markthebault/esp32-ecu/reports/engine/expanded-reference/README.md

# Expanded production-reference comparison packet

This development checkpoint adds a separate sixteen-output genuine Speeduino native fixture and generalized coupled engine comparisons. The full feature goal remains active. Existing PCB capacity is4+4; physical engine outputs remain inhibited.

- `sources.zip`: source overlay on commitc0d7d0f, including tools, reproduction commands and scope documentation.
- `validation.zip`:24 prescribed-shaft profiles, exact original4-cylinder GPIO/status and12 full coupling-result regressions, source/object/library/binary identities, independent raw/negativeIO/coupled/variable-shaft review and closure receipts. Binaries and gcov files are excluded.
- `plants.zip`:68 raw coupled runs:44 normal profiles,4 explicit incompatible reference fallback diagnostics,6 fault cases,2 fixed-geometry causal controls and12 refinements. Historical failedN1 fixture and failed common timing-gate reports are separate records and do not count as passing evidence.

Twenty reference profiles and all24 project profiles power the declared free-shaft engine after starter removal. Two- and seven-cylinder non-sequential reference fallbacks do not represent the selected even-fire COP geometry. Timing differences and reference transient errors remain in raw results; no equivalent accuracy or calibration claim is made.

See `docs/engine-reference-profiles.md` for configuration, actual native pin wiring, effective modes, commands and limits. These are uncalibrated research plants and a native HAL with zeroCPU/IRQ cost. They do not qualify physical target timing, electrical behavior, engine/vehicle operation, EMI/surge, thermal, splash, RF or printed fit. Expanded turbo geometry, matching hardware, online tuning integration and wider control/trigger features remain unfinished.
