markthebault/esp32-ecu/reports/engine/flex-integration/README.md

# Flex software integration evidence

This checkpoint connects raw flex capture to the shared controller, schema9 persistence, own010 tuning, browser controls and source/age/fault diagnostics. **Protected target acquisition and a released PCB input are still missing.** Enabled target flex inhibits control. Selected physical engine outputs remain inhibited. Screen schemas1..4 suppress engine telemetry whenever flex is required; a negotiated flex extension remains open.

Validated behavior includes fuel/temperature factors before reference acceleration fuel, zero-factor suppression of all fuel/deadtime, cranking spark bypass, secondary/cylinder ordering and coherent sample/calibration/revision/fault ownership. Historical schema1..8 imports initialize flex disabled and neutral; edited schema8 secondary maps survive. Explicit scalar synthetic ETH cannot qualify for corrections.

Evidence includes296 parent kernel checks and the full sanitizer suite;132 Python integration tests; actual Chrome flex/tuning/secondary/logger checks; independent kernel and host reviews;14,400 bit-exact Off-baseline rows; and27 saved own-controller fixed-gasoline plant cases. Neutral controls retain identical virtual edges, fuel totals and final RPM. Missing/stale inputs and zero factors cut as declared. The independent review records its own ordering, corruption, ownership, CAS, runtime and saved-plant checks.

The plant matrix is not a new production Speeduino comparison or an ethanol chemistry model. The separate earlier25-case production raw-edge packet remains at ../flex-core with its own immutable sources and disclosed historical generated-coverage side effect. No production ELF was executed for this integration checkpoint.

Actual unmodified TunerStudio MS Lite3.3.01 opens own010 offline, edits filter125.5 to130.5 and saves an MSQ matching all8192 expected bytes on native import. Earlier automation saves without a committed edit are retained separately. MegaLogViewer HD Lite4.6.14 loads the original121-row,229-column native waveform log and plots ethanol, including preserved startup unknowns. These are file workflows. Own010 online acceptance remains unverified; earlier own009 online rejection and vendor integration remain unresolved. No support message was sent.

The full runtime block is832 bytes, preserving the640-byte prefix. MSL007 has229 engine /186 direct SIL columns. ExactU64 values remain strings in JSON and decimal integers in files; viewer displays can round them. Record136B, RuntimeSample664B and Recorder87,128B are native ABI measurements. Device retention is128 rows, with gap/overwrite accounting. Keeping256 expanded rows overflowed linked internal DRAM; failed builds are retained. Three fresh firmware builds and static output-policy/ISR/USB audits pass. This does not measure target minimum heap, stack, latency, USB, sensor or electrical behavior.

Verify from the repository with `python3 -B tools/verify_flex_integration_evidence.py`; add `--check-live-sources` to bind the current workspace or `--replay` to rerun saved-case checks,296 sanitizer checks and the14,400-row exact Off comparison. Snapshots are immutable; replay uses temporary output paths. `summary.json` and `artifact-manifest.json` bind all files. Vendor application binaries and proprietary PDFs are excluded.
