markthebault/esp32-ecu/reports/engine/load-model/README.md

# Load, pressure and AFR evidence

Schema7/own008 adds independent MAP/TPS/IMAP-EMAP table coordinates, explicit table bases, pressure normalization, AFR incorporation and calibrated optional J16 roles. Selected web builds retain inhibited engine/idle output policy.

`matrix/` contains56 primary plus8 selected half-step runs across project portable/target dispatchers and pinned production Speeduino32/16 timer models. `legacy/` retains8 exact executed-event and plant-ledger replays. Alpha-N calibration has244 independently settled cells and12 unqualified pressure-corridor cells; none of the latter were weighted by the tested trajectories. Outcomes include failed calibration, differing guard/AFR policies and rich reference operation; passed audits do not mean ideal tunes.

Four independent scoped reviews are under `reviews/`. Initial/corrected source bytes, text probes and compressed trace inputs are archived. Native probe executables/objects remain in the local cache; their hashes in reviewer manifests are records, not bundled binaries. The simulator review binds the execution sources separately from the publication snapshot and independently replays the final64 traces. Live source checks verify that binding. There is no claim of a run-captured manifest that the runner did not produce.

`applications/` includes actual offline TunerStudio008 edits, exact5376-byte F32/enum-page roundtrip,126/83-field MegaLogViewer files and screens. Nine Chrome workflows cover unit review, CAS, imports, logging and existing controls. `static/` contains actual linked policy, ISR and USB/source audits, not measured runtime/electrical qualification. Current source copies are under `sources/`; root attributes are retained inertly under `source-metadata/` so they cannot change copied-file storage. All packet artifacts are hash listed.

Run `python3 tools/verify_load_evidence.py`; add `--check-live-sources --check-index` before committing this revision. Historical source/manufacturing/case/manual/report bytes are retained. Full feature parity, online application identity acceptance and physical qualification remain open.
