markthebault/esp32-ecu/reports/engine/secondary-core/README.md

# Secondary-table core foundation evidence

This packet proves scoped core progress. It does not establish an operator-ready secondary-table feature or full Speeduino equivalence. Schema7/own008 keep secondary tables Off. Versioned UI/configuration/tuning, coherent logs/radio, protected switch acquisition/accessory and new coupled plant comparisons remain pending. Engine/idle physical outputs remain inhibited.

The native sanitizer suite passes, including738 secondary-module checks,148 integrated-controller checks and four deliberate workspace-allocation failures. All173 existing Python tests pass. The selected N16R8 web target builds; linked policy and ISR-placement checks pass. Native lifetime/size checks and static images do not prove ESP32 runtime heap/stack, physical timing or electrical/engine behavior.

The same frozen probe produces7776 exactly identical disabled-path observations before/after, with source snapshots and raw compressed output retained. The earlier baseline's probe source is unchanged in this replay; the public helper only separates adjacent statements for strict compiler diagnostics. Independent architecture probes execute unchanged pinned-production Speeduino functions, not a whole coupled engine. Independent implementation/binding/allocation/legacy-wire review is archived under reviews.

Each review original manifest was fully verified before selection. selection.json identifies every archived original and its optional lossless CSV compression. Upstream vendor source snapshots and compiled executables/archives remain in the local review cache; their hashes and rebuild recipes remain recorded. Project source snapshots, probe source, result data and reports are archived. Do not mistake an original reviewer manifest for a claim that every cache artifact is redistributed here.

Run python3 tools/verify_secondary_core_evidence.py. Add --check-live-sources --check-index before committing this revision. Add --replay to rebuild both frozen/current disabled probes and three sanitized core/allocation tests from this packet; the replay requires a compatible compiler/libm and retains its receipts in .cache/engine/secondary/replays. Full regression reproduction: CXX=g++ CC=gcc sh scripts/test_firmware.sh and uv run --with fmpy==0.3.26 --with playwright python -m unittest discover -s tools -p 'test_*.py'. Browser workflows and actual tuning applications were not rerun for this core-only phase. No manufacturing/case/manual artifact changed.

See ../../../docs/engine-secondary-tables.md for the full remaining implementation gates.
