markthebault/esp32-ecu/reports/engine/secondary-integration/README.md

# Secondary-table software integration

Schema8/own009 adds both secondary-table editors and strict whole-tune migration/staging/CAS,640-byte coherent runtime,188/145-field MSL006 and compact authenticated radio schema4. Physical engine/idle outputs remain inhibited in the selected web targets. Protected switch/ethanol acquisition and fresh secondary-enabled coupled plant acceptance remain open.

Validation includes the native ASan/UBSan suite,189 Python tests,57 Chrome workflows, three firmware builds and static policy/ISR/USB audits. The7776-row disabled probe exactly matches the earlier core packet. These regressions do not substitute for new enabled-table plant trajectories.

TunerStudio MS Lite3.3.01 opens the definition without parser/unit warnings; edits to both rules/maps match all8192 expected page bytes with the known revision37 explicitly supplied because the application omits its read-only origin. MegaLogViewer HD Lite4.6.14 opens/plots188/145-field synthetic probe files. NaN-bearing channel extrema may displayNaN; calculated vendor channels/large integers remain unqualified. No online vendor acceptance or physical board test is claimed.

The independent software review passes14 groups against299 frozen inputs, including7772 burn-allocation and5747 migration-allocation failures,324 old-prefix profiles,297 native/browser observations,193 exact runtime extensions,225 radio combinations,864 unit assertions and strict rejection/nonmutation checks. Its null-metadata finding and sensor-fallback wording recommendation are closed. The separate contract review is a proposed-layout/capacity assessment, not final implementation acceptance.

- [Software review](reviews/software/review.md) and [detailed checks](reviews/software/review.json).
- [Supplemental documentation review](reviews/documentation/review.md) binds the sole post-freeze tuning README correction and independently checks the operator guides/application receipts. The original503-artifact software packet remains unchanged; all production hashes still match it.
- [Contract assessment](reviews/contract/assessment.md).
- [Application receipts](validation/application-checks.json), [browser receipts](validation/browser-summary.json) and [source/limit summary](summary.json).
- [Current guide](../../../docs/engine-secondary-tables.md) and [coverage ledger](../../../docs/engine-feature-coverage.md).

The document bound grows to48KiB and engine NVS to128KiB at the same0x210000 offset. Startup detects an old partition layout without erasing it and blocks saves with a diagnostic. Physical flashing/migration, fragmentation and power-loss durability remain hardware work. No PCB, BOM, Gerber, case or manual release is changed by this packet.

The root artifact manifest binds every file except itself. Sources retain their exact bytes; root attributes are stored inertly outside the source tree. Each reviewer archive contains a selection of its original manifest entries, with sources/probes/commands/results and explicit local binary exclusions. Compiler ELF hashes and generated partition/config records are retained; local full ELF/application binaries remain in the ignored build workspace.

~~~sh
python3 tools/verify_secondary_integration_evidence.py
python3 tools/verify_secondary_integration_evidence.py --check-live-sources --check-index
python3 tools/verify_secondary_integration_evidence.py --replay
~~~

Default verification is archival. Live/index checks intentionally fail after later changes. Replay rebuilds the frozen core/allocation probes with sanitizers and repeats the exact disabled observations in a new ignored directory. Other reviewer/application checks retain their own source/command receipts. The broader goal remains active.
