markthebault/esp32-ecu/reports/engine/semi-sequential/README.md

# Semi-sequential software increment

This immutable evidence set belongs to `feature/engine-development-sil`, after baseline `8b2f8ec`. It does not establish broader Speeduino parity, physical engine operation or fabrication release. [Strategy and reproduction guide](../../../docs/engine-semi-sequential.md).

- `validation-summary.json` binds296 source/input snapshots and test scope. `sources/` includes generated SDK configuration inputs as records; live/index verification distinguishes tracked sources from ignored generated inputs.
- `matrix/summary.json` records28 scenario runs plus8 step-refinement checks, with compressed raw traces. Each core drives its own independent plant copy from executed actuator edges. Speeduino source is pinned at9ff5aae44de51fdc00d3fb1c7c2bfc1f0d0b3e20. Native32 and16-bit timer profiles are separate, declared HALs; neither establishes physical CPU/interrupt timing.
- `legacy/` contains8 batch/full-sequential warm-start regressions. Sequential's pre-acquisition phase inhibit is expected and disappears after phase acquisition.
- `initial-audit/` retains diagnostic history, including the incorrect initial target-only/instant-loss audit assumptions and six affected raw cases. Its old runner hashes are historical identifiers; the final matrix and current source snapshots are authoritative.
- `reviews/` contains independent read-only storage, telemetry and execution review reports, probes and source snapshots. `review-resolution.json` closes documentation/test findings explicitly. Target review addendum binds the final asset-only rebuild. `reviews/execution/policy-correction.json` supersedes its false bench-policy metadata field: actual bench gated outputs are enabled by its explicit compile policy; both web builds remain inhibited. The CMake database omits extra PlatformIO SCons flags.
- `validation/` contains147 Python tests,12 semi tests, native ASan/UBSan checks including252 constant-shaft pair/phase/width cases, firmware/reference builds and application workflow records. `browser/` contains installed-Chrome checks and screenshots. `target/` contains fresh ISR and USB static audits; runtime heap, stack and timing remain unmeasured.
- `reference/` retains current and pre-increment build manifests. Private GPL reference executables remain reproducibly cached locally; proprietary desktop application binaries/settings are not included. `applications/` contains actual own006 TunerStudio export and the synthetic MSL opened by MegaLogViewer.
- `comparison.png`, `comparison.svg`, `comparison.html` and `metrics.csv` derive from the final raw matrix. The standalone plot is a software comparison, not engine calibration.

The35 Nm step stalls. Our controller cuts when the projected coil close would violate bounded dwell and recovers stopped. Four previously predicted rises occur after trigger loss; in these runs the last edge is16.38 ms after the last accepted crank, before its measured20 ms timeout. General timeouts can extend to150 ms; a200 RPM/40 ms case is separately tested against the actual last accepted edge. Neither instantaneous cut nor perfect engine behavior is claimed.

Selected web firmware keeps physical engine/idle outputs inhibited. The separately gated dummy-load bench build was compiled only. No board was flashed, no engine/valve/screen hardware was connected and no vehicle, electrical/environmental or physical-fit qualification was performed. TunerStudio offline own006 works in the tested application; online own-identity acceptance remains unresolved.

Run `python3 tools/verify_semi_evidence.py` from the repository root for archival integrity. Add `--check-live-sources` for this source state and `--check-index` after staging to bind Git bytes too. `artifact-manifest.json` covers every other file in this directory; it is excluded from its own hash set.
