markthebault/esp32-ecu/reports/engine/transient-enrichment/README.md

# Transient fueling evidence

Schema6/own007 adds acquisition-window TPS/MAP curves, multiplier/reference-adder, latched tapers, finite holds and deceleration fuel reduction/cut. Selected web builds remain physically inhibited.

`matrix/` contains64 qualified runs, including48 primary,8 refinements and8 fuel-neutral controls. `initial-matrix/` preserves the earlier coverage failures and exact initial runner. Its other source bytes match `sources/`. `legacy/` compares exact executed events and plant ledgers with immutable pre-transient evidence.

Independent source snapshots/probes and corrected findings are under `reviews/`. Text inputs are archived; native executables/objects remain in the local cache and their reported hashes are records, not bundled binaries. Actual offline TunerStudio and MegaLogViewer files/screens are under `applications/`. Browser collected/native105-field exports agree. The unchanged232-byte radio does not carry the new detailed transient fields.

Source snapshots and raw traces are hash bound. Run `python3 tools/verify_transient_evidence.py`; use `--check-live-sources --check-index` for this revision before committing. Static/source/simulator evidence does not establish physical engine operation or full feature parity.
