markthebault/esp32-ecu/reports/engine/turbo-profiles/README.md

# Turbo profile research foundation

Explicit1..8-cylinder geometry now binds actual pumping displacement, per-cylinder air, sparse actuators and conservative gas/heat inventories. Native project coupling adds sequential cam events, full-channel cut records and loaded-layout provenance. The full ECU goal remains active; PCB capacity stays4+4 and normal engine outputs stay inhibited.

- `sources.zip`: source overlay on commit4daa4d8, tools, reproduction and limits.
- `validation.zip`: eight geometry/atomicity tests, existing regressions,200 exact parent state replays, independent48 analytical flow cases/1002 numerical values, and separate model/controller-coupling reviews with resolved findings.
- `runs.zip`: current8-cylinder sequential and independent7-cylinder semi charged-cut evidence; source-bound1-cylinder and8-cylinder open-loop prefixes; explicitly failed4L high-throttle source-map experiment. Compiled binaries/gcov and the upstream archive ZIP are excluded; source/model inputs and identities are retained.

Current charged stops retain actual COIL17/COIL16 discharges and closed post-cut ledgers. Earlier prefixes have their original source versions and cannot prove post-halt inventories. The8-second20%-throttle run records234 PWM edges while manifold pressure stays below ambient; it does not establish pressure tracking. The80%-throttle4L run exceeds the source turbo's24000rad/s domain at4.730343s and is excluded from passing evidence.

See `docs/engine-turbo-profiles.md` for commands and physical assumptions. Matched turbo/map hypotheses, a16-output genuine production boost fixture, paired normal/fault/refinement comparisons, further controls/UI/configuration/debug/PCB work, online tuning support and target/physical qualification remain unfinished. No physical engine, vehicle, electrical, EMI/surge, thermal, splash, RF or printed-fit qualification is claimed.
