markthebault/esp32-ecu/reports/engine/load-model/sources/README.md

# ESP32 ECU A3-120

A 120 × 120 mm, six-layer, through-hole ECU development board with a plug-in ESP32-S3, configurable sensor readouts, live diagnostics and a printable gasketed enclosure.

**Bench prototype:** all engine outputs remain disabled. Vehicle operation, surge/EMI immunity and physical splash resistance have not been validated.

| PCB | Printable enclosure |
| --- | --- |
| A3-120 through-hole PCB | Printed enclosure, gasket and PCB mounts |

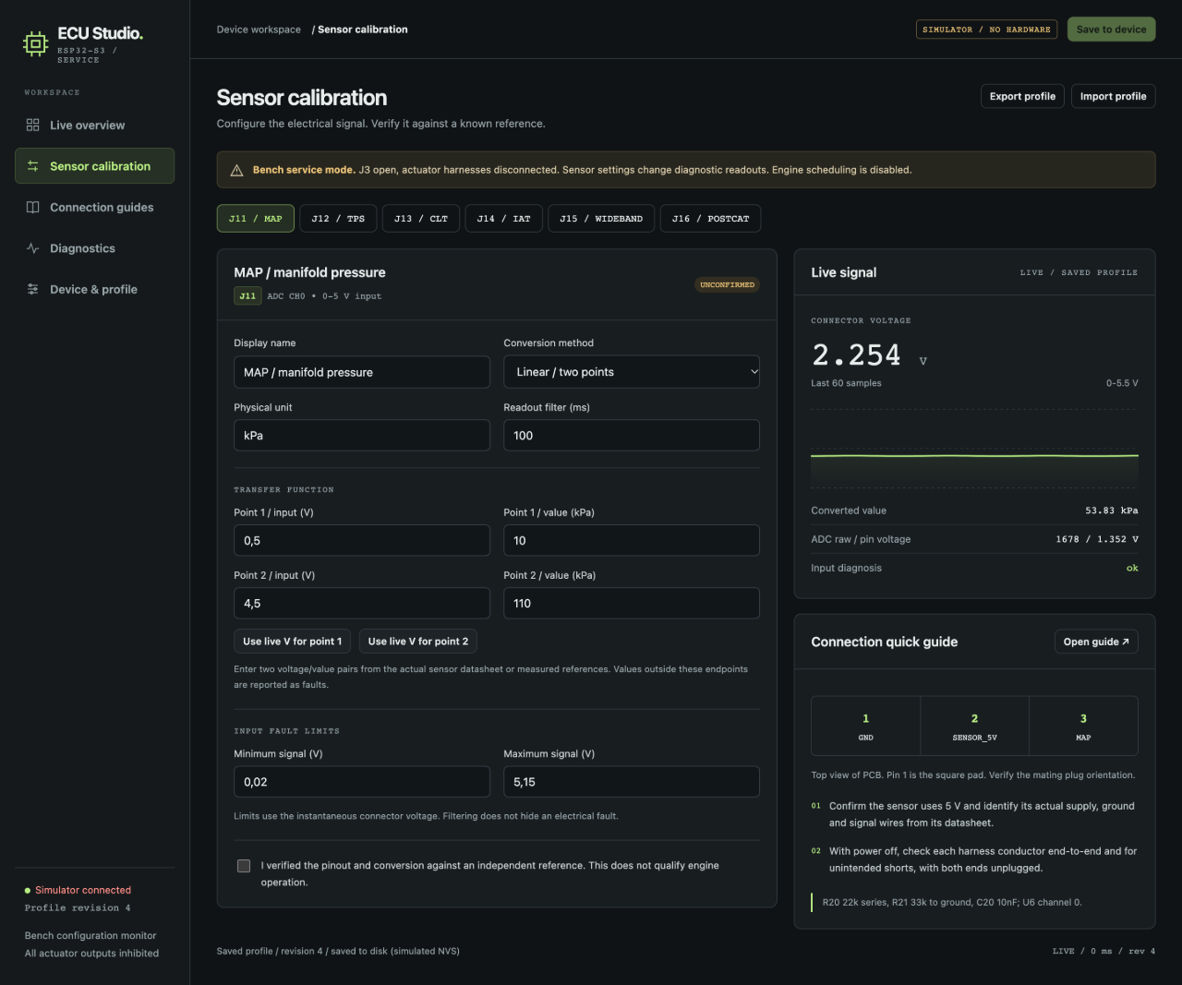
[picture p16: reports/web/calibration.png]
Sensor calibration and live diagnostics


[Bill of materials](hardware/a3-compact/BOM.md) · [Shopping CSV](hardware/a3-compact/bom-shopping.csv) · [KiCad project](hardware/a3-compact/esp32-ecu.kicad_pro) · [26-page manual](output/pdf/esp32-ecu-a3-build-calibration-debug-manual.pdf) · [Print files](enclosure/a3/) · [Complete package](build/esp32-ecu-a3-120-web-manual-case.zip)

Engine development: [core, target timing and simulator assessment](docs/engine-development.md) · [Speeduino feature coverage](docs/engine-feature-coverage.md) · [TunerStudio/MSL status](tuning/README.md) · [trigger logging](docs/engine-trigger-debug.md) · [sequential control and comparison](docs/engine-sequential.md) · [engine logs and screen telemetry](docs/engine-observability.md) · [cylinder trims](docs/engine-cylinder-trims.md) · [USB tuning status](docs/engine-usb-tuning.md) · [idle control and comparison](docs/engine-idle-control.md) · [transient fueling](docs/engine-transient-enrichment.md). Physical outputs remain inhibited.

New development: [ESP-NOW pairing, screen management and sealed button wiring](docs/espnow.md). The UI can pair and unpair screens. Selected module: **44-pin Type-C N16R8**, with its [supplier PDF](hardware/references/esp32-s3-44pin-aliexpress.pdf) preserved. [A5 idle interface and isolated driver](docs/engine-idle-isolation.md) are routed development drafts with physical outputs disabled and provisional module/case fit. A3/A4, manufacturing files and the old ZIP remain historical.

## Build and preview

```sh
pio run -d firmware -e compact_n16r8_web
python3 tools/web_server.py
```

Open the desktop simulator at `http://127.0.0.1:8765`. Read the [web/bench setup guide](docs/web-configuration.md) before powering or flashing the hardware. The BOM identifies exact-part selections that still need review.

Historical A3 validation: [ERC/DRC and pin audit](reports/a3/validation-summary.json), [enclosure CAD fit](enclosure/a3/fit-check.json), [18 configuration/API tests](reports/web/config-tests.txt) and [116 control scenarios](reports/web/control-tests.txt). Some purchased-part 3D models are simplified assembly envelopes.

[Load-source, pressure and AFR development](docs/engine-load-model.md) · [Earlier revisions](docs/history.md) · [Compact-board details](docs/compact.md)
