markthebault/esp32-ecu/reports/engine/flex-ingress/validation/sources/hardware/flex-input/README.md

# Flex input architecture draft

`FLEX-G38-DRAFT1` reserves GPIO38 for a future protected flex input on a new carrier revision. The [machine-readable contract](architecture.json) records allocation, capture ownership, shared I2C limits and unfinished gates. This directory contains no circuit or released CAD. Do not connect a sensor using this draft.

The preferred allocation moves the external GPIO38 WS2812 status function to an ordinary RGB LED driven through a direct-solder PDIP18 MCP23008 at address0x21. Existing switch acquisition remains at0x20 with its GP7-to-GP6 challenge and full-byte IODIR guard. IO7 must be configured as output even when it is NC on the new expander. [Microchip DS20001919I, Register1-1](https://ww1.microchip.com/downloads/aemDocuments/documents/APID/ProductDocuments/DataSheets/MCP23008-and-MCP23008-Data-Sheet-DS20001919.pdf)

GPIO45/46 stay unconnected. GPIO46 must be low with BOOT low for joint download; GPIO45 can select VDD_SPI without a verified eFuse override. Chip Reset strap sampling differs from resets that retain GPIO state. This allocation avoids depending on an unmeasured strap gate, reset retention or the supplier module's fuses. No eFuse change is requested. [Espressif boot documentation](https://docs.espressif.com/projects/esptool/en/latest/esp32s3/advanced-topics/boot-mode-selection.html)

Historical compact GPIO38 LED firmware and generic GPIO38 ARM firmware cannot own the new input. A new compact carrier build must exclude every old RMT initialization/write and explicitly disable GPIO output before capture setup. GPIO38 ownership has not yet been changed in any existing build.

The existing group0 capture timer stays running and calibrated. Its third channel would acquire both flex edges at priority3; crank/cam keep their channels, status and timing. The hardware has one event latch per channel. Software queues cannot establish lossless capture. The [portable ingress](../../firmware/include/ecu/flex_ingress.hpp) implements bounded handoff and suppression decisions only. The target must supply source-specific interrupt masking/clearing, locking, a single worker, actual calibration/revision binding and completed-control ACK routing. Every stop/rearm or binding change must also invalidate the separate floating-point Capture series. Ingress queue clearing cannot do that itself. Only the owning worker may forward both fault tickets after a completed matching invalid control evaluation; the ingress cannot verify control execution.

Sample callback/owner time after taking the same lock used for the ingress call. A timestamp sampled before waiting can be older than an intervening event and correctly fail the monotonic-clock check, even when an ACK's metadata is stale. Snapshot holdoff status is evaluated at its recorded `last_observed_us`, not at the time a diagnostic reader receives it.

The32-callback/10ms fixed window applies to matching active callbacks within an armed episode. It is not a global IRQ budget across inactive/foreign callbacks or arbitrary stop/arm cycles. The trusted owner must honor local interrupt suppression and the ACK/holdoff retry path, and must not implement noise retries as repeated normal stop/arm.

Pop followed by floating-point work outside the lock is not a publication fence. Retain context, fault generation and arm boundary with the pop. Before publishing, atomically revalidate current context/generation/armed state and the event timestamp against the current arm boundary, then commit under that same lock or an equivalent versioned commit. A mismatch discards the result and invalidates/reacquires the separate Capture series. The edge has no generation field, so the companion snapshot/version must be retained. This owning-worker fence remains unimplemented.

Both MCP23008 devices need one bus owner and one total3ms budget per5ms tick. Switch guards have priority. LED work uses remaining slack, coalesces old requests and advances initialization/readback in bounded operations. Bus release requires both clients idle. MCP outputs can retain green after a CPU or bus failure, so expose requested color separately from verified latch/age/failure. Register readback does not prove light output. Pairing blue blink, normal steady green and problem red blink remain the requested indication policy.

The protected frontend, exact LED/driver/resistors, bias, polarity, off-state back-power and pulse skew remain open. The parent U7 has two spare3.3V SN74HC14N gates that may be reusable, but copying a divider/RC does not qualify them. Preserve the physical sensor LOW width. The core's2µs endpoint allowance covers timestamp quantization, not an unmeasured circuit delay. No sensor model, supply or harness pinout has been selected.

The120×120mm limit, ordinary leaded parts, direct-solder DIP, pluggable N16R8, inward10mm antenna allowance and sealed PAIR/RESET remain constraints. Physical dimensions and RF/fit behavior remain unverified. A3/A4/A5 sources and manufacturing records remain historical copies. Physical engine outputs remain inhibited.
