markthebault/esp32-ecu/manufacturing/a3/drill-report.txt

Drill report for esp32-ecu.kicad_pcb
Created on 2026-10-30T17:28:59

Copper Layer Stackup:
    =============================================================
    L1 :  F.Cu                      front
    L2 :  In1.Cu                    in1
    L3 :  In2.Cu                    in2
    L4 :  In3.Cu                    in3
    L5 :  In4.Cu                    in4
    L6 :  B.Cu                      back

Drill file 'esp32-ecu-PTH.drl' contains
    plated through holes:
    =============================================================
    T1  0.300mm  0.0118"  (98 holes))
    T2  0.350mm  0.0138"  (52 holes))
    T3  0.750mm  0.0295"  (22 holes))
    T4  0.800mm  0.0315"  (477 holes))
    T5  0.950mm  0.0374"  (28 holes))
    T6  1.000mm  0.0394"  (66 holes))
    T7  1.100mm  0.0433"  (24 holes))
    T8  1.200mm  0.0472"  (10 holes))
    T9  1.300mm  0.0512"  (2 holes))
    T10  1.600mm  0.0630"  (4 holes))
    T11  1.700mm  0.0669"  (23 holes))
    T12  3.200mm  0.1260"  (1 hole)

    Total plated holes count 807

Drill file 'esp32-ecu-NPTH.drl' contains
    unplated through holes:
    =============================================================
    T1  3.200mm  0.1260"  (4 holes))

    Total unplated holes count 4
