markthebault/esp32-ecu/reports/engine/flex-radio/sources/docs/espnow-engine.md

# Opt-in ESP-NOW engine telemetry

This extends the [existing pairing and sensor protocol](espnow.md). It implements the ECU sender plus a [reference receiver](../tools/engine_receiver.py); it does not build a screen. The channel remains 6, encrypted unicast uses the saved 16-byte LMK, and peers remain limited to 4. Peer Storev1 and types 1–6 keep their existing byte layouts. Capabilities are volatile, reset at reboot/unpair/slot reuse and do not change the saved peer blob.

Types 7–11 use the existing 8-byte `ECN1`, version 1, type, little-endian uint16 length header. No native structure is transmitted. Integers are unsigned little endian; floats are IEEE-754 float32. The largest datagram is250 bytes in schemas3..5; schemas1/2 retain232 bytes, within the250-byte v1 ESP-NOW payload limit. Schema5 uses two authenticated datagrams for one complete observation. Send/receive callbacks only signal or queue bounded work; authentication, JSON and framing run in the task, consistent with [Espressif's API guidance](https://docs.espressif.com/projects/esp-idf/en/stable/esp32s3/api-reference/network/esp_now.html).

## Negotiate and recover

1. Load the saved ECU STA MAC and LMK. Send a type 7 read-only query with session/counter/features/schema all 0 and a fresh cryptographic 16-byte client nonce. Start a local monotonic timer for this request. A query does not enable engine telemetry.
2. Within 1 second, verify type 8's full HMAC with the LMK, echoed nonce, enums, lengths and reserved/status fields. Reject responses from any other MAC. Record the current capability counter/mode, nonzero boot session, boot nonce, sequence floor and ECU reply-send time.
3. To enable, send type 7 with that boot session, counter+1, feature bit 0 set, schema5 (or explicit legacy schema1..4) and a new nonce. Accept the matching authenticated reply before using data. To disable, increment the counter with features/schema 0. Counter 0 is reserved for queries. Updates must be strictly newer; retry the exact same request bytes if a reply is lost. A same-counter request with changed bytes is rejected. At UINT32_MAX, re-pair/reboot is required before another update; never wrap the counter.
4. A rebooted screen queries the ECU's accepted counter instead of assuming 0. Queries report the current mode without modifying it. An ECU reboot starts disabled again. A query with session 0 discovers the current boot. Query/reply state is not persisted to NVS.
5. Refresh the timed nonce query at most 5 seconds later and after a 1 second gap in authenticated engine frames, including no first data within 1 second of a reply. The reference receiver invalidates its cached display while querying. Use a fresh random nonce every time. Never accept an unsolicited, expired or nonce-mismatched reply.

The query sequence floor prevents a screen that lost RAM state from accepting recorded same-boot engine frames at or below that floor. Derive the full 32-byte engine MAC key as:

`HMAC-SHA256(LMK16, ASCII("ECU-NOW-ENGINE-v1") || boot_nonce16 || session_u32_LE)`

The ASCII domain is 17 bytes. Use all 32 derived bytes for engine data/ACK HMACs, not only the first 16. A fresh boot nonce separates engine frames even if the random 32-bit session happens to collide, after a fresh nonce negotiation. This does not retrofit unlimited replay protection into the legacy sensor protocol. Pairing/LMKs remain the trust boundary; compromised keys/ECU/service clients and jamming remain outside this protection.

| Type 7 request, 76 bytes | Type 8 reply, 108 bytes |
| --- | --- |
| 0..7 common header | 0..7 common header |
| 8 session u32, 0 allowed for query | 8 current nonzero session u32 |
| 12 counter u32, 0 for query | 12 accepted update counter u32 |
| 16..31 fresh client nonce | 16..31 echoed client nonce |
| 32 feature mask u32 (only bit 0) | 32 current feature mask u32 |
| 36 schema u32 (1..5 enabled,0 disabled/query) | 36 current schema u32 |
| 40 reserved u32=0 | 40 status u32=0 |
| 44..75 HMAC-SHA256(LMK16, bytes 0..43) | 44..59 per-boot random nonce |
| | 60 engine packet sequence floor u64 |
| | 68 ECU reply-send ESP uptime µs u64 |
| | 76..107 HMAC-SHA256(LMK16, bytes 0..75) |

## Engine packet, type 9

Total232 bytes for schemas1/2 or250 for schemas3..5. Schema5's base uses the schema4 layout with schema=5; it becomes an observation only after its matching type11 extension is verified. HMAC verification with the derived key precedes any sequence/freshness update. Reject incorrect lengths, nonzero reserved bytes, unsupported schema/enums, wrong boot/source, duplicate/out-of-order packet IDs and reversed sender time. Packet IDs are global u64 and can have gaps. The source proposal sequence is independently u64. Preserve these as integers, not JavaScript Number values; the web API uses decimal strings.

| Offset | Field |
| --- | --- |
| 0..7 | Common header |
| 8 | Boot session u32 |
| 12 | Engine packet sequence u64 |
| 20, 22 | Negotiated schema u16 (1..5), flags u16 |
| 24, 28 | Sensor-sample and control-evaluation ages at send, u32 ms |
| 32, 36 | Tune and sensor-profile revisions, u32 |
| 40, 48 | Source proposal sequence and earlier worker-current command sequence, u64 |
| 56, 60 | Source external-configuration phase epoch and worker executor-generation epoch, u32; distinct domains |
| 64, 68, 72 | Controller fault bits, phase-loss count, rejected-cam count, u32 |
| 76 | Cam error, float32 crank degrees |
| 80..89 | Ten u8: state, strategy, source, phase reason, input-valid mask, current timing cause, last timing cause, virtual mask, physical-command mask, board flags |
| 90..91 | Reserved0 for schemas1..3; compact secondary mode/source/status for schema4 below |
| 92 | ECU transmission ESP uptime µs, u64 |
| 100, 104, 108 | Worker tune revision u32, worker sensor revision u32, worker observation age u32 ms |
| 112..143 | Eight input floats: RPM, MAP kPa, TPS %, CLT °C, IAT °C, lambda, battery V, sensor V |
| 144..199 | Fourteen proposal floats: RPM, VE %, target lambda, advance °BTDC, PW ms, dwell ms, deadtime ms, air mg, warmup ratio, afterstart ratio, accel ratio, EGO ratio, duty %, idle % |
| 200..231, schemas1/2 | HMAC-SHA256(engine_key32, bytes0..199) |
| 200, schemas3/4 | Four2-bit resolved source codes, fuel/spark/lambda/trim, low to high |
| 201, schemas3/4 | Pressure mode bits0..1, baro source bit2, available bit3, arithmetic valid bit4, AFR mode bits5..6, MAP guard available bit7 |
| 202,206,210,214, schemas3/4 | Unaligned F32: fuel coordinate, AFR factor, baro kPa, EMAP kPa |
| 218..249, schemas3/4 | HMAC-SHA256(engine_key32, bytes0..217) |

State values 0..5 and fault bits match `engine.hpp`; strategy 0=batch/wasted, 1=sequential four cylinders, 2=semi-sequential four cylinders (schemas2/3/4). Source 1=target control observation, 2=synthetic control observation. Phase reasons match `engine_phase.hpp`, timing causes match `timing_executor.hpp`. Schema1 permits strategies0/1 and current/last timing causes0..16. Schema2 adds strategy2 and timing cause17 (`idle_pwm_fault`), with the same offsets and size. Unknown enum values reject. The receiver must enforce the exact authenticated negotiated schema on every frame, including after upgrades or downgrades. Input validity bits follow the eight input floats. An invalid input is NaN with its bit clear. Unknown proposal/cam floats are NaN. Infinite values are rejected. Board bits 0..3 mean ADC OK, SAFE high, interlock high and capture overflow. Masks represent software state, without pin readback.

Flags, low to high bits 0..15: present, inputs fresh at control evaluation, storage OK, crank synchronized, phase synchronized, phase required, proposal submitted to worker queue, dummy-load physical policy compiled, phase/revision context matched, proposal active, fuel cut, spark cut, pump proposal, fan proposal, inputs qualified at evaluation, sender display freshness. The selected N16R8 build keeps the dummy policy clear and engine outputs inhibited.

Unknown ages are UINT32_MAX. Finite old ages saturate at UINT32_MAX−1. The sender reads ESP uptime before GP time at publication, calculates GP-source durations, then adds later ESP elapsed time. Publication/transmission never resets the source/control timestamp when observe skipped a step. Worker ages are separate. Sender display freshness means sample/control ages≤1000 ms at transmission; it does not establish current command validity or physical execution.

The receiver must add network/receiver age. The reference implementation uses the authenticated timed query as a clock interval, a 2% relative clock-rate allowance plus 2 ms quantization, and refreshes within 5 seconds. Its conservative transit bound is `max(0, local_elapsed_since_query_send − sender_elapsed_since_reply_send) + ceil(0.02×local_elapsed) + 2ms`. Source/control/worker ages are first rounded upward by `100/98` to cover a slow source clock, including history before the query. Add transit and subsequent receiver-local elapsed time. A repeated source sequence cannot change immutable payload or lower a previous age bound; an unknown repeated age remains unknown. After a gap, fresh negotiation is required. These are explicit clock assumptions, not measured oscillator/RF guarantees. Never compare raw ECU and screen uptime origins or trust a newly arrived packet's freshness bit alone.

## Acknowledge and rate

Type 10 is 56 bytes: common header 0..7, session u32@8, received engine packet sequence u64@12, reserved u32=0@20, HMAC-SHA256(engine_key32, bytes 0..23)@24..55. ACK the newest authenticated, processed complete observation promptly. Schema5 requires both parts before an ACK. The ECU requires a sequence it actually submitted within the last 1 second and within its last 8 complete submissions for that peer and packet family (engine or legacy sensor, independently). Eight engine observations span about0.5 seconds at16 Hz or1 second at8 Hz; promptly acknowledge the newest. It rejects duplicates, old ACKs and reversed time before advancing ACK state. The same recent-send/serial rule applies to legacy type6, including legitimate uint32 rollover through0. A MAC-layer send success is not a screen ACK.

Normal per-peer budget remains up to20 datagrams/s. Legacy peers retain their sensor cadence. Schemas1..4 normally receive16 engine observations,2 legacy sensor packets and2 metadata packets/s. Schema5 uses those same16 engine datagram slots for8 complete two-part observations. Capability replies borrow slots and are rate limited; radio congestion/pairing/CPU delays can reduce rates. Busy periods do not create an unbounded backlog. Metadata keeps its session/revision contract, and its session is stamped at transmission. No rate/delivery guarantee is implied.

The UI distinguishes recent link ACKs from complete-engine ACKs, including a pending flex submission. Sensor ACKs cannot hide a missing complete-engine ACK for3 seconds. Complete fault observations can be acknowledged while their flex value remains unusable. Neither an ACK nor a worker command observation proves an output executed or a screen displayed it. HTTP failure clears both ACK readbacks to unknown. Unpair stops subsequent sends and resets stream keys/capabilities/ACK history for that slot.

## Reproduce

`tools/test_engine_observability.py` compares native C++ and independent Python packet bodies/full HMACs, key length, nonce/counter recovery, replay, clock bounds, stale gaps, unknown values and 64-bit IDs. Native tests cover both ACK widths and recorder limits. [The observability guide](engine-observability.md) links engine-plant, UI, viewer and independent review evidence. Future screen firmware can use `EngineReceiver` as an executable contract; it must implement ESP-NOW peer storage/transport and display behavior separately. No screen, actual RF exchange, range or sealed-enclosure qualification was performed here.

The cylinder-trim update keeps this schema unchanged. Its fourteen proposal floats remain untrimmed base demands. Applied per-cylinder PW/advance/fuel/duty and masks are available through web/JSON/engine MSL002, not this radio frame. Receivers must not present the scalar PW/advance as the applied value for every cylinder.

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

Schema3 carries [load-model source meanings](engine-load-model.md). Source codes0/1/2 mean MAP kPa, physical TPS percent and100×IMAP/EMAP percent. Pressure codes0/1/2 mean Off100kPa, MAP/100kPa and MAP/baro. AFR codes0/1/2 mean Off, target and measured. Baro source0 is fixed/manual;1 is calibrated live. Available does not imply all optional numbers or valid control. Unknown numeric fields remain NaN. Spark/lambda/trim coordinates in the Python receiver are derived approximately from authenticated F32 inputs when arithmetic is valid; inactive/missing inputs remain unknown. Their precision can differ from the core's F64 lookups. Detailed reason, auxiliary role and AFR state require web/log diagnostics.

Schemas1/2 are emitted only for the legacy MAP/target model with the postcat role. New load modes require schema3 or4; the API/UI disclose an upgrade requirement and fall back to the legacy sensor stream. Authentication covers schema and the correct variable body length. A negotiated version cannot be silently downgraded, and a repeated source snapshot cannot alter its appended payload. HMAC derivation, ACK layout, sequence/counter/nonce, freshness and replay rules remain unchanged. `test_load_radio.py` checks independent bytes, every250 individual tamper positions, malformed lengths/enums, downgrade, old-byte preservation and new-mode fallback.

## Secondary summary, schema4

Schema4 retains every schema3 field, its218-byte authenticated body and250-byte total frame. Former reserved bytes90/91 carry two compact secondary observations:

| Byte | Bits | Meaning |
| --- | --- | --- |
|90|0..2 /3..5|Fuel/spark mode:0 Off,1 multiply,2 add,3 conditional,4 input;5..7 reject|
|90|6 /7|Fuel/spark secondary selected (`active`)|
|91|0..1 /2..3|Fuel/spark source:0 MAP,1 physical TPS,2 IMAP/EMAP;3 rejects|
|91|4 /5|Fuel/spark observation available|
|91|6 /7|Fuel/spark calculation evaluated|

Unavailable observations are canonical empty: mode/source0 and active/evaluated clear. An active Off rule rejects. Active selection can be known before arithmetic completes; check evaluated, controller faults, sample age and global flags. This compact frame does not carry cell meaning, secondary coordinates/values, input qualification/age or detailed reasons; use web/USB/log diagnostics for them. The existing scalar advance/PW remain base proposals rather than per-cylinder applied execution.

Every non-Off configured secondary mode requires schema4, including a currently inactive conditional/input rule. Schemas1..3 keep their exact historical byte meanings and cannot silently label a secondary result as primary-only. The ECU reports `engine_telemetry_blocked`, an upgrade reason and explicit sensor-stream fallback. Off rules remain compatible with older schemas, subject to their existing strategy/timing/load limits.

The receiver enforces the exact authenticated negotiated schema and includes the new bytes in repeated-source immutability. HMAC key domains, full MAC lengths, counters, nonce retries, query floor, clock assumptions, ACKs and payload budget remain unchanged. `tools/test_secondary_radio.py` independently checks225 mode/source pairs, every tampered byte, signed invalid metadata, downgrade, retry/replay and legacy byte preservation. These are software contracts; no physical screen or RF test was performed.

## Complete flex observation, schema5

Schema5 preserves every schema4 base field, including bytes90/91 and200..217. Its separate type11 datagram is232 bytes. Both parts use the same session and64-bit packet sequence. The full32-byte base HMAC in the extension binds that exact base, preventing mixed observations. Each part has its own full HMAC with the existing32-byte engine key. The [machine contract](../config/engine-radio-v5.json) remains a development contract; no screen application or actual RF qualification is supplied.

| Offset | Type11 field |
| --- | --- |
|0..7|Common header|
|8,12|Session u32, packet sequence u64|
|20,22|Schema u16=5, reserved u16=0|
|24..55|Full base HMAC-SHA256|
|56..111|Seven u64: sample µs, window start µs, last edge µs, raw edges, fault generation, acknowledged generation, configuration epoch|
|112..151|Ten F32: frequency Hz, low pulse µs, ethanol %, fuel °C, unfiltered ethanol %, unfiltered fuel °C, sample age at control ms, fuel %, spark addition °, temperature %|
|152..175|Six producer-calibration F32: low Hz, high Hz, fault Hz, tolerance Hz, stale ms, filter ms|
|176,180|Flex flags u32, actual producer tune revision u32|
|184..190|Seven u8: source, reason, capture reason, last fault, correction reason, observed window cycles, configured cycles|
|191|Reserved0|
|192,196|Raw-sample age at original base preparation/send anchor, u32 ms; original producer stale limit, u32 µs|
|200..231|HMAC-SHA256(engine_key32, bytes0..199)|

Record enums and flags follow `flex_runtime.hpp`; unknown bits/enums/infinity reject. Unknown F32 values use canonical NaN `0x7fc00000`. Unavailable raw age isUINT32_MAX and an unavailable Record has stale limit0. The stale limit is rounded from the producer's F32 calibration to microseconds with positive half-up rounding, matching C++ `llround`. A raw source without a completed window has unknown age, including timestamp0. A synthetic scalar fixture may legitimately originate at epoch0 but cannot qualify as raw capture. Target control cannot claim synthetic flex origin; a claimed matching configuration requires matching nonzero producer/base revisions.

The sender retains one immutable pair per peer for at most250ms. SDK failures retry those exact bytes, without replacing the snapshot or restarting its age. It rechecks current time immediately before every submission. Both successful SDK submissions are required to enter the engine ACK window, which uses the original preparation time. Capability exchanges, unpair and key changes cancel pending pairs; capability replies also retire pairs made while the reply was waiting. Sequence exhaustion never wraps.

The reference receiver buffers at most two sequences for250ms from their first fragment. Either order works. Duplicates cannot extend that deadline. Partial observations never reach the public display, ACK, latest-completed sequence or engine liveness. Expired, evicted or authenticated conflicting sequences are retired separately from the last complete sequence, so they cannot later complete or be ACKed. A changed signed duplicate quarantines the sequence even if its changed fields fail semantic validation. Fresh queries clear partial state; per-boot repeated-source immutability and age floors survive clock-query refresh.

All receiver `now_ms` arguments mean current processing time from one monotonic clock, not a delayed packet's historical receive stamp. Clock reversal through any time-bearing API, including status reads, requires a fresh timed query. Raw age uses the original sample, then adds fragment wait, negotiated transit,2% clock allowance and local elapsed. A conservative F32/control-age lower bound also covers the first pair. Repeated proposals preserve the full flex Record and previous age bounds; explicit unknown age remains unknown. Compare against the original producer deadline. New ADC/control snapshots cannot renew an old raw sample. Base data can remain fresh after flex qualification expires.

Required invalid/unknown/future/expired flex requests red blinking at zero RPM as well as during operation; held samples are rechecked each radio loop. Flex Off adds no fault dependency. The indication is an advisory software policy and does not prove target execution, LED operation or CPU health.

Schemas1..4 remain byte-identical and suppress engine telemetry when corrections or a secondary ETH condition require flex; their slots retain explicit sensor fallback. A schema5 receiver may acknowledge a complete invalid/fault observation: receipt, value quality and control permission are separate. `flex_control_allowed` in the reference status covers the flex gate alone, not global engine safety.

Reproduce with fresh output directories:

```sh
PYTHONPATH=tools python3 -B -m unittest test_flex_radio test_engine_observability test_load_radio test_secondary_radio
python3 -B scripts/test_radio_service.py --output .cache/engine/NEW_RADIO
python3 -B tools/check_radio_service_fixtures.py .cache/engine/NEW_RADIO .cache/engine/NEW_INTEROP.json
uv run --offline --with playwright==1.64.0 python -B tools/test_flex_radio_ui.py --fixtures .cache/engine/NEW_RADIO --output .cache/engine/NEW_BROWSER
```

The actual sender/handler code executes against native SDK API models. These checks do not execute the RTOS task, ESP-IDF transport, radio, physical LED or a screen. The [frozen evidence](../reports/engine/flex-radio/README.md) binds source, native frames, browser checks, final linked builds and independent review. Earlier evidence packets remain historical and unchanged.
