markthebault/esp32-ecu/reports/engine/idle-isolation/reviews/layout/review.md

# Independent final IAC-DRAFT2 accessory recheck

Reviewed 2026-11-04 against ECU base `497aabb4a0ea686b240182e42b4c64aefa280c32`. **The corrected accessory passes this bounded circuit/copper recheck; physical output, fabrication and powered release remain on hold.** No production files were changed by this reviewer. A5 is reviewed separately.

The immutable final snapshot bundle is `faa04b70b45721099858e38aa5f9effea7d069dfa2eb0f81359267f3bb547040` (44 files). PCB SHA256 is `dd12136d7c7dec1464d7119dcd1fefe8740fa3743c33520e7c524a3910bb3d2e`. Native KiCad9.0.8 absolute-path runs on a byte-identical writable cache copy give **0 ERC, 0 DRC, 0 unconnected and 0 schematic-parity issues**, all severities/all track errors, without exclusions. Snapshot and working input bytes were checked after execution. See `assembly-final/native-command-log.json`, reports, `assembly-final/probe-result.json` and `review-manifest.json`.

## First-review findings and their disposition

Intermediate47-reference routing and value-only rebind snapshots are retained in `final/` and `value-rebind/`. The final bounded comparison confirms only C1/C2/C3/C4/C8/C10 placements changed, plus R2 value/note; other footprint placements, pad geometry/nets and all15 power segments remain. The first report and source binding remain in `initial-review.md` and `initial-review-manifest.json`; its immutable PCB hash begins `78edb587`. Native checks had passed even though the bypass and gate return were poor.

| Finding | Corrected result |
| --- | --- |
| Driver return51.560mm, joining14.8984mm down the coil return | Separate `LOGIC_GND` joins `ACT_GND` only through copper-only NT1 at Q1 source `(95.08,39)`. Driver-to-source center path25.016mm, including the1.8mm copper tie. Removing the18mm power-return bus in the independent graph leaves exactly one logic contact, at the source. Native shape comparisons find no other physical ground-net contact. |
| C4 driver bypass23.973mm and no nearby larger bypass | Back-side C4 has9.126mm combined rail/return center path and new local film C10 has26.597mm. C4 was rotated and C10 moved to clear front-side solder lands; neither relies on remote C7 as the local driver bypass. Exact THT lead/trace inductance remains a fixture test. |
| Opto/logic bypass detours | U2/C1 and U3/C2 each6.328mm, down from22.698/26.963mm. U4/C3 is22.132mm, down from41.561mm; its PDIP14 supply pins are diagonally opposed. U5/C5 is6.485mm, down from16.228mm. Local stubs are locked. |
| Broken terminal-source notice link | `terminal-source.json` is now present in the new accessory and matches the independently downloaded pinned official footprint. |

These lengths describe copper paths between pad centers, including a center convention for touching pads; they are not inductance or switching measurements. They exclude component leads and internal package wiring. Layout changes close the earlier concrete defects without supplying a physical timing guarantee. [TI driver guidance](https://www.ti.com/lit/ds/symlink/ucc27524.pdf), [Vishay opto data](https://www.vishay.com/docs/84732/6n137_vo2601_vo2611.pdf).

## Independent pin, copper and assembly observations

The literal review map checks **47 references and123 electrical pads** against native schematic XML, the declared net contract and actual PCB assignments. This includes121 fitted-component pads and two unfitted copper-tie pads. All semiconductor/diode assignments from the initial primary-source audit remain correct; intended detector, logic and regulator returns now use `LOGIC_GND`. Q1 source, J2 return, C6 input-reservoir negative and R14 gate-source bias retain `ACT_GND`. Both opto LEDs and their buffer circuits remain wholly carrier-side. The exact UCC27524P/P.B guarantee remains a release hold; family pin-map agreement is not a substitute for it.

Unused HCT inputs are grounded, unused outputs NC; U1 INB/ENB are grounded and OUTB NC. MCP100 D-bondout RESET_n feeds ENA through R11 with R12 pulldown; the eight-row DC LED/RUN/local-PG truth table passes. LM317 ADJ/OUT/IN, both live tabs, flyback/protection/clamp diode polarity and electrolytic polarity pass the actual-pin check. The freshly recomputed16 regulator corners remain4.9673-5.3459V with the selected120/374ohm1% divider. [HCT02](https://www.ti.com/lit/ds/symlink/sn74hct02.pdf), [MCP100](https://ww1.microchip.com/downloads/en/DeviceDoc/11187f.pdf), [LM317A](https://www.ti.com/lit/ds/symlink/lm317a.pdf), [IRLZ44N](https://www.infineon.com/assets/row/public/documents/24/49/infineon-irlz44n-datasheet-en.pdf), [exact2N3904BU](https://www.onsemi.com/download/data-sheet/pdf/2n3904-d.pdf).

The board remains **90x60mm, two copper layers,1.6mm substrate**. Every fitted electrical pad is through-hole; drills0.75-1.7mm. The two0.30/0.35mm via drills are routing features. NT1 has two bare F.Cu SMD-style pads joined by a0.6mm copper line, excluded from BOM/placement with no fitted part; it introduces no SMD assembly. The BOM has46 rows including four unplated3.2mm mounts. Direct-solder DIP footprints remain, with no IC sockets.

All15 locked2mm power segments survive exactly; the18mm source-to-J2 return has no narrow gate/logic neck. The 5mm rule area x35.3..40.3 covers both copper layers and forbids tracks/vias/pours/pads. Actual carrier copper ends x35.2 and actuator copper begins x40.42, giving at least **5.22mm** horizontal separation. No ACT/logic-to-J1 DC path exists with intact optical barriers; a deliberately inserted ground bridge restores the path as a negative control. This does not certify isolation or cover case/harness conductive bridges.

Actual back-side parts are C1/C2/C3/C4/C5/C10/R13/R14. Others, including relocated front C6, match their declared sides. Footprint provenance checks confirm only documented silkscreen removal/name changes for the variants: front U1/U4 keep Fab, courtyards, pads and notch/pin1 marker; back variants keep pads/Fab/courtyard while omitting silk graphics. Native courtyard checks pass. An independent eight-back-body/front-PTH-land sweep now reports no projected overlap; minimum box clearance is0.38mm for C1/C2,0.90mm for C3,1.31mm for C4 and1.53mm for C10. The drawings include stroke width. This is a planar check, not an assembled3D fit acceptance.

## Remaining concrete holds

- **Back-side assembly:** the earlier C10/U1, C3/U4 and opto-body/solder-land proximity findings are corrected. C4 lead ends still project beneath the front U1 mold; trim/inspect them before directly soldering the DIP. Freeze actual body envelopes, lead lengths, stand-offs and assembly order for all eight back-side parts, then check under-board/case access. The opposite-side planar sweep does not qualify these3D details.
- **Finished-hole fit:** Q1/U6 use nominal1.10mm holes. Drawn maximum/bounding lead sections approach1.080mm for IRLZ44N and1.094mm for TI NDE0003B. Freeze finished-hole tolerance and actual leads, or review larger holes/pads before fabrication. Generic stock-footprint agreement does not close this fit hold. [Infineon package](https://www.infineon.com/assets/row/public/documents/24/49/infineon-irlz44n-datasheet-en.pdf), [TI NDE package](https://www.ti.com/lit/ds/symlink/lm317a.pdf).
- **Combined RUN loading:** A5 review found the omitted R50/Q7/R53 branch and ten HCT input loads. R2 is now2.2k1%. Under an explicitly conditional500uA normal Q7 proxy and stated resistor/input limits, source demand is3.93004mA; ST only specifies that Q7 current at10V/25C, and its fault sink differs. The earlier blanket<=4mA claim is withdrawn. Measure combined loaded RUN/startup/fault/temperature behavior; no forced-beta guarantee is inferred. See `a5/review.md` and its loading probe. [ST data](https://www.st.com/resource/en/datasheet/vnp35n07-e.pdf).
- **Electrical guarantees:** freeze actual UCC27524P/P.B data, exact leaded capacitors/passives and a declared operating range. Loaded GPIO/RUN levels, NPN saturation/storage, LED current and actual opto load/timing remain conditional. The software accepts1us pulses; no measured physical minimum exists. [TI exact-P record](https://www.ti.com/product/UCC27524/part-details/UCC27524P), [onsemi](https://www.onsemi.com/download/data-sheet/pdf/2n3904-d.pdf), [Vishay](https://www.vishay.com/docs/84732/6n137_vo2601_vo2611.pdf).
- **Brownout/heat/load:** MCP100 assertion and hysteresis lack maxima; static headroom is not an unconditional brownout proof. Scope the assembled rail/PG/gate/drain through startup, interruption and brownout; verify regulator/diode/FET temperature, capacitor ripple and actual valve R/L. The dedicated protected9-16V/<=2A branch and independent disconnect must be concrete. A normal-current stuck-on valve need not clear a fuse. Both TO220 tabs remain live. [Microchip](https://ww1.microchip.com/downloads/en/DeviceDoc/11187f.pdf), [TI](https://www.ti.com/lit/ds/symlink/lm317a.pdf), [Infineon](https://www.infineon.com/assets/row/public/documents/24/49/infineon-irlz44n-datasheet-en.pdf).

Use the current-limited resistor fixture before an identified NC valve. Include reset/download, watchdog/interlock/stalled producer, signal opens and both return opens. Hardware output remains disabled; no flash/eFuse changes were performed. The accessory is held for fabrication/physical qualification, not approved for an engine or vehicle.

`source-manifest.json` records primary URLs and verified SHA256 where available; blocked web-only records have no invented hash. Primary PDFs/extracts/renders stay local research inputs and must not be redistributed. The two pinned official KiCad footprints were independently re-downloaded and matched. Inherited installed-library footprints remain bound to archived local input hashes without a claimed upstream commit. Reproduce the final independent probe with `/usr/bin/python3 .cache/engine/idle-isolated-layout-review/review_probe_current.py`; its JSON, all-pad CSV and actual-coordinate PCB images are in `assembly-final/`. No fabrication exports were generated.
