markthebault/esp32-ecu/reports/engine/load-model/reviews/architecture/architecture-assessment.md

# Independent load-model architecture assessment

Reviewed baseline: `1d6a9acb34838ea175f2dfa7ccd9786e96d2d11b`.
Reference: Speeduino `9ff5aae44de51fdc00d3fb1c7c2bfc1f0d0b3e20`.
Date: 2026-11-04. Reviewer: independent child agent, read-only production access.

This is an architecture assessment and controlled native-function probe. It does not approve the implementation being written concurrently, establish engine feature parity, or validate physical outputs, an actual engine, boost operation, or vehicle conditions. All created files are under this cache directory. Existing review evidence is retained.

## Conclusion

Implement table coordinates, pressure normalization, AFR incorporation, sensor requirements, and axis metadata as separate explicit concepts. MAP/TPS/IMAP-EMAP alone is a table selector. TPS indexing with physical MAP still multiplied into charge is a hybrid TPS-indexed speed-density model. Pure Alpha-N requires no hidden physical-MAP factor. An IMAP/EMAP coordinate is a dimensionless ratio percent and can exceed100% without manifold boost.

Root's proposed first increment is coherent: independent primary fuel/spark sources; lambda and trim sources that can follow primary fuel or be explicitly independent; Off/MAP÷100/MAP÷baro pressure modes; a deliberate J16 role; explicit axis-basis metadata; exact historical MAP defaults. Root subsequently added mutually exclusive AFR multiplier choices to the planned increment, with a declared running delay and neutral readiness/loss policy. Secondary fuel/spark combinations and switches, plus the separate barometric fuel-correction curve, remain explicit open gaps. This increment does not by itself close full load-feature parity.

## Actual pinned reference behavior

The copies under `reference-source/` come from the pinned Git object, not a moving branch.

| Concern | Pinned implementation and meaning |
| --- | --- |
| Primary fuel coordinate | `speeduino.ino:87-91` stores `fuelLoad=getLoad(fuelAlgorithm)` and indexes VE1. |
| Primary spark coordinate | `speeduino.ino:97-101` independently computes `ignLoad=getLoad(ignAlgorithm)` and indexes ignition. |
| MAP coordinate | `load_source.h:29-42`: absolute integer kPa. |
| TPS coordinate | Same function returns `TPS*2`; status TPS is half-percent units, so this is quarter-percent coordinates0..400. INI feedback scale0.25 converts it to physical0..100%. Do not pass physical TPS percent directly as native coordinate. |
| IMAP/EMAP coordinate | Integer `100*MAP/EMAP`. The source does not guard a zero denominator. Target must guard it. |
| Axis quantization | `table3d_axes.h` converts raw load bins by2. MAP bins have2kPa resolution; TPS raw bins display0.5% and internally become2 quarter-percent units; ratio bins have2 percentage-point resolution. INI distinguishes kPa, %TPS and %. |
| MAP multiplication | `fuel_calcs.cpp:86-96` is independent of table source: Off, MAP/baro, MAP/100. It uses integer fixed-point arithmetic and rounding, not the project's double precision. |
| AFR target coordinate | `corrections.cpp:659-674` follows primary `fuelLoad`, not spark or secondary fuel coordinates. No independent lambda-load selector exists in this pin. |
| AFR target warmup | With `incorporateAFR`, table target is used even with EGO off. Otherwise EGO on and `runSecs>ego_sdelay` uses table; before delay measured O2 becomes target; EGO off retains prior target. |
| AFR PW factor | `fuel_calcs.cpp:99-112`: `includeAFR` uses measured O2/target only for warm wideband. Else `incorporateAFR` uses stoich/target. When both flags are set, includeAFR wins. Both flags plus EGO off can update target yet apply neither AFR factor. |
| Secondary fuel | `secondaryTables.cpp:15-77`: independent source; Off, Multiply VE1×VE2/100, Add VE1+VE2, conditional switch, input switch. Fuel coefficient clamps255. Conditional thresholds use strict `>`. No continuous percentage-blend mode is present. |
| Secondary spark | Same file: independent source; multiply uses percent cells, add uses angle cells, switch uses corrected secondary advance; fixed timing and cranking skip it. Final type clampsint8, a much wider domain than this carrier's−5..40°. Production switch correction is excluded under UNIT_TEST, so unit-test-only output is an incomplete oracle. |
| Trim coordinate and order | `scheduler_fuel_controller.cpp:295-311` uses primary fuelLoad. It scales complete computed PW including injector opening time. Project intentionally scales effective fuel first and then adds deadtime. Preserve/document that difference. |
| Baro correction | `corrections.cpp:553-559,839-840` separately applies a baro fuel curve. MAP/baro and that correction can both be applied; they are not the same feature. |
| Baro acquisition | `sensors.cpp:575-645`: startup/internal MAP capture accepts65..108kPa; ongoing MAP capture requires RPM0 and decoder quiet for1s. External baro is a separately filtered input. This does not justify capture solely because our decoder currently reports RPM0. |

Controlled production-function probe `reference_probe.py` links the existing native production objects with UNIT_TEST=false. It does not patch fuel/load/secondary algorithms. The saved parent build manifest explicitly describes HAL changes and native timer limits. This task runs controlled status values, not a closed-loop engine simulation.

The observed fixture uses VE100, reqFuel10ms full-cycle, nonsequential effective5ms, opening0.9ms, MAP50kPa and baro80kPa. With no AFR factor the output is5900µs Off,4025µs MAP/baro,3400µs MAP/100. Stoich147/target120 produces6993/4708/3946µs; measured160/target120 produces7540/5050/4220µs. Both AFR flags with EGO off preserve the5900/4025/3400µs pulses despite target120. This catches flag precedence that a single inverse-target implementation would miss.

VE1=85 and VE2=50 produce43 in multiply mode,135 in add mode, and50 when switched. Conditional RPM1000 is inactive at1000 and active at1001. A nonflat AFR table produces target106 before and after switching a TPS-based secondary table while primary fuelLoad remains50. Deliberately changing primary fuelLoad to200 yields134. See `reference-probe.csv` and JSON for actual readback and complete setup.

## Existing project's contract

Frozen `engine.hpp:179-236` indexes VE, spark, lambda and enabled cylinder trims with physical MAP. Its charge expression is absolute MAP×cylinder volume×VE/(R×absolute IAT). Target lambda always divides fuel, independently of EGO. This matches target incorporation, not Speeduino's all-AFR-flags-off behavior. Reference adder is a full-cycle fuel dose at100kPa/25°C/100%VE/λ1 and is independent of current MAP/VE/WUE/EGO; complete dose is trimmed, split by actual openings, then deadtime is added per opening.

Legacy tune validation limits VE20..120%, MAP axes5..110kPa and measured MAP10..110kPa. Spark is−5..40°, target lambda0.75..1.2. Four-cylinder NA constraints, duty/pulse/timing limits, hard cuts and physical output inhibition are separate requirements and must remain intact.

Binding currently requires confirmed non-voltage MAP/TPS/CLT/IAT calibration. All acquisition values share the current ADC sample timestamp. ADC channels0..3 are those four inputs,4 is wideband,5 is POSTCAT/J16,6 battery,7 sensor rail. `config::convert` qualifies units and conversion; do not claim that a configuration field named filter_ms proves an actual matched pressure filter in this path. CAN currently has no implemented pressure-source decoder/freshness contract.

## Recommended explicit contract

1. **Sources and metadata.** Use closed enums for MAP kPa, TPS percent and100×IMAP/EMAP percent. Primary fuel and spark select independently. Lambda and trims default to follow primary fuel, with optional independently declared sources as an extension beyond this pinned reference. Resolve follow-primary to the original primary coordinate even when a secondary fuel table is active. Keep physical MAP/TPS separate from each table's derived coordinate. Unknown enum/basis, nonfinite value or source/basis mismatch rejects the tune.

2. **Pressure and charge.** For new modes, define normalized reference charge using fixed100kPa and actual IAT, multiply by fuel coefficient and selected pressure factor1, MAP/100, or MAP/baro. Pure Alpha-N is TPS indexing plus pressure factor1. TPS with MAP/100 remains hybrid. IMAP/EMAP does not replace the pressure factor unless explicitly selected. Do not make reference pressure equal baro and silently cancel MAP/baro. Preserve the original arithmetic expression on the exact legacy-default path so migration is bit-stable. Report the charge basis; Alpha-N normalized charge is a fuel-model proxy, not independently measured trapped air.

3. **AFR incorporation.** Expose mutually exclusive Off, TargetIncorporation=1/target_lambda and MeasuredToTarget=measured_lambda/target_lambda, or list absent modes as open gaps. Define wideband warmup/freshness/invalid behavior explicitly. If measured-ratio and EGO PI may operate together, show both factors and deliberate compounding. Otherwise reject the combination with a meaningful error. A target table may still serve EGO when target incorporation is off; requirements must follow actual consumers. Define measured-mode delay against a genuine start epoch, not each rev-cut or transient-fault recovery. Record requested mode, applied factor and neutral reason separately. Zero ordinary fuel freezes EGO even if an absolute transient adder is present. Default/migrated behavior remains current TargetIncorporation. Retuning is required when these factors change.

4. **Zero and large coefficients.** If new schema permits0 or coefficients above120, retain old schema/MSQ rejection for historical invalid tunes before upgrading. Final zero fuel must suppress deadtime-only pulses. Positive reference adder with zero ordinary base may produce finite absolute fuel, but effective ratio is undefined: no division by zero and no fabricated finite ratio. Record absolute added fuel and an unavailable-ratio flag/null. DFCO, explicit transient cut and all fault cuts dominate the adder. Judge channel capacity after actual trim and openings. Secondary coefficients may exceed old120 or clamp; expose final clamping rather than silently assuming the primary limit.

5. **Baro.** Choose fixed manually calibrated absolute kPa or a dedicated qualified live input. Root's choice to omit automatic pre-crank MAP capture is defensible and safer than treating unsynced RPM0 as stopped. Fixed is a declared manual value, not an acquisition sample; do not label it live or infer sample freshness. Live loss has no silent fixed100kPa fallback. Baro curve, if added, is an additional correction with its own enable and source dependency. Declare software pressure bounds and the supported altitude envelope, rather than copying an unrelated table-axis bound.

6. **J16 routing.** Default remains POSTCAT monitor. Optional EMAP or external baro must be an explicit exclusive role requiring confirmed, non-voltage absolute-kPa calibration, current acquisition quality and freshness. Live EMAP plus live external baro cannot both consume this channel. A fixed baro plus EMAP is possible. Supporting simultaneous live EMAP, baro and wideband requires another protected input or a real external/CAN acquisition implementation. EMAP needs a suitable conditioned pressure transducer and installation; the raw exhaust path/sensor heater cannot be connected to the protected analog input as if it were a voltage signal.

7. **EMAP and ratios.** Check finite, calibrated, fresh, strictly positive bounded EMAP before division. Define its acquisition bounds independently of MAP's NA110kPa cap; backpressure can exceed110kPa while the manifold remains NA. Define a separate ratio-axis domain capable of values above100%. Example100/80 yields125%. Do not clamp it to100 or reuse kPa labels. Axis endpoint clamping may remain normal lookup behavior, but report clamped coordinates; invalid denominator must inhibit rather than silently select an endpoint/fallback source. Exact numeric EMAP and ratio domains must be tied to the explicitly supported sensor/calibration domain and tested, not guessed from the old MAP axis.

8. **Sensor requirements.** Derive a requirement mask from every enabled consumer. MAP is required for MAP or ratio coordinates, MAP pressure factor, active MAP AE, and any configured secondary MAP condition/source once those features exist. EMAP is required for ratio. Live baro is required for MAP/baro and an enabled baro curve. Lambda is required for measured-ratio and qualified EGO operation according to their declared warmup/fault policy. Keep TPS/CLT/IAT, battery/rail, ADC health/overflow, trigger/synchronization, timing and thermal checks. Configuration metadata and runtime qualification are separate: an unused input is not automatically valid. Conversely disabled tables do not create a runtime dependency merely because retained cells exist. A future-enable transition must validate all its dependencies atomically.

9. **MAP-less behavior.** It is acceptable only when every active consumer is independent of MAP. Missing/unconfirmed MAP remains unknown, input-valid clears, and MAPdot stays unknown. Do not fabricate100kPa for inputs, logs or ESP-NOW. A confirmed finite over110kPa reading remains an independent NA fault even if unused for fueling. Show when the pressure guard is unavailable. This software mode cannot establish that the actual engine is NA or authorize boost. TPS-rate enrichment needs an explicit optional-MAP path; its default standalone validity contract can remain strict. Optional unknown MAP must not inhibit TPS enrichment or contaminate history with fabricated values.

10. **Clock and revisions.** Require the same coherent acquisition and sample age contract for the role channel as other analog inputs. Require no zero/future/reversed/unbounded-hold values. Tune or calibration revision changes must prevent mixed old basis/new numbers and clear applicable EGO/AE histories. Enabling a previously unused pressure must not reuse an old valid flag. Evaluate calibration unit/role/confirmation every binding, not only when the tune is saved. No stateful pressure fallback on fault or source switch.
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
