markthebault/esp32-ecu/reports/engine/load-model/reviews/core/review.md

# Independent load/AFR core implementation review

Baseline HEAD: `1d6a9acb34838ea175f2dfa7ccd9786e96d2d11b`.
Reviewed uncommitted source was frozen before probing. Initial, boundary-fixed, binding/lambda-fixed, and final AFR-epoch bytes remain in separate snapshot directories and manifests. Final reviewed core bytes are under `epoch-snapshot/`. All reviewer writes and builds are confined to this cache directory.

## Result

Two concrete findings were reported and fixed by root. A separate restart-epoch edge was resolved through an explicit conservative AFR-only policy. Re-probes pass. No remaining medium/high core blocker was identified in the reviewed bytes and exercised paths. This is a scoped core/native JSON review, not approval of the full ECU or the concurrently changing tuning/UI/radio/simulator integrations.
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
