markthebault/esp32-ecu/enclosure/a2/enclosure-3d.png

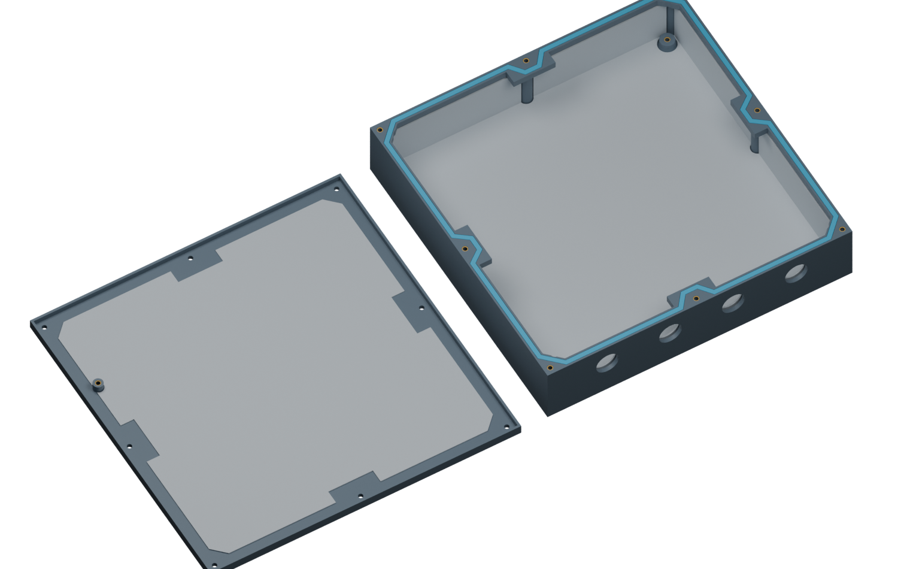
enclosure/a2/enclosure-3d.png
