markthebault/esp32-ecu/enclosure/a2/pcb-mounts-top.png

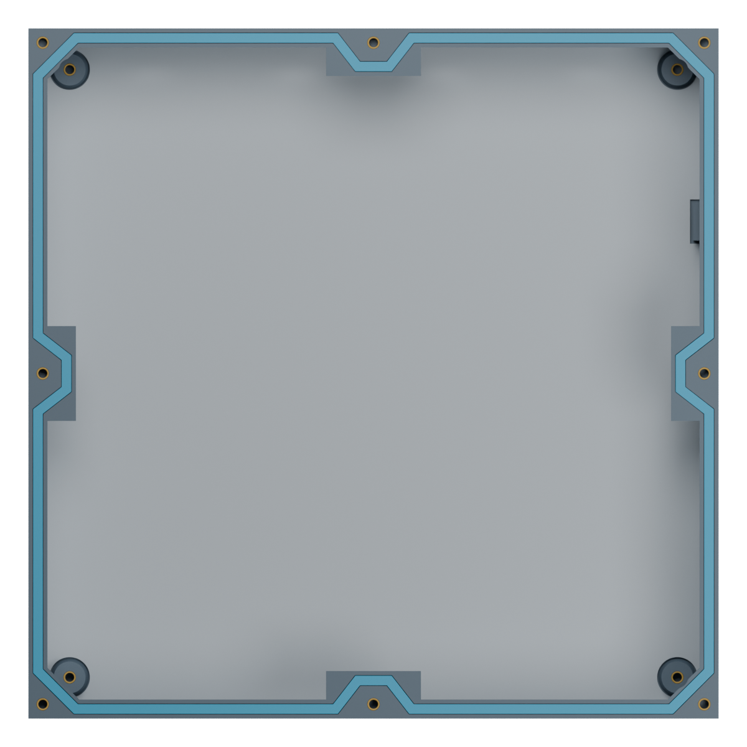
enclosure/a2/pcb-mounts-top.png
