markthebault/esp32-ecu/enclosure/a3/enclosure-3d.png

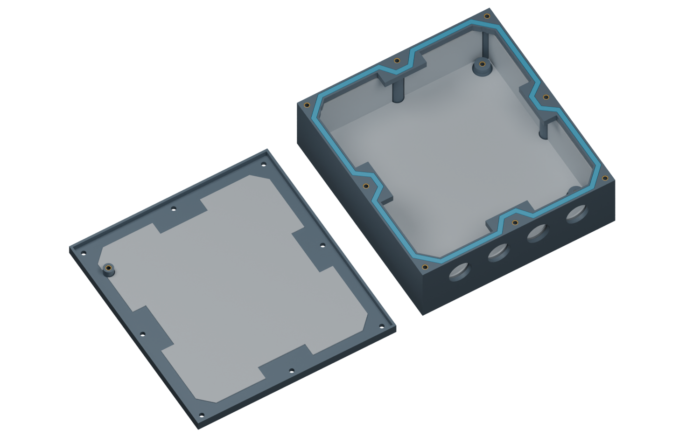
enclosure/a3/enclosure-3d.png
