markthebault/esp32-ecu/enclosure/a3/pcb-mounts-top.png

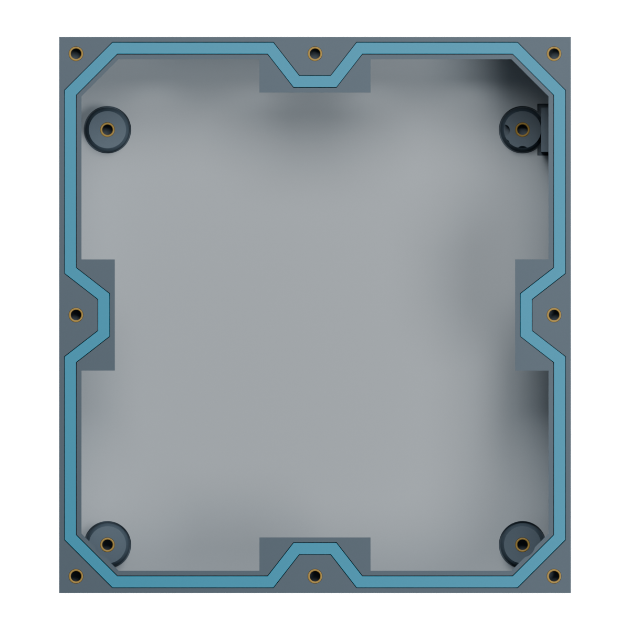
enclosure/a3/pcb-mounts-top.png
