markthebault/esp32-ecu/enclosure/enclosure-3d.png

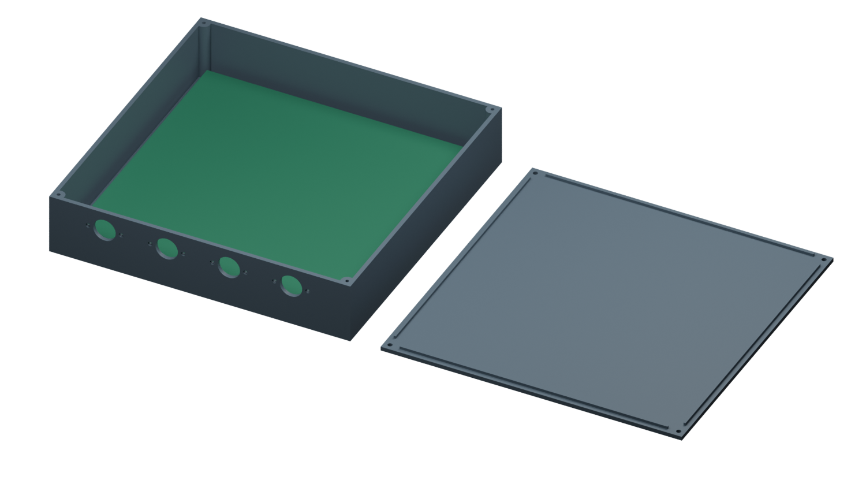
enclosure/enclosure-3d.png
