markthebault/esp32-ecu/hardware/references/esp32-s3-44pin-pinout.png

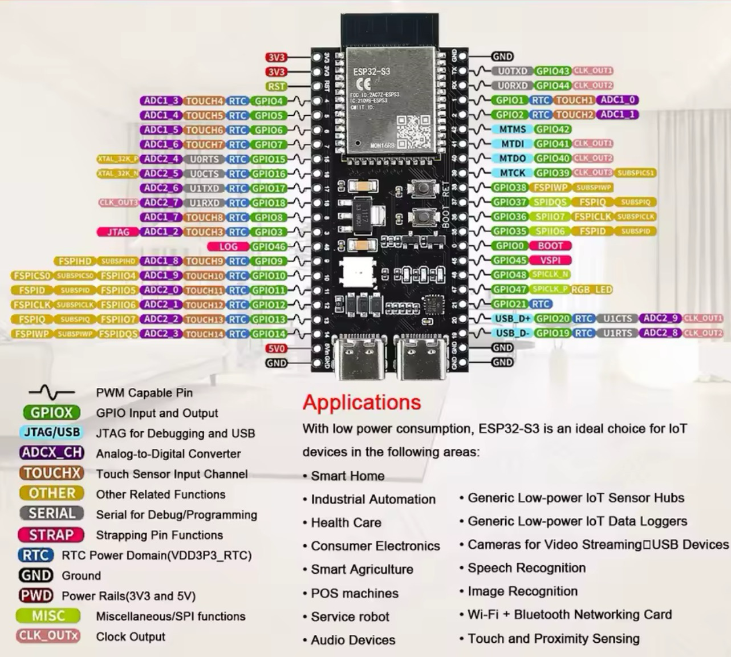
hardware/references/esp32-s3-44pin-pinout.png
