markthebault/esp32-ecu/reports/a1/pcb-3d.png

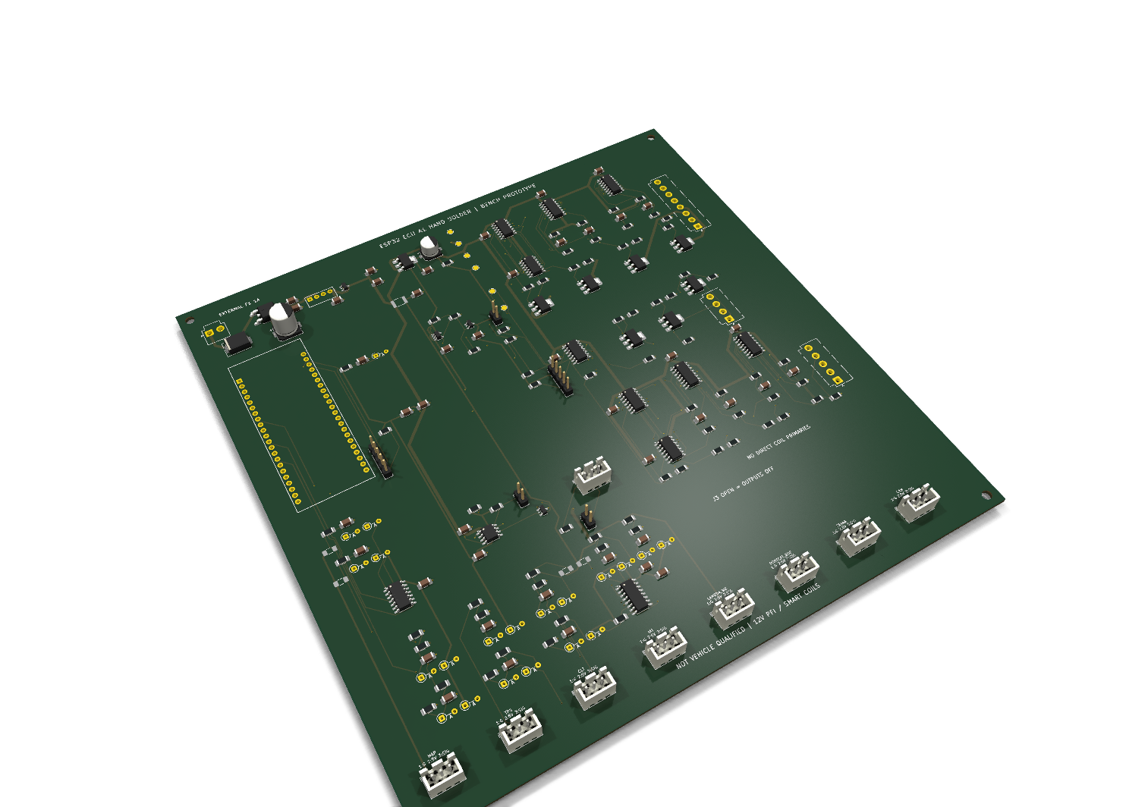
reports/a1/pcb-3d.png
