markthebault/esp32-ecu/reports/a1/pcb-top.png

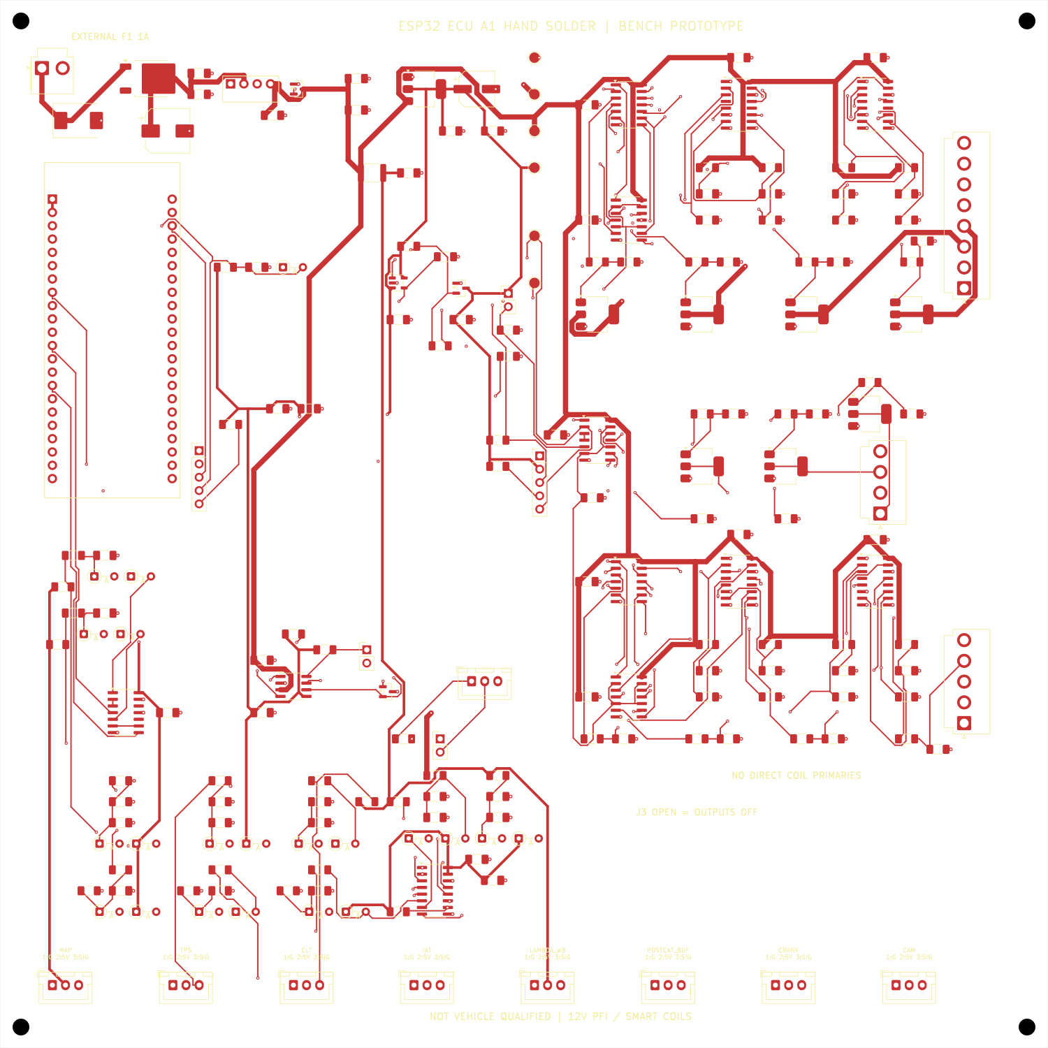
reports/a1/pcb-top.png
