markthebault/esp32-ecu/reports/a3/connection-map.png

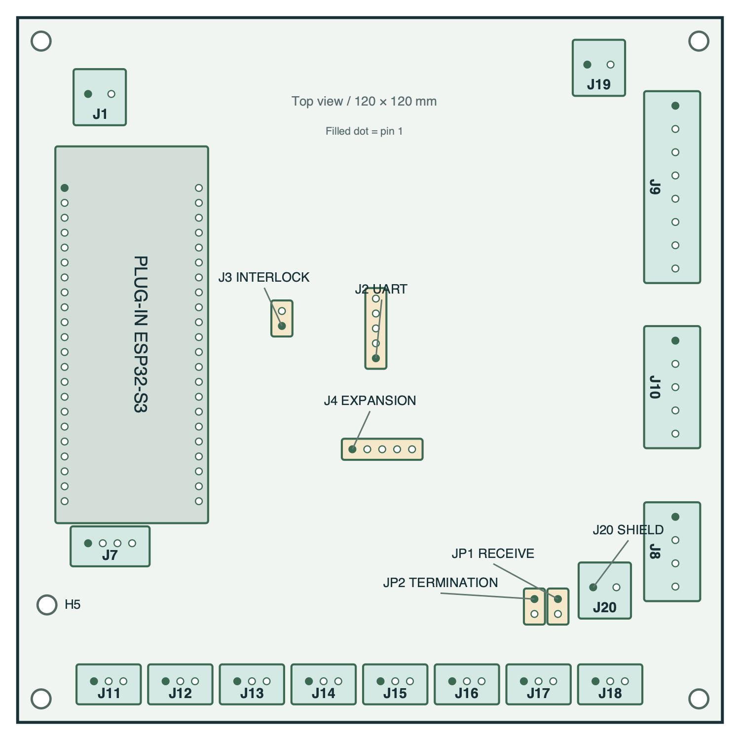
reports/a3/connection-map.png
