markthebault/esp32-ecu/reports/a3/pcb-3d.png

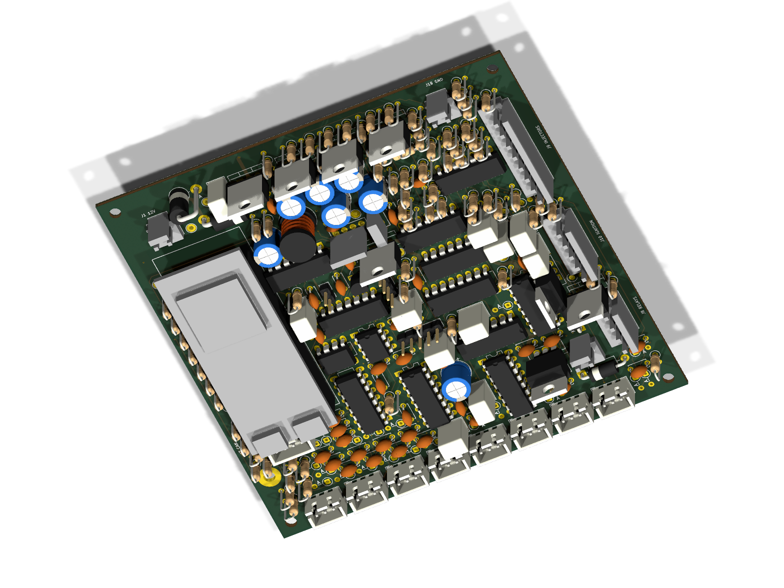
reports/a3/pcb-3d.png
