markthebault/esp32-ecu/reports/engine/a6-compact/native-locality-six-layers.png

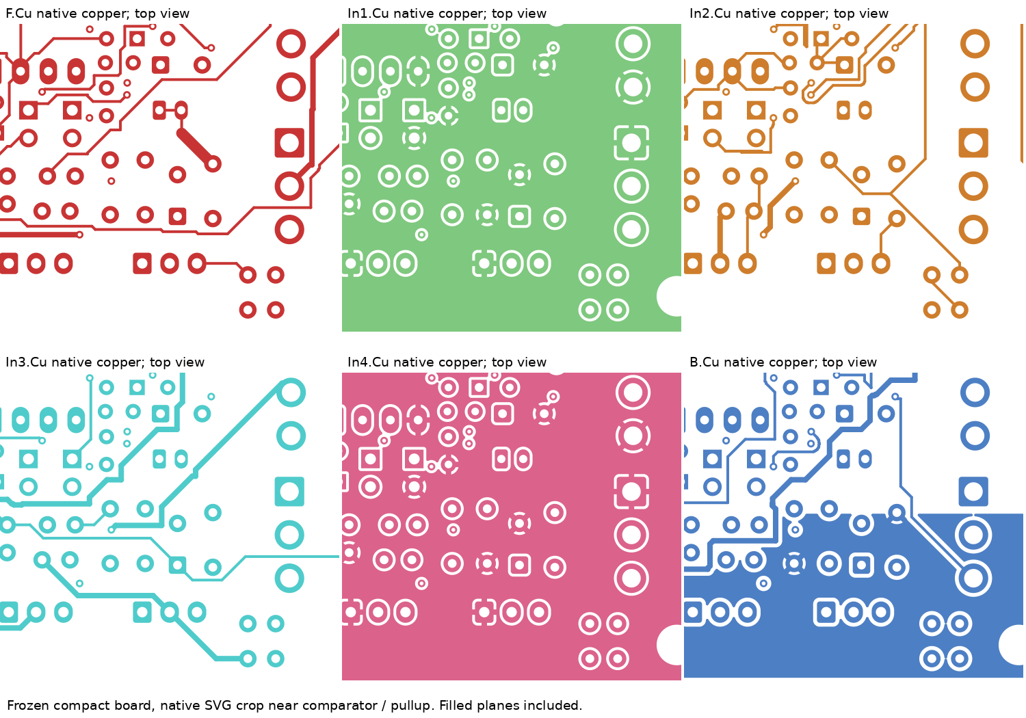
reports/engine/a6-compact/native-locality-six-layers.png
