markthebault/esp32-ecu/reports/engine/cylinder-trims/cylinder-comparison.png

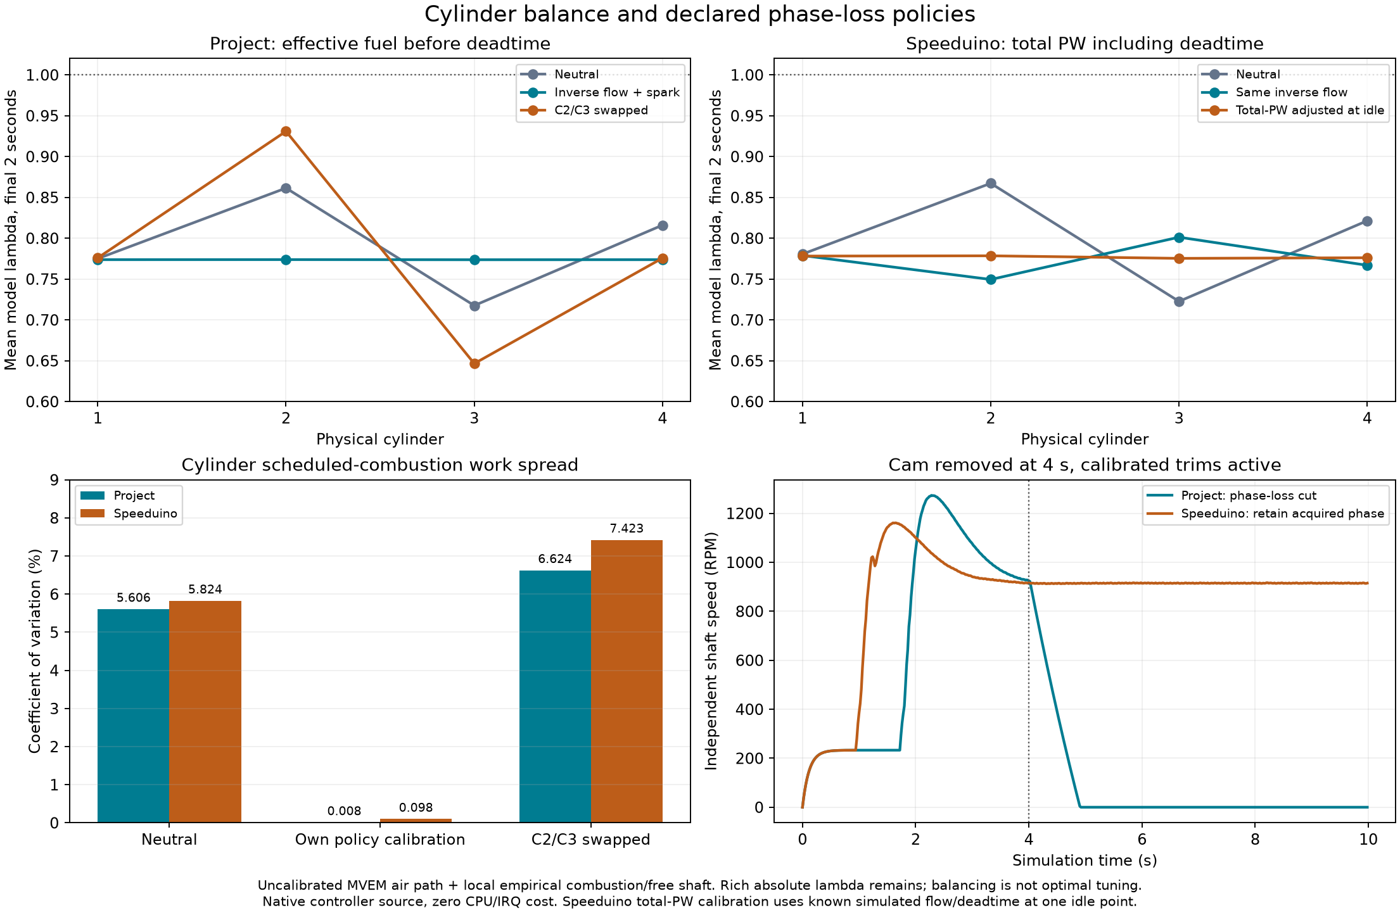
reports/engine/cylinder-trims/cylinder-comparison.png
