markthebault/esp32-ecu/reports/engine/cylinder-trims/cylinder-desktop.png

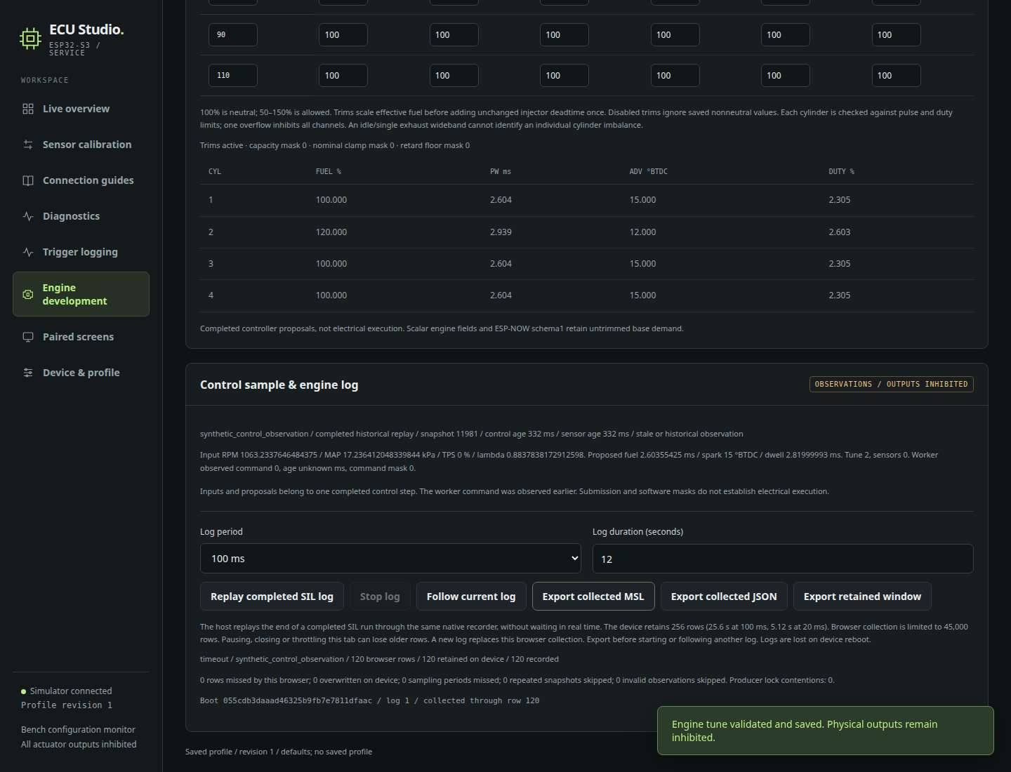
reports/engine/cylinder-trims/cylinder-desktop.png
