markthebault/esp32-ecu/reports/engine/cylinder-trims/cylinder-mobile.png

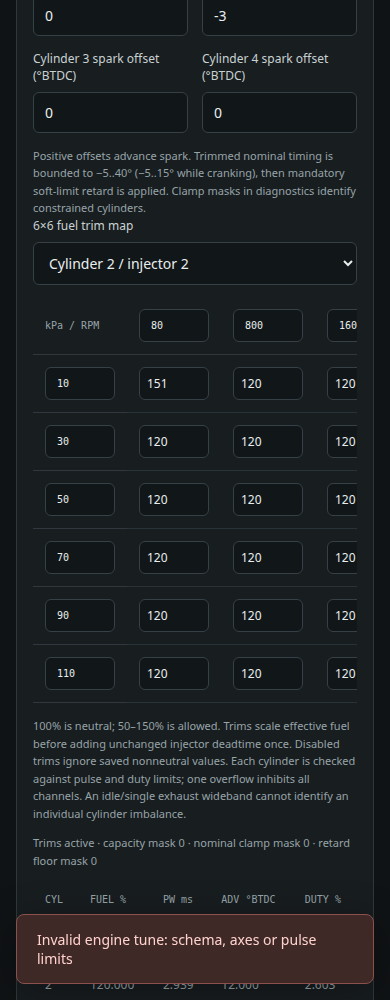
reports/engine/cylinder-trims/cylinder-mobile.png
