markthebault/esp32-ecu/reports/engine/cylinder-trims/megalogviewer-cylinder-fields.png

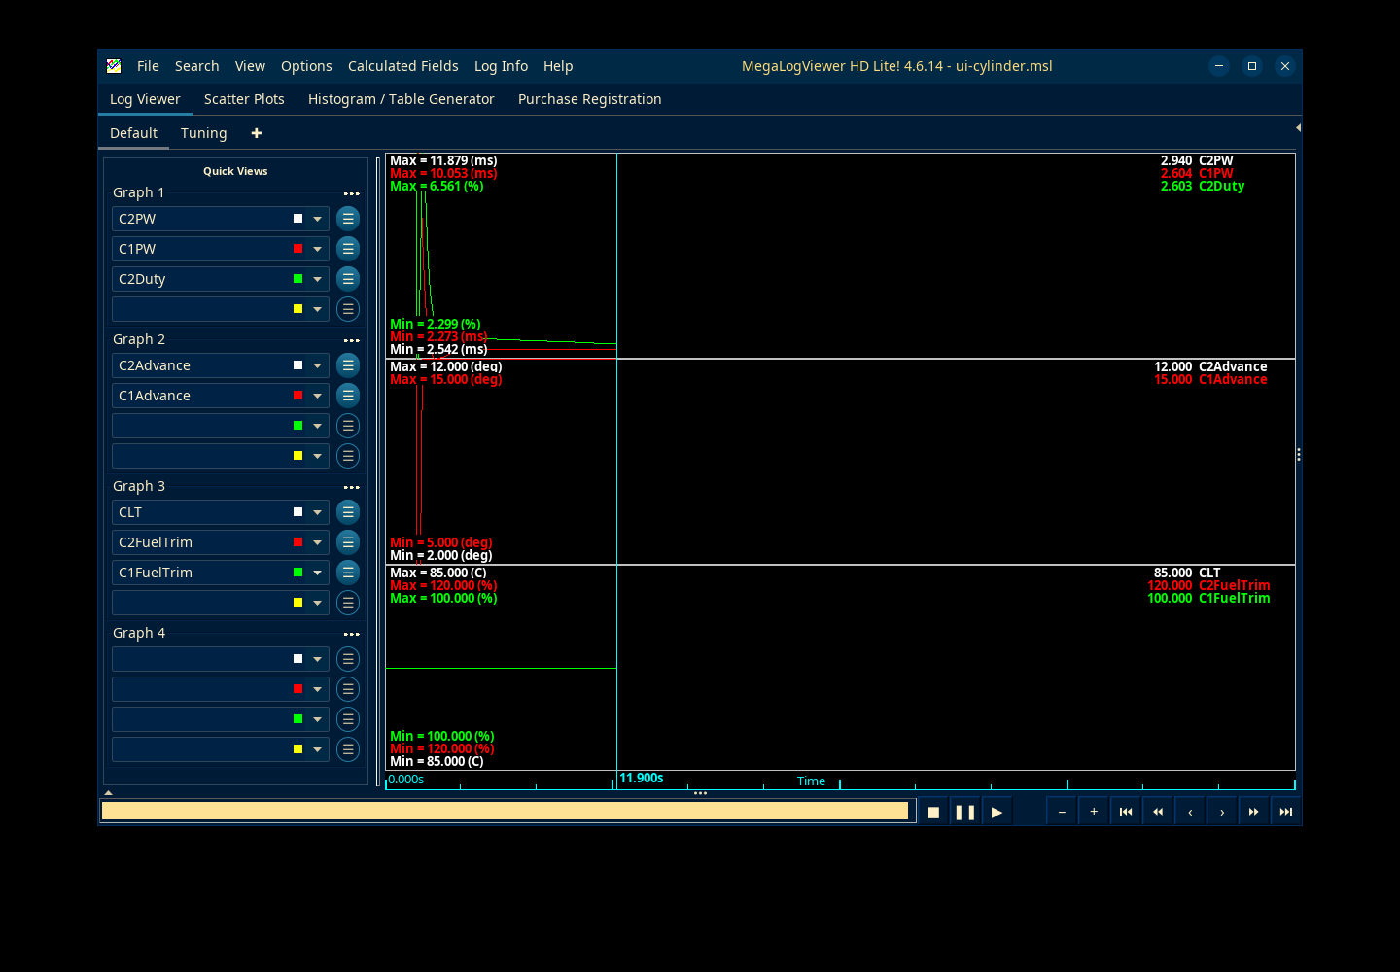
reports/engine/cylinder-trims/megalogviewer-cylinder-fields.png
