markthebault/esp32-ecu/reports/engine/cylinder-trims/tunerstudio-cylinder-map.png

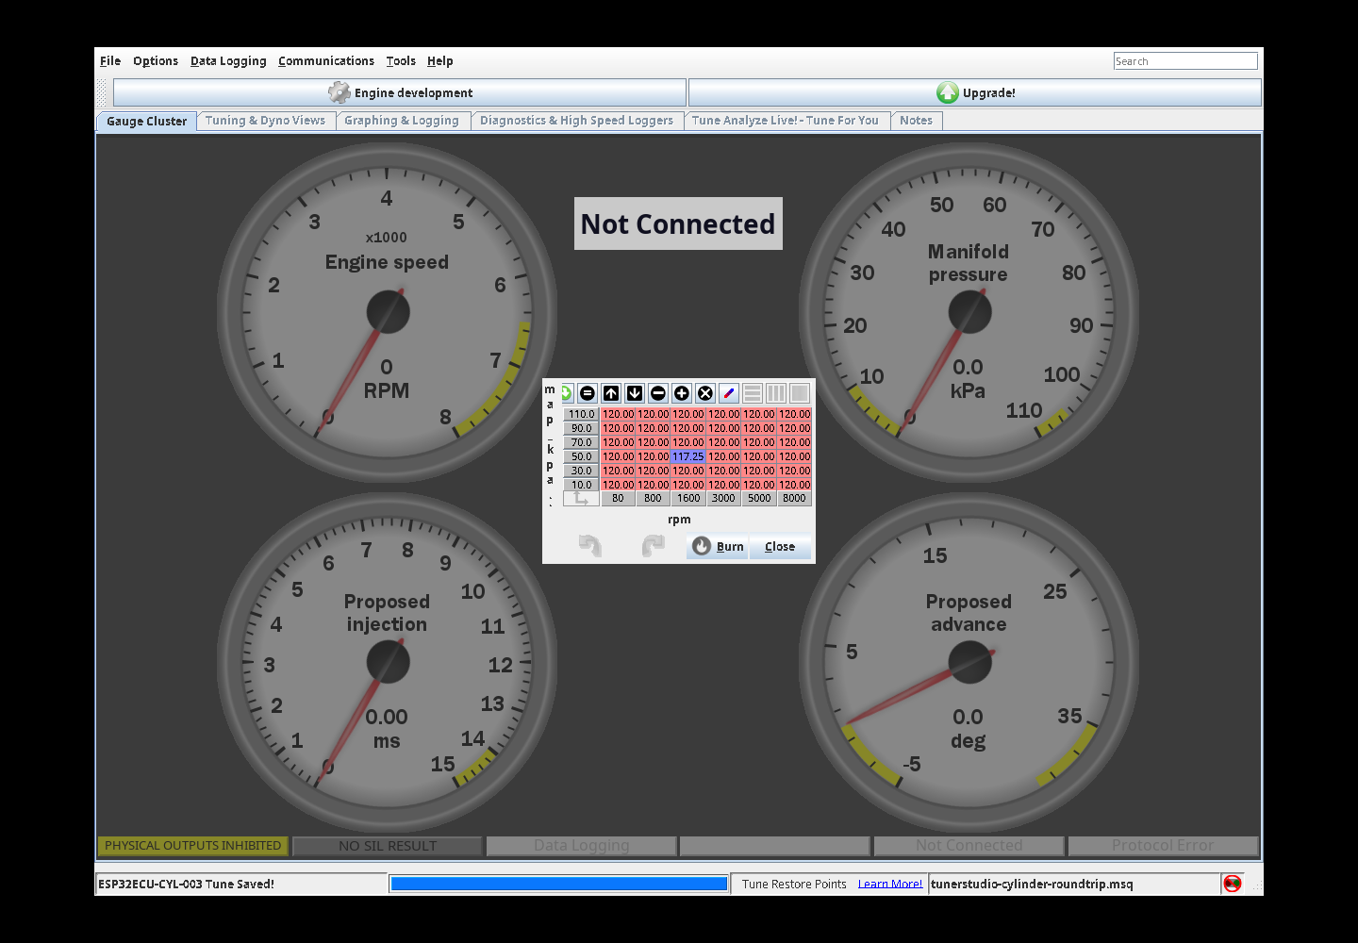
reports/engine/cylinder-trims/tunerstudio-cylinder-map.png
