markthebault/esp32-ecu/reports/engine/cylinder-trims/tunerstudio-cylinder-spark.png

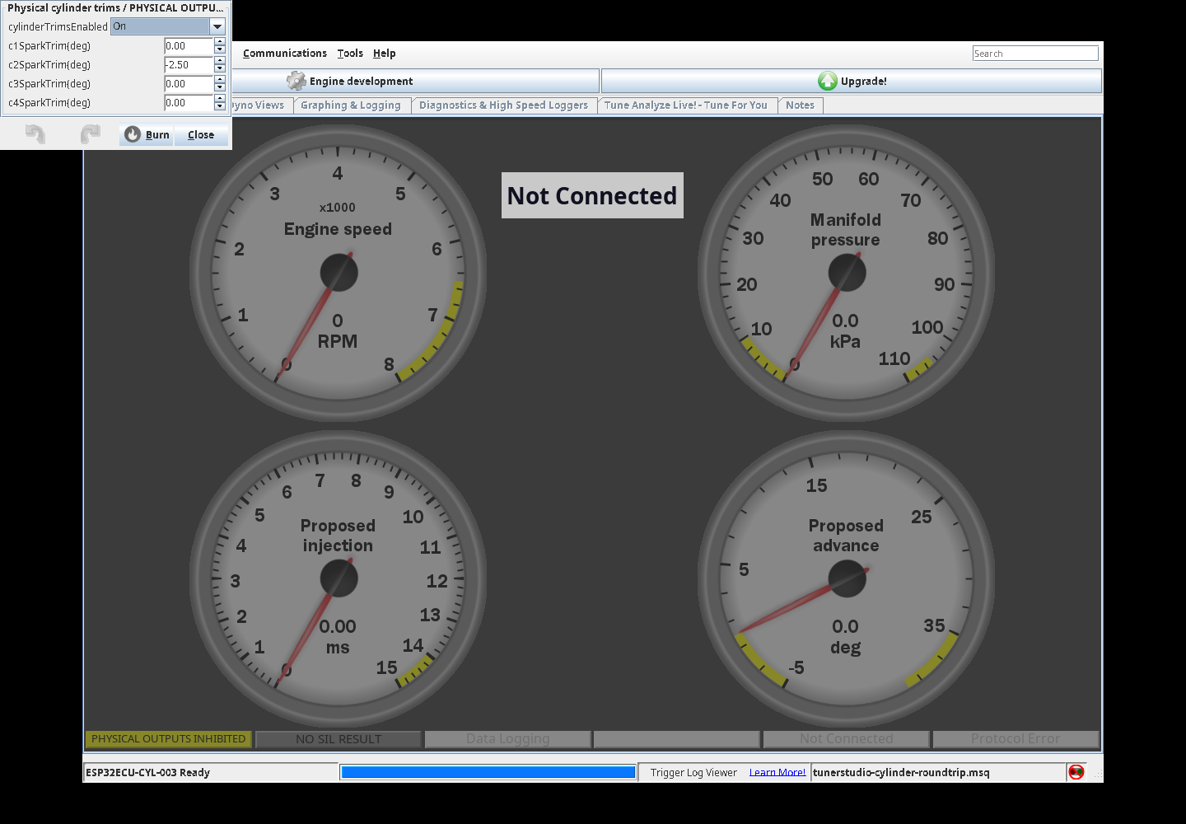
reports/engine/cylinder-trims/tunerstudio-cylinder-spark.png
