markthebault/esp32-ecu/reports/engine/engine-ui-desktop.png

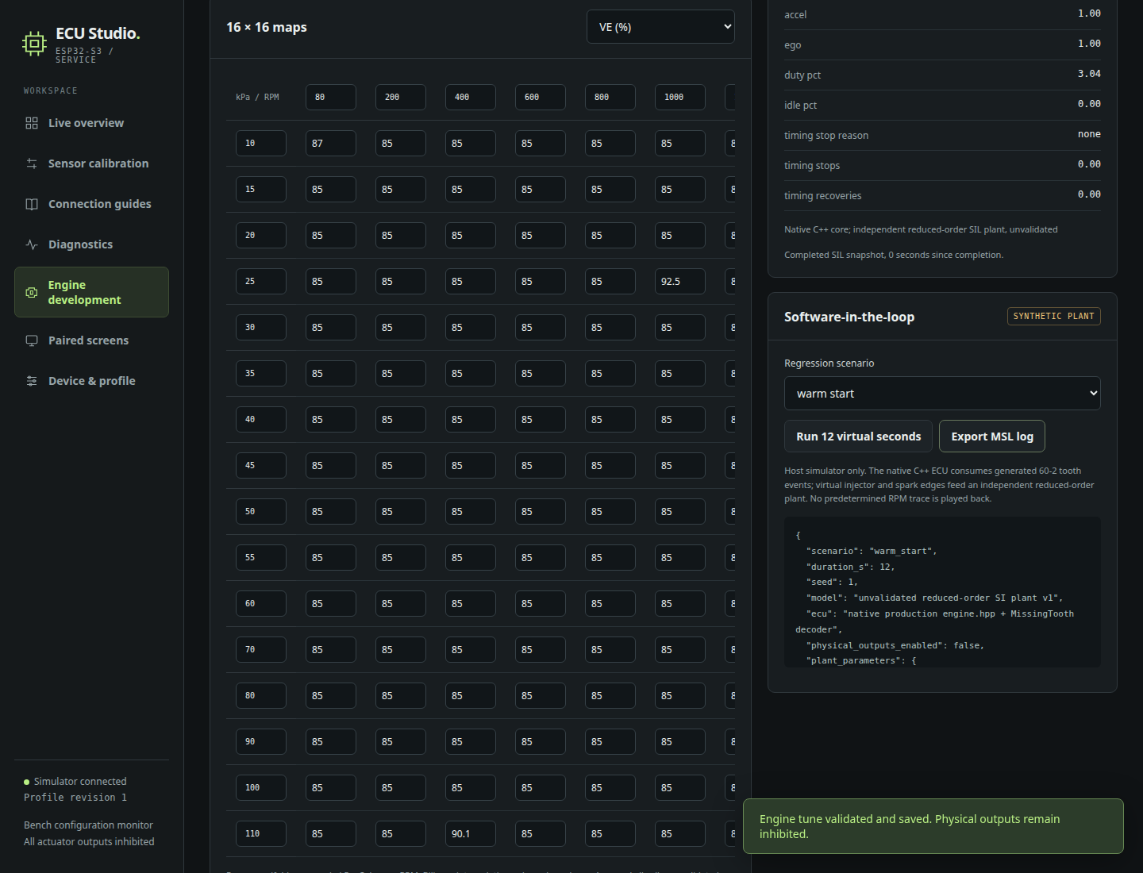
reports/engine/engine-ui-desktop.png
