markthebault/esp32-ecu/reports/engine/flex-integration/applications/mlv-ethanol-plot.png

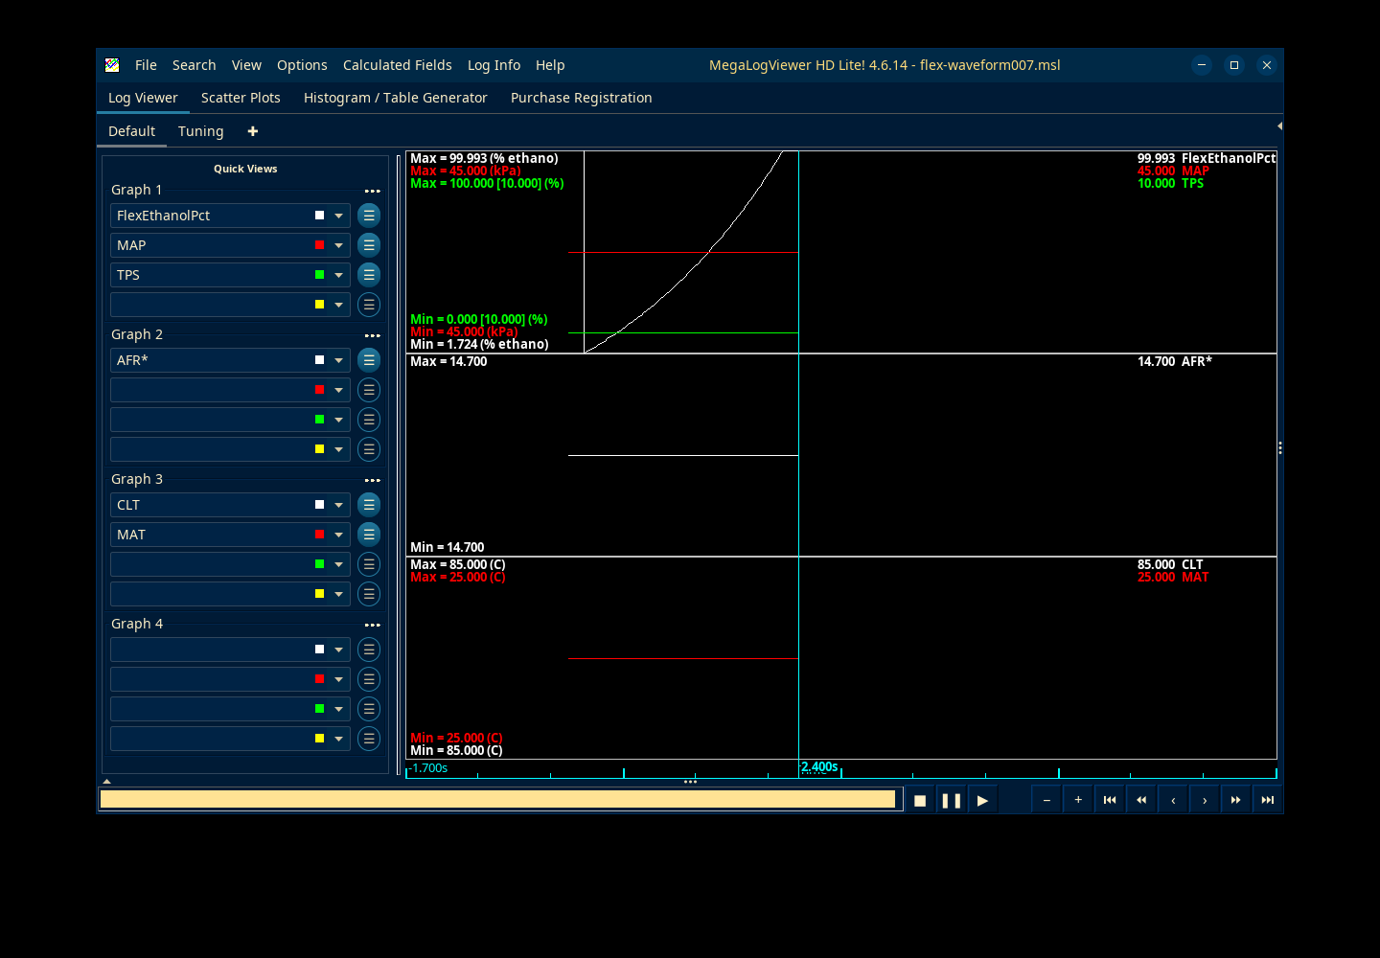
reports/engine/flex-integration/applications/mlv-ethanol-plot.png
