markthebault/esp32-ecu/reports/engine/flex-integration/applications/ts-final-save.png

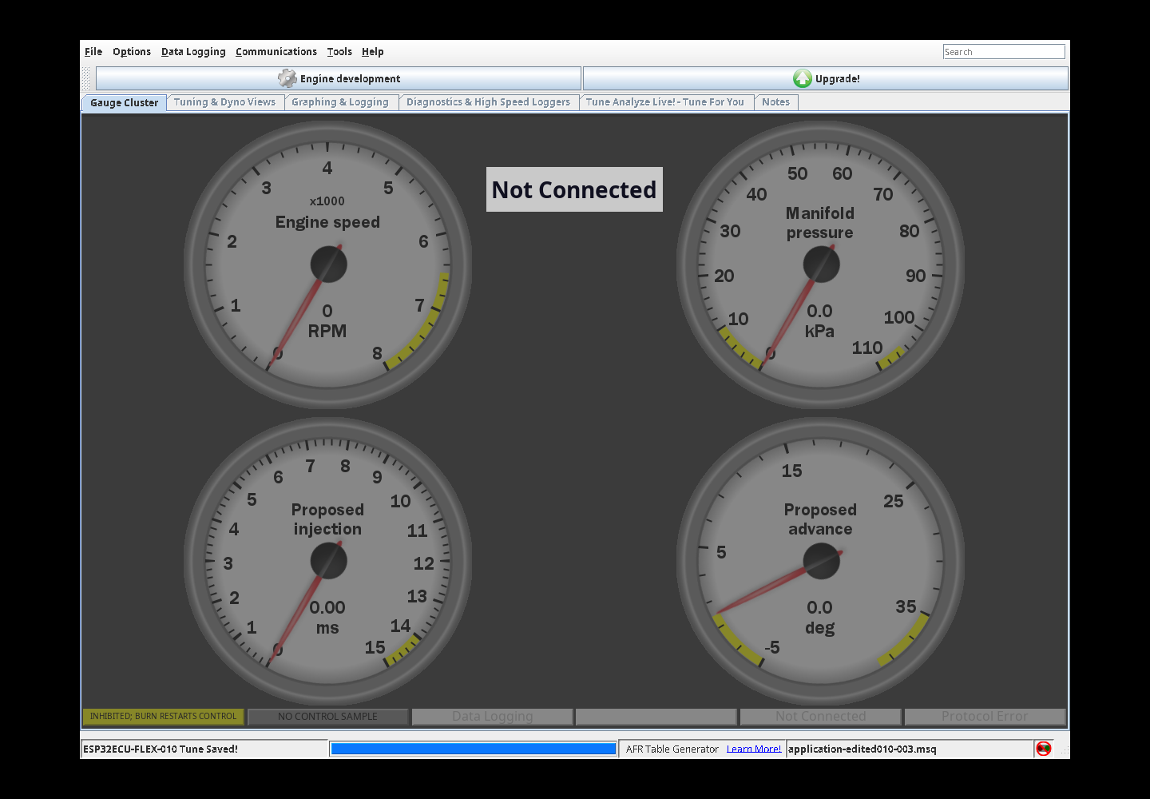
reports/engine/flex-integration/applications/ts-final-save.png
