markthebault/esp32-ecu/reports/engine/flex-integration/browser/flex/flex-desktop.png

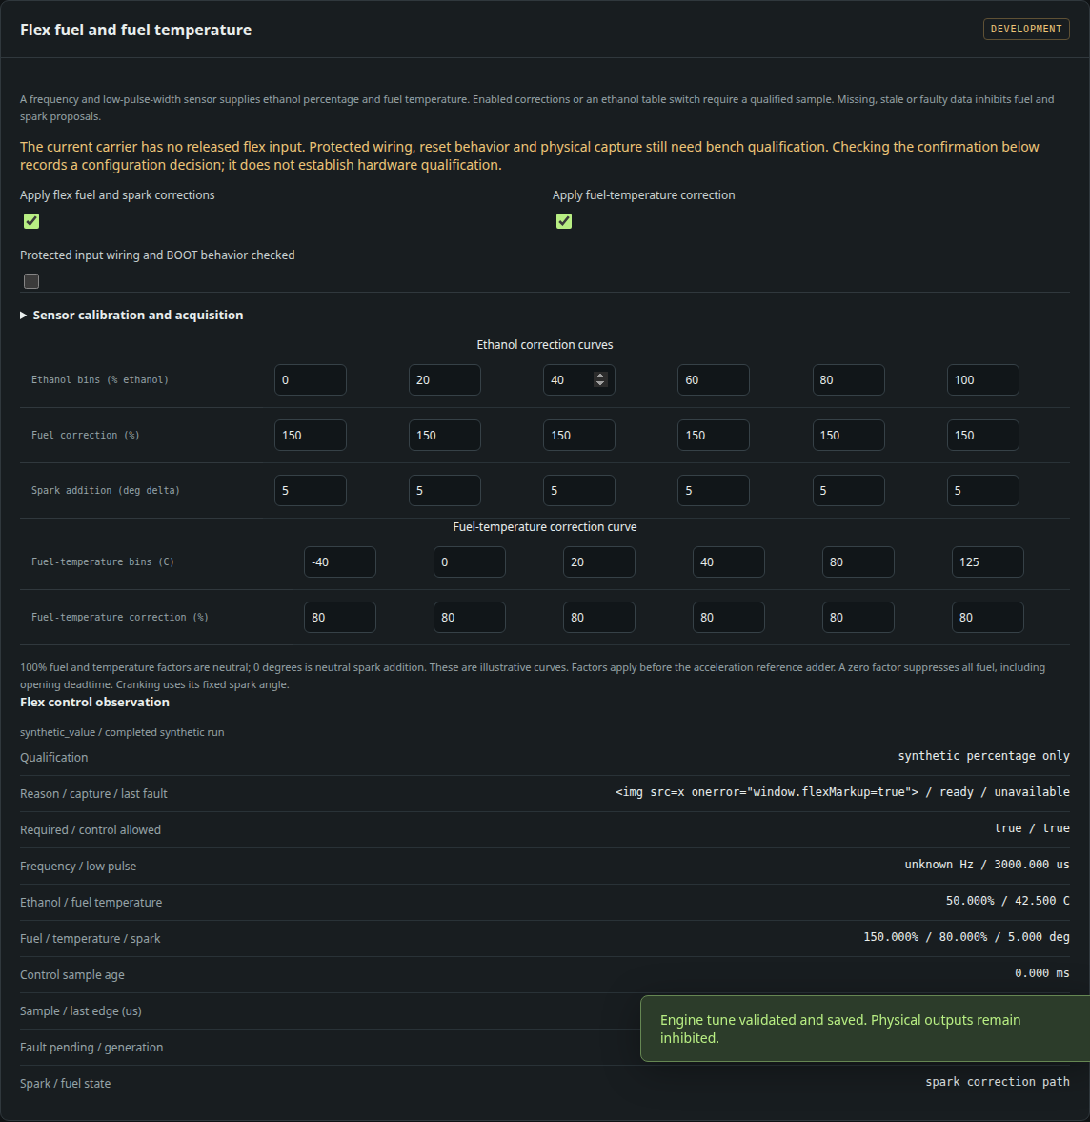
reports/engine/flex-integration/browser/flex/flex-desktop.png
