markthebault/esp32-ecu/reports/engine/flex-integration/browser/flex/flex-mobile.png

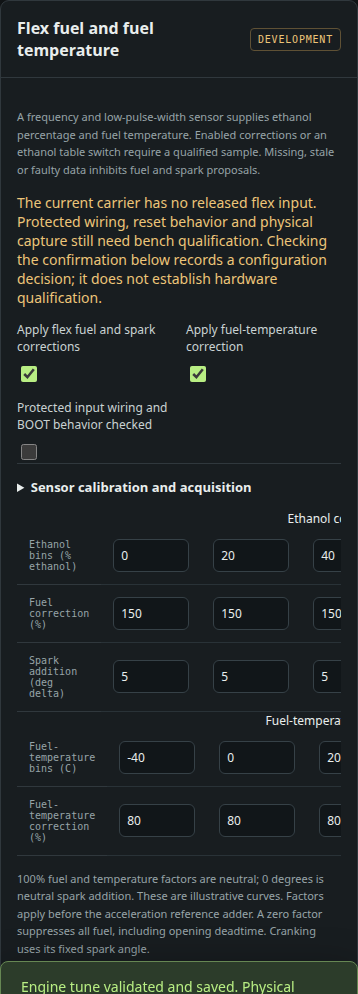
reports/engine/flex-integration/browser/flex/flex-mobile.png
