markthebault/esp32-ecu/reports/engine/flex-integration/browser/observability/engine-log-desktop.png

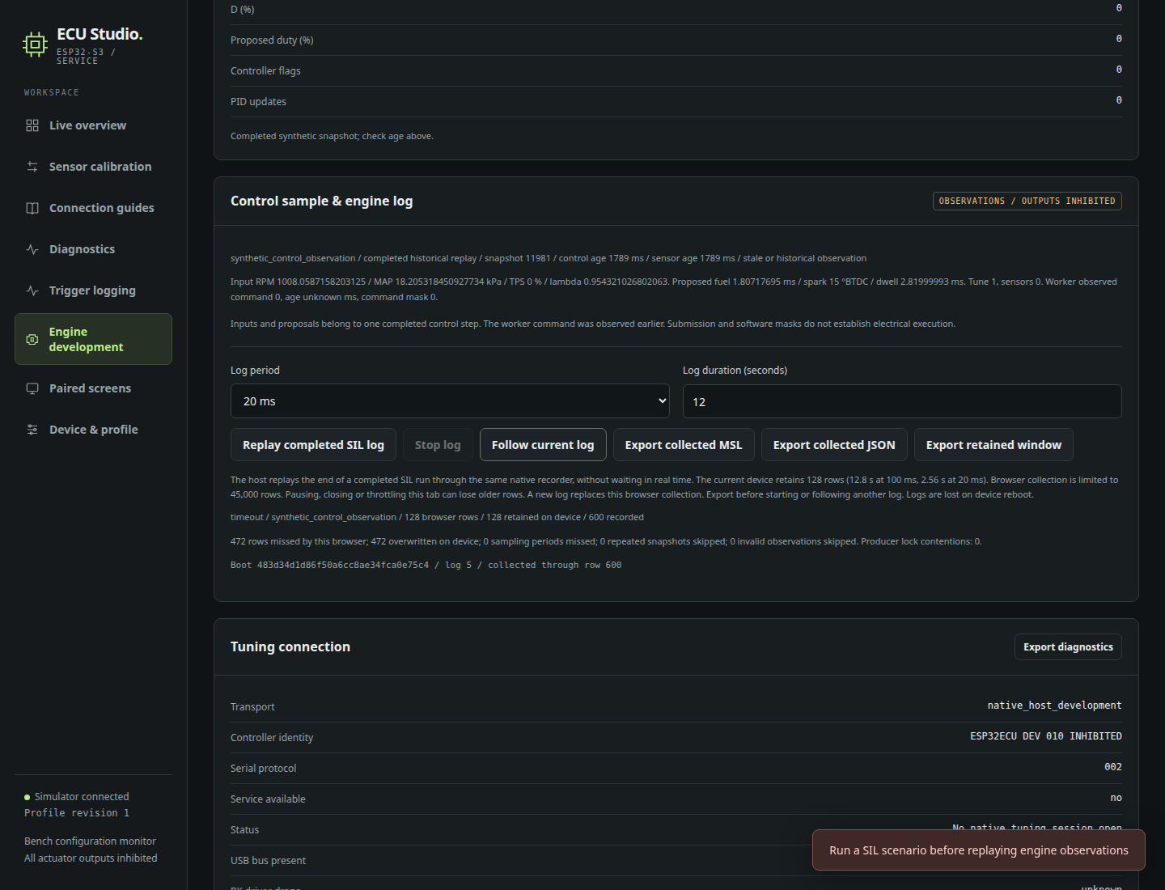
reports/engine/flex-integration/browser/observability/engine-log-desktop.png
