markthebault/esp32-ecu/reports/engine/flex-integration/browser/observability/engine-log-mobile.png

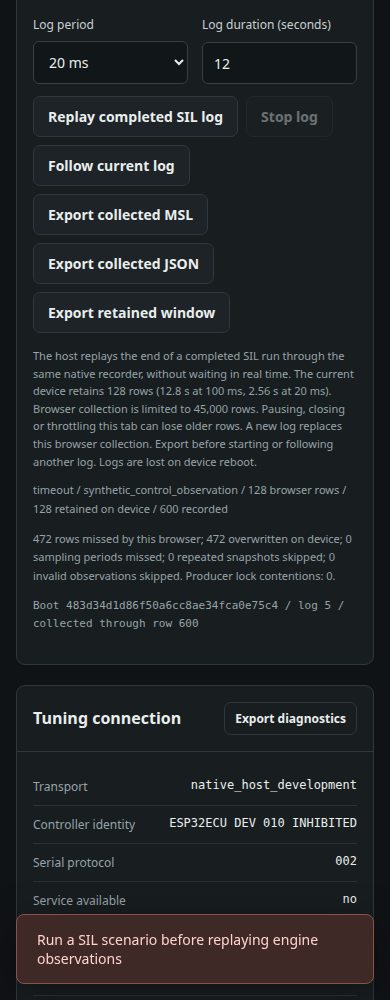
reports/engine/flex-integration/browser/observability/engine-log-mobile.png
