markthebault/esp32-ecu/reports/engine/flex-integration/browser/secondary/secondary-desktop.png

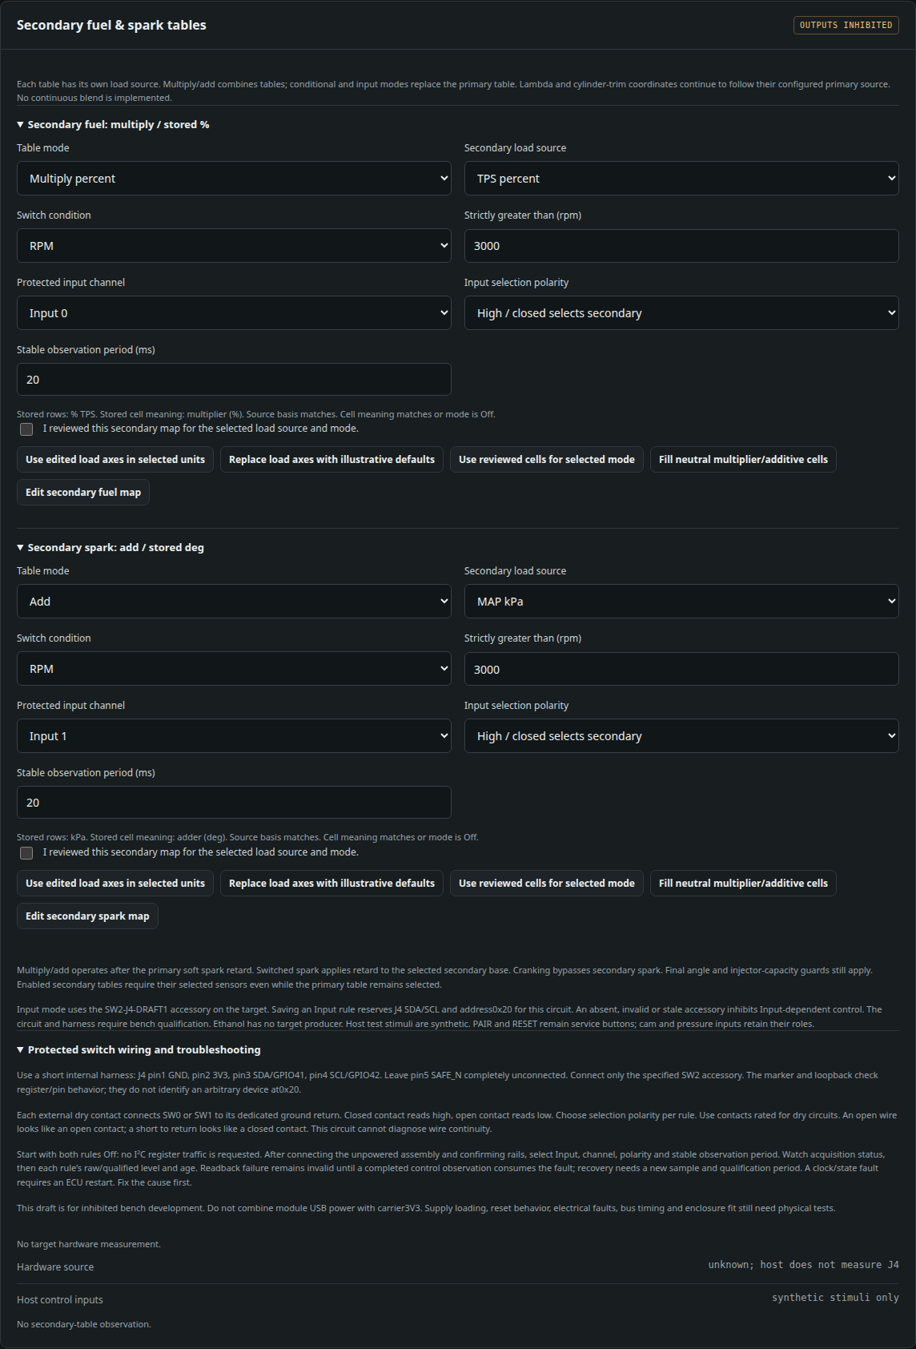
reports/engine/flex-integration/browser/secondary/secondary-desktop.png
