markthebault/esp32-ecu/reports/engine/flex-integration/browser/secondary/secondary-mobile.png

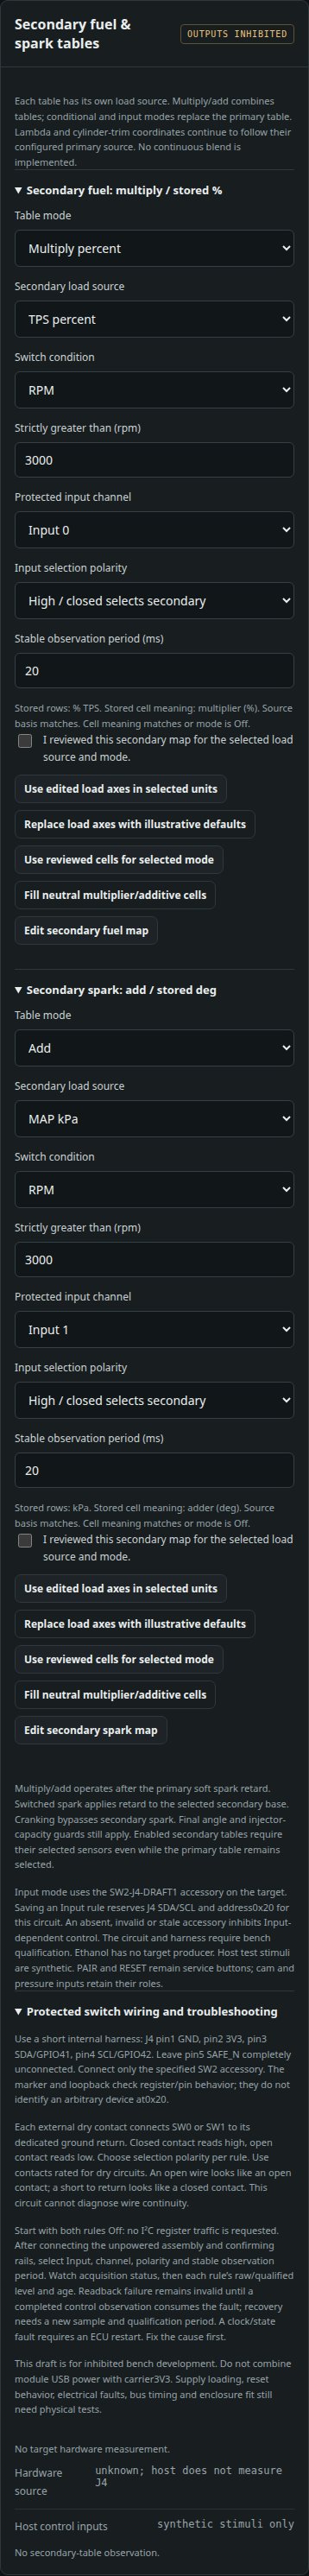
reports/engine/flex-integration/browser/secondary/secondary-mobile.png
