markthebault/esp32-ecu/reports/engine/flex-radio/browser/flex/flex-desktop.png

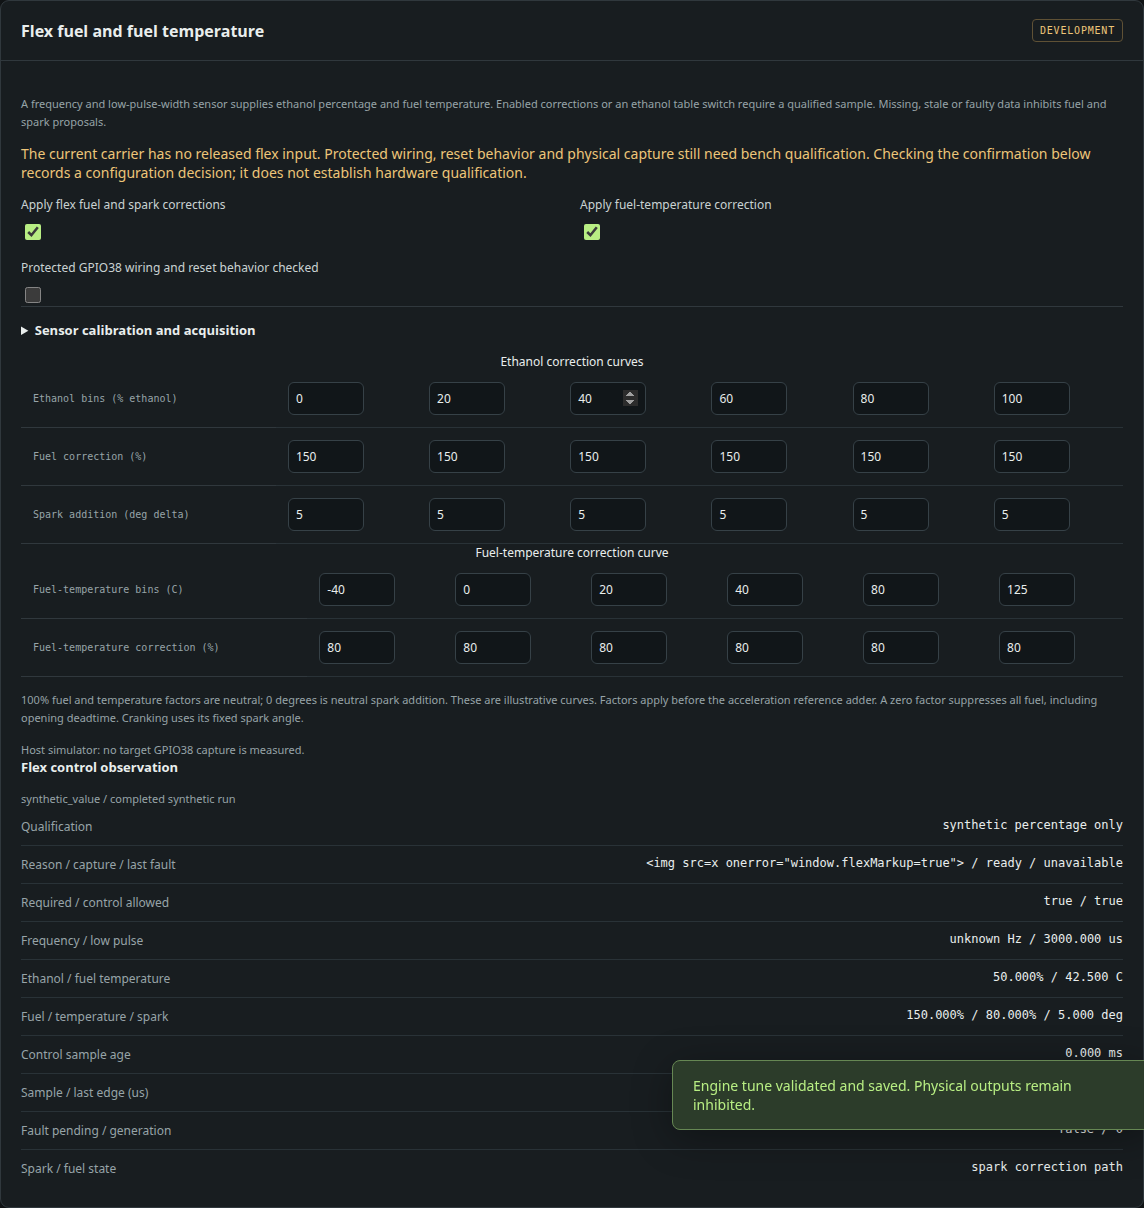
reports/engine/flex-radio/browser/flex/flex-desktop.png
