markthebault/esp32-ecu/reports/engine/flex-radio/browser/flex/flex-mobile.png

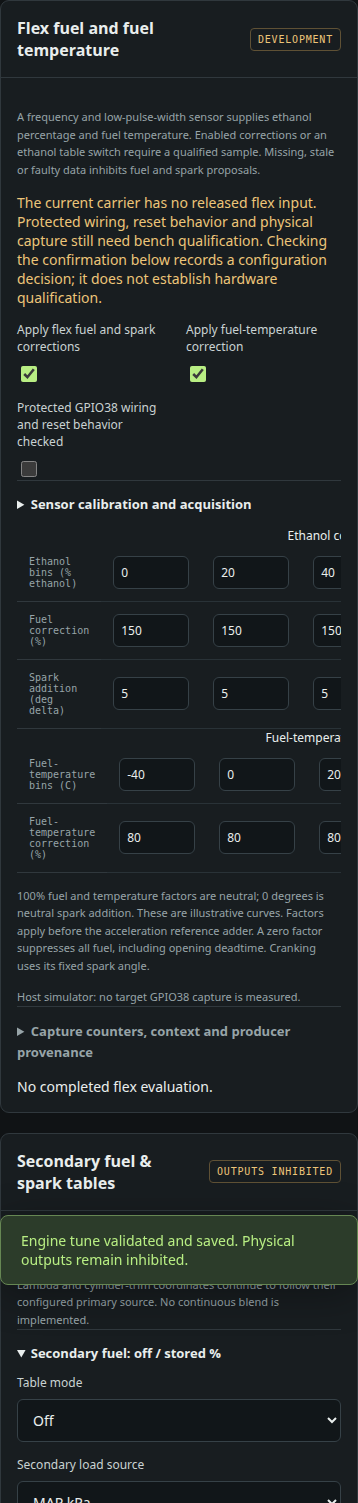
reports/engine/flex-radio/browser/flex/flex-mobile.png
