markthebault/esp32-ecu/reports/engine/flex-radio/browser/led/led-desktop.png

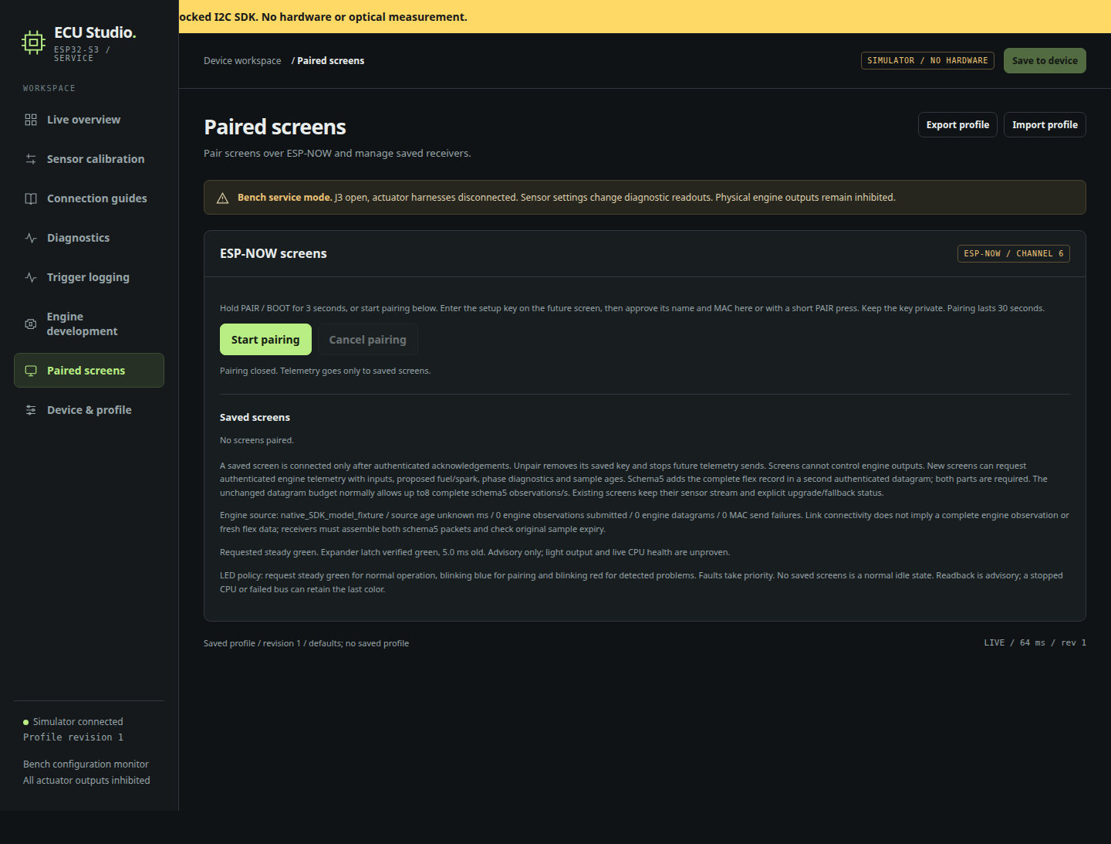
reports/engine/flex-radio/browser/led/led-desktop.png
