markthebault/esp32-ecu/reports/engine/flex-radio/browser/led/led-mobile.png

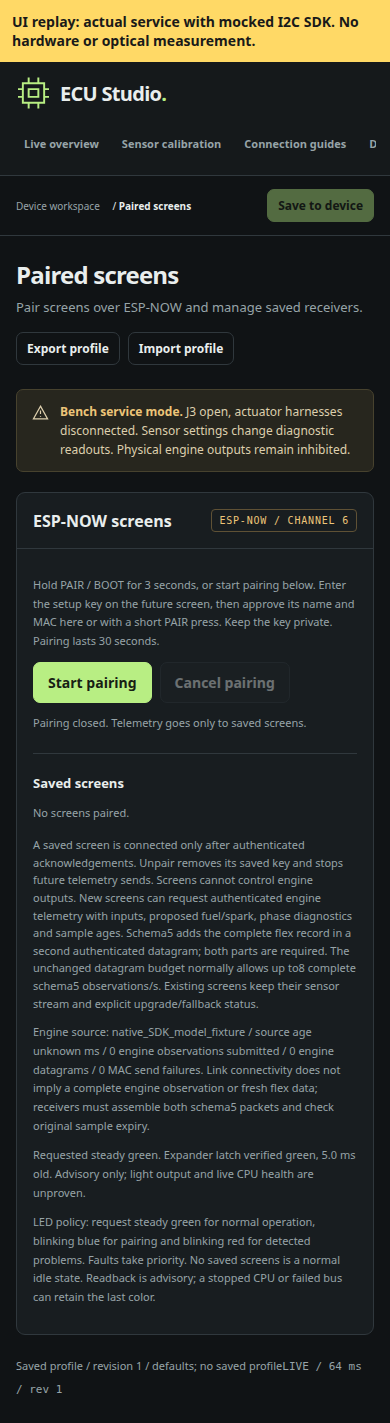
reports/engine/flex-radio/browser/led/led-mobile.png
