markthebault/esp32-ecu/reports/engine/flex-radio/browser/radio/radio-desktop.png

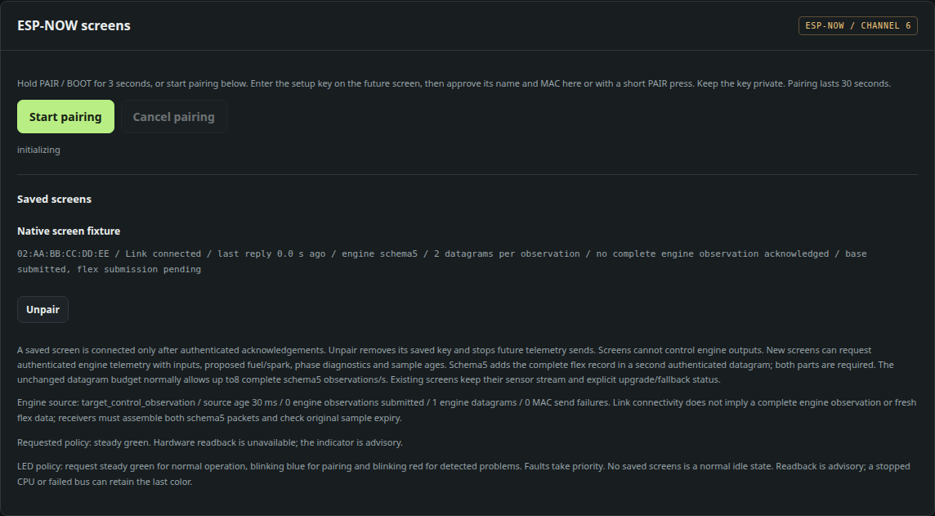
reports/engine/flex-radio/browser/radio/radio-desktop.png
