markthebault/esp32-ecu/reports/engine/flex-radio/browser/radio/radio-mobile.png

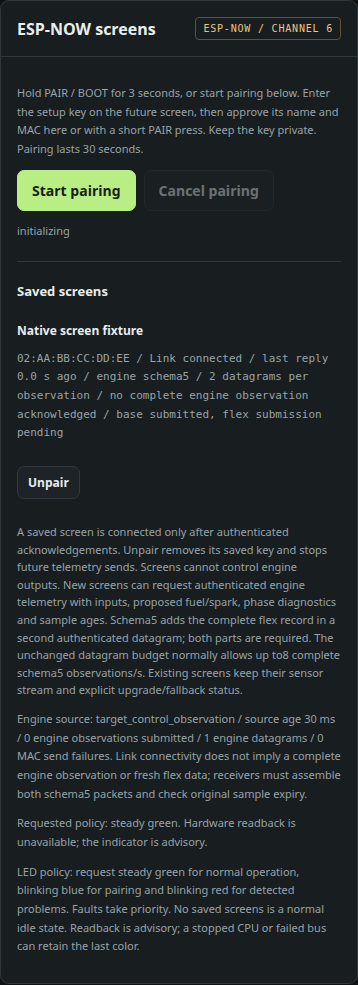
reports/engine/flex-radio/browser/radio/radio-mobile.png
