markthebault/esp32-ecu/reports/engine/flex-radio/browser/semi/semi-desktop.png

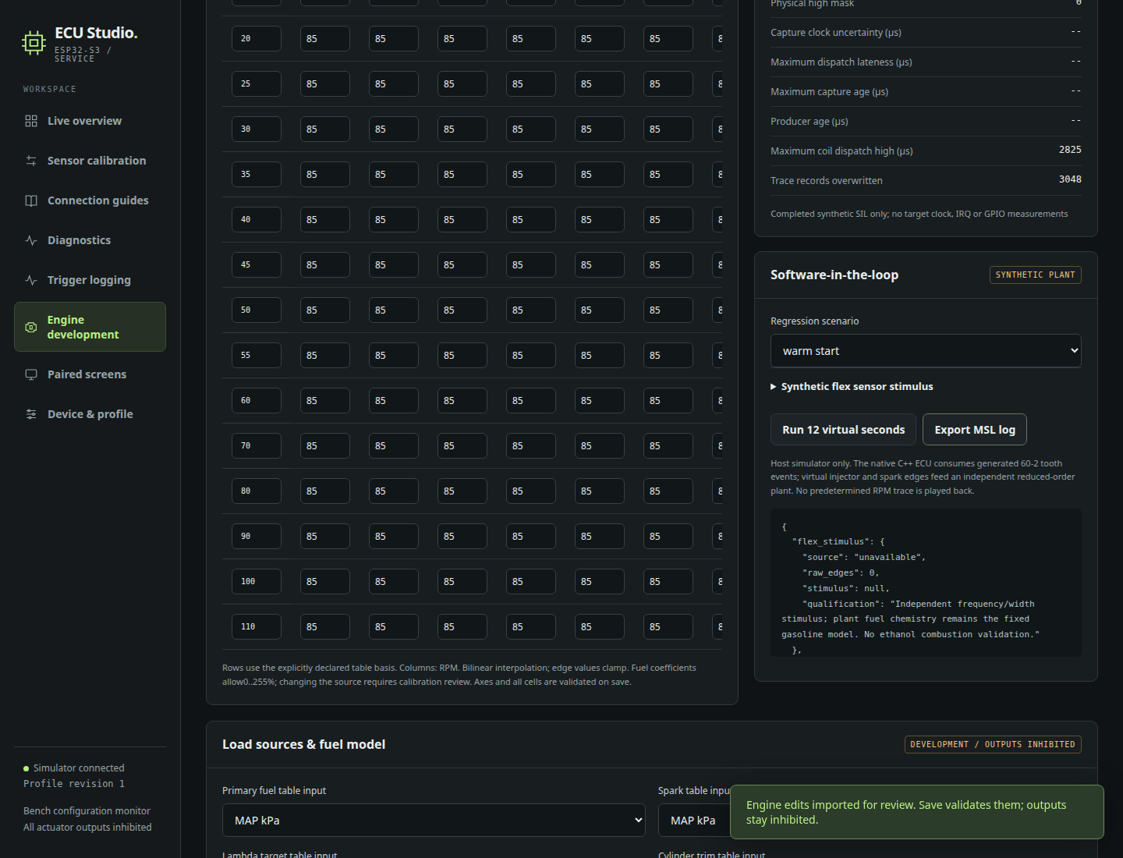
reports/engine/flex-radio/browser/semi/semi-desktop.png
