markthebault/esp32-ecu/reports/engine/flex-target-capture/browser/capture/capture-mobile.png

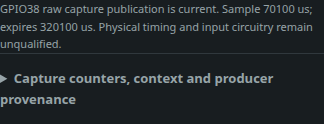
reports/engine/flex-target-capture/browser/capture/capture-mobile.png
