markthebault/esp32-ecu/reports/engine/flex-target-capture/browser/flex/flex-mobile.png

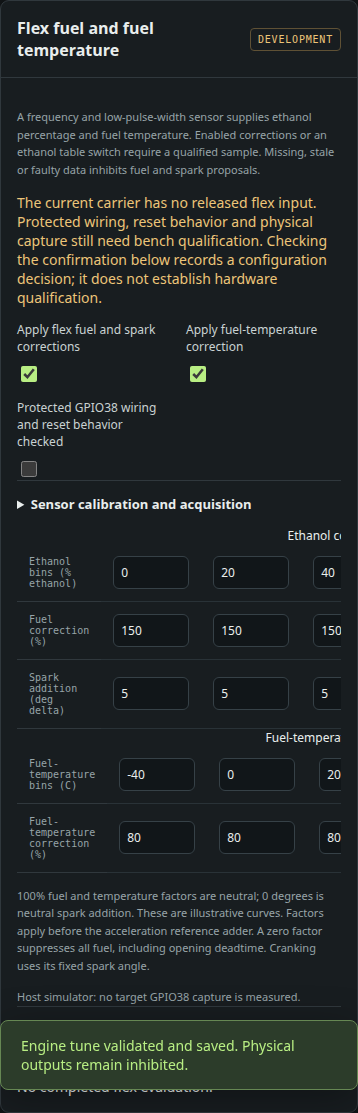
reports/engine/flex-target-capture/browser/flex/flex-mobile.png
