markthebault/esp32-ecu/reports/engine/idle-control/applications/megalogviewer-recorder-91-fields.png

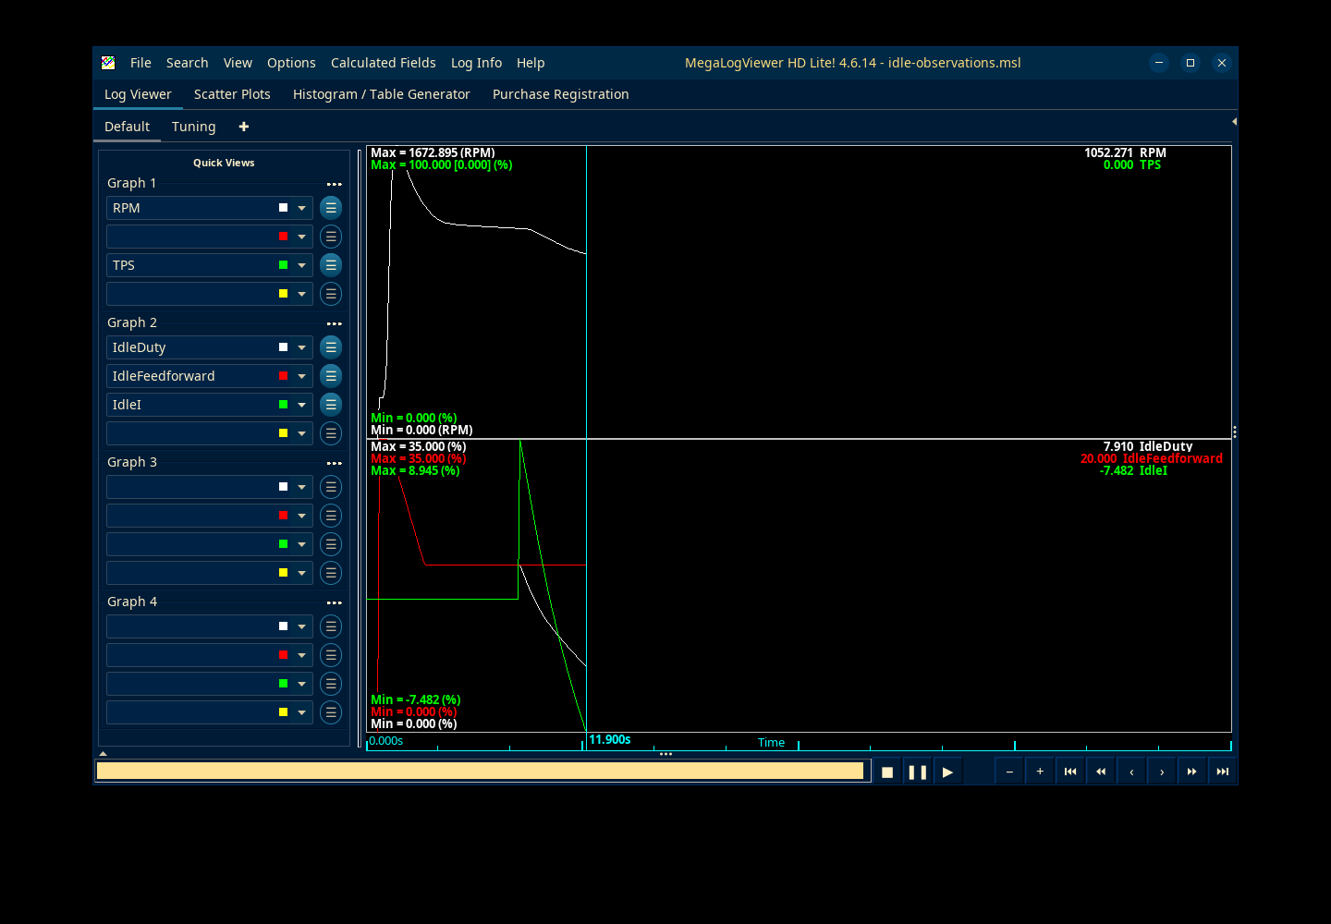
reports/engine/idle-control/applications/megalogviewer-recorder-91-fields.png
