markthebault/esp32-ecu/reports/engine/idle-control/applications/megalogviewer-sil-48-fields.png

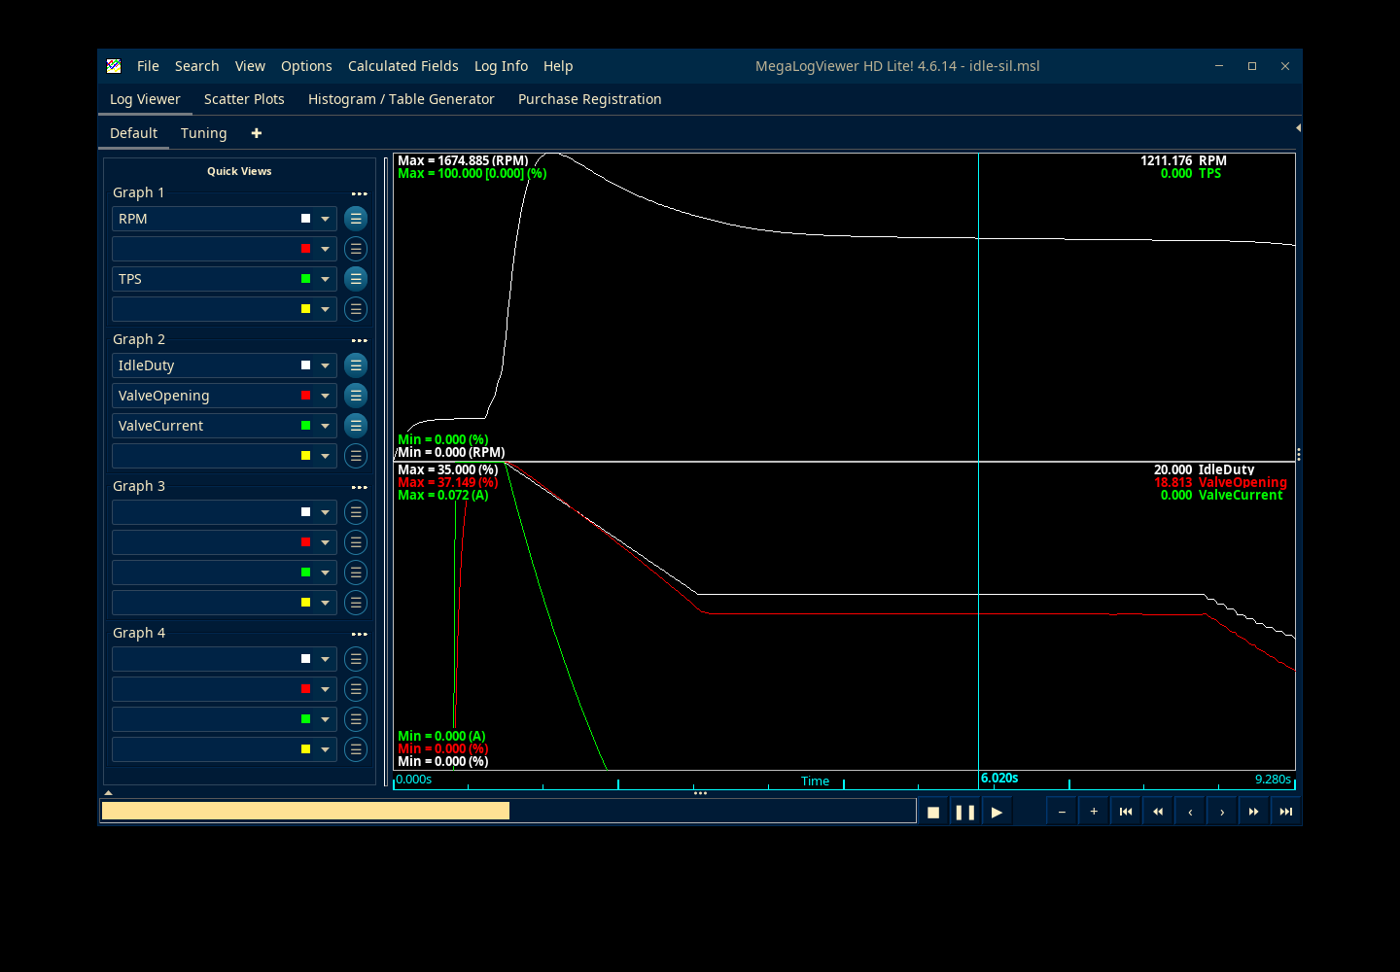
reports/engine/idle-control/applications/megalogviewer-sil-48-fields.png
