markthebault/esp32-ecu/reports/engine/idle-control/applications/tunerstudio-idle-settings.png

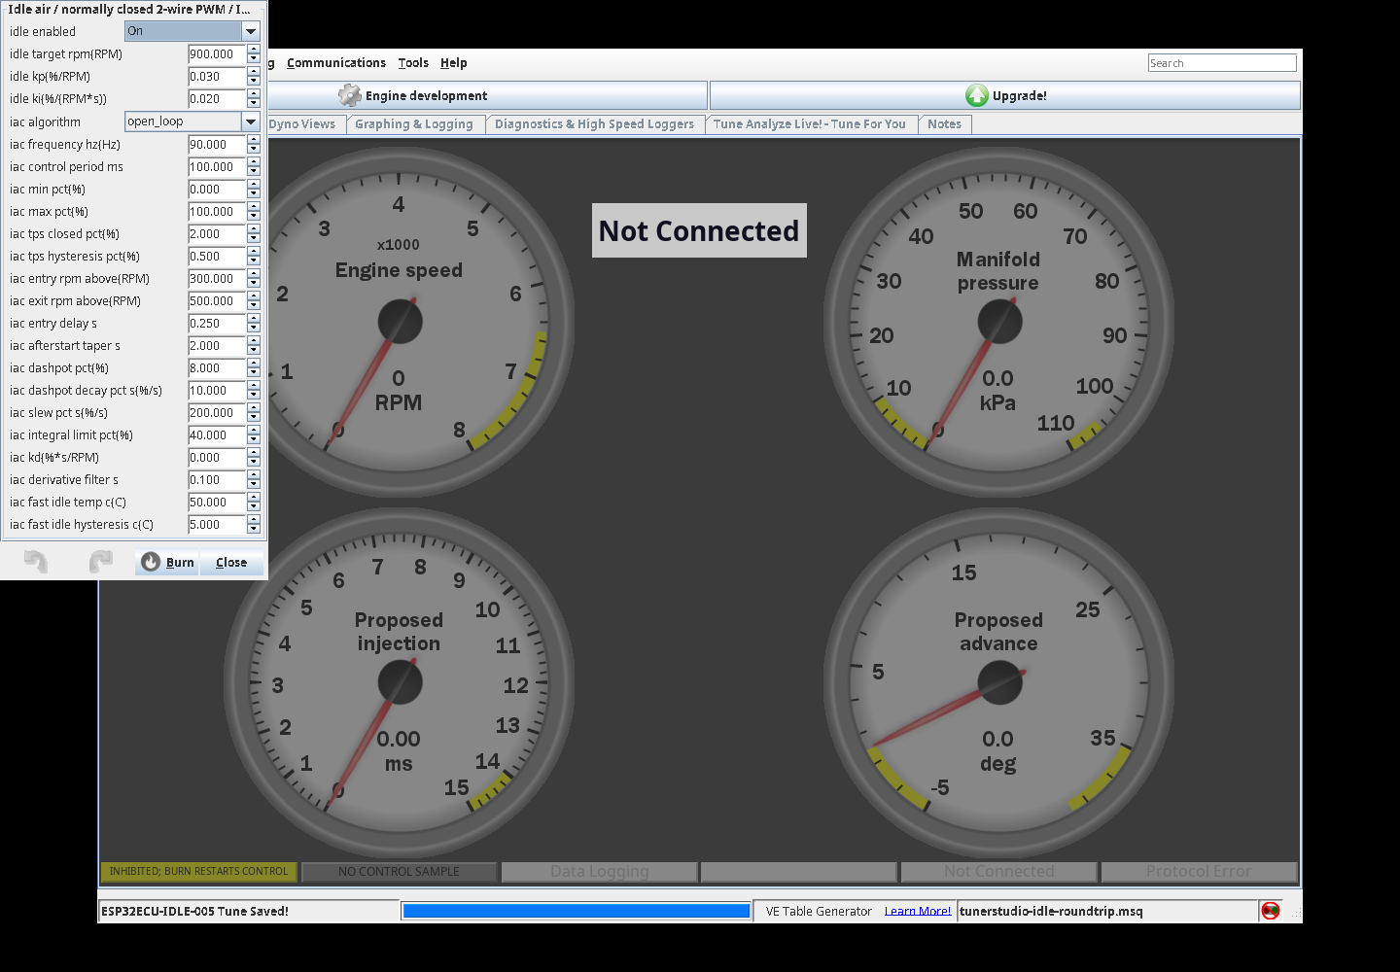
reports/engine/idle-control/applications/tunerstudio-idle-settings.png
