markthebault/esp32-ecu/reports/engine/idle-control/applications/tunerstudio-spark-map.png

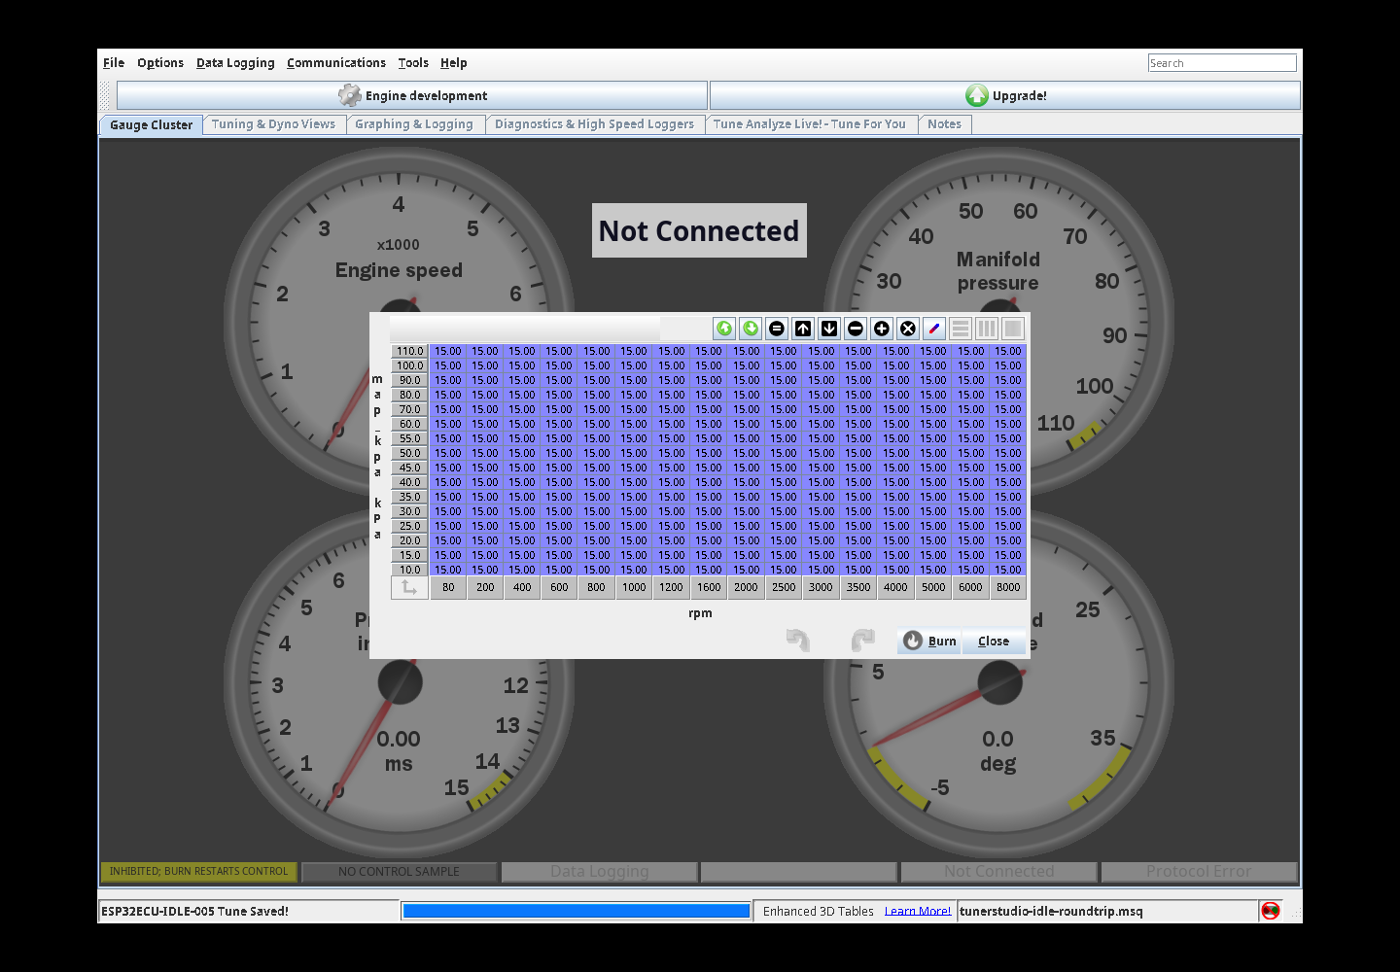
reports/engine/idle-control/applications/tunerstudio-spark-map.png
