markthebault/esp32-ecu/reports/engine/idle-control/idle-actuator-faults.png

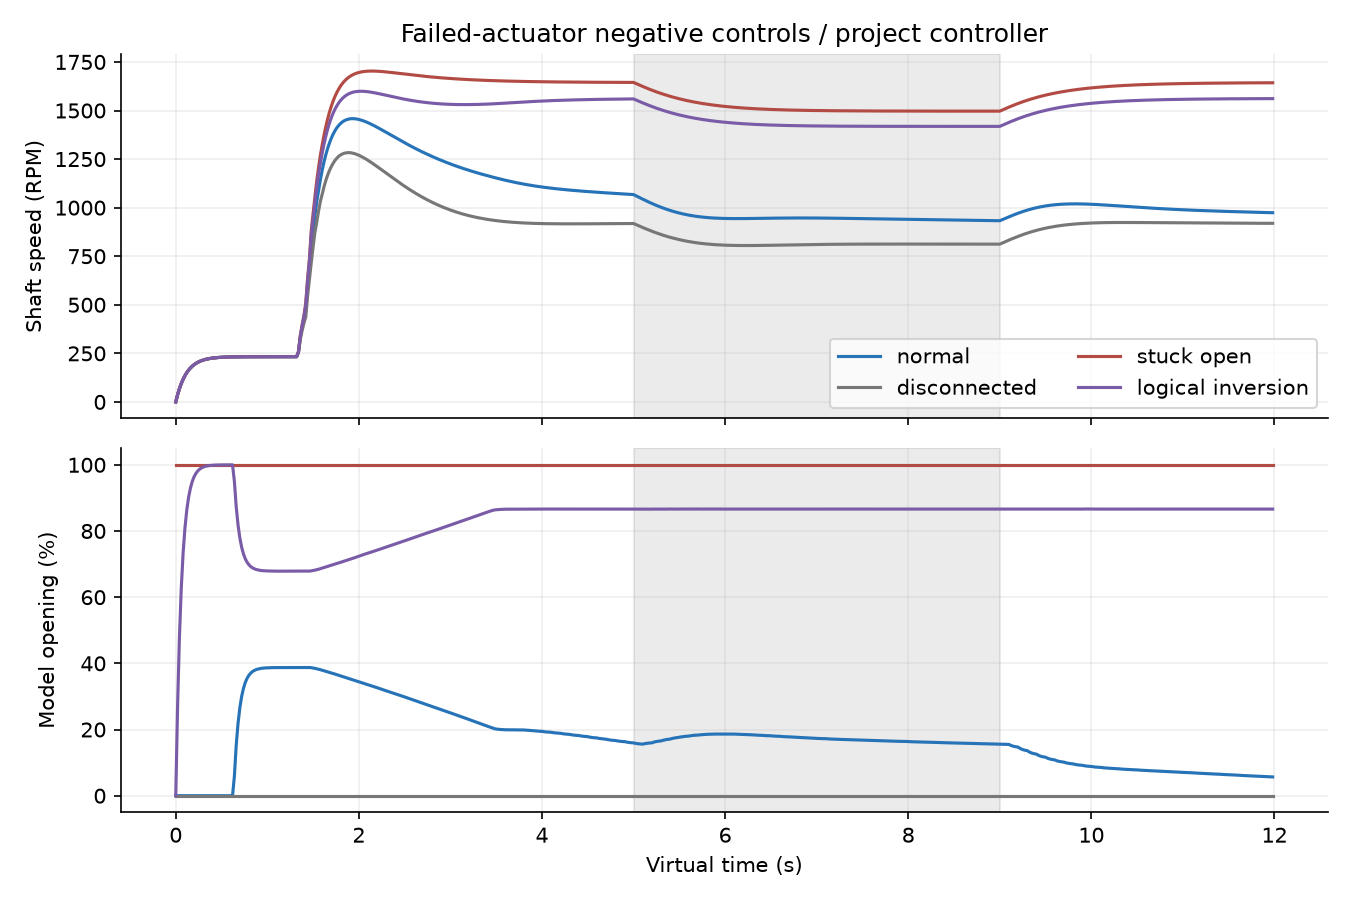
reports/engine/idle-control/idle-actuator-faults.png
