markthebault/esp32-ecu/reports/engine/idle-control/idle-reachable-target.png

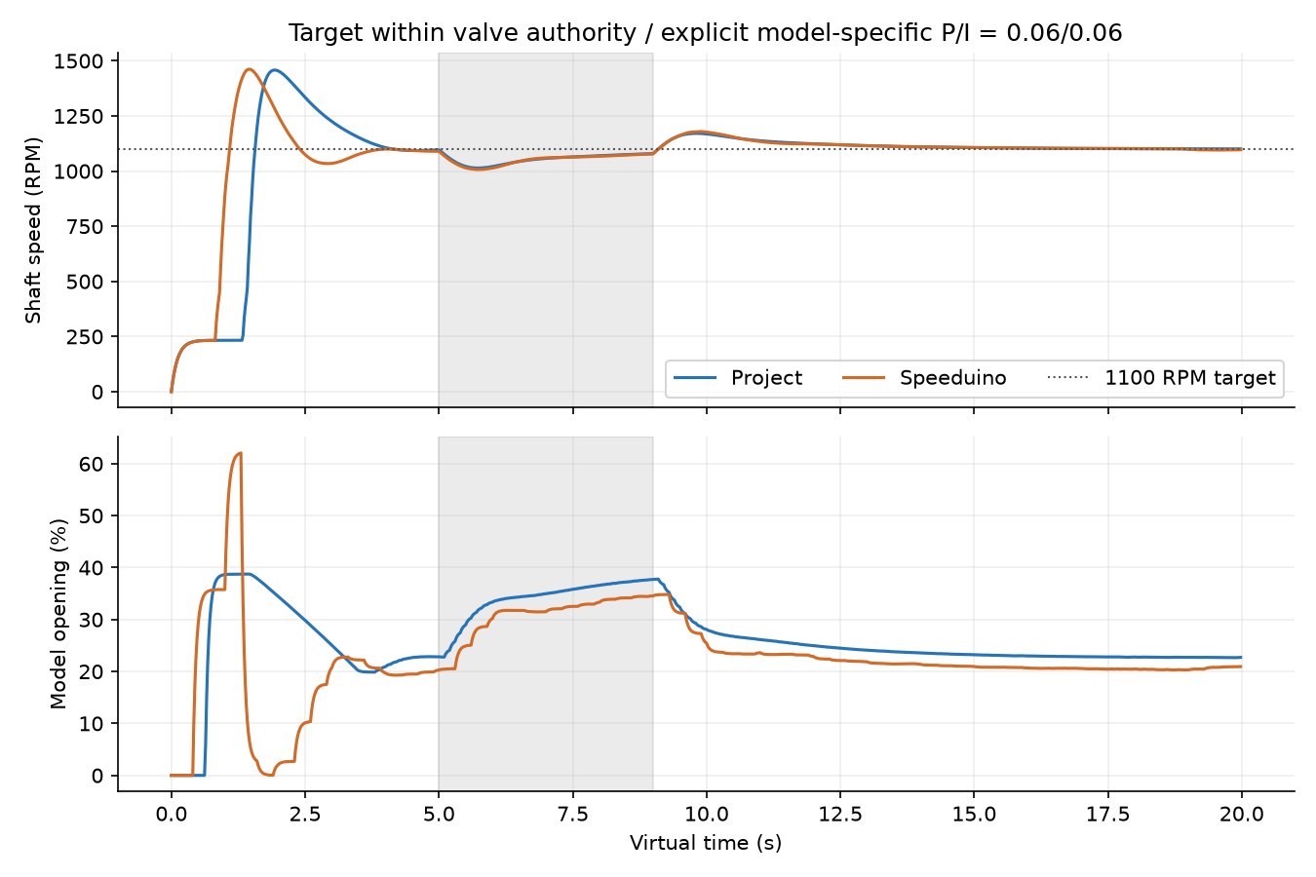
reports/engine/idle-control/idle-reachable-target.png
