markthebault/esp32-ecu/reports/engine/idle-control/idle-reference-disable.png

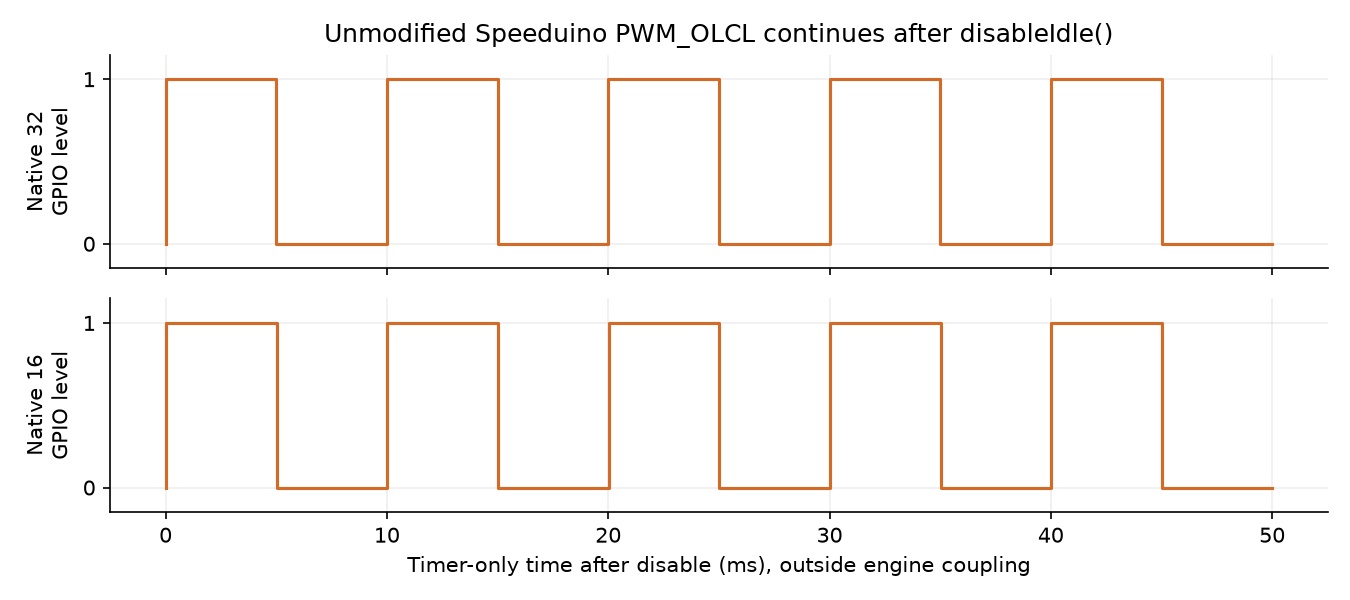
reports/engine/idle-control/idle-reference-disable.png
