markthebault/esp32-ecu/reports/engine/idle-isolation/circuit/pulse-sensitivity.png

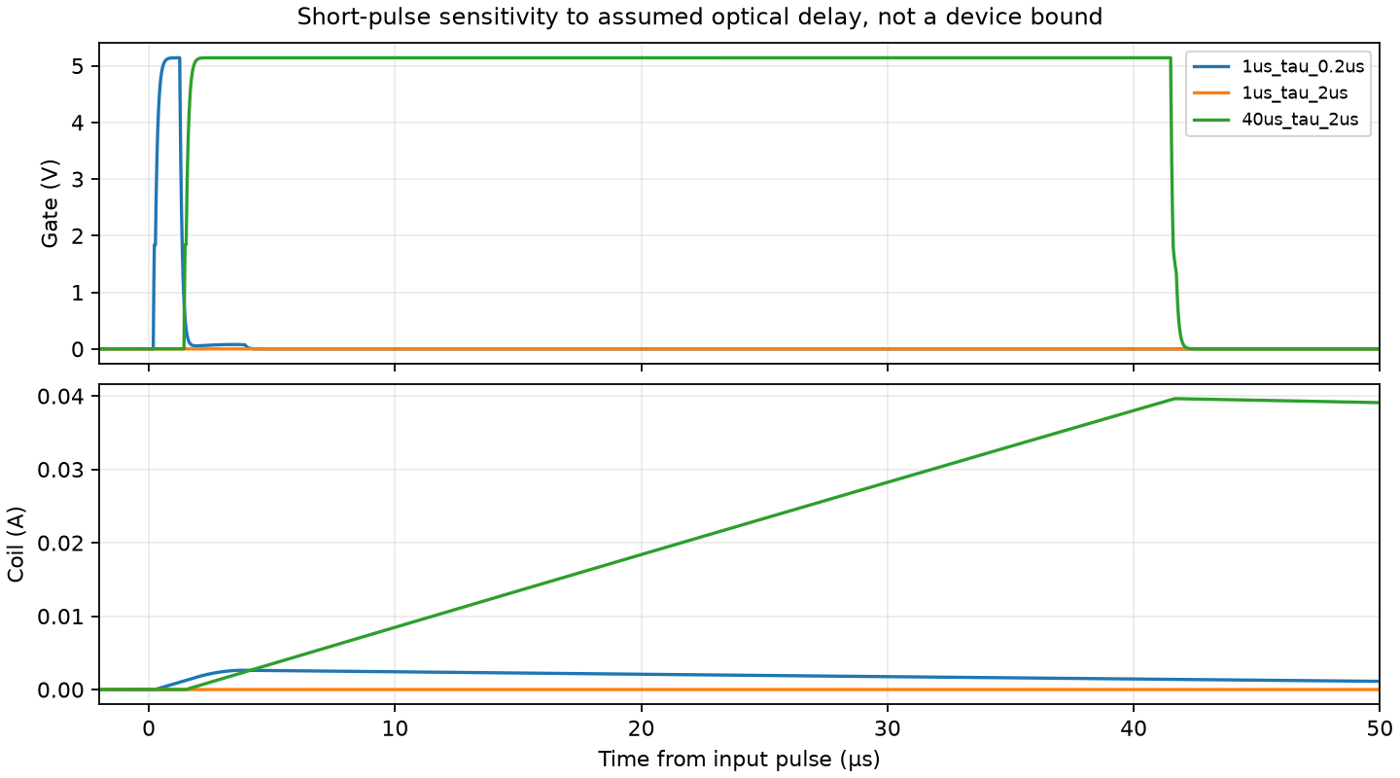
reports/engine/idle-isolation/circuit/pulse-sensitivity.png
