markthebault/esp32-ecu/reports/engine/idle-isolation/reviews/layout/actual-board.png

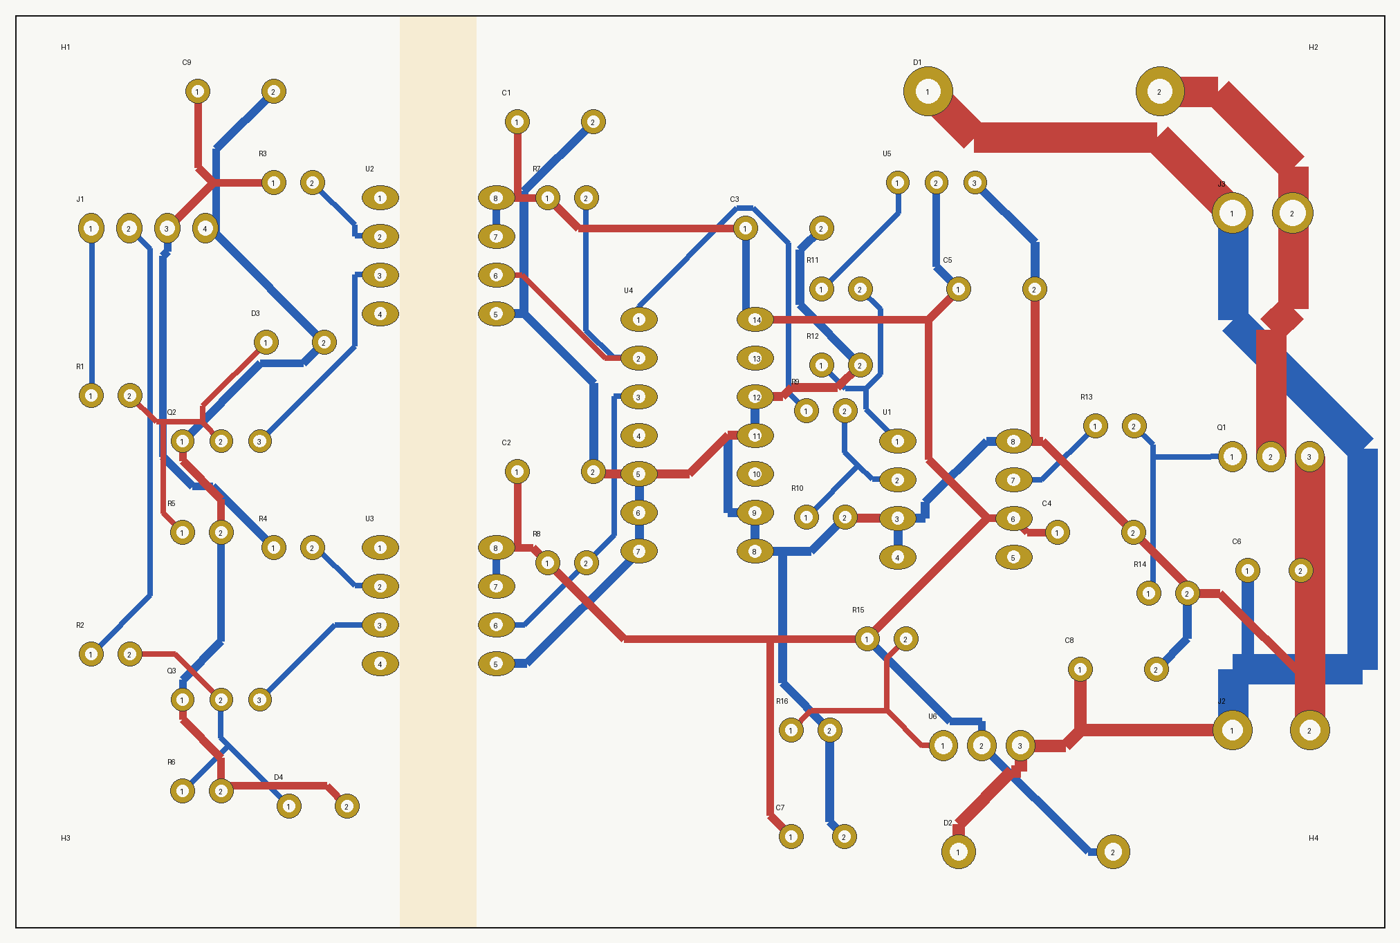
reports/engine/idle-isolation/reviews/layout/actual-board.png
