markthebault/esp32-ecu/reports/engine/idle-isolation/reviews/layout/actual-driver-loop.png

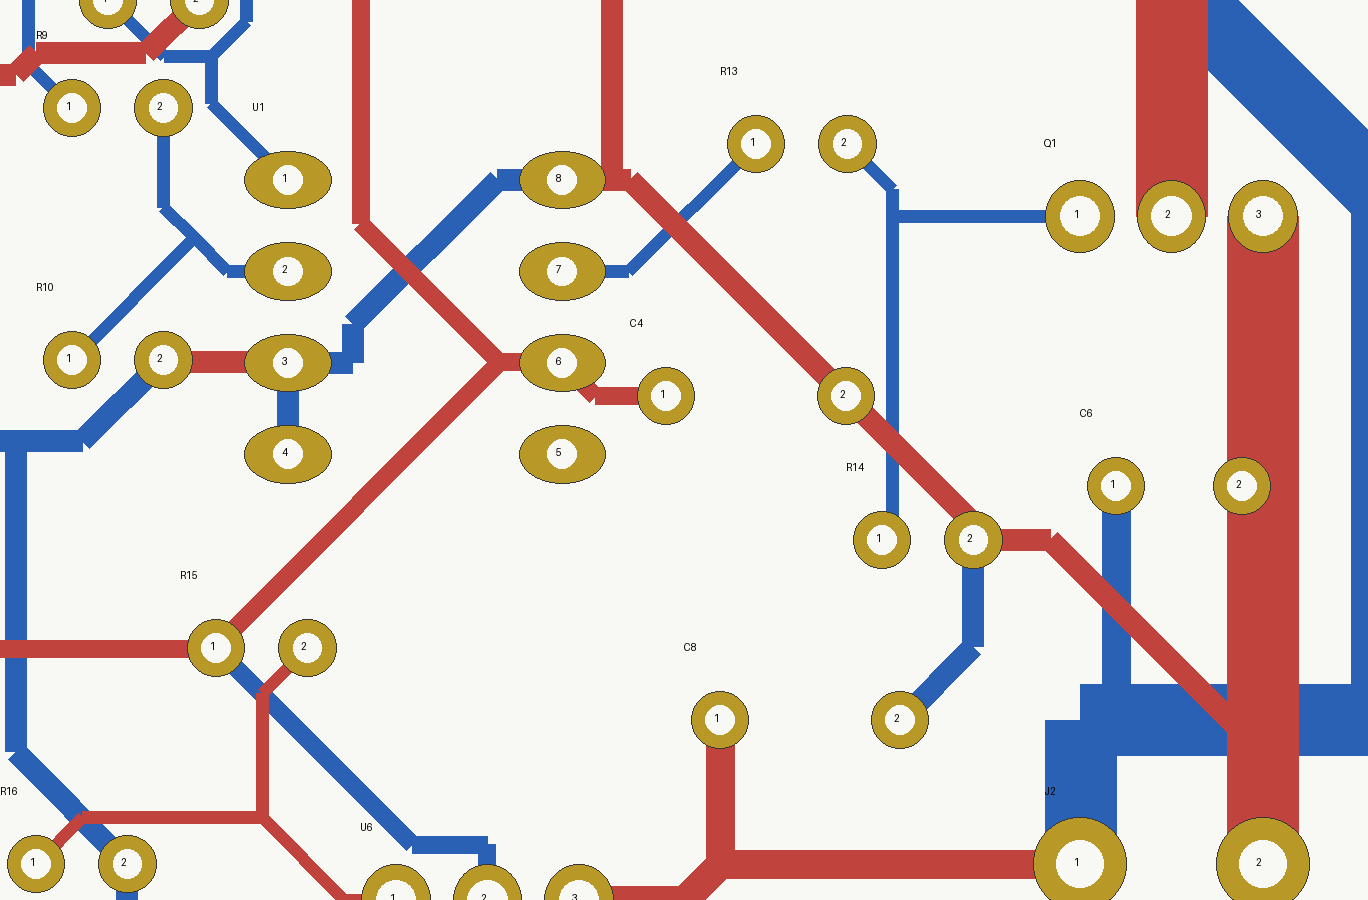
reports/engine/idle-isolation/reviews/layout/actual-driver-loop.png
