markthebault/esp32-ecu/reports/engine/idle-isolation/reviews/layout/final/actual-board.png

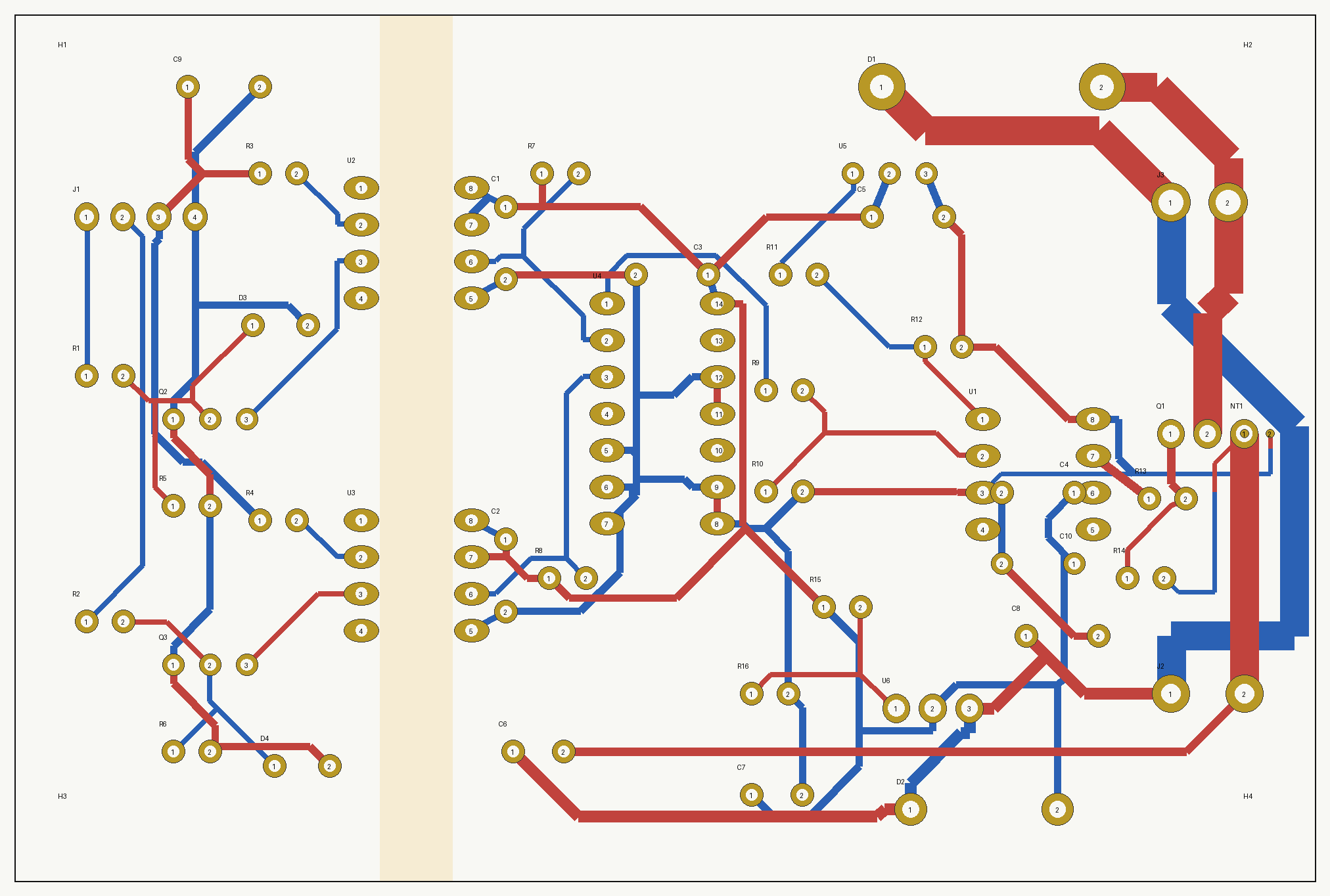
reports/engine/idle-isolation/reviews/layout/final/actual-board.png
