markthebault/esp32-ecu/reports/engine/idle-isolation/reviews/layout/final/actual-driver-loop.png

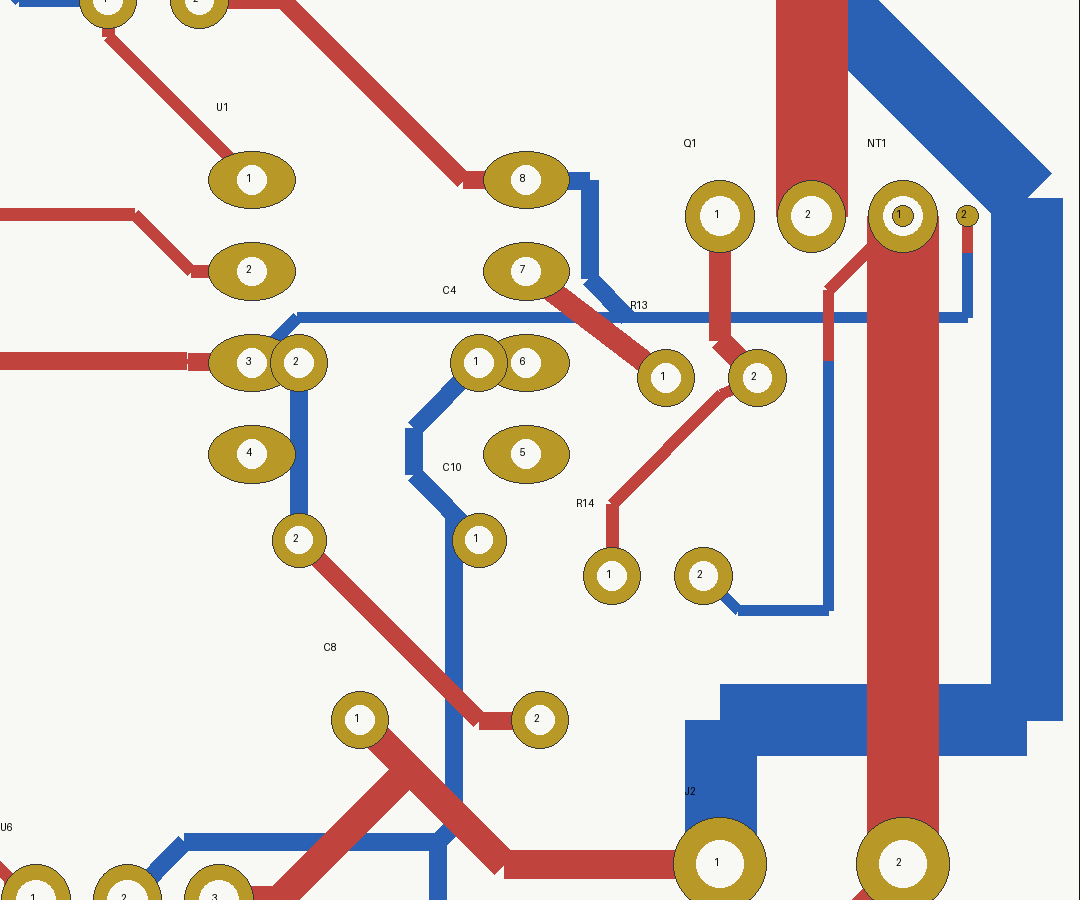
reports/engine/idle-isolation/reviews/layout/final/actual-driver-loop.png
