markthebault/esp32-ecu/reports/engine/load-model/applications/ts/load-edited.png

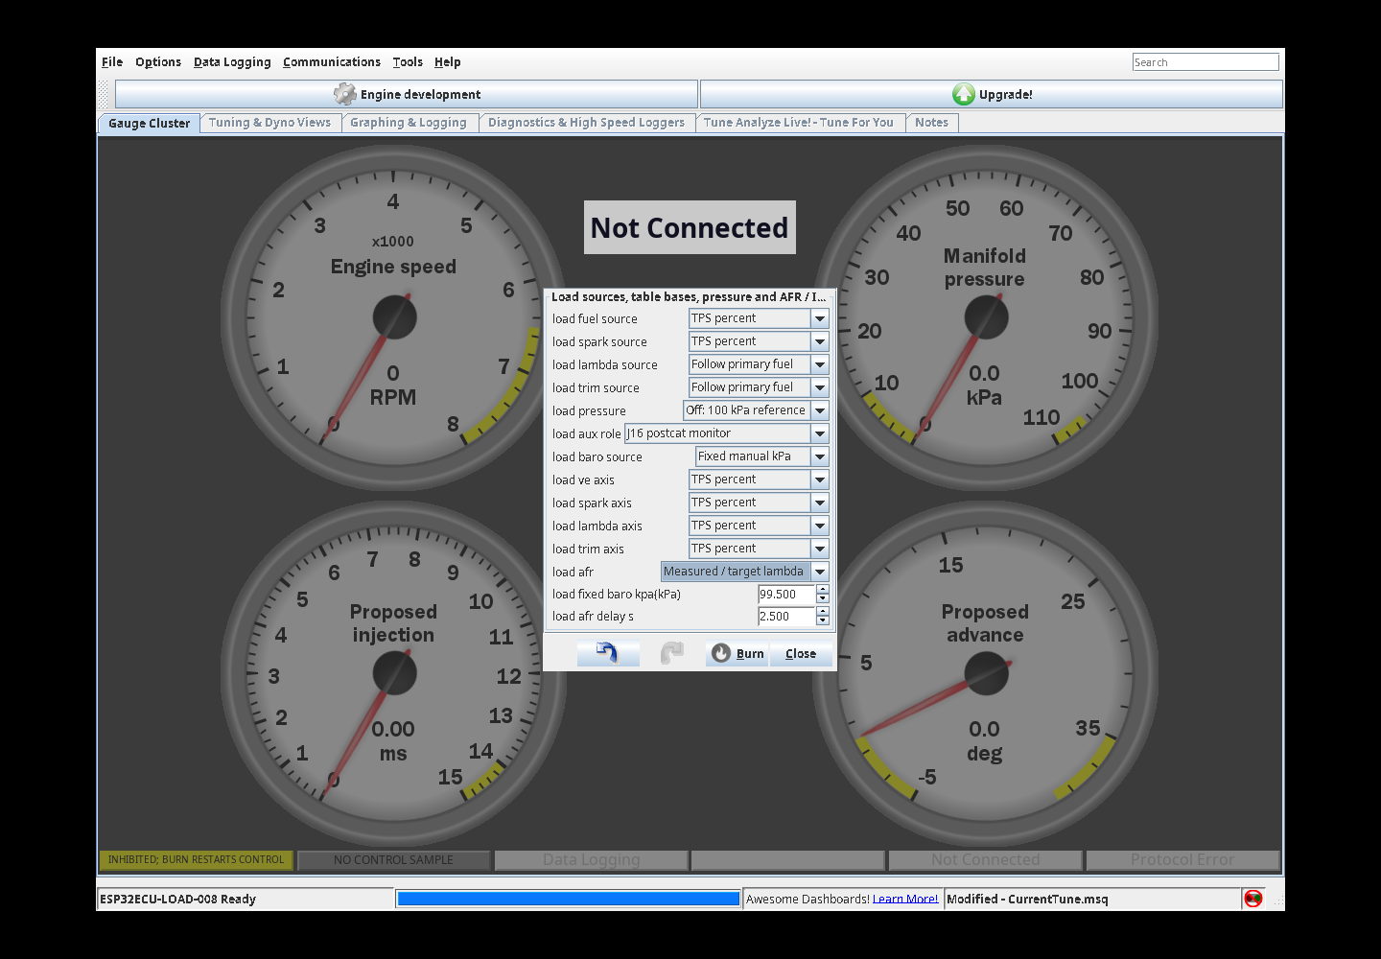
reports/engine/load-model/applications/ts/load-edited.png
