markthebault/esp32-ecu/reports/engine/load-model/browser/ui-bound/load-desktop.png

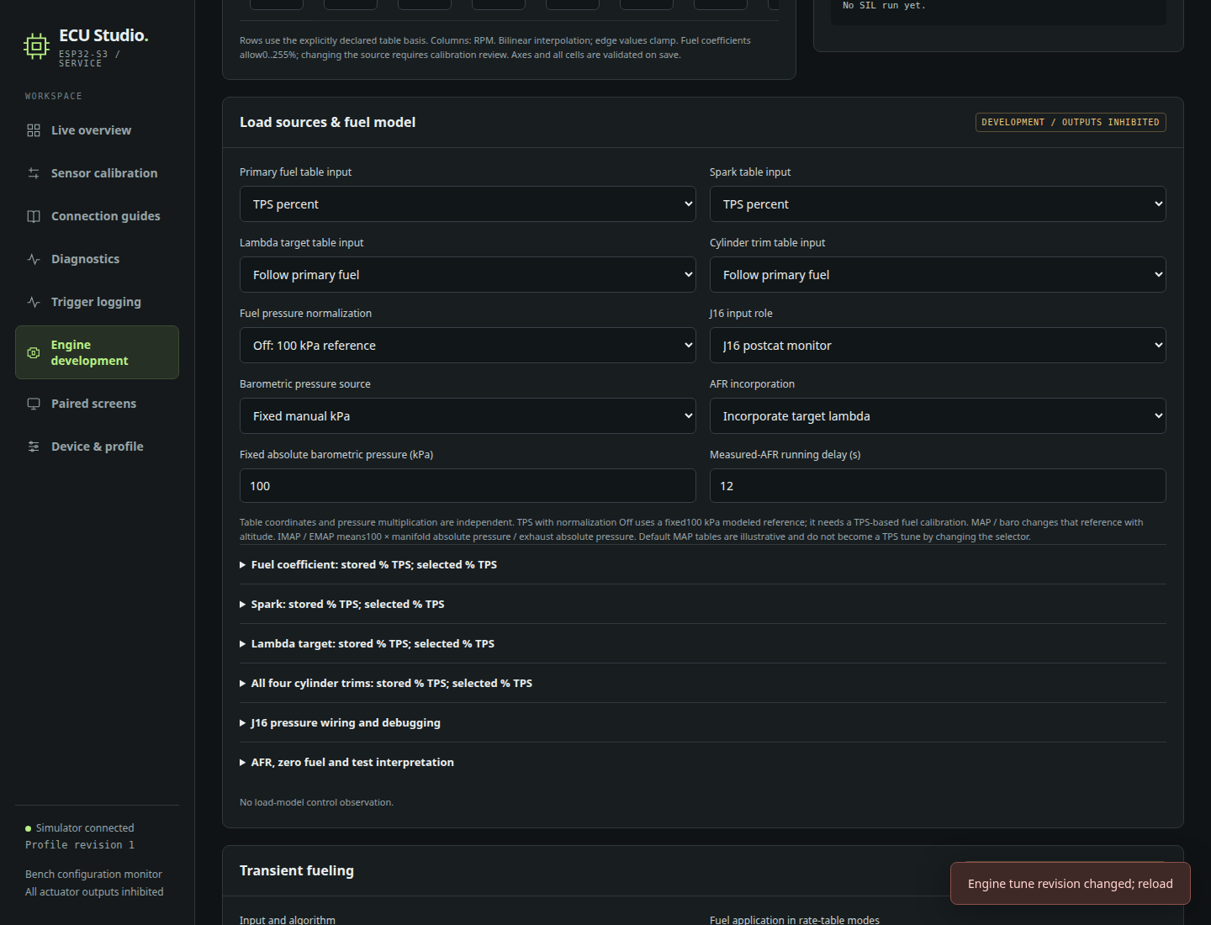
reports/engine/load-model/browser/ui-bound/load-desktop.png
