markthebault/esp32-ecu/reports/engine/load-model/browser/ui-bound/load-mobile.png

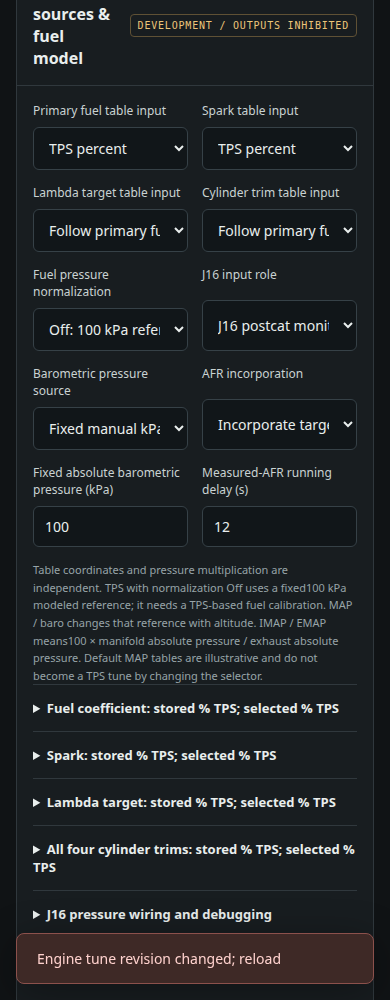
reports/engine/load-model/browser/ui-bound/load-mobile.png
