markthebault/esp32-ecu/reports/engine/load-model/browser/ui-cylinder-final/cylinder-desktop.png

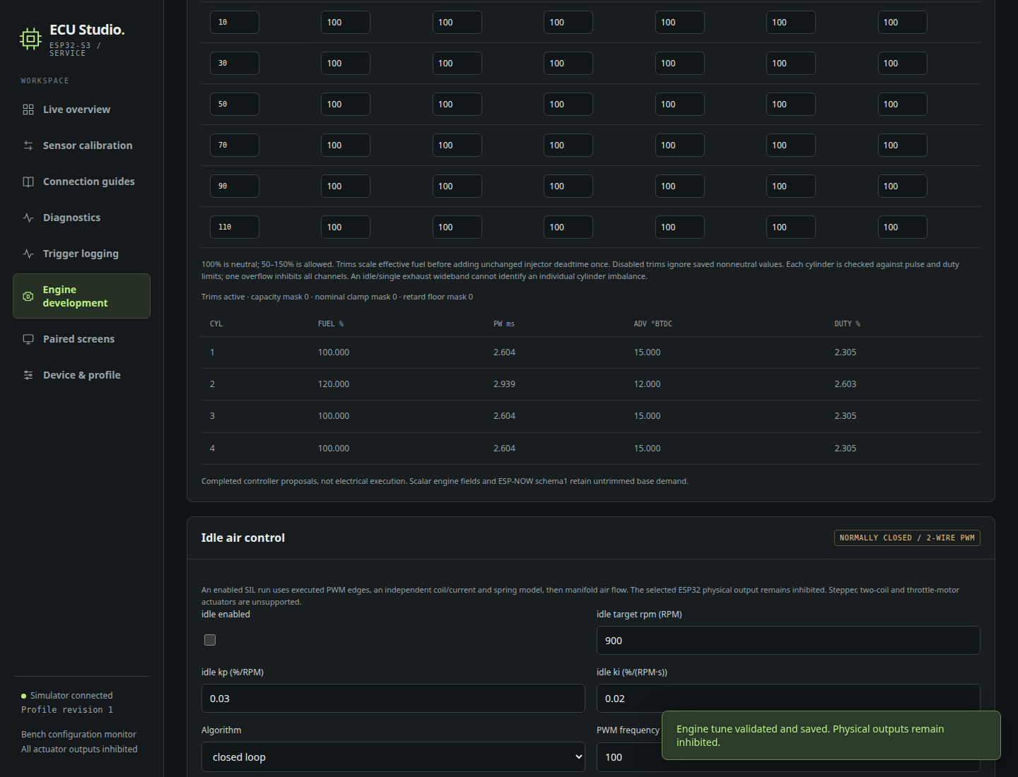
reports/engine/load-model/browser/ui-cylinder-final/cylinder-desktop.png
