markthebault/esp32-ecu/reports/engine/load-model/browser/ui-engine/engine-ui-desktop.png

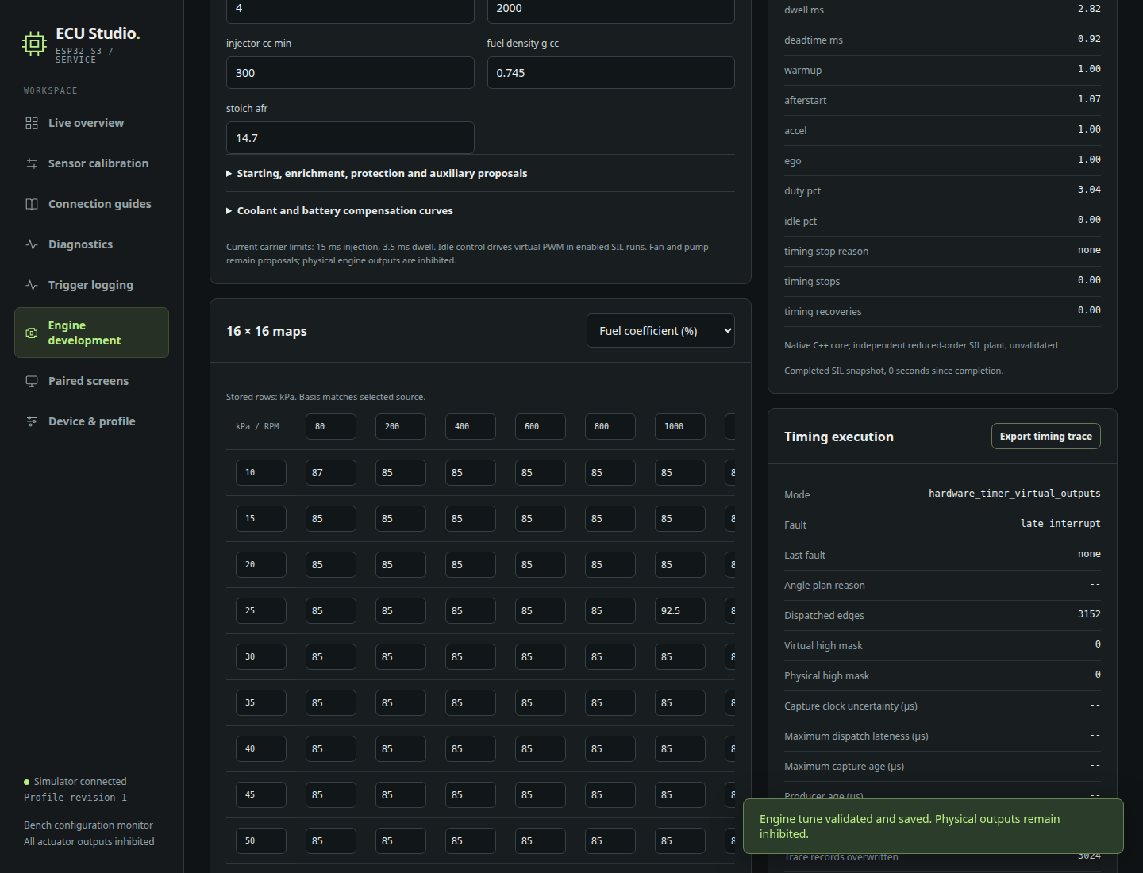
reports/engine/load-model/browser/ui-engine/engine-ui-desktop.png
