markthebault/esp32-ecu/reports/engine/load-model/browser/ui-idle/idle-desktop.png

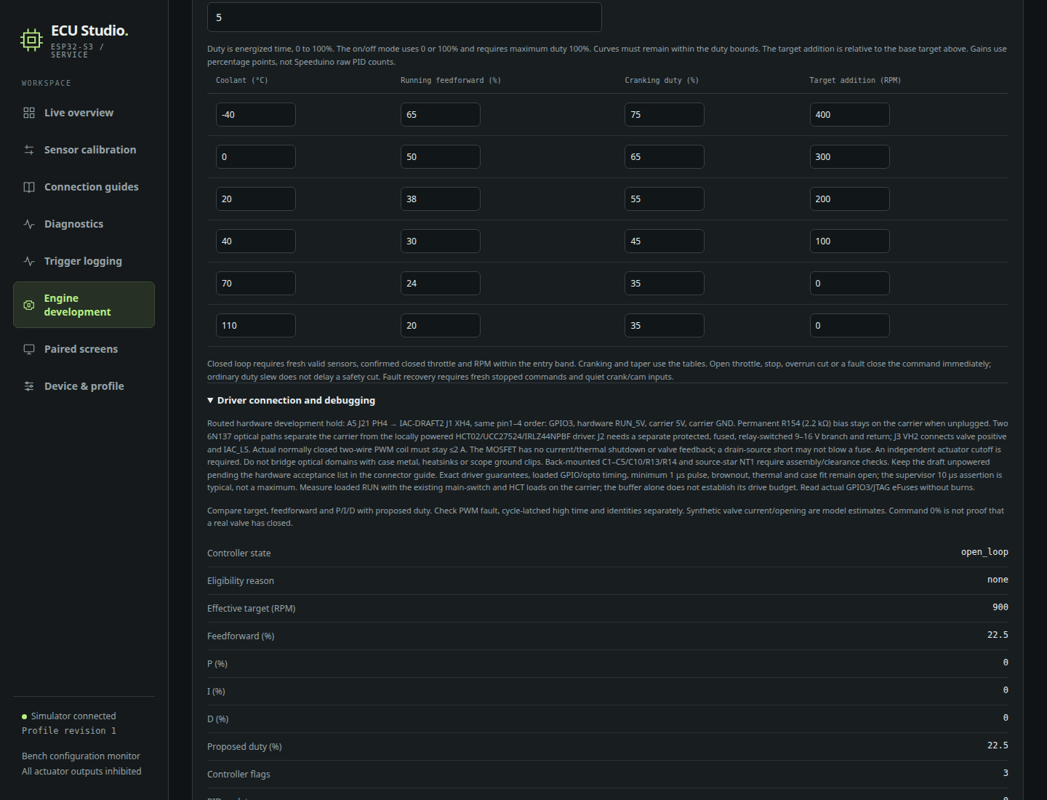
reports/engine/load-model/browser/ui-idle/idle-desktop.png
