markthebault/esp32-ecu/reports/engine/load-model/browser/ui-logger/engine-log-mobile.png

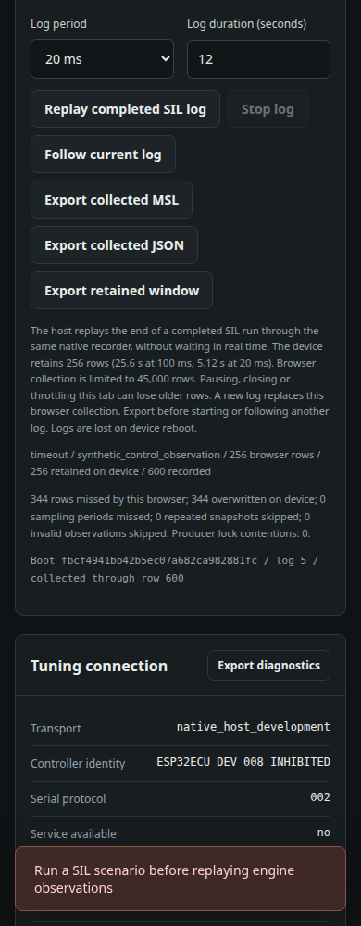
reports/engine/load-model/browser/ui-logger/engine-log-mobile.png
