markthebault/esp32-ecu/reports/engine/load-model/browser/ui-transient-final/transient-desktop.png

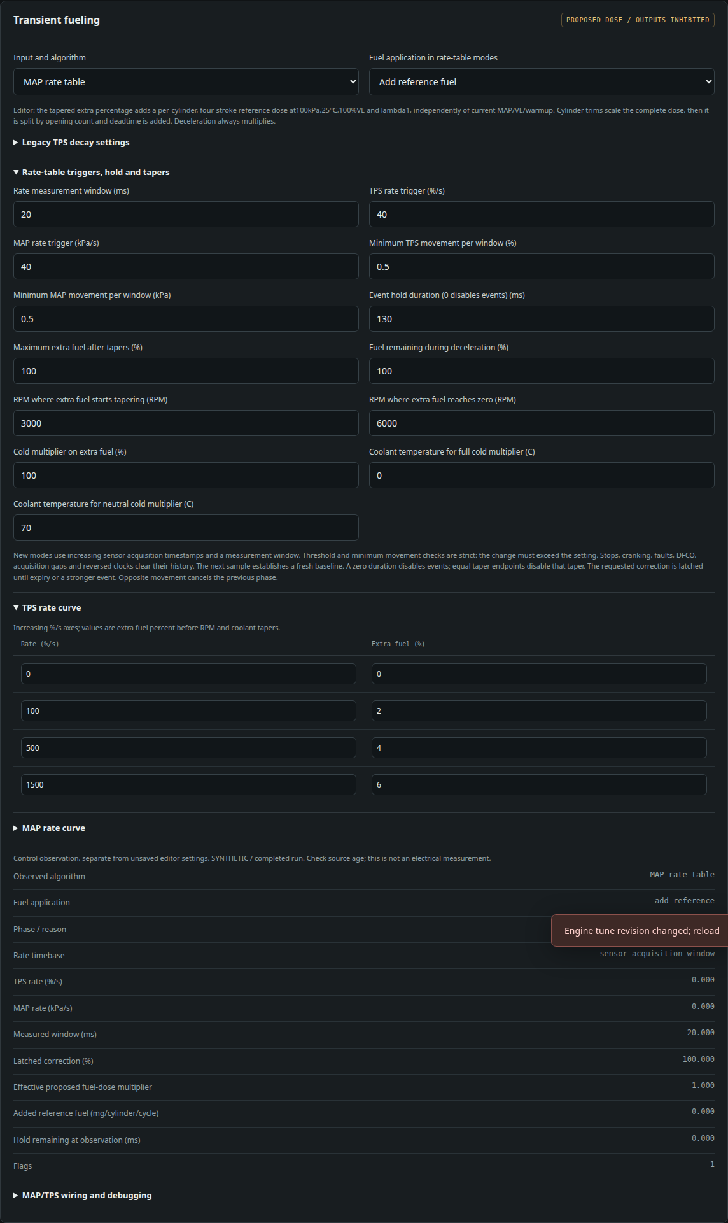
reports/engine/load-model/browser/ui-transient-final/transient-desktop.png
