markthebault/esp32-ecu/reports/engine/load-model/load-comparison.png

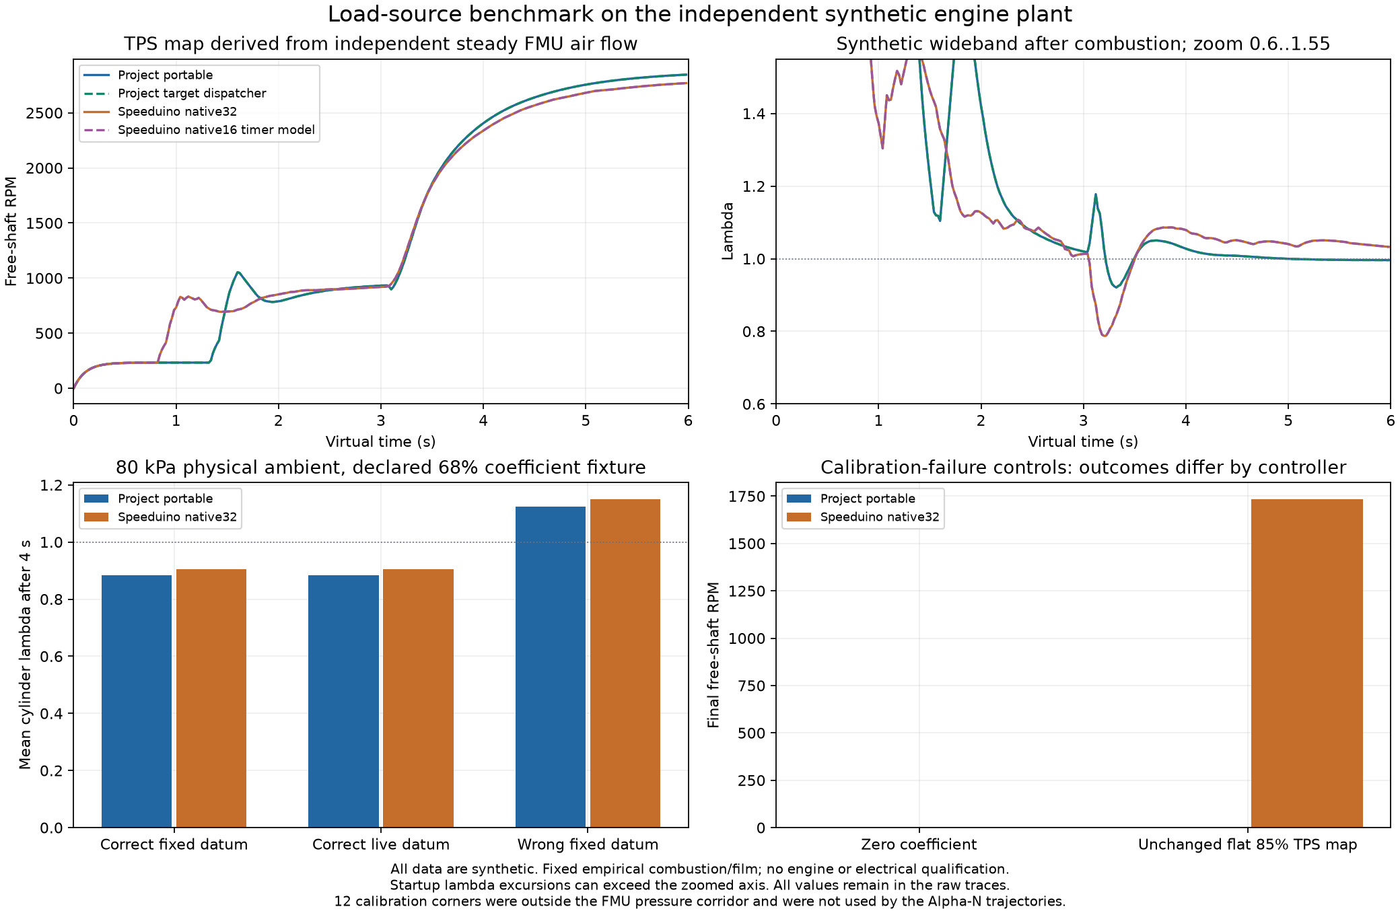
reports/engine/load-model/load-comparison.png
