markthebault/esp32-ecu/reports/engine/megalogviewer-sil-log.png

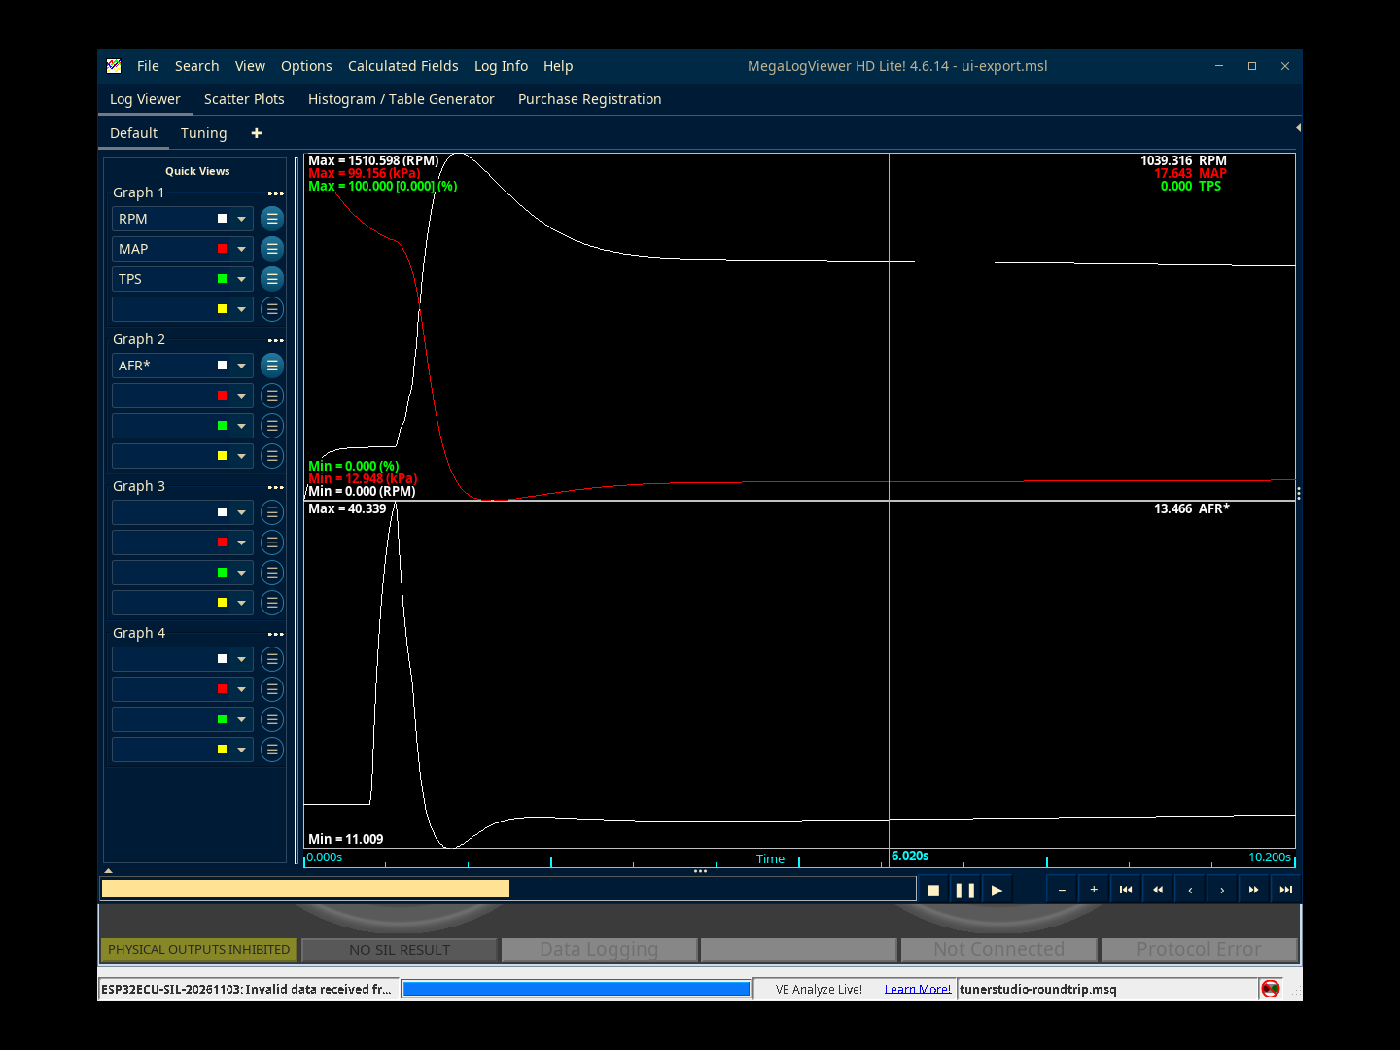
reports/engine/megalogviewer-sil-log.png
