markthebault/esp32-ecu/reports/engine/observability/engine-log-desktop.png

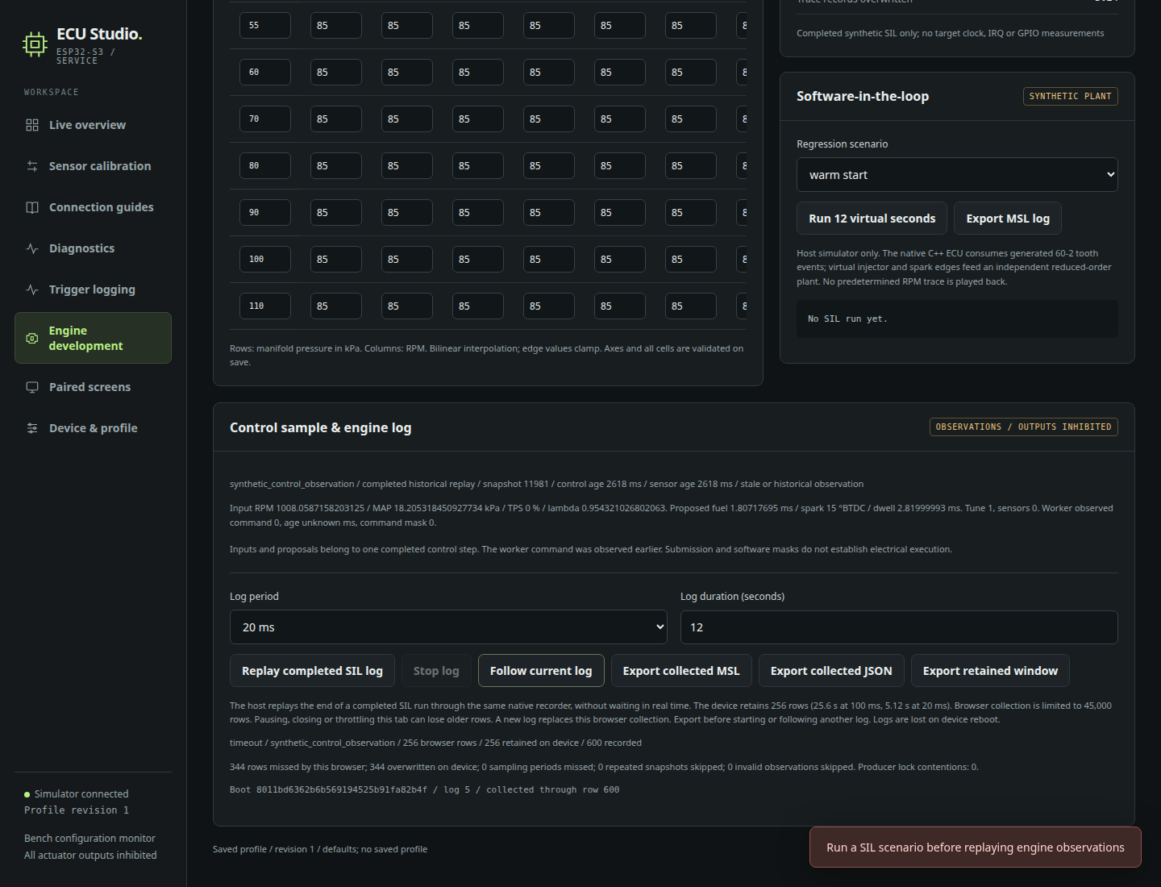
reports/engine/observability/engine-log-desktop.png
