markthebault/esp32-ecu/reports/engine/observability/engine-log-mobile.png

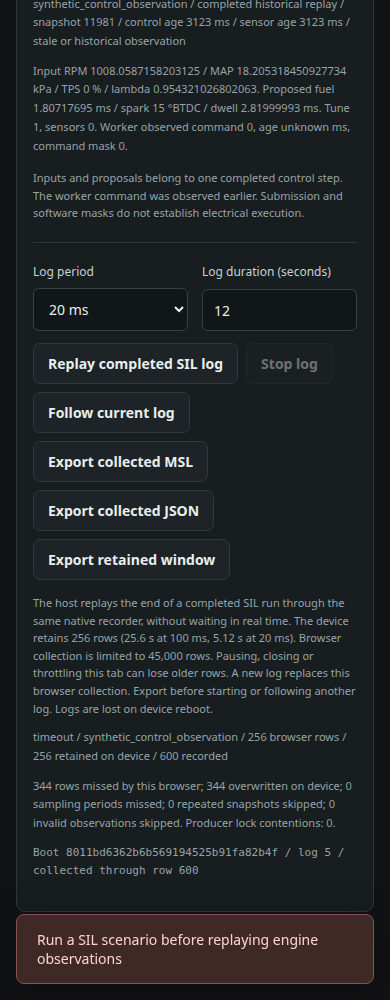
reports/engine/observability/engine-log-mobile.png
