markthebault/esp32-ecu/reports/engine/observability/megalogviewer-engine-fields.png

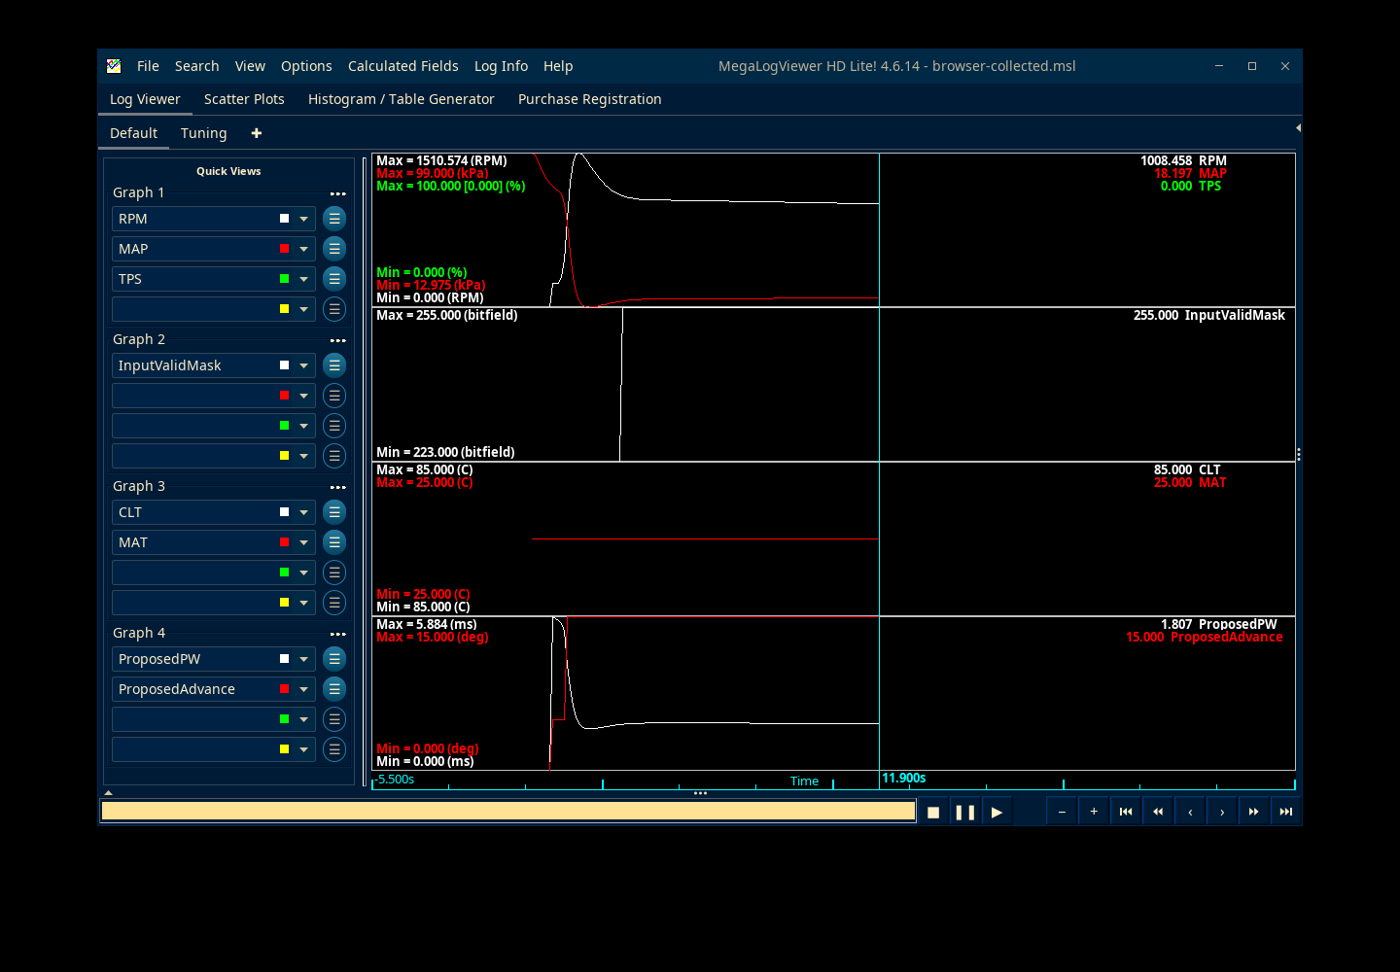
reports/engine/observability/megalogviewer-engine-fields.png
