markthebault/esp32-ecu/reports/engine/observability/megalogviewer-header.png

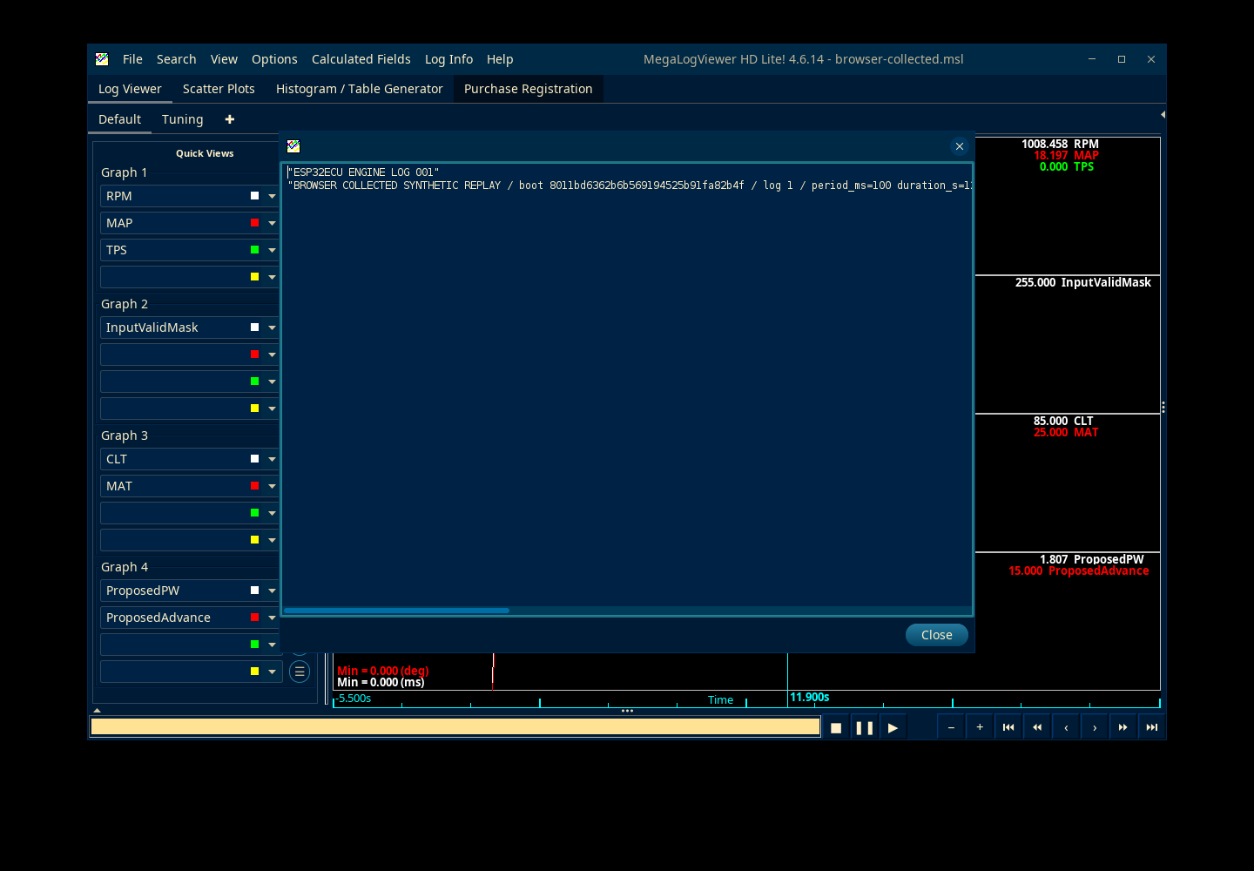
reports/engine/observability/megalogviewer-header.png
