markthebault/esp32-ecu/reports/engine/research-hard-limit.png

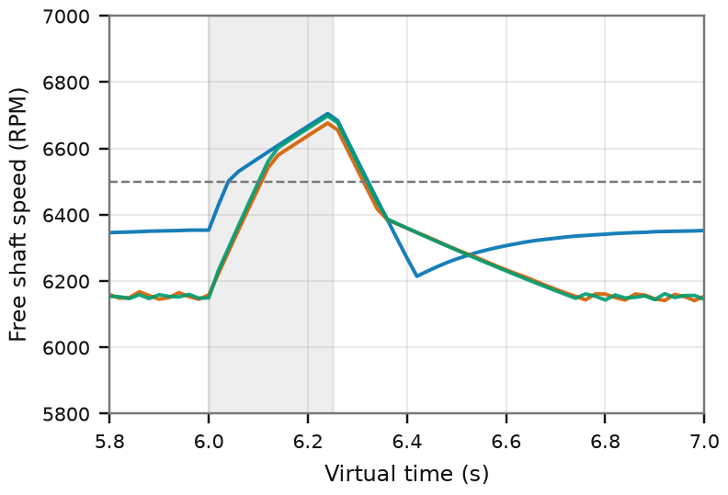
reports/engine/research-hard-limit.png
