markthebault/esp32-ecu/reports/engine/research-stall-restart.png

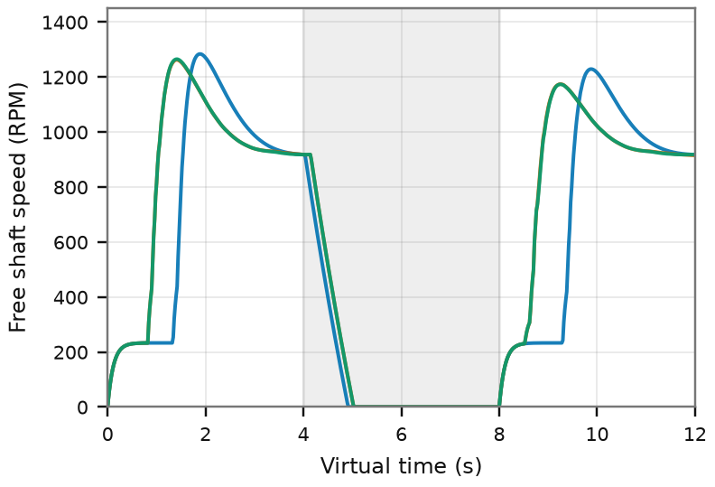
reports/engine/research-stall-restart.png
