markthebault/esp32-ecu/reports/engine/research-trigger-dropout.png

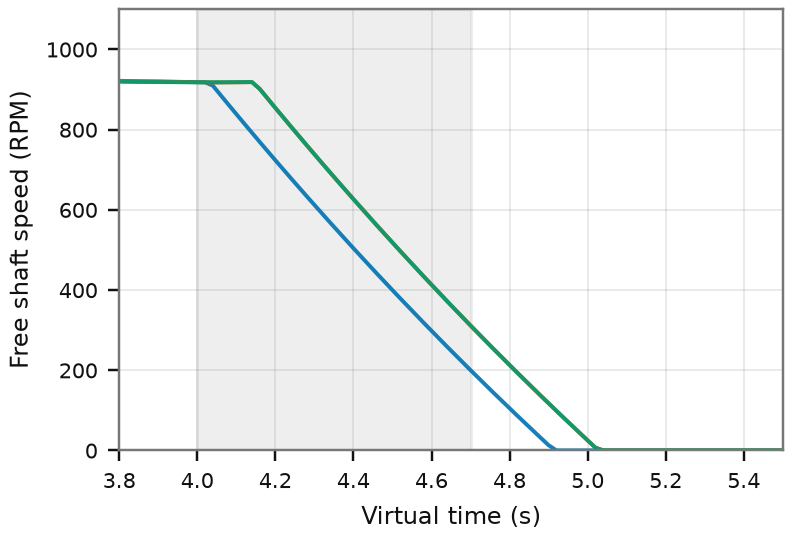
reports/engine/research-trigger-dropout.png
