markthebault/esp32-ecu/reports/engine/research-warm-start.png

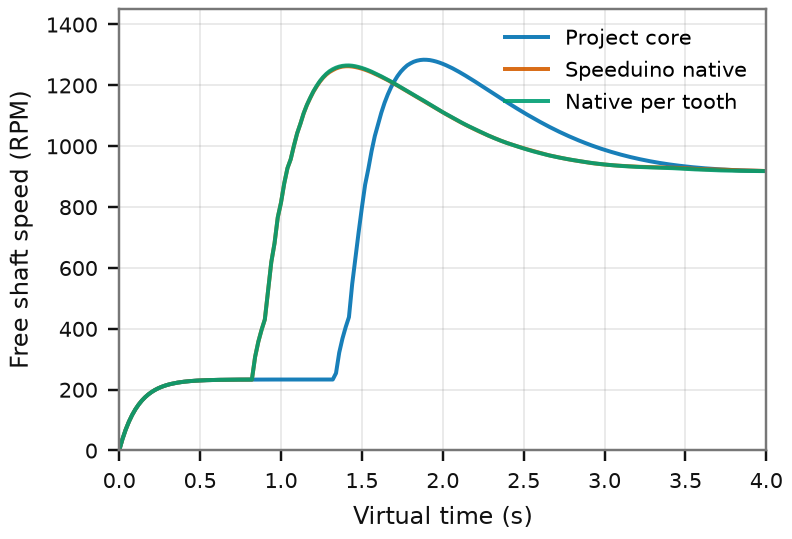
reports/engine/research-warm-start.png
