markthebault/esp32-ecu/reports/engine/secondary-integration/applications/mlv/direct145.png

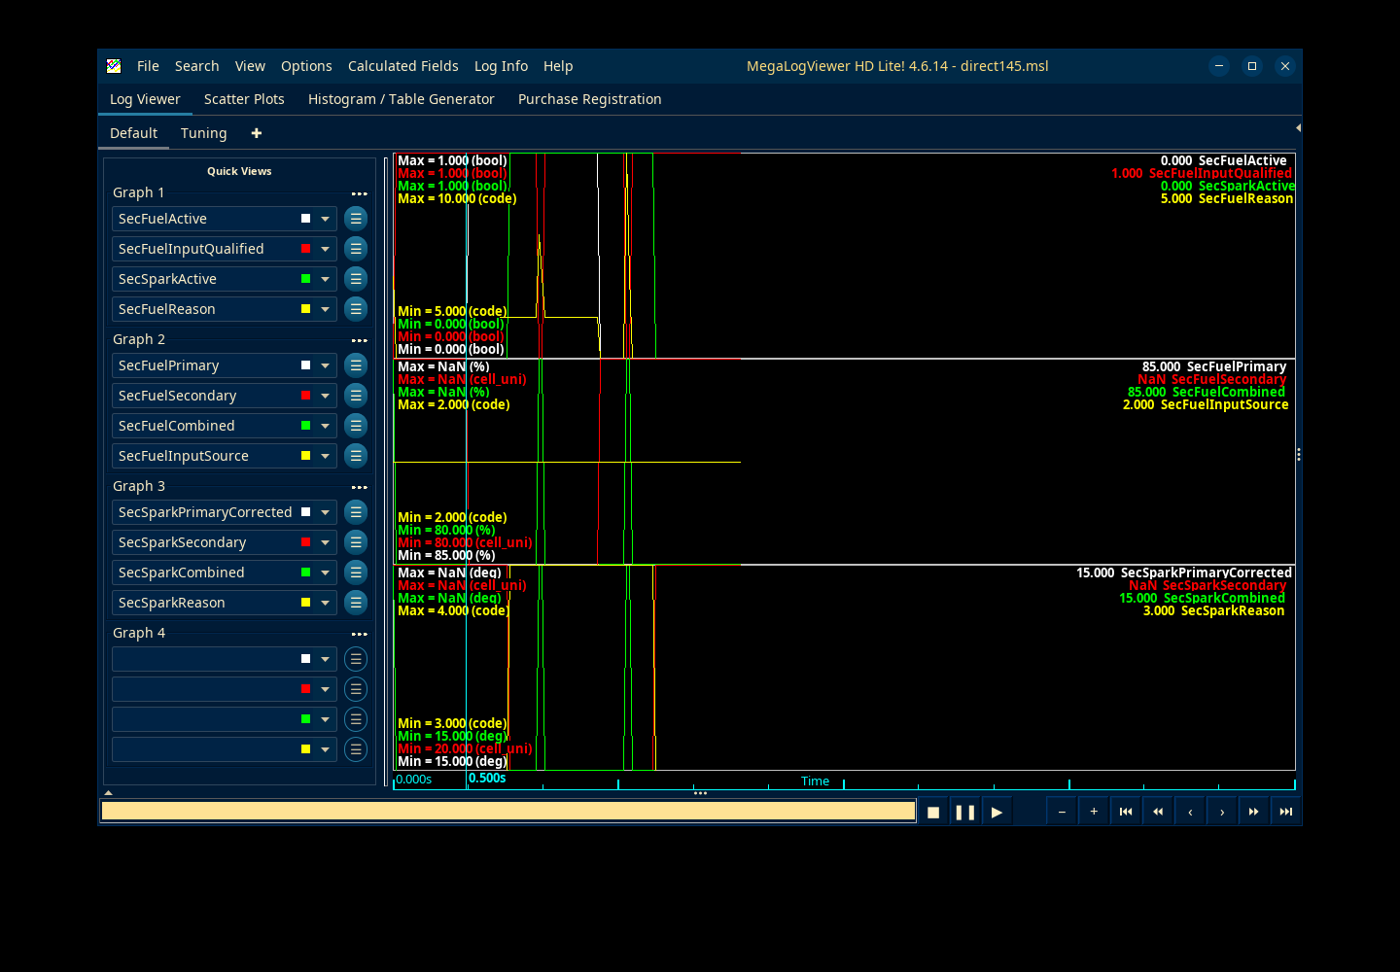
reports/engine/secondary-integration/applications/mlv/direct145.png
