markthebault/esp32-ecu/reports/engine/secondary-integration/applications/ts/spark-map-current.png

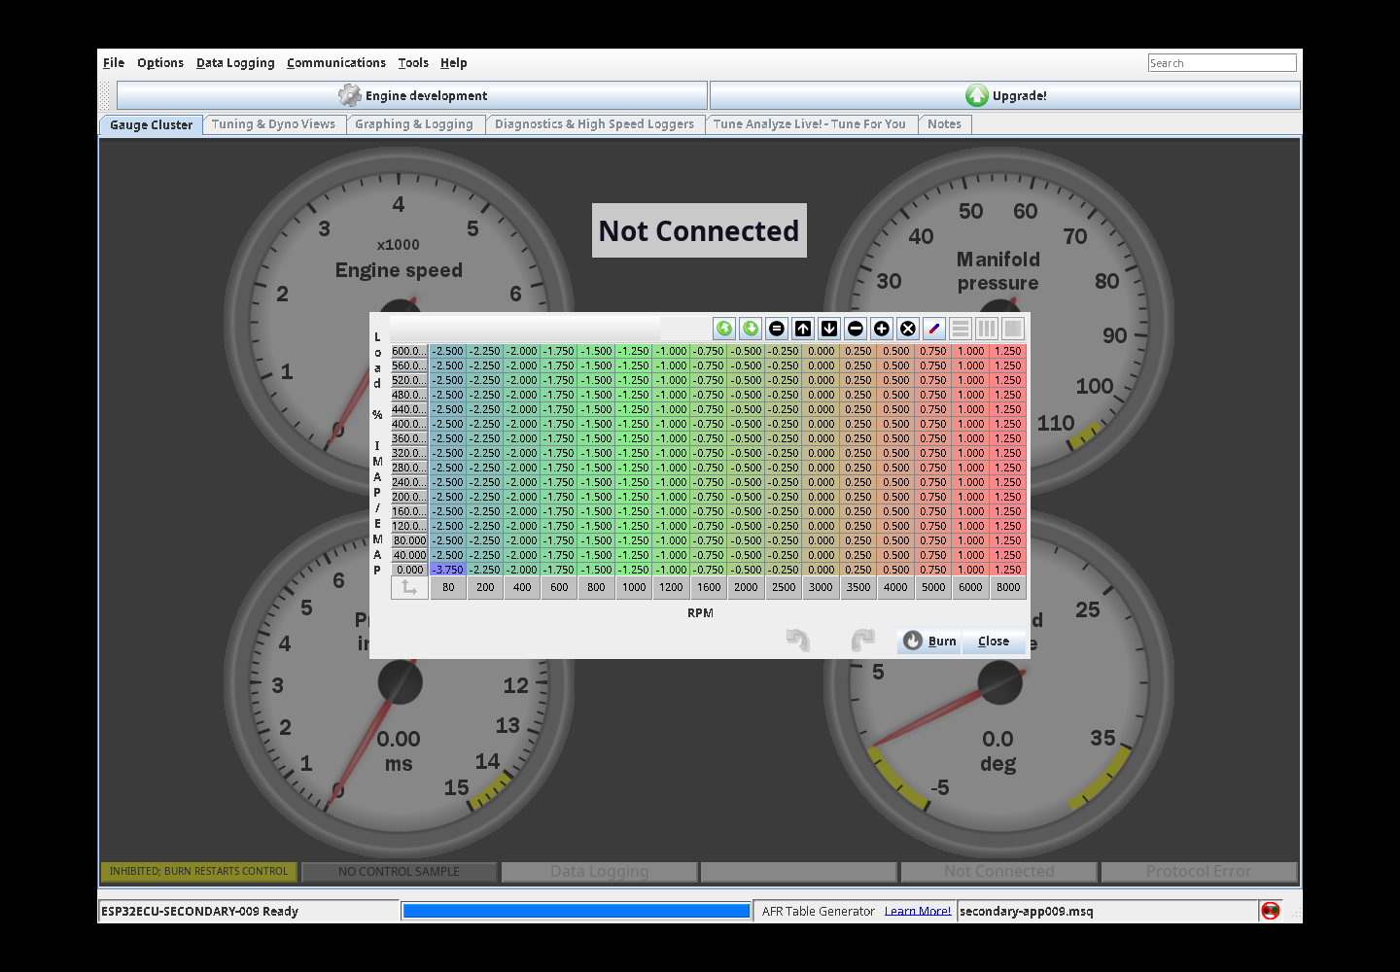
reports/engine/secondary-integration/applications/ts/spark-map-current.png
