markthebault/esp32-ecu/reports/engine/secondary-integration/browser/secondary/secondary-desktop.png

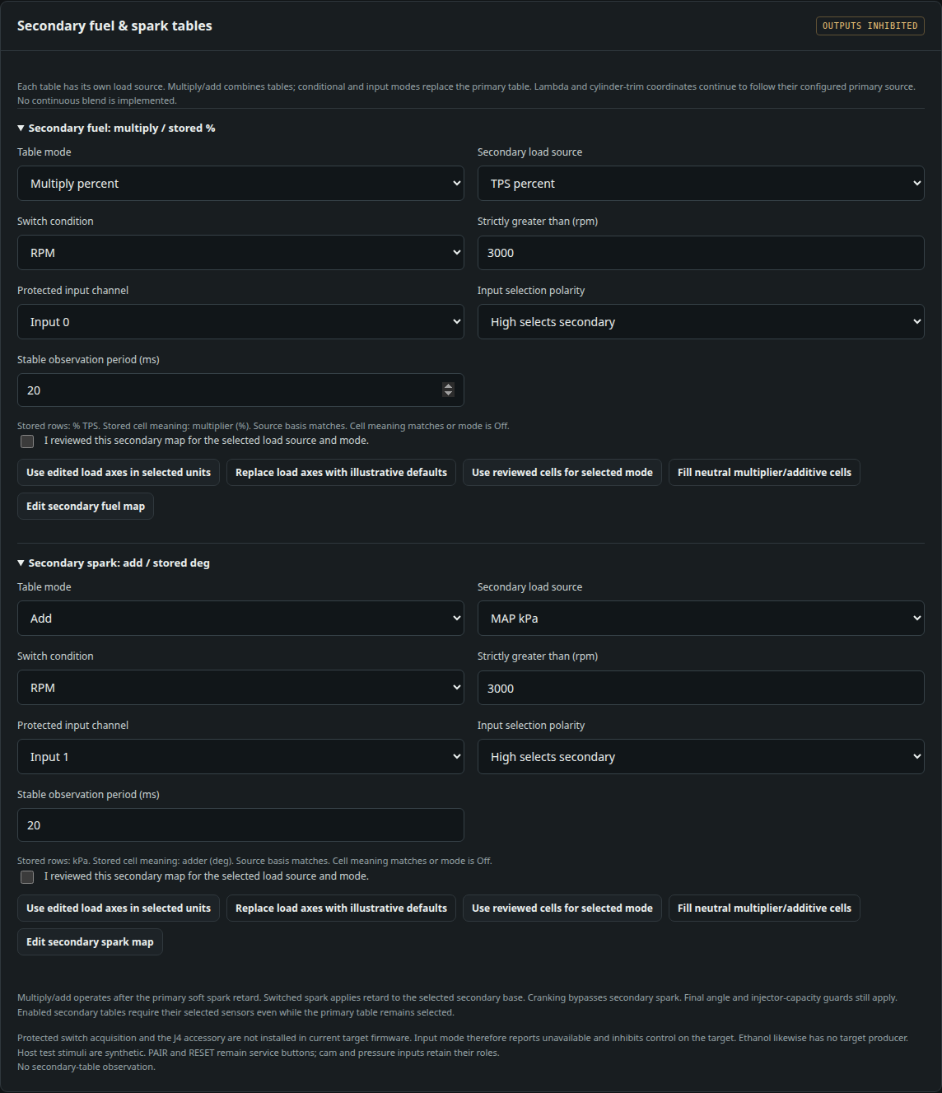
reports/engine/secondary-integration/browser/secondary/secondary-desktop.png
