markthebault/esp32-ecu/reports/engine/secondary-integration/browser/secondary/secondary-mobile.png

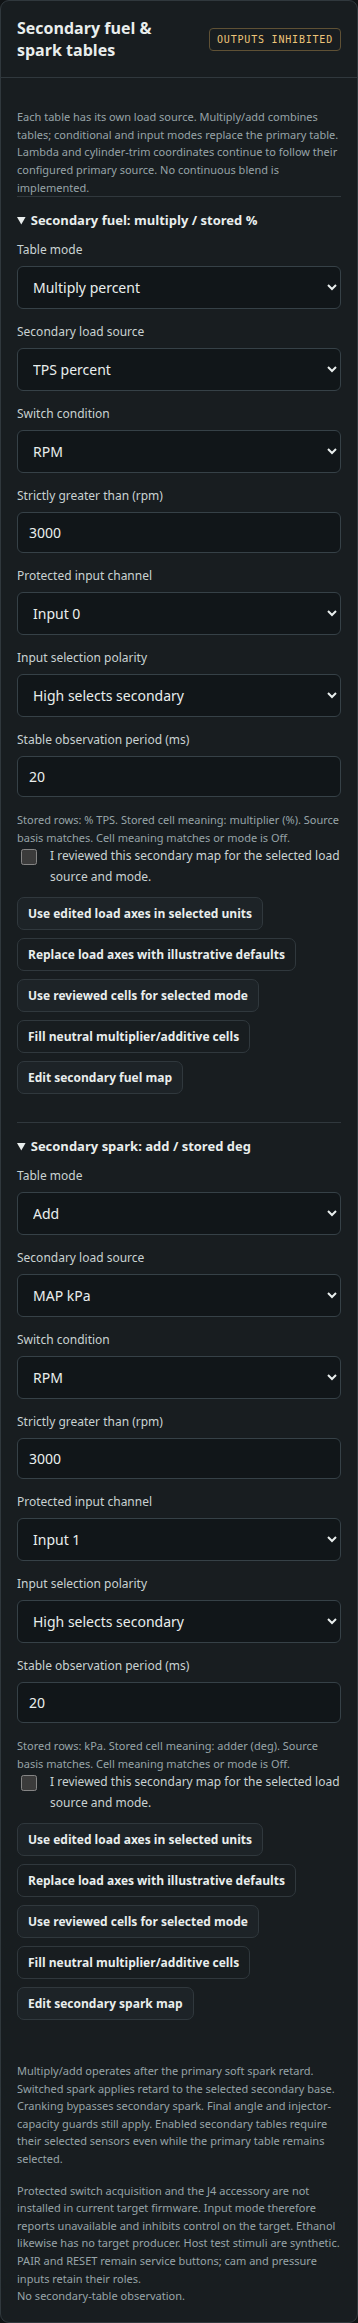
reports/engine/secondary-integration/browser/secondary/secondary-mobile.png
