markthebault/esp32-ecu/reports/engine/secondary-plant/reviews/crank/final-frozen-browser-status.png

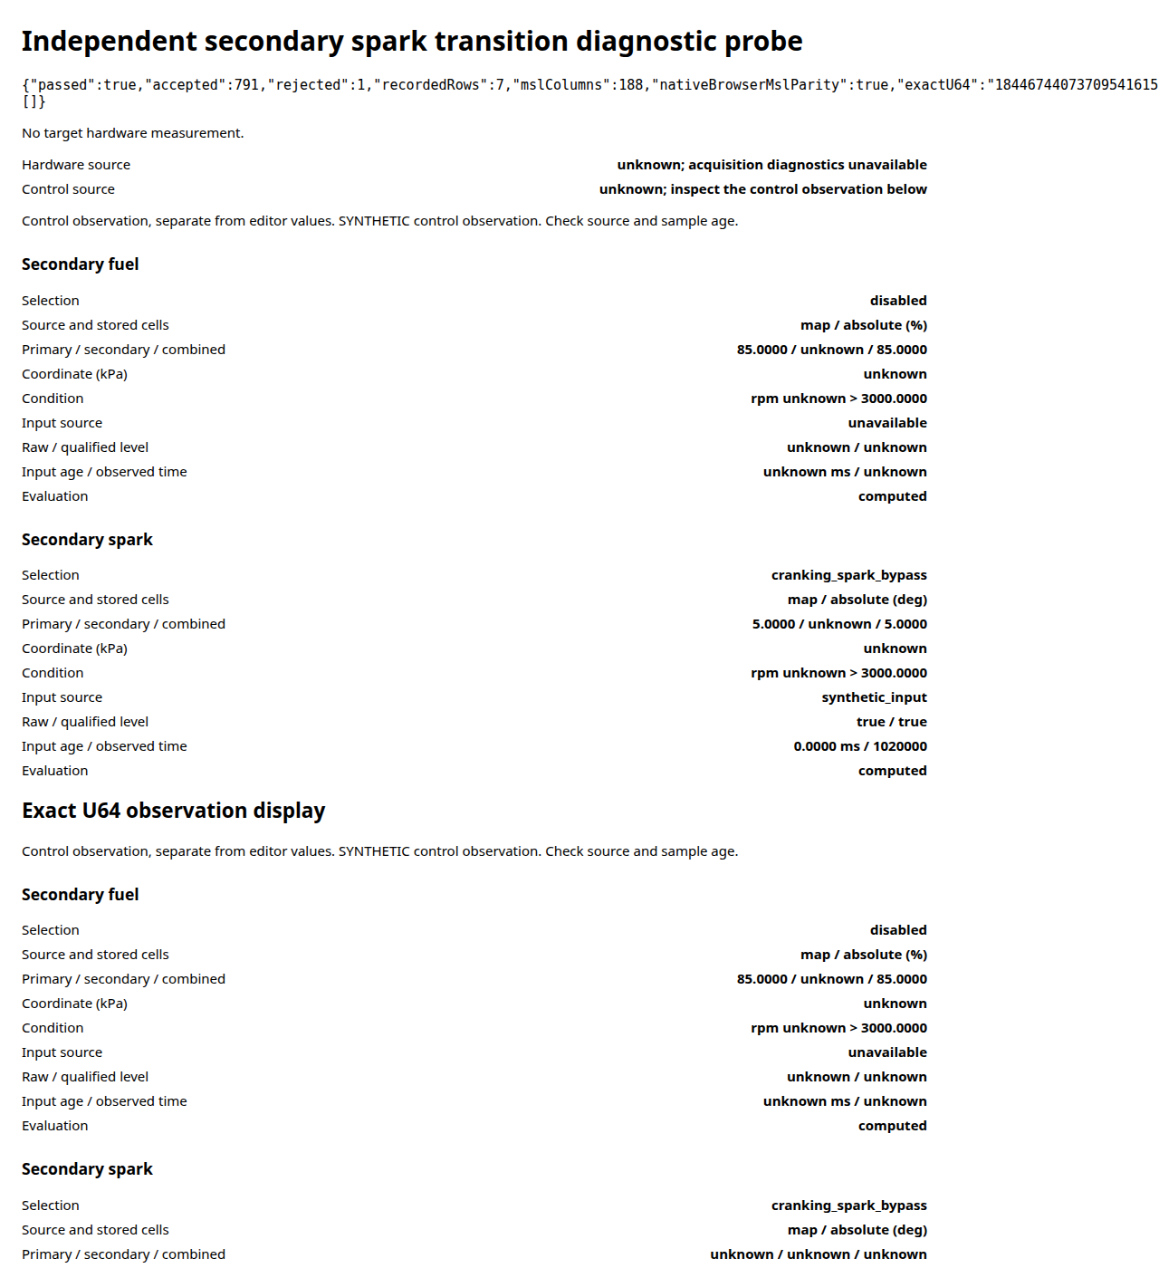
reports/engine/secondary-plant/reviews/crank/final-frozen-browser-status.png
