markthebault/esp32-ecu/reports/engine/semi-sequential/applications/megalogviewer.png

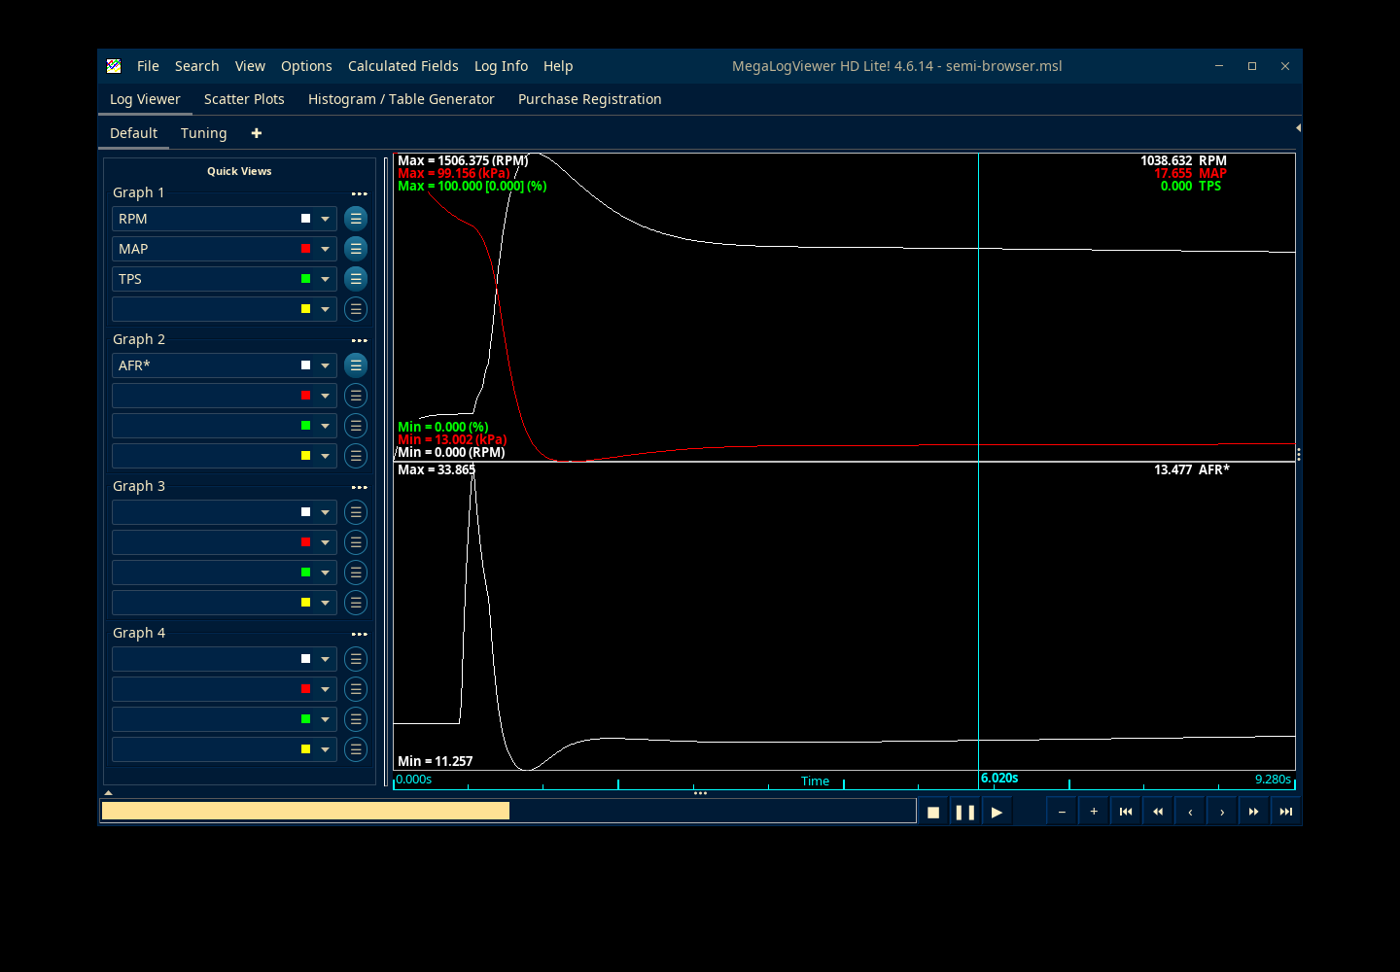
reports/engine/semi-sequential/applications/megalogviewer.png
