markthebault/esp32-ecu/reports/engine/semi-sequential/browser/ui-sequential-sequential-ui-desktop.png

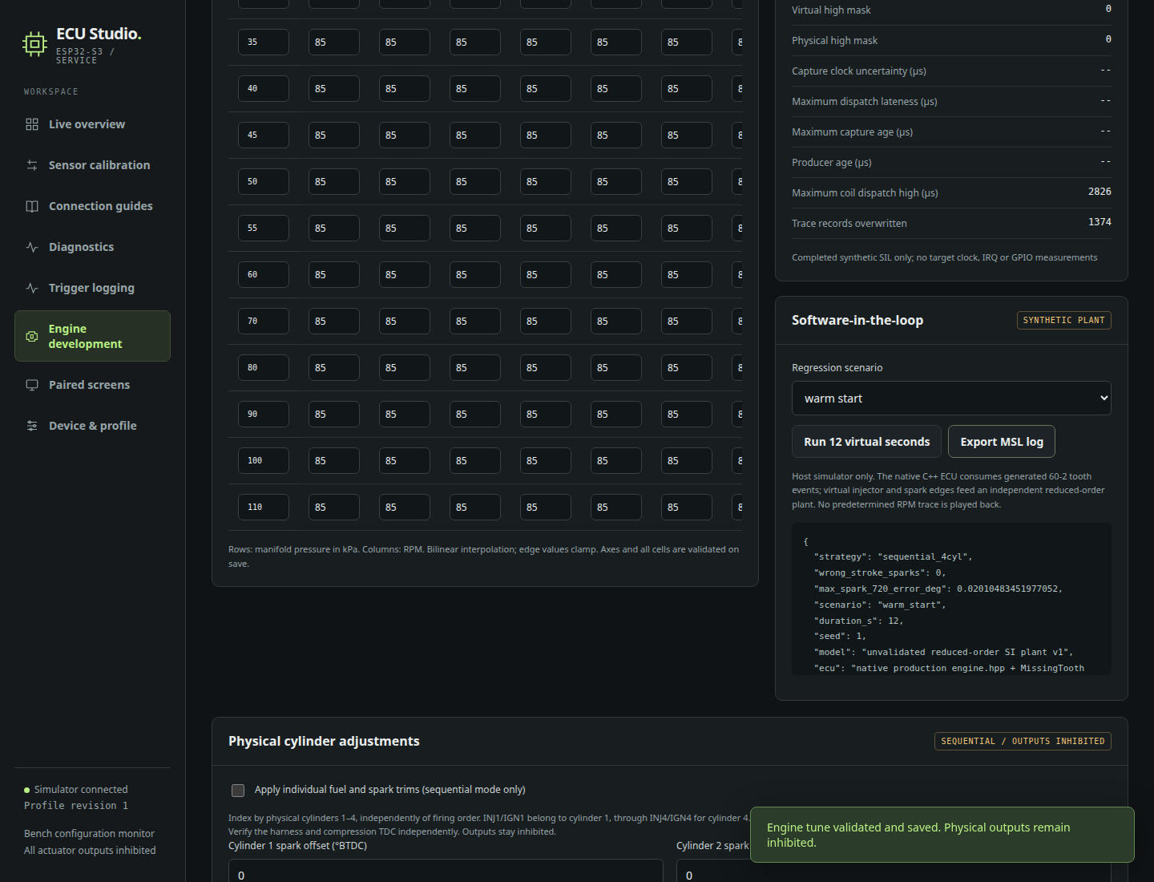
reports/engine/semi-sequential/browser/ui-sequential-sequential-ui-desktop.png
