markthebault/esp32-ecu/reports/engine/semi-sequential/comparison.png

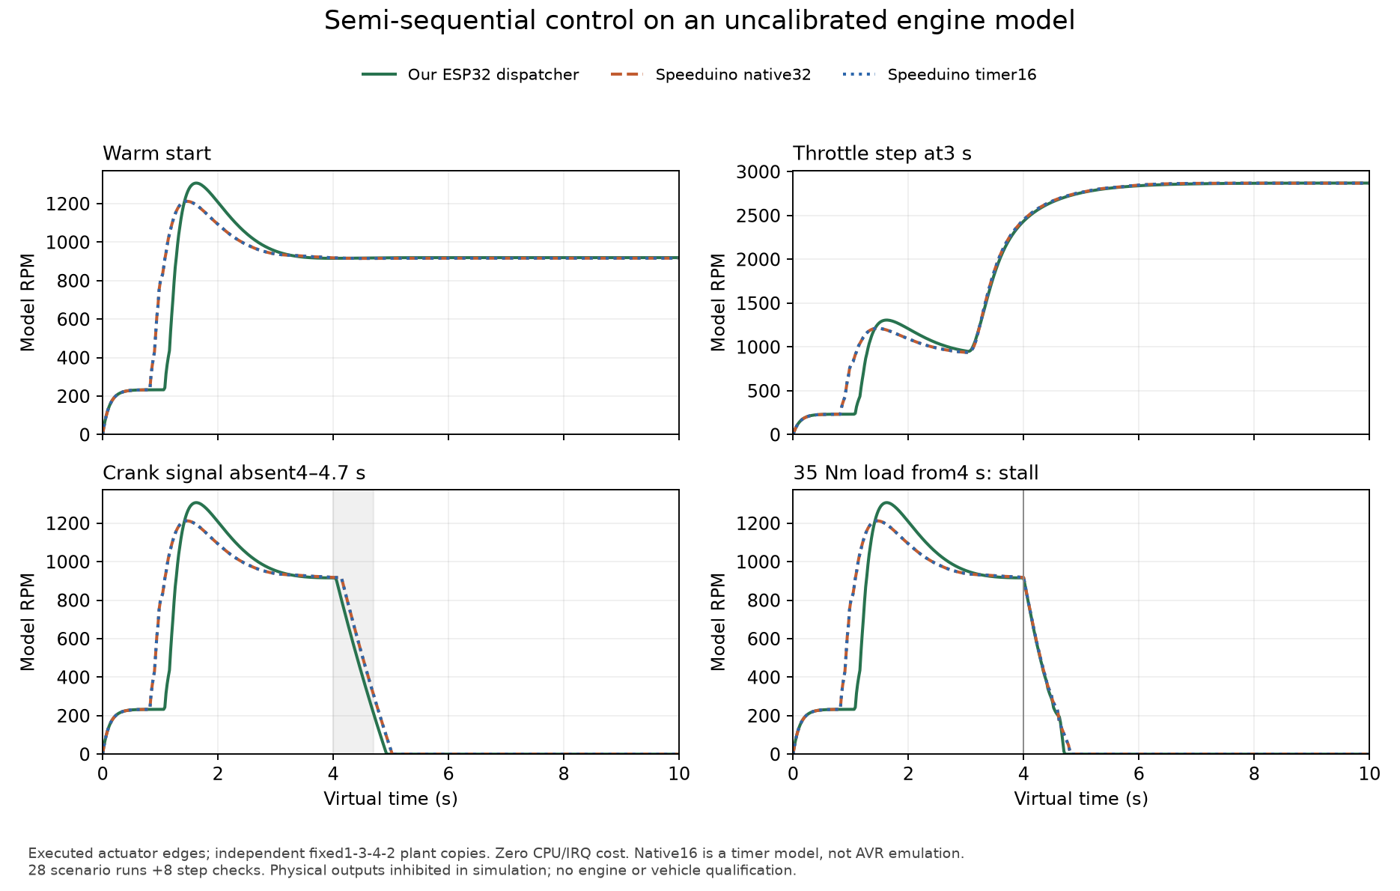
reports/engine/semi-sequential/comparison.png
