markthebault/esp32-ecu/reports/engine/sequential/sequential-comparison.png

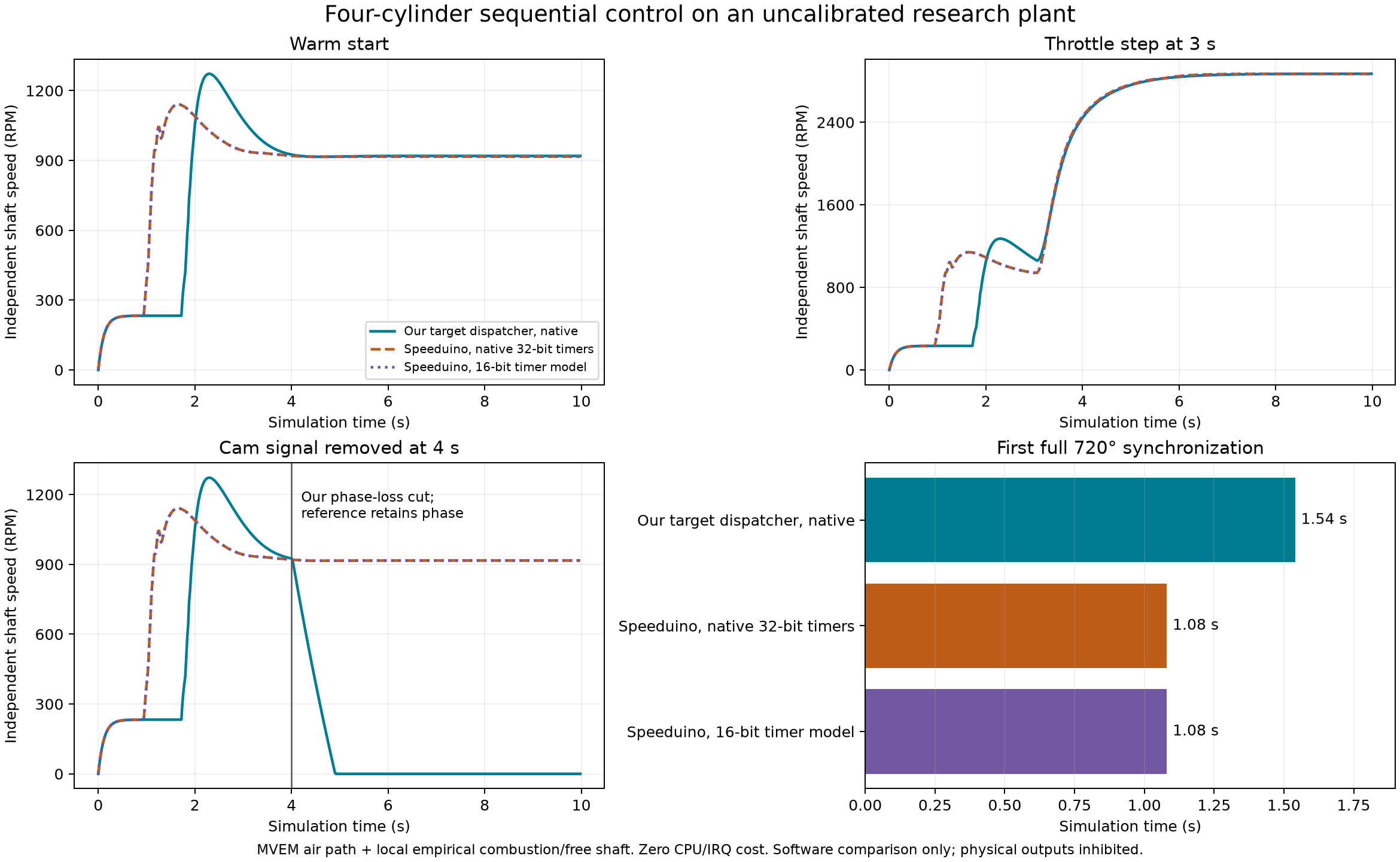
reports/engine/sequential/sequential-comparison.png
