markthebault/esp32-ecu/reports/engine/sequential/sequential-ui-desktop.png

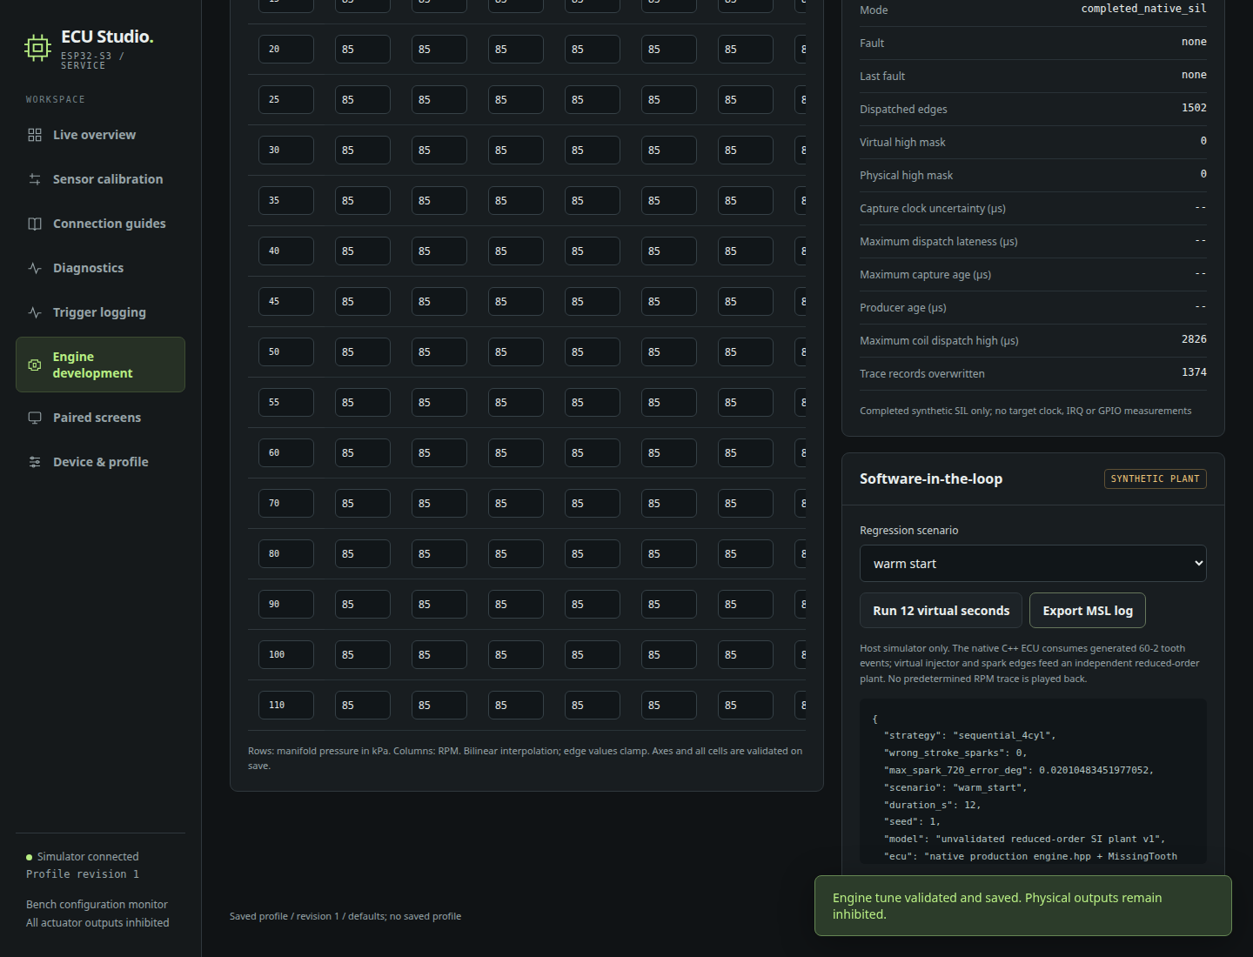
reports/engine/sequential/sequential-ui-desktop.png
