markthebault/esp32-ecu/reports/engine/sequential/trigger-ui-regression/injected-target-ui.png

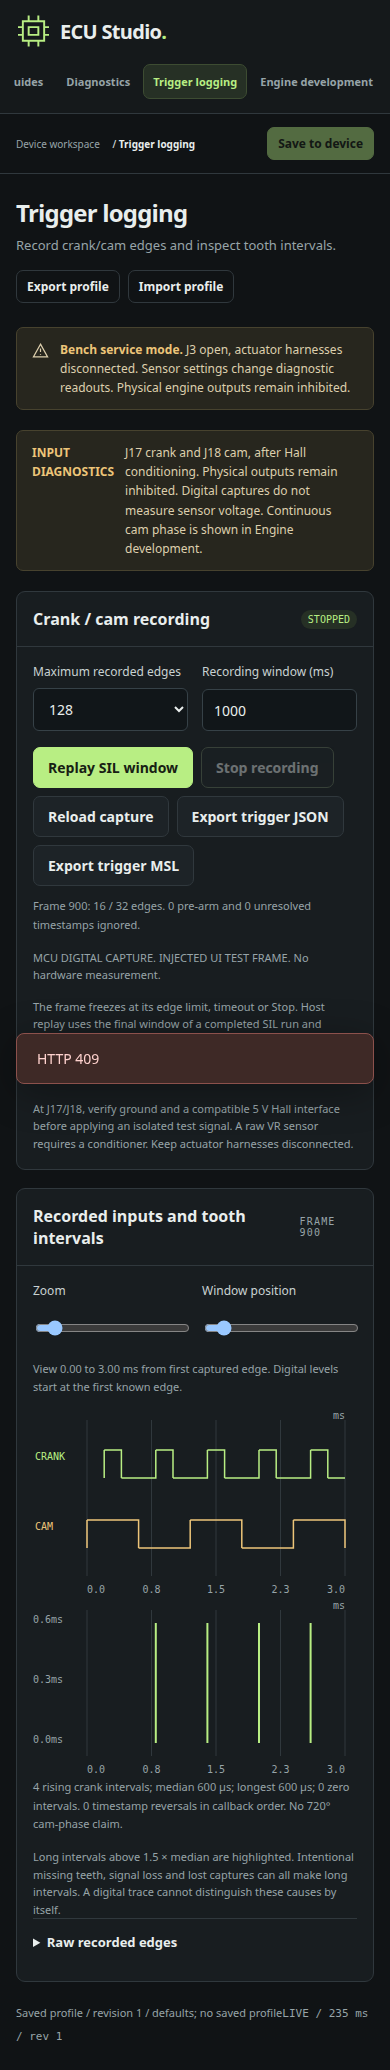
reports/engine/sequential/trigger-ui-regression/injected-target-ui.png
