markthebault/esp32-ecu/reports/engine/sequential/trigger-ui-regression/trigger-ui-desktop.png

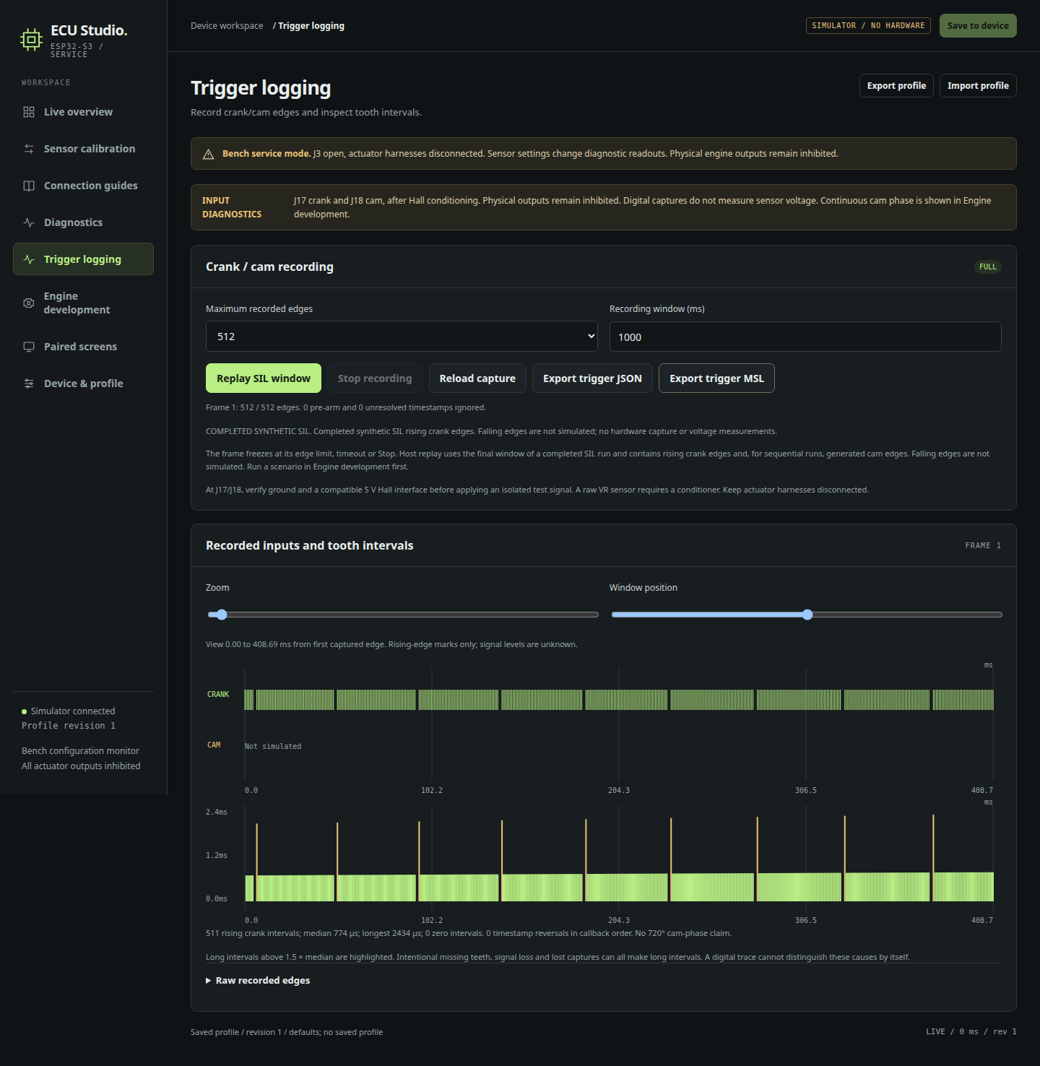
reports/engine/sequential/trigger-ui-regression/trigger-ui-desktop.png
