markthebault/esp32-ecu/reports/engine/sequential/trigger-ui-regression/trigger-ui-mobile.png

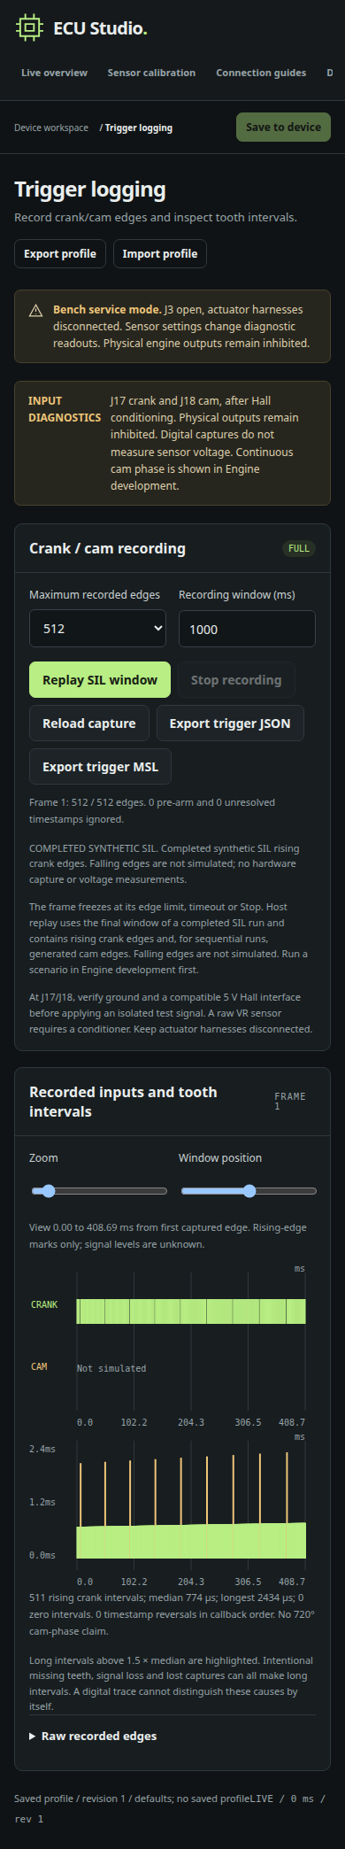
reports/engine/sequential/trigger-ui-regression/trigger-ui-mobile.png
