markthebault/esp32-ecu/reports/engine/shared-status-led/browser/led-mobile.png

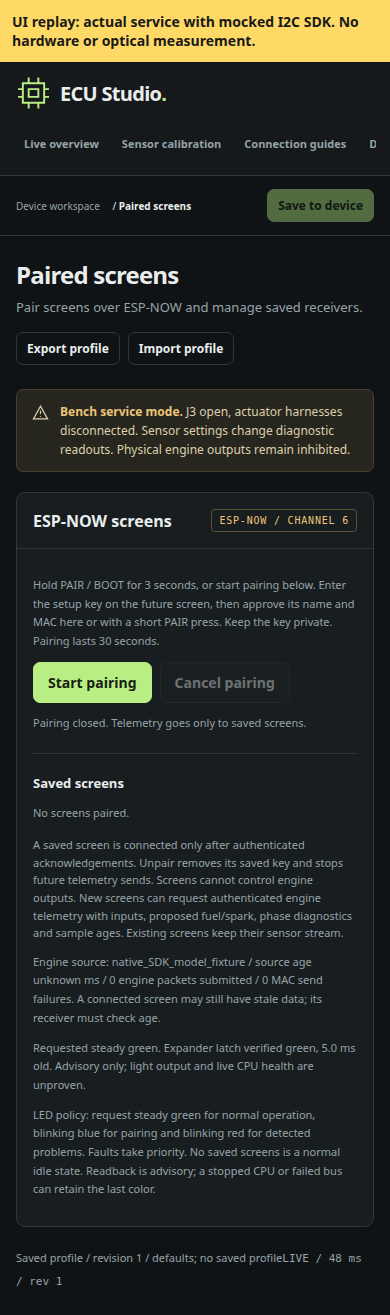
reports/engine/shared-status-led/browser/led-mobile.png
