markthebault/esp32-ecu/reports/engine/sil-start-restart.png

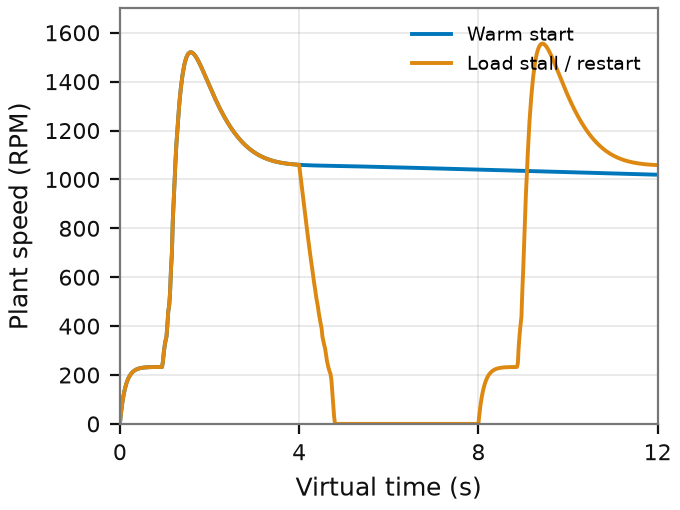
reports/engine/sil-start-restart.png
