markthebault/esp32-ecu/reports/engine/speeduino-fuel-difference.png

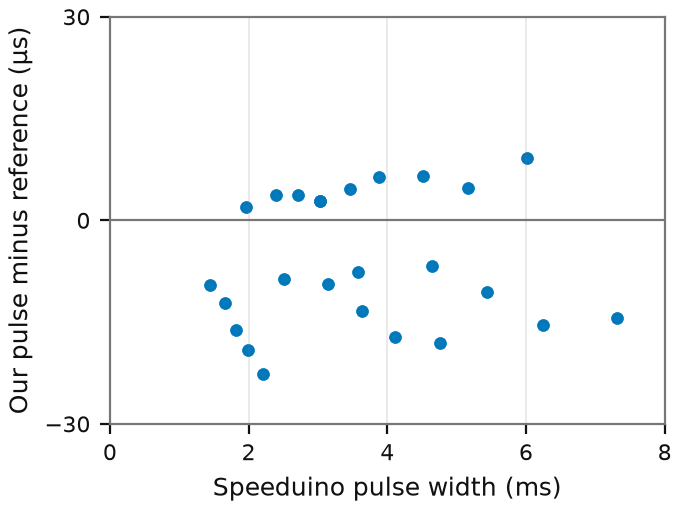
reports/engine/speeduino-fuel-difference.png
