markthebault/esp32-ecu/reports/engine/switch-inputs/reviews/circuit/reviewed-revision/native/schematic/switches.png

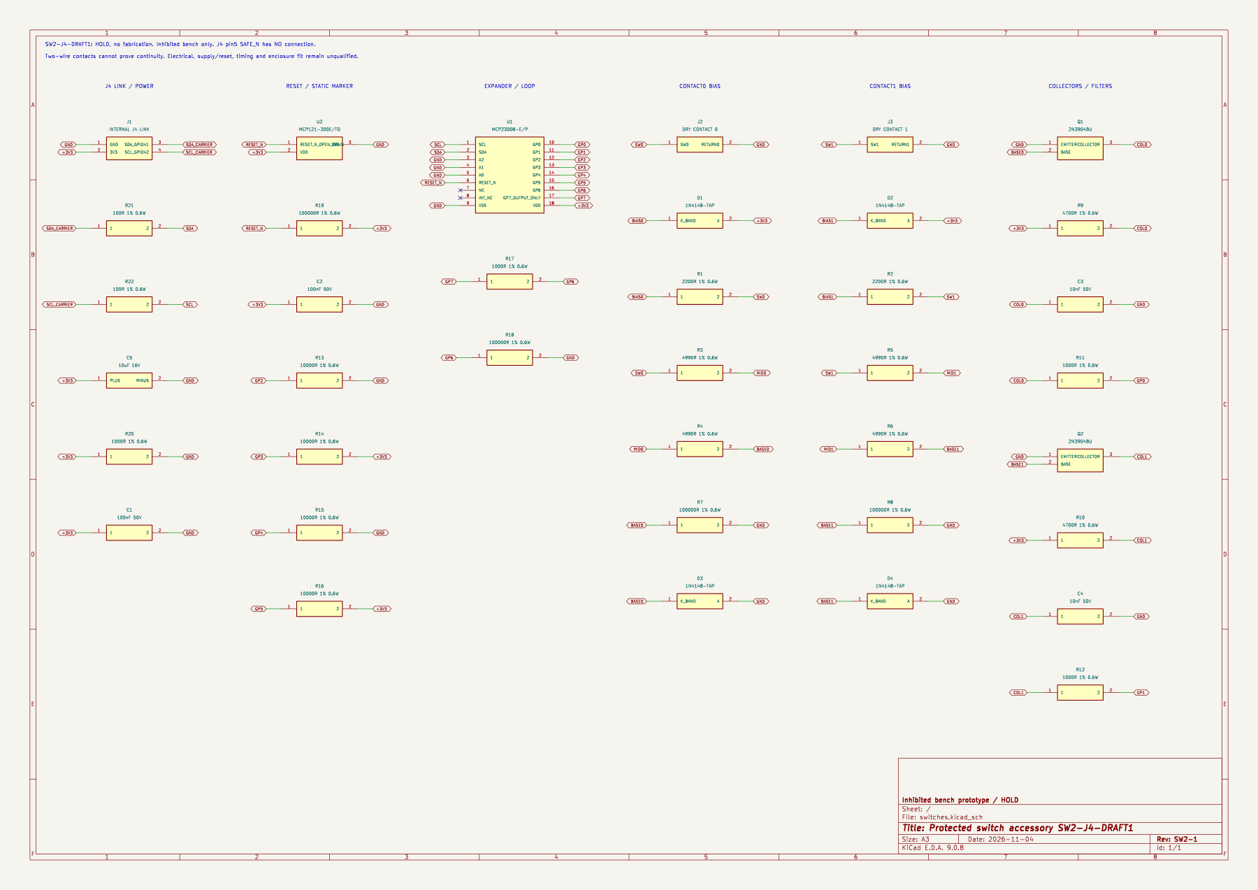
reports/engine/switch-inputs/reviews/circuit/reviewed-revision/native/schematic/switches.png
