markthebault/esp32-ecu/reports/engine/target-timing/comparison-overrev.png

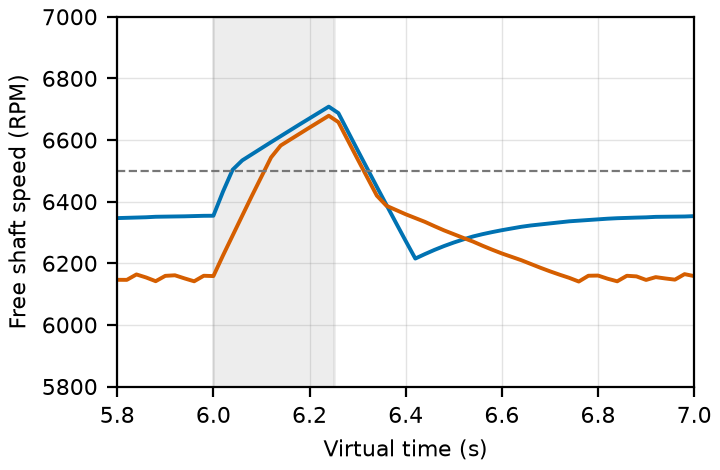
reports/engine/target-timing/comparison-overrev.png
