markthebault/esp32-ecu/reports/engine/target-timing/comparison-sensor_short.png

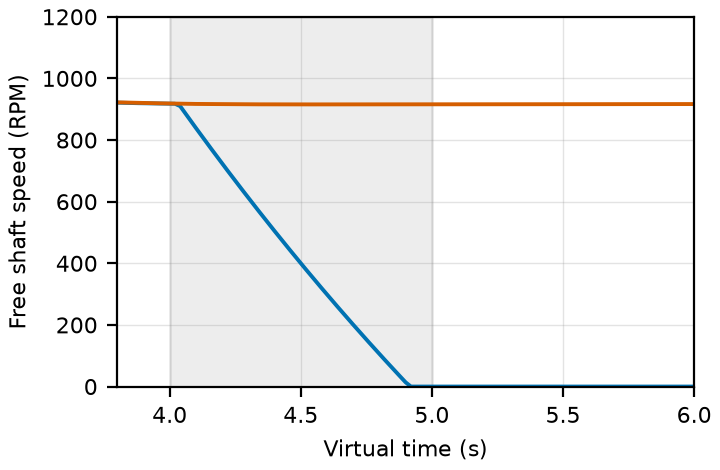
reports/engine/target-timing/comparison-sensor_short.png
