markthebault/esp32-ecu/reports/engine/target-timing/comparison-stall_restart.png

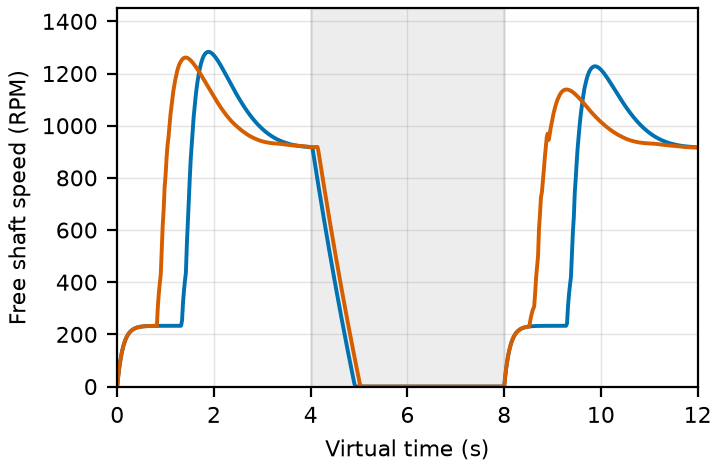
reports/engine/target-timing/comparison-stall_restart.png
