markthebault/esp32-ecu/reports/engine/target-timing/comparison-warm_start.png

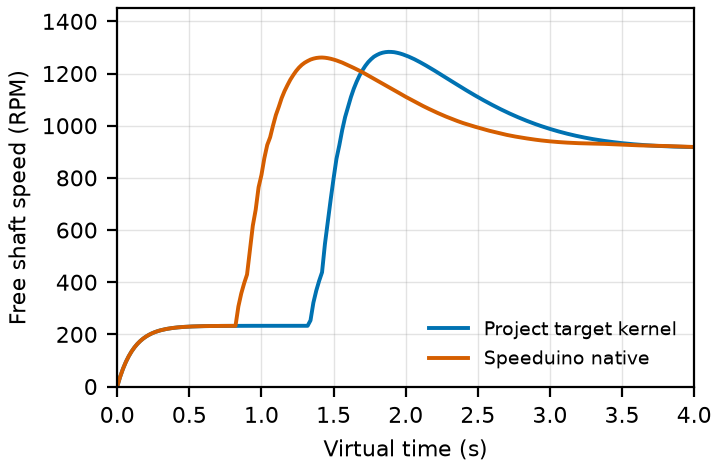
reports/engine/target-timing/comparison-warm_start.png
