markthebault/esp32-ecu/reports/engine/target-timing/engine-ui-desktop.png

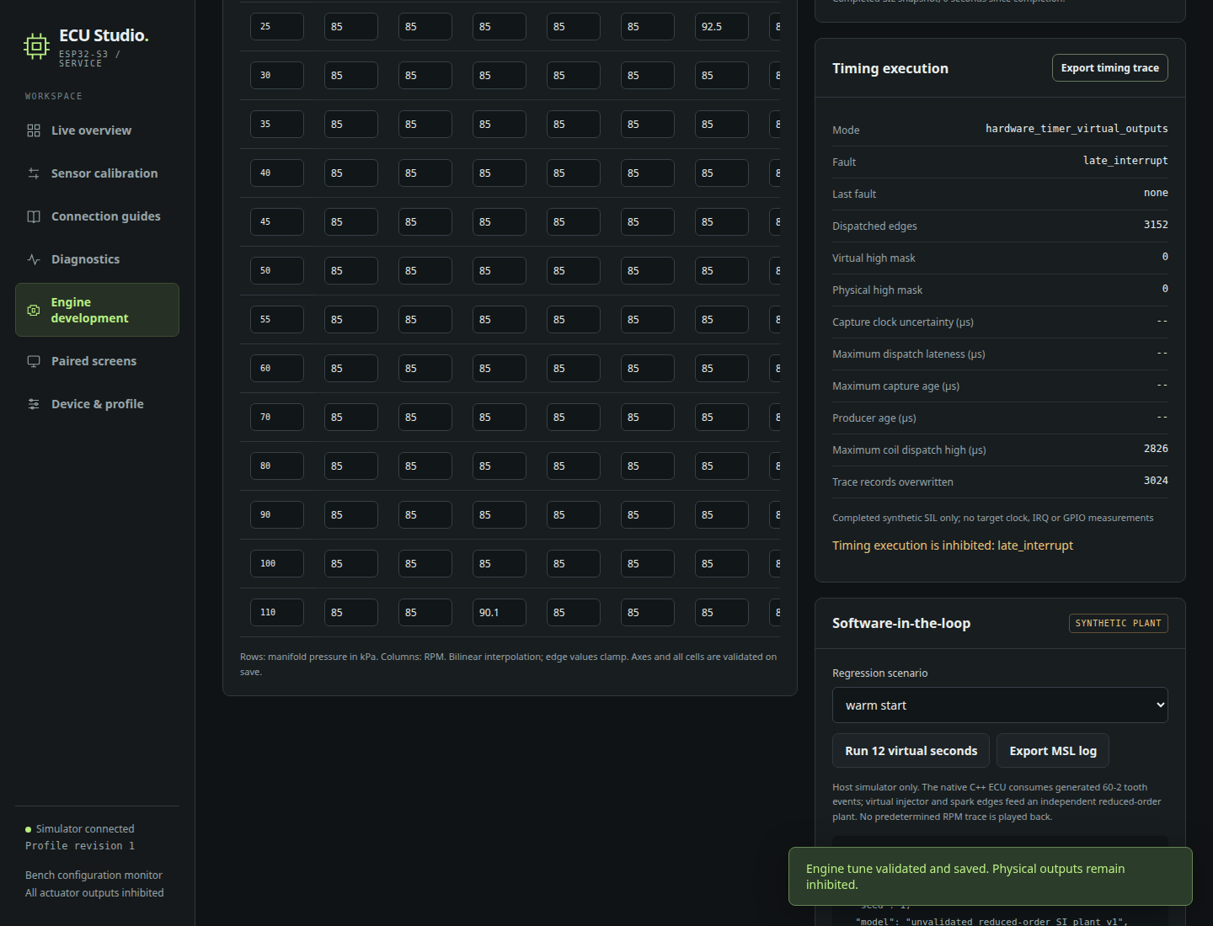
reports/engine/target-timing/engine-ui-desktop.png
