markthebault/esp32-ecu/reports/engine/transient-enrichment/applications/mlv/engine105-ae.png

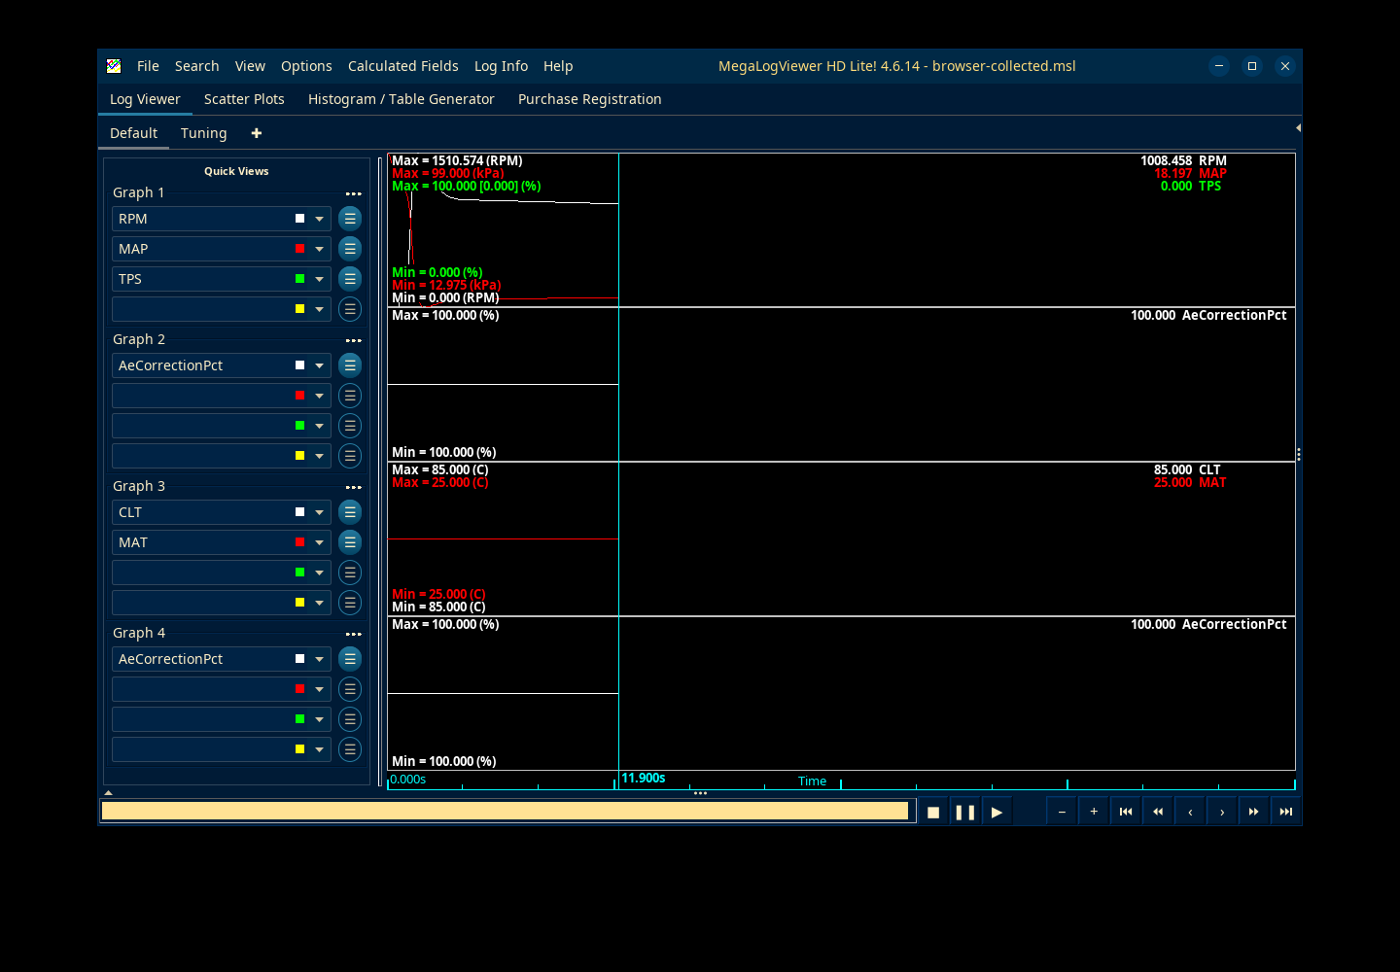
reports/engine/transient-enrichment/applications/mlv/engine105-ae.png
