markthebault/esp32-ecu/reports/engine/transient-enrichment/applications/ts/transient-curve.png

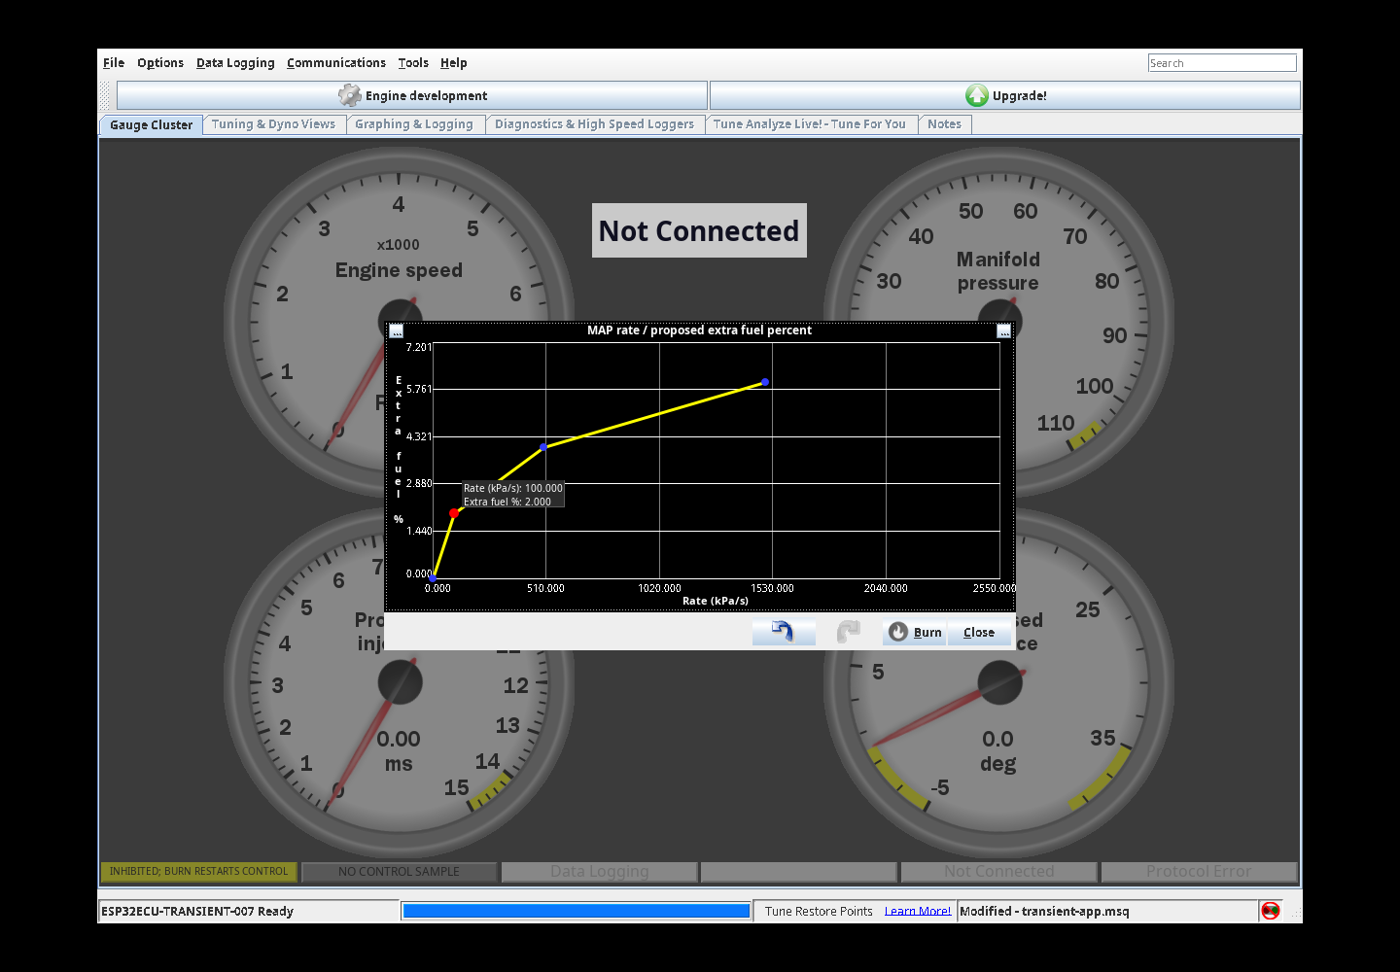
reports/engine/transient-enrichment/applications/ts/transient-curve.png
