markthebault/esp32-ecu/reports/engine/transient-enrichment/browser/ui-logger-final/engine-log-mobile.png

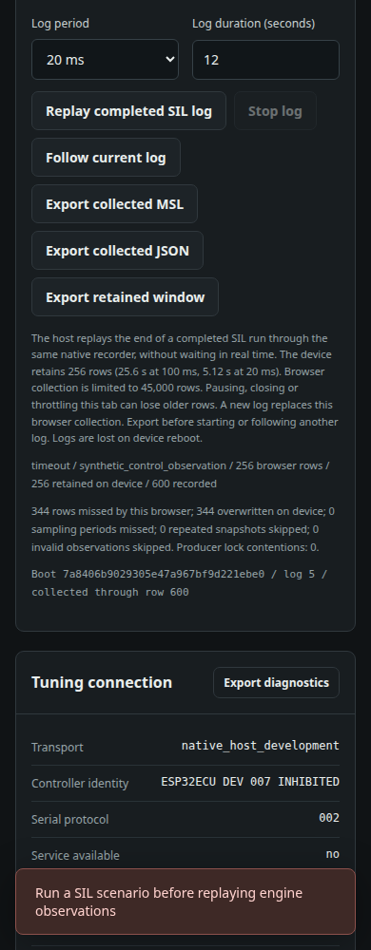
reports/engine/transient-enrichment/browser/ui-logger-final/engine-log-mobile.png
