markthebault/esp32-ecu/reports/engine/transient-enrichment/transient-comparison.png

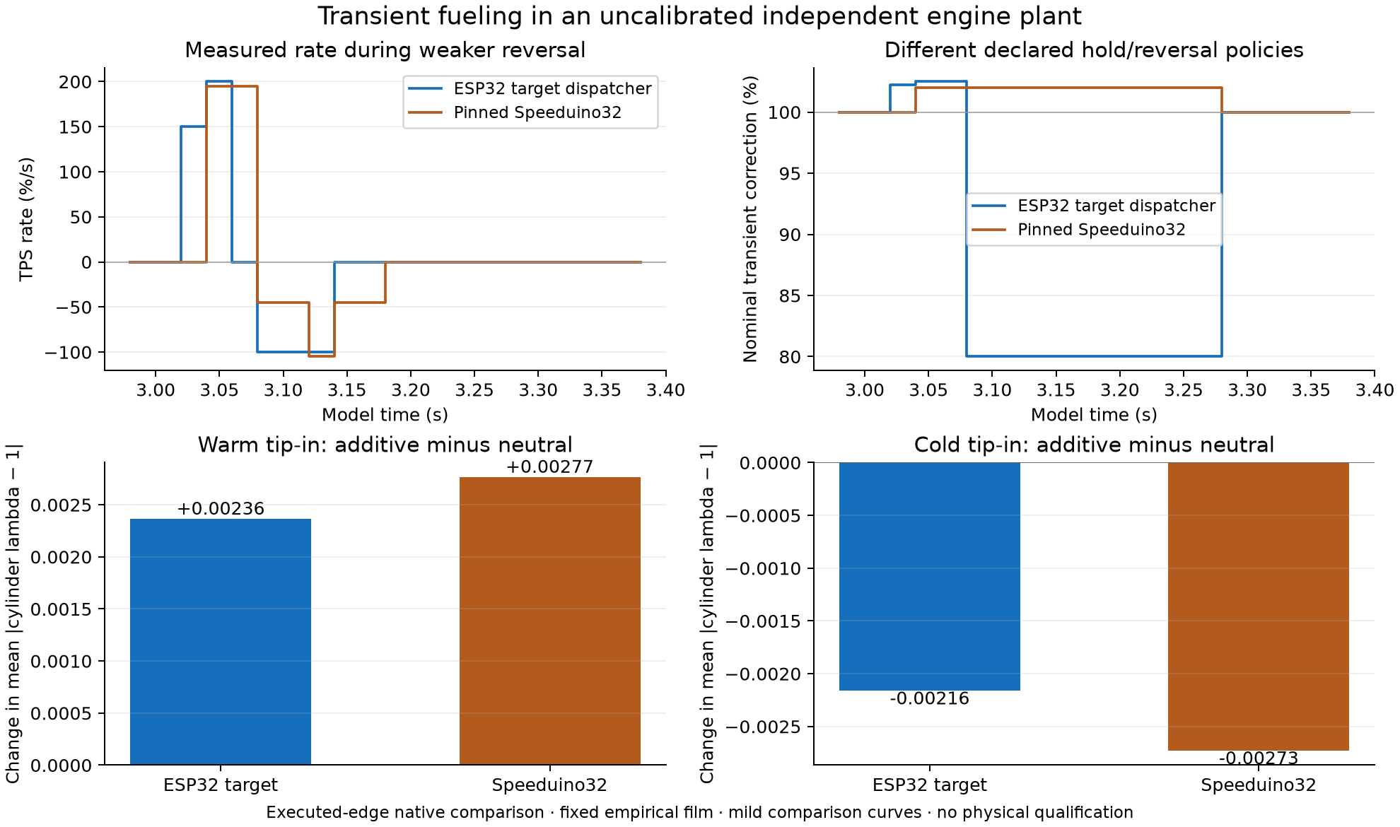
reports/engine/transient-enrichment/transient-comparison.png
