markthebault/esp32-ecu/reports/engine/trigger-logging/composite-1000-dropout.png

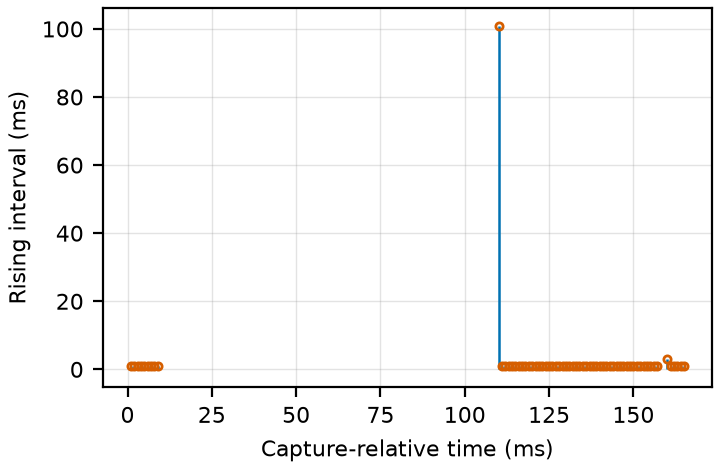
reports/engine/trigger-logging/composite-1000-dropout.png
