markthebault/esp32-ecu/reports/engine/trigger-logging/composite-1000-noise.png

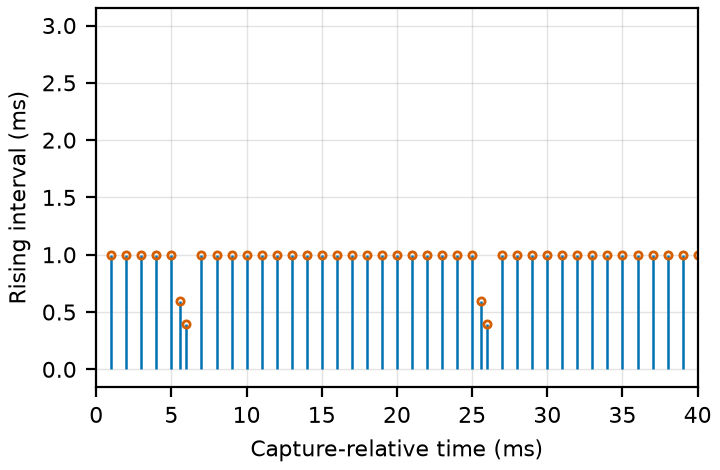
reports/engine/trigger-logging/composite-1000-noise.png
