markthebault/esp32-ecu/reports/engine/trigger-logging/megalogviewer-header.png

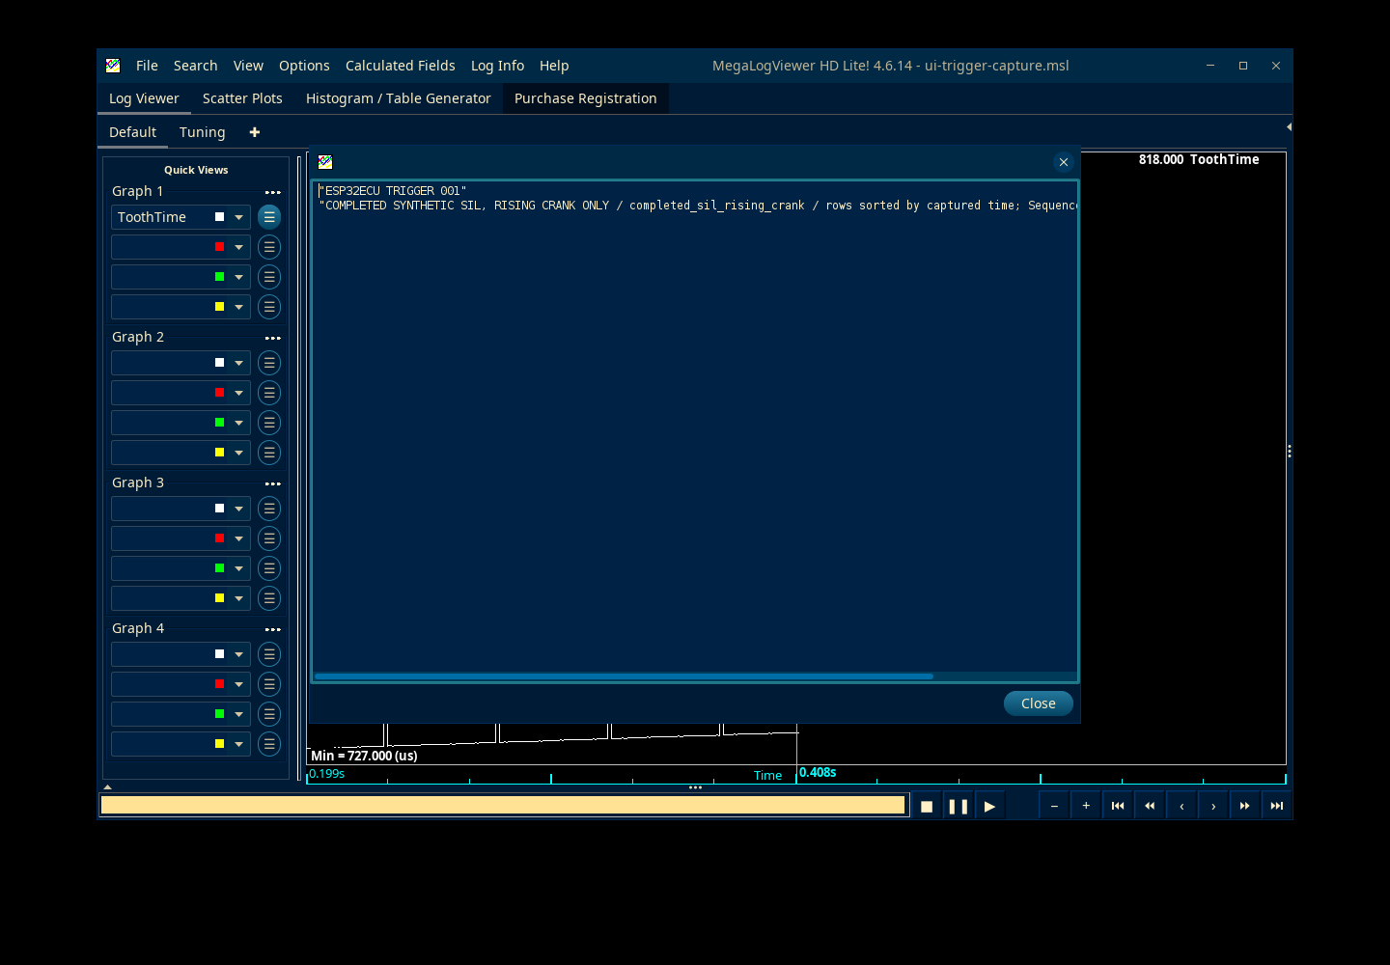
reports/engine/trigger-logging/megalogviewer-header.png
