markthebault/esp32-ecu/reports/engine/trigger-logging/megalogviewer-trigger.png

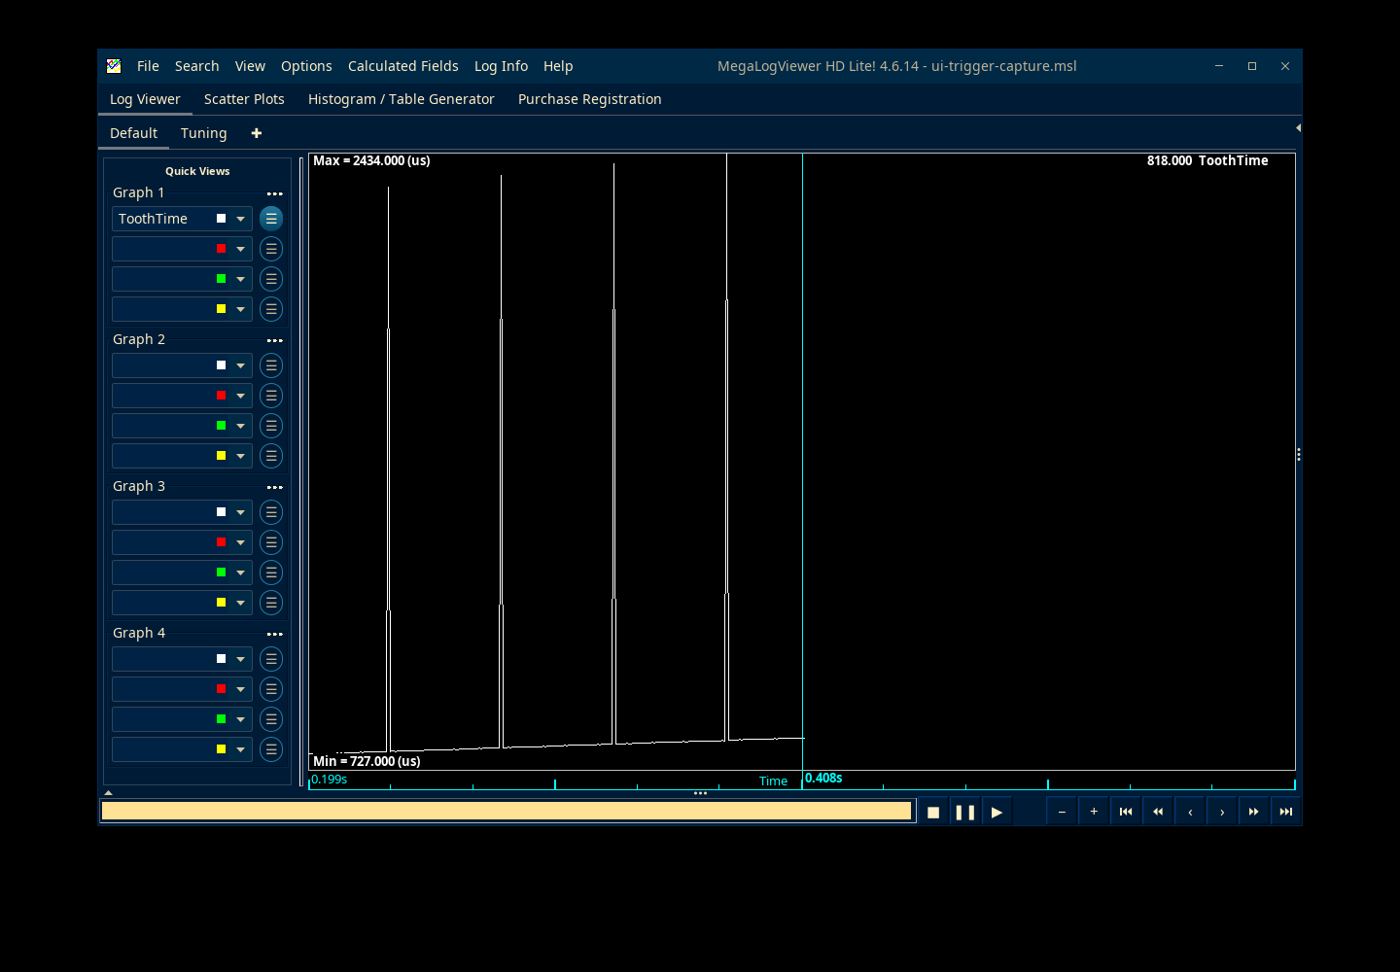
reports/engine/trigger-logging/megalogviewer-trigger.png
