markthebault/esp32-ecu/reports/engine/trigger-logging/tooth-1000-clean.png

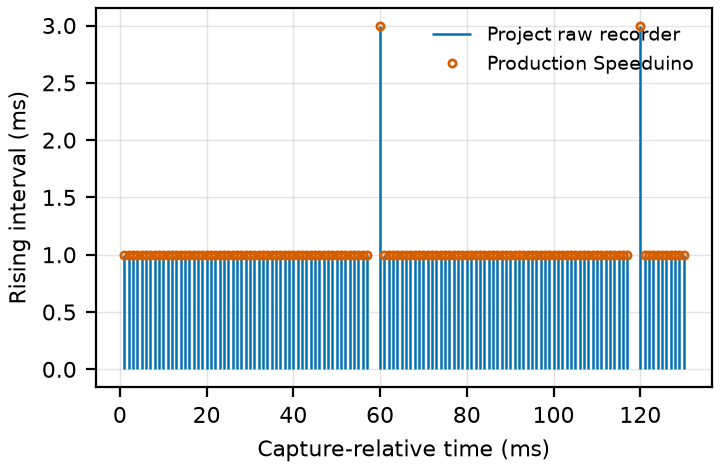
reports/engine/trigger-logging/tooth-1000-clean.png
