markthebault/esp32-ecu/reports/engine/tunerstudio-offline-map.png

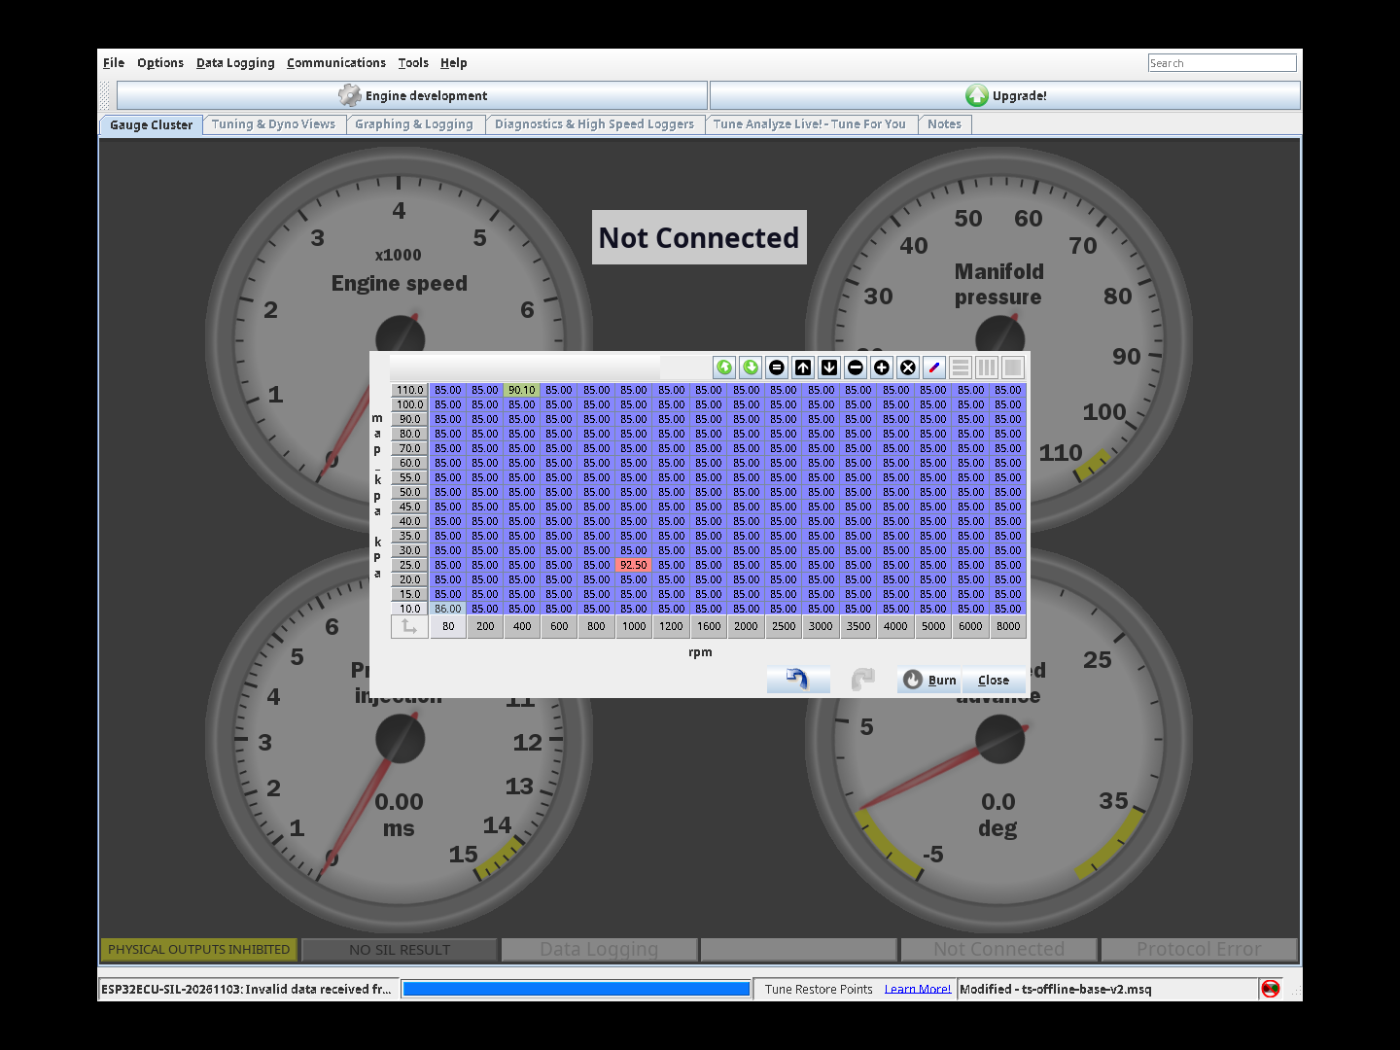
reports/engine/tunerstudio-offline-map.png
