markthebault/esp32-ecu/reports/pcb-bottom.png

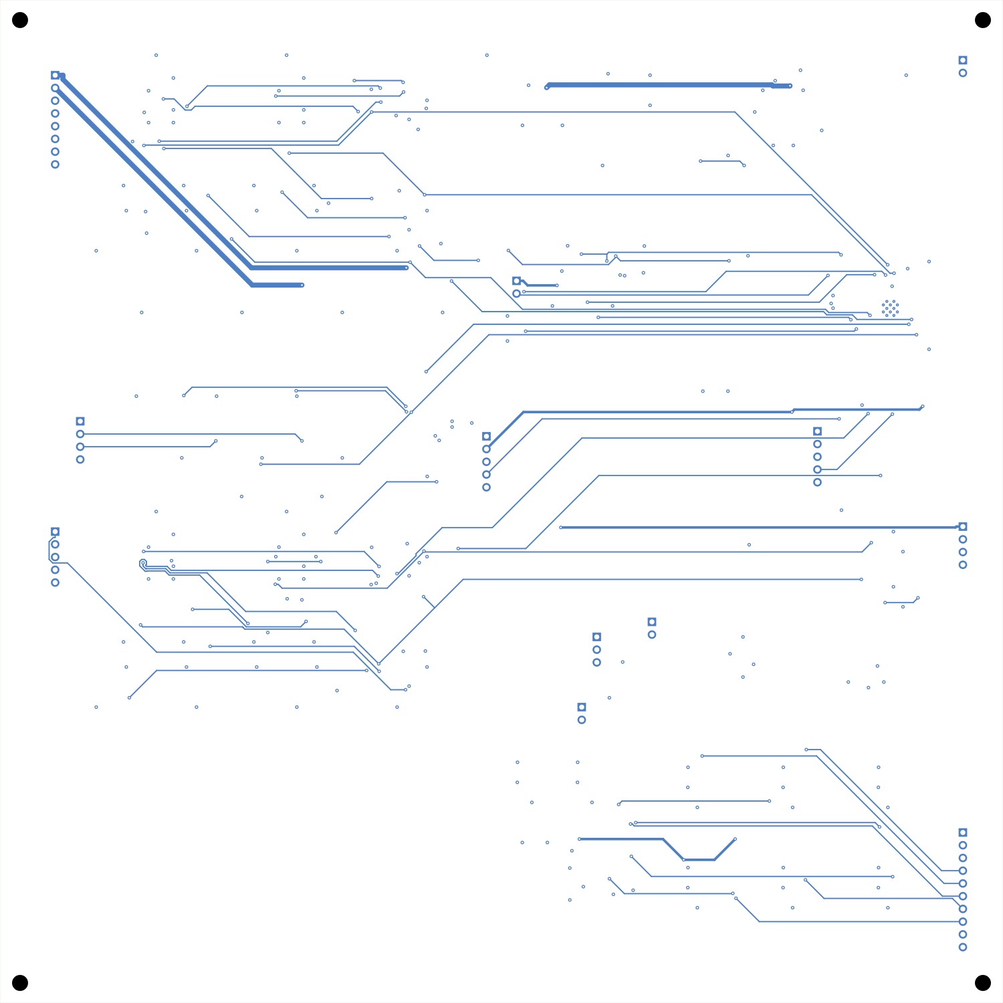
reports/pcb-bottom.png
