markthebault/esp32-ecu/reports/pcb-top.png

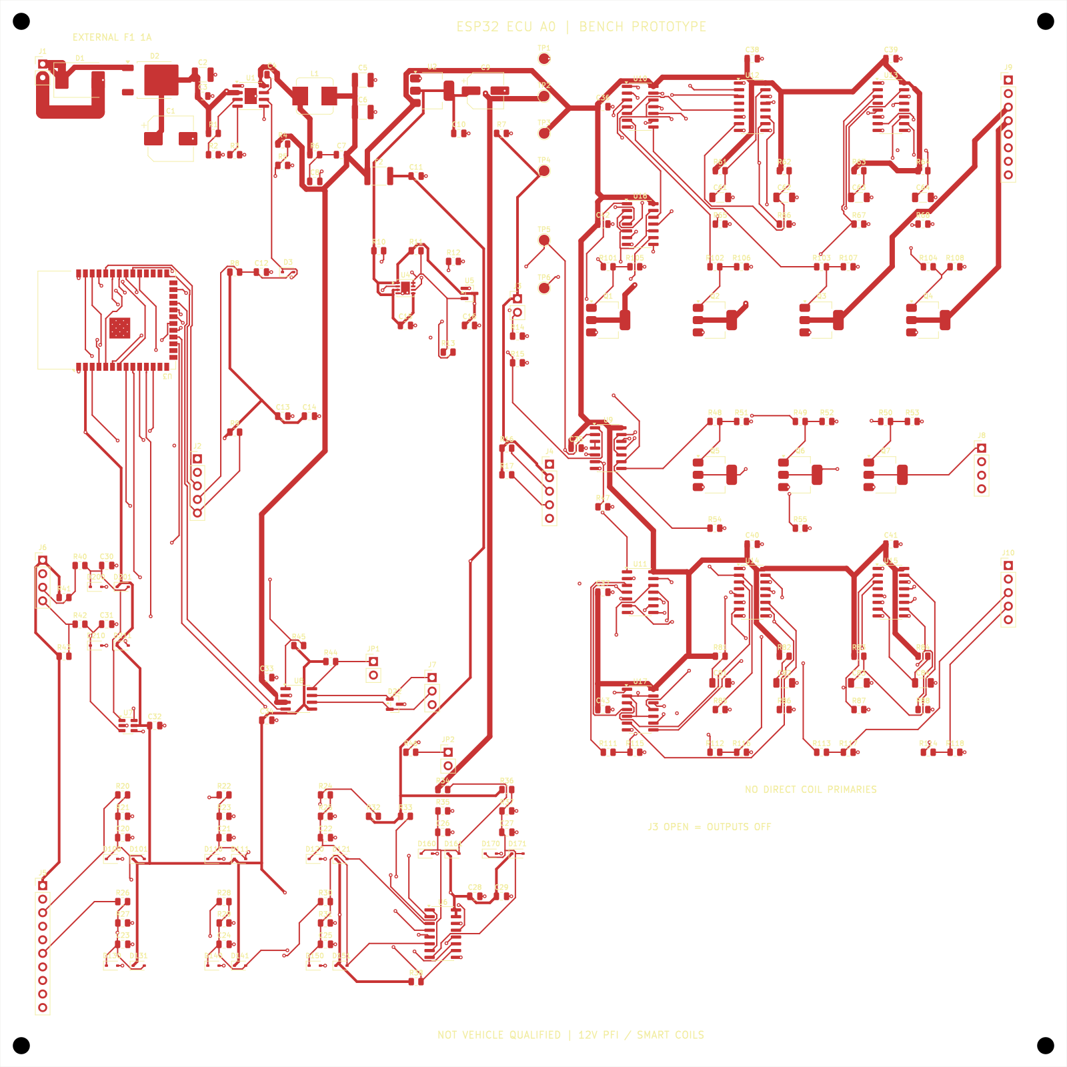
reports/pcb-top.png
