markthebault/esp32-ecu/reports/web/diagnostics.png

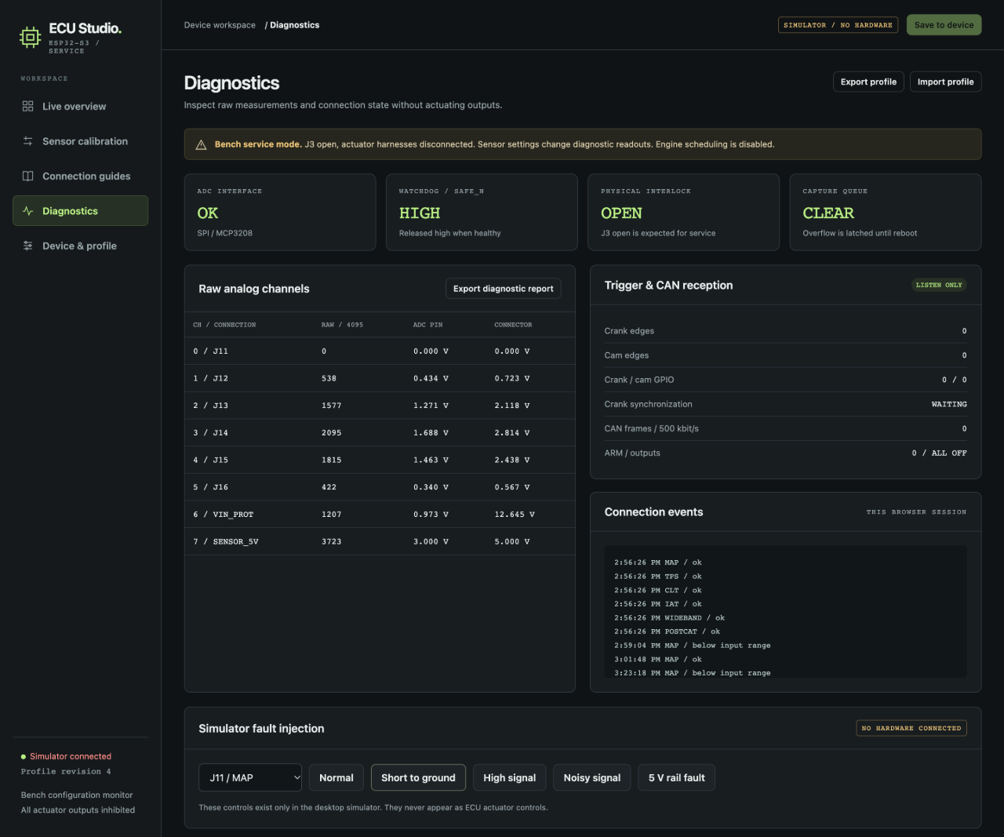
reports/web/diagnostics.png
