markthebault/esp32-ecu/reports/web/mobile.png

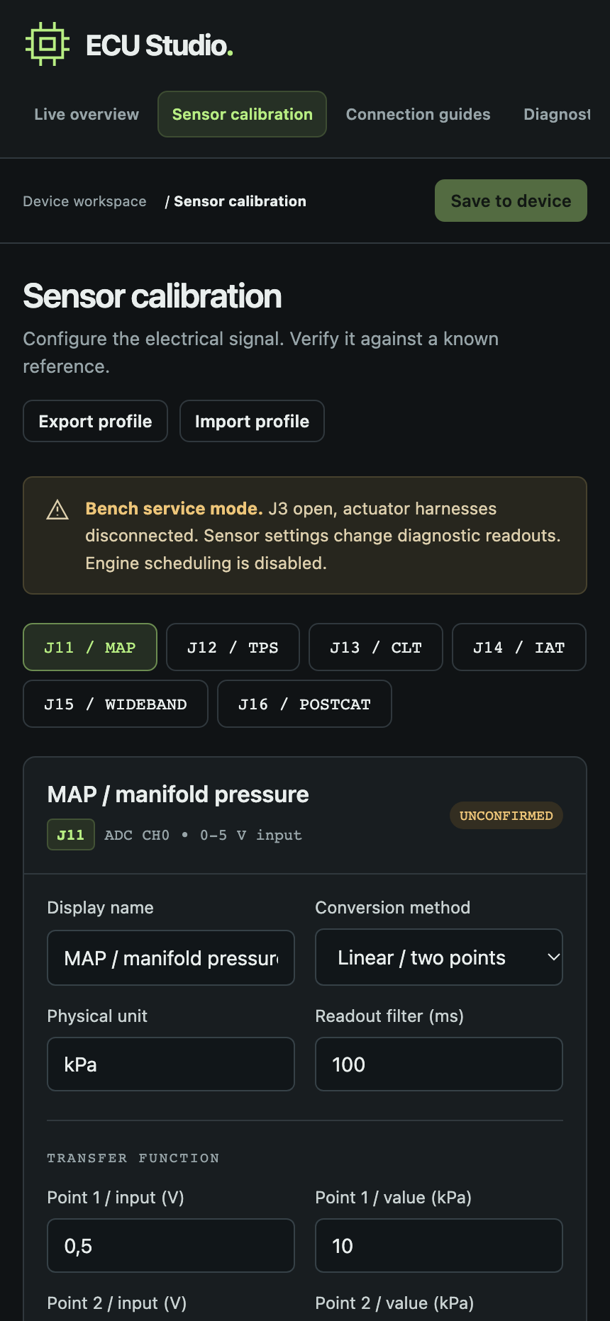
reports/web/mobile.png
