markthebault/esp32-ecu/reports/web/paired-screens-simulator.png

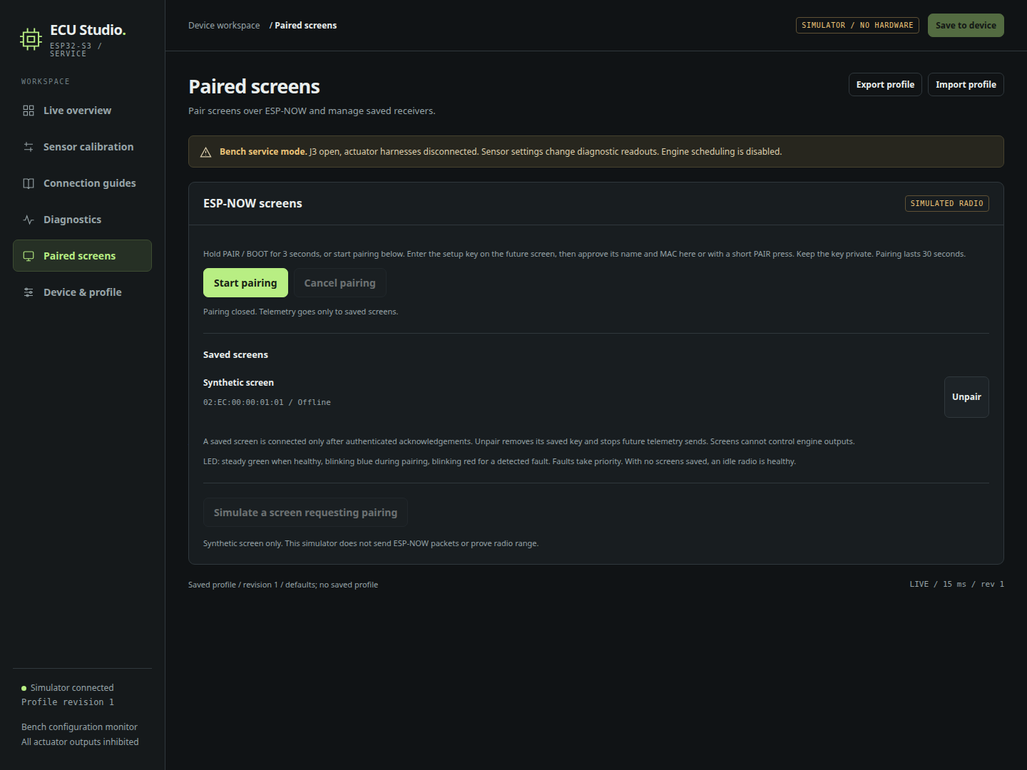
reports/web/paired-screens-simulator.png
