markthebault/esp32-ecu/hardware/bom.csv

Reference | Value | MPN | Footprint | DNP | Design_note
J1 | FUSED_KEY_12V |  | ECU:PinHeader_1x02_P2.54mm_Vertical | False | External 1 A fuse at source. Bench header, not a sealed vehicle connector.
D1 | SMCJ24CA | SMCJ24CA-E3/57T | ECU:D_SMC | False | Bidirectional TVS. 24 V standoff; 38.9 V specified pulse clamp, not load-dump qualification.
D2 | STPS5H100BY | STPS5H100BY | ECU:TO-252-2 | False | 100 V series reverse-polarity blocking diode; check forward loss and pulse stress.
C1 | 47u 63V |  | ECU:CP_Elec_8x10 | False | Electrolytic, exact series must be qualified.
C2 | 2.2u 100V X7R |  | ECU:C_1210_3225Metric | False
C3 | 100n 100V |  | ECU:C_0805_2012Metric | False
U1 | LM5164QDDARQ1 | LM5164QDDARQ1 | ECU:SOIC-8-1EP_3.9x4.9mm_P1.27mm_EP2.29x3mm | False
R1 | 316k 1% |  | ECU:R_0805_2012Metric | False
R2 | 100k 1% |  | ECU:R_0805_2012Metric | False
R3 | 41.2k 1% |  | ECU:R_0805_2012Metric | False
C4 | 2.2n 50V C0G |  | ECU:C_0805_2012Metric | False
L1 | 33uH 2.5A Isat | SRP7028A-330M | ECU:L_Bourns_SRP7028A_7.3x6.6mm | False | 2.5 A saturation and 2 A RMS ratings at stated vendor test conditions. Verify derating at temperature.
C5 | 22u 16V X7R |  | ECU:C_1210_3225Metric | False
C6 | 22u 16V X7R |  | ECU:C_1210_3225Metric | False
R4 | 316k 1% |  | ECU:R_0805_2012Metric | False
R5 | 100k 1% |  | ECU:R_0805_2012Metric | False
R6 | 100k 1% |  | ECU:R_0805_2012Metric | False
C7 | 3.3n C0G |  | ECU:C_0805_2012Metric | False
C8 | 100p C0G |  | ECU:C_0805_2012Metric | False
U2 | NCV1117ST33T3G | NCV1117ST33T3G | ECU:SOT-223-3_TabPin2 | False | Thermal budget <=200 mA continuous pending measurement. Requires output ESR review.
C9 | 22u 10V ESR 0.3-1R |  | ECU:CP_Elec_6.3x5.8 | False | Select exact electrolytic series to satisfy LDO stability over temperature.
C10 | 100n |  | ECU:C_0805_2012Metric | False
R7 | 100R 0.25W |  | ECU:R_0805_2012Metric | False | 33 mA rail bleed provides a sink for fault clamp current. Must validate unpowered injection.
F2 | PTC 100mA | MF-MSMF010-2 | ECU:Fuse_1812_4532Metric | False | Resettable fuse, slow thermal response; no precision current limit.
C11 | 1u |  | ECU:C_0805_2012Metric | False
U3 | ESP32-S3-WROOM-1-N8 | ESP32-S3-WROOM-1-N8 | ECU:ESP32-S3-WROOM-1 | False | Industrial radio module, no automotive or functional safety qualification. Antenna faces left board edge.
R8 | 10k |  | ECU:R_0805_2012Metric | False
C12 | 1u |  | ECU:C_0805_2012Metric | False
D3 | BAT54WS | BAT54WS-7-F | ECU:D_SOD-323 | False | SAFE_N low discharges EN without EN capacitor delaying hardware inhibit.
C13 | 10u |  | ECU:C_0805_2012Metric | False
C14 | 100n |  | ECU:C_0805_2012Metric | False
R9 | 10k |  | ECU:R_0805_2012Metric | False
J2 | UART_FLASH_3V3_ONLY |  | ECU:PinHeader_1x05_P2.54mm_Vertical | False | External USB UART, 3.3 V logic. Supply board via J1; no USB backfeed.
U4 | TPS3431SDRBRQ1 | TPS3431SDRBRQ1 | ECU:VSON-8-1EP_3x3mm_P0.65mm_EP1.65x2.4mm | False | 1.6 s nominal watchdog with CWD floating. ENOUT and WDO wired AND. Pulse limiters provide shorter actuator ceilings.
R10 | 10k OPTIONAL 200ms |  | ECU:R_0805_2012Metric | True | DNP for 1.6 s boot allowance. Populate only after worst-case boot timing is measured.
R11 | 10k |  | ECU:R_0805_2012Metric | False
R12 | 100k |  | ECU:R_0805_2012Metric | False
C15 | 100n |  | ECU:C_0805_2012Metric | False
U5 | TLV803EA30DBZR | TLV803EA30DBZR | ECU:SOT-23 | False
C16 | 100n |  | ECU:C_0805_2012Metric | False
R13 | 1k |  | ECU:R_0805_2012Metric | False
J3 | NORMALLY_OPEN_INTERLOCK |  | ECU:PinHeader_1x02_P2.54mm_Vertical | False | Fit only on supervised dummy-load bench. Open contact forces output inhibit independent of MCU.
R14 | 10k |  | ECU:R_0805_2012Metric | False
R15 | 10k |  | ECU:R_0805_2012Metric | False
J4 | EXPANSION_3V3 |  | ECU:PinHeader_1x05_P2.54mm_Vertical | False
R16 | 4.7k |  | ECU:R_0805_2012Metric | False
R17 | 4.7k |  | ECU:R_0805_2012Metric | False
J5 | SENSOR_LOOM |  | ECU:PinHeader_1x10_P2.54mm_Vertical | False
R20 | 22k 1% |  | ECU:R_0805_2012Metric | False
R21 | 33k 1% |  | ECU:R_0805_2012Metric | False
C20 | 10n |  | ECU:C_0805_2012Metric | False
D100 | BAT54WS | BAT54WS-7-F | ECU:D_SOD-323 | False
D101 | BAT54WS | BAT54WS-7-F | ECU:D_SOD-323 | False
R22 | 22k 1% |  | ECU:R_0805_2012Metric | False
R23 | 33k 1% |  | ECU:R_0805_2012Metric | False
C21 | 10n |  | ECU:C_0805_2012Metric | False
D110 | BAT54WS | BAT54WS-7-F | ECU:D_SOD-323 | False
D111 | BAT54WS | BAT54WS-7-F | ECU:D_SOD-323 | False
R24 | 22k 1% |  | ECU:R_0805_2012Metric | False
R25 | 33k 1% |  | ECU:R_0805_2012Metric | False
C22 | 10n |  | ECU:C_0805_2012Metric | False
D120 | BAT54WS | BAT54WS-7-F | ECU:D_SOD-323 | False
D121 | BAT54WS | BAT54WS-7-F | ECU:D_SOD-323 | False
R26 | 22k 1% |  | ECU:R_0805_2012Metric | False
R27 | 33k 1% |  | ECU:R_0805_2012Metric | False
C23 | 10n |  | ECU:C_0805_2012Metric | False
D130 | BAT54WS | BAT54WS-7-F | ECU:D_SOD-323 | False
D131 | BAT54WS | BAT54WS-7-F | ECU:D_SOD-323 | False
R28 | 22k 1% |  | ECU:R_0805_2012Metric | False
R29 | 33k 1% |  | ECU:R_0805_2012Metric | False
C24 | 10n |  | ECU:C_0805_2012Metric | False
D140 | BAT54WS | BAT54WS-7-F | ECU:D_SOD-323 | False
D141 | BAT54WS | BAT54WS-7-F | ECU:D_SOD-323 | False
R30 | 22k 1% |  | ECU:R_0805_2012Metric | False
R31 | 33k 1% |  | ECU:R_0805_2012Metric | False
C25 | 10n |  | ECU:C_0805_2012Metric | False
D150 | BAT54WS | BAT54WS-7-F | ECU:D_SOD-323 | False
D151 | BAT54WS | BAT54WS-7-F | ECU:D_SOD-323 | False
R32 | 2.49k 1% NTC |  | ECU:R_0805_2012Metric | True | Populate only for passive NTC sensor; transfer curve must match selected sensor.
R33 | 2.49k 1% NTC |  | ECU:R_0805_2012Metric | True | Populate only for passive NTC sensor; transfer curve must match selected sensor.
R34 | 120k 1% |  | ECU:R_0805_2012Metric | False
R35 | 10k 1% |  | ECU:R_0805_2012Metric | False
C26 | 10n |  | ECU:C_0805_2012Metric | False
D160 | BAT54WS | BAT54WS-7-F | ECU:D_SOD-323 | False
D161 | BAT54WS | BAT54WS-7-F | ECU:D_SOD-323 | False
R36 | 22k 1% |  | ECU:R_0805_2012Metric | False
R37 | 33k 1% |  | ECU:R_0805_2012Metric | False
C27 | 10n |  | ECU:C_0805_2012Metric | False
D170 | BAT54WS | BAT54WS-7-F | ECU:D_SOD-323 | False
D171 | BAT54WS | BAT54WS-7-F | ECU:D_SOD-323 | False
U6 | MCP3208-CI/SL | MCP3208-CI/SL | ECU:SOIC-16_3.9x9.9mm_P1.27mm | False
C28 | 100n |  | ECU:C_0805_2012Metric | False
C29 | 1u |  | ECU:C_0805_2012Metric | False
R38 | 10k |  | ECU:R_0805_2012Metric | False
J6 | HALL_TRIGGERS |  | ECU:PinHeader_1x04_P2.54mm_Vertical | False
R40 | 33k |  | ECU:R_0805_2012Metric | False
C30 | 100p C0G |  | ECU:C_0805_2012Metric | False
D200 | BAT54WS | BAT54WS-7-F | ECU:D_SOD-323 | False
D201 | BAT54WS | BAT54WS-7-F | ECU:D_SOD-323 | False
R41 | 2.2k HALL PULLUP |  | ECU:R_0805_2012Metric | True
R42 | 33k |  | ECU:R_0805_2012Metric | False
C31 | 100p C0G |  | ECU:C_0805_2012Metric | False
D210 | BAT54WS | BAT54WS-7-F | ECU:D_SOD-323 | False
D211 | BAT54WS | BAT54WS-7-F | ECU:D_SOD-323 | False
R43 | 2.2k HALL PULLUP |  | ECU:R_0805_2012Metric | True
U7 | SN74LVC2G17DBVR | SN74LVC2G17DBVR | ECU:SOT-23-6 | False
C32 | 100n |  | ECU:C_0805_2012Metric | False
U8 | TCAN1051VDRQ1 | TCAN1051VDRQ1 | ECU:SOIC-8_3.9x4.9mm_P1.27mm | False
C33 | 100n |  | ECU:C_0805_2012Metric | False
C34 | 100n |  | ECU:C_0805_2012Metric | False
R44 | 10k |  | ECU:R_0805_2012Metric | False
R45 | 10k |  | ECU:R_0805_2012Metric | False
JP1 | CAN_TX_ENABLE_OPEN |  | ECU:PinHeader_1x02_P2.54mm_Vertical | False | Open by default. Silent hardware plus software listen-only.
J7 | CAN_BUS |  | ECU:PinHeader_1x03_P2.54mm_Vertical | False
D22 | PESD2CAN | PESD2CAN,215 | ECU:SOT-23 | False
R46 | 120R |  | ECU:R_0805_2012Metric | False
JP2 | CAN_TERMINATION_OPEN |  | ECU:PinHeader_1x02_P2.54mm_Vertical | False
U9 | 74HCT08D-Q100 | 74HCT08D-Q100,118 | ECU:SOIC-14_3.9x8.7mm_P1.27mm | False
C35 | 100n |  | ECU:C_0805_2012Metric | False
R47 | 10k |  | ECU:R_0805_2012Metric | False
R48 | 1k |  | ECU:R_0805_2012Metric | False
R51 | 10k |  | ECU:R_0805_2012Metric | False
Q5 | VNL5050N3TR-E | VNL5050N3TR-E | ECU:SOT-223-3_TabPin2 | False | External fused relay coil only, <=150 mA. External coil flyback diode required.
R54 | 10k |  | ECU:R_0805_2012Metric | False
R49 | 1k |  | ECU:R_0805_2012Metric | False
R52 | 10k |  | ECU:R_0805_2012Metric | False
Q6 | VNL5050N3TR-E | VNL5050N3TR-E | ECU:SOT-223-3_TabPin2 | False | External fused relay coil only, <=150 mA. External coil flyback diode required.
R55 | 10k |  | ECU:R_0805_2012Metric | False
R50 | 1k |  | ECU:R_0805_2012Metric | False
R53 | 10k |  | ECU:R_0805_2012Metric | False
Q7 | VNL5050N3TR-E | VNL5050N3TR-E | ECU:SOT-223-3_TabPin2 | False | External fused relay coil only, <=150 mA. External coil flyback diode required.
J8 | EXTERNAL_RELAYS |  | ECU:PinHeader_1x04_P2.54mm_Vertical | False
U10 | 74HCT08D-Q100 | 74HCT08D-Q100,118 | ECU:SOIC-14_3.9x8.7mm_P1.27mm | False
C36 | 100n |  | ECU:C_0805_2012Metric | False
U16 | 74HCT08D-Q100 | 74HCT08D-Q100,118 | ECU:SOIC-14_3.9x8.7mm_P1.27mm | False
C42 | 100n |  | ECU:C_0805_2012Metric | False
U12 | 74HCT221D | 74HCT221D,118 | ECU:SOIC-16_3.9x9.9mm_P1.27mm | False | Industrial part. Non-retriggerable. Pulse cutoff is an independent ceiling, not a qualified safety mechanism.
C38 | 100n |  | ECU:C_0805_2012Metric | False
R61 | 100k 1% |  | ECU:R_0805_2012Metric | False
C61 | 270n 5% FILM |  | ECU:C_1206_3216Metric | False
R65 | 10k |  | ECU:R_0805_2012Metric | False
R62 | 100k 1% |  | ECU:R_0805_2012Metric | False
C62 | 270n 5% FILM |  | ECU:C_1206_3216Metric | False
R66 | 10k |  | ECU:R_0805_2012Metric | False
U13 | 74HCT221D | 74HCT221D,118 | ECU:SOIC-16_3.9x9.9mm_P1.27mm | False | Industrial part. Non-retriggerable. Pulse cutoff is an independent ceiling, not a qualified safety mechanism.
C39 | 100n |  | ECU:C_0805_2012Metric | False
R63 | 100k 1% |  | ECU:R_0805_2012Metric | False
C63 | 270n 5% FILM |  | ECU:C_1206_3216Metric | False
R67 | 10k |  | ECU:R_0805_2012Metric | False
R64 | 100k 1% |  | ECU:R_0805_2012Metric | False
C64 | 270n 5% FILM |  | ECU:C_1206_3216Metric | False
R68 | 10k |  | ECU:R_0805_2012Metric | False
R101 | 1k |  | ECU:R_0805_2012Metric | False
R105 | 10k |  | ECU:R_0805_2012Metric | False
Q1 | VNL5050N3TR-E | VNL5050N3TR-E | ECU:SOT-223-3_TabPin2 | False | High impedance injector only. <=1.2 A/channel design target pending thermal and repetitive clamp tests.
R102 | 1k |  | ECU:R_0805_2012Metric | False
R106 | 10k |  | ECU:R_0805_2012Metric | False
Q2 | VNL5050N3TR-E | VNL5050N3TR-E | ECU:SOT-223-3_TabPin2 | False | High impedance injector only. <=1.2 A/channel design target pending thermal and repetitive clamp tests.
R103 | 1k |  | ECU:R_0805_2012Metric | False
R107 | 10k |  | ECU:R_0805_2012Metric | False
Q3 | VNL5050N3TR-E | VNL5050N3TR-E | ECU:SOT-223-3_TabPin2 | False | High impedance injector only. <=1.2 A/channel design target pending thermal and repetitive clamp tests.
R104 | 1k |  | ECU:R_0805_2012Metric | False
R108 | 10k |  | ECU:R_0805_2012Metric | False
Q4 | VNL5050N3TR-E | VNL5050N3TR-E | ECU:SOT-223-3_TabPin2 | False | High impedance injector only. <=1.2 A/channel design target pending thermal and repetitive clamp tests.
J9 | INJECTOR_LOW_SIDES |  | ECU:PinHeader_1x08_P2.54mm_Vertical | False | External fused, relay-switched actuator 12V. Header is bench-only.
U11 | 74HCT08D-Q100 | 74HCT08D-Q100,118 | ECU:SOIC-14_3.9x8.7mm_P1.27mm | False
C37 | 100n |  | ECU:C_0805_2012Metric | False
U17 | 74HCT08D-Q100 | 74HCT08D-Q100,118 | ECU:SOIC-14_3.9x8.7mm_P1.27mm | False
C43 | 100n |  | ECU:C_0805_2012Metric | False
U14 | 74HCT221D | 74HCT221D,118 | ECU:SOIC-16_3.9x9.9mm_P1.27mm | False | Industrial part. Non-retriggerable. Pulse cutoff is an independent ceiling, not a qualified safety mechanism.
C40 | 100n |  | ECU:C_0805_2012Metric | False
R81 | 100k 1% |  | ECU:R_0805_2012Metric | False
C81 | 68n 5% C0G |  | ECU:C_1206_3216Metric | False
R85 | 10k |  | ECU:R_0805_2012Metric | False
R82 | 100k 1% |  | ECU:R_0805_2012Metric | False
C82 | 68n 5% C0G |  | ECU:C_1206_3216Metric | False
R86 | 10k |  | ECU:R_0805_2012Metric | False
U15 | 74HCT221D | 74HCT221D,118 | ECU:SOIC-16_3.9x9.9mm_P1.27mm | False | Industrial part. Non-retriggerable. Pulse cutoff is an independent ceiling, not a qualified safety mechanism.
C41 | 100n |  | ECU:C_0805_2012Metric | False
R83 | 100k 1% |  | ECU:R_0805_2012Metric | False
C83 | 68n 5% C0G |  | ECU:C_1206_3216Metric | False
R87 | 10k |  | ECU:R_0805_2012Metric | False
R84 | 100k 1% |  | ECU:R_0805_2012Metric | False
C84 | 68n 5% C0G |  | ECU:C_1206_3216Metric | False
R88 | 10k |  | ECU:R_0805_2012Metric | False
R111 | 220R |  | ECU:R_0805_2012Metric | False
R115 | 10k |  | ECU:R_0805_2012Metric | False
R112 | 220R |  | ECU:R_0805_2012Metric | False
R116 | 10k |  | ECU:R_0805_2012Metric | False
R113 | 220R |  | ECU:R_0805_2012Metric | False
R117 | 10k |  | ECU:R_0805_2012Metric | False
R114 | 220R |  | ECU:R_0805_2012Metric | False
R118 | 10k |  | ECU:R_0805_2012Metric | False
J10 | SMART_COIL_5V_LOGIC |  | ECU:PinHeader_1x05_P2.54mm_Vertical | False | External fused, relay-switched actuator 12V. Header is bench-only.
TP1 | GND |  | ECU:TestPoint_Pad_D2.0mm | False
TP2 | VIN_PROT |  | ECU:TestPoint_Pad_D2.0mm | False
TP3 | +5V |  | ECU:TestPoint_Pad_D2.0mm | False
TP4 | +3V3 |  | ECU:TestPoint_Pad_D2.0mm | False
TP5 | SAFE_N |  | ECU:TestPoint_Pad_D2.0mm | False
TP6 | RUN_5V |  | ECU:TestPoint_Pad_D2.0mm | False
H1 | M3 NPTH |  | ECU:MountingHole_3.2mm_M3 | False
H2 | M3 NPTH |  | ECU:MountingHole_3.2mm_M3 | False
H3 | M3 NPTH |  | ECU:MountingHole_3.2mm_M3 | False
H4 | M3 NPTH |  | ECU:MountingHole_3.2mm_M3 | False
