markthebault/esp32-ecu/hardware/a6-flex-rgb/bom-shopping.csv

Section | Quantity | Optional quantity | Item | MPN / specification | References / use | Package / fit | Selection status | Notes
PCB | 1 | 0 | 1.5KE27CA | 1.5KE27CA | D1 | Diode_THT:D_DO-201AD_P5.08mm_Vertical_AnodeUp | Candidate MPN; fit/rating/stock unqualified | Axial bidirectional TVS; 23.1V standoff and specified 37.5V pulse clamp. No load-dump qualification claim.
PCB | 1 | 0 | 100000R 1% 0.4W | MRS16000C1003FCT00 | R161 | ECU:R_Axial_DIN0204_L3.6mm_D1.6mm_P2.54mm_Vertical | Candidate MPN; fit/rating/stock unqualified | Compact ordinary leaded MRS16 candidate. Conditional branch dissipation, TCR, pulse/temperature and upright lead-form acceptance remain required. A6 conditional development draft, no fabrication/physical qualification. Candidate MRS16 order code; availability, TCR/derating, formed body and thermal acceptance pending.
PCB | 4 | 0 | 100000R 1% 0.6W | MRS25000C1003FCT00 | R168, R170, R172, R178 | ECU:R_Axial_DIN0207_L6.3mm_D2.5mm_P2.54mm_Vertical | Candidate MPN; fit/rating/stock unqualified | A6 conditional development draft, no fabrication/physical qualification. Candidate MRS25 order code; availability, TCR/derating, formed body and thermal acceptance pending.
PCB | 1 | 0 | 100R 0.25W | Select exact part | R7 | Resistor_THT:R_Axial_DIN0207_L6.3mm_D2.5mm_P2.54mm_Vertical | Exact part selection required | 33 mA rail bleed provides a sink for fault clamp current. Must validate unpowered injection.
PCB | 2 | 0 | 100R 1% 0.6W | MRS25000C1000FCT00 | R176, R177 | ECU:R_Axial_DIN0207_L6.3mm_D2.5mm_P2.54mm_Vertical | Candidate MPN; fit/rating/stock unqualified | A6 conditional development draft, no fabrication/physical qualification. Candidate MRS25 order code; availability, TCR/derating, formed body and thermal acceptance pending.
PCB | 8 | 0 | 100k 1% | Select exact part | R61, R62, R63, R64, R81, R82, R83, R84 | Resistor_THT:R_Axial_DIN0207_L6.3mm_D2.5mm_P2.54mm_Vertical | Exact part selection required
PCB | 17 | 0 | 100n | Select exact part | C10, C14, C15, C16, C28, C32, C33, C34, C35, C36, C42, C38, C39, C37, C43, C40, C41 | Capacitor_THT:C_Disc_D5.0mm_W2.5mm_P5.00mm | Exact part selection required
PCB | 2 | 0 | 100n 100V | Select exact part | C3, C46 | Capacitor_THT:C_Disc_D5.0mm_W2.5mm_P5.00mm | Exact part selection required
PCB | 2 | 0 | 100nF 50V candidate | Select exact part | C161, C162 | ECU:C_Disc_D5.0mm_W2.5mm_P5.00mm | Exact part selection required | Leaded local bypass; exact capacitor and physical lead/body fit pending. A6 conditional development draft, no fabrication/physical qualification.
PCB | 2 | 0 | 100nF X7R 10% 50V | C315C104K5R5TA | C160, C164 | ECU:C_Radial_KEMET_C315_L3.81mm_W2.54mm_P2.54mm | Candidate MPN; fit/rating/stock unqualified | A6 conditional development draft, no fabrication/physical qualification. | Additional local bypass at remote R163 pullup. Existing modeled3V3 rail is an assumed source; this does not establish target supply transients, parasitics or physical stability. A6 conditional development draft, no fabrication/physical qualification.
PCB | 2 | 0 | 100p C0G | Select exact part | C30, C31 | Capacitor_THT:C_Disc_D5.0mm_W2.5mm_P5.00mm | Exact part selection required
PCB | 2 | 0 | 100p C0G 100V | Select exact part | C156, C157 | Capacitor_THT:C_Disc_D5.0mm_W2.5mm_P5.00mm | Exact part selection required | Cable-entry RF shunt to shield, before series input resistor. Validate edge delay and fault stress.
PCB | 31 | 0 | 10k | Select exact part | R8, R9, R11, R12, R14, R15, R38, R44, R45, R47, R51, R54, R52, R55, R53, R65, R66, R67, R68, R105, R106, R107, R108, R85, R86, R87, R88, R115, R116, R117, R118 | Resistor_THT:R_Axial_DIN0207_L6.3mm_D2.5mm_P2.54mm_Vertical | Exact part selection required
PCB | 1 | 0 | 10k 1% | Select exact part | R35 | Resistor_THT:R_Axial_DIN0207_L6.3mm_D2.5mm_P2.54mm_Vertical | Exact part selection required
PCB | 8 | 0 | 10n | Select exact part | C20, C21, C22, C23, C24, C25, C26, C27 | Capacitor_THT:C_Disc_D5.0mm_W2.5mm_P5.00mm | Exact part selection required
PCB | 1 | 0 | 10nF C0G 5% 50V | C315C103J5G5TA | C159 | ECU:C_Radial_KEMET_C315_L3.81mm_W2.54mm_P2.54mm | Candidate MPN; fit/rating/stock unqualified | A6 conditional development draft, no fabrication/physical qualification.
PCB | 1 | 0 | 10u | Select exact part | C13 | Capacitor_THT:CP_Radial_D8.0mm_P3.50mm | Exact part selection required
PCB | 1 | 0 | 10uF 16V radial candidate | Select exact part | C163 | ECU:CP_Radial_D8.0mm_P3.50mm | Exact part selection required | Local radial bulk D8/P3.5 candidate; exact leakage/ESR/temperature and lead fit pending. A6 conditional development draft, no fabrication/physical qualification.
PCB | 1 | 0 | 120R | Select exact part | R46 | Resistor_THT:R_Axial_DIN0207_L6.3mm_D2.5mm_P2.54mm_Vertical | Exact part selection required
PCB | 1 | 0 | 120k 1% | Select exact part | R34 | Resistor_THT:R_Axial_DIN0207_L6.3mm_D2.5mm_P2.54mm_Vertical | Exact part selection required
PCB | 1 | 0 | 1M | Select exact part | R151 | Resistor_THT:R_Axial_DIN0207_L6.3mm_D2.5mm_P2.54mm_Vertical | Exact part selection required | Static bleed, not a protective earth bond.
PCB | 2 | 0 | 1N4148-TAP | 1N4148-TAP | D212, D213 | ECU:D_DO-35_SOD27_P3.81mm_Vertical_AnodeUp | Candidate MPN; fit/rating/stock unqualified | Anode supply, cathode bias. Blocks positive signal fault from directly feeding sensor rail; not a general power-sequence guarantee. A6 conditional development draft, no fabrication/physical qualification. | Low-leakage clamp upstream of final divider resistor. Conditional cold Vf and hot leakage bounds must be checked; no full-temperature physical rating inferred. A6 conditional development draft, no fabrication/physical qualification.
PCB | 1 | 0 | 1R 0.5W damping | Select exact part | R150 | Resistor_THT:R_Axial_DIN0207_L6.3mm_D2.5mm_P10.16mm_Horizontal | Exact part selection required | Series RC damping branch across converter input; verify input impedance/load-step stability.
PCB | 8 | 0 | 1k | Select exact part | R13, R48, R49, R50, R101, R102, R103, R104 | Resistor_THT:R_Axial_DIN0207_L6.3mm_D2.5mm_P2.54mm_Vertical | Exact part selection required
PCB | 6 | 0 | 1n C0G 100V | Select exact part | C150, C151, C152, C153, C154, C155 | Capacitor_THT:C_Disc_D5.0mm_W2.5mm_P5.00mm | Exact part selection required | Cable-entry RF shunt to shield, before series input resistor. Validate edge delay and fault stress.
PCB | 3 | 0 | 1u | Select exact part | C11, C12, C29 | Capacitor_THT:C_Rect_L7.2mm_W5.0mm_P5.00mm | Exact part selection required
PCB | 0 | 2 | 2.2k HALL PULLUP | Select exact part | R41, R43 | Resistor_THT:R_Axial_DIN0207_L6.3mm_D2.5mm_P2.54mm_Vertical | DNP
PCB | 0 | 2 | 2.49k 1% NTC | Select exact part | R32, R33 | Resistor_THT:R_Axial_DIN0207_L6.3mm_D2.5mm_P2.54mm_Vertical | DNP | Populate only for passive NTC sensor; transfer curve must match selected sensor.
PCB | 1 | 0 | 2200R 1% 0.4W | MRS16000C2201FCT00 | R163 | ECU:R_Axial_DIN0204_L3.6mm_D1.6mm_P2.54mm_Vertical | Candidate MPN; fit/rating/stock unqualified | Compact ordinary leaded MRS16 candidate. Conditional branch dissipation, TCR, pulse/temperature and upright lead-form acceptance remain required. A6 conditional development draft, no fabrication/physical qualification. Candidate MRS16 order code; availability, TCR/derating, formed body and thermal acceptance pending.
PCB | 3 | 0 | 2200R 1% 0.6W | MRS25000C2201FCT00 | R167, R169, R171 | ECU:R_Axial_DIN0207_L6.3mm_D2.5mm_P2.54mm_Vertical | Candidate MPN; fit/rating/stock unqualified | A6 conditional development draft, no fabrication/physical qualification. Candidate MRS25 order code; availability, TCR/derating, formed body and thermal acceptance pending.
PCB | 4 | 0 | 220R | Select exact part | R111, R112, R113, R114 | Resistor_THT:R_Axial_DIN0207_L6.3mm_D2.5mm_P2.54mm_Vertical | Exact part selection required
PCB | 7 | 0 | 22k 1% | Select exact part | R20, R22, R24, R26, R28, R30, R36 | Resistor_THT:R_Axial_DIN0207_L6.3mm_D2.5mm_P2.54mm_Vertical | Exact part selection required
PCB | 1 | 0 | 22u 10V ESR 0.3-1R | Select exact part | C9 | ECU:CP_Radial_D8.0mm_P3.50mm_A6_C9 | Exact part selection required | Select exact electrolytic series to satisfy LDO stability over temperature.
PCB | 2 | 0 | 22u 16V electrolytic | Select exact part | C5, C6 | Capacitor_THT:CP_Radial_D8.0mm_P3.50mm | Exact part selection required | Radial electrolytic on the 5V rail; select exact series and verify rail stability/ripple over temperature.
PCB | 1 | 0 | 24900R 1% 0.4W | MRS16000C2492FCT00 | R158 | ECU:R_Axial_DIN0204_L3.6mm_D1.6mm_P2.54mm_Vertical | Candidate MPN; fit/rating/stock unqualified | Compact ordinary leaded MRS16 candidate. Conditional branch dissipation, TCR, pulse/temperature and upright lead-form acceptance remain required. A6 conditional development draft, no fabrication/physical qualification. Candidate MRS16 order code; availability, TCR/derating, formed body and thermal acceptance pending.
PCB | 4 | 0 | 270n 5% FILM | Select exact part | C61, C62, C63, C64 | Capacitor_THT:C_Rect_L7.2mm_W5.0mm_P5.00mm | Exact part selection required
PCB | 1 | 0 | 27400R 1% 0.4W | MRS16000C2742FCT00 | R157 | ECU:R_Axial_DIN0204_L3.6mm_D1.6mm_P2.54mm_Vertical | Candidate MPN; fit/rating/stock unqualified | Compact ordinary leaded MRS16 candidate. Conditional branch dissipation, TCR, pulse/temperature and upright lead-form acceptance remain required. A6 conditional development draft, no fabrication/physical qualification. Candidate MRS16 order code; availability, TCR/derating, formed body and thermal acceptance pending.
PCB | 3 | 0 | 2N3904BU | 2N3904BU | Q8, Q9, Q10 | ECU:TO-92_Inline_Wide | Candidate MPN; fit/rating/stock unqualified | onsemi E-B-C bondout, manually formed leads. Active-high base drive sinks LED cathode. Saturation/leakage/current/temperature and assembly need measurement. A6 conditional development draft, no fabrication/physical qualification.
PCB | 1 | 0 | 2k2 1% | Select exact part | R154 | ECU:R_Axial_DIN0207_L6.3mm_D2.5mm_P2.54mm_Vertical | Exact part selection required | Permanent carrier-side GPIO3 bias, retained when idle harness is unplugged. Exact leaded part and actual strap/eFuse behavior require acceptance.
PCB | 1 | 0 | 330000R 1% 0.4W | MRS16000C3303FCT00 | R160 | ECU:R_Axial_DIN0204_L3.6mm_D1.6mm_P2.54mm_Vertical | Candidate MPN; fit/rating/stock unqualified | Compact ordinary leaded MRS16 candidate. Conditional branch dissipation, TCR, pulse/temperature and upright lead-form acceptance remain required. A6 conditional development draft, no fabrication/physical qualification. Candidate MRS16 order code; availability, TCR/derating, formed body and thermal acceptance pending.
PCB | 1 | 0 | 330R 1% 0.4W | MRS16000C3300FCT00 | R179 | ECU:R_Axial_DIN0204_L3.6mm_D1.6mm_P2.54mm_Vertical | Candidate MPN; fit/rating/stock unqualified | Common-anode supply series resistor. Prevents an anode/cathode harness-to-ground fault from bypassing every current-limiting resistor. At5.25V and-1%R, zero-drop upper bound16.07mA and0.0844W. Bounds require stated rail/resistance and do not qualify temperature, surge, faults to external supplies, brightness or assembled heat. A6 conditional development draft, no fabrication/physical qualification. Candidate MRS16 order code; availability, TCR/derating, formed body and thermal acceptance pending. Use the declared mounting side and footprint; physical forming, heat and fit acceptance pending.
PCB | 2 | 0 | 33k | Select exact part | R40, R42 | Resistor_THT:R_Axial_DIN0207_L6.3mm_D2.5mm_P2.54mm_Vertical | Exact part selection required
PCB | 7 | 0 | 33k 1% | Select exact part | R21, R23, R25, R27, R29, R31, R37 | Resistor_THT:R_Axial_DIN0207_L6.3mm_D2.5mm_P2.54mm_Vertical | Exact part selection required
PCB | 2 | 0 | 4.7k | Select exact part | R16, R17 | Resistor_THT:R_Axial_DIN0207_L6.3mm_D2.5mm_P2.54mm_Vertical | Exact part selection required
PCB | 1 | 0 | 4.7n 100V | Select exact part | C47 | Capacitor_THT:C_Disc_D5.0mm_W2.5mm_P5.00mm | Exact part selection required | RF coupling of shield and signal ground; not galvanic isolation.
PCB | 1 | 0 | 47000R 1% 0.4W | MRS16000C4702FCT00 | R165 | ECU:R_Axial_DIN0204_L3.6mm_D1.6mm_P2.54mm_Vertical | Candidate MPN; fit/rating/stock unqualified | Compact ordinary leaded MRS16 candidate. Conditional branch dissipation, TCR, pulse/temperature and upright lead-form acceptance remain required. A6 conditional development draft, no fabrication/physical qualification. Candidate MRS16 order code; availability, TCR/derating, formed body and thermal acceptance pending.
PCB | 1 | 0 | 4700R 1% 0.4W | MRS16000C4701FCT00 | R164 | ECU:R_Axial_DIN0204_L3.6mm_D1.6mm_P2.54mm_Vertical | Candidate MPN; fit/rating/stock unqualified | Compact ordinary leaded MRS16 candidate. Conditional branch dissipation, TCR, pulse/temperature and upright lead-form acceptance remain required. A6 conditional development draft, no fabrication/physical qualification. Candidate MRS16 order code; availability, TCR/derating, formed body and thermal acceptance pending.
PCB | 2 | 0 | 470R 1% 0.6W | MRS25000C4700FCT00 | R174, R175 | ECU:R_Axial_DIN0207_L6.3mm_D2.5mm_P2.54mm_Vertical | Candidate MPN; fit/rating/stock unqualified | A6 conditional development draft, no fabrication/physical qualification. Candidate MRS25 order code; availability, TCR/derating, formed body and thermal acceptance pending.
PCB | 2 | 0 | 47R | Select exact part | R152, R153 | Resistor_THT:R_Axial_DIN0207_L6.3mm_D2.5mm_P2.54mm_Vertical | Exact part selection required
PCB | 1 | 0 | 47pF C0G 5% 50V | C315C470J5G5TA | C158 | ECU:C_Radial_KEMET_C315_L3.81mm_W2.54mm_P2.54mm | Candidate MPN; fit/rating/stock unqualified | Filter is upstream of hysteresis summing node. Comparator input parasitic capacitance still requires stability review. A6 conditional development draft, no fabrication/physical qualification.
PCB | 3 | 0 | 47u 63V | Select exact part | C1, C2, C45 | Capacitor_THT:CP_Radial_D8.0mm_P3.50mm | Exact part selection required | Electrolytic, exact series must be qualified.
PCB | 1 | 0 | 47uH input filter | RLB0914-470KL | L2 | Inductor_THT:L_Radial_D10.0mm_P5.00mm_Fastron_07P | Candidate MPN; fit/rating/stock unqualified | Radial choke, 5mm pitch. 1.56A datasheet current; check derating. Not the converter switching inductor.
PCB | 2 | 0 | 4990R 1% 0.4W | MRS16000C4991FCT00 | R159, R162 | ECU:R_Axial_DIN0204_L3.6mm_D1.6mm_P2.54mm_Vertical | Candidate MPN; fit/rating/stock unqualified | Compact ordinary leaded MRS16 candidate. Conditional branch dissipation, TCR, pulse/temperature and upright lead-form acceptance remain required. A6 conditional development draft, no fabrication/physical qualification. Candidate MRS16 order code; availability, TCR/derating, formed body and thermal acceptance pending.
PCB | 1 | 0 | 680R 1% 0.6W | MRS25000C6800FCT00 | R173 | ECU:R_Axial_DIN0207_L6.3mm_D2.5mm_P2.54mm_Vertical | Candidate MPN; fit/rating/stock unqualified | A6 conditional development draft, no fabrication/physical qualification. Candidate MRS25 order code; availability, TCR/derating, formed body and thermal acceptance pending.
PCB | 4 | 0 | 68n 5% FILM | Select exact part | C81, C82, C83, C84 | Capacitor_THT:C_Rect_L7.2mm_W5.0mm_P5.00mm | Exact part selection required
PCB | 3 | 0 | 750R 1% 0.6W | MRS25000C7500FCT00 | R155, R156, R166 | ECU:R_Axial_DIN0207_L6.3mm_D2.5mm_P2.54mm_Vertical | Candidate MPN; fit/rating/stock unqualified | A6 conditional development draft, no fabrication/physical qualification. Candidate MRS25 order code; availability, TCR/derating, formed body and thermal acceptance pending. | Third series pullup resistor shares conditional sustained negative-fault dissipation; total2250R. Actual temperature/rating/assembly remains unqualified. A6 conditional development draft, no fabrication/physical qualification. Candidate MRS25 order code; availability, TCR/derating, formed body and thermal acceptance pending.
PCB | 20 | 0 | BAT85 | BAT85,113 | D3, D100, D101, D110, D111, D120, D130, D131, D140, D141, D150, D151, D160, D161, D170, D171, D200, D201, D210, D211 | Diode_THT:D_DO-35_SOD27_P3.81mm_Vertical_AnodeUp | Candidate MPN; fit/rating/stock unqualified | Axial Schottky mounted vertically. Validate input clamp voltage/leakage at temperature.
PCB | 1 | 0 | BAT85 | BAT85,113 | D121 | ECU:D_DO-35_SOD27_P3.81mm_Vertical_AnodeUp_A6_D121 | Candidate MPN; fit/rating/stock unqualified | Axial Schottky mounted vertically. Validate input clamp voltage/leakage at temperature.
PCB | 1 | 0 | CAM | B3B-XH-A(LF)(SN) | J18 | Connector_JST:JST_XH_B3B-XH-A_1x03_P2.50mm_Vertical | Candidate MPN; fit/rating/stock unqualified | A3 internal locking connector; not sealed. See connector-pinout.csv
PCB | 1 | 0 | CAN_H_L_G_SHIELD | B4B-XH-A(LF)(SN) | J7 | Connector_JST:JST_XH_B4B-XH-A_1x04_P2.50mm_Vertical | Candidate MPN; fit/rating/stock unqualified | Polarized internal loom connector. Separate fused relay-switched actuator supply. See pinout.
PCB | 1 | 0 | CAN_TERMINATION_OPEN | Select exact part | JP2 | Connector_PinHeader_2.54mm:PinHeader_1x02_P2.54mm_Vertical | Exact part selection required
PCB | 1 | 0 | CAN_TX_ENABLE_OPEN | Select exact part | JP1 | Connector_PinHeader_2.54mm:PinHeader_1x02_P2.54mm_Vertical | Exact part selection required | Open by default. Silent hardware plus software listen-only.
PCB | 4 | 0 | CD74HCT221E | CD74HCT221E | U12, U13, U14, U15 | Package_DIP:DIP-16_W7.62mm_LongPads | Candidate MPN; fit/rating/stock unqualified | Industrial part. Non-retriggerable. Pulse cutoff is an independent ceiling, not a qualified safety mechanism.
PCB | 1 | 0 | CLT | B3B-XH-A(LF)(SN) | J13 | Connector_JST:JST_XH_B3B-XH-A_1x03_P2.50mm_Vertical | Candidate MPN; fit/rating/stock unqualified | A3 internal locking connector; not sealed. See connector-pinout.csv
PCB | 1 | 0 | CRANK | B3B-XH-A(LF)(SN) | J17 | Connector_JST:JST_XH_B3B-XH-A_1x03_P2.50mm_Vertical | Candidate MPN; fit/rating/stock unqualified | A3 internal locking connector; not sealed. See connector-pinout.csv
PCB | 1 | 0 | ESP32-S3 44-pin Type-C N16R8 | AliExpress 1005006418608267 / S3-N16R8 | U3 | ECU:ESP32_S3_DevKitC_1_socket | Candidate MPN; fit/rating/stock unqualified | User-selected 16MB flash / 8MB PSRAM. 44-pin order from saved supplier pinout. Socket row spacing 22.86mm PROVISIONAL. Inward antenna extension 10mm; module PCB underside +8.5mm above carrier top is an assumed socket stack. Internal RGB pin is disputed (47 pinout / 48 schematic). Use separate RGB LED on GPIO38, socket pad32; no engine pulses. Verify actual board fit and RF performance before fabrication/use. A5 adds GPIO3 idle service through J21 and permanent R154 bias; actual eFuse/JTAG routing and loaded output behavior remain unverified. A6 GPIO38 only receives protected flex candidate; oldGPIO38 RMT/LED builds incompatible. Use compact_n16r8_flex_dev only; engine outputs inhibited.
PCB | 1 | 0 | EXPANSION_3V3 | Select exact part | J4 | Connector_PinHeader_2.54mm:PinHeader_1x05_P2.54mm_Vertical | Exact part selection required
PCB | 1 | 0 | EXTERNAL_RELAYS | B4P-VH(LF)(SN) | J8 | Connector_JST:JST_VH_B4P-VH_1x04_P3.96mm_Vertical | Candidate MPN; fit/rating/stock unqualified | Polarized internal loom connector. Separate fused relay-switched actuator supply. See pinout.
PCB | 1 | 0 | FLEX 12V SENSOR | B3P-VH(LF)(SN) | J22 | ECU:JST_VH_B3P-VH_1x03_P3.96mm_Vertical | Candidate MPN; fit/rating/stock unqualified | VH3 keyed internal connector. Deliberately not XH3 sensor5V. Housing/crimp/gland and sensor-side mapping unqualified. A6 conditional development draft, no fabrication/physical qualification.
PCB | 1 | 0 | FUSED_KEY_12V | B2P-VH(LF)(SN) | J1 | Connector_JST:JST_VH_B2P-VH_1x02_P3.96mm_Vertical | Candidate MPN; fit/rating/stock unqualified | Polarized internal loom connector. Separate fused relay-switched actuator supply. See pinout.
PCB | 1 | 0 | IAT | B3B-XH-A(LF)(SN) | J14 | Connector_JST:JST_XH_B3B-XH-A_1x03_P2.50mm_Vertical | Candidate MPN; fit/rating/stock unqualified | A3 internal locking connector; not sealed. See connector-pinout.csv
PCB | 1 | 0 | INJECTOR_LOW_SIDES | B8P-VH(LF)(SN) | J9 | Connector_JST:JST_VH_B8P-VH_1x08_P3.96mm_Vertical | Candidate MPN; fit/rating/stock unqualified | Polarized internal loom connector. Separate fused relay-switched actuator supply. See pinout.
PCB | 1 | 0 | ISOLATED_IDLE_LOGIC | B4B-PH-K-S(LF)(SN) | J21 | ECU:JST_PH_B4B-PH-K_1x04_P2.00mm_Vertical | Candidate MPN; fit/rating/stock unqualified | PH4 carrier to XH4 IAC-DRAFT2 J1 harness, same1..4 order. Carrier5V feeds optical LED buffers, never actuator logic/coil. Harness/case access and source loading unqualified.
PCB | 1 | 0 | LAMBDA_WB | B3B-XH-A(LF)(SN) | J15 | Connector_JST:JST_XH_B3B-XH-A_1x03_P2.50mm_Vertical | Candidate MPN; fit/rating/stock unqualified | A3 internal locking connector; not sealed. See connector-pinout.csv
PCB | 1 | 0 | LD1117V33 | LD1117V33 | U2 | Package_TO_SOT_THT:TO-220-3_Vertical | Candidate MPN; fit/rating/stock unqualified | 3V3 regulator. 200mA continuous target pending thermal measurement. Use specified electrolytic ESR; no USB/carrier dual power.
PCB | 1 | 0 | LM2903P | LM2903P | U18 | ECU:DIP-8_W7.62mm_LongPads | Candidate MPN; fit/rating/stock unqualified | TI classic non-B PDIP8 direct solder, no socket. Common-mode and timing must use classic limits. Unused half has IN+ GND, IN- reference and OUT NC. B-version model cannot qualify this device. A6 conditional development draft, no fabrication/physical qualification.
PCB | 1 | 0 | MAP | B3B-XH-A(LF)(SN) | J11 | Connector_JST:JST_XH_B3B-XH-A_1x03_P2.50mm_Vertical | Candidate MPN; fit/rating/stock unqualified | A3 internal locking connector; not sealed. See connector-pinout.csv
PCB | 1 | 0 | MAX1232EPA+ | MAX1232EPA+ | U4 | Package_DIP:DIP-8_W7.62mm_LongPads | Candidate MPN; fit/rating/stock unqualified | 5V monitor and watchdog: TD=VCC, 500..2000ms watchdog (1.2s typical); reset active 250..1000ms. TTL ST accepts 3V3. Open-drain reset wired to 3V3 SAFE_N.
PCB | 1 | 0 | MCP120-315DI/TO | MCP120-315DI/TO | U5 | Package_TO_SOT_THT:TO-92_Inline_Wide | Candidate MPN; fit/rating/stock unqualified | D bondout TO-92: RESET, VDD, VSS. Different bondout suffixes are not drop-in.
PCB | 1 | 0 | MCP121-270E/TO | MCP121-270E/TO | U20 | ECU:TO-92_Inline_Wide | Candidate MPN; fit/rating/stock unqualified | Candidate open-drain TO92 supervisor with100k pullup. DS20001906E: trip2.564..2.696V over-40..125C;25C trip max2.670V plus25C hysteresis max0.158V gives2.828V release threshold before80..180ms delay under stated load. Combining full-temperature trip max with25C hysteresis gives only a conditional2.854V estimate. Full-temperature/loaded-reset release, leakage, deep brownout and ramps remain holds. This is not a3.0V brownout monitor. A6 conditional development draft, no fabrication/physical qualification.
PCB | 1 | 0 | MCP23008-E/P | MCP23008-E/P | U19 | ECU:DIP-18_W7.62mm_LongPads | Candidate MPN; fit/rating/stock unqualified | PDIP18 direct solder, no socket. Address0x21; GP0/1/2 drive red/green/blue; unused GP3..7 NC and software low outputs. GP7 output-only. Full IODIR0 and IOCON4 readback contract unchanged. A6 conditional development draft, no fabrication/physical qualification.
PCB | 1 | 0 | MCP2562-E/P | MCP2562-E/P | U8 | Package_DIP:DIP-8_W7.62mm_LongPads | Candidate MPN; fit/rating/stock unqualified | Standby by default. JP1 open; firmware listen-only. Not a silent normal-mode transceiver.
PCB | 1 | 0 | MCP3208-CI/P | MCP3208-CI/P | U6 | Package_DIP:DIP-16_W7.62mm_LongPads | Candidate MPN; fit/rating/stock unqualified
PCB | 1 | 0 | NORMALLY_OPEN_INTERLOCK | Select exact part | J3 | Connector_PinHeader_2.54mm:PinHeader_1x02_P2.54mm_Vertical | Exact part selection required | Fit only on supervised dummy-load bench. Open contact forces output inhibit independent of MCU.
PCB | 1 | 0 | ORDINARY RGB LED PH5 | B5B-PH-K-S(LF)(SN) | J23 | ECU:JST_PH_B5B-PH-K_1x05_P2.00mm_Vertical | Candidate MPN; fit/rating/stock unqualified | Unique PH5, four contacts only; position5NC no wire. Pin1 is supplied through common R179330R, in addition to the three cathode resistors. Differs from PH4 idle, XH4 switch and VH3 flex. Internal harness to ordinary common-anode LED; not a sealed connector/window qualification. A6 conditional development draft, no fabrication/physical qualification.
PCB | 2 | 0 | P6KE24CA | P6KE24CA | D22, D23 | Diode_THT:D_DO-15_P12.70mm_Horizontal | Candidate MPN; fit/rating/stock unqualified | Axial bidirectional CAN surge clamp; verify overshoot and capacitance on assembled bus.
PCB | 1 | 0 | POSTCAT_BUF | B3B-XH-A(LF)(SN) | J16 | Connector_JST:JST_XH_B3B-XH-A_1x03_P2.50mm_Vertical | Candidate MPN; fit/rating/stock unqualified | A3 internal locking connector; not sealed. See connector-pinout.csv
PCB | 1 | 0 | POWER_RETURN | B2P-VH(LF)(SN) | J19 | Connector_JST:JST_VH_B2P-VH_1x02_P3.96mm_Vertical | Candidate MPN; fit/rating/stock unqualified | Both pins are actuator return. Two adequately sized parallel wires to engine ground star; never use sensor wires for injector return.
PCB | 1 | 0 | PTC 100mA radial | MF-R010 | F2 | ECU:PTC_MF_R010 | Candidate MPN; fit/rating/stock unqualified | 100mA hold rating at datasheet ambient; thermal derating and slow trip, not an electronic current limiter.
PCB | 1 | 0 | PTC 100mA radial candidate | MF-R010 | F3 | ECU:PTC_MF_R010 | Candidate MPN; fit/rating/stock unqualified | Sensor current, derating, hold/trip and supply9..18V at sensor remain acceptance holds; existing VIN_PROT is not an18V regulator. A6 conditional development draft, no fabrication/physical qualification.
PCB | 1 | 0 | Pololu D36V6F5 | Pololu 3792 | U1 | ECU:Pololu_D36V6F5_vertical | Candidate MPN; fit/rating/stock unqualified | A3 hand-solder revision; see docs/compact.md
PCB | 1 | 0 | SB5100 | SB5100-B | D2 | Diode_THT:D_DO-201AD_P15.24mm_Horizontal | Candidate MPN; fit/rating/stock unqualified | 100 V series reverse-polarity blocking diode; check forward loss and pulse stress.
PCB | 1 | 0 | SHIELD_BOND PH2 | B2B-PH-K-S(LF)(SN) | J20 | ECU:JST_PH_B2B-PH-K_1x02_P2.00mm_Vertical | Candidate MPN; fit/rating/stock unqualified | Internal shield/lining bond only; no normal load current. Smaller keyed PH2 occupies the former VH2 courtyard. Housing PHR-2 with2 SPH-002T-P0.5S contacts replaces this connector's VH housing/contacts. H5 remains the designated chassis lug. Short strap, crimp, surge/RF/current/thermal and assembled fit remain unqualified. A6 conditional development draft, no fabrication/physical qualification.
PCB | 1 | 0 | SMART_COIL_5V_LOGIC | B5P-VH(LF)(SN) | J10 | Connector_JST:JST_VH_B5P-VH_1x05_P3.96mm_Vertical | Candidate MPN; fit/rating/stock unqualified | Polarized internal loom connector. Separate fused relay-switched actuator supply. See pinout.
PCB | 1 | 0 | SN74HC14N | SN74HC14N | U7 | Package_DIP:DIP-14_W7.62mm_LongPads | Candidate MPN; fit/rating/stock unqualified | A3 hand-solder revision; see docs/compact.md
PCB | 5 | 0 | SN74HCT08N | SN74HCT08N | U9, U10, U16, U11, U17 | Package_DIP:DIP-14_W7.62mm_LongPads | Candidate MPN; fit/rating/stock unqualified
PCB | 1 | 0 | TPS | B3B-XH-A(LF)(SN) | J12 | Connector_JST:JST_XH_B3B-XH-A_1x03_P2.50mm_Vertical | Candidate MPN; fit/rating/stock unqualified | A3 internal locking connector; not sealed. See connector-pinout.csv
PCB | 1 | 0 | UART_FLASH_3V3_ONLY | Select exact part | J2 | Connector_PinHeader_2.54mm:PinHeader_1x05_P2.54mm_Vertical | Exact part selection required | External USB UART, 3.3 V logic. Supply board via J1; no USB backfeed.
PCB | 7 | 0 | VNP35N07-E | VNP35N07-E | Q5, Q6, Q7, Q1, Q2, Q3, Q4 | Package_TO_SOT_THT:TO-220-3_Vertical | Candidate MPN; fit/rating/stock unqualified | Protected low-side TO-220, INPUT / DRAIN / SOURCE. Tab is live drain. External branch fuses required; current/thermal/clamp targets need tests.
Ancillary | 2 | 0 | ESP32 female socket strip | 1x22 2.54mm | U3 | Fit and procurement pending | Development candidate | 22.86mm row spacing and elevated inward antenna geometry unverified; no DIP sockets
Ancillary | 3 | 0 | Mating housing | 2.54mm service header | J2, J3, J4 | Fit and procurement pending | Development candidate | Internal connector; no sealed external connector rating. Service headers require matching plugs.
Ancillary | 1 | 0 | Mating housing | PHR-2 | J20 | Fit and procurement pending | Development candidate | Internal connector; no sealed external connector rating. Service headers require matching plugs.
Ancillary | 1 | 0 | Mating housing | PHR-4 | J21 | Fit and procurement pending | Development candidate | Internal connector; no sealed external connector rating. Service headers require matching plugs.
Ancillary | 1 | 0 | Mating housing | PHR-5 | J23 | Fit and procurement pending | Development candidate | Internal connector; no sealed external connector rating. Service headers require matching plugs.
Ancillary | 2 | 0 | Mating housing | VHR-2N | J1, J19 | Fit and procurement pending | Development candidate | Internal connector; no sealed external connector rating. Service headers require matching plugs.
Ancillary | 1 | 0 | Mating housing | VHR-3N | J22 | Fit and procurement pending | Development candidate | Internal connector; no sealed external connector rating. Service headers require matching plugs.
Ancillary | 1 | 0 | Mating housing | VHR-4N | J8 | Fit and procurement pending | Development candidate | Internal connector; no sealed external connector rating. Service headers require matching plugs.
Ancillary | 1 | 0 | Mating housing | VHR-5N | J10 | Fit and procurement pending | Development candidate | Internal connector; no sealed external connector rating. Service headers require matching plugs.
Ancillary | 1 | 0 | Mating housing | VHR-8N | J9 | Fit and procurement pending | Development candidate | Internal connector; no sealed external connector rating. Service headers require matching plugs.
Ancillary | 8 | 0 | Mating housing | XHP-3 | J11, J12, J13, J14, J15, J16, J17, J18 | Fit and procurement pending | Development candidate | Internal connector; no sealed external connector rating. Service headers require matching plugs.
Ancillary | 1 | 0 | Mating housing | XHP-4 | J7 | Fit and procurement pending | Development candidate | Internal connector; no sealed external connector rating. Service headers require matching plugs.
Ancillary | 10 | 0 | Crimp contact count excluding NC pins | SPH-002T-P0.5S by wire | PHR | Fit and procurement pending | Development candidate | Maximum connected-cavity count before spares; actual gauge/tooling/load and unused sensor supply wires require review
Ancillary | 24 | 0 | Crimp contact count excluding NC pins | SVH-21T-P1.1 or SVH-41T-P1.1 by wire/load | VHR | Fit and procurement pending | Development candidate | Maximum connected-cavity count before spares; actual gauge/tooling/load and unused sensor supply wires require review
Ancillary | 28 | 0 | Crimp contact count excluding NC pins | SXH-001T-P0.6 | XHP | Fit and procurement pending | Development candidate | Maximum connected-cavity count before spares; actual gauge/tooling/load and unused sensor supply wires require review
Ancillary | 1 | 0 | Ordinary common-anode RGB LED | WP154A4SEJ3VBDZGW/CA | J23 | Fit and procurement pending | Development candidate | J23 pins1/2/3/4 map to LED pins2/1/4/3; J23 pin5 empty. Common-anode supply has R179330R in addition to individual cathode resistors. Brightness, lead fit, optics and sealing unqualified.
Ancillary | 2 | 0 | Sealed normally-open momentary button | PAIR and RESET, exact parts pending | J2 service harness | Fit and procurement pending | Development candidate | See docs/espnow.md; enclosure, cap, cable, seal, wall thickness and physical fit remain unqualified.
