markthebault/esp32-ecu/hardware/boost-isolated/bom-grouped.csv

Quantity | References | Value | MPN candidate | Footprint | Assembly | Population | Notes
2 | C8 C9 | 100nF 50V |  | ECU:C_Disc_D5.0mm_W2.5mm_P5.00mm | front | Fitted | Local leaded decoupler; exact part, lead spacing, rail transients and placement acceptance pending
5 | C1 C2 C3 C4 C5 | 100nF 50V |  | ECU:C_Disc_D5.0mm_W2.5mm_P5.00mm_BackAssembly | back | Fitted | Back-side local bypass; confirm under-board clearance. Local leaded decoupler; exact part, lead spacing, rail transients and placement acceptance pending
2 | C11 C12 | 100nF FILM 25V+ 5% |  | ECU:C_Rect_L7.2mm_W5.0mm_P5.00mm_BackAssembly | back | Fitted | Explicit gate-source film capacitance for Miller/hotplug suppression. Short pulses may not transfer; physical minimum remains unqualified. Exact leaded film part/temperature/ESR and back clearance remain open.
1 | C6 | 100uF 50V |  | ECU:CP_Radial_D8.0mm_P3.50mm | front | Fitted | Input reservoir; exact D8/P3.5 leaded part, ripple/thermal and interruption response pending
1 | R10 | 10k |  | ECU:R_Axial_DIN0207_L6.3mm_D2.5mm_P2.54mm_Vertical | front | Fitted | Driver input off bias; exact leaded passive part/temperature rating pending
1 | R14 | 10k |  | ECU:R_Axial_DIN0207_L6.3mm_D2.5mm_P2.54mm_Vertical_BackAssembly | back | Fitted | Back-side local gate-source off bias; verify underside clearance; exact leaded passive part/temperature rating pending
2 | R5 R6 | 10k 1% |  | ECU:R_Axial_DIN0207_L6.3mm_D2.5mm_P2.54mm_Vertical | front | Fitted | Local gate-source off bias, including disconnected signal. Static loading included in combined RUN study. Exact leaded part/temperature/fit remains open.
1 | R15 | 120R 1% |  | ECU:R_Axial_DIN0207_L6.3mm_D2.5mm_P2.54mm_Vertical | front | Fitted | Regulator minimum load and divider high arm; exact leaded passive part/temperature rating pending
1 | D2 | 1N4007 | 1N4007-E3/54 | ECU:D_DO-41_SOD81_P10.16mm_Horizontal | front | Fitted | LM317 output-discharge protection: A atOUT, K atIN. Does not provide input reverse-battery protection.
2 | D3 D4 | 1N4148 | 1N4148-TAP | ECU:D_DO-35_SOD27_P3.81mm_Vertical_AnodeUp | front | Fitted | Negative gate-source clamp; no positive signal-to-carrier5V path. Not isolation protection or automotive transient qualification.
4 | R7 R8 R9 R11 | 1k |  | ECU:R_Axial_DIN0207_L6.3mm_D2.5mm_P2.54mm_Vertical | front | Fitted | Opto pullup; timing load condition must match; exact leaded passive part/temperature rating pending | Logic-to-driver input series; exact leaded passive part/temperature rating pending | Independent local supervisor enable; exact leaded passive part/temperature rating pending
1 | R1 | 1k 1% |  | ECU:R_Axial_DIN0207_L6.3mm_D2.5mm_P2.54mm_Vertical | front | Fitted | MOS gate series/filter resistor, not BJT base drive. Exact leaded passive remains procurement/fit hold.
1 | C10 | 1uF 16V+ FILM |  | ECU:C_Rect_L7.2mm_W5.0mm_P5.00mm_BackAssembly | back | Fitted | Back-side local driver bulk in parallel with C4. Exact low-ESR leaded part, under-board clearance and transient scope acceptance required.
1 | C13 | 2.2uF 16V 20% |  | ECU:CP_Radial_D5.0mm_P2.00mm | front | Fitted | Local LED-supply slew reservoir with C9. Stored power after supply opening and effective capacitance/ESR/leakage/temperature must be checked. Exact D5/P2 leaded part/height pending.
1 | C7 | 22uF 16V |  | ECU:CP_Radial_D8.0mm_P3.50mm | front | Fitted | LM317 local output reservoir, no generic old-LDO ESR-window claim; exact leaded part/fit and transient behavior pending
1 | R13 | 33R |  | ECU:R_Axial_DIN0207_L6.3mm_D2.5mm_P2.54mm_Vertical_BackAssembly | back | Fitted | Back-side gate damping; switching/underside clearance remain unmeasured; exact leaded passive part/temperature rating pending
2 | R3 R4 | 357R 1% |  | ECU:R_Axial_DIN0207_L6.3mm_D2.5mm_P2.54mm_Vertical | front | Fitted | LED current conditional7.63-14.85mA; exact leaded passive part/temperature rating pending
1 | R16 | 374R 1% |  | ECU:R_Axial_DIN0207_L6.3mm_D2.5mm_P2.54mm_Vertical | front | Fitted | Regulator divider low arm; exact leaded passive part/temperature rating pending
1 | R17 | 47R 1W 5% |  | ECU:R_Axial_DIN0207_L6.3mm_D2.5mm_P2.54mm_Vertical | front | Fitted | Local optical LED-supply slew resistor. Exact leaded1W/pulse-rated part must satisfy recorded inrush/energy and fit; not a current limiter for actuator power.
1 | R12 | 4k7 |  | ECU:R_Axial_DIN0207_L6.3mm_D2.5mm_P2.54mm_Vertical | front | Fitted | Mandatory enable off bias overrides internal pullup; exact leaded passive part/temperature rating pending
1 | R2 | 4k7 1% |  | ECU:R_Axial_DIN0207_L6.3mm_D2.5mm_P2.54mm_Vertical | front | Fitted | MOS gate series/filter resistor, not BJT base drive. Exact leaded passive remains procurement/fit hold.
2 | U2 U3 | 6N137 | 6N137 | ECU:DIP-8_W7.62mm_LongPads | front | Fitted | Vishay DIP8, direct solder. No copper across optical gap. Actual pullup/load and input-current timing conditions require verification.
1 | J1 | BOOST LOGIC ZH4 | B4B-ZR-3.4(LF)(SN) | ECU:JST_ZH_B4B-ZR-3.4_1x04_P1.50mm_Vertical | front | Fitted | ZH4 for low-power optical input only. ZHR-4 housings, SZH-002T-P0.5 contacts for AWG26..28. Same1..4 order as A7 J24; distinct from idle PH4 and switch XH4.3.4mm solder length for1.6mm PCB; actual crimp/retention/fit/finished-hole acceptance remains open.
1 | J3 | BOOST VALVE VH6 TWO CONTACTS | B6P-VH(LF)(SN) | ECU:JST_VH_B6P-VH_1x06_P3.96mm_Vertical | front | Fitted | VHR-6N, only positions1/2 wired; no contacts3..6. VH6 differs from existing carrier VH4 auxiliaries, VH3 flex and VH2 idle. Actual valve polarity/plumbing/current/RL and independent cutoff remain unqualified.
1 | Q1 | IRLZ44NPBF | IRLZ44NPBF | ECU:TO-220-3_Vertical | front | Fitted | Fast logic-level MOSFET, no automatic current/thermal shutdown or fault feedback. Drain tab must not bridge domains or share an uninsulated regulator heatsink.
1 | U6 | LM317AT/NOPB | LM317AT/NOPB | ECU:TO-220-3_Vertical | front | Fitted | 120/374ohm1% divider: DC4.967-5.346V, >=10mA minimum load, >=3V headroom at9V input. Tab is output, not ground. No rail transient/thermal qualification.
4 | H1 H2 H3 H4 | M3 ISOLATED MOUNT |  | ECU:MountingHole_3.2mm_M3 | front | Mounting feature | Unplated mount. Insulating spacers/hardware must not bridge carrier/actuator ground or live TO220 tabs. Case fit unmeasured.
1 | U5 | MCP100-485DI/TO | MCP100-485DI/TO | ECU:TO-92_Inline_Wide | front | Fitted | D-bondout only. Static trip4.60-4.85V; assertion10us is typical without a maximum. No hard brownout-latency claim.
1 | J2 | PROTECTED ACTUATOR SUPPLY | 1715721 | ECU:TerminalBlock_Phoenix_MKDS-1,5-2-5.08_1x02_P5.08mm_Horizontal | front | Fitted | Separate externally fused, relay-switched, reverse/transient-protected branch. Never carrier/sensor supply. No onboard coil current limit.
1 | D1 | SB5H100-E3 | SB5H100-E3/54 | ECU:D_DO-201AD_P15.24mm_Horizontal | front | Fitted | Flyback cathode at valve+, anode at drain. Close coil/diode loop; current decays after cut.
1 | U4 | SN74HCT02N | SN74HCT02N | ECU:DIP-14_W7.62mm_LongPads_BypassClearSilk | front | Fitted | Ordinary TTL NOR accepts opto VOL0.6V under its0.8V VIL. NOR(PWM_N,RUN_N) is high only when both input LEDs are lit. Unused inputs grounded.
1 | NT1 | SOURCE RETURN STAR / COPPER ONLY |  | ECU:NetTie_Source_Star | front | Copper only | Unfitted board-only copper tie, no SMD assembly. Pad1 overlaps Q1source copper intentionally. No other low-impedance logic-to-power return join allowed.
2 | Q2 Q3 | TN0702N3-G | TN0702N3-G | ECU:TO-92_Inline_Wide_FrontBackCap | front | Fitted | Microchip DS20005941A pins1S2G3D. Form TO92 leads to existing2.54mm pitch. Low-voltage Rds limits are25C pulse tests. Gate filter/off bias and body diode are explicit; temperature, formed-lead fit and electrical transfer remain unqualified.
1 | U1 | UCC27524P | UCC27524P.B | ECU:DIP-8_W7.62mm_LongPads_BypassClearSilk | front | Fitted | Direct PDIP8, no socket. Exact procured P/P.B electrical guarantee remains a release item. Local supervisor gates ENA independently of logic.
