markthebault/esp32-ecu/hardware/idle-isolated/harness-bom.csv

Quantity | Item | MPN candidate | Use | Procurement / acceptance
1 | PH4 mating housing | PHR-4 | A5 J21 | Verify actual keyed mating view and cable access
4 | PH crimp contact | SPH-002T-P0.5S | A5 J21 | Select wire insulation/conductor and exact tooling from JST data; no hand-soldered contact substitute
1 | XH4 mating housing | XHP-4 | Accessory J1 | Verify pin1-to-pin1 harness continuity
4 | XH crimp contact | SXH-001T-P0.6 | Accessory J1 | Match actual wire and crimp tooling
1 | VH2 mating housing | VHR-2N | Accessory J3 valve | Verify valve harness and retention
2 | VH crimp contact | SVH-21T-P1.1 OR SVH-41T-P1.1 | Accessory J3 valve | Choose one family by actual wire gauge/current; quantity is combined not each
1 | Four-conductor logic harness | TBD | J21 PH4 to J1 XH4 | Same1..4 pin order; actual wire/crimp/length/strain relief remain unqualified
1 | Protected switched actuator branch | TBD | J2 supply and dedicated return | External fuse relay reverse/transient protection and independent cutoff must be specified; <=2A actual coil; no purchase release
4 | Insulating M3 standoff/hardware set | TBD | H1-H4 | 82x52mm centres; underside part/lead clearance and actual case fit unmeasured
1 | Insulating mounting enclosure and cable seals | TBD | Separate accessory board | No fit-qualified printable case yet; do not reuse A3 fit claims
2 | TO220 insulation/mounting arrangement | TBD | Q1 drain tab and U6 output tab | Different live tab potentials; no uninsulated shared heatsink or conductive case bridge
