markthebault/esp32-ecu/hardware/switch-inputs/bom.csv

Reference | Value | MPN candidate | Footprint | Qualification / procurement
J1 | INTERNAL J4 LINK | B4B-XH-A(LF)(SN) | ECU:JST_XH_B4B-XH-A_1x04_P2.50mm_Vertical | Short internal harness only. Carrier J4 pin5 SAFE_N has NO wire/contact on this accessory. One explicit I2C owner; no other device at0x20.
J2 | DRY CONTACT 0 | B2P-VH(LF)(SN) | ECU:JST_VH_B2P-VH_1x02_P3.96mm_Vertical | 3.96mm VH deliberately incompatible with2.50mm XH J1 power/I2C. Low-current dry contact closes SW to its own return. No external supply, Hall/pulse or safety-interlock role. Open wire=open; short to return=closed. Use dry-circuit contacts.
J3 | DRY CONTACT 1 | B2P-VH(LF)(SN) | ECU:JST_VH_B2P-VH_1x02_P3.96mm_Vertical | 3.96mm VH deliberately incompatible with2.50mm XH J1 power/I2C. Low-current dry contact closes SW to its own return. No external supply, Hall/pulse or safety-interlock role. Open wire=open; short to return=closed. Use dry-circuit contacts.
U1 | MCP23008-E/P | MCP23008-E/P | ECU:DIP-18_W7.62mm_LongPads | Direct solder PDIP18, no socket. Address0x20. DS20001919I pinout; GP7 output only. Marker is behavior/readback, not unique identity.
U2 | MCP121-300E/TO | MCP121-300E/TO | ECU:TO-92_Inline_Wide | Prototype supervisor. Open-drain100k pullup matches data-sheet test condition. Trip2.857..3.003V; release80..180ms under specified conditions. Leakage max, hysteresis over temperature, rail ramps and actual loaded RESET levels remain characterization holds.
Q1 | 2N3904BU | 2N3904BU | ECU:TO-92_Inline_Wide | onsemi E-B-C bondout only, manually formed2.54mm leads. Open contact drives low; closed reads high. Sub-mA saturation/cutoff, temperature and power-off injection need physical characterization.
Q2 | 2N3904BU | 2N3904BU | ECU:TO-92_Inline_Wide | onsemi E-B-C bondout only, manually formed2.54mm leads. Open contact drives low; closed reads high. Sub-mA saturation/cutoff, temperature and power-off injection need physical characterization.
D1 | 1N4148-TAP | 1N4148-TAP | ECU:D_DO-35_SOD27_P3.81mm_Vertical_AnodeUp | Feed diode or reverse-BE clamp; NOT a guarantee of zero backfeed. Band/cathode is pad1; verify purchased part and assembly.
D2 | 1N4148-TAP | 1N4148-TAP | ECU:D_DO-35_SOD27_P3.81mm_Vertical_AnodeUp | Feed diode or reverse-BE clamp; NOT a guarantee of zero backfeed. Band/cathode is pad1; verify purchased part and assembly.
D3 | 1N4148-TAP | 1N4148-TAP | ECU:D_DO-35_SOD27_P3.81mm_Vertical_AnodeUp | Feed diode or reverse-BE clamp; NOT a guarantee of zero backfeed. Band/cathode is pad1; verify purchased part and assembly.
D4 | 1N4148-TAP | 1N4148-TAP | ECU:D_DO-35_SOD27_P3.81mm_Vertical_AnodeUp | Feed diode or reverse-BE clamp; NOT a guarantee of zero backfeed. Band/cathode is pad1; verify purchased part and assembly.
R1 | 2200R 1% 0.6W | MRS25000C2201FCT00 | ECU:R_Axial_DIN0207_L6.3mm_D2.5mm_P2.54mm_Vertical | Vishay MRS25 ordering-code candidate, availability/packing unverified. P70=0.6W with film-temperature limits; upright body may be6.5mm tall. Fault/rail thermal and actual formed-lead fit unqualified.
R2 | 2200R 1% 0.6W | MRS25000C2201FCT00 | ECU:R_Axial_DIN0207_L6.3mm_D2.5mm_P2.54mm_Vertical | Vishay MRS25 ordering-code candidate, availability/packing unverified. P70=0.6W with film-temperature limits; upright body may be6.5mm tall. Fault/rail thermal and actual formed-lead fit unqualified.
R3 | 4990R 1% 0.6W | MRS25000C4991FCT00 | ECU:R_Axial_DIN0207_L6.3mm_D2.5mm_P2.54mm_Vertical | Vishay MRS25 ordering-code candidate, availability/packing unverified. P70=0.6W with film-temperature limits; upright body may be6.5mm tall. Fault/rail thermal and actual formed-lead fit unqualified.
R4 | 4990R 1% 0.6W | MRS25000C4991FCT00 | ECU:R_Axial_DIN0207_L6.3mm_D2.5mm_P2.54mm_Vertical | Vishay MRS25 ordering-code candidate, availability/packing unverified. P70=0.6W with film-temperature limits; upright body may be6.5mm tall. Fault/rail thermal and actual formed-lead fit unqualified.
R5 | 4990R 1% 0.6W | MRS25000C4991FCT00 | ECU:R_Axial_DIN0207_L6.3mm_D2.5mm_P2.54mm_Vertical | Vishay MRS25 ordering-code candidate, availability/packing unverified. P70=0.6W with film-temperature limits; upright body may be6.5mm tall. Fault/rail thermal and actual formed-lead fit unqualified.
R6 | 4990R 1% 0.6W | MRS25000C4991FCT00 | ECU:R_Axial_DIN0207_L6.3mm_D2.5mm_P2.54mm_Vertical | Vishay MRS25 ordering-code candidate, availability/packing unverified. P70=0.6W with film-temperature limits; upright body may be6.5mm tall. Fault/rail thermal and actual formed-lead fit unqualified.
R7 | 100000R 1% 0.6W | MRS25000C1003FCT00 | ECU:R_Axial_DIN0207_L6.3mm_D2.5mm_P2.54mm_Vertical | Vishay MRS25 ordering-code candidate, availability/packing unverified. P70=0.6W with film-temperature limits; upright body may be6.5mm tall. Fault/rail thermal and actual formed-lead fit unqualified.
R8 | 100000R 1% 0.6W | MRS25000C1003FCT00 | ECU:R_Axial_DIN0207_L6.3mm_D2.5mm_P2.54mm_Vertical | Vishay MRS25 ordering-code candidate, availability/packing unverified. P70=0.6W with film-temperature limits; upright body may be6.5mm tall. Fault/rail thermal and actual formed-lead fit unqualified.
R9 | 4700R 1% 0.6W | MRS25000C4701FCT00 | ECU:R_Axial_DIN0207_L6.3mm_D2.5mm_P2.54mm_Vertical | Vishay MRS25 ordering-code candidate, availability/packing unverified. P70=0.6W with film-temperature limits; upright body may be6.5mm tall. Fault/rail thermal and actual formed-lead fit unqualified.
R10 | 4700R 1% 0.6W | MRS25000C4701FCT00 | ECU:R_Axial_DIN0207_L6.3mm_D2.5mm_P2.54mm_Vertical | Vishay MRS25 ordering-code candidate, availability/packing unverified. P70=0.6W with film-temperature limits; upright body may be6.5mm tall. Fault/rail thermal and actual formed-lead fit unqualified.
R11 | 1000R 1% 0.6W | MRS25000C1001FCT00 | ECU:R_Axial_DIN0207_L6.3mm_D2.5mm_P2.54mm_Vertical | Vishay MRS25 ordering-code candidate, availability/packing unverified. P70=0.6W with film-temperature limits; upright body may be6.5mm tall. Fault/rail thermal and actual formed-lead fit unqualified.
R12 | 1000R 1% 0.6W | MRS25000C1001FCT00 | ECU:R_Axial_DIN0207_L6.3mm_D2.5mm_P2.54mm_Vertical | Vishay MRS25 ordering-code candidate, availability/packing unverified. P70=0.6W with film-temperature limits; upright body may be6.5mm tall. Fault/rail thermal and actual formed-lead fit unqualified.
R13 | 10000R 1% 0.6W | MRS25000C1002FCT00 | ECU:R_Axial_DIN0207_L6.3mm_D2.5mm_P2.54mm_Vertical | Vishay MRS25 ordering-code candidate, availability/packing unverified. P70=0.6W with film-temperature limits; upright body may be6.5mm tall. Fault/rail thermal and actual formed-lead fit unqualified.
R14 | 10000R 1% 0.6W | MRS25000C1002FCT00 | ECU:R_Axial_DIN0207_L6.3mm_D2.5mm_P2.54mm_Vertical | Vishay MRS25 ordering-code candidate, availability/packing unverified. P70=0.6W with film-temperature limits; upright body may be6.5mm tall. Fault/rail thermal and actual formed-lead fit unqualified.
R15 | 10000R 1% 0.6W | MRS25000C1002FCT00 | ECU:R_Axial_DIN0207_L6.3mm_D2.5mm_P2.54mm_Vertical | Vishay MRS25 ordering-code candidate, availability/packing unverified. P70=0.6W with film-temperature limits; upright body may be6.5mm tall. Fault/rail thermal and actual formed-lead fit unqualified.
R16 | 10000R 1% 0.6W | MRS25000C1002FCT00 | ECU:R_Axial_DIN0207_L6.3mm_D2.5mm_P2.54mm_Vertical | Vishay MRS25 ordering-code candidate, availability/packing unverified. P70=0.6W with film-temperature limits; upright body may be6.5mm tall. Fault/rail thermal and actual formed-lead fit unqualified.
R17 | 1000R 1% 0.6W | MRS25000C1001FCT00 | ECU:R_Axial_DIN0207_L6.3mm_D2.5mm_P2.54mm_Vertical | Vishay MRS25 ordering-code candidate, availability/packing unverified. P70=0.6W with film-temperature limits; upright body may be6.5mm tall. Fault/rail thermal and actual formed-lead fit unqualified.
R18 | 100000R 1% 0.6W | MRS25000C1003FCT00 | ECU:R_Axial_DIN0207_L6.3mm_D2.5mm_P2.54mm_Vertical | Vishay MRS25 ordering-code candidate, availability/packing unverified. P70=0.6W with film-temperature limits; upright body may be6.5mm tall. Fault/rail thermal and actual formed-lead fit unqualified.
R19 | 100000R 1% 0.6W | MRS25000C1003FCT00 | ECU:R_Axial_DIN0207_L6.3mm_D2.5mm_P2.54mm_Vertical | Vishay MRS25 ordering-code candidate, availability/packing unverified. P70=0.6W with film-temperature limits; upright body may be6.5mm tall. Fault/rail thermal and actual formed-lead fit unqualified.
R20 | 1000R 1% 0.6W | MRS25000C1001FCT00 | ECU:R_Axial_DIN0207_L6.3mm_D2.5mm_P2.54mm_Vertical | Vishay MRS25 ordering-code candidate, availability/packing unverified. P70=0.6W with film-temperature limits; upright body may be6.5mm tall. Fault/rail thermal and actual formed-lead fit unqualified. Mandatory local bleeder, not proof of zero backfeed.
R21 | 100R 1% 0.6W | MRS25000C1000FCT00 | ECU:R_Axial_DIN0207_L6.3mm_D2.5mm_P2.54mm_Vertical | Vishay MRS25 ordering-code candidate, availability/packing unverified. P70=0.6W with film-temperature limits; upright body may be6.5mm tall. Fault/rail thermal and actual formed-lead fit unqualified.
R22 | 100R 1% 0.6W | MRS25000C1000FCT00 | ECU:R_Axial_DIN0207_L6.3mm_D2.5mm_P2.54mm_Vertical | Vishay MRS25 ordering-code candidate, availability/packing unverified. P70=0.6W with film-temperature limits; upright body may be6.5mm tall. Fault/rail thermal and actual formed-lead fit unqualified.
C1 | 100nF 50V |  | ECU:C_Disc_D5.0mm_W2.5mm_P5.00mm | Leaded ceramic candidate: P5mm, body<=D5/W2.5mm envelope. Exact part and bias/temp/assembly fit pending; no SMD. Collector RC is filtering, not continuity detection.
C2 | 100nF 50V |  | ECU:C_Disc_D5.0mm_W2.5mm_P5.00mm | Leaded ceramic candidate: P5mm, body<=D5/W2.5mm envelope. Exact part and bias/temp/assembly fit pending; no SMD. Collector RC is filtering, not continuity detection.
C3 | 10nF 50V |  | ECU:C_Disc_D5.0mm_W2.5mm_P5.00mm | Leaded ceramic candidate: P5mm, body<=D5/W2.5mm envelope. Exact part and bias/temp/assembly fit pending; no SMD. Collector RC is filtering, not continuity detection.
C4 | 10nF 50V |  | ECU:C_Disc_D5.0mm_W2.5mm_P5.00mm | Leaded ceramic candidate: P5mm, body<=D5/W2.5mm envelope. Exact part and bias/temp/assembly fit pending; no SMD. Collector RC is filtering, not continuity detection.
C5 | 10uF 16V |  | ECU:CP_Radial_D8.0mm_P3.50mm | Leaded radial local bulk. Exact D8/P3.5 part, leakage/ESR/temperature and physical fit pending.
H1 | M3 INSULATED MOUNT |  | ECU:MountingHole_3.2mm_M3 | Unplated3.2mm. Insulating spacers; separate80x60mm accessory fit/clearance unmeasured.
H2 | M3 INSULATED MOUNT |  | ECU:MountingHole_3.2mm_M3 | Unplated3.2mm. Insulating spacers; separate80x60mm accessory fit/clearance unmeasured.
H3 | M3 INSULATED MOUNT |  | ECU:MountingHole_3.2mm_M3 | Unplated3.2mm. Insulating spacers; separate80x60mm accessory fit/clearance unmeasured.
H4 | M3 INSULATED MOUNT |  | ECU:MountingHole_3.2mm_M3 | Unplated3.2mm. Insulating spacers; separate80x60mm accessory fit/clearance unmeasured.
