markthebault/esp32-ecu/reports/engine/idle-isolation/reviews/layout/a5/snapshots/05bec06cd0e1f013429455eb64d617a0aee832cd44da4d9ceb63e16688d4d3d7/hardware/a4-n16r8/bom-shopping.csv

Section | Quantity | Optional quantity | Item | MPN / specification | References / use | Package / fit | Selection status | Notes
PCB | 3 | 0 | 47u 63V | Select exact part | C1, C2, C45 | Capacitor_THT:CP_Radial_D8.0mm_P3.50mm | Exact part selection required | Polarized radial electrolytic, body diameter <=8 mm, 3.50 mm lead pitch; check height and exact voltage/temperature/ESR; Select exact manufacturer part to match value, package, lead pitch and operating conditions; unspecified ratings still need engineering selection | Electrolytic, exact series must be qualified.
PCB | 2 | 0 | 100n 100V | Select exact part | C3, C46 | Capacitor_THT:C_Disc_D5.0mm_W2.5mm_P5.00mm | Exact part selection required | Leaded ceramic, body <=5.0 x 2.5 mm, lead pitch 5.00 mm; retain stated C0G/rating where specified; Select exact manufacturer part to match value, package, lead pitch and operating conditions; unspecified ratings still need engineering selection
PCB | 2 | 0 | 22u 16V electrolytic | Select exact part | C5, C6 | Capacitor_THT:CP_Radial_D8.0mm_P3.50mm | Exact part selection required | Polarized radial electrolytic, body diameter <=8 mm, 3.50 mm lead pitch; check height and exact voltage/temperature/ESR; Select exact manufacturer part to match value, package, lead pitch and operating conditions; unspecified ratings still need engineering selection | Radial electrolytic on the 5V rail; select exact series and verify rail stability/ripple over temperature.
PCB | 1 | 0 | 22u 10V ESR 0.3-1R | Select exact part | C9 | Capacitor_THT:CP_Radial_D8.0mm_P3.50mm | Exact part selection required | Polarized radial electrolytic, body diameter <=8 mm, 3.50 mm lead pitch; check height and exact voltage/temperature/ESR; Specified ESR target 0.3-1 ohm; exact series must be reviewed for LD1117 stability over temperature; Select exact manufacturer part to match value, package, lead pitch and operating conditions; unspecified ratings still need engineering selection | Select exact electrolytic series to satisfy LDO stability over temperature.
PCB | 17 | 0 | 100n | Select exact part | C10, C14, C15, C16, C28, C32, C33, C34, C35, C36, C37, C38, C39, C40, C41, C42, C43 | Capacitor_THT:C_Disc_D5.0mm_W2.5mm_P5.00mm | Exact part selection required | Leaded ceramic, body <=5.0 x 2.5 mm, lead pitch 5.00 mm; retain stated C0G/rating where specified; Select exact manufacturer part to match value, package, lead pitch and operating conditions; unspecified ratings still need engineering selection
PCB | 3 | 0 | 1u | Select exact part | C11, C12, C29 | Capacitor_THT:C_Rect_L7.2mm_W5.0mm_P5.00mm | Exact part selection required | Leaded film/boxed capacitor, body <=7.2 x 5.0 mm, lead pitch 5.00 mm; retain stated film type/tolerance; Select exact manufacturer part to match value, package, lead pitch and operating conditions; unspecified ratings still need engineering selection
PCB | 1 | 0 | 10u | Select exact part | C13 | Capacitor_THT:CP_Radial_D8.0mm_P3.50mm | Exact part selection required | Polarized radial electrolytic, body diameter <=8 mm, 3.50 mm lead pitch; check height and exact voltage/temperature/ESR; Select exact manufacturer part to match value, package, lead pitch and operating conditions; unspecified ratings still need engineering selection
PCB | 8 | 0 | 10n | Select exact part | C20, C21, C22, C23, C24, C25, C26, C27 | Capacitor_THT:C_Disc_D5.0mm_W2.5mm_P5.00mm | Exact part selection required | Leaded ceramic, body <=5.0 x 2.5 mm, lead pitch 5.00 mm; retain stated C0G/rating where specified; Select exact manufacturer part to match value, package, lead pitch and operating conditions; unspecified ratings still need engineering selection
PCB | 2 | 0 | 100p C0G | Select exact part | C30, C31 | Capacitor_THT:C_Disc_D5.0mm_W2.5mm_P5.00mm | Exact part selection required | Leaded ceramic, body <=5.0 x 2.5 mm, lead pitch 5.00 mm; retain stated C0G/rating where specified; Select exact manufacturer part to match value, package, lead pitch and operating conditions; unspecified ratings still need engineering selection
PCB | 1 | 0 | 4.7n 100V | Select exact part | C47 | Capacitor_THT:C_Disc_D5.0mm_W2.5mm_P5.00mm | Exact part selection required | Leaded ceramic, body <=5.0 x 2.5 mm, lead pitch 5.00 mm; retain stated C0G/rating where specified; Select exact manufacturer part to match value, package, lead pitch and operating conditions; unspecified ratings still need engineering selection | RF coupling of shield and signal ground; not galvanic isolation.
PCB | 4 | 0 | 270n 5% FILM | Select exact part | C61, C62, C63, C64 | Capacitor_THT:C_Rect_L7.2mm_W5.0mm_P5.00mm | Exact part selection required | Leaded film/boxed capacitor, body <=7.2 x 5.0 mm, lead pitch 5.00 mm; retain stated film type/tolerance; Select exact manufacturer part to match value, package, lead pitch and operating conditions; unspecified ratings still need engineering selection
PCB | 4 | 0 | 68n 5% FILM | Select exact part | C81, C82, C83, C84 | Capacitor_THT:C_Rect_L7.2mm_W5.0mm_P5.00mm | Exact part selection required | Leaded film/boxed capacitor, body <=7.2 x 5.0 mm, lead pitch 5.00 mm; retain stated film type/tolerance; Select exact manufacturer part to match value, package, lead pitch and operating conditions; unspecified ratings still need engineering selection
PCB | 6 | 0 | 1n C0G 100V | Select exact part | C150, C151, C152, C153, C154, C155 | Capacitor_THT:C_Disc_D5.0mm_W2.5mm_P5.00mm | Exact part selection required | Leaded ceramic, body <=5.0 x 2.5 mm, lead pitch 5.00 mm; retain stated C0G/rating where specified; Select exact manufacturer part to match value, package, lead pitch and operating conditions; unspecified ratings still need engineering selection | Cable-entry RF shunt to shield, before series input resistor. Validate edge delay and fault stress.
PCB | 2 | 0 | 100p C0G 100V | Select exact part | C156, C157 | Capacitor_THT:C_Disc_D5.0mm_W2.5mm_P5.00mm | Exact part selection required | Leaded ceramic, body <=5.0 x 2.5 mm, lead pitch 5.00 mm; retain stated C0G/rating where specified; Select exact manufacturer part to match value, package, lead pitch and operating conditions; unspecified ratings still need engineering selection | Cable-entry RF shunt to shield, before series input resistor. Validate edge delay and fault stress.
PCB | 1 | 0 | 1.5KE27CA | 1.5KE27CA | D1 | Diode_THT:D_DO-201AD_P5.08mm_Vertical_AnodeUp | MPN specified; stock not checked | | Axial bidirectional TVS; 23.1V standoff and specified 37.5V pulse clamp. No load-dump qualification claim.
PCB | 1 | 0 | SB5100 | SB5100-B | D2 | Diode_THT:D_DO-201AD_P15.24mm_Horizontal | MPN specified; stock not checked | | 100 V series reverse-polarity blocking diode; check forward loss and pulse stress.
PCB | 21 | 0 | BAT85 | BAT85,113 | D3, D100, D101, D110, D111, D120, D121, D130, D131, D140, D141, D150, D151, D160, D161, D170, D171, D200, D201, D210, D211 | Diode_THT:D_DO-35_SOD27_P3.81mm_Vertical_AnodeUp | MPN specified; stock not checked | | Axial Schottky mounted vertically. Validate input clamp voltage/leakage at temperature.
PCB | 2 | 0 | P6KE24CA | P6KE24CA | D22, D23 | Diode_THT:D_DO-15_P12.70mm_Horizontal | MPN specified; stock not checked | | Axial bidirectional CAN surge clamp; verify overshoot and capacitance on assembled bus.
PCB | 1 | 0 | PTC 100mA radial | MF-R010 | F2 | ECU:PTC_MF_R010 | MPN specified; stock not checked | | 100mA hold rating at datasheet ambient; thermal derating and slow trip, not an electronic current limiter.
PCB | 1 | 0 | FUSED_KEY_12V | B2P-VH(LF)(SN) | J1 | Connector_JST:JST_VH_B2P-VH_1x02_P3.96mm_Vertical | MPN specified; stock not checked | | Polarized internal loom connector. Separate fused relay-switched actuator supply. See pinout.
PCB | 1 | 0 | UART_FLASH_3V3_ONLY | Select exact part | J2 | Connector_PinHeader_2.54mm:PinHeader_1x05_P2.54mm_Vertical | Exact part selection required | Select exact manufacturer part to match value, package, lead pitch and operating conditions; unspecified ratings still need engineering selection | External USB UART, 3.3 V logic. Supply board via J1; no USB backfeed.
PCB | 1 | 0 | NORMALLY_OPEN_INTERLOCK | Select exact part | J3 | Connector_PinHeader_2.54mm:PinHeader_1x02_P2.54mm_Vertical | Exact part selection required | Select exact manufacturer part to match value, package, lead pitch and operating conditions; unspecified ratings still need engineering selection | Fit only on supervised dummy-load bench. Open contact forces output inhibit independent of MCU.
PCB | 1 | 0 | EXPANSION_3V3 | Select exact part | J4 | Connector_PinHeader_2.54mm:PinHeader_1x05_P2.54mm_Vertical | Exact part selection required | Select exact manufacturer part to match value, package, lead pitch and operating conditions; unspecified ratings still need engineering selection
PCB | 1 | 0 | CAN_H_L_G_SHIELD | B4B-XH-A(LF)(SN) | J7 | Connector_JST:JST_XH_B4B-XH-A_1x04_P2.50mm_Vertical | MPN specified; stock not checked | | Polarized internal loom connector. Separate fused relay-switched actuator supply. See pinout.
PCB | 1 | 0 | EXTERNAL_RELAYS | B4P-VH(LF)(SN) | J8 | Connector_JST:JST_VH_B4P-VH_1x04_P3.96mm_Vertical | MPN specified; stock not checked | | Polarized internal loom connector. Separate fused relay-switched actuator supply. See pinout.
PCB | 1 | 0 | INJECTOR_LOW_SIDES | B8P-VH(LF)(SN) | J9 | Connector_JST:JST_VH_B8P-VH_1x08_P3.96mm_Vertical | MPN specified; stock not checked | | Polarized internal loom connector. Separate fused relay-switched actuator supply. See pinout.
PCB | 1 | 0 | SMART_COIL_5V_LOGIC | B5P-VH(LF)(SN) | J10 | Connector_JST:JST_VH_B5P-VH_1x05_P3.96mm_Vertical | MPN specified; stock not checked | | Polarized internal loom connector. Separate fused relay-switched actuator supply. See pinout.
PCB | 1 | 0 | MAP | B3B-XH-A(LF)(SN) | J11 | Connector_JST:JST_XH_B3B-XH-A_1x03_P2.50mm_Vertical | MPN specified; stock not checked | | A3 internal locking connector; not sealed. See connector-pinout.csv
PCB | 1 | 0 | TPS | B3B-XH-A(LF)(SN) | J12 | Connector_JST:JST_XH_B3B-XH-A_1x03_P2.50mm_Vertical | MPN specified; stock not checked | | A3 internal locking connector; not sealed. See connector-pinout.csv
PCB | 1 | 0 | CLT | B3B-XH-A(LF)(SN) | J13 | Connector_JST:JST_XH_B3B-XH-A_1x03_P2.50mm_Vertical | MPN specified; stock not checked | | A3 internal locking connector; not sealed. See connector-pinout.csv
PCB | 1 | 0 | IAT | B3B-XH-A(LF)(SN) | J14 | Connector_JST:JST_XH_B3B-XH-A_1x03_P2.50mm_Vertical | MPN specified; stock not checked | | A3 internal locking connector; not sealed. See connector-pinout.csv
PCB | 1 | 0 | LAMBDA_WB | B3B-XH-A(LF)(SN) | J15 | Connector_JST:JST_XH_B3B-XH-A_1x03_P2.50mm_Vertical | MPN specified; stock not checked | | A3 internal locking connector; not sealed. See connector-pinout.csv
PCB | 1 | 0 | POSTCAT_BUF | B3B-XH-A(LF)(SN) | J16 | Connector_JST:JST_XH_B3B-XH-A_1x03_P2.50mm_Vertical | MPN specified; stock not checked | | A3 internal locking connector; not sealed. See connector-pinout.csv
PCB | 1 | 0 | CRANK | B3B-XH-A(LF)(SN) | J17 | Connector_JST:JST_XH_B3B-XH-A_1x03_P2.50mm_Vertical | MPN specified; stock not checked | | A3 internal locking connector; not sealed. See connector-pinout.csv
PCB | 1 | 0 | CAM | B3B-XH-A(LF)(SN) | J18 | Connector_JST:JST_XH_B3B-XH-A_1x03_P2.50mm_Vertical | MPN specified; stock not checked | | A3 internal locking connector; not sealed. See connector-pinout.csv
PCB | 1 | 0 | POWER_RETURN | B2P-VH(LF)(SN) | J19 | Connector_JST:JST_VH_B2P-VH_1x02_P3.96mm_Vertical | MPN specified; stock not checked | | Both pins are actuator return. Two adequately sized parallel wires to engine ground star; never use sensor wires for injector return.
PCB | 1 | 0 | SHIELD_BOND | B2P-VH(LF)(SN) | J20 | ECU:JST_VH_B2P_SHIELD_Compact | MPN specified; stock not checked | | Shield/lining bond only. No normal load current. Short broad strap to enclosure conductive lining and designated chassis bond.
PCB | 1 | 0 | CAN_TX_ENABLE_OPEN | Select exact part | JP1 | Connector_PinHeader_2.54mm:PinHeader_1x02_P2.54mm_Vertical | Exact part selection required | Select exact manufacturer part to match value, package, lead pitch and operating conditions; unspecified ratings still need engineering selection | Open by default. Silent hardware plus software listen-only.
PCB | 1 | 0 | CAN_TERMINATION_OPEN | Select exact part | JP2 | Connector_PinHeader_2.54mm:PinHeader_1x02_P2.54mm_Vertical | Exact part selection required | Select exact manufacturer part to match value, package, lead pitch and operating conditions; unspecified ratings still need engineering selection
PCB | 1 | 0 | 47uH input filter | RLB0914-470KL | L2 | Inductor_THT:L_Radial_D10.0mm_P5.00mm_Fastron_07P | MPN specified; stock not checked | | Radial choke, 5mm pitch. 1.56A datasheet current; check derating. Not the converter switching inductor.
PCB | 7 | 0 | VNP35N07-E | VNP35N07-E | Q1, Q2, Q3, Q4, Q5, Q6, Q7 | Package_TO_SOT_THT:TO-220-3_Vertical | MPN specified; stock not checked | | Protected low-side TO-220, INPUT / DRAIN / SOURCE. Tab is live drain. External branch fuses required; current/thermal/clamp targets need tests.
PCB | 1 | 0 | 100R 0.25W | Select exact part | R7 | Resistor_THT:R_Axial_DIN0207_L6.3mm_D2.5mm_P2.54mm_Vertical | Exact part selection required | Axial DIN0207 body 6.3 x 2.5 mm; upright, 2.54 mm lead pitch; use the stated power/tolerance; Select exact manufacturer part to match value, package, lead pitch and operating conditions; unspecified ratings still need engineering selection | 33 mA rail bleed provides a sink for fault clamp current. Must validate unpowered injection.
PCB | 31 | 0 | 10k | Select exact part | R8, R9, R11, R12, R14, R15, R38, R44, R45, R47, R51, R52, R53, R54, R55, R65, R66, R67, R68, R85, R86, R87, R88, R105, R106, R107, R108, R115, R116, R117, R118 | Resistor_THT:R_Axial_DIN0207_L6.3mm_D2.5mm_P2.54mm_Vertical | Exact part selection required | Axial DIN0207 body 6.3 x 2.5 mm; upright, 2.54 mm lead pitch; use the stated power/tolerance; Select exact manufacturer part to match value, package, lead pitch and operating conditions; unspecified ratings still need engineering selection
PCB | 8 | 0 | 1k | Select exact part | R13, R48, R49, R50, R101, R102, R103, R104 | Resistor_THT:R_Axial_DIN0207_L6.3mm_D2.5mm_P2.54mm_Vertical | Exact part selection required | Axial DIN0207 body 6.3 x 2.5 mm; upright, 2.54 mm lead pitch; use the stated power/tolerance; Select exact manufacturer part to match value, package, lead pitch and operating conditions; unspecified ratings still need engineering selection
PCB | 2 | 0 | 4.7k | Select exact part | R16, R17 | Resistor_THT:R_Axial_DIN0207_L6.3mm_D2.5mm_P2.54mm_Vertical | Exact part selection required | Axial DIN0207 body 6.3 x 2.5 mm; upright, 2.54 mm lead pitch; use the stated power/tolerance; Select exact manufacturer part to match value, package, lead pitch and operating conditions; unspecified ratings still need engineering selection
PCB | 7 | 0 | 22k 1% | Select exact part | R20, R22, R24, R26, R28, R30, R36 | Resistor_THT:R_Axial_DIN0207_L6.3mm_D2.5mm_P2.54mm_Vertical | Exact part selection required | Axial DIN0207 body 6.3 x 2.5 mm; upright, 2.54 mm lead pitch; use the stated power/tolerance; Select exact manufacturer part to match value, package, lead pitch and operating conditions; unspecified ratings still need engineering selection
PCB | 7 | 0 | 33k 1% | Select exact part | R21, R23, R25, R27, R29, R31, R37 | Resistor_THT:R_Axial_DIN0207_L6.3mm_D2.5mm_P2.54mm_Vertical | Exact part selection required | Axial DIN0207 body 6.3 x 2.5 mm; upright, 2.54 mm lead pitch; use the stated power/tolerance; Select exact manufacturer part to match value, package, lead pitch and operating conditions; unspecified ratings still need engineering selection
PCB | 0 | 2 | 2.49k 1% NTC | Select exact part | R32, R33 | Resistor_THT:R_Axial_DIN0207_L6.3mm_D2.5mm_P2.54mm_Vertical | Optional - DNP | Axial DIN0207 body 6.3 x 2.5 mm; upright, 2.54 mm lead pitch; use the stated power/tolerance; Select exact manufacturer part to match value, package, lead pitch and operating conditions; unspecified ratings still need engineering selection | Populate only for passive NTC sensor; transfer curve must match selected sensor.
PCB | 1 | 0 | 120k 1% | Select exact part | R34 | Resistor_THT:R_Axial_DIN0207_L6.3mm_D2.5mm_P2.54mm_Vertical | Exact part selection required | Axial DIN0207 body 6.3 x 2.5 mm; upright, 2.54 mm lead pitch; use the stated power/tolerance; Select exact manufacturer part to match value, package, lead pitch and operating conditions; unspecified ratings still need engineering selection
PCB | 1 | 0 | 10k 1% | Select exact part | R35 | Resistor_THT:R_Axial_DIN0207_L6.3mm_D2.5mm_P2.54mm_Vertical | Exact part selection required | Axial DIN0207 body 6.3 x 2.5 mm; upright, 2.54 mm lead pitch; use the stated power/tolerance; Select exact manufacturer part to match value, package, lead pitch and operating conditions; unspecified ratings still need engineering selection
PCB | 2 | 0 | 33k | Select exact part | R40, R42 | Resistor_THT:R_Axial_DIN0207_L6.3mm_D2.5mm_P2.54mm_Vertical | Exact part selection required | Axial DIN0207 body 6.3 x 2.5 mm; upright, 2.54 mm lead pitch; use the stated power/tolerance; Select exact manufacturer part to match value, package, lead pitch and operating conditions; unspecified ratings still need engineering selection
PCB | 0 | 2 | 2.2k HALL PULLUP | Select exact part | R41, R43 | Resistor_THT:R_Axial_DIN0207_L6.3mm_D2.5mm_P2.54mm_Vertical | Optional - DNP | Axial DIN0207 body 6.3 x 2.5 mm; upright, 2.54 mm lead pitch; use the stated power/tolerance; Select exact manufacturer part to match value, package, lead pitch and operating conditions; unspecified ratings still need engineering selection
PCB | 1 | 0 | 120R | Select exact part | R46 | Resistor_THT:R_Axial_DIN0207_L6.3mm_D2.5mm_P2.54mm_Vertical | Exact part selection required | Axial DIN0207 body 6.3 x 2.5 mm; upright, 2.54 mm lead pitch; use the stated power/tolerance; Select exact manufacturer part to match value, package, lead pitch and operating conditions; unspecified ratings still need engineering selection
PCB | 8 | 0 | 100k 1% | Select exact part | R61, R62, R63, R64, R81, R82, R83, R84 | Resistor_THT:R_Axial_DIN0207_L6.3mm_D2.5mm_P2.54mm_Vertical | Exact part selection required | Axial DIN0207 body 6.3 x 2.5 mm; upright, 2.54 mm lead pitch; use the stated power/tolerance; Select exact manufacturer part to match value, package, lead pitch and operating conditions; unspecified ratings still need engineering selection
PCB | 4 | 0 | 220R | Select exact part | R111, R112, R113, R114 | Resistor_THT:R_Axial_DIN0207_L6.3mm_D2.5mm_P2.54mm_Vertical | Exact part selection required | Axial DIN0207 body 6.3 x 2.5 mm; upright, 2.54 mm lead pitch; use the stated power/tolerance; Select exact manufacturer part to match value, package, lead pitch and operating conditions; unspecified ratings still need engineering selection
PCB | 1 | 0 | 1R 0.5W damping | Select exact part | R150 | Resistor_THT:R_Axial_DIN0207_L6.3mm_D2.5mm_P10.16mm_Horizontal | Exact part selection required | Axial DIN0207 body 6.3 x 2.5 mm; 10.16 mm horizontal lead pitch; at least 0.5 W; Select exact manufacturer part to match value, package, lead pitch and operating conditions; unspecified ratings still need engineering selection | Series RC damping branch across converter input; verify input impedance/load-step stability.
PCB | 1 | 0 | 1M | Select exact part | R151 | Resistor_THT:R_Axial_DIN0207_L6.3mm_D2.5mm_P2.54mm_Vertical | Exact part selection required | Axial DIN0207 body 6.3 x 2.5 mm; upright, 2.54 mm lead pitch; use the stated power/tolerance; Select exact manufacturer part to match value, package, lead pitch and operating conditions; unspecified ratings still need engineering selection | Static bleed, not a protective earth bond.
PCB | 2 | 0 | 47R | Select exact part | R152, R153 | Resistor_THT:R_Axial_DIN0207_L6.3mm_D2.5mm_P2.54mm_Vertical | Exact part selection required | Axial DIN0207 body 6.3 x 2.5 mm; upright, 2.54 mm lead pitch; use the stated power/tolerance; Select exact manufacturer part to match value, package, lead pitch and operating conditions; unspecified ratings still need engineering selection
PCB | 1 | 0 | Pololu D36V6F5 | Pololu 3792 | U1 | ECU:Pololu_D36V6F5_vertical | MPN specified; stock not checked | Pololu product #3792. Upright mounting uses an appropriate supplied 1x4 right-angle header; verify SHDN/VIN/GND/VOUT orientation. | A3 hand-solder revision; see docs/compact.md
PCB | 1 | 0 | LD1117V33 | LD1117V33 | U2 | Package_TO_SOT_THT:TO-220-3_Vertical | MPN specified; stock not checked | | 3V3 regulator. 200mA continuous target pending thermal measurement. Use specified electrolytic ESR; no USB/carrier dual power.
PCB | 1 | 0 | ESP32-S3 44-pin Type-C N16R8 v1.1 | AliExpress 1005006418608267 / S3-N16R8 | U3 | ECU:ESP32_S3_DevKitC_1_socket | Selected module; socket fit unverified | Selected N16R8; 22.86 mm socket row spacing is provisional and unmeasured. Female headers are separate lines below. Prefer a pre-pinned module. | A3 hand-solder revision; see docs/compact.md
PCB | 1 | 0 | MAX1232EPA+ | MAX1232EPA+ | U4 | Package_DIP:DIP-8_W7.62mm_LongPads | MPN specified; stock not checked | | 5V monitor and watchdog: TD=VCC, 500..2000ms watchdog (1.2s typical); reset active 250..1000ms. TTL ST accepts 3V3. Open-drain reset wired to 3V3 SAFE_N.
PCB | 1 | 0 | MCP120-315DI/TO | MCP120-315DI/TO | U5 | Package_TO_SOT_THT:TO-92_Inline_Wide | MPN specified; stock not checked | | D bondout TO-92: RESET, VDD, VSS. Different bondout suffixes are not drop-in.
PCB | 1 | 0 | MCP3208-CI/P | MCP3208-CI/P | U6 | Package_DIP:DIP-16_W7.62mm_LongPads | MPN specified; stock not checked
PCB | 1 | 0 | SN74HC14N | SN74HC14N | U7 | Package_DIP:DIP-14_W7.62mm_LongPads | MPN specified; stock not checked | | A3 hand-solder revision; see docs/compact.md
PCB | 1 | 0 | MCP2562-E/P | MCP2562-E/P | U8 | Package_DIP:DIP-8_W7.62mm_LongPads | MPN specified; stock not checked | | Standby by default. JP1 open; firmware listen-only. Not a silent normal-mode transceiver.
PCB | 5 | 0 | SN74HCT08N | SN74HCT08N | U9, U10, U11, U16, U17 | Package_DIP:DIP-14_W7.62mm_LongPads | MPN specified; stock not checked
PCB | 4 | 0 | CD74HCT221E | CD74HCT221E | U12, U13, U14, U15 | Package_DIP:DIP-16_W7.62mm_LongPads | MPN specified; stock not checked | | Industrial part. Non-retriggerable. Pulse cutoff is an independent ceiling, not a qualified safety mechanism.
Board / modules | 1 | 0 | Fabricated A4-N16R8 provisional PCB | HOLD: no A4 fabrication release; module fit/RF checks pending | Carrier | 120 x 120 x 1.6 mm; six copper layers | Select exact part for fit | Prototype; review fabrication notes and generic BOM selections before ordering
Board / modules | 2 | 0 | ESP32 female socket strips | 1x22, 2.54 mm, through-hole | U3 left/right socket rows | Two strips; row spacing 22.86 mm | Select exact part for fit | Required in addition to the DevKit. No DIP IC sockets are required; check actual mating height.
Board / modules | 0 | 2 | DevKit male pin strips if not supplied | 1x22, 2.54 mm, through-hole | Only for an unpinned DevKit | Two matching strips | Select exact part for fit | Do not order extra if the DevKit already has the required pins.
Harness | 3 | 0 | Mating crimp housing | VHR-2N | J1, J19, J20 | JST VH 3.96 mm | Manufacturer family identified; stock not checked | Board headers are already counted in the PCB section. These are the cable-side housings.
Harness | 1 | 0 | Mating crimp housing | VHR-4N | J8 | JST VH 3.96 mm | Manufacturer family identified; stock not checked | Board headers are already counted in the PCB section. These are the cable-side housings.
Harness | 1 | 0 | Mating crimp housing | VHR-5N | J10 | JST VH 3.96 mm | Manufacturer family identified; stock not checked | Board headers are already counted in the PCB section. These are the cable-side housings.
Harness | 1 | 0 | Mating crimp housing | VHR-8N | J9 | JST VH 3.96 mm | Manufacturer family identified; stock not checked | Board headers are already counted in the PCB section. These are the cable-side housings.
Harness | 8 | 0 | Mating crimp housing | XHP-3 | J11, J12, J13, J14, J15, J16, J17, J18 | JST XH 2.50 mm | Manufacturer family identified; stock not checked | Board headers are already counted in the PCB section. These are the cable-side housings.
Harness | 1 | 0 | Mating crimp housing | XHP-4 | J7 | JST XH 2.50 mm | Manufacturer family identified; stock not checked | Board headers are already counted in the PCB section. These are the cable-side housings.
Harness | 28 | 0 | JST XH crimp contacts | SXH-001T-P0.6 | All XH mating housings | AWG 28-22; use matching crimp tooling | Contact family identified; match actual wire | Maximum all-cavity count, without spares. Populate only the pins used by the actual sensor wiring.
Harness | 23 | 0 | JST VH crimp contacts | SVH-21T-P1.1 OR SVH-41T-P1.1 | All VH mating housings | 21T: AWG 22-18; 41T: AWG 20-16 | Wire-dependent selection required | This is one combined quantity across both options, not this quantity of each. Choose by actual wire gauge and load; maximum all-cavity count without spares.
Harness | 2 | 0 | Five-position service plug | 1x5 female crimp housing + matching contacts | J2 UART and J4 expansion | 2.54 mm single row | Select exact part for fit | Internal service only. J2 uses 3.3 V logic and no adapter power wire.
Harness | 1 | 0 | Interlock mating plug | 1x2 female crimp housing + matching contacts | J3 | 2.54 mm single row | Select exact part for fit | Keep open during bench service; optional switch is a normally-open dry contact.
Harness | 0 | 2 | Jumper shunt caps | 2.54 mm two-pin shunt | JP1 receive enable / JP2 termination | Standard 2.54 mm pitch | Select exact part for fit | Normally open. Fit only as described in the manual.
Enclosure | 4 | 0 | M3 x 6 mm pan-head screws | M3 x 6 mm pan-head screws | PCB mounts, with 0.8 mm nylon washers | See enclosure/a3/dimensions.json and assembly manual | Select exact part for fit
Enclosure | 4 | 0 | M3 nylon washers, 0.8 mm thick, about 6 mm OD | M3 nylon washers, 0.8 mm thick, about 6 mm OD | Insulate PCB screw heads | See enclosure/a3/dimensions.json and assembly manual | Select exact part for fit
Enclosure | 8 | 0 | M3 x 8 mm pan-head screws | M3 x 8 mm pan-head screws | Lid; use the specified washers | See enclosure/a3/dimensions.json and assembly manual | Select exact part for fit
Enclosure | 8 | 0 | M3 flat washers, 0.8 mm thick | M3 flat washers, 0.8 mm thick | Lid clamping | See enclosure/a3/dimensions.json and assembly manual | Select exact part for fit
Enclosure | 14 | 0 | ruthex RX-M3Sx4.0 short heat-set inserts | ruthex RX-M3Sx4.0 short heat-set inserts | 4 PCB + 8 lid + 2 internal shield bonds; 4.0 mm nominal bore | See enclosure/a3/dimensions.json and assembly manual | Select exact part for fit
Enclosure | 1 | 0 | 2.0 mm soft closed-cell silicone gasket sheet | 2.0 mm soft closed-cell silicone gasket sheet | Cut one continuous 3 mm wide ring using template; nominal 25% compression | See enclosure/a3/dimensions.json and assembly manual | Select exact part for fit
Enclosure | 4 | 0 | M16 cable glands or gasketed blanking plugs | M16 cable glands or gasketed blanking plugs | Match jacket OD and use panel sealing washers; no loose wires through single-hole glands | See enclosure/a3/dimensions.json and assembly manual | Select exact part for fit
Enclosure | 2 | 0 | Internal bond screws | M3 x 5 mm pan-head | Base and lid shield-bond bosses | Use the specified terminal/washer stack | Select exact part for fit
Enclosure | 1 | 0 | PCB shield-lug bolt | M3 x 6 mm | H5 | Check underside nut clearance | Select exact part for fit
Enclosure | 1 | 0 | PCB shield-lug nut | M3 nut | H5 | Check underside clearance | Select exact part for fit
Enclosure | 3 | 0 | Shield-bond ring terminals | M3 hole; match the selected bond conductor | H5, internal base and lid bonds | Use the specified stack thickness | Select exact part for fit
Enclosure | 3 | 0 | Shield-bond star washers | M3 | H5, internal base and lid bonds | Ensure electrical contact without an unsealed wall penetration | Select exact part for fit
Enclosure | 1 | 0 | Conductive lining and bond set | Conductive foil/coating + conductive seam bonds + insulated braid | Base/lid lining, J20/H5 and internal bonds | Cut/fit to supplied templates | Select exact part for fit | Quantity is one build set; select actual material and wire length after checking fit. Keep clear of gasket and electronics.
Enclosure | 1 | 0 | Print-material allowance | Suitable filament for actual temperature, fluids and printer | Base, lid, tray, lid insulator and coupon | Use enclosure/a3 STL/STEP | Select exact part for fit | Quantity is one print set, not one kilogram; slicer determines mass. Gasket and conductive lining are separate materials.
External / bench | 1 | 0 | External logic-supply fuse and holder | 1 A fuse + compatible inline holder | J1 fused 12 V input | Off-board | Select exact part for fit | Fuse characteristic/voltage/interruption rating and wire protection need actual installation review.
External / bench | 1 | 0 | Bench programming / diagnostic adapter | 3.3 V logic USB-UART, 115200 baud | J2 | Off-board equipment | Select exact part for fit | Do not connect adapter power; remove carrier-powered DevKit before powering its USB port.
External / bench | 1 | 0 | Bench supply and measurement tools | Current-limited 12 V supply, multimeter and suitably referenced oscilloscope | Commissioning | Off-board equipment | Select exact part for fit | Equipment allowance only, not per-board installed parts.
Wireless accessories | 1 | 0 | Separate WS2812 status module | Select exact part | GPIO38 / U3 pad32 | 3.3V-data-compatible; verify supply and decoupling | Exact part / physical fit selection required | See docs/espnow.md; not a PCB fitted reference.
Wireless accessories | 1 | 0 | Sealed two-button momentary pendant | Select exact part | J2 pins 1, 4, 5 | PAIR/BOOT and RESET dry contacts; round jacketed cable and matched gland | Exact part / physical fit selection required | See docs/espnow.md; not a PCB fitted reference.
Wireless accessories | 1 | 0 | Sealed transparent indicator window | Select exact part | External status visibility | Select lens/window and adhesive for actual case; leak test required | Exact part / physical fit selection required | See docs/espnow.md; not a PCB fitted reference.
