markthebault/esp32-ecu/hardware/a6-flex-rgb/connector-pinout.csv

Connector | Label | PCB pin | Net | Mating housing | Contact populated | Guidance
J1 | FUSED_KEY_12V | 1 | VBAT_FUSED | VHR-2N | True | Carrier pin only; consult existing sensor/idle/service guides
J1 | FUSED_KEY_12V | 2 | GND | VHR-2N | True | Carrier pin only; consult existing sensor/idle/service guides
J2 | UART_FLASH_3V3_ONLY | 1 | GND | 2.54mm service header | True | Carrier pin only; consult existing sensor/idle/service guides
J2 | UART_FLASH_3V3_ONLY | 2 | UART_TX | 2.54mm service header | True | Carrier pin only; consult existing sensor/idle/service guides
J2 | UART_FLASH_3V3_ONLY | 3 | UART_RX | 2.54mm service header | True | Carrier pin only; consult existing sensor/idle/service guides
J2 | UART_FLASH_3V3_ONLY | 4 | EN | 2.54mm service header | True | Carrier pin only; consult existing sensor/idle/service guides
J2 | UART_FLASH_3V3_ONLY | 5 | BOOT_N | 2.54mm service header | True | Carrier pin only; consult existing sensor/idle/service guides
J3 | NORMALLY_OPEN_INTERLOCK | 1 | +3V3 | 2.54mm service header | True | Carrier pin only; consult existing sensor/idle/service guides
J3 | NORMALLY_OPEN_INTERLOCK | 2 | INTERLOCK | 2.54mm service header | True | Carrier pin only; consult existing sensor/idle/service guides
J4 | EXPANSION_3V3 | 1 | GND | 2.54mm service header | True | Carrier pin only; consult existing sensor/idle/service guides
J4 | EXPANSION_3V3 | 2 | +3V3 | 2.54mm service header | True | Carrier pin only; consult existing sensor/idle/service guides
J4 | EXPANSION_3V3 | 3 | I2C_SDA | 2.54mm service header | True | Carrier pin only; consult existing sensor/idle/service guides
J4 | EXPANSION_3V3 | 4 | I2C_SCL | 2.54mm service header | True | Carrier pin only; consult existing sensor/idle/service guides
J4 | EXPANSION_3V3 | 5 | SAFE_N | 2.54mm service header | True | Carrier pin only; consult existing sensor/idle/service guides
J7 | CAN_H_L_G_SHIELD | 1 | CANH | XHP-4 | True | Carrier pin only; consult existing sensor/idle/service guides
J7 | CAN_H_L_G_SHIELD | 2 | CANL | XHP-4 | True | Carrier pin only; consult existing sensor/idle/service guides
J7 | CAN_H_L_G_SHIELD | 3 | GND | XHP-4 | True | Carrier pin only; consult existing sensor/idle/service guides
J7 | CAN_H_L_G_SHIELD | 4 | CHASSIS | XHP-4 | True | Carrier pin only; consult existing sensor/idle/service guides
J8 | EXTERNAL_RELAYS | 1 | MAIN_LS | VHR-4N | True | Carrier pin only; consult existing sensor/idle/service guides
J8 | EXTERNAL_RELAYS | 2 | PUMP_LS | VHR-4N | True | Carrier pin only; consult existing sensor/idle/service guides
J8 | EXTERNAL_RELAYS | 3 | FAN_LS | VHR-4N | True | Carrier pin only; consult existing sensor/idle/service guides
J8 | EXTERNAL_RELAYS | 4 | GND | VHR-4N | True | Carrier pin only; consult existing sensor/idle/service guides
J9 | INJECTOR_LOW_SIDES | 1 | INJ1_LS | VHR-8N | True | Carrier pin only; consult existing sensor/idle/service guides
J9 | INJECTOR_LOW_SIDES | 2 | INJ2_LS | VHR-8N | True | Carrier pin only; consult existing sensor/idle/service guides
J9 | INJECTOR_LOW_SIDES | 3 | INJ3_LS | VHR-8N | True | Carrier pin only; consult existing sensor/idle/service guides
J9 | INJECTOR_LOW_SIDES | 4 | INJ4_LS | VHR-8N | True | Carrier pin only; consult existing sensor/idle/service guides
J9 | INJECTOR_LOW_SIDES | 5 | GND | VHR-8N | True | Carrier pin only; consult existing sensor/idle/service guides
J9 | INJECTOR_LOW_SIDES | 6 | GND | VHR-8N | True | Carrier pin only; consult existing sensor/idle/service guides
J9 | INJECTOR_LOW_SIDES | 7 | GND | VHR-8N | True | Carrier pin only; consult existing sensor/idle/service guides
J9 | INJECTOR_LOW_SIDES | 8 | GND | VHR-8N | True | Carrier pin only; consult existing sensor/idle/service guides
J10 | SMART_COIL_5V_LOGIC | 1 | IGN1_5V | VHR-5N | True | Carrier pin only; consult existing sensor/idle/service guides
J10 | SMART_COIL_5V_LOGIC | 2 | IGN2_5V | VHR-5N | True | Carrier pin only; consult existing sensor/idle/service guides
J10 | SMART_COIL_5V_LOGIC | 3 | IGN3_5V | VHR-5N | True | Carrier pin only; consult existing sensor/idle/service guides
J10 | SMART_COIL_5V_LOGIC | 4 | IGN4_5V | VHR-5N | True | Carrier pin only; consult existing sensor/idle/service guides
J10 | SMART_COIL_5V_LOGIC | 5 | GND | VHR-5N | True | Carrier pin only; consult existing sensor/idle/service guides
J11 | MAP | 1 | GND | XHP-3 | True | Carrier pin only; consult existing sensor/idle/service guides
J11 | MAP | 2 | SENSOR_5V | XHP-3 | True | Carrier pin only; consult existing sensor/idle/service guides
J11 | MAP | 3 | MAP | XHP-3 | True | Carrier pin only; consult existing sensor/idle/service guides
J12 | TPS | 1 | GND | XHP-3 | True | Carrier pin only; consult existing sensor/idle/service guides
J12 | TPS | 2 | SENSOR_5V | XHP-3 | True | Carrier pin only; consult existing sensor/idle/service guides
J12 | TPS | 3 | TPS | XHP-3 | True | Carrier pin only; consult existing sensor/idle/service guides
J13 | CLT | 1 | GND | XHP-3 | True | Carrier pin only; consult existing sensor/idle/service guides
J13 | CLT | 2 | SENSOR_5V | XHP-3 | True | Carrier pin only; consult existing sensor/idle/service guides
J13 | CLT | 3 | CLT | XHP-3 | True | Carrier pin only; consult existing sensor/idle/service guides
J14 | IAT | 1 | GND | XHP-3 | True | Carrier pin only; consult existing sensor/idle/service guides
J14 | IAT | 2 | SENSOR_5V | XHP-3 | True | Carrier pin only; consult existing sensor/idle/service guides
J14 | IAT | 3 | IAT | XHP-3 | True | Carrier pin only; consult existing sensor/idle/service guides
J15 | LAMBDA_WB | 1 | GND | XHP-3 | True | Carrier pin only; consult existing sensor/idle/service guides
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
