markthebault/esp32-ecu/enclosure/a2/lid.step

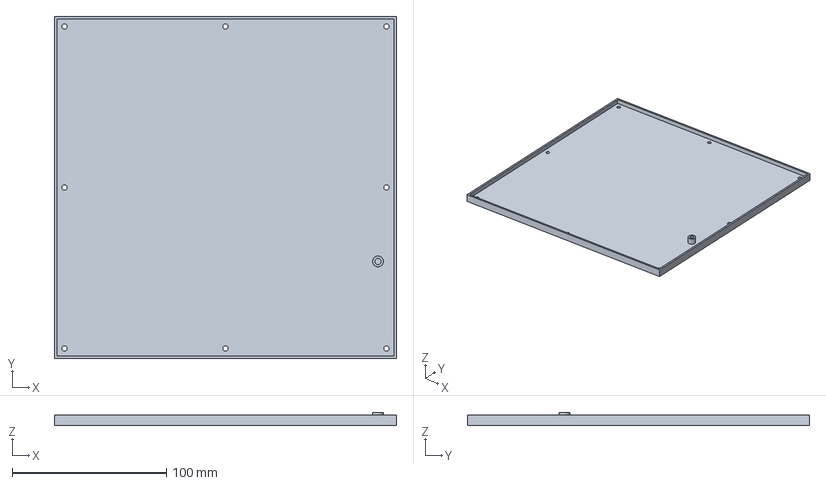
[picture p120: CAD file, 2026-10-30]
enclosure/a2/lid.step
222.0 x 222.0 x 8.50 mm
