markthebault/esp32-ecu/enclosure/a3/insert_fit_coupon.step

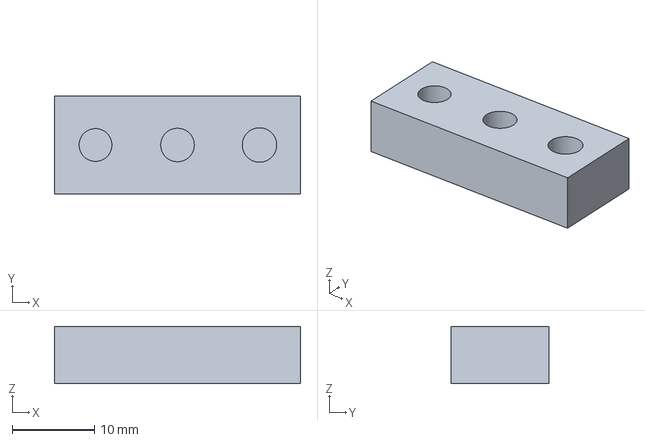
[picture p121: CAD file, 2026-10-30]
enclosure/a3/insert_fit_coupon.step
30.0 x 12.0 x 7.00 mm
