markthebault/esp32-ecu/enclosure/cable_blank.step

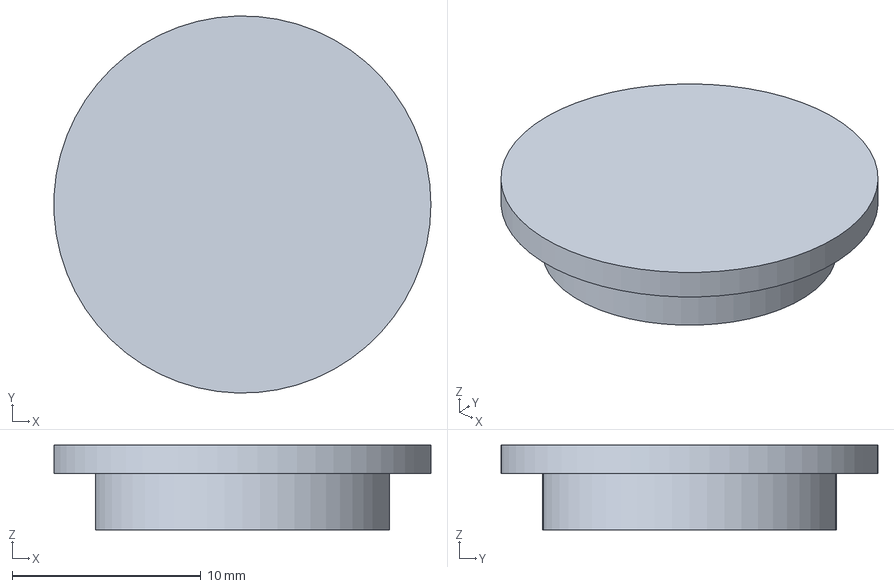
[picture p122: CAD file, 2026-10-30]
enclosure/cable_blank.step
20.0 x 20.0 x 4.50 mm
