markthebault/esp32-ecu/enclosure/a2/base.step

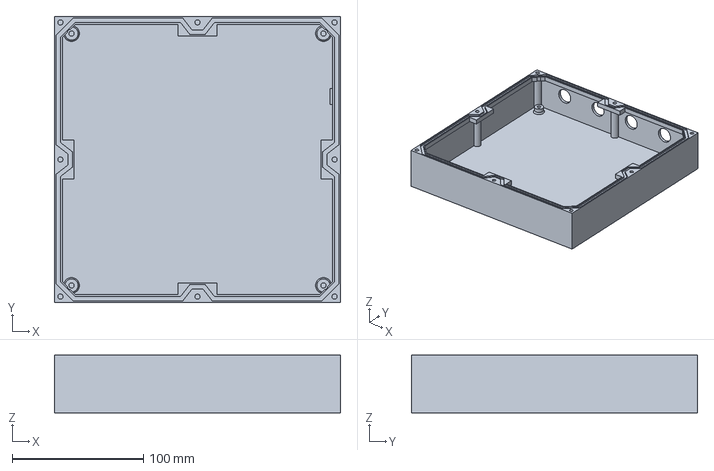
[picture p123: CAD file, 2026-10-30]
enclosure/a2/base.step
218.0 x 218.0 x 44.0 mm
