markthebault/esp32-ecu/enclosure/a3/base.step

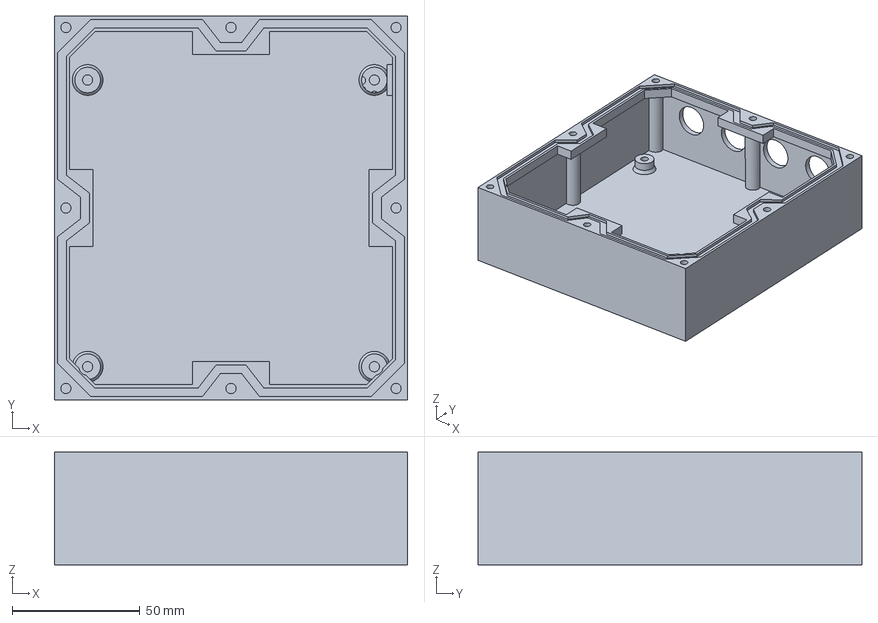
[picture p124: CAD file, 2026-10-30]
enclosure/a3/base.step
138.0 x 150.0 x 44.0 mm
