markthebault/esp32-ecu/enclosure/ecu-a1-enclosure.FCStd

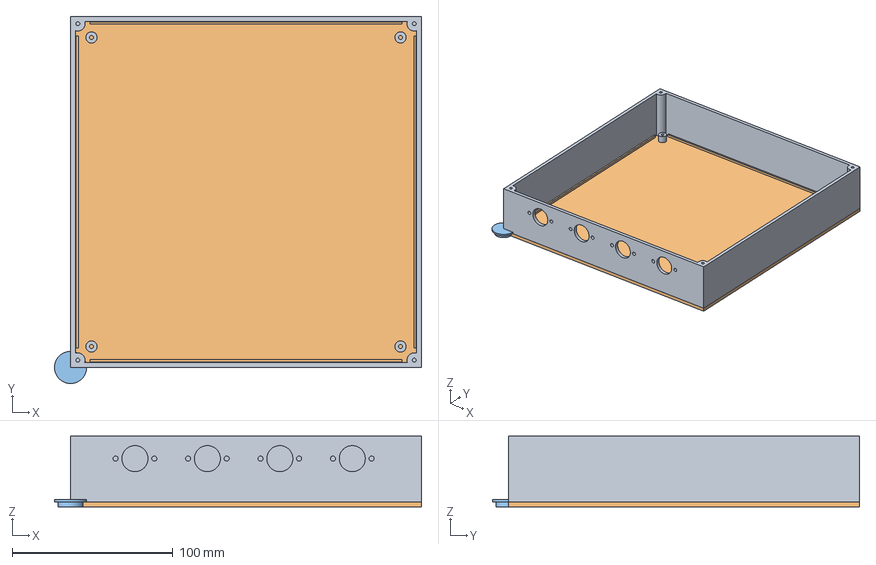
[picture p125: CAD file, 2026-10-30]
enclosure/ecu-a1-enclosure.FCStd
228.0 x 228.0 x 44.0 mm
base
lid
cable_blank
