markthebault/esp32-ecu/enclosure/a2/ecu-a2-enclosure.FCStd

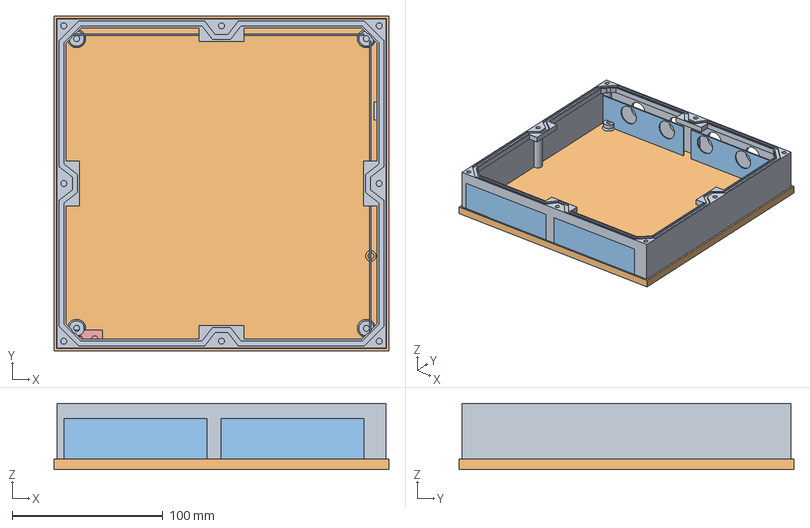
[picture p126: CAD file, 2026-10-30]
enclosure/a2/ecu-a2-enclosure.FCStd
222.0 x 222.0 x 44.0 mm
base
lid
insulating_tray
lid_insulator
insert_fit_coupon
Gasket_SHEET_REFERENCE_DO_NOT_PRINT
