markthebault/esp32-ecu/enclosure/a3/lid.step

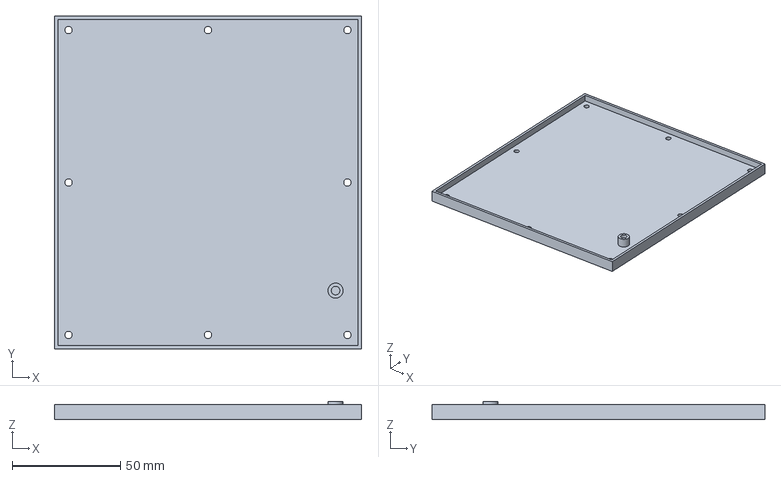
[picture p127: CAD file, 2026-10-30]
enclosure/a3/lid.step
142.0 x 154.0 x 8.50 mm
