markthebault/esp32-ecu/enclosure/lid.step

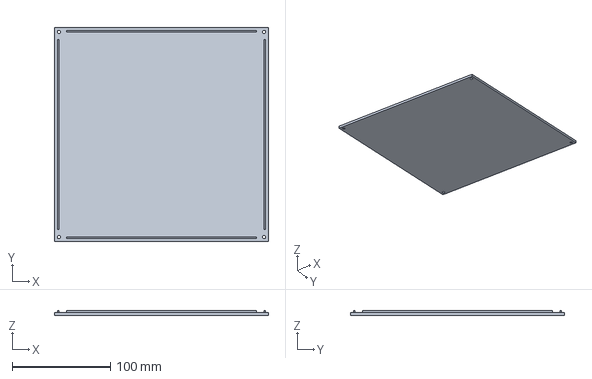
[picture p128: CAD file, 2026-10-30]
enclosure/lid.step
218.0 x 218.0 x 5.00 mm
