markthebault/esp32-ecu/enclosure/a2/insulating_tray.step

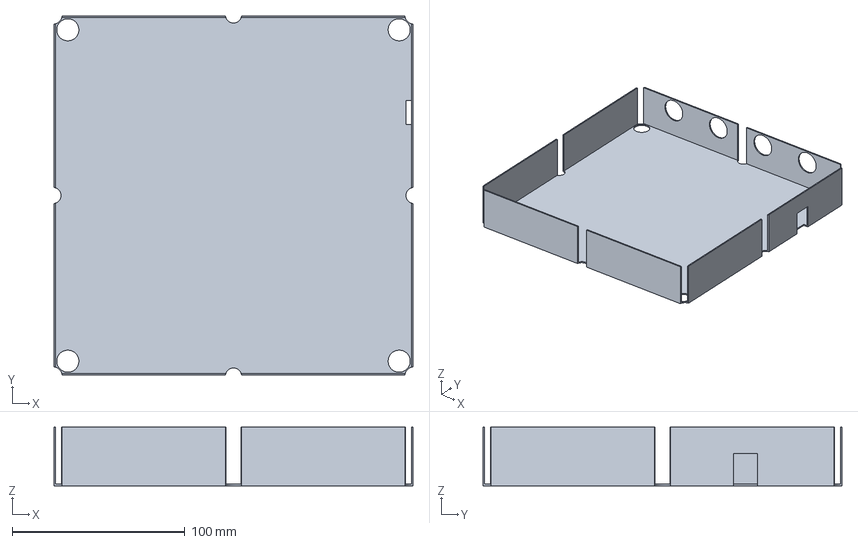
[picture p129: CAD file, 2026-10-30]
enclosure/a2/insulating_tray.step
208.0 x 208.0 x 34.0 mm
