markthebault/esp32-ecu/enclosure/a3/lid_insulator.step

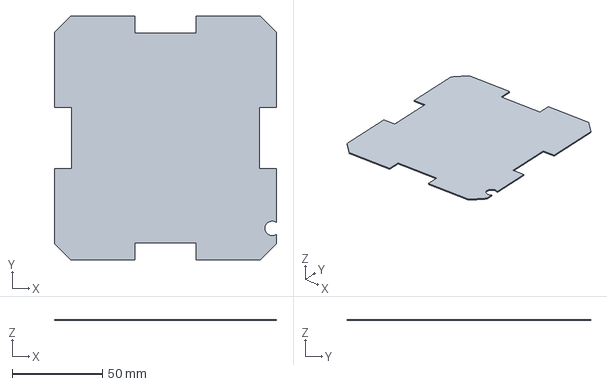
[picture p130: CAD file, 2026-10-30]
enclosure/a3/lid_insulator.step
123.0 x 135.0 x 0.8 mm
