markthebault/esp32-ecu/enclosure/base.step

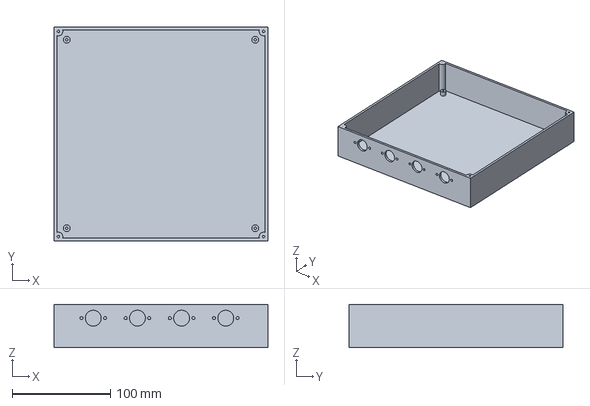
[picture p131: CAD file, 2026-10-30]
enclosure/base.step
218.0 x 218.0 x 44.0 mm
