markthebault/esp32-ecu/enclosure/a3/ecu-a3-enclosure.FCStd

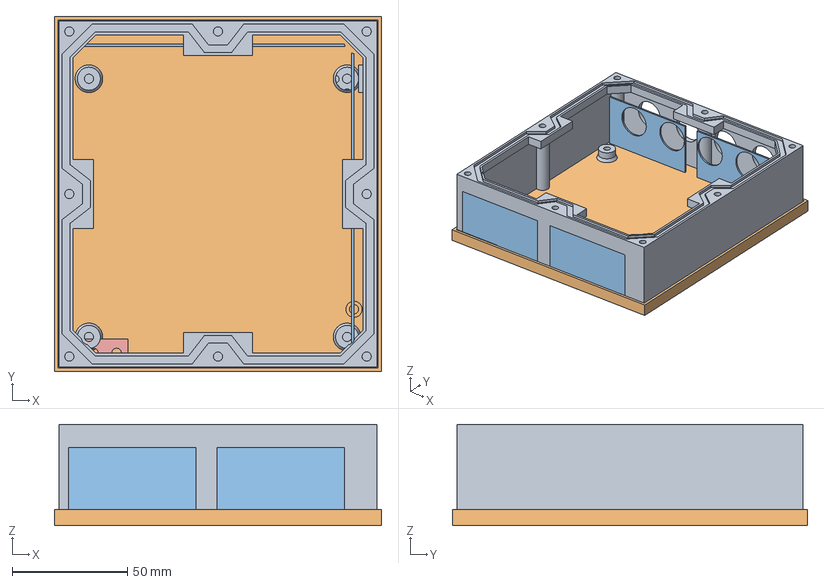
[picture p132: CAD file, 2026-10-30]
enclosure/a3/ecu-a3-enclosure.FCStd
142.0 x 154.0 x 44.0 mm
base
lid
insulating_tray
lid_insulator
insert_fit_coupon
Gasket_SHEET_REFERENCE_DO_NOT_PRINT
