markthebault/esp32-ecu/enclosure/a2/gasket-sheet-reference.step

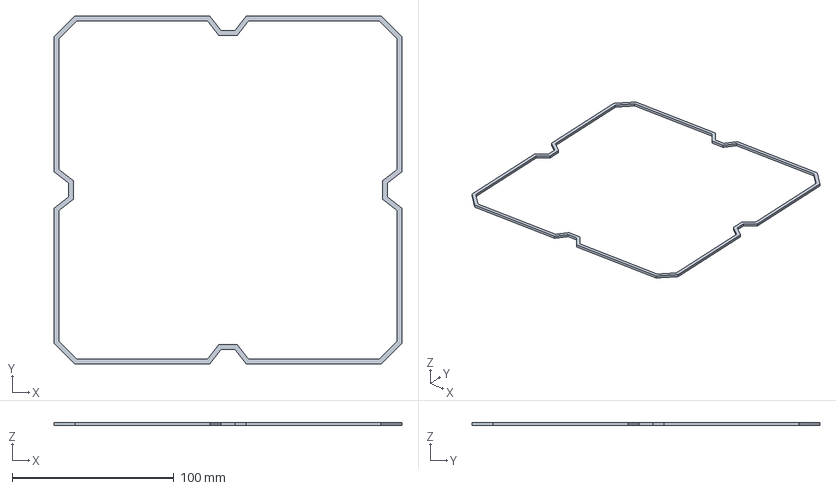
[picture p133: CAD file, 2026-10-30]
enclosure/a2/gasket-sheet-reference.step
215.0 x 215.0 x 2.00 mm
