markthebault/esp32-ecu/enclosure/a3/gasket-sheet-reference.step

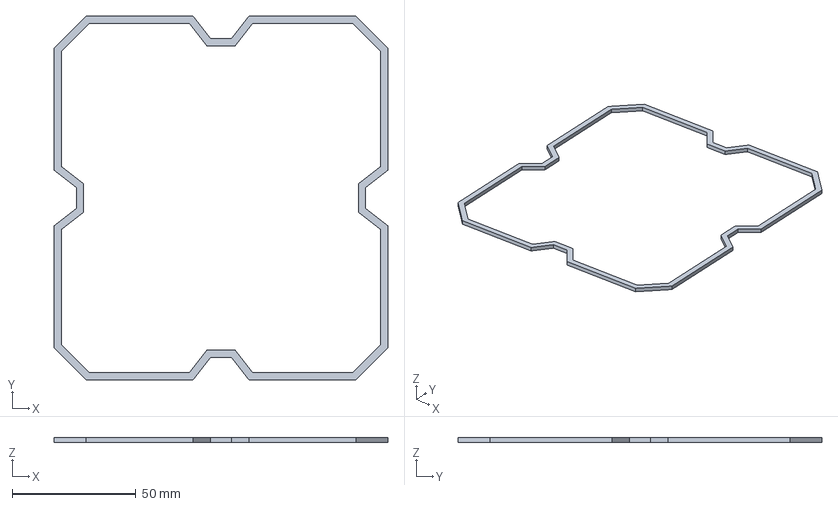
[picture p134: CAD file, 2026-10-30]
enclosure/a3/gasket-sheet-reference.step
135.0 x 147.0 x 2.00 mm
