markthebault/esp32-ecu/enclosure/a2/lid_insulator.step

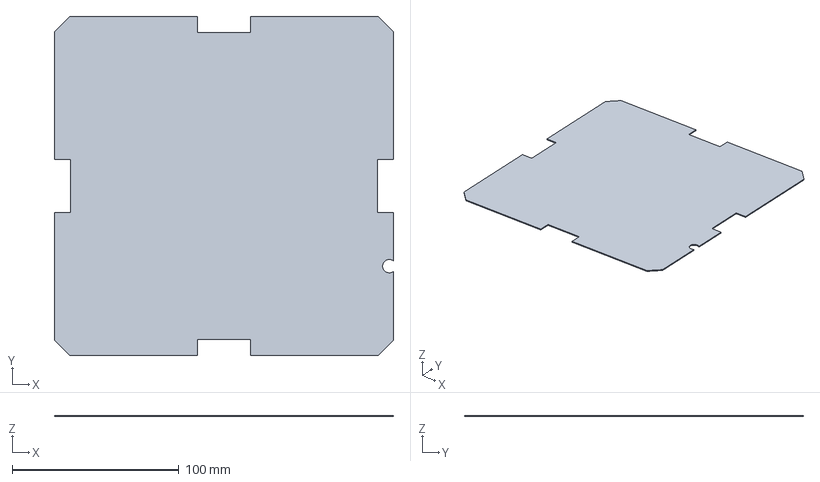
[picture p135: CAD file, 2026-10-30]
enclosure/a2/lid_insulator.step
203.0 x 203.0 x 0.8 mm
