markthebault/esp32-ecu/enclosure/a3/insulating_tray.step

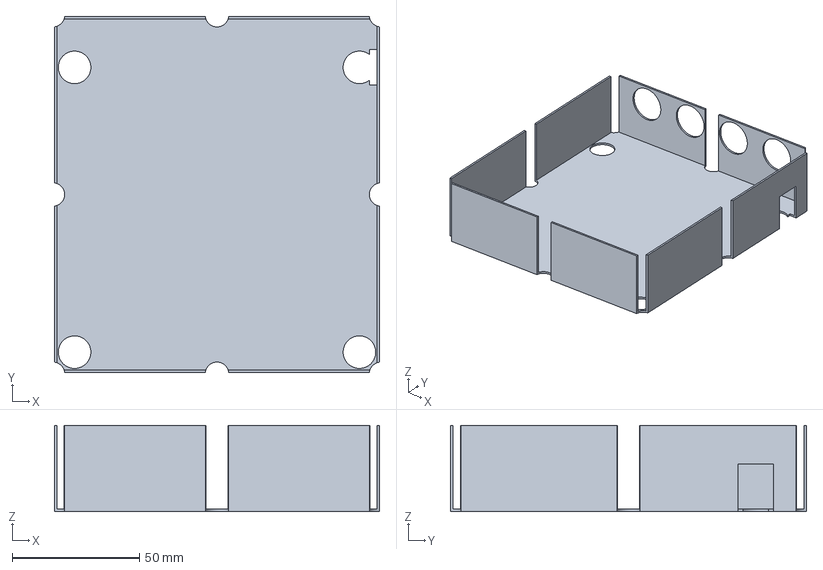
[picture p136: CAD file, 2026-10-30]
enclosure/a3/insulating_tray.step
128.0 x 140.0 x 34.0 mm
