markthebault/esp32-ecu/(list of files, cad)

Other CAD files:
enclosure/a2/insert_fit_coupon.step
enclosure/a2/base.stl
enclosure/a2/enclosure.blend
enclosure/a2/insert_fit_coupon.stl
enclosure/a2/insulating_tray.stl
enclosure/a2/lid.stl
enclosure/a2/lid_insulator.stl
enclosure/a3/base.stl
enclosure/a3/enclosure.blend
enclosure/a3/insert_fit_coupon.stl
enclosure/a3/insulating_tray.stl
enclosure/a3/lid.stl
enclosure/a3/lid_insulator.stl
enclosure/base.stl
enclosure/cable_blank.stl
enclosure/enclosure.blend
enclosure/lid.stl
