markthebault/esp32-ecu/reports/firmware-build.txt

ESP32-S3 / espressif32@6.12.0 / ESP-IDF 5.5.0
esp32s3: compiled, 264464 bytes, SHA256 539e71b45f6cc1070b2fd9d475e0188d4a79a89514ef675c7632a7a2e9338b8c; not executed on hardware
bench: compiled, 266000 bytes, SHA256 15c5009ab0b1aec3b23d4a09d636cf455a45cc928057ae5f1aa4448a000d51e3; not executed on hardware
