markthebault/esp32-ecu/reports/engine/flex-integration/build/isr-bench/closure-disassembly.txt

4037f510 <mcpwm_capture_default_isr>:
4037f510: 006136 entry	a1, 48
4037f513: 012282 l32i	a8, a2, 4
4037f516: 0028c2 l32i	a12, a8, 0
4037f519: 0022b2 l32i	a11, a2, 0
4037f51c: 2cd8 l32i.n	a13, a12, 8
4037f51e: 0020c0 memw
4037f521: 462de2 l32i	a14, a13, 0x118
4037f524: 1bcb82 addi	a8, a11, 27
4037f527: 190c movi.n	a9, 1
4037f529: 401800 ssl	a8
4037f52c: a18900 sll	a8, a9
4037f52f: 1088e0 and	a8, a8, a14
4037f532: 0020c0 memw
4037f535: 476d82 s32i	a8, a13, 0x11c
4037f538: 2cd8 l32i.n	a13, a12, 8
4037f53a: 3ccbc2 addi	a12, a11, 60
4037f53d: a0ccd0 addx4	a12, a12, a13
4037f540: 0020c0 memw
4037f543: 3cc8 l32i.n	a12, a12, 12
4037f545: 01c9 s32i.n	a12, a1, 0
4037f547: 0020c0 memw
4037f54a: 422dc2 l32i	a12, a13, 0x108
4037f54d: 401b00 ssl	a11
4037f550: a1b900 sll	a11, a9
4037f553: 10bcb0 and	a11, a12, a11
4037f556: 0c0c movi.n	a12, 0
4037f558: 839cb0 moveqz	a9, a12, a11
4037f55b: 1199 s32i.n	a9, a1, 4
4037f55d: 089c beqz.n	a8, 4037f571 <mcpwm_capture_default_isr+0x61>
4037f55f: 6288 l32i.n	a8, a2, 24
4037f561: c88c beqz.n	a8, 4037f571 <mcpwm_capture_default_isr+0x61>
4037f563: 72c8 l32i.n	a12, a2, 28
4037f565: 01bd mov.n	a11, a1
4037f567: 02ad mov.n	a10, a2
4037f569: 0008e0 callx8	a8
4037f56c: 1a8c beqz.n	a10, 4037f571 <mcpwm_capture_default_isr+0x61>
4037f56e: 02d525 call8	403822c0 <_frxt_setup_switch>
4037f571: f01d retw.n

403822c0 <_frxt_setup_switch>:
403822c0: 002136 entry	a1, 16
403822c3: 03eb30 rsr.prid	a3
403822c6: 043d30 extui	a3, a3, 13, 1
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
403767a1: 080c movi.n	a8, 0
403767a3: 8189 s32i.n	a8, a1, 32
403767a5: 9189 s32i.n	a8, a1, 36
403767a7: f72281 l32r	a8, 40374430 <_iram_text_start+0x2c> (3fcbca08 <ecu::engine_target::(anonymous namespace)::timer>)
403767aa: 08a8 l32i.n	a10, a8, 0
403767ac: cacc bnez.n	a10, 403767bc <ecu::engine_target::(anonymous namespace)::on_alarm(gptimer_t*, gptimer_alarm_event_data_t const*, void*)+0x17c>
403767ae: 000406 j	403767c2 <ecu::engine_target::(anonymous namespace)::on_alarm(gptimer_t*, gptimer_alarm_event_data_t const*, void*)+0x182>
403767b1: f72781 l32r	a8, 40374450 <_iram_text_start+0x4c> (3fcb6f08 <ecu::engine_target::(anonymous namespace)::idle_output>)
403767b4: 090c movi.n	a9, 0
403767b6: 004892 s8i	a9, a8, 0
403767b9: 003b06 j	403768a9 <ecu::engine_target::(anonymous namespace)::on_alarm(gptimer_t*, gptimer_alarm_event_data_t const*, void*)+0x269>
403767bc: 20c1b2 addi	a11, a1, 32
403767bf: 0886a5 call8	4037f028 <gptimer_get_raw_count>
403767c2: 81a8 l32i.n	a10, a1, 32
403767c4: 91b8 l32i.n	a11, a1, 36
403767c6: f72181 l32r	a8, 4037444c <_iram_text_start+0x48> (3fcb6f10 <ecu::engine_target::(anonymous namespace)::idle_executor>)
403767c9: a808c2 l8ui	a12, a8, 168
403767cc: 1ccc bnez.n	a12, 403767d1 <ecu::engine_target::(anonymous namespace)::on_alarm(gptimer_t*, gptimer_alarm_event_data_t const*, void*)+0x191>
403767ce: a908c2 l8ui	a12, a8, 169
403767d1: f71f81 l32r	a8, 40374450 <_iram_text_start+0x4c> (3fcb6f08 <ecu::engine_target::(anonymous namespace)::idle_output>)
403767d4: 090c movi.n	a9, 0
403767d6: 004892 s8i	a9, a8, 0
403767d9: f71c81 l32r	a8, 4037444c <_iram_text_start+0x48> (3fcb6f10 <ecu::engine_target::(anonymous namespace)::idle_executor>)
403767dc: a90882 l8ui	a8, a8, 169
403767df: 789c beqz.n	a8, 403767fa <ecu::engine_target::(anonymous namespace)::on_alarm(gptimer_t*, gptimer_alarm_event_data_t const*, void*)+0x1ba>
403767e1: f71a81 l32r	a8, 4037444c <_iram_text_start+0x48> (3fcb6f10 <ecu::engine_target::(anonymous namespace)::idle_executor>)
403767e4: 142892 l32i	a9, a8, 80
403767e7: 1528e2 l32i	a14, a8, 84
403767ea: 0edd mov.n	a13, a14
403767ec: f91b addi.n	a15, a9, 1
403767ee: 020966 bnei	a9, -1, 403767f4 <ecu::engine_target::(anonymous namespace)::on_alarm(gptimer_t*, gptimer_alarm_event_data_t const*, void*)+0x1b4>
403767f1: 01ced2 addi	a13, a14, 1
403767f4: 1468f2 s32i	a15, a8, 80
403767f7: 1568d2 s32i	a13, a8, 84
403767fa: f71481 l32r	a8, 4037444c <_iram_text_start+0x48> (3fcb6f10 <ecu::engine_target::(anonymous namespace)::idle_executor>)
403767fd: 090c movi.n	a9, 0
403767ff: a94892 s8i	a9, a8, 169
40376802: a84892 s8i	a9, a8, 168
40376805: 0d0c movi.n	a13, 0
40376807: 2968d2 s32i	a13, a8, 164
4037680a: 2268a2 s32i	a10, a8, 136
4037680d: 2368b2 s32i	a11, a8, 140
40376810: fb7c movi.n	a11, -1
40376812: 3068b2 s32i	a11, a8, 192
40376815: 3168b2 s32i	a11, a8, 196
40376818: 2e68b2 s32i	a11, a8, 184
4037681b: 2f68b2 s32i	a11, a8, 188
4037681e: 2c68b2 s32i	a11, a8, 176
40376821: 2d68b2 s32i	a11, a8, 180
40376824: e94892 s8i	a9, a8, 233
40376827: 3c9c beqz.n	a12, 4037683e <ecu::engine_target::(anonymous namespace)::on_alarm(gptimer_t*, gptimer_alarm_event_data_t const*, void*)+0x1fe>
40376829: 182892 l32i	a9, a8, 96
4037682c: 1928b2 l32i	a11, a8, 100
4037682f: 0bad mov.n	a10, a11
40376831: c91b addi.n	a12, a9, 1
40376833: 010966 bnei	a9, -1, 40376838 <ecu::engine_target::(anonymous namespace)::on_alarm(gptimer_t*, gptimer_alarm_event_data_t const*, void*)+0x1f8>
40376836: ab1b addi.n	a10, a11, 1
40376838: 1868c2 s32i	a12, a8, 96
4037683b: 1968a2 s32i	a10, a8, 100
4037683e: f70381 l32r	a8, 4037444c <_iram_text_start+0x48> (3fcb6f10 <ecu::engine_target::(anonymous namespace)::idle_executor>)
40376841: 390c movi.n	a9, 3
40376843: ab4892 s8i	a9, a8, 171
40376846: 0017c6 j	403768a9 <ecu::engine_target::(anonymous namespace)::on_alarm(gptimer_t*, gptimer_alarm_event_data_t const*, void*)+0x269>
40376849: f6f391 l32r	a9, 40374418 <_iram_text_start+0x14> (3fcb7600 <ecu::engine_target::(anonymous namespace)::executor+0x600>)
4037684c: 280992 l8ui	a9, a9, 40
4037684f: 515987 bbc	a9, a8, 403768a4 <ecu::engine_target::(anonymous namespace)::on_alarm(gptimer_t*, gptimer_alarm_event_data_t const*, void*)+0x264>
40376852: c6a092 movi	a9, 198
40376855: 989a add.n	a9, a8, a9
40376857: f6f1a1 l32r	a10, 4037441c <_iram_text_start+0x18> (3fcb7000 <ecu::engine_target::(anonymous namespace)::executor>)
4037685a: b099a0 addx8	a9, a9, a10
4037685d: 0029a2 l32i	a10, a9, 0
40376860: 012992 l32i	a9, a9, 4
40376863: 133797 bltu	a7, a9, 4037687a <ecu::engine_target::(anonymous namespace)::on_alarm(gptimer_t*, gptimer_alarm_event_data_t const*, void*)+0x23a>
40376866: 029977 bne	a9, a7, 4037686c <ecu::engine_target::(anonymous namespace)::on_alarm(gptimer_t*, gptimer_alarm_event_data_t const*, void*)+0x22c>
40376869: 0d36a7 bltu	a6, a10, 4037687a <ecu::engine_target::(anonymous namespace)::on_alarm(gptimer_t*, gptimer_alarm_event_data_t const*, void*)+0x23a>
4037686c: c09790 sub	a9, a7, a9
4037686f: 01b6a7 bgeu	a6, a10, 40376874 <ecu::engine_target::(anonymous namespace)::on_alarm(gptimer_t*, gptimer_alarm_event_data_t const*, void*)+0x234>
40376872: 990b addi.n	a9, a9, -1
40376874: c0a6a0 sub	a10, a6, a10
40376877: 0000c6 j	4037687e <ecu::engine_target::(anonymous namespace)::on_alarm(gptimer_t*, gptimer_alarm_event_data_t const*, void*)+0x23e>
4037687a: 0a0c movi.n	a10, 0
4037687c: 0a9d mov.n	a9, a10
4037687e: 0e48f6 bgeui	a8, 4, 40376890 <ecu::engine_target::(anonymous namespace)::on_alarm(gptimer_t*, gptimer_alarm_event_data_t const*, void*)+0x250>
40376881: f6fcb1 l32r	a11, 40374474 <_iram_text_start+0x70> (3fcb7500 <ecu::engine_target::(anonymous namespace)::executor+0x500>)
40376884: 3e2bd2 l32i	a13, a11, 248
40376887: 3f2bc2 l32i	a12, a11, 252
4037688a: f6e2b1 l32r	a11, 40374414 <_iram_text_start+0x10> (3fcb75f8 <ecu::engine_target::(anonymous namespace)::executor+0x5f8>)
4037688d: 000186 j	40376897 <ecu::engine_target::(anonymous namespace)::on_alarm(gptimer_t*, gptimer_alarm_event_data_t const*, void*)+0x257>
40376890: f6e2b1 l32r	a11, 40374418 <_iram_text_start+0x14> (3fcb7600 <ecu::engine_target::(anonymous namespace)::executor+0x600>)
40376893: 0bd8 l32i.n	a13, a11, 0
40376895: 1bc8 l32i.n	a12, a11, 4
40376897: 053c97 bltu	a12, a9, 403768a0 <ecu::engine_target::(anonymous namespace)::on_alarm(gptimer_t*, gptimer_alarm_event_data_t const*, void*)+0x260>
4037689a: 0699c7 bne	a9, a12, 403768a4 <ecu::engine_target::(anonymous namespace)::on_alarm(gptimer_t*, gptimer_alarm_event_data_t const*, void*)+0x264>
4037689d: 03bda7 bgeu	a13, a10, 403768a4 <ecu::engine_target::(anonymous namespace)::on_alarm(gptimer_t*, gptimer_alarm_event_data_t const*, void*)+0x264>
403768a0: 0ba9 s32i.n	a10, a11, 0
403768a2: 1b99 s32i.n	a9, a11, 4
403768a4: 881b addi.n	a8, a8, 1
403768a6: 000046 j	403768ab <ecu::engine_target::(anonymous namespace)::on_alarm(gptimer_t*, gptimer_alarm_event_data_t const*, void*)+0x26b>
403768a9: 080c movi.n	a8, 0
403768ab: 9a88b6 bltui	a8, 8, 40376849 <ecu::engine_target::(anonymous namespace)::on_alarm(gptimer_t*, gptimer_alarm_event_data_t const*, void*)+0x209>
403768ae: f6da81 l32r	a8, 40374418 <_iram_text_start+0x14> (3fcb7600 <ecu::engine_target::(anonymous namespace)::executor+0x600>)
403768b1: 280882 l8ui	a8, a8, 40
403768b4: 055856 bnez	a8, 4037690d <ecu::engine_target::(anonymous namespace)::on_alarm(gptimer_t*, gptimer_alarm_event_data_t const*, void*)+0x2cd>
403768b7: f87c movi.n	a8, -1
403768b9: 8189 s32i.n	a8, a1, 32
403768bb: 9189 s32i.n	a8, a1, 36
403768bd: f6d781 l32r	a8, 4037441c <_iram_text_start+0x18> (3fcb7000 <ecu::engine_target::(anonymous namespace)::executor>)
403768c0: 000e06 j	403768fc <ecu::engine_target::(anonymous namespace)::on_alarm(gptimer_t*, gptimer_alarm_event_data_t const*, void*)+0x2bc>
403768c4: 010892 l8ui	a9, a8, 1
403768c7: e9ac beqz.n	a9, 403768f9 <ecu::engine_target::(anonymous namespace)::on_alarm(gptimer_t*, gptimer_alarm_event_data_t const*, void*)+0x2b9>
403768c9: 000892 l8ui	a9, a8, 0
403768cc: a98c beqz.n	a9, 403768da <ecu::engine_target::(anonymous namespace)::on_alarm(gptimer_t*, gptimer_alarm_event_data_t const*, void*)+0x29a>
403768ce: 10c892 addi	a9, a8, 16
403768d1: 48d8 l32i.n	a13, a8, 16
403768d3: 58a8 l32i.n	a10, a8, 20
403768d5: 0001c6 j	403768e0 <ecu::engine_target::(anonymous namespace)::on_alarm(gptimer_t*, gptimer_alarm_event_data_t const*, void*)+0x2a0>
403768da: 988b addi.n	a9, a8, 8
403768dc: 28d8 l32i.n	a13, a8, 8
403768de: 38a8 l32i.n	a10, a8, 12
403768e0: 81c8 l32i.n	a12, a1, 32
403768e2: 91b8 l32i.n	a11, a1, 36
403768e4: 083ab7 bltu	a10, a11, 403768f0 <ecu::engine_target::(anonymous namespace)::on_alarm(gptimer_t*, gptimer_alarm_event_data_t const*, void*)+0x2b0>
403768e7: 029ba7 bne	a11, a10, 403768ed <ecu::engine_target::(anonymous namespace)::on_alarm(gptimer_t*, gptimer_alarm_event_data_t const*, void*)+0x2ad>
403768ea: 023dc7 bltu	a13, a12, 403768f0 <ecu::engine_target::(anonymous namespace)::on_alarm(gptimer_t*, gptimer_alarm_event_data_t const*, void*)+0x2b0>
403768ed: 20c192 addi	a9, a1, 32
403768f0: 09a8 l32i.n	a10, a9, 0
403768f2: 19b8 l32i.n	a11, a9, 4
403768f4: 81a9 s32i.n	a10, a1, 32
403768f6: 0961b2 s32i	a11, a1, 36
403768f9: 38c882 addi	a8, a8, 56
403768fc: f6d691 l32r	a9, 40374454 <_iram_text_start+0x50> (3fcb71c0 <ecu::engine_target::(anonymous namespace)::executor+0x1c0>)
403768ff: c19897 bne	a8, a9, 403768c4 <ecu::engine_target::(anonymous namespace)::on_alarm(gptimer_t*, gptimer_alarm_event_data_t const*, void*)+0x284>
40376902: 8188 l32i.n	a8, a1, 32
40376904: 092192 l32i	a9, a1, 36
40376907: 020866 bnei	a8, -1, 4037690d <ecu::engine_target::(anonymous namespace)::on_alarm(gptimer_t*, gptimer_alarm_event_data_t const*, void*)+0x2cd>
4037690a: 7a0926 beqi	a9, -1, 40376988 <ecu::engine_target::(anonymous namespace)::on_alarm(gptimer_t*, gptimer_alarm_event_data_t const*, void*)+0x348>
4037690d: f6d981 l32r	a8, 40374474 <_iram_text_start+0x70> (3fcb7500 <ecu::engine_target::(anonymous namespace)::executor+0x500>)
40376910: 302892 l32i	a9, a8, 192
40376913: 3128b2 l32i	a11, a8, 196
40376916: 0bad mov.n	a10, a11
40376918: c91b addi.n	a12, a9, 1
4037691a: 020966 bnei	a9, -1, 40376920 <ecu::engine_target::(anonymous namespace)::on_alarm(gptimer_t*, gptimer_alarm_event_data_t const*, void*)+0x2e0>
4037691d: 01cba2 addi	a10, a11, 1
40376920: 3068c2 s32i	a12, a8, 192
40376923: 3168a2 s32i	a10, a8, 196
40376926: f6d291 l32r	a9, 40374470 <_iram_text_start+0x6c> (3fcb8600 <ecu::engine_target::(anonymous namespace)::executor+0x1600>)
40376929: 2c2982 l32i	a8, a9, 176
4037692c: 2d2992 l32i	a9, a9, 180
4037692f: 09bd mov.n	a11, a9
40376931: c81b addi.n	a12, a8, 1
40376933: 020866 bnei	a8, -1, 40376939 <ecu::engine_target::(anonymous namespace)::on_alarm(gptimer_t*, gptimer_alarm_event_data_t const*, void*)+0x2f9>
40376936: 01c9b2 addi	a11, a9, 1
40376939: f6b8a1 l32r	a10, 4037441c <_iram_text_start+0x18> (3fcb7000 <ecu::engine_target::(anonymous namespace)::executor>)
4037693c: 16da92 addmi	a9, a10, 0x1600
4037693f: 2c69c2 s32i	a12, a9, 176
40376942: 2d69b2 s32i	a11, a9, 180
40376945: 649080 extui	a9, a8, 0, 7
40376948: 06da82 addmi	a8, a10, 0x600
4037694b: 1199b0 slli	a9, a9, 5
4037694e: 889a add.n	a8, a8, a9
40376950: b0a092 movi	a9, 176
40376953: 989a add.n	a9, a8, a9
40376955: 09c9 s32i.n	a12, a9, 0
40376957: 19b9 s32i.n	a11, a9, 4
40376959: b8a092 movi	a9, 184
4037695c: 989a add.n	a9, a8, a9
4037695e: 0969 s32i.n	a6, a9, 0
40376960: 1979 s32i.n	a7, a9, 4
40376962: c0a092 movi	a9, 192
40376965: 989a add.n	a9, a8, a9
40376967: 0969 s32i.n	a6, a9, 0
40376969: 1979 s32i.n	a7, a9, 4
4037696b: 05daa2 addmi	a10, a10, 0x500
4037696e: 222a92 l32i	a9, a10, 136
40376971: 326892 s32i	a9, a8, 200
40376974: f97c movi.n	a9, -1
40376976: cc4892 s8i	a9, a8, 204
40376979: cda092 movi	a9, 205
4037697c: 989a add.n	a9, a8, a9
4037697e: 0a0c movi.n	a10, 0
40376980: 0049a2 s8i	a10, a9, 0
40376983: e90c movi.n	a9, 14
40376985: ce4892 s8i	a9, a8, 206
40376988: f6a571 l32r	a7, 4037441c <_iram_text_start+0x18> (3fcb7000 <ecu::engine_target::(anonymous namespace)::executor>)
4037698b: 06d782 addmi	a8, a7, 0x600
4037698e: 090c movi.n	a9, 0
40376990: 284892 s8i	a9, a8, 40
40376993: 0003c6 j	403769a6 <ecu::engine_target::(anonymous namespace)::on_alarm(gptimer_t*, gptimer_alarm_event_data_t const*, void*)+0x366>
40376996: 8c3c movi.n	a12, 56
40376998: 0b0c movi.n	a11, 0
4037699a: 20a770 or	a10, a7, a7
4037699d: f6b781 l32r	a8, 4037447c <_iram_text_start+0x78> (400011e8 <memset>)
403769a0: 0008e0 callx8	a8
403769a3: 38c772 addi	a7, a7, 56
403769a6: f6ab81 l32r	a8, 40374454 <_iram_text_start+0x50> (3fcb71c0 <ecu::engine_target::(anonymous namespace)::executor+0x1c0>)
403769a9: e99787 bne	a7, a8, 40376996 <ecu::engine_target::(anonymous namespace)::on_alarm(gptimer_t*, gptimer_alarm_event_data_t const*, void*)+0x356>
403769ac: f69c81 l32r	a8, 4037441c <_iram_text_start+0x18> (3fcb7000 <ecu::engine_target::(anonymous namespace)::executor>)
403769af: 01d892 addmi	a9, a8, 0x100
403769b2: 0a0c movi.n	a10, 0
403769b4: c049a2 s8i	a10, a9, 192
403769b7: 16d892 addmi	a9, a8, 0x1600
403769ba: fb7c movi.n	a11, -1
403769bc: 3269b2 s32i	a11, a9, 200
403769bf: 3369b2 s32i	a11, a9, 204
403769c2: f049a2 s8i	a10, a9, 240
403769c5: 06d882 addmi	a8, a8, 0x600
403769c8: e90c movi.n	a9, 14
403769ca: 2b4892 s8i	a9, a8, 43
403769cd: 8898 l32i.n	a9, a8, 32
403769cf: 991b addi.n	a9, a9, 1
403769d1: 8899 s32i.n	a9, a8, 32
403769d3: 9898 l32i.n	a9, a8, 36
403769d5: 991b addi.n	a9, a9, 1
403769d7: 9899 s32i.n	a9, a8, 36
403769d9: 080c movi.n	a8, 0
403769db: 8189 s32i.n	a8, a1, 32
403769dd: 9189 s32i.n	a8, a1, 36
403769df: f69481 l32r	a8, 40374430 <_iram_text_start+0x2c> (3fcbca08 <ecu::engine_target::(anonymous namespace)::timer>)
403769e2: 08a8 l32i.n	a10, a8, 0
403769e4: 4a8c beqz.n	a10, 403769ec <ecu::engine_target::(anonymous namespace)::on_alarm(gptimer_t*, gptimer_alarm_event_data_t const*, void*)+0x3ac>
403769e6: 20c1b2 addi	a11, a1, 32
403769e9: 0863e5 call8	4037f028 <gptimer_get_raw_count>
403769ec: 8168 l32i.n	a6, a1, 32
403769ee: 9178 l32i.n	a7, a1, 36
403769f0: f6a081 l32r	a8, 40374470 <_iram_text_start+0x6c> (3fcb8600 <ecu::engine_target::(anonymous namespace)::executor+0x1600>)
403769f3: 362892 l32i	a9, a8, 216
403769f6: 372882 l32i	a8, a8, 220
403769f9: 0b3787 bltu	a7, a8, 40376a08 <ecu::engine_target::(anonymous namespace)::on_alarm(gptimer_t*, gptimer_alarm_event_data_t const*, void*)+0x3c8>
403769fc: 021877 beq	a8, a7, 40376a02 <ecu::engine_target::(anonymous namespace)::on_alarm(gptimer_t*, gptimer_alarm_event_data_t const*, void*)+0x3c2>
403769ff: 00d086 j	40376d45 <ecu::engine_target::(anonymous namespace)::on_alarm(gptimer_t*, gptimer_alarm_event_data_t const*, void*)+0x705>
40376a02: 023697 bltu	a6, a9, 40376a08 <ecu::engine_target::(anonymous namespace)::on_alarm(gptimer_t*, gptimer_alarm_event_data_t const*, void*)+0x3c8>
40376a05: 00cf06 j	40376d45 <ecu::engine_target::(anonymous namespace)::on_alarm(gptimer_t*, gptimer_alarm_event_data_t const*, void*)+0x705>
40376a08: f68481 l32r	a8, 40374418 <_iram_text_start+0x14> (3fcb7600 <ecu::engine_target::(anonymous namespace)::executor+0x600>)
40376a0b: 290882 l8ui	a8, a8, 41
40376a0e: 08a856 bnez	a8, 40376a9c <ecu::engine_target::(anonymous namespace)::on_alarm(gptimer_t*, gptimer_alarm_event_data_t const*, void*)+0x45c>
40376a11: f68281 l32r	a8, 4037441c <_iram_text_start+0x18> (3fcb7000 <ecu::engine_target::(anonymous namespace)::executor>)
40376a14: 06d892 addmi	a9, a8, 0x600
40376a17: 3a0c movi.n	a10, 3
40376a19: 2949a2 s8i	a10, a9, 41
40376a1c: 2a49a2 s8i	a10, a9, 42
40376a1f: 2969 s32i.n	a6, a9, 8
40376a21: 3979 s32i.n	a7, a9, 12
40376a23: 05d882 addmi	a8, a8, 0x500
40376a26: 322892 l32i	a9, a8, 200
40376a29: 3328b2 l32i	a11, a8, 204
40376a2c: 0bad mov.n	a10, a11
40376a2e: c91b addi.n	a12, a9, 1
40376a30: 010966 bnei	a9, -1, 40376a35 <ecu::engine_target::(anonymous namespace)::on_alarm(gptimer_t*, gptimer_alarm_event_data_t const*, void*)+0x3f5>
40376a33: ab1b addi.n	a10, a11, 1
40376a35: 3268c2 s32i	a12, a8, 200
40376a38: 3368a2 s32i	a10, a8, 204
40376a3b: f68d91 l32r	a9, 40374470 <_iram_text_start+0x6c> (3fcb8600 <ecu::engine_target::(anonymous namespace)::executor+0x1600>)
40376a3e: 2c2982 l32i	a8, a9, 176
40376a41: 2d2992 l32i	a9, a9, 180
40376a44: 09bd mov.n	a11, a9
40376a46: c81b addi.n	a12, a8, 1
40376a48: 010866 bnei	a8, -1, 40376a4d <ecu::engine_target::(anonymous namespace)::on_alarm(gptimer_t*, gptimer_alarm_event_data_t const*, void*)+0x40d>
40376a4b: b91b addi.n	a11, a9, 1
40376a4d: f673a1 l32r	a10, 4037441c <_iram_text_start+0x18> (3fcb7000 <ecu::engine_target::(anonymous namespace)::executor>)
40376a50: 16da92 addmi	a9, a10, 0x1600
40376a53: 2c69c2 s32i	a12, a9, 176
40376a56: 2d69b2 s32i	a11, a9, 180
40376a59: 649080 extui	a9, a8, 0, 7
40376a5c: 06da82 addmi	a8, a10, 0x600
40376a5f: 1199b0 slli	a9, a9, 5
40376a62: 889a add.n	a8, a8, a9
40376a64: b0a092 movi	a9, 176
40376a67: 989a add.n	a9, a8, a9
40376a69: 09c9 s32i.n	a12, a9, 0
40376a6b: 19b9 s32i.n	a11, a9, 4
40376a6d: b8a092 movi	a9, 184
40376a70: 989a add.n	a9, a8, a9
40376a72: 0969 s32i.n	a6, a9, 0
40376a74: 1979 s32i.n	a7, a9, 4
40376a76: c0a092 movi	a9, 192
40376a79: 989a add.n	a9, a8, a9
40376a7b: 0969 s32i.n	a6, a9, 0
40376a7d: 1979 s32i.n	a7, a9, 4
40376a7f: 05daa2 addmi	a10, a10, 0x500
40376a82: 222a92 l32i	a9, a10, 136
40376a85: 326892 s32i	a9, a8, 200
40376a88: f97c movi.n	a9, -1
40376a8a: cc4892 s8i	a9, a8, 204
40376a8d: cda092 movi	a9, 205
40376a90: 989a add.n	a9, a8, a9
40376a92: 0a0c movi.n	a10, 0
40376a94: 0049a2 s8i	a10, a9, 0
40376a97: 390c movi.n	a9, 3
40376a99: ce4892 s8i	a9, a8, 206
40376a9c: f66881 l32r	a8, 4037443c <_iram_text_start+0x38> (60004000 <GPIO>)
40376a9f: f66891 l32r	a9, 40374440 <_iram_text_start+0x3c> (8000 <UserFrameTotalSize+0x7f00>)
40376aa2: 0020c0 memw
40376aa5: 6899 s32i.n	a9, a8, 24
40376aa7: f65a81 l32r	a8, 40374410 <_iram_text_start+0xc> (3fcb2e90 <ecu::engine_target::(anonymous namespace)::output_pins>)
40376aaa: 000b06 j	40376ada <ecu::engine_target::(anonymous namespace)::on_alarm(gptimer_t*, gptimer_alarm_event_data_t const*, void*)+0x49a>
40376aad: 0898 l32i.n	a9, a8, 0
40376aaf: fa1c movi.n	a10, 31
40376ab1: 133a97 bltu	a10, a9, 40376ac8 <ecu::engine_target::(anonymous namespace)::on_alarm(gptimer_t*, gptimer_alarm_event_data_t const*, void*)+0x488>
40376ab4: 1a0c movi.n	a10, 1
40376ab6: 401900 ssl	a9
40376ab9: a19a00 sll	a9, a10
40376abc: f660a1 l32r	a10, 4037443c <_iram_text_start+0x38> (60004000 <GPIO>)
40376abf: 0020c0 memw
40376ac2: 3a99 s32i.n	a9, a10, 12
40376ac4: 000406 j	40376ad8 <ecu::engine_target::(anonymous namespace)::on_alarm(gptimer_t*, gptimer_alarm_event_data_t const*, void*)+0x498>
40376ac8: 1a0c movi.n	a10, 1
40376aca: 401900 ssl	a9
40376acd: a19a00 sll	a9, a10
40376ad0: f65ba1 l32r	a10, 4037443c <_iram_text_start+0x38> (60004000 <GPIO>)
40376ad3: 0020c0 memw
40376ad6: 6a99 s32i.n	a9, a10, 24
40376ad8: 884b addi.n	a8, a8, 4
40376ada: f65a91 l32r	a9, 40374444 <_iram_text_start+0x40> (3fcb2eb0 <ecu::engine_target::(anonymous namespace)::lock>)
40376add: cc9897 bne	a8, a9, 40376aad <ecu::engine_target::(anonymous namespace)::on_alarm(gptimer_t*, gptimer_alarm_event_data_t const*, void*)+0x46d>
40376ae0: f65781 l32r	a8, 4037443c <_iram_text_start+0x38> (60004000 <GPIO>)
40376ae3: 490c movi.n	a9, 4
40376ae5: 0020c0 memw
40376ae8: 3899 s32i.n	a9, a8, 12
40376aea: 290c movi.n	a9, 2
40376aec: 0020c0 memw
40376aef: 3899 s32i.n	a9, a8, 12
40376af1: f65581 l32r	a8, 40374448 <_iram_text_start+0x44> (3fcb2e8c <ecu::engine_target::(anonymous namespace)::output>)
40376af4: 090c movi.n	a9, 0
40376af6: 034892 s8i	a9, a8, 3
40376af9: f65481 l32r	a8, 4037444c <_iram_text_start+0x48> (3fcb6f10 <ecu::engine_target::(anonymous namespace)::idle_executor>)
40376afc: a80882 l8ui	a8, a8, 168
40376aff: 68cc bnez.n	a8, 40376b09 <ecu::engine_target::(anonymous namespace)::on_alarm(gptimer_t*, gptimer_alarm_event_data_t const*, void*)+0x4c9>
40376b01: f65281 l32r	a8, 4037444c <_iram_text_start+0x48> (3fcb6f10 <ecu::engine_target::(anonymous namespace)::idle_executor>)
40376b04: a90882 l8ui	a8, a8, 169
40376b07: e88c beqz.n	a8, 40376b19 <ecu::engine_target::(anonymous namespace)::on_alarm(gptimer_t*, gptimer_alarm_event_data_t const*, void*)+0x4d9>
40376b09: 080c movi.n	a8, 0
40376b0b: 8189 s32i.n	a8, a1, 32
40376b0d: 9189 s32i.n	a8, a1, 36
40376b0f: f64881 l32r	a8, 40374430 <_iram_text_start+0x2c> (3fcbca08 <ecu::engine_target::(anonymous namespace)::timer>)
40376b12: 08a8 l32i.n	a10, a8, 0
40376b14: cacc bnez.n	a10, 40376b24 <ecu::engine_target::(anonymous namespace)::on_alarm(gptimer_t*, gptimer_alarm_event_data_t const*, void*)+0x4e4>
40376b16: 000406 j	40376b2a <ecu::engine_target::(anonymous namespace)::on_alarm(gptimer_t*, gptimer_alarm_event_data_t const*, void*)+0x4ea>
40376b19: f64d81 l32r	a8, 40374450 <_iram_text_start+0x4c> (3fcb6f08 <ecu::engine_target::(anonymous namespace)::idle_output>)
40376b1c: 090c movi.n	a9, 0
40376b1e: 004892 s8i	a9, a8, 0
40376b21: 003b06 j	40376c11 <ecu::engine_target::(anonymous namespace)::on_alarm(gptimer_t*, gptimer_alarm_event_data_t const*, void*)+0x5d1>
40376b24: 20c1b2 addi	a11, a1, 32
40376b27: 085025 call8	4037f028 <gptimer_get_raw_count>
40376b2a: 81a8 l32i.n	a10, a1, 32
40376b2c: 91b8 l32i.n	a11, a1, 36
40376b2e: f64781 l32r	a8, 4037444c <_iram_text_start+0x48> (3fcb6f10 <ecu::engine_target::(anonymous namespace)::idle_executor>)
40376b31: a808c2 l8ui	a12, a8, 168
40376b34: 1ccc bnez.n	a12, 40376b39 <ecu::engine_target::(anonymous namespace)::on_alarm(gptimer_t*, gptimer_alarm_event_data_t const*, void*)+0x4f9>
40376b36: a908c2 l8ui	a12, a8, 169
40376b39: f64581 l32r	a8, 40374450 <_iram_text_start+0x4c> (3fcb6f08 <ecu::engine_target::(anonymous namespace)::idle_output>)
40376b3c: 090c movi.n	a9, 0
40376b3e: 004892 s8i	a9, a8, 0
40376b41: f64281 l32r	a8, 4037444c <_iram_text_start+0x48> (3fcb6f10 <ecu::engine_target::(anonymous namespace)::idle_executor>)
40376b44: a90882 l8ui	a8, a8, 169
40376b47: 789c beqz.n	a8, 40376b62 <ecu::engine_target::(anonymous namespace)::on_alarm(gptimer_t*, gptimer_alarm_event_data_t const*, void*)+0x522>
40376b49: f64081 l32r	a8, 4037444c <_iram_text_start+0x48> (3fcb6f10 <ecu::engine_target::(anonymous namespace)::idle_executor>)
40376b4c: 142892 l32i	a9, a8, 80
40376b4f: 1528e2 l32i	a14, a8, 84
40376b52: 0edd mov.n	a13, a14
40376b54: f91b addi.n	a15, a9, 1
40376b56: 020966 bnei	a9, -1, 40376b5c <ecu::engine_target::(anonymous namespace)::on_alarm(gptimer_t*, gptimer_alarm_event_data_t const*, void*)+0x51c>
40376b59: 01ced2 addi	a13, a14, 1
40376b5c: 1468f2 s32i	a15, a8, 80
40376b5f: 1568d2 s32i	a13, a8, 84
40376b62: f63a81 l32r	a8, 4037444c <_iram_text_start+0x48> (3fcb6f10 <ecu::engine_target::(anonymous namespace)::idle_executor>)
40376b65: 090c movi.n	a9, 0
40376b67: a94892 s8i	a9, a8, 169
40376b6a: a84892 s8i	a9, a8, 168
40376b6d: 0d0c movi.n	a13, 0
40376b6f: 2968d2 s32i	a13, a8, 164
40376b72: 2268a2 s32i	a10, a8, 136
40376b75: 2368b2 s32i	a11, a8, 140
40376b78: fb7c movi.n	a11, -1
40376b7a: 3068b2 s32i	a11, a8, 192
40376b7d: 3168b2 s32i	a11, a8, 196
40376b80: 2e68b2 s32i	a11, a8, 184
40376b83: 2f68b2 s32i	a11, a8, 188
40376b86: 2c68b2 s32i	a11, a8, 176
40376b89: 2d68b2 s32i	a11, a8, 180
40376b8c: e94892 s8i	a9, a8, 233
40376b8f: 3c9c beqz.n	a12, 40376ba6 <ecu::engine_target::(anonymous namespace)::on_alarm(gptimer_t*, gptimer_alarm_event_data_t const*, void*)+0x566>
40376b91: 182892 l32i	a9, a8, 96
40376b94: 1928b2 l32i	a11, a8, 100
40376b97: 0bad mov.n	a10, a11
40376b99: c91b addi.n	a12, a9, 1
40376b9b: 010966 bnei	a9, -1, 40376ba0 <ecu::engine_target::(anonymous namespace)::on_alarm(gptimer_t*, gptimer_alarm_event_data_t const*, void*)+0x560>
40376b9e: ab1b addi.n	a10, a11, 1
40376ba0: 1868c2 s32i	a12, a8, 96
40376ba3: 1968a2 s32i	a10, a8, 100
40376ba6: f62981 l32r	a8, 4037444c <_iram_text_start+0x48> (3fcb6f10 <ecu::engine_target::(anonymous namespace)::idle_executor>)
40376ba9: 390c movi.n	a9, 3
40376bab: ab4892 s8i	a9, a8, 171
40376bae: 0017c6 j	40376c11 <ecu::engine_target::(anonymous namespace)::on_alarm(gptimer_t*, gptimer_alarm_event_data_t const*, void*)+0x5d1>
40376bb1: f61991 l32r	a9, 40374418 <_iram_text_start+0x14> (3fcb7600 <ecu::engine_target::(anonymous namespace)::executor+0x600>)
40376bb4: 280992 l8ui	a9, a9, 40
40376bb7: 515987 bbc	a9, a8, 40376c0c <ecu::engine_target::(anonymous namespace)::on_alarm(gptimer_t*, gptimer_alarm_event_data_t const*, void*)+0x5cc>
40376bba: c6a092 movi	a9, 198
40376bbd: 989a add.n	a9, a8, a9
40376bbf: f617a1 l32r	a10, 4037441c <_iram_text_start+0x18> (3fcb7000 <ecu::engine_target::(anonymous namespace)::executor>)
40376bc2: b099a0 addx8	a9, a9, a10
40376bc5: 0029a2 l32i	a10, a9, 0
40376bc8: 012992 l32i	a9, a9, 4
40376bcb: 133797 bltu	a7, a9, 40376be2 <ecu::engine_target::(anonymous namespace)::on_alarm(gptimer_t*, gptimer_alarm_event_data_t const*, void*)+0x5a2>
40376bce: 029977 bne	a9, a7, 40376bd4 <ecu::engine_target::(anonymous namespace)::on_alarm(gptimer_t*, gptimer_alarm_event_data_t const*, void*)+0x594>
40376bd1: 0d36a7 bltu	a6, a10, 40376be2 <ecu::engine_target::(anonymous namespace)::on_alarm(gptimer_t*, gptimer_alarm_event_data_t const*, void*)+0x5a2>
40376bd4: c09790 sub	a9, a7, a9
40376bd7: 01b6a7 bgeu	a6, a10, 40376bdc <ecu::engine_target::(anonymous namespace)::on_alarm(gptimer_t*, gptimer_alarm_event_data_t const*, void*)+0x59c>
40376bda: 990b addi.n	a9, a9, -1
40376bdc: c0a6a0 sub	a10, a6, a10
40376bdf: 0000c6 j	40376be6 <ecu::engine_target::(anonymous namespace)::on_alarm(gptimer_t*, gptimer_alarm_event_data_t const*, void*)+0x5a6>
40376be2: 0a0c movi.n	a10, 0
40376be4: 0a9d mov.n	a9, a10
40376be6: 0e48f6 bgeui	a8, 4, 40376bf8 <ecu::engine_target::(anonymous namespace)::on_alarm(gptimer_t*, gptimer_alarm_event_data_t const*, void*)+0x5b8>
40376be9: f622b1 l32r	a11, 40374474 <_iram_text_start+0x70> (3fcb7500 <ecu::engine_target::(anonymous namespace)::executor+0x500>)
40376bec: 3e2bd2 l32i	a13, a11, 248
40376bef: 3f2bc2 l32i	a12, a11, 252
40376bf2: f608b1 l32r	a11, 40374414 <_iram_text_start+0x10> (3fcb75f8 <ecu::engine_target::(anonymous namespace)::executor+0x5f8>)
40376bf5: 000186 j	40376bff <ecu::engine_target::(anonymous namespace)::on_alarm(gptimer_t*, gptimer_alarm_event_data_t const*, void*)+0x5bf>
40376bf8: f608b1 l32r	a11, 40374418 <_iram_text_start+0x14> (3fcb7600 <ecu::engine_target::(anonymous namespace)::executor+0x600>)
40376bfb: 0bd8 l32i.n	a13, a11, 0
40376bfd: 1bc8 l32i.n	a12, a11, 4
40376bff: 053c97 bltu	a12, a9, 40376c08 <ecu::engine_target::(anonymous namespace)::on_alarm(gptimer_t*, gptimer_alarm_event_data_t const*, void*)+0x5c8>
40376c02: 0699c7 bne	a9, a12, 40376c0c <ecu::engine_target::(anonymous namespace)::on_alarm(gptimer_t*, gptimer_alarm_event_data_t const*, void*)+0x5cc>
40376c05: 03bda7 bgeu	a13, a10, 40376c0c <ecu::engine_target::(anonymous namespace)::on_alarm(gptimer_t*, gptimer_alarm_event_data_t const*, void*)+0x5cc>
40376c08: 0ba9 s32i.n	a10, a11, 0
40376c0a: 1b99 s32i.n	a9, a11, 4
40376c0c: 881b addi.n	a8, a8, 1
40376c0e: 000046 j	40376c13 <ecu::engine_target::(anonymous namespace)::on_alarm(gptimer_t*, gptimer_alarm_event_data_t const*, void*)+0x5d3>
40376c11: 080c movi.n	a8, 0
40376c13: 9a88b6 bltui	a8, 8, 40376bb1 <ecu::engine_target::(anonymous namespace)::on_alarm(gptimer_t*, gptimer_alarm_event_data_t const*, void*)+0x571>
40376c16: f60081 l32r	a8, 40374418 <_iram_text_start+0x14> (3fcb7600 <ecu::engine_target::(anonymous namespace)::executor+0x600>)
40376c19: 280882 l8ui	a8, a8, 40
40376c1c: 055856 bnez	a8, 40376c75 <ecu::engine_target::(anonymous namespace)::on_alarm(gptimer_t*, gptimer_alarm_event_data_t const*, void*)+0x635>
40376c1f: f87c movi.n	a8, -1
40376c21: 8189 s32i.n	a8, a1, 32
40376c23: 9189 s32i.n	a8, a1, 36
40376c25: f5fd81 l32r	a8, 4037441c <_iram_text_start+0x18> (3fcb7000 <ecu::engine_target::(anonymous namespace)::executor>)
40376c28: 000e06 j	40376c64 <ecu::engine_target::(anonymous namespace)::on_alarm(gptimer_t*, gptimer_alarm_event_data_t const*, void*)+0x624>
40376c2c: 010892 l8ui	a9, a8, 1
40376c2f: e9ac beqz.n	a9, 40376c61 <ecu::engine_target::(anonymous namespace)::on_alarm(gptimer_t*, gptimer_alarm_event_data_t const*, void*)+0x621>
40376c31: 000892 l8ui	a9, a8, 0
40376c34: a98c beqz.n	a9, 40376c42 <ecu::engine_target::(anonymous namespace)::on_alarm(gptimer_t*, gptimer_alarm_event_data_t const*, void*)+0x602>
40376c36: 10c8a2 addi	a10, a8, 16
40376c39: 48d8 l32i.n	a13, a8, 16
40376c3b: 58b8 l32i.n	a11, a8, 20
40376c3d: 0001c6 j	40376c48 <ecu::engine_target::(anonymous namespace)::on_alarm(gptimer_t*, gptimer_alarm_event_data_t const*, void*)+0x608>
40376c42: a88b addi.n	a10, a8, 8
40376c44: 28d8 l32i.n	a13, a8, 8
40376c46: 38b8 l32i.n	a11, a8, 12
40376c48: 81c8 l32i.n	a12, a1, 32
40376c4a: 9198 l32i.n	a9, a1, 36
40376c4c: 083b97 bltu	a11, a9, 40376c58 <ecu::engine_target::(anonymous namespace)::on_alarm(gptimer_t*, gptimer_alarm_event_data_t const*, void*)+0x618>
40376c4f: 0299b7 bne	a9, a11, 40376c55 <ecu::engine_target::(anonymous namespace)::on_alarm(gptimer_t*, gptimer_alarm_event_data_t const*, void*)+0x615>
40376c52: 023dc7 bltu	a13, a12, 40376c58 <ecu::engine_target::(anonymous namespace)::on_alarm(gptimer_t*, gptimer_alarm_event_data_t const*, void*)+0x618>
40376c55: 20c1a2 addi	a10, a1, 32
40376c58: 1ab8 l32i.n	a11, a10, 4
40376c5a: 0aa8 l32i.n	a10, a10, 0
40376c5c: 81a9 s32i.n	a10, a1, 32
40376c5e: 0961b2 s32i	a11, a1, 36
40376c61: 38c882 addi	a8, a8, 56
40376c64: f5fc91 l32r	a9, 40374454 <_iram_text_start+0x50> (3fcb71c0 <ecu::engine_target::(anonymous namespace)::executor+0x1c0>)
40376c67: c19897 bne	a8, a9, 40376c2c <ecu::engine_target::(anonymous namespace)::on_alarm(gptimer_t*, gptimer_alarm_event_data_t const*, void*)+0x5ec>
40376c6a: 8188 l32i.n	a8, a1, 32
40376c6c: 092192 l32i	a9, a1, 36
40376c6f: 020866 bnei	a8, -1, 40376c75 <ecu::engine_target::(anonymous namespace)::on_alarm(gptimer_t*, gptimer_alarm_event_data_t const*, void*)+0x635>
40376c72: 7a0926 beqi	a9, -1, 40376cf0 <ecu::engine_target::(anonymous namespace)::on_alarm(gptimer_t*, gptimer_alarm_event_data_t const*, void*)+0x6b0>
40376c75: f5ff81 l32r	a8, 40374474 <_iram_text_start+0x70> (3fcb7500 <ecu::engine_target::(anonymous namespace)::executor+0x500>)
40376c78: 302892 l32i	a9, a8, 192
40376c7b: 3128b2 l32i	a11, a8, 196
40376c7e: 0bad mov.n	a10, a11
40376c80: c91b addi.n	a12, a9, 1
40376c82: 020966 bnei	a9, -1, 40376c88 <ecu::engine_target::(anonymous namespace)::on_alarm(gptimer_t*, gptimer_alarm_event_data_t const*, void*)+0x648>
40376c85: 01cba2 addi	a10, a11, 1
40376c88: 3068c2 s32i	a12, a8, 192
40376c8b: 3168a2 s32i	a10, a8, 196
40376c8e: f5f891 l32r	a9, 40374470 <_iram_text_start+0x6c> (3fcb8600 <ecu::engine_target::(anonymous namespace)::executor+0x1600>)
40376c91: 2c2982 l32i	a8, a9, 176
40376c94: 2d2992 l32i	a9, a9, 180
40376c97: 09bd mov.n	a11, a9
40376c99: c81b addi.n	a12, a8, 1
40376c9b: 020866 bnei	a8, -1, 40376ca1 <ecu::engine_target::(anonymous namespace)::on_alarm(gptimer_t*, gptimer_alarm_event_data_t const*, void*)+0x661>
40376c9e: 01c9b2 addi	a11, a9, 1
40376ca1: f5dea1 l32r	a10, 4037441c <_iram_text_start+0x18> (3fcb7000 <ecu::engine_target::(anonymous namespace)::executor>)
40376ca4: 16da92 addmi	a9, a10, 0x1600
40376ca7: 2c69c2 s32i	a12, a9, 176
40376caa: 2d69b2 s32i	a11, a9, 180
40376cad: 649080 extui	a9, a8, 0, 7
40376cb0: 06da82 addmi	a8, a10, 0x600
40376cb3: 1199b0 slli	a9, a9, 5
40376cb6: 889a add.n	a8, a8, a9
40376cb8: b0a092 movi	a9, 176
40376cbb: 989a add.n	a9, a8, a9
40376cbd: 09c9 s32i.n	a12, a9, 0
40376cbf: 19b9 s32i.n	a11, a9, 4
40376cc1: b8a092 movi	a9, 184
40376cc4: 989a add.n	a9, a8, a9
40376cc6: 0969 s32i.n	a6, a9, 0
40376cc8: 1979 s32i.n	a7, a9, 4
40376cca: c0a092 movi	a9, 192
40376ccd: 989a add.n	a9, a8, a9
40376ccf: 0969 s32i.n	a6, a9, 0
40376cd1: 1979 s32i.n	a7, a9, 4
40376cd3: 05daa2 addmi	a10, a10, 0x500
40376cd6: 222a92 l32i	a9, a10, 136
40376cd9: 326892 s32i	a9, a8, 200
40376cdc: f97c movi.n	a9, -1
40376cde: cc4892 s8i	a9, a8, 204
40376ce1: cda092 movi	a9, 205
40376ce4: 989a add.n	a9, a8, a9
40376ce6: 0a0c movi.n	a10, 0
40376ce8: 0049a2 s8i	a10, a9, 0
40376ceb: 390c movi.n	a9, 3
40376ced: ce4892 s8i	a9, a8, 206
40376cf0: f5cb51 l32r	a5, 4037441c <_iram_text_start+0x18> (3fcb7000 <ecu::engine_target::(anonymous namespace)::executor>)
40376cf3: 06d582 addmi	a8, a5, 0x600
40376cf6: 090c movi.n	a9, 0
40376cf8: 284892 s8i	a9, a8, 40
40376cfb: 000406 j	40376d0f <ecu::engine_target::(anonymous namespace)::on_alarm(gptimer_t*, gptimer_alarm_event_data_t const*, void*)+0x6cf>
40376cfe: 8c3c movi.n	a12, 56
40376d00: 00a0b2 movi	a11, 0
40376d03: 20a550 or	a10, a5, a5
40376d06: f5dd81 l32r	a8, 4037447c <_iram_text_start+0x78> (400011e8 <memset>)
40376d09: 0008e0 callx8	a8
40376d0c: 38c552 addi	a5, a5, 56
40376d0f: f5d181 l32r	a8, 40374454 <_iram_text_start+0x50> (3fcb71c0 <ecu::engine_target::(anonymous namespace)::executor+0x1c0>)
40376d12: e89587 bne	a5, a8, 40376cfe <ecu::engine_target::(anonymous namespace)::on_alarm(gptimer_t*, gptimer_alarm_event_data_t const*, void*)+0x6be>
40376d15: f5c181 l32r	a8, 4037441c <_iram_text_start+0x18> (3fcb7000 <ecu::engine_target::(anonymous namespace)::executor>)
40376d18: 01d892 addmi	a9, a8, 0x100
40376d1b: 0a0c movi.n	a10, 0
40376d1d: c049a2 s8i	a10, a9, 192
40376d20: 16d892 addmi	a9, a8, 0x1600
40376d23: fb7c movi.n	a11, -1
40376d25: 3269b2 s32i	a11, a9, 200
40376d28: 3369b2 s32i	a11, a9, 204
40376d2b: f049a2 s8i	a10, a9, 240
40376d2e: 06d882 addmi	a8, a8, 0x600
40376d31: 390c movi.n	a9, 3
40376d33: 2b4892 s8i	a9, a8, 43
40376d36: 8898 l32i.n	a9, a8, 32
40376d38: 991b addi.n	a9, a9, 1
40376d3a: 8899 s32i.n	a9, a8, 32
40376d3c: 9898 l32i.n	a9, a8, 36
40376d3e: 991b addi.n	a9, a9, 1
40376d40: 9899 s32i.n	a9, a8, 36
40376d42: 0d09c6 j	4037a16d <_diram_i_start+0x216d>
40376d45: f5b581 l32r	a8, 4037441c <_iram_text_start+0x18> (3fcb7000 <ecu::engine_target::(anonymous namespace)::executor>)
40376d48: 16d892 addmi	a9, a8, 0x1600
40376d4b: 366962 s32i	a6, a9, 216
40376d4e: 376972 s32i	a7, a9, 220
40376d51: 06d882 addmi	a8, a8, 0x600
40376d54: 290882 l8ui	a8, a8, 41
40376d57: 188c beqz.n	a8, 40376d5c <ecu::engine_target::(anonymous namespace)::on_alarm(gptimer_t*, gptimer_alarm_event_data_t const*, void*)+0x71c>
40376d59: 0d0406 j	4037a16d <_diram_i_start+0x216d>
40376d5c: f5c781 l32r	a8, 40374478 <_iram_text_start+0x74> (3fcb7200 <ecu::engine_target::(anonymous namespace)::executor+0x200>)
40376d5f: 400882 l8ui	a8, a8, 64
40376d62: 1a1866 bnei	a8, 1, 40376d80 <ecu::engine_target::(anonymous namespace)::on_alarm(gptimer_t*, gptimer_alarm_event_data_t const*, void*)+0x740>
40376d65: f5c291 l32r	a9, 40374470 <_iram_text_start+0x6c> (3fcb8600 <ecu::engine_target::(anonymous namespace)::executor+0x1600>)
40376d68: f20992 l8ui	a9, a9, 242
40376d6b: 011916 beqz	a9, 40376d80 <ecu::engine_target::(anonymous namespace)::on_alarm(gptimer_t*, gptimer_alarm_event_data_t const*, void*)+0x740>
40376d6e: f5c091 l32r	a9, 40374470 <_iram_text_start+0x6c> (3fcb8600 <ecu::engine_target::(anonymous namespace)::executor+0x1600>)
40376d71: 3429a2 l32i	a10, a9, 208
40376d74: 352992 l32i	a9, a9, 212
40376d77: 053797 bltu	a7, a9, 40376d80 <ecu::engine_target::(anonymous namespace)::on_alarm(gptimer_t*, gptimer_alarm_event_data_t const*, void*)+0x740>
40376d7a: 0e9977 bne	a9, a7, 40376d8c <ecu::engine_target::(anonymous namespace)::on_alarm(gptimer_t*, gptimer_alarm_event_data_t const*, void*)+0x74c>
40376d7d: 0bb6a7 bgeu	a6, a10, 40376d8c <ecu::engine_target::(anonymous namespace)::on_alarm(gptimer_t*, gptimer_alarm_event_data_t const*, void*)+0x74c>
40376d80: f5bc91 l32r	a9, 40374470 <_iram_text_start+0x6c> (3fcb8600 <ecu::engine_target::(anonymous namespace)::executor+0x1600>)
40376d83: f00992 l8ui	a9, a9, 240
40376d86: 337956 bnez	a9, 403770c1 <ecu::engine_target::(anonymous namespace)::on_alarm(gptimer_t*, gptimer_alarm_event_data_t const*, void*)+0xa81>
40376d89: 0cf806 j	4037a16d <_diram_i_start+0x216d>
40376d8c: f5a481 l32r	a8, 4037441c <_iram_text_start+0x18> (3fcb7000 <ecu::engine_target::(anonymous namespace)::executor>)
40376d8f: 06d892 addmi	a9, a8, 0x600
40376d92: 0a1c movi.n	a10, 16
40376d94: 2949a2 s8i	a10, a9, 41
40376d97: 2a49a2 s8i	a10, a9, 42
40376d9a: 2969 s32i.n	a6, a9, 8
40376d9c: 3979 s32i.n	a7, a9, 12
40376d9e: 05d882 addmi	a8, a8, 0x500
40376da1: 322892 l32i	a9, a8, 200
40376da4: 3328b2 l32i	a11, a8, 204
40376da7: 0bad mov.n	a10, a11
40376da9: c91b addi.n	a12, a9, 1
40376dab: 010966 bnei	a9, -1, 40376db0 <ecu::engine_target::(anonymous namespace)::on_alarm(gptimer_t*, gptimer_alarm_event_data_t const*, void*)+0x770>
40376dae: ab1b addi.n	a10, a11, 1
40376db0: 3268c2 s32i	a12, a8, 200
40376db3: 3368a2 s32i	a10, a8, 204
40376db6: f5ae91 l32r	a9, 40374470 <_iram_text_start+0x6c> (3fcb8600 <ecu::engine_target::(anonymous namespace)::executor+0x1600>)
40376db9: 2c2982 l32i	a8, a9, 176
40376dbc: 2d2992 l32i	a9, a9, 180
40376dbf: 09bd mov.n	a11, a9
40376dc1: c81b addi.n	a12, a8, 1
40376dc3: 010866 bnei	a8, -1, 40376dc8 <ecu::engine_target::(anonymous namespace)::on_alarm(gptimer_t*, gptimer_alarm_event_data_t const*, void*)+0x788>
40376dc6: b91b addi.n	a11, a9, 1
40376dc8: f595a1 l32r	a10, 4037441c <_iram_text_start+0x18> (3fcb7000 <ecu::engine_target::(anonymous namespace)::executor>)
40376dcb: 16da92 addmi	a9, a10, 0x1600
40376dce: 2c69c2 s32i	a12, a9, 176
40376dd1: 2d69b2 s32i	a11, a9, 180
40376dd4: 649080 extui	a9, a8, 0, 7
40376dd7: 06da82 addmi	a8, a10, 0x600
40376dda: 1199b0 slli	a9, a9, 5
40376ddd: 889a add.n	a8, a8, a9
40376ddf: b0a092 movi	a9, 176
40376de2: 989a add.n	a9, a8, a9
40376de4: 09c9 s32i.n	a12, a9, 0
40376de6: 19b9 s32i.n	a11, a9, 4
40376de8: b8a092 movi	a9, 184
40376deb: 989a add.n	a9, a8, a9
40376ded: 0969 s32i.n	a6, a9, 0
40376def: 1979 s32i.n	a7, a9, 4
40376df1: c0a092 movi	a9, 192
40376df4: 989a add.n	a9, a8, a9
40376df6: 0969 s32i.n	a6, a9, 0
40376df8: 1979 s32i.n	a7, a9, 4
40376dfa: 05da92 addmi	a9, a10, 0x500
40376dfd: 222992 l32i	a9, a9, 136
40376e00: 326892 s32i	a9, a8, 200
40376e03: f97c movi.n	a9, -1
40376e05: cc4892 s8i	a9, a8, 204
40376e08: cda092 movi	a9, 205
40376e0b: 989a add.n	a9, a8, a9
40376e0d: 0a0c movi.n	a10, 0
40376e0f: 0049a2 s8i	a10, a9, 0
40376e12: 091c movi.n	a9, 16
40376e14: ce4892 s8i	a9, a8, 206
40376e17: f58981 l32r	a8, 4037443c <_iram_text_start+0x38> (60004000 <GPIO>)
40376e1a: f58991 l32r	a9, 40374440 <_iram_text_start+0x3c> (8000 <UserFrameTotalSize+0x7f00>)
40376e1d: 0020c0 memw
40376e20: 6899 s32i.n	a9, a8, 24
40376e22: f57b81 l32r	a8, 40374410 <_iram_text_start+0xc> (3fcb2e90 <ecu::engine_target::(anonymous namespace)::output_pins>)
40376e25: 000ac6 j	40376e54 <ecu::engine_target::(anonymous namespace)::on_alarm(gptimer_t*, gptimer_alarm_event_data_t const*, void*)+0x814>
40376e28: 0898 l32i.n	a9, a8, 0
40376e2a: fa1c movi.n	a10, 31
40376e2c: 123a97 bltu	a10, a9, 40376e42 <ecu::engine_target::(anonymous namespace)::on_alarm(gptimer_t*, gptimer_alarm_event_data_t const*, void*)+0x802>
40376e2f: 1a0c movi.n	a10, 1
40376e31: 401900 ssl	a9
40376e34: a19a00 sll	a9, a10
40376e37: f581a1 l32r	a10, 4037443c <_iram_text_start+0x38> (60004000 <GPIO>)
40376e3a: 0020c0 memw
40376e3d: 3a99 s32i.n	a9, a10, 12
40376e3f: 0003c6 j	40376e52 <ecu::engine_target::(anonymous namespace)::on_alarm(gptimer_t*, gptimer_alarm_event_data_t const*, void*)+0x812>
40376e42: 1a0c movi.n	a10, 1
40376e44: 401900 ssl	a9
40376e47: a19a00 sll	a9, a10
40376e4a: f57ca1 l32r	a10, 4037443c <_iram_text_start+0x38> (60004000 <GPIO>)
40376e4d: 0020c0 memw
40376e50: 6a99 s32i.n	a9, a10, 24
40376e52: 884b addi.n	a8, a8, 4
40376e54: f57c91 l32r	a9, 40374444 <_iram_text_start+0x40> (3fcb2eb0 <ecu::engine_target::(anonymous namespace)::lock>)
40376e57: cd9897 bne	a8, a9, 40376e28 <ecu::engine_target::(anonymous namespace)::on_alarm(gptimer_t*, gptimer_alarm_event_data_t const*, void*)+0x7e8>
40376e5a: f57881 l32r	a8, 4037443c <_iram_text_start+0x38> (60004000 <GPIO>)
40376e5d: 490c movi.n	a9, 4
40376e5f: 0020c0 memw
40376e62: 3899 s32i.n	a9, a8, 12
40376e64: 290c movi.n	a9, 2
40376e66: 0020c0 memw
40376e69: 3899 s32i.n	a9, a8, 12
40376e6b: f57781 l32r	a8, 40374448 <_iram_text_start+0x44> (3fcb2e8c <ecu::engine_target::(anonymous namespace)::output>)
40376e6e: 090c movi.n	a9, 0
40376e70: 034892 s8i	a9, a8, 3
40376e73: f57681 l32r	a8, 4037444c <_iram_text_start+0x48> (3fcb6f10 <ecu::engine_target::(anonymous namespace)::idle_executor>)
40376e76: a80882 l8ui	a8, a8, 168
40376e79: 78cc bnez.n	a8, 40376e84 <ecu::engine_target::(anonymous namespace)::on_alarm(gptimer_t*, gptimer_alarm_event_data_t const*, void*)+0x844>
40376e7b: f57481 l32r	a8, 4037444c <_iram_text_start+0x48> (3fcb6f10 <ecu::engine_target::(anonymous namespace)::idle_executor>)
40376e7e: a90882 l8ui	a8, a8, 169
40376e81: 00f816 beqz	a8, 40376e94 <ecu::engine_target::(anonymous namespace)::on_alarm(gptimer_t*, gptimer_alarm_event_data_t const*, void*)+0x854>
40376e84: 080c movi.n	a8, 0
40376e86: 8189 s32i.n	a8, a1, 32
40376e88: 9189 s32i.n	a8, a1, 36
40376e8a: f56981 l32r	a8, 40374430 <_iram_text_start+0x2c> (3fcbca08 <ecu::engine_target::(anonymous namespace)::timer>)
40376e8d: 08a8 l32i.n	a10, a8, 0
40376e8f: dacc bnez.n	a10, 40376ea0 <ecu::engine_target::(anonymous namespace)::on_alarm(gptimer_t*, gptimer_alarm_event_data_t const*, void*)+0x860>
40376e91: 000446 j	40376ea6 <ecu::engine_target::(anonymous namespace)::on_alarm(gptimer_t*, gptimer_alarm_event_data_t const*, void*)+0x866>
40376e94: f56f81 l32r	a8, 40374450 <_iram_text_start+0x4c> (3fcb6f08 <ecu::engine_target::(anonymous namespace)::idle_output>)
40376e97: 090c movi.n	a9, 0
40376e99: 004892 s8i	a9, a8, 0
40376e9c: 003b46 j	40376f8d <ecu::engine_target::(anonymous namespace)::on_alarm(gptimer_t*, gptimer_alarm_event_data_t const*, void*)+0x94d>
40376ea0: 20c1b2 addi	a11, a1, 32
40376ea3: 081865 call8	4037f028 <gptimer_get_raw_count>
40376ea6: 81a8 l32i.n	a10, a1, 32
40376ea8: 91b8 l32i.n	a11, a1, 36
40376eaa: f56881 l32r	a8, 4037444c <_iram_text_start+0x48> (3fcb6f10 <ecu::engine_target::(anonymous namespace)::idle_executor>)
40376ead: a808c2 l8ui	a12, a8, 168
40376eb0: 1ccc bnez.n	a12, 40376eb5 <ecu::engine_target::(anonymous namespace)::on_alarm(gptimer_t*, gptimer_alarm_event_data_t const*, void*)+0x875>
40376eb2: a908c2 l8ui	a12, a8, 169
40376eb5: f56681 l32r	a8, 40374450 <_iram_text_start+0x4c> (3fcb6f08 <ecu::engine_target::(anonymous namespace)::idle_output>)
40376eb8: 090c movi.n	a9, 0
40376eba: 004892 s8i	a9, a8, 0
40376ebd: f56381 l32r	a8, 4037444c <_iram_text_start+0x48> (3fcb6f10 <ecu::engine_target::(anonymous namespace)::idle_executor>)
40376ec0: a90882 l8ui	a8, a8, 169
40376ec3: 789c beqz.n	a8, 40376ede <ecu::engine_target::(anonymous namespace)::on_alarm(gptimer_t*, gptimer_alarm_event_data_t const*, void*)+0x89e>
40376ec5: f56181 l32r	a8, 4037444c <_iram_text_start+0x48> (3fcb6f10 <ecu::engine_target::(anonymous namespace)::idle_executor>)
40376ec8: 142892 l32i	a9, a8, 80
40376ecb: 1528e2 l32i	a14, a8, 84
40376ece: 0edd mov.n	a13, a14
40376ed0: f91b addi.n	a15, a9, 1
40376ed2: 020966 bnei	a9, -1, 40376ed8 <ecu::engine_target::(anonymous namespace)::on_alarm(gptimer_t*, gptimer_alarm_event_data_t const*, void*)+0x898>
40376ed5: 01ced2 addi	a13, a14, 1
40376ed8: 1468f2 s32i	a15, a8, 80
40376edb: 1568d2 s32i	a13, a8, 84
40376ede: f55b81 l32r	a8, 4037444c <_iram_text_start+0x48> (3fcb6f10 <ecu::engine_target::(anonymous namespace)::idle_executor>)
40376ee1: 090c movi.n	a9, 0
40376ee3: a94892 s8i	a9, a8, 169
40376ee6: a84892 s8i	a9, a8, 168
40376ee9: 0d0c movi.n	a13, 0
40376eeb: 2968d2 s32i	a13, a8, 164
40376eee: 2268a2 s32i	a10, a8, 136
40376ef1: 2368b2 s32i	a11, a8, 140
40376ef4: fb7c movi.n	a11, -1
40376ef6: 3068b2 s32i	a11, a8, 192
40376ef9: 3168b2 s32i	a11, a8, 196
40376efc: 2e68b2 s32i	a11, a8, 184
40376eff: 2f68b2 s32i	a11, a8, 188
40376f02: 2c68b2 s32i	a11, a8, 176
40376f05: 2d68b2 s32i	a11, a8, 180
40376f08: e94892 s8i	a9, a8, 233
40376f0b: 3c9c beqz.n	a12, 40376f22 <ecu::engine_target::(anonymous namespace)::on_alarm(gptimer_t*, gptimer_alarm_event_data_t const*, void*)+0x8e2>
40376f0d: 182892 l32i	a9, a8, 96
40376f10: 1928b2 l32i	a11, a8, 100
40376f13: 0bad mov.n	a10, a11
40376f15: c91b addi.n	a12, a9, 1
40376f17: 010966 bnei	a9, -1, 40376f1c <ecu::engine_target::(anonymous namespace)::on_alarm(gptimer_t*, gptimer_alarm_event_data_t const*, void*)+0x8dc>
40376f1a: ab1b addi.n	a10, a11, 1
40376f1c: 1868c2 s32i	a12, a8, 96
40376f1f: 1968a2 s32i	a10, a8, 100
40376f22: f54a81 l32r	a8, 4037444c <_iram_text_start+0x48> (3fcb6f10 <ecu::engine_target::(anonymous namespace)::idle_executor>)
40376f25: 390c movi.n	a9, 3
40376f27: ab4892 s8i	a9, a8, 171
40376f2a: 0017c6 j	40376f8d <ecu::engine_target::(anonymous namespace)::on_alarm(gptimer_t*, gptimer_alarm_event_data_t const*, void*)+0x94d>
40376f2d: f53a91 l32r	a9, 40374418 <_iram_text_start+0x14> (3fcb7600 <ecu::engine_target::(anonymous namespace)::executor+0x600>)
40376f30: 280992 l8ui	a9, a9, 40
40376f33: 515987 bbc	a9, a8, 40376f88 <ecu::engine_target::(anonymous namespace)::on_alarm(gptimer_t*, gptimer_alarm_event_data_t const*, void*)+0x948>
40376f36: c6a092 movi	a9, 198
40376f39: 989a add.n	a9, a8, a9
40376f3b: f538a1 l32r	a10, 4037441c <_iram_text_start+0x18> (3fcb7000 <ecu::engine_target::(anonymous namespace)::executor>)
40376f3e: b099a0 addx8	a9, a9, a10
40376f41: 0029a2 l32i	a10, a9, 0
40376f44: 012992 l32i	a9, a9, 4
40376f47: 133797 bltu	a7, a9, 40376f5e <ecu::engine_target::(anonymous namespace)::on_alarm(gptimer_t*, gptimer_alarm_event_data_t const*, void*)+0x91e>
40376f4a: 029977 bne	a9, a7, 40376f50 <ecu::engine_target::(anonymous namespace)::on_alarm(gptimer_t*, gptimer_alarm_event_data_t const*, void*)+0x910>
40376f4d: 0d36a7 bltu	a6, a10, 40376f5e <ecu::engine_target::(anonymous namespace)::on_alarm(gptimer_t*, gptimer_alarm_event_data_t const*, void*)+0x91e>
40376f50: c09790 sub	a9, a7, a9
40376f53: 01b6a7 bgeu	a6, a10, 40376f58 <ecu::engine_target::(anonymous namespace)::on_alarm(gptimer_t*, gptimer_alarm_event_data_t const*, void*)+0x918>
40376f56: 990b addi.n	a9, a9, -1
40376f58: c0a6a0 sub	a10, a6, a10
40376f5b: 0000c6 j	40376f62 <ecu::engine_target::(anonymous namespace)::on_alarm(gptimer_t*, gptimer_alarm_event_data_t const*, void*)+0x922>
40376f5e: 0a0c movi.n	a10, 0
40376f60: 0a9d mov.n	a9, a10
40376f62: 0e48f6 bgeui	a8, 4, 40376f74 <ecu::engine_target::(anonymous namespace)::on_alarm(gptimer_t*, gptimer_alarm_event_data_t const*, void*)+0x934>
40376f65: f543b1 l32r	a11, 40374474 <_iram_text_start+0x70> (3fcb7500 <ecu::engine_target::(anonymous namespace)::executor+0x500>)
40376f68: 3e2bd2 l32i	a13, a11, 248
40376f6b: 3f2bc2 l32i	a12, a11, 252
40376f6e: f529b1 l32r	a11, 40374414 <_iram_text_start+0x10> (3fcb75f8 <ecu::engine_target::(anonymous namespace)::executor+0x5f8>)
40376f71: 000186 j	40376f7b <ecu::engine_target::(anonymous namespace)::on_alarm(gptimer_t*, gptimer_alarm_event_data_t const*, void*)+0x93b>
40376f74: f529b1 l32r	a11, 40374418 <_iram_text_start+0x14> (3fcb7600 <ecu::engine_target::(anonymous namespace)::executor+0x600>)
40376f77: 0bd8 l32i.n	a13, a11, 0
40376f79: 1bc8 l32i.n	a12, a11, 4
40376f7b: 053c97 bltu	a12, a9, 40376f84 <ecu::engine_target::(anonymous namespace)::on_alarm(gptimer_t*, gptimer_alarm_event_data_t const*, void*)+0x944>
40376f7e: 0699c7 bne	a9, a12, 40376f88 <ecu::engine_target::(anonymous namespace)::on_alarm(gptimer_t*, gptimer_alarm_event_data_t const*, void*)+0x948>
40376f81: 03bda7 bgeu	a13, a10, 40376f88 <ecu::engine_target::(anonymous namespace)::on_alarm(gptimer_t*, gptimer_alarm_event_data_t const*, void*)+0x948>
40376f84: 0ba9 s32i.n	a10, a11, 0
40376f86: 1b99 s32i.n	a9, a11, 4
40376f88: 881b addi.n	a8, a8, 1
40376f8a: 000046 j	40376f8f <ecu::engine_target::(anonymous namespace)::on_alarm(gptimer_t*, gptimer_alarm_event_data_t const*, void*)+0x94f>
40376f8d: 080c movi.n	a8, 0
40376f8f: 9a88b6 bltui	a8, 8, 40376f2d <ecu::engine_target::(anonymous namespace)::on_alarm(gptimer_t*, gptimer_alarm_event_data_t const*, void*)+0x8ed>
40376f92: f52181 l32r	a8, 40374418 <_iram_text_start+0x14> (3fcb7600 <ecu::engine_target::(anonymous namespace)::executor+0x600>)
40376f95: 280882 l8ui	a8, a8, 40
40376f98: 055856 bnez	a8, 40376ff1 <ecu::engine_target::(anonymous namespace)::on_alarm(gptimer_t*, gptimer_alarm_event_data_t const*, void*)+0x9b1>
40376f9b: f87c movi.n	a8, -1
40376f9d: 8189 s32i.n	a8, a1, 32
40376f9f: 9189 s32i.n	a8, a1, 36
40376fa1: f51e81 l32r	a8, 4037441c <_iram_text_start+0x18> (3fcb7000 <ecu::engine_target::(anonymous namespace)::executor>)
40376fa4: 000e06 j	40376fe0 <ecu::engine_target::(anonymous namespace)::on_alarm(gptimer_t*, gptimer_alarm_event_data_t const*, void*)+0x9a0>
40376fa8: 010892 l8ui	a9, a8, 1
40376fab: e9ac beqz.n	a9, 40376fdd <ecu::engine_target::(anonymous namespace)::on_alarm(gptimer_t*, gptimer_alarm_event_data_t const*, void*)+0x99d>
40376fad: 000892 l8ui	a9, a8, 0
40376fb0: a98c beqz.n	a9, 40376fbe <ecu::engine_target::(anonymous namespace)::on_alarm(gptimer_t*, gptimer_alarm_event_data_t const*, void*)+0x97e>
40376fb2: 10c892 addi	a9, a8, 16
40376fb5: 48d8 l32i.n	a13, a8, 16
40376fb7: 58a8 l32i.n	a10, a8, 20
40376fb9: 0001c6 j	40376fc4 <ecu::engine_target::(anonymous namespace)::on_alarm(gptimer_t*, gptimer_alarm_event_data_t const*, void*)+0x984>
40376fbe: 988b addi.n	a9, a8, 8
40376fc0: 28d8 l32i.n	a13, a8, 8
40376fc2: 38a8 l32i.n	a10, a8, 12
40376fc4: 81c8 l32i.n	a12, a1, 32
40376fc6: 91b8 l32i.n	a11, a1, 36
40376fc8: 083ab7 bltu	a10, a11, 40376fd4 <ecu::engine_target::(anonymous namespace)::on_alarm(gptimer_t*, gptimer_alarm_event_data_t const*, void*)+0x994>
40376fcb: 029ba7 bne	a11, a10, 40376fd1 <ecu::engine_target::(anonymous namespace)::on_alarm(gptimer_t*, gptimer_alarm_event_data_t const*, void*)+0x991>
40376fce: 023dc7 bltu	a13, a12, 40376fd4 <ecu::engine_target::(anonymous namespace)::on_alarm(gptimer_t*, gptimer_alarm_event_data_t const*, void*)+0x994>
40376fd1: 20c192 addi	a9, a1, 32
40376fd4: 09a8 l32i.n	a10, a9, 0
40376fd6: 19b8 l32i.n	a11, a9, 4
40376fd8: 81a9 s32i.n	a10, a1, 32
40376fda: 0961b2 s32i	a11, a1, 36
40376fdd: 38c882 addi	a8, a8, 56
40376fe0: f51d91 l32r	a9, 40374454 <_iram_text_start+0x50> (3fcb71c0 <ecu::engine_target::(anonymous namespace)::executor+0x1c0>)
40376fe3: c19897 bne	a8, a9, 40376fa8 <ecu::engine_target::(anonymous namespace)::on_alarm(gptimer_t*, gptimer_alarm_event_data_t const*, void*)+0x968>
40376fe6: 8188 l32i.n	a8, a1, 32
40376fe8: 092192 l32i	a9, a1, 36
40376feb: 020866 bnei	a8, -1, 40376ff1 <ecu::engine_target::(anonymous namespace)::on_alarm(gptimer_t*, gptimer_alarm_event_data_t const*, void*)+0x9b1>
40376fee: 7a0926 beqi	a9, -1, 4037706c <ecu::engine_target::(anonymous namespace)::on_alarm(gptimer_t*, gptimer_alarm_event_data_t const*, void*)+0xa2c>
40376ff1: f52081 l32r	a8, 40374474 <_iram_text_start+0x70> (3fcb7500 <ecu::engine_target::(anonymous namespace)::executor+0x500>)
40376ff4: 302892 l32i	a9, a8, 192
40376ff7: 3128b2 l32i	a11, a8, 196
40376ffa: 0bad mov.n	a10, a11
40376ffc: c91b addi.n	a12, a9, 1
40376ffe: 020966 bnei	a9, -1, 40377004 <ecu::engine_target::(anonymous namespace)::on_alarm(gptimer_t*, gptimer_alarm_event_data_t const*, void*)+0x9c4>
40377001: 01cba2 addi	a10, a11, 1
40377004: 3068c2 s32i	a12, a8, 192
40377007: 3168a2 s32i	a10, a8, 196
4037700a: f51991 l32r	a9, 40374470 <_iram_text_start+0x6c> (3fcb8600 <ecu::engine_target::(anonymous namespace)::executor+0x1600>)
4037700d: 2c2982 l32i	a8, a9, 176
40377010: 2d2992 l32i	a9, a9, 180
40377013: 09bd mov.n	a11, a9
40377015: c81b addi.n	a12, a8, 1
40377017: 020866 bnei	a8, -1, 4037701d <ecu::engine_target::(anonymous namespace)::on_alarm(gptimer_t*, gptimer_alarm_event_data_t const*, void*)+0x9dd>
4037701a: 01c9b2 addi	a11, a9, 1
4037701d: f4ffa1 l32r	a10, 4037441c <_iram_text_start+0x18> (3fcb7000 <ecu::engine_target::(anonymous namespace)::executor>)
40377020: 16da92 addmi	a9, a10, 0x1600
40377023: 2c69c2 s32i	a12, a9, 176
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
403771a5: cc9897 bne	a8, a9, 40377175 <ecu::engine_target::(anonymous namespace)::on_alarm(gptimer_t*, gptimer_alarm_event_data_t const*, void*)+0xb35>
403771a8: f4a581 l32r	a8, 4037443c <_iram_text_start+0x38> (60004000 <GPIO>)
403771ab: 490c movi.n	a9, 4
403771ad: 0020c0 memw
403771b0: 3899 s32i.n	a9, a8, 12
403771b2: 290c movi.n	a9, 2
403771b4: 0020c0 memw
403771b7: 3899 s32i.n	a9, a8, 12
403771b9: f4a381 l32r	a8, 40374448 <_iram_text_start+0x44> (3fcb2e8c <ecu::engine_target::(anonymous namespace)::output>)
403771bc: 090c movi.n	a9, 0
403771be: 034892 s8i	a9, a8, 3
403771c1: f4a281 l32r	a8, 4037444c <_iram_text_start+0x48> (3fcb6f10 <ecu::engine_target::(anonymous namespace)::idle_executor>)
403771c4: a80882 l8ui	a8, a8, 168
403771c7: 68cc bnez.n	a8, 403771d1 <ecu::engine_target::(anonymous namespace)::on_alarm(gptimer_t*, gptimer_alarm_event_data_t const*, void*)+0xb91>
403771c9: f4a081 l32r	a8, 4037444c <_iram_text_start+0x48> (3fcb6f10 <ecu::engine_target::(anonymous namespace)::idle_executor>)
403771cc: a90882 l8ui	a8, a8, 169
403771cf: e88c beqz.n	a8, 403771e1 <ecu::engine_target::(anonymous namespace)::on_alarm(gptimer_t*, gptimer_alarm_event_data_t const*, void*)+0xba1>
403771d1: 080c movi.n	a8, 0
403771d3: 8189 s32i.n	a8, a1, 32
403771d5: 9189 s32i.n	a8, a1, 36
403771d7: f49681 l32r	a8, 40374430 <_iram_text_start+0x2c> (3fcbca08 <ecu::engine_target::(anonymous namespace)::timer>)
403771da: 08a8 l32i.n	a10, a8, 0
403771dc: cacc bnez.n	a10, 403771ec <ecu::engine_target::(anonymous namespace)::on_alarm(gptimer_t*, gptimer_alarm_event_data_t const*, void*)+0xbac>
403771de: 000406 j	403771f2 <ecu::engine_target::(anonymous namespace)::on_alarm(gptimer_t*, gptimer_alarm_event_data_t const*, void*)+0xbb2>
403771e1: f49b81 l32r	a8, 40374450 <_iram_text_start+0x4c> (3fcb6f08 <ecu::engine_target::(anonymous namespace)::idle_output>)
403771e4: 090c movi.n	a9, 0
403771e6: 004892 s8i	a9, a8, 0
403771e9: 003b06 j	403772d9 <ecu::engine_target::(anonymous namespace)::on_alarm(gptimer_t*, gptimer_alarm_event_data_t const*, void*)+0xc99>
403771ec: 20c1b2 addi	a11, a1, 32
403771ef: 07e3a5 call8	4037f028 <gptimer_get_raw_count>
403771f2: 81a8 l32i.n	a10, a1, 32
403771f4: 91b8 l32i.n	a11, a1, 36
403771f6: f49581 l32r	a8, 4037444c <_iram_text_start+0x48> (3fcb6f10 <ecu::engine_target::(anonymous namespace)::idle_executor>)
403771f9: a808c2 l8ui	a12, a8, 168
403771fc: 1ccc bnez.n	a12, 40377201 <ecu::engine_target::(anonymous namespace)::on_alarm(gptimer_t*, gptimer_alarm_event_data_t const*, void*)+0xbc1>
403771fe: a908c2 l8ui	a12, a8, 169
40377201: f49381 l32r	a8, 40374450 <_iram_text_start+0x4c> (3fcb6f08 <ecu::engine_target::(anonymous namespace)::idle_output>)
40377204: 090c movi.n	a9, 0
40377206: 004892 s8i	a9, a8, 0
40377209: f49081 l32r	a8, 4037444c <_iram_text_start+0x48> (3fcb6f10 <ecu::engine_target::(anonymous namespace)::idle_executor>)
4037720c: a90882 l8ui	a8, a8, 169
4037720f: 789c beqz.n	a8, 4037722a <ecu::engine_target::(anonymous namespace)::on_alarm(gptimer_t*, gptimer_alarm_event_data_t const*, void*)+0xbea>
40377211: f48e81 l32r	a8, 4037444c <_iram_text_start+0x48> (3fcb6f10 <ecu::engine_target::(anonymous namespace)::idle_executor>)
40377214: 142892 l32i	a9, a8, 80
40377217: 1528e2 l32i	a14, a8, 84
4037721a: 0edd mov.n	a13, a14
4037721c: f91b addi.n	a15, a9, 1
4037721e: 020966 bnei	a9, -1, 40377224 <ecu::engine_target::(anonymous namespace)::on_alarm(gptimer_t*, gptimer_alarm_event_data_t const*, void*)+0xbe4>
40377221: 01ced2 addi	a13, a14, 1
40377224: 1468f2 s32i	a15, a8, 80
40377227: 1568d2 s32i	a13, a8, 84
4037722a: f48881 l32r	a8, 4037444c <_iram_text_start+0x48> (3fcb6f10 <ecu::engine_target::(anonymous namespace)::idle_executor>)
4037722d: 090c movi.n	a9, 0
4037722f: a94892 s8i	a9, a8, 169
40377232: a84892 s8i	a9, a8, 168
40377235: 0d0c movi.n	a13, 0
40377237: 2968d2 s32i	a13, a8, 164
4037723a: 2268a2 s32i	a10, a8, 136
4037723d: 2368b2 s32i	a11, a8, 140
40377240: fb7c movi.n	a11, -1
40377242: 3068b2 s32i	a11, a8, 192
40377245: 3168b2 s32i	a11, a8, 196
40377248: 2e68b2 s32i	a11, a8, 184
4037724b: 2f68b2 s32i	a11, a8, 188
4037724e: 2c68b2 s32i	a11, a8, 176
40377251: 2d68b2 s32i	a11, a8, 180
40377254: e94892 s8i	a9, a8, 233
40377257: 3c9c beqz.n	a12, 4037726e <ecu::engine_target::(anonymous namespace)::on_alarm(gptimer_t*, gptimer_alarm_event_data_t const*, void*)+0xc2e>
40377259: 182892 l32i	a9, a8, 96
4037725c: 1928b2 l32i	a11, a8, 100
4037725f: 0bad mov.n	a10, a11
40377261: c91b addi.n	a12, a9, 1
40377263: 010966 bnei	a9, -1, 40377268 <ecu::engine_target::(anonymous namespace)::on_alarm(gptimer_t*, gptimer_alarm_event_data_t const*, void*)+0xc28>
40377266: ab1b addi.n	a10, a11, 1
40377268: 1868c2 s32i	a12, a8, 96
4037726b: 1968a2 s32i	a10, a8, 100
4037726e: f47781 l32r	a8, 4037444c <_iram_text_start+0x48> (3fcb6f10 <ecu::engine_target::(anonymous namespace)::idle_executor>)
40377271: 390c movi.n	a9, 3
40377273: ab4892 s8i	a9, a8, 171
40377276: 0017c6 j	403772d9 <ecu::engine_target::(anonymous namespace)::on_alarm(gptimer_t*, gptimer_alarm_event_data_t const*, void*)+0xc99>
40377279: f46791 l32r	a9, 40374418 <_iram_text_start+0x14> (3fcb7600 <ecu::engine_target::(anonymous namespace)::executor+0x600>)
4037727c: 280992 l8ui	a9, a9, 40
4037727f: 515987 bbc	a9, a8, 403772d4 <ecu::engine_target::(anonymous namespace)::on_alarm(gptimer_t*, gptimer_alarm_event_data_t const*, void*)+0xc94>
40377282: c6a092 movi	a9, 198
40377285: 989a add.n	a9, a8, a9
40377287: f465a1 l32r	a10, 4037441c <_iram_text_start+0x18> (3fcb7000 <ecu::engine_target::(anonymous namespace)::executor>)
4037728a: b099a0 addx8	a9, a9, a10
4037728d: 0029a2 l32i	a10, a9, 0
40377290: 012992 l32i	a9, a9, 4
40377293: 133797 bltu	a7, a9, 403772aa <ecu::engine_target::(anonymous namespace)::on_alarm(gptimer_t*, gptimer_alarm_event_data_t const*, void*)+0xc6a>
40377296: 029977 bne	a9, a7, 4037729c <ecu::engine_target::(anonymous namespace)::on_alarm(gptimer_t*, gptimer_alarm_event_data_t const*, void*)+0xc5c>
40377299: 0d36a7 bltu	a6, a10, 403772aa <ecu::engine_target::(anonymous namespace)::on_alarm(gptimer_t*, gptimer_alarm_event_data_t const*, void*)+0xc6a>
4037729c: c09790 sub	a9, a7, a9
4037729f: 01b6a7 bgeu	a6, a10, 403772a4 <ecu::engine_target::(anonymous namespace)::on_alarm(gptimer_t*, gptimer_alarm_event_data_t const*, void*)+0xc64>
403772a2: 990b addi.n	a9, a9, -1
403772a4: c0a6a0 sub	a10, a6, a10
403772a7: 0000c6 j	403772ae <ecu::engine_target::(anonymous namespace)::on_alarm(gptimer_t*, gptimer_alarm_event_data_t const*, void*)+0xc6e>
403772aa: 0a0c movi.n	a10, 0
403772ac: 0a9d mov.n	a9, a10
403772ae: 0e48f6 bgeui	a8, 4, 403772c0 <ecu::engine_target::(anonymous namespace)::on_alarm(gptimer_t*, gptimer_alarm_event_data_t const*, void*)+0xc80>
403772b1: f470b1 l32r	a11, 40374474 <_iram_text_start+0x70> (3fcb7500 <ecu::engine_target::(anonymous namespace)::executor+0x500>)
403772b4: 3e2bd2 l32i	a13, a11, 248
403772b7: 3f2bc2 l32i	a12, a11, 252
403772ba: f456b1 l32r	a11, 40374414 <_iram_text_start+0x10> (3fcb75f8 <ecu::engine_target::(anonymous namespace)::executor+0x5f8>)
403772bd: 000186 j	403772c7 <ecu::engine_target::(anonymous namespace)::on_alarm(gptimer_t*, gptimer_alarm_event_data_t const*, void*)+0xc87>
403772c0: f456b1 l32r	a11, 40374418 <_iram_text_start+0x14> (3fcb7600 <ecu::engine_target::(anonymous namespace)::executor+0x600>)
403772c3: 0bd8 l32i.n	a13, a11, 0
403772c5: 1bc8 l32i.n	a12, a11, 4
403772c7: 053c97 bltu	a12, a9, 403772d0 <ecu::engine_target::(anonymous namespace)::on_alarm(gptimer_t*, gptimer_alarm_event_data_t const*, void*)+0xc90>
403772ca: 0699c7 bne	a9, a12, 403772d4 <ecu::engine_target::(anonymous namespace)::on_alarm(gptimer_t*, gptimer_alarm_event_data_t const*, void*)+0xc94>
403772cd: 03bda7 bgeu	a13, a10, 403772d4 <ecu::engine_target::(anonymous namespace)::on_alarm(gptimer_t*, gptimer_alarm_event_data_t const*, void*)+0xc94>
403772d0: 0ba9 s32i.n	a10, a11, 0
403772d2: 1b99 s32i.n	a9, a11, 4
403772d4: 881b addi.n	a8, a8, 1
403772d6: 000046 j	403772db <ecu::engine_target::(anonymous namespace)::on_alarm(gptimer_t*, gptimer_alarm_event_data_t const*, void*)+0xc9b>
403772d9: 080c movi.n	a8, 0
403772db: 9a88b6 bltui	a8, 8, 40377279 <ecu::engine_target::(anonymous namespace)::on_alarm(gptimer_t*, gptimer_alarm_event_data_t const*, void*)+0xc39>
403772de: f44e81 l32r	a8, 40374418 <_iram_text_start+0x14> (3fcb7600 <ecu::engine_target::(anonymous namespace)::executor+0x600>)
403772e1: 280882 l8ui	a8, a8, 40
403772e4: 055856 bnez	a8, 4037733d <ecu::engine_target::(anonymous namespace)::on_alarm(gptimer_t*, gptimer_alarm_event_data_t const*, void*)+0xcfd>
403772e7: f87c movi.n	a8, -1
403772e9: 8189 s32i.n	a8, a1, 32
403772eb: 9189 s32i.n	a8, a1, 36
403772ed: f44b81 l32r	a8, 4037441c <_iram_text_start+0x18> (3fcb7000 <ecu::engine_target::(anonymous namespace)::executor>)
403772f0: 000e06 j	4037732c <ecu::engine_target::(anonymous namespace)::on_alarm(gptimer_t*, gptimer_alarm_event_data_t const*, void*)+0xcec>
403772f4: 010892 l8ui	a9, a8, 1
403772f7: e9ac beqz.n	a9, 40377329 <ecu::engine_target::(anonymous namespace)::on_alarm(gptimer_t*, gptimer_alarm_event_data_t const*, void*)+0xce9>
403772f9: 000892 l8ui	a9, a8, 0
403772fc: a98c beqz.n	a9, 4037730a <ecu::engine_target::(anonymous namespace)::on_alarm(gptimer_t*, gptimer_alarm_event_data_t const*, void*)+0xcca>
403772fe: 10c892 addi	a9, a8, 16
40377301: 48d8 l32i.n	a13, a8, 16
40377303: 58a8 l32i.n	a10, a8, 20
40377305: 0001c6 j	40377310 <ecu::engine_target::(anonymous namespace)::on_alarm(gptimer_t*, gptimer_alarm_event_data_t const*, void*)+0xcd0>
4037730a: 988b addi.n	a9, a8, 8
4037730c: 28d8 l32i.n	a13, a8, 8
4037730e: 38a8 l32i.n	a10, a8, 12
40377310: 81c8 l32i.n	a12, a1, 32
40377312: 91b8 l32i.n	a11, a1, 36
40377314: 083ab7 bltu	a10, a11, 40377320 <ecu::engine_target::(anonymous namespace)::on_alarm(gptimer_t*, gptimer_alarm_event_data_t const*, void*)+0xce0>
40377317: 029ba7 bne	a11, a10, 4037731d <ecu::engine_target::(anonymous namespace)::on_alarm(gptimer_t*, gptimer_alarm_event_data_t const*, void*)+0xcdd>
4037731a: 023dc7 bltu	a13, a12, 40377320 <ecu::engine_target::(anonymous namespace)::on_alarm(gptimer_t*, gptimer_alarm_event_data_t const*, void*)+0xce0>
4037731d: 20c192 addi	a9, a1, 32
40377320: 09a8 l32i.n	a10, a9, 0
40377322: 19b8 l32i.n	a11, a9, 4
40377324: 81a9 s32i.n	a10, a1, 32
40377326: 0961b2 s32i	a11, a1, 36
40377329: 38c882 addi	a8, a8, 56
4037732c: f44a91 l32r	a9, 40374454 <_iram_text_start+0x50> (3fcb71c0 <ecu::engine_target::(anonymous namespace)::executor+0x1c0>)
4037732f: c19897 bne	a8, a9, 403772f4 <ecu::engine_target::(anonymous namespace)::on_alarm(gptimer_t*, gptimer_alarm_event_data_t const*, void*)+0xcb4>
40377332: 8188 l32i.n	a8, a1, 32
40377334: 092192 l32i	a9, a1, 36
40377337: 020866 bnei	a8, -1, 4037733d <ecu::engine_target::(anonymous namespace)::on_alarm(gptimer_t*, gptimer_alarm_event_data_t const*, void*)+0xcfd>
4037733a: 7a0926 beqi	a9, -1, 403773b8 <ecu::engine_target::(anonymous namespace)::on_alarm(gptimer_t*, gptimer_alarm_event_data_t const*, void*)+0xd78>
4037733d: f44d81 l32r	a8, 40374474 <_iram_text_start+0x70> (3fcb7500 <ecu::engine_target::(anonymous namespace)::executor+0x500>)
40377340: 302892 l32i	a9, a8, 192
40377343: 3128b2 l32i	a11, a8, 196
40377346: 0bad mov.n	a10, a11
40377348: c91b addi.n	a12, a9, 1
4037734a: 020966 bnei	a9, -1, 40377350 <ecu::engine_target::(anonymous namespace)::on_alarm(gptimer_t*, gptimer_alarm_event_data_t const*, void*)+0xd10>
4037734d: 01cba2 addi	a10, a11, 1
40377350: 3068c2 s32i	a12, a8, 192
40377353: 3168a2 s32i	a10, a8, 196
40377356: f44691 l32r	a9, 40374470 <_iram_text_start+0x6c> (3fcb8600 <ecu::engine_target::(anonymous namespace)::executor+0x1600>)
40377359: 2c2982 l32i	a8, a9, 176
4037735c: 2d2992 l32i	a9, a9, 180
4037735f: 09bd mov.n	a11, a9
40377361: c81b addi.n	a12, a8, 1
40377363: 020866 bnei	a8, -1, 40377369 <ecu::engine_target::(anonymous namespace)::on_alarm(gptimer_t*, gptimer_alarm_event_data_t const*, void*)+0xd29>
40377366: 01c9b2 addi	a11, a9, 1
40377369: f42ca1 l32r	a10, 4037441c <_iram_text_start+0x18> (3fcb7000 <ecu::engine_target::(anonymous namespace)::executor>)
4037736c: 16da92 addmi	a9, a10, 0x1600
4037736f: 2c69c2 s32i	a12, a9, 176
40377372: 2d69b2 s32i	a11, a9, 180
40377375: 649080 extui	a9, a8, 0, 7
40377378: 06da82 addmi	a8, a10, 0x600
4037737b: 1199b0 slli	a9, a9, 5
4037737e: 889a add.n	a8, a8, a9
40377380: b0a092 movi	a9, 176
40377383: 989a add.n	a9, a8, a9
40377385: 09c9 s32i.n	a12, a9, 0
40377387: 19b9 s32i.n	a11, a9, 4
40377389: b8a092 movi	a9, 184
4037738c: 989a add.n	a9, a8, a9
4037738e: 0969 s32i.n	a6, a9, 0
40377390: 1979 s32i.n	a7, a9, 4
40377392: c0a092 movi	a9, 192
40377395: 989a add.n	a9, a8, a9
40377397: 0969 s32i.n	a6, a9, 0
40377399: 1979 s32i.n	a7, a9, 4
4037739b: 05daa2 addmi	a10, a10, 0x500
4037739e: 222a92 l32i	a9, a10, 136
403773a1: 326892 s32i	a9, a8, 200
403773a4: f97c movi.n	a9, -1
403773a6: cc4892 s8i	a9, a8, 204
403773a9: cda092 movi	a9, 205
403773ac: 989a add.n	a9, a8, a9
403773ae: 0a0c movi.n	a10, 0
403773b0: 0049a2 s8i	a10, a9, 0
403773b3: 890c movi.n	a9, 8
403773b5: ce4892 s8i	a9, a8, 206
403773b8: f41951 l32r	a5, 4037441c <_iram_text_start+0x18> (3fcb7000 <ecu::engine_target::(anonymous namespace)::executor>)
403773bb: 06d582 addmi	a8, a5, 0x600
403773be: 090c movi.n	a9, 0
403773c0: 284892 s8i	a9, a8, 40
403773c3: 000406 j	403773d7 <ecu::engine_target::(anonymous namespace)::on_alarm(gptimer_t*, gptimer_alarm_event_data_t const*, void*)+0xd97>
403773c6: 8c3c movi.n	a12, 56
403773c8: 00a0b2 movi	a11, 0
403773cb: 20a550 or	a10, a5, a5
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
4037749e: cc4892 s8i	a9, a8, 204
403774a1: cda092 movi	a9, 205
403774a4: 989a add.n	a9, a8, a9
403774a6: 0a0c movi.n	a10, 0
403774a8: 0049a2 s8i	a10, a9, 0
403774ab: 790c movi.n	a9, 7
403774ad: ce4892 s8i	a9, a8, 206
403774b0: f3e381 l32r	a8, 4037443c <_iram_text_start+0x38> (60004000 <GPIO>)
403774b3: f3e391 l32r	a9, 40374440 <_iram_text_start+0x3c> (8000 <UserFrameTotalSize+0x7f00>)
403774b6: 0020c0 memw
403774b9: 6899 s32i.n	a9, a8, 24
403774bb: f3d581 l32r	a8, 40374410 <_iram_text_start+0xc> (3fcb2e90 <ecu::engine_target::(anonymous namespace)::output_pins>)
403774be: 000b06 j	403774ee <ecu::engine_target::(anonymous namespace)::on_alarm(gptimer_t*, gptimer_alarm_event_data_t const*, void*)+0xeae>
403774c1: 0898 l32i.n	a9, a8, 0
403774c3: fa1c movi.n	a10, 31
403774c5: 133a97 bltu	a10, a9, 403774dc <ecu::engine_target::(anonymous namespace)::on_alarm(gptimer_t*, gptimer_alarm_event_data_t const*, void*)+0xe9c>
403774c8: 1a0c movi.n	a10, 1
403774ca: 401900 ssl	a9
403774cd: a19a00 sll	a9, a10
403774d0: f3dba1 l32r	a10, 4037443c <_iram_text_start+0x38> (60004000 <GPIO>)
403774d3: 0020c0 memw
403774d6: 3a99 s32i.n	a9, a10, 12
403774d8: 000406 j	403774ec <ecu::engine_target::(anonymous namespace)::on_alarm(gptimer_t*, gptimer_alarm_event_data_t const*, void*)+0xeac>
403774dc: 1a0c movi.n	a10, 1
403774de: 401900 ssl	a9
403774e1: a19a00 sll	a9, a10
403774e4: f3d6a1 l32r	a10, 4037443c <_iram_text_start+0x38> (60004000 <GPIO>)
403774e7: 0020c0 memw
403774ea: 6a99 s32i.n	a9, a10, 24
403774ec: 884b addi.n	a8, a8, 4
403774ee: f3d591 l32r	a9, 40374444 <_iram_text_start+0x40> (3fcb2eb0 <ecu::engine_target::(anonymous namespace)::lock>)
403774f1: cc9897 bne	a8, a9, 403774c1 <ecu::engine_target::(anonymous namespace)::on_alarm(gptimer_t*, gptimer_alarm_event_data_t const*, void*)+0xe81>
403774f4: f3d281 l32r	a8, 4037443c <_iram_text_start+0x38> (60004000 <GPIO>)
403774f7: 490c movi.n	a9, 4
403774f9: 0020c0 memw
403774fc: 3899 s32i.n	a9, a8, 12
403774fe: 290c movi.n	a9, 2
40377500: 0020c0 memw
40377503: 3899 s32i.n	a9, a8, 12
40377505: f3d081 l32r	a8, 40374448 <_iram_text_start+0x44> (3fcb2e8c <ecu::engine_target::(anonymous namespace)::output>)
40377508: 090c movi.n	a9, 0
4037750a: 034892 s8i	a9, a8, 3
4037750d: f3cf81 l32r	a8, 4037444c <_iram_text_start+0x48> (3fcb6f10 <ecu::engine_target::(anonymous namespace)::idle_executor>)
40377510: a80882 l8ui	a8, a8, 168
40377513: 68cc bnez.n	a8, 4037751d <ecu::engine_target::(anonymous namespace)::on_alarm(gptimer_t*, gptimer_alarm_event_data_t const*, void*)+0xedd>
40377515: f3cd81 l32r	a8, 4037444c <_iram_text_start+0x48> (3fcb6f10 <ecu::engine_target::(anonymous namespace)::idle_executor>)
40377518: a90882 l8ui	a8, a8, 169
4037751b: e88c beqz.n	a8, 4037752d <ecu::engine_target::(anonymous namespace)::on_alarm(gptimer_t*, gptimer_alarm_event_data_t const*, void*)+0xeed>
4037751d: 080c movi.n	a8, 0
4037751f: 8189 s32i.n	a8, a1, 32
40377521: 9189 s32i.n	a8, a1, 36
40377523: f3c381 l32r	a8, 40374430 <_iram_text_start+0x2c> (3fcbca08 <ecu::engine_target::(anonymous namespace)::timer>)
40377526: 08a8 l32i.n	a10, a8, 0
40377528: cacc bnez.n	a10, 40377538 <ecu::engine_target::(anonymous namespace)::on_alarm(gptimer_t*, gptimer_alarm_event_data_t const*, void*)+0xef8>
4037752a: 000406 j	4037753e <ecu::engine_target::(anonymous namespace)::on_alarm(gptimer_t*, gptimer_alarm_event_data_t const*, void*)+0xefe>
4037752d: f3c881 l32r	a8, 40374450 <_iram_text_start+0x4c> (3fcb6f08 <ecu::engine_target::(anonymous namespace)::idle_output>)
40377530: 090c movi.n	a9, 0
40377532: 004892 s8i	a9, a8, 0
40377535: 003b06 j	40377625 <ecu::engine_target::(anonymous namespace)::on_alarm(gptimer_t*, gptimer_alarm_event_data_t const*, void*)+0xfe5>
40377538: 20c1b2 addi	a11, a1, 32
4037753b: 07aee5 call8	4037f028 <gptimer_get_raw_count>
4037753e: 81a8 l32i.n	a10, a1, 32
40377540: 91b8 l32i.n	a11, a1, 36
40377542: f3c281 l32r	a8, 4037444c <_iram_text_start+0x48> (3fcb6f10 <ecu::engine_target::(anonymous namespace)::idle_executor>)
40377545: a808c2 l8ui	a12, a8, 168
40377548: 1ccc bnez.n	a12, 4037754d <ecu::engine_target::(anonymous namespace)::on_alarm(gptimer_t*, gptimer_alarm_event_data_t const*, void*)+0xf0d>
4037754a: a908c2 l8ui	a12, a8, 169
4037754d: f3c081 l32r	a8, 40374450 <_iram_text_start+0x4c> (3fcb6f08 <ecu::engine_target::(anonymous namespace)::idle_output>)
40377550: 090c movi.n	a9, 0
40377552: 004892 s8i	a9, a8, 0
40377555: f3bd81 l32r	a8, 4037444c <_iram_text_start+0x48> (3fcb6f10 <ecu::engine_target::(anonymous namespace)::idle_executor>)
40377558: a90882 l8ui	a8, a8, 169
4037755b: 789c beqz.n	a8, 40377576 <ecu::engine_target::(anonymous namespace)::on_alarm(gptimer_t*, gptimer_alarm_event_data_t const*, void*)+0xf36>
4037755d: f3bb81 l32r	a8, 4037444c <_iram_text_start+0x48> (3fcb6f10 <ecu::engine_target::(anonymous namespace)::idle_executor>)
40377560: 142892 l32i	a9, a8, 80
40377563: 1528e2 l32i	a14, a8, 84
40377566: 0edd mov.n	a13, a14
40377568: f91b addi.n	a15, a9, 1
4037756a: 020966 bnei	a9, -1, 40377570 <ecu::engine_target::(anonymous namespace)::on_alarm(gptimer_t*, gptimer_alarm_event_data_t const*, void*)+0xf30>
4037756d: 01ced2 addi	a13, a14, 1
40377570: 1468f2 s32i	a15, a8, 80
40377573: 1568d2 s32i	a13, a8, 84
40377576: f3b581 l32r	a8, 4037444c <_iram_text_start+0x48> (3fcb6f10 <ecu::engine_target::(anonymous namespace)::idle_executor>)
40377579: 090c movi.n	a9, 0
4037757b: a94892 s8i	a9, a8, 169
4037757e: a84892 s8i	a9, a8, 168
40377581: 0d0c movi.n	a13, 0
40377583: 2968d2 s32i	a13, a8, 164
40377586: 2268a2 s32i	a10, a8, 136
40377589: 2368b2 s32i	a11, a8, 140
4037758c: fb7c movi.n	a11, -1
4037758e: 3068b2 s32i	a11, a8, 192
40377591: 3168b2 s32i	a11, a8, 196
40377594: 2e68b2 s32i	a11, a8, 184
40377597: 2f68b2 s32i	a11, a8, 188
4037759a: 2c68b2 s32i	a11, a8, 176
4037759d: 2d68b2 s32i	a11, a8, 180
403775a0: e94892 s8i	a9, a8, 233
403775a3: 3c9c beqz.n	a12, 403775ba <ecu::engine_target::(anonymous namespace)::on_alarm(gptimer_t*, gptimer_alarm_event_data_t const*, void*)+0xf7a>
403775a5: 182892 l32i	a9, a8, 96
403775a8: 1928b2 l32i	a11, a8, 100
403775ab: 0bad mov.n	a10, a11
403775ad: c91b addi.n	a12, a9, 1
403775af: 010966 bnei	a9, -1, 403775b4 <ecu::engine_target::(anonymous namespace)::on_alarm(gptimer_t*, gptimer_alarm_event_data_t const*, void*)+0xf74>
403775b2: ab1b addi.n	a10, a11, 1
403775b4: 1868c2 s32i	a12, a8, 96
403775b7: 1968a2 s32i	a10, a8, 100
403775ba: f3a481 l32r	a8, 4037444c <_iram_text_start+0x48> (3fcb6f10 <ecu::engine_target::(anonymous namespace)::idle_executor>)
403775bd: 390c movi.n	a9, 3
403775bf: ab4892 s8i	a9, a8, 171
403775c2: 0017c6 j	40377625 <ecu::engine_target::(anonymous namespace)::on_alarm(gptimer_t*, gptimer_alarm_event_data_t const*, void*)+0xfe5>
403775c5: f39491 l32r	a9, 40374418 <_iram_text_start+0x14> (3fcb7600 <ecu::engine_target::(anonymous namespace)::executor+0x600>)
403775c8: 280992 l8ui	a9, a9, 40
403775cb: 515987 bbc	a9, a8, 40377620 <ecu::engine_target::(anonymous namespace)::on_alarm(gptimer_t*, gptimer_alarm_event_data_t const*, void*)+0xfe0>
403775ce: c6a092 movi	a9, 198
403775d1: 989a add.n	a9, a8, a9
403775d3: f392a1 l32r	a10, 4037441c <_iram_text_start+0x18> (3fcb7000 <ecu::engine_target::(anonymous namespace)::executor>)
403775d6: b099a0 addx8	a9, a9, a10
403775d9: 0029a2 l32i	a10, a9, 0
403775dc: 012992 l32i	a9, a9, 4
403775df: 133797 bltu	a7, a9, 403775f6 <ecu::engine_target::(anonymous namespace)::on_alarm(gptimer_t*, gptimer_alarm_event_data_t const*, void*)+0xfb6>
403775e2: 029977 bne	a9, a7, 403775e8 <ecu::engine_target::(anonymous namespace)::on_alarm(gptimer_t*, gptimer_alarm_event_data_t const*, void*)+0xfa8>
403775e5: 0d36a7 bltu	a6, a10, 403775f6 <ecu::engine_target::(anonymous namespace)::on_alarm(gptimer_t*, gptimer_alarm_event_data_t const*, void*)+0xfb6>
403775e8: c09790 sub	a9, a7, a9
403775eb: 01b6a7 bgeu	a6, a10, 403775f0 <ecu::engine_target::(anonymous namespace)::on_alarm(gptimer_t*, gptimer_alarm_event_data_t const*, void*)+0xfb0>
403775ee: 990b addi.n	a9, a9, -1
403775f0: c0a6a0 sub	a10, a6, a10
403775f3: 0000c6 j	403775fa <ecu::engine_target::(anonymous namespace)::on_alarm(gptimer_t*, gptimer_alarm_event_data_t const*, void*)+0xfba>
403775f6: 0a0c movi.n	a10, 0
403775f8: 0a9d mov.n	a9, a10
403775fa: 0e48f6 bgeui	a8, 4, 4037760c <ecu::engine_target::(anonymous namespace)::on_alarm(gptimer_t*, gptimer_alarm_event_data_t const*, void*)+0xfcc>
403775fd: f39db1 l32r	a11, 40374474 <_iram_text_start+0x70> (3fcb7500 <ecu::engine_target::(anonymous namespace)::executor+0x500>)
40377600: 3e2bd2 l32i	a13, a11, 248
40377603: 3f2bc2 l32i	a12, a11, 252
40377606: f383b1 l32r	a11, 40374414 <_iram_text_start+0x10> (3fcb75f8 <ecu::engine_target::(anonymous namespace)::executor+0x5f8>)
40377609: 000186 j	40377613 <ecu::engine_target::(anonymous namespace)::on_alarm(gptimer_t*, gptimer_alarm_event_data_t const*, void*)+0xfd3>
4037760c: f383b1 l32r	a11, 40374418 <_iram_text_start+0x14> (3fcb7600 <ecu::engine_target::(anonymous namespace)::executor+0x600>)
4037760f: 0bd8 l32i.n	a13, a11, 0
40377611: 1bc8 l32i.n	a12, a11, 4
40377613: 053c97 bltu	a12, a9, 4037761c <ecu::engine_target::(anonymous namespace)::on_alarm(gptimer_t*, gptimer_alarm_event_data_t const*, void*)+0xfdc>
40377616: 0699c7 bne	a9, a12, 40377620 <ecu::engine_target::(anonymous namespace)::on_alarm(gptimer_t*, gptimer_alarm_event_data_t const*, void*)+0xfe0>
40377619: 03bda7 bgeu	a13, a10, 40377620 <ecu::engine_target::(anonymous namespace)::on_alarm(gptimer_t*, gptimer_alarm_event_data_t const*, void*)+0xfe0>
4037761c: 0ba9 s32i.n	a10, a11, 0
4037761e: 1b99 s32i.n	a9, a11, 4
40377620: 881b addi.n	a8, a8, 1
40377622: 000046 j	40377627 <ecu::engine_target::(anonymous namespace)::on_alarm(gptimer_t*, gptimer_alarm_event_data_t const*, void*)+0xfe7>
40377625: 080c movi.n	a8, 0
40377627: 9a88b6 bltui	a8, 8, 403775c5 <ecu::engine_target::(anonymous namespace)::on_alarm(gptimer_t*, gptimer_alarm_event_data_t const*, void*)+0xf85>
4037762a: f37b81 l32r	a8, 40374418 <_iram_text_start+0x14> (3fcb7600 <ecu::engine_target::(anonymous namespace)::executor+0x600>)
4037762d: 280882 l8ui	a8, a8, 40
40377630: 055856 bnez	a8, 40377689 <ecu::engine_target::(anonymous namespace)::on_alarm(gptimer_t*, gptimer_alarm_event_data_t const*, void*)+0x1049>
40377633: f87c movi.n	a8, -1
40377635: 8189 s32i.n	a8, a1, 32
40377637: 9189 s32i.n	a8, a1, 36
40377639: f37881 l32r	a8, 4037441c <_iram_text_start+0x18> (3fcb7000 <ecu::engine_target::(anonymous namespace)::executor>)
4037763c: 000e06 j	40377678 <ecu::engine_target::(anonymous namespace)::on_alarm(gptimer_t*, gptimer_alarm_event_data_t const*, void*)+0x1038>
40377640: 010892 l8ui	a9, a8, 1
40377643: e9ac beqz.n	a9, 40377675 <ecu::engine_target::(anonymous namespace)::on_alarm(gptimer_t*, gptimer_alarm_event_data_t const*, void*)+0x1035>
40377645: 000892 l8ui	a9, a8, 0
40377648: 898c beqz.n	a9, 40377654 <ecu::engine_target::(anonymous namespace)::on_alarm(gptimer_t*, gptimer_alarm_event_data_t const*, void*)+0x1014>
4037764a: 10c892 addi	a9, a8, 16
4037764d: 48d8 l32i.n	a13, a8, 16
4037764f: 58a8 l32i.n	a10, a8, 20
40377651: 000146 j	4037765a <ecu::engine_target::(anonymous namespace)::on_alarm(gptimer_t*, gptimer_alarm_event_data_t const*, void*)+0x101a>
40377654: 988b addi.n	a9, a8, 8
40377656: 28d8 l32i.n	a13, a8, 8
40377658: 38a8 l32i.n	a10, a8, 12
4037765a: 0821c2 l32i	a12, a1, 32
4037765d: 0921b2 l32i	a11, a1, 36
40377660: 083ab7 bltu	a10, a11, 4037766c <ecu::engine_target::(anonymous namespace)::on_alarm(gptimer_t*, gptimer_alarm_event_data_t const*, void*)+0x102c>
40377663: 029ba7 bne	a11, a10, 40377669 <ecu::engine_target::(anonymous namespace)::on_alarm(gptimer_t*, gptimer_alarm_event_data_t const*, void*)+0x1029>
40377666: 023dc7 bltu	a13, a12, 4037766c <ecu::engine_target::(anonymous namespace)::on_alarm(gptimer_t*, gptimer_alarm_event_data_t const*, void*)+0x102c>
40377669: 20c192 addi	a9, a1, 32
4037766c: 09a8 l32i.n	a10, a9, 0
4037766e: 19b8 l32i.n	a11, a9, 4
40377670: 81a9 s32i.n	a10, a1, 32
40377672: 0961b2 s32i	a11, a1, 36
40377675: 38c882 addi	a8, a8, 56
40377678: f37791 l32r	a9, 40374454 <_iram_text_start+0x50> (3fcb71c0 <ecu::engine_target::(anonymous namespace)::executor+0x1c0>)
4037767b: c19897 bne	a8, a9, 40377640 <ecu::engine_target::(anonymous namespace)::on_alarm(gptimer_t*, gptimer_alarm_event_data_t const*, void*)+0x1000>
4037767e: 8188 l32i.n	a8, a1, 32
40377680: 092192 l32i	a9, a1, 36
40377683: 020866 bnei	a8, -1, 40377689 <ecu::engine_target::(anonymous namespace)::on_alarm(gptimer_t*, gptimer_alarm_event_data_t const*, void*)+0x1049>
40377686: 7a0926 beqi	a9, -1, 40377704 <ecu::engine_target::(anonymous namespace)::on_alarm(gptimer_t*, gptimer_alarm_event_data_t const*, void*)+0x10c4>
40377689: f37a81 l32r	a8, 40374474 <_iram_text_start+0x70> (3fcb7500 <ecu::engine_target::(anonymous namespace)::executor+0x500>)
4037768c: 302892 l32i	a9, a8, 192
4037768f: 3128b2 l32i	a11, a8, 196
40377692: 0bad mov.n	a10, a11
40377694: c91b addi.n	a12, a9, 1
40377696: 020966 bnei	a9, -1, 4037769c <ecu::engine_target::(anonymous namespace)::on_alarm(gptimer_t*, gptimer_alarm_event_data_t const*, void*)+0x105c>
40377699: 01cba2 addi	a10, a11, 1
4037769c: 3068c2 s32i	a12, a8, 192
4037769f: 3168a2 s32i	a10, a8, 196
403776a2: f37391 l32r	a9, 40374470 <_iram_text_start+0x6c> (3fcb8600 <ecu::engine_target::(anonymous namespace)::executor+0x1600>)
403776a5: 2c2982 l32i	a8, a9, 176
403776a8: 2d2992 l32i	a9, a9, 180
403776ab: 09bd mov.n	a11, a9
403776ad: c81b addi.n	a12, a8, 1
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
40377828: 1a0c movi.n	a10, 1
4037782a: 401900 ssl	a9
4037782d: a19a00 sll	a9, a10
40377830: f303a1 l32r	a10, 4037443c <_iram_text_start+0x38> (60004000 <GPIO>)
40377833: 0020c0 memw
40377836: 6a99 s32i.n	a9, a10, 24
40377838: 884b addi.n	a8, a8, 4
4037783a: f30291 l32r	a9, 40374444 <_iram_text_start+0x40> (3fcb2eb0 <ecu::engine_target::(anonymous namespace)::lock>)
4037783d: cc9897 bne	a8, a9, 4037780d <ecu::engine_target::(anonymous namespace)::on_alarm(gptimer_t*, gptimer_alarm_event_data_t const*, void*)+0x11cd>
40377840: f2ff81 l32r	a8, 4037443c <_iram_text_start+0x38> (60004000 <GPIO>)
40377843: 490c movi.n	a9, 4
40377845: 0020c0 memw
40377848: 3899 s32i.n	a9, a8, 12
4037784a: 290c movi.n	a9, 2
4037784c: 0020c0 memw
4037784f: 3899 s32i.n	a9, a8, 12
40377851: f2fd81 l32r	a8, 40374448 <_iram_text_start+0x44> (3fcb2e8c <ecu::engine_target::(anonymous namespace)::output>)
40377854: 090c movi.n	a9, 0
40377856: 034892 s8i	a9, a8, 3
40377859: f2fc81 l32r	a8, 4037444c <_iram_text_start+0x48> (3fcb6f10 <ecu::engine_target::(anonymous namespace)::idle_executor>)
4037785c: a80882 l8ui	a8, a8, 168
4037785f: 68cc bnez.n	a8, 40377869 <ecu::engine_target::(anonymous namespace)::on_alarm(gptimer_t*, gptimer_alarm_event_data_t const*, void*)+0x1229>
40377861: f2fa81 l32r	a8, 4037444c <_iram_text_start+0x48> (3fcb6f10 <ecu::engine_target::(anonymous namespace)::idle_executor>)
40377864: a90882 l8ui	a8, a8, 169
40377867: e88c beqz.n	a8, 40377879 <ecu::engine_target::(anonymous namespace)::on_alarm(gptimer_t*, gptimer_alarm_event_data_t const*, void*)+0x1239>
40377869: 080c movi.n	a8, 0
4037786b: 8189 s32i.n	a8, a1, 32
4037786d: 9189 s32i.n	a8, a1, 36
4037786f: f2f081 l32r	a8, 40374430 <_iram_text_start+0x2c> (3fcbca08 <ecu::engine_target::(anonymous namespace)::timer>)
40377872: 08a8 l32i.n	a10, a8, 0
40377874: cacc bnez.n	a10, 40377884 <ecu::engine_target::(anonymous namespace)::on_alarm(gptimer_t*, gptimer_alarm_event_data_t const*, void*)+0x1244>
40377876: 000406 j	4037788a <ecu::engine_target::(anonymous namespace)::on_alarm(gptimer_t*, gptimer_alarm_event_data_t const*, void*)+0x124a>
40377879: f2f581 l32r	a8, 40374450 <_iram_text_start+0x4c> (3fcb6f08 <ecu::engine_target::(anonymous namespace)::idle_output>)
4037787c: 090c movi.n	a9, 0
4037787e: 004892 s8i	a9, a8, 0
40377881: 003b06 j	40377971 <ecu::engine_target::(anonymous namespace)::on_alarm(gptimer_t*, gptimer_alarm_event_data_t const*, void*)+0x1331>
40377884: 20c1b2 addi	a11, a1, 32
40377887: 077a25 call8	4037f028 <gptimer_get_raw_count>
4037788a: 81a8 l32i.n	a10, a1, 32
4037788c: 91b8 l32i.n	a11, a1, 36
4037788e: f2ef81 l32r	a8, 4037444c <_iram_text_start+0x48> (3fcb6f10 <ecu::engine_target::(anonymous namespace)::idle_executor>)
40377891: a808c2 l8ui	a12, a8, 168
40377894: 1ccc bnez.n	a12, 40377899 <ecu::engine_target::(anonymous namespace)::on_alarm(gptimer_t*, gptimer_alarm_event_data_t const*, void*)+0x1259>
40377896: a908c2 l8ui	a12, a8, 169
40377899: f2ed81 l32r	a8, 40374450 <_iram_text_start+0x4c> (3fcb6f08 <ecu::engine_target::(anonymous namespace)::idle_output>)
4037789c: 090c movi.n	a9, 0
4037789e: 004892 s8i	a9, a8, 0
403778a1: f2ea81 l32r	a8, 4037444c <_iram_text_start+0x48> (3fcb6f10 <ecu::engine_target::(anonymous namespace)::idle_executor>)
403778a4: a90882 l8ui	a8, a8, 169
403778a7: 789c beqz.n	a8, 403778c2 <ecu::engine_target::(anonymous namespace)::on_alarm(gptimer_t*, gptimer_alarm_event_data_t const*, void*)+0x1282>
403778a9: f2e881 l32r	a8, 4037444c <_iram_text_start+0x48> (3fcb6f10 <ecu::engine_target::(anonymous namespace)::idle_executor>)
403778ac: 142892 l32i	a9, a8, 80
403778af: 1528e2 l32i	a14, a8, 84
403778b2: 0edd mov.n	a13, a14
403778b4: f91b addi.n	a15, a9, 1
403778b6: 020966 bnei	a9, -1, 403778bc <ecu::engine_target::(anonymous namespace)::on_alarm(gptimer_t*, gptimer_alarm_event_data_t const*, void*)+0x127c>
403778b9: 01ced2 addi	a13, a14, 1
403778bc: 1468f2 s32i	a15, a8, 80
403778bf: 1568d2 s32i	a13, a8, 84
403778c2: f2e281 l32r	a8, 4037444c <_iram_text_start+0x48> (3fcb6f10 <ecu::engine_target::(anonymous namespace)::idle_executor>)
403778c5: 090c movi.n	a9, 0
403778c7: a94892 s8i	a9, a8, 169
403778ca: a84892 s8i	a9, a8, 168
403778cd: 0d0c movi.n	a13, 0
403778cf: 2968d2 s32i	a13, a8, 164
403778d2: 2268a2 s32i	a10, a8, 136
403778d5: 2368b2 s32i	a11, a8, 140
403778d8: fb7c movi.n	a11, -1
403778da: 3068b2 s32i	a11, a8, 192
403778dd: 3168b2 s32i	a11, a8, 196
403778e0: 2e68b2 s32i	a11, a8, 184
403778e3: 2f68b2 s32i	a11, a8, 188
403778e6: 2c68b2 s32i	a11, a8, 176
403778e9: 2d68b2 s32i	a11, a8, 180
403778ec: e94892 s8i	a9, a8, 233
403778ef: 3c9c beqz.n	a12, 40377906 <ecu::engine_target::(anonymous namespace)::on_alarm(gptimer_t*, gptimer_alarm_event_data_t const*, void*)+0x12c6>
403778f1: 182892 l32i	a9, a8, 96
403778f4: 1928b2 l32i	a11, a8, 100
403778f7: 0bad mov.n	a10, a11
403778f9: c91b addi.n	a12, a9, 1
403778fb: 010966 bnei	a9, -1, 40377900 <ecu::engine_target::(anonymous namespace)::on_alarm(gptimer_t*, gptimer_alarm_event_data_t const*, void*)+0x12c0>
403778fe: ab1b addi.n	a10, a11, 1
40377900: 1868c2 s32i	a12, a8, 96
40377903: 1968a2 s32i	a10, a8, 100
40377906: f2d181 l32r	a8, 4037444c <_iram_text_start+0x48> (3fcb6f10 <ecu::engine_target::(anonymous namespace)::idle_executor>)
40377909: 390c movi.n	a9, 3
4037790b: ab4892 s8i	a9, a8, 171
4037790e: 0017c6 j	40377971 <ecu::engine_target::(anonymous namespace)::on_alarm(gptimer_t*, gptimer_alarm_event_data_t const*, void*)+0x1331>
40377911: f2c191 l32r	a9, 40374418 <_iram_text_start+0x14> (3fcb7600 <ecu::engine_target::(anonymous namespace)::executor+0x600>)
40377914: 280992 l8ui	a9, a9, 40
40377917: 515987 bbc	a9, a8, 4037796c <ecu::engine_target::(anonymous namespace)::on_alarm(gptimer_t*, gptimer_alarm_event_data_t const*, void*)+0x132c>
4037791a: c6a092 movi	a9, 198
4037791d: 989a add.n	a9, a8, a9
4037791f: f2bfa1 l32r	a10, 4037441c <_iram_text_start+0x18> (3fcb7000 <ecu::engine_target::(anonymous namespace)::executor>)
40377922: b099a0 addx8	a9, a9, a10
40377925: 0029a2 l32i	a10, a9, 0
40377928: 012992 l32i	a9, a9, 4
4037792b: 133797 bltu	a7, a9, 40377942 <ecu::engine_target::(anonymous namespace)::on_alarm(gptimer_t*, gptimer_alarm_event_data_t const*, void*)+0x1302>
4037792e: 029977 bne	a9, a7, 40377934 <ecu::engine_target::(anonymous namespace)::on_alarm(gptimer_t*, gptimer_alarm_event_data_t const*, void*)+0x12f4>
40377931: 0d36a7 bltu	a6, a10, 40377942 <ecu::engine_target::(anonymous namespace)::on_alarm(gptimer_t*, gptimer_alarm_event_data_t const*, void*)+0x1302>
40377934: c09790 sub	a9, a7, a9
40377937: 01b6a7 bgeu	a6, a10, 4037793c <ecu::engine_target::(anonymous namespace)::on_alarm(gptimer_t*, gptimer_alarm_event_data_t const*, void*)+0x12fc>
4037793a: 990b addi.n	a9, a9, -1
4037793c: c0a6a0 sub	a10, a6, a10
4037793f: 0000c6 j	40377946 <ecu::engine_target::(anonymous namespace)::on_alarm(gptimer_t*, gptimer_alarm_event_data_t const*, void*)+0x1306>
40377942: 0a0c movi.n	a10, 0
40377944: 0a9d mov.n	a9, a10
40377946: 0e48f6 bgeui	a8, 4, 40377958 <ecu::engine_target::(anonymous namespace)::on_alarm(gptimer_t*, gptimer_alarm_event_data_t const*, void*)+0x1318>
40377949: f2cab1 l32r	a11, 40374474 <_iram_text_start+0x70> (3fcb7500 <ecu::engine_target::(anonymous namespace)::executor+0x500>)
4037794c: 3e2bd2 l32i	a13, a11, 248
4037794f: 3f2bc2 l32i	a12, a11, 252
40377952: f2b0b1 l32r	a11, 40374414 <_iram_text_start+0x10> (3fcb75f8 <ecu::engine_target::(anonymous namespace)::executor+0x5f8>)
40377955: 000186 j	4037795f <ecu::engine_target::(anonymous namespace)::on_alarm(gptimer_t*, gptimer_alarm_event_data_t const*, void*)+0x131f>
40377958: f2b0b1 l32r	a11, 40374418 <_iram_text_start+0x14> (3fcb7600 <ecu::engine_target::(anonymous namespace)::executor+0x600>)
4037795b: 0bd8 l32i.n	a13, a11, 0
4037795d: 1bc8 l32i.n	a12, a11, 4
4037795f: 053c97 bltu	a12, a9, 40377968 <ecu::engine_target::(anonymous namespace)::on_alarm(gptimer_t*, gptimer_alarm_event_data_t const*, void*)+0x1328>
40377962: 0699c7 bne	a9, a12, 4037796c <ecu::engine_target::(anonymous namespace)::on_alarm(gptimer_t*, gptimer_alarm_event_data_t const*, void*)+0x132c>
40377965: 03bda7 bgeu	a13, a10, 4037796c <ecu::engine_target::(anonymous namespace)::on_alarm(gptimer_t*, gptimer_alarm_event_data_t const*, void*)+0x132c>
40377968: 0ba9 s32i.n	a10, a11, 0
4037796a: 1b99 s32i.n	a9, a11, 4
4037796c: 881b addi.n	a8, a8, 1
4037796e: 000046 j	40377973 <ecu::engine_target::(anonymous namespace)::on_alarm(gptimer_t*, gptimer_alarm_event_data_t const*, void*)+0x1333>
40377971: 080c movi.n	a8, 0
40377973: 9a88b6 bltui	a8, 8, 40377911 <ecu::engine_target::(anonymous namespace)::on_alarm(gptimer_t*, gptimer_alarm_event_data_t const*, void*)+0x12d1>
40377976: f2a881 l32r	a8, 40374418 <_iram_text_start+0x14> (3fcb7600 <ecu::engine_target::(anonymous namespace)::executor+0x600>)
40377979: 280882 l8ui	a8, a8, 40
4037797c: 055856 bnez	a8, 403779d5 <ecu::engine_target::(anonymous namespace)::on_alarm(gptimer_t*, gptimer_alarm_event_data_t const*, void*)+0x1395>
4037797f: f87c movi.n	a8, -1
40377981: 8189 s32i.n	a8, a1, 32
40377983: 9189 s32i.n	a8, a1, 36
40377985: f2a581 l32r	a8, 4037441c <_iram_text_start+0x18> (3fcb7000 <ecu::engine_target::(anonymous namespace)::executor>)
40377988: 000e06 j	403779c4 <ecu::engine_target::(anonymous namespace)::on_alarm(gptimer_t*, gptimer_alarm_event_data_t const*, void*)+0x1384>
4037798b: 010892 l8ui	a9, a8, 1
4037798e: f9ac beqz.n	a9, 403779c1 <ecu::engine_target::(anonymous namespace)::on_alarm(gptimer_t*, gptimer_alarm_event_data_t const*, void*)+0x1381>
40377990: 000892 l8ui	a9, a8, 0
40377993: b98c beqz.n	a9, 403779a2 <ecu::engine_target::(anonymous namespace)::on_alarm(gptimer_t*, gptimer_alarm_event_data_t const*, void*)+0x1362>
40377995: 10c892 addi	a9, a8, 16
40377998: 48d8 l32i.n	a13, a8, 16
4037799a: 58a8 l32i.n	a10, a8, 20
4037799c: 000206 j	403779a8 <ecu::engine_target::(anonymous namespace)::on_alarm(gptimer_t*, gptimer_alarm_event_data_t const*, void*)+0x1368>
403779a2: 988b addi.n	a9, a8, 8
403779a4: 28d8 l32i.n	a13, a8, 8
403779a6: 38a8 l32i.n	a10, a8, 12
403779a8: 81c8 l32i.n	a12, a1, 32
403779aa: 91b8 l32i.n	a11, a1, 36
403779ac: 083ab7 bltu	a10, a11, 403779b8 <ecu::engine_target::(anonymous namespace)::on_alarm(gptimer_t*, gptimer_alarm_event_data_t const*, void*)+0x1378>
403779af: 029ba7 bne	a11, a10, 403779b5 <ecu::engine_target::(anonymous namespace)::on_alarm(gptimer_t*, gptimer_alarm_event_data_t const*, void*)+0x1375>
403779b2: 023dc7 bltu	a13, a12, 403779b8 <ecu::engine_target::(anonymous namespace)::on_alarm(gptimer_t*, gptimer_alarm_event_data_t const*, void*)+0x1378>
403779b5: 20c192 addi	a9, a1, 32
403779b8: 09a8 l32i.n	a10, a9, 0
403779ba: 19b8 l32i.n	a11, a9, 4
403779bc: 81a9 s32i.n	a10, a1, 32
403779be: 0961b2 s32i	a11, a1, 36
403779c1: 38c882 addi	a8, a8, 56
403779c4: f2a491 l32r	a9, 40374454 <_iram_text_start+0x50> (3fcb71c0 <ecu::engine_target::(anonymous namespace)::executor+0x1c0>)
403779c7: c09897 bne	a8, a9, 4037798b <ecu::engine_target::(anonymous namespace)::on_alarm(gptimer_t*, gptimer_alarm_event_data_t const*, void*)+0x134b>
403779ca: 8188 l32i.n	a8, a1, 32
403779cc: 092192 l32i	a9, a1, 36
403779cf: 020866 bnei	a8, -1, 403779d5 <ecu::engine_target::(anonymous namespace)::on_alarm(gptimer_t*, gptimer_alarm_event_data_t const*, void*)+0x1395>
403779d2: 7a0926 beqi	a9, -1, 40377a50 <ecu::engine_target::(anonymous namespace)::on_alarm(gptimer_t*, gptimer_alarm_event_data_t const*, void*)+0x1410>
403779d5: f2a781 l32r	a8, 40374474 <_iram_text_start+0x70> (3fcb7500 <ecu::engine_target::(anonymous namespace)::executor+0x500>)
403779d8: 302892 l32i	a9, a8, 192
403779db: 3128b2 l32i	a11, a8, 196
403779de: 0bad mov.n	a10, a11
403779e0: c91b addi.n	a12, a9, 1
403779e2: 020966 bnei	a9, -1, 403779e8 <ecu::engine_target::(anonymous namespace)::on_alarm(gptimer_t*, gptimer_alarm_event_data_t const*, void*)+0x13a8>
403779e5: 01cba2 addi	a10, a11, 1
403779e8: 3068c2 s32i	a12, a8, 192
403779eb: 3168a2 s32i	a10, a8, 196
403779ee: f2a091 l32r	a9, 40374470 <_iram_text_start+0x6c> (3fcb8600 <ecu::engine_target::(anonymous namespace)::executor+0x1600>)
403779f1: 2c2982 l32i	a8, a9, 176
403779f4: 2d2992 l32i	a9, a9, 180
403779f7: 09bd mov.n	a11, a9
403779f9: c81b addi.n	a12, a8, 1
403779fb: 020866 bnei	a8, -1, 40377a01 <ecu::engine_target::(anonymous namespace)::on_alarm(gptimer_t*, gptimer_alarm_event_data_t const*, void*)+0x13c1>
403779fe: 01c9b2 addi	a11, a9, 1
40377a01: f286a1 l32r	a10, 4037441c <_iram_text_start+0x18> (3fcb7000 <ecu::engine_target::(anonymous namespace)::executor>)
40377a04: 16da92 addmi	a9, a10, 0x1600
40377a07: 2c69c2 s32i	a12, a9, 176
40377a0a: 2d69b2 s32i	a11, a9, 180
40377a0d: 649080 extui	a9, a8, 0, 7
40377a10: 06da82 addmi	a8, a10, 0x600
40377a13: 1199b0 slli	a9, a9, 5
40377a16: 889a add.n	a8, a8, a9
40377a18: b0a092 movi	a9, 176
40377a1b: 989a add.n	a9, a8, a9
40377a1d: 09c9 s32i.n	a12, a9, 0
40377a1f: 19b9 s32i.n	a11, a9, 4
40377a21: b8a092 movi	a9, 184
40377a24: 989a add.n	a9, a8, a9
40377a26: 0969 s32i.n	a6, a9, 0
40377a28: 1979 s32i.n	a7, a9, 4
40377a2a: c0a092 movi	a9, 192
40377a2d: 989a add.n	a9, a8, a9
40377a2f: 0969 s32i.n	a6, a9, 0
40377a31: 1979 s32i.n	a7, a9, 4
40377a33: 05daa2 addmi	a10, a10, 0x500
40377a36: 222a92 l32i	a9, a10, 136
40377a39: 326892 s32i	a9, a8, 200
40377a3c: f97c movi.n	a9, -1
40377a3e: cc4892 s8i	a9, a8, 204
40377a41: cda092 movi	a9, 205
40377a44: 989a add.n	a9, a8, a9
40377a46: 0a0c movi.n	a10, 0
40377a48: 0049a2 s8i	a10, a9, 0
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
40377bae: 090c movi.n	a9, 0
40377bb0: 034892 s8i	a9, a8, 3
40377bb3: f22681 l32r	a8, 4037444c <_iram_text_start+0x48> (3fcb6f10 <ecu::engine_target::(anonymous namespace)::idle_executor>)
40377bb6: a80882 l8ui	a8, a8, 168
40377bb9: 78cc bnez.n	a8, 40377bc4 <ecu::engine_target::(anonymous namespace)::on_alarm(gptimer_t*, gptimer_alarm_event_data_t const*, void*)+0x1584>
40377bbb: f22481 l32r	a8, 4037444c <_iram_text_start+0x48> (3fcb6f10 <ecu::engine_target::(anonymous namespace)::idle_executor>)
40377bbe: a90882 l8ui	a8, a8, 169
40377bc1: 00f816 beqz	a8, 40377bd4 <ecu::engine_target::(anonymous namespace)::on_alarm(gptimer_t*, gptimer_alarm_event_data_t const*, void*)+0x1594>
40377bc4: 080c movi.n	a8, 0
40377bc6: 8189 s32i.n	a8, a1, 32
40377bc8: 9189 s32i.n	a8, a1, 36
40377bca: f21981 l32r	a8, 40374430 <_iram_text_start+0x2c> (3fcbca08 <ecu::engine_target::(anonymous namespace)::timer>)
40377bcd: 08a8 l32i.n	a10, a8, 0
40377bcf: dacc bnez.n	a10, 40377be0 <ecu::engine_target::(anonymous namespace)::on_alarm(gptimer_t*, gptimer_alarm_event_data_t const*, void*)+0x15a0>
40377bd1: 000446 j	40377be6 <ecu::engine_target::(anonymous namespace)::on_alarm(gptimer_t*, gptimer_alarm_event_data_t const*, void*)+0x15a6>
40377bd4: f21f81 l32r	a8, 40374450 <_iram_text_start+0x4c> (3fcb6f08 <ecu::engine_target::(anonymous namespace)::idle_output>)
40377bd7: 090c movi.n	a9, 0
40377bd9: 004892 s8i	a9, a8, 0
40377bdc: 003b46 j	40377ccd <ecu::engine_target::(anonymous namespace)::on_alarm(gptimer_t*, gptimer_alarm_event_data_t const*, void*)+0x168d>
40377be0: 20c1b2 addi	a11, a1, 32
40377be3: 074465 call8	4037f028 <gptimer_get_raw_count>
40377be6: 81a8 l32i.n	a10, a1, 32
40377be8: 91b8 l32i.n	a11, a1, 36
40377bea: f21881 l32r	a8, 4037444c <_iram_text_start+0x48> (3fcb6f10 <ecu::engine_target::(anonymous namespace)::idle_executor>)
40377bed: a808c2 l8ui	a12, a8, 168
40377bf0: 1ccc bnez.n	a12, 40377bf5 <ecu::engine_target::(anonymous namespace)::on_alarm(gptimer_t*, gptimer_alarm_event_data_t const*, void*)+0x15b5>
40377bf2: a908c2 l8ui	a12, a8, 169
40377bf5: f21681 l32r	a8, 40374450 <_iram_text_start+0x4c> (3fcb6f08 <ecu::engine_target::(anonymous namespace)::idle_output>)
40377bf8: 090c movi.n	a9, 0
40377bfa: 004892 s8i	a9, a8, 0
40377bfd: f21381 l32r	a8, 4037444c <_iram_text_start+0x48> (3fcb6f10 <ecu::engine_target::(anonymous namespace)::idle_executor>)
40377c00: a90882 l8ui	a8, a8, 169
40377c03: 789c beqz.n	a8, 40377c1e <ecu::engine_target::(anonymous namespace)::on_alarm(gptimer_t*, gptimer_alarm_event_data_t const*, void*)+0x15de>
40377c05: f21181 l32r	a8, 4037444c <_iram_text_start+0x48> (3fcb6f10 <ecu::engine_target::(anonymous namespace)::idle_executor>)
40377c08: 1428e2 l32i	a14, a8, 80
40377c0b: 1528d2 l32i	a13, a8, 84
40377c0e: 0d9d mov.n	a9, a13
40377c10: fe1b addi.n	a15, a14, 1
40377c12: 020e66 bnei	a14, -1, 40377c18 <ecu::engine_target::(anonymous namespace)::on_alarm(gptimer_t*, gptimer_alarm_event_data_t const*, void*)+0x15d8>
40377c15: 01cd92 addi	a9, a13, 1
40377c18: 1468f2 s32i	a15, a8, 80
40377c1b: 156892 s32i	a9, a8, 84
40377c1e: f20b81 l32r	a8, 4037444c <_iram_text_start+0x48> (3fcb6f10 <ecu::engine_target::(anonymous namespace)::idle_executor>)
40377c21: 090c movi.n	a9, 0
40377c23: a94892 s8i	a9, a8, 169
40377c26: a84892 s8i	a9, a8, 168
40377c29: 0d0c movi.n	a13, 0
40377c2b: 2968d2 s32i	a13, a8, 164
40377c2e: 2268a2 s32i	a10, a8, 136
40377c31: 2368b2 s32i	a11, a8, 140
40377c34: fb7c movi.n	a11, -1
40377c36: 3068b2 s32i	a11, a8, 192
40377c39: 3168b2 s32i	a11, a8, 196
40377c3c: 2e68b2 s32i	a11, a8, 184
40377c3f: 2f68b2 s32i	a11, a8, 188
40377c42: 2c68b2 s32i	a11, a8, 176
40377c45: 2d68b2 s32i	a11, a8, 180
40377c48: e94892 s8i	a9, a8, 233
40377c4b: 3c9c beqz.n	a12, 40377c62 <ecu::engine_target::(anonymous namespace)::on_alarm(gptimer_t*, gptimer_alarm_event_data_t const*, void*)+0x1622>
40377c4d: 1828b2 l32i	a11, a8, 96
40377c50: 1928a2 l32i	a10, a8, 100
40377c53: 0a9d mov.n	a9, a10
40377c55: cb1b addi.n	a12, a11, 1
40377c57: 010b66 bnei	a11, -1, 40377c5c <ecu::engine_target::(anonymous namespace)::on_alarm(gptimer_t*, gptimer_alarm_event_data_t const*, void*)+0x161c>
40377c5a: 9a1b addi.n	a9, a10, 1
40377c5c: 1868c2 s32i	a12, a8, 96
40377c5f: 196892 s32i	a9, a8, 100
40377c62: f1fa81 l32r	a8, 4037444c <_iram_text_start+0x48> (3fcb6f10 <ecu::engine_target::(anonymous namespace)::idle_executor>)
40377c65: 390c movi.n	a9, 3
40377c67: ab4892 s8i	a9, a8, 171
40377c6a: 0017c6 j	40377ccd <ecu::engine_target::(anonymous namespace)::on_alarm(gptimer_t*, gptimer_alarm_event_data_t const*, void*)+0x168d>
40377c6d: f1ea91 l32r	a9, 40374418 <_iram_text_start+0x14> (3fcb7600 <ecu::engine_target::(anonymous namespace)::executor+0x600>)
40377c70: 280992 l8ui	a9, a9, 40
40377c73: 515987 bbc	a9, a8, 40377cc8 <ecu::engine_target::(anonymous namespace)::on_alarm(gptimer_t*, gptimer_alarm_event_data_t const*, void*)+0x1688>
40377c76: c6a092 movi	a9, 198
40377c79: 989a add.n	a9, a8, a9
40377c7b: f1e8a1 l32r	a10, 4037441c <_iram_text_start+0x18> (3fcb7000 <ecu::engine_target::(anonymous namespace)::executor>)
40377c7e: b099a0 addx8	a9, a9, a10
40377c81: 0029a2 l32i	a10, a9, 0
40377c84: 012992 l32i	a9, a9, 4
40377c87: 133797 bltu	a7, a9, 40377c9e <ecu::engine_target::(anonymous namespace)::on_alarm(gptimer_t*, gptimer_alarm_event_data_t const*, void*)+0x165e>
40377c8a: 029977 bne	a9, a7, 40377c90 <ecu::engine_target::(anonymous namespace)::on_alarm(gptimer_t*, gptimer_alarm_event_data_t const*, void*)+0x1650>
40377c8d: 0d36a7 bltu	a6, a10, 40377c9e <ecu::engine_target::(anonymous namespace)::on_alarm(gptimer_t*, gptimer_alarm_event_data_t const*, void*)+0x165e>
40377c90: c09790 sub	a9, a7, a9
40377c93: 01b6a7 bgeu	a6, a10, 40377c98 <ecu::engine_target::(anonymous namespace)::on_alarm(gptimer_t*, gptimer_alarm_event_data_t const*, void*)+0x1658>
40377c96: 990b addi.n	a9, a9, -1
40377c98: c0a6a0 sub	a10, a6, a10
40377c9b: 0000c6 j	40377ca2 <ecu::engine_target::(anonymous namespace)::on_alarm(gptimer_t*, gptimer_alarm_event_data_t const*, void*)+0x1662>
40377c9e: 0a0c movi.n	a10, 0
40377ca0: 0a9d mov.n	a9, a10
40377ca2: 0e48f6 bgeui	a8, 4, 40377cb4 <ecu::engine_target::(anonymous namespace)::on_alarm(gptimer_t*, gptimer_alarm_event_data_t const*, void*)+0x1674>
40377ca5: f1f3b1 l32r	a11, 40374474 <_iram_text_start+0x70> (3fcb7500 <ecu::engine_target::(anonymous namespace)::executor+0x500>)
40377ca8: 3e2bd2 l32i	a13, a11, 248
40377cab: 3f2bc2 l32i	a12, a11, 252
40377cae: f1d9b1 l32r	a11, 40374414 <_iram_text_start+0x10> (3fcb75f8 <ecu::engine_target::(anonymous namespace)::executor+0x5f8>)
40377cb1: 000186 j	40377cbb <ecu::engine_target::(anonymous namespace)::on_alarm(gptimer_t*, gptimer_alarm_event_data_t const*, void*)+0x167b>
40377cb4: f1d9b1 l32r	a11, 40374418 <_iram_text_start+0x14> (3fcb7600 <ecu::engine_target::(anonymous namespace)::executor+0x600>)
40377cb7: 0bd8 l32i.n	a13, a11, 0
40377cb9: 1bc8 l32i.n	a12, a11, 4
40377cbb: 053c97 bltu	a12, a9, 40377cc4 <ecu::engine_target::(anonymous namespace)::on_alarm(gptimer_t*, gptimer_alarm_event_data_t const*, void*)+0x1684>
40377cbe: 0699c7 bne	a9, a12, 40377cc8 <ecu::engine_target::(anonymous namespace)::on_alarm(gptimer_t*, gptimer_alarm_event_data_t const*, void*)+0x1688>
40377cc1: 03bda7 bgeu	a13, a10, 40377cc8 <ecu::engine_target::(anonymous namespace)::on_alarm(gptimer_t*, gptimer_alarm_event_data_t const*, void*)+0x1688>
40377cc4: 0ba9 s32i.n	a10, a11, 0
40377cc6: 1b99 s32i.n	a9, a11, 4
40377cc8: 881b addi.n	a8, a8, 1
40377cca: 000046 j	40377ccf <ecu::engine_target::(anonymous namespace)::on_alarm(gptimer_t*, gptimer_alarm_event_data_t const*, void*)+0x168f>
40377ccd: 080c movi.n	a8, 0
40377ccf: 9a88b6 bltui	a8, 8, 40377c6d <ecu::engine_target::(anonymous namespace)::on_alarm(gptimer_t*, gptimer_alarm_event_data_t const*, void*)+0x162d>
40377cd2: f1d181 l32r	a8, 40374418 <_iram_text_start+0x14> (3fcb7600 <ecu::engine_target::(anonymous namespace)::executor+0x600>)
40377cd5: 280882 l8ui	a8, a8, 40
40377cd8: 055856 bnez	a8, 40377d31 <ecu::engine_target::(anonymous namespace)::on_alarm(gptimer_t*, gptimer_alarm_event_data_t const*, void*)+0x16f1>
40377cdb: f87c movi.n	a8, -1
40377cdd: 8189 s32i.n	a8, a1, 32
40377cdf: 9189 s32i.n	a8, a1, 36
40377ce1: f1ce81 l32r	a8, 4037441c <_iram_text_start+0x18> (3fcb7000 <ecu::engine_target::(anonymous namespace)::executor>)
40377ce4: 000e06 j	40377d20 <ecu::engine_target::(anonymous namespace)::on_alarm(gptimer_t*, gptimer_alarm_event_data_t const*, void*)+0x16e0>
40377ce8: 010892 l8ui	a9, a8, 1
40377ceb: e9ac beqz.n	a9, 40377d1d <ecu::engine_target::(anonymous namespace)::on_alarm(gptimer_t*, gptimer_alarm_event_data_t const*, void*)+0x16dd>
40377ced: 000892 l8ui	a9, a8, 0
40377cf0: a98c beqz.n	a9, 40377cfe <ecu::engine_target::(anonymous namespace)::on_alarm(gptimer_t*, gptimer_alarm_event_data_t const*, void*)+0x16be>
40377cf2: 10c892 addi	a9, a8, 16
40377cf5: 48d8 l32i.n	a13, a8, 16
40377cf7: 58a8 l32i.n	a10, a8, 20
40377cf9: 0001c6 j	40377d04 <ecu::engine_target::(anonymous namespace)::on_alarm(gptimer_t*, gptimer_alarm_event_data_t const*, void*)+0x16c4>
40377cfe: 988b addi.n	a9, a8, 8
40377d00: 28d8 l32i.n	a13, a8, 8
40377d02: 38a8 l32i.n	a10, a8, 12
40377d04: 81c8 l32i.n	a12, a1, 32
40377d06: 91b8 l32i.n	a11, a1, 36
40377d08: 083ab7 bltu	a10, a11, 40377d14 <ecu::engine_target::(anonymous namespace)::on_alarm(gptimer_t*, gptimer_alarm_event_data_t const*, void*)+0x16d4>
40377d0b: 029ba7 bne	a11, a10, 40377d11 <ecu::engine_target::(anonymous namespace)::on_alarm(gptimer_t*, gptimer_alarm_event_data_t const*, void*)+0x16d1>
40377d0e: 023dc7 bltu	a13, a12, 40377d14 <ecu::engine_target::(anonymous namespace)::on_alarm(gptimer_t*, gptimer_alarm_event_data_t const*, void*)+0x16d4>
40377d11: 20c192 addi	a9, a1, 32
40377d14: 09a8 l32i.n	a10, a9, 0
40377d16: 19b8 l32i.n	a11, a9, 4
40377d18: 81a9 s32i.n	a10, a1, 32
40377d1a: 0961b2 s32i	a11, a1, 36
40377d1d: 38c882 addi	a8, a8, 56
40377d20: f1cd91 l32r	a9, 40374454 <_iram_text_start+0x50> (3fcb71c0 <ecu::engine_target::(anonymous namespace)::executor+0x1c0>)
40377d23: c19897 bne	a8, a9, 40377ce8 <ecu::engine_target::(anonymous namespace)::on_alarm(gptimer_t*, gptimer_alarm_event_data_t const*, void*)+0x16a8>
40377d26: 8188 l32i.n	a8, a1, 32
40377d28: 092192 l32i	a9, a1, 36
40377d2b: 020866 bnei	a8, -1, 40377d31 <ecu::engine_target::(anonymous namespace)::on_alarm(gptimer_t*, gptimer_alarm_event_data_t const*, void*)+0x16f1>
40377d2e: 7a0926 beqi	a9, -1, 40377dac <ecu::engine_target::(anonymous namespace)::on_alarm(gptimer_t*, gptimer_alarm_event_data_t const*, void*)+0x176c>
40377d31: f1d081 l32r	a8, 40374474 <_iram_text_start+0x70> (3fcb7500 <ecu::engine_target::(anonymous namespace)::executor+0x500>)
40377d34: 302892 l32i	a9, a8, 192
40377d37: 3128b2 l32i	a11, a8, 196
40377d3a: 0bad mov.n	a10, a11
40377d3c: c91b addi.n	a12, a9, 1
40377d3e: 020966 bnei	a9, -1, 40377d44 <ecu::engine_target::(anonymous namespace)::on_alarm(gptimer_t*, gptimer_alarm_event_data_t const*, void*)+0x1704>
40377d41: 01cba2 addi	a10, a11, 1
40377d44: 3068c2 s32i	a12, a8, 192
40377d47: 3168a2 s32i	a10, a8, 196
40377d4a: f1c991 l32r	a9, 40374470 <_iram_text_start+0x6c> (3fcb8600 <ecu::engine_target::(anonymous namespace)::executor+0x1600>)
40377d4d: 2c2982 l32i	a8, a9, 176
40377d50: 2d2992 l32i	a9, a9, 180
40377d53: 09bd mov.n	a11, a9
40377d55: c81b addi.n	a12, a8, 1
40377d57: 020866 bnei	a8, -1, 40377d5d <ecu::engine_target::(anonymous namespace)::on_alarm(gptimer_t*, gptimer_alarm_event_data_t const*, void*)+0x171d>
40377d5a: 01c9b2 addi	a11, a9, 1
40377d5d: f1afa1 l32r	a10, 4037441c <_iram_text_start+0x18> (3fcb7000 <ecu::engine_target::(anonymous namespace)::executor>)
40377d60: 16da92 addmi	a9, a10, 0x1600
40377d63: 2c69c2 s32i	a12, a9, 176
40377d66: 2d69b2 s32i	a11, a9, 180
40377d69: 649080 extui	a9, a8, 0, 7
40377d6c: 06da82 addmi	a8, a10, 0x600
40377d6f: 1199b0 slli	a9, a9, 5
40377d72: 889a add.n	a8, a8, a9
40377d74: b0a092 movi	a9, 176
40377d77: 989a add.n	a9, a8, a9
40377d79: 09c9 s32i.n	a12, a9, 0
40377d7b: 19b9 s32i.n	a11, a9, 4
40377d7d: b8a092 movi	a9, 184
40377d80: 989a add.n	a9, a8, a9
40377d82: 0969 s32i.n	a6, a9, 0
40377d84: 1979 s32i.n	a7, a9, 4
40377d86: c0a092 movi	a9, 192
40377d89: 989a add.n	a9, a8, a9
40377d8b: 0969 s32i.n	a6, a9, 0
40377d8d: 1979 s32i.n	a7, a9, 4
40377d8f: 05daa2 addmi	a10, a10, 0x500
40377d92: 222a92 l32i	a9, a10, 136
40377d95: 326892 s32i	a9, a8, 200
40377d98: f97c movi.n	a9, -1
40377d9a: cc4892 s8i	a9, a8, 204
40377d9d: cda092 movi	a9, 205
40377da0: 989a add.n	a9, a8, a9
40377da2: 0a0c movi.n	a10, 0
40377da4: 0049a2 s8i	a10, a9, 0
40377da7: 091c movi.n	a9, 16
40377da9: ce4892 s8i	a9, a8, 206
40377dac: f19c51 l32r	a5, 4037441c <_iram_text_start+0x18> (3fcb7000 <ecu::engine_target::(anonymous namespace)::executor>)
40377daf: 06d582 addmi	a8, a5, 0x600
40377db2: 090c movi.n	a9, 0
40377db4: 284892 s8i	a9, a8, 40
40377db7: 000406 j	40377dcb <ecu::engine_target::(anonymous namespace)::on_alarm(gptimer_t*, gptimer_alarm_event_data_t const*, void*)+0x178b>
40377dba: 8c3c movi.n	a12, 56
40377dbc: 00a0b2 movi	a11, 0
40377dbf: 20a550 or	a10, a5, a5
40377dc2: f1ae81 l32r	a8, 4037447c <_iram_text_start+0x78> (400011e8 <memset>)
40377dc5: 0008e0 callx8	a8
40377dc8: 38c552 addi	a5, a5, 56
40377dcb: f1a281 l32r	a8, 40374454 <_iram_text_start+0x50> (3fcb71c0 <ecu::engine_target::(anonymous namespace)::executor+0x1c0>)
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
40377ea5: cc4892 s8i	a9, a8, 204
40377ea8: cda092 movi	a9, 205
40377eab: 989a add.n	a9, a8, a9
40377ead: 0a0c movi.n	a10, 0
40377eaf: 0049a2 s8i	a10, a9, 0
40377eb2: b90c movi.n	a9, 11
40377eb4: ce4892 s8i	a9, a8, 206
40377eb7: f16181 l32r	a8, 4037443c <_iram_text_start+0x38> (60004000 <GPIO>)
40377eba: f16191 l32r	a9, 40374440 <_iram_text_start+0x3c> (8000 <UserFrameTotalSize+0x7f00>)
40377ebd: 0020c0 memw
40377ec0: 6899 s32i.n	a9, a8, 24
40377ec2: f15381 l32r	a8, 40374410 <_iram_text_start+0xc> (3fcb2e90 <ecu::engine_target::(anonymous namespace)::output_pins>)
40377ec5: 000ac6 j	40377ef4 <ecu::engine_target::(anonymous namespace)::on_alarm(gptimer_t*, gptimer_alarm_event_data_t const*, void*)+0x18b4>
40377ec8: 0898 l32i.n	a9, a8, 0
40377eca: fa1c movi.n	a10, 31
40377ecc: 123a97 bltu	a10, a9, 40377ee2 <ecu::engine_target::(anonymous namespace)::on_alarm(gptimer_t*, gptimer_alarm_event_data_t const*, void*)+0x18a2>
40377ecf: 1a0c movi.n	a10, 1
40377ed1: 401900 ssl	a9
40377ed4: a19a00 sll	a9, a10
40377ed7: f159a1 l32r	a10, 4037443c <_iram_text_start+0x38> (60004000 <GPIO>)
40377eda: 0020c0 memw
40377edd: 3a99 s32i.n	a9, a10, 12
40377edf: 0003c6 j	40377ef2 <ecu::engine_target::(anonymous namespace)::on_alarm(gptimer_t*, gptimer_alarm_event_data_t const*, void*)+0x18b2>
40377ee2: 1a0c movi.n	a10, 1
40377ee4: 401900 ssl	a9
40377ee7: a19a00 sll	a9, a10
40377eea: f154a1 l32r	a10, 4037443c <_iram_text_start+0x38> (60004000 <GPIO>)
40377eed: 0020c0 memw
40377ef0: 6a99 s32i.n	a9, a10, 24
40377ef2: 884b addi.n	a8, a8, 4
40377ef4: f15491 l32r	a9, 40374444 <_iram_text_start+0x40> (3fcb2eb0 <ecu::engine_target::(anonymous namespace)::lock>)
40377ef7: cd9897 bne	a8, a9, 40377ec8 <ecu::engine_target::(anonymous namespace)::on_alarm(gptimer_t*, gptimer_alarm_event_data_t const*, void*)+0x1888>
40377efa: f15081 l32r	a8, 4037443c <_iram_text_start+0x38> (60004000 <GPIO>)
40377efd: 490c movi.n	a9, 4
40377eff: 0020c0 memw
40377f02: 3899 s32i.n	a9, a8, 12
40377f04: 290c movi.n	a9, 2
40377f06: 0020c0 memw
40377f09: 3899 s32i.n	a9, a8, 12
40377f0b: f14f81 l32r	a8, 40374448 <_iram_text_start+0x44> (3fcb2e8c <ecu::engine_target::(anonymous namespace)::output>)
40377f0e: 090c movi.n	a9, 0
40377f10: 034892 s8i	a9, a8, 3
40377f13: f14e81 l32r	a8, 4037444c <_iram_text_start+0x48> (3fcb6f10 <ecu::engine_target::(anonymous namespace)::idle_executor>)
40377f16: a80882 l8ui	a8, a8, 168
40377f19: 78cc bnez.n	a8, 40377f24 <ecu::engine_target::(anonymous namespace)::on_alarm(gptimer_t*, gptimer_alarm_event_data_t const*, void*)+0x18e4>
40377f1b: f14c81 l32r	a8, 4037444c <_iram_text_start+0x48> (3fcb6f10 <ecu::engine_target::(anonymous namespace)::idle_executor>)
40377f1e: a90882 l8ui	a8, a8, 169
40377f21: 00f816 beqz	a8, 40377f34 <ecu::engine_target::(anonymous namespace)::on_alarm(gptimer_t*, gptimer_alarm_event_data_t const*, void*)+0x18f4>
40377f24: 080c movi.n	a8, 0
40377f26: 8189 s32i.n	a8, a1, 32
40377f28: 9189 s32i.n	a8, a1, 36
40377f2a: f14181 l32r	a8, 40374430 <_iram_text_start+0x2c> (3fcbca08 <ecu::engine_target::(anonymous namespace)::timer>)
40377f2d: 08a8 l32i.n	a10, a8, 0
40377f2f: dacc bnez.n	a10, 40377f40 <ecu::engine_target::(anonymous namespace)::on_alarm(gptimer_t*, gptimer_alarm_event_data_t const*, void*)+0x1900>
40377f31: 000446 j	40377f46 <ecu::engine_target::(anonymous namespace)::on_alarm(gptimer_t*, gptimer_alarm_event_data_t const*, void*)+0x1906>
40377f34: f14781 l32r	a8, 40374450 <_iram_text_start+0x4c> (3fcb6f08 <ecu::engine_target::(anonymous namespace)::idle_output>)
40377f37: 090c movi.n	a9, 0
40377f39: 004892 s8i	a9, a8, 0
40377f3c: 003b46 j	4037802d <_diram_i_start+0x2d>
40377f40: 20c1b2 addi	a11, a1, 32
40377f43: 070e65 call8	4037f028 <gptimer_get_raw_count>
40377f46: 81a8 l32i.n	a10, a1, 32
40377f48: 91b8 l32i.n	a11, a1, 36
40377f4a: f14081 l32r	a8, 4037444c <_iram_text_start+0x48> (3fcb6f10 <ecu::engine_target::(anonymous namespace)::idle_executor>)
40377f4d: a808c2 l8ui	a12, a8, 168
40377f50: 1ccc bnez.n	a12, 40377f55 <ecu::engine_target::(anonymous namespace)::on_alarm(gptimer_t*, gptimer_alarm_event_data_t const*, void*)+0x1915>
40377f52: a908c2 l8ui	a12, a8, 169
40377f55: f13e81 l32r	a8, 40374450 <_iram_text_start+0x4c> (3fcb6f08 <ecu::engine_target::(anonymous namespace)::idle_output>)
40377f58: 090c movi.n	a9, 0
40377f5a: 004892 s8i	a9, a8, 0
40377f5d: f13b81 l32r	a8, 4037444c <_iram_text_start+0x48> (3fcb6f10 <ecu::engine_target::(anonymous namespace)::idle_executor>)
40377f60: a90882 l8ui	a8, a8, 169
40377f63: 789c beqz.n	a8, 40377f7e <ecu::engine_target::(anonymous namespace)::on_alarm(gptimer_t*, gptimer_alarm_event_data_t const*, void*)+0x193e>
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
40379a7c: 083d97 bltu	a13, a9, 40379a88 <_diram_i_start+0x1a88>
40379a7f: 0299d7 bne	a9, a13, 40379a85 <_diram_i_start+0x1a85>
40379a82: 023fe7 bltu	a15, a14, 40379a88 <_diram_i_start+0x1a88>
40379a85: 20c1c2 addi	a12, a1, 32
40379a88: 1cd8 l32i.n	a13, a12, 4
40379a8a: 0cc8 l32i.n	a12, a12, 0
40379a8c: 81c9 s32i.n	a12, a1, 32
40379a8e: 0961d2 s32i	a13, a1, 36
40379a91: 38c882 addi	a8, a8, 56
40379a94: ea7091 l32r	a9, 40374454 <_iram_text_start+0x50> (3fcb71c0 <ecu::engine_target::(anonymous namespace)::executor+0x1c0>)
40379a97: c19897 bne	a8, a9, 40379a5c <_diram_i_start+0x1a5c>
40379a9a: 8198 l32i.n	a9, a1, 32
40379a9c: 9188 l32i.n	a8, a1, 36
40379a9e: 020966 bnei	a9, -1, 40379aa4 <_diram_i_start+0x1aa4>
40379aa1: 0c0826 beqi	a8, -1, 40379ab1 <_diram_i_start+0x1ab1>
40379aa4: 053a87 bltu	a10, a8, 40379aad <_diram_i_start+0x1aad>
40379aa7: 0698a7 bne	a8, a10, 40379ab1 <_diram_i_start+0x1ab1>
40379aaa: 03bb97 bgeu	a11, a9, 40379ab1 <_diram_i_start+0x1ab1>
40379aad: 0b9d mov.n	a9, a11
40379aaf: 0a8d mov.n	a8, a10
40379ab1: 103787 bltu	a7, a8, 40379ac5 <_diram_i_start+0x1ac5>
40379ab4: 029877 bne	a8, a7, 40379aba <_diram_i_start+0x1aba>
40379ab7: 0a3697 bltu	a6, a9, 40379ac5 <_diram_i_start+0x1ac5>
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
