markthebault/esp32-ecu/hardware/a7-boost-interface/assembly-back.png

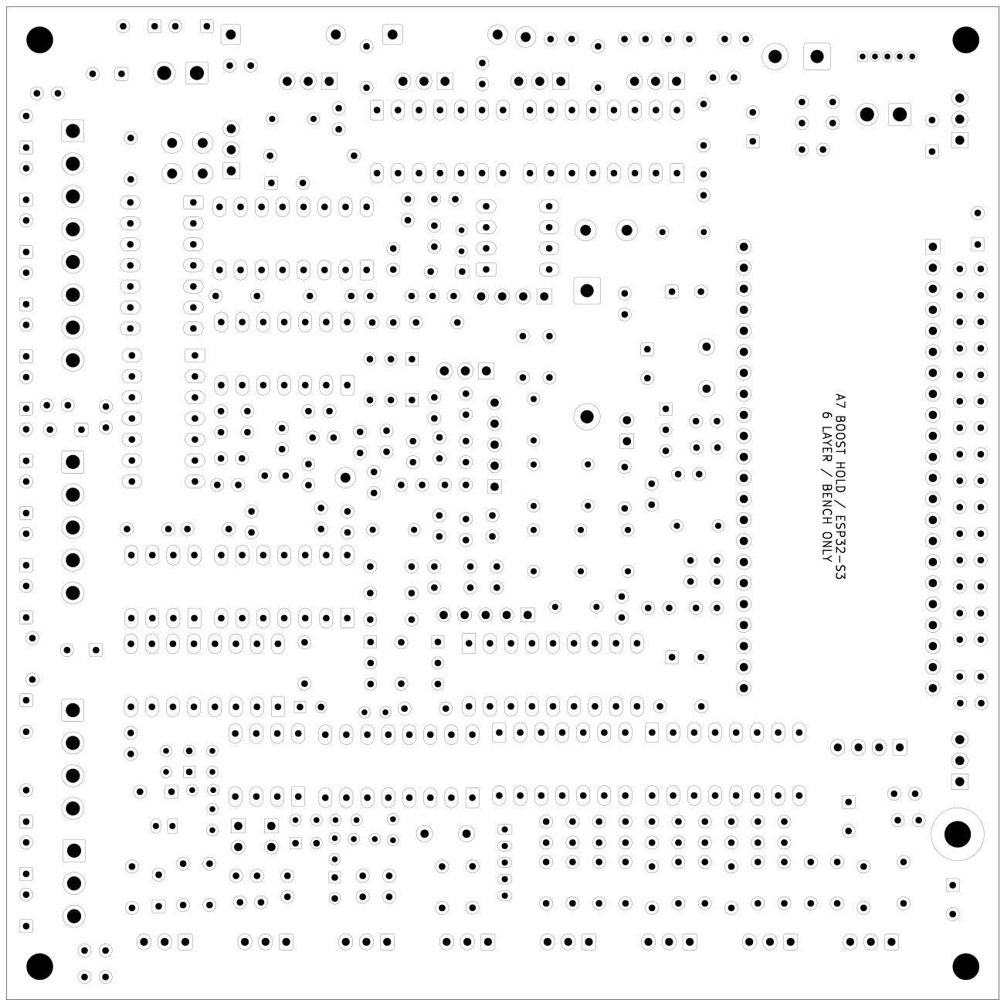
hardware/a7-boost-interface/assembly-back.png
