markthebault/esp32-ecu/hardware/a7-boost-interface/assembly-front.png

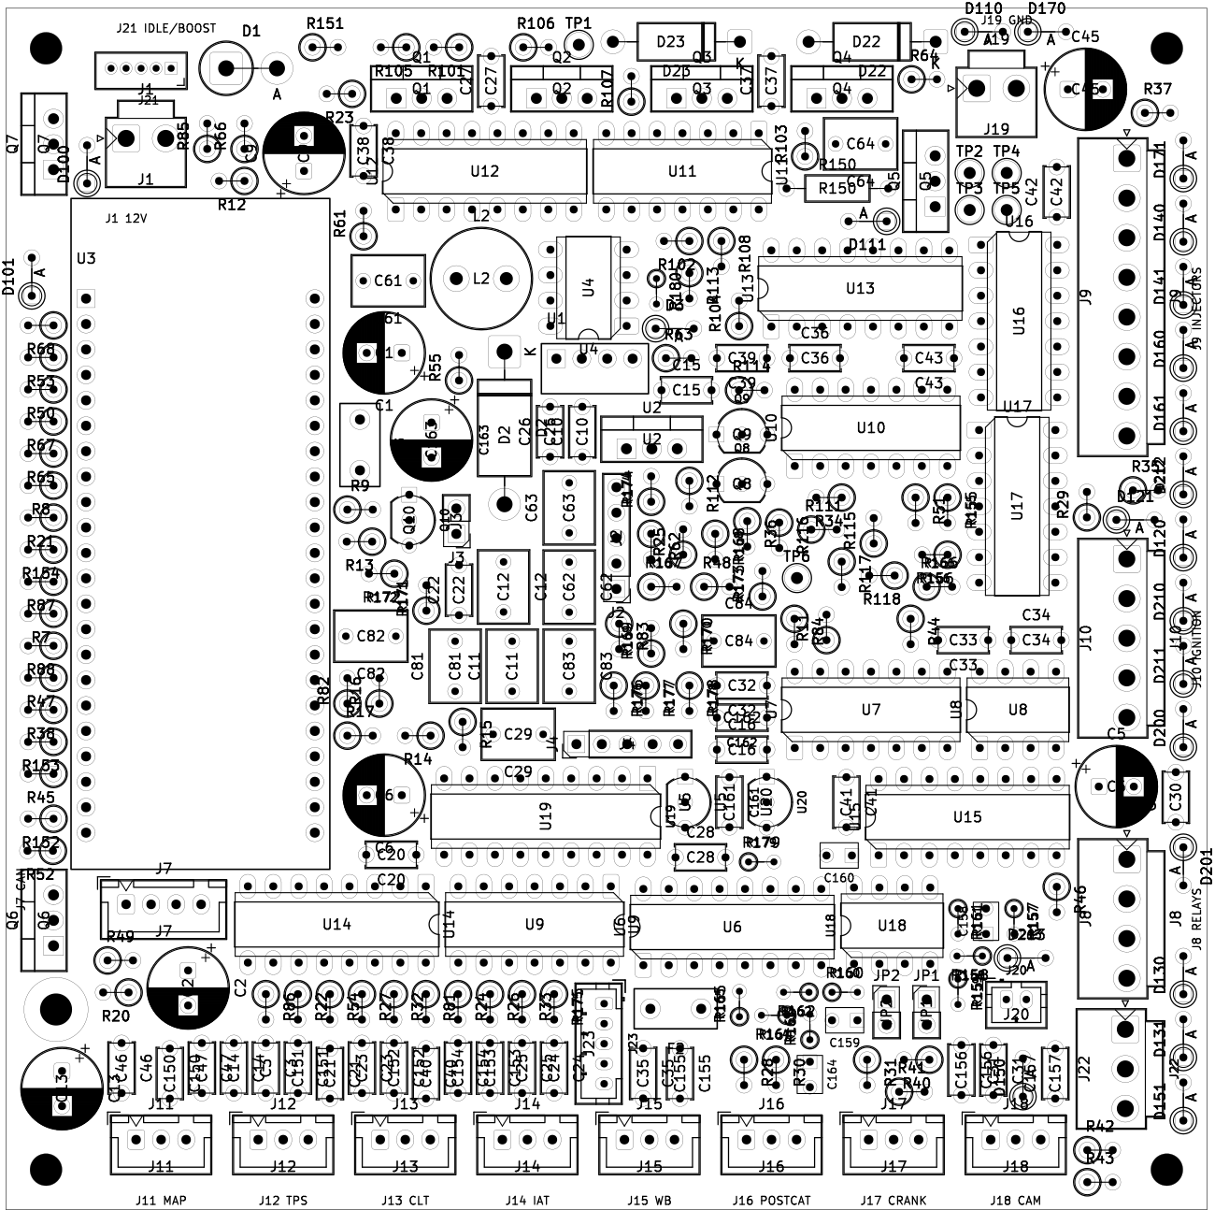
hardware/a7-boost-interface/assembly-front.png
