markthebault/esp32-ecu/hardware/boost-isolated/assembly-back.png

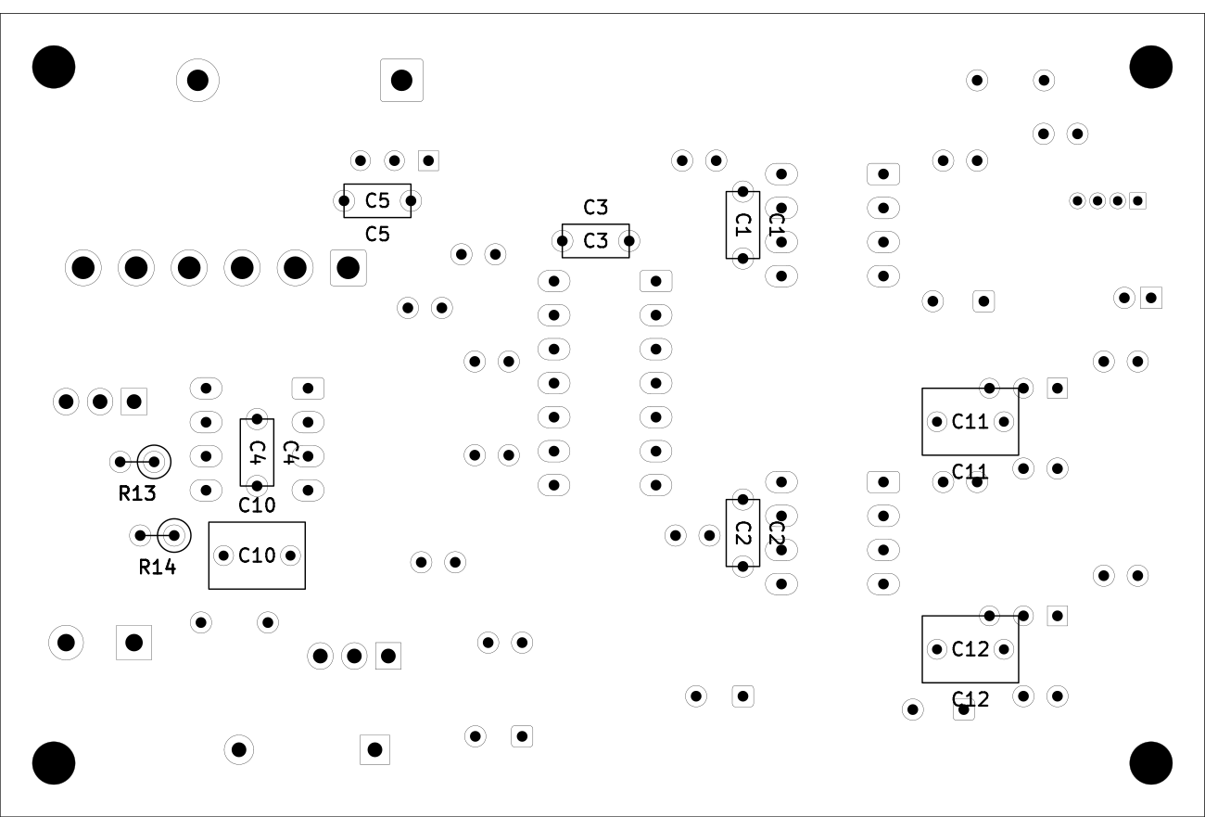
hardware/boost-isolated/assembly-back.png
