markthebault/esp32-ecu/hardware/boost-isolated/assembly-front.png

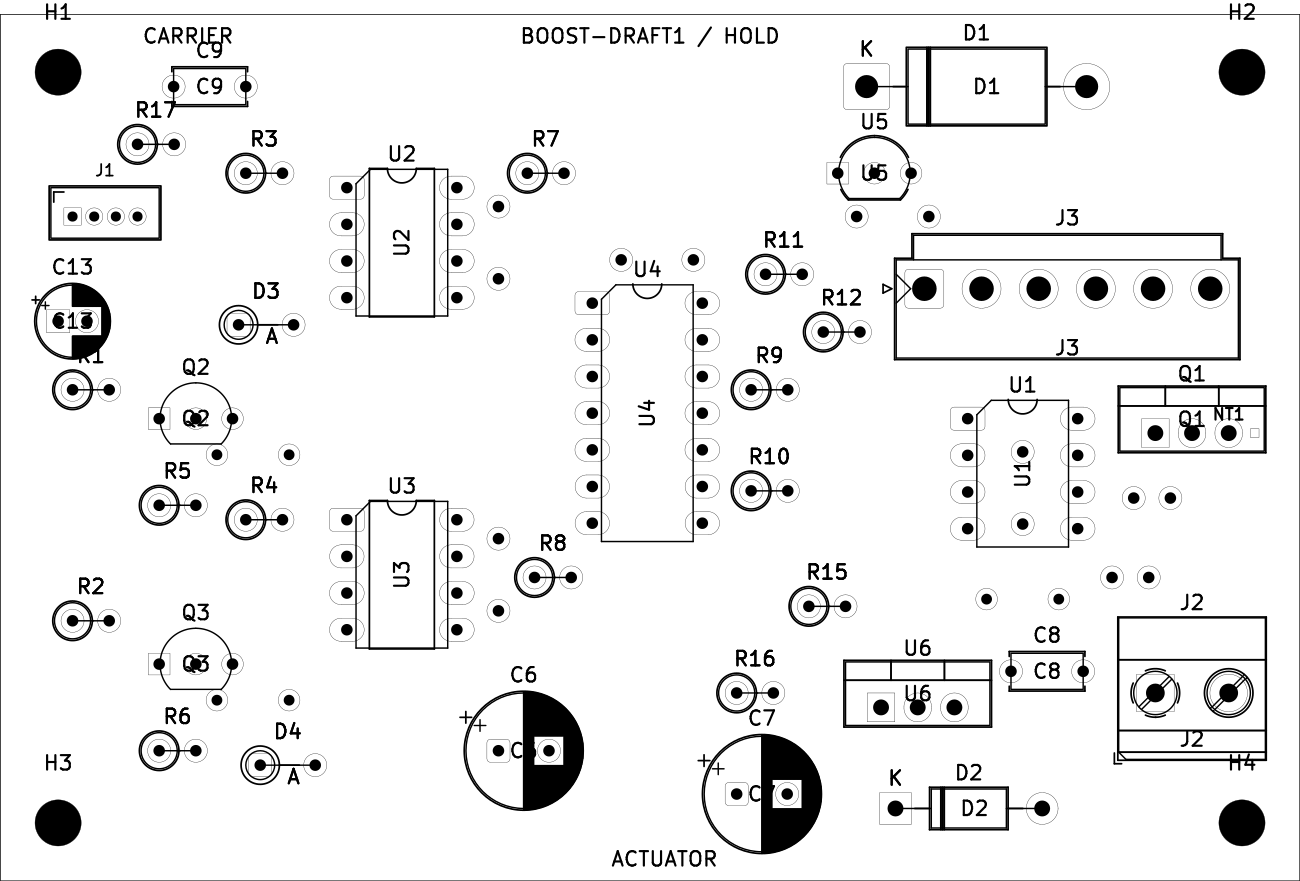
hardware/boost-isolated/assembly-front.png
