markthebault/esp32-ecu/reports/a3/assembly.png

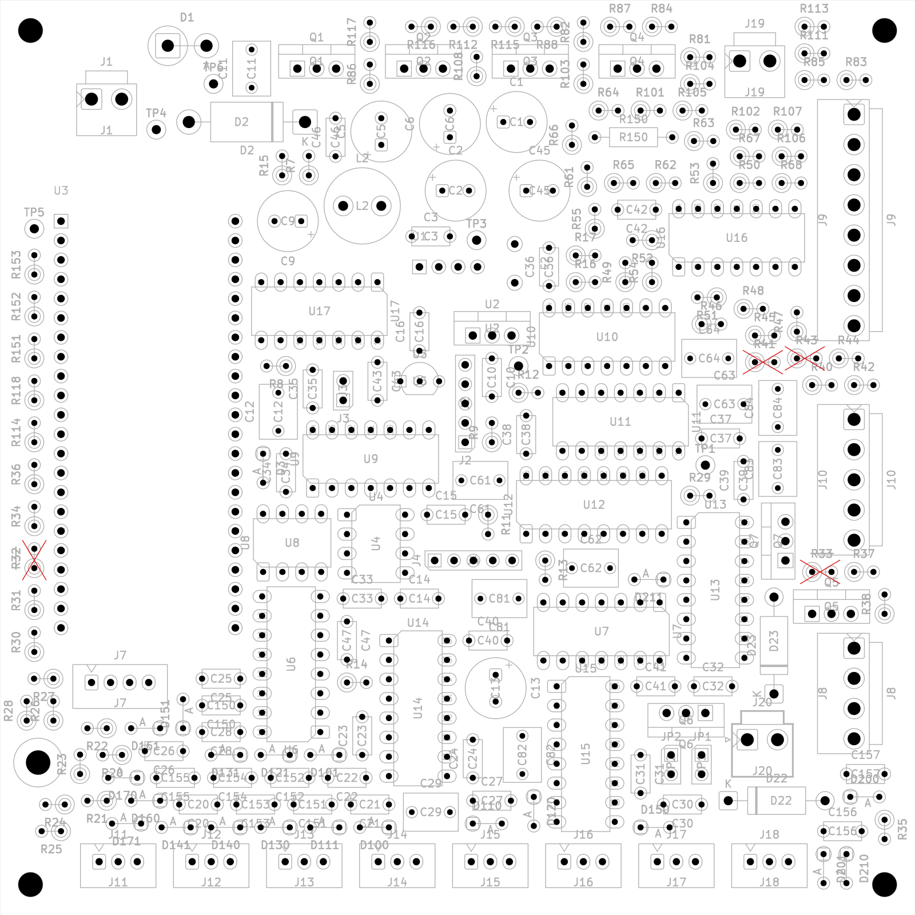
reports/a3/assembly.png
