markthebault/esp32-ecu/reports/engine/idle-control/idle-load-step.png

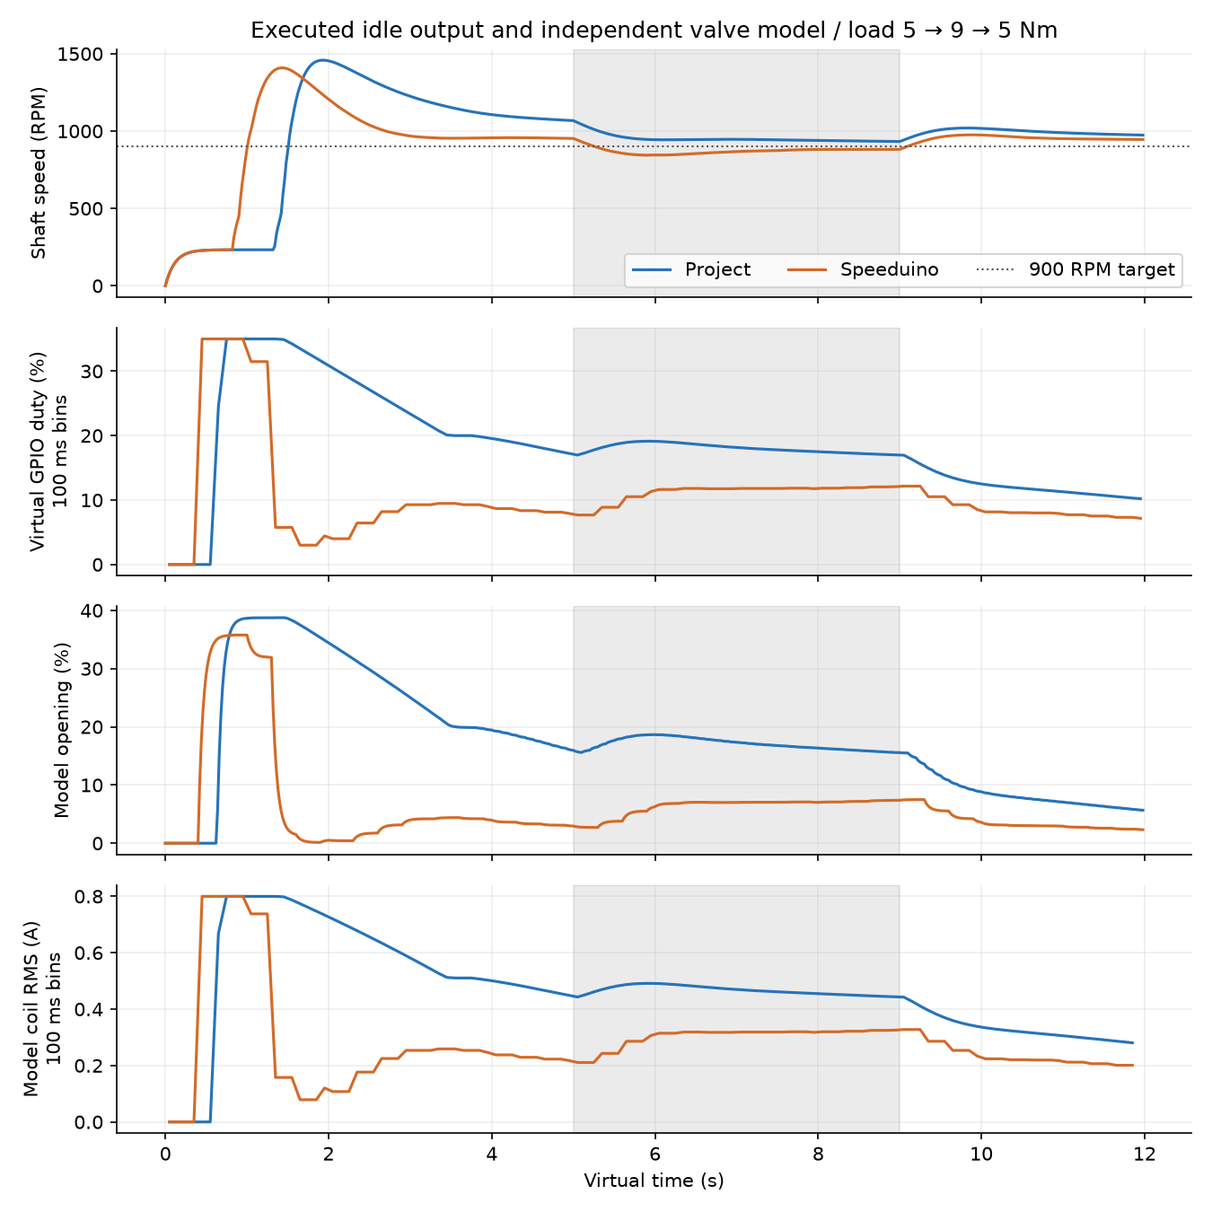
reports/engine/idle-control/idle-load-step.png
