markthebault/esp32-ecu/reports/engine/idle-isolation/cad/assembly/carrier-top.png

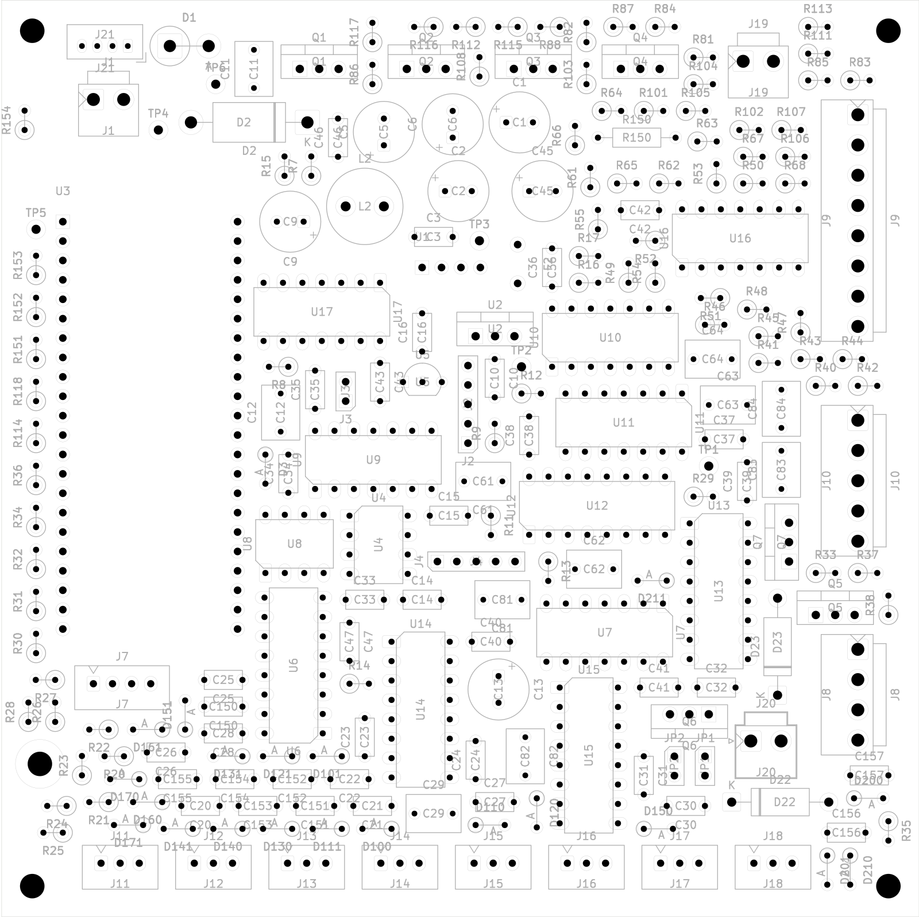
reports/engine/idle-isolation/cad/assembly/carrier-top.png
