markthebault/esp32-ecu/reports/engine/load-model/browser/ui-idle/idle-guide-390.png

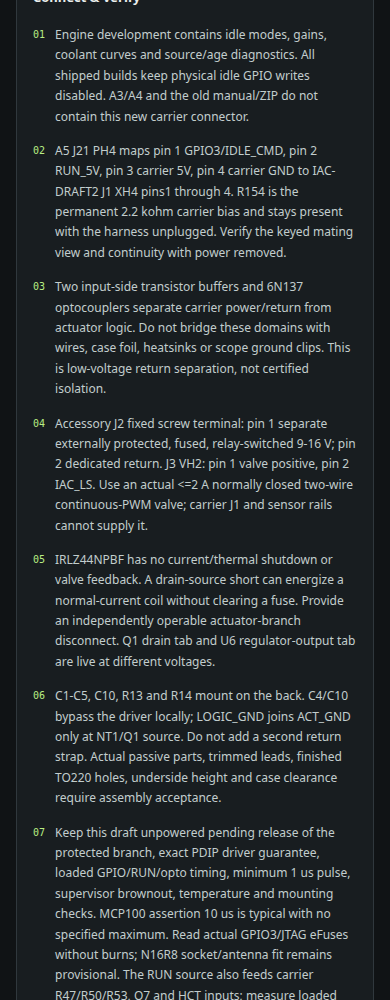
reports/engine/load-model/browser/ui-idle/idle-guide-390.png
