markthebault/esp32-ecu/reports/engine/load-model/browser/ui-idle/idle-guide-768.png

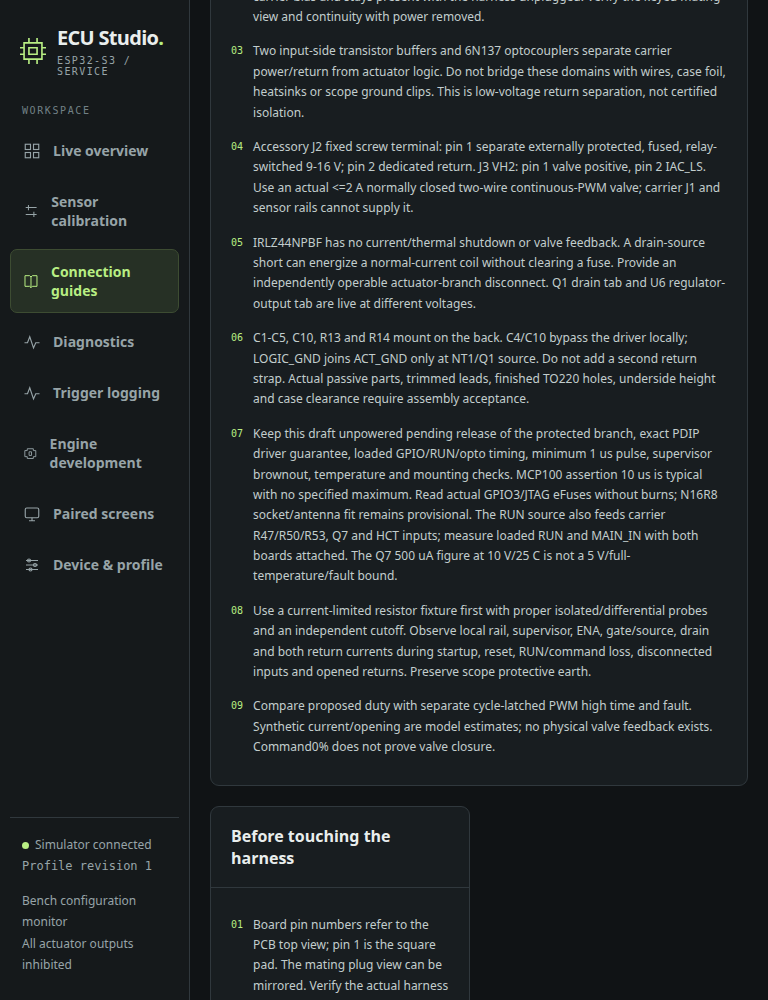
reports/engine/load-model/browser/ui-idle/idle-guide-768.png
