markthebault/esp32-ecu/reports/engine/load-model/browser/ui-idle/idle-guide-1440.png

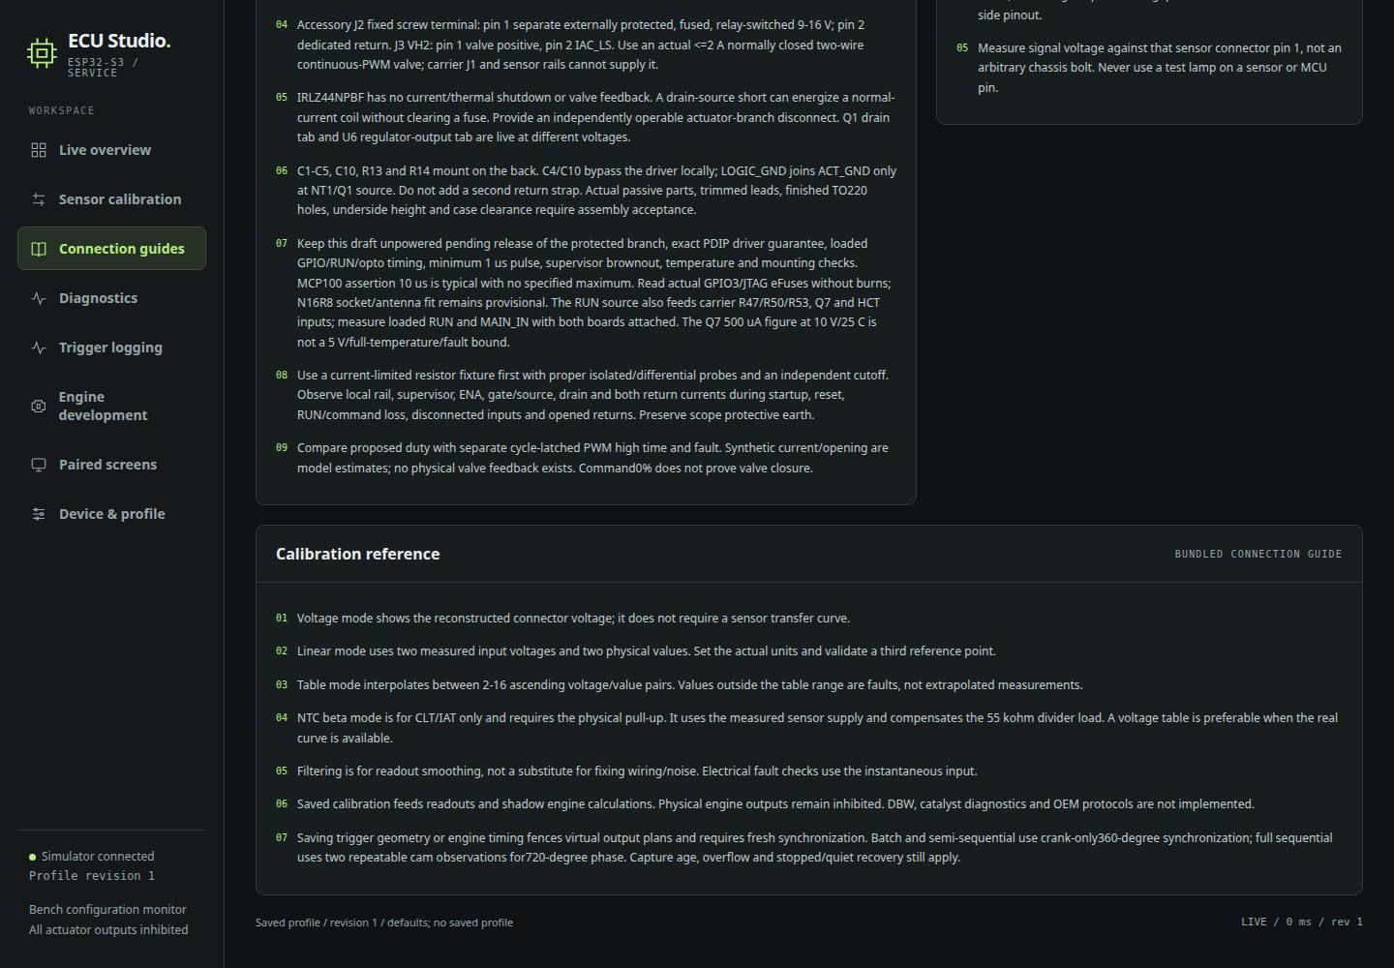
reports/engine/load-model/browser/ui-idle/idle-guide-1440.png
