markthebault/esp32-ecu/reports/engine/switch-inputs/reviews/circuit/reviewed-revision/native/assembly.png

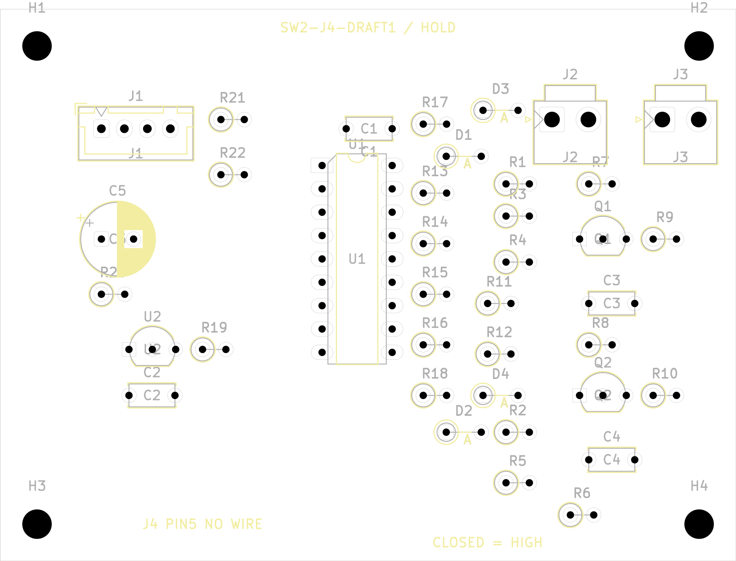
reports/engine/switch-inputs/reviews/circuit/reviewed-revision/native/assembly.png
