markthebault/esp32-ecu/reports/web/connection-guide.png

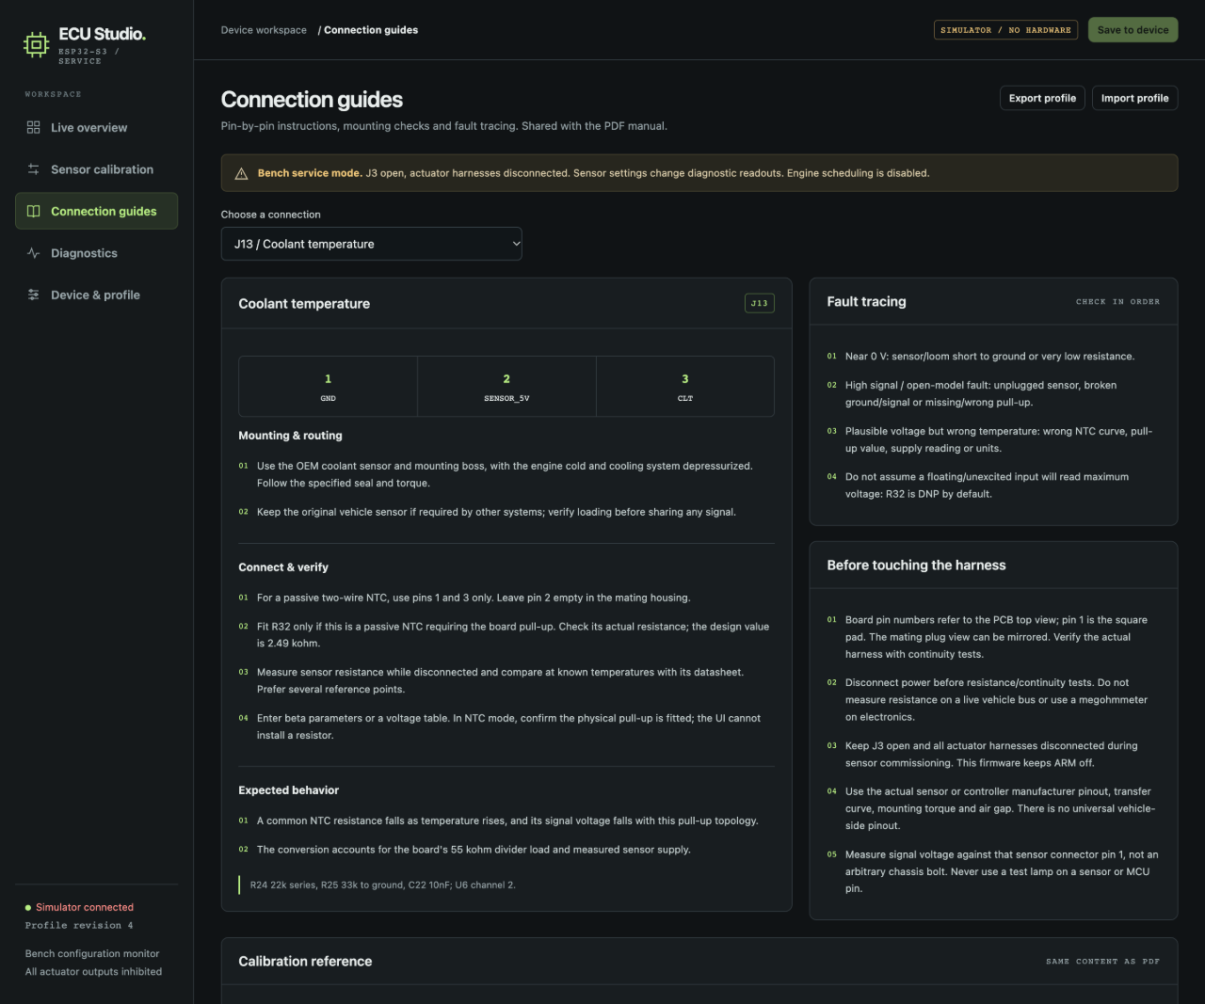
reports/web/connection-guide.png
