markthebault/esp32-ecu/reports/web/full-manual.png

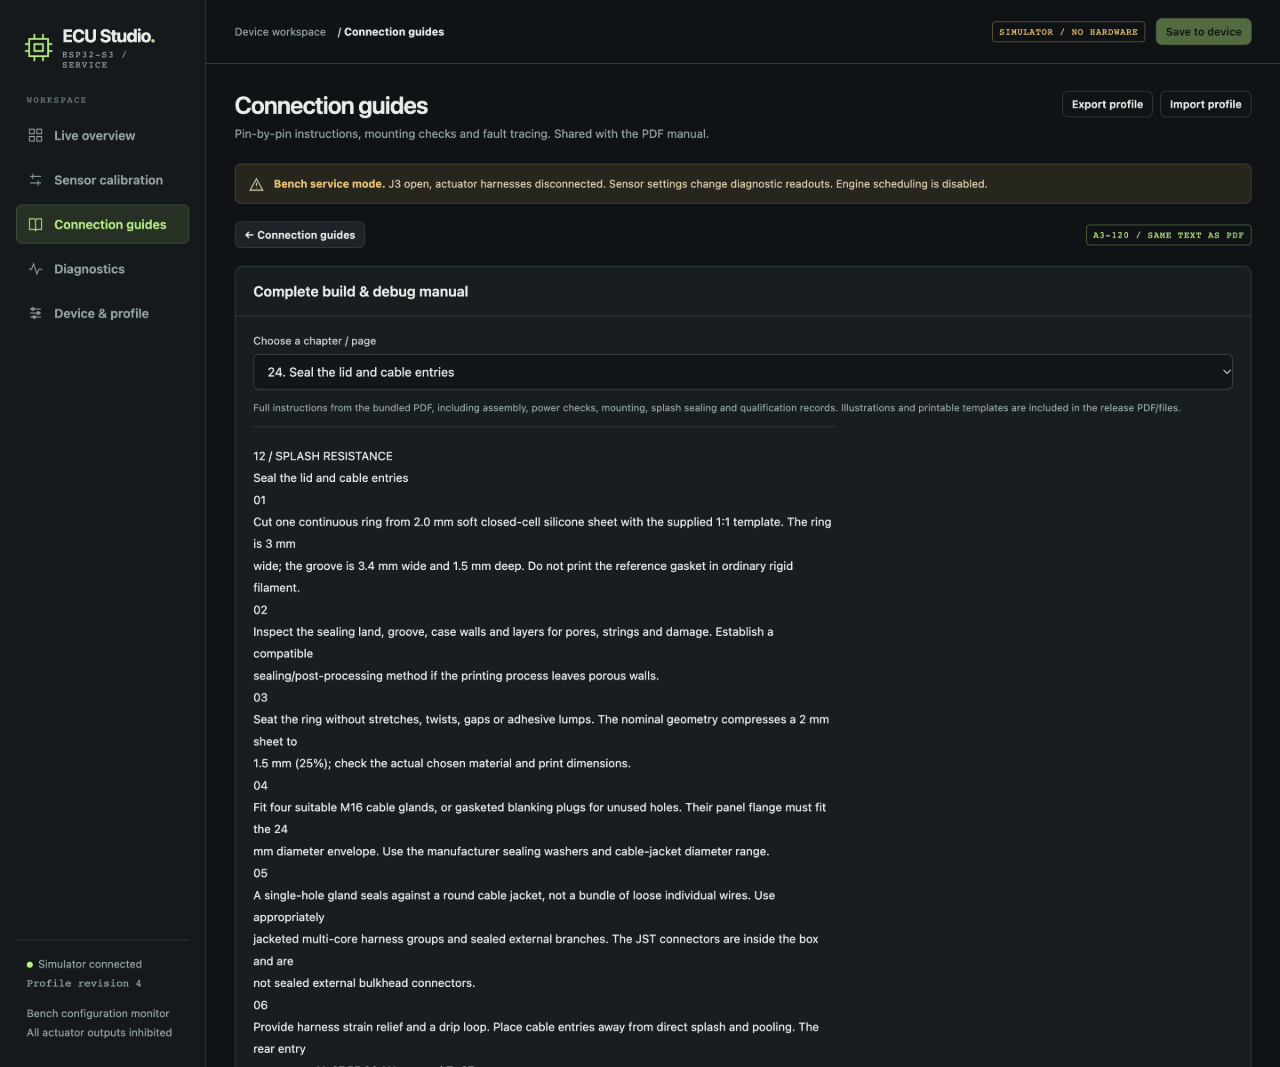
reports/web/full-manual.png
