markthebault/esp32-ecu/reports/engine/native-tests.txt

117 control scenarios passed
Engine maps, mass/flow, correction states, virtual events, supervision, rev hysteresis, DFCO and lambda tests passed
Engine NVS API-model tests passed: large blobs, retained legacy migration, corrupt data, size/NUL checks and write/init/commit errors
