markthebault/esp32-ecu/reports/engine/target-timing/browser-tests.txt

{
  "browser": "Installed Google Chrome via Playwright",
  "checks": [
    "Actual TunerStudio-authored MSQ imports with map orientation preserved",
    "Saved browser-exported MSQ passes native validator and lossless revision check",
    "Stale MSQ is rejected without replacing edits",
    "Delayed save response cannot replace another page",
    "Delayed reload response preserves navigation",
    "SIL runs through UI, historical status is explicit, MSL downloads",
    "Timing trace export is bounded, ordered and explicitly synthetic on host",
    "Target timer fault is visible while physical output mask stays zero",
    "320/390/768/1440px layouts have no document overflow",
    "Persistence failure is visible in engine diagnostics"
  ],
  "page_errors": [],
  "passed": true
}
