markthebault/esp32-ecu/reports/engine/trigger-logging/native-tests.txt

117 control scenarios passed
Engine maps, mass/flow, correction states, virtual events, supervision, rev hysteresis, DFCO and lambda tests passed
Engine NVS API-model tests passed: large blobs, retained legacy migration, corrupt data, size/NUL checks and write/init/commit errors
Capture timebase, transactional timing, independent expiry, output edges and fault tests passed
Finite trigger frame, edge ordering, stale-frame, timeout, invalid timebase and capacity tests passed
Paged trigger JSON, final-row rearm, strict command/query and 2000 allocation-failure positions passed
