markthebault/esp32-ecu/reports/engine/trigger-logging/partial-stop-test.txt

Finite trigger frame, edge ordering, stale-frame, timeout, invalid timebase and capacity tests passed
