markthebault/esp32-ecu/reports/engine/trigger-logging/trigger-browser-tests.txt

{
  "browser": "Installed Google Chrome via Playwright",
  "checks": [
    "No synthetic signal is invented before a completed SIL run",
    "Eight bounded record pages assemble into a complete source-labelled 512-edge export",
    "MSL export preserves unknown levels and labels synthetic signal provenance",
    "Zoom and pan redraw both diagnostic charts",
    "320/390/768/1440px layouts contain charts and the raw table without document overflow",
    "Rearm during paged read disables export instead of mixing frames",
    "Delayed capture response cannot replace a different page",
    "Injected target frame exercises stop, both input channels and falling-edge level display"
  ],
  "page_errors": [],
  "passed": true,
  "source_scope": "Host completed SIL plus explicitly injected target-shaped UI fixture; no physical board"
}
