markthebault/esp32-ecu/reports/engine/research-benchmark-charts.html

Warm start. Actual injection and spark edges sustain rotation after the starter releases at2.5s.

Signal loss and restart. Grey: trigger unavailable. A starter at8–10s restores rotation; each controller receives its own resulting teeth.

Verified hard-limit crossing. Grey: external motoring load. Dashed:6500RPM. Both fuel and ignition cuts are observed.

Long dropout without starter. All three shafts stop. Restoring signal availability cannot rotate a stopped engine.

21 controller cases and 6 step-halving cases. Uncalibrated MVEM air path with local empirical combustion and shaft dynamics. Native HALs and virtual GPIO; physical engine outputs remain inhibited.
