markthebault/esp32-ecu/reports/engine/engine-tests.txt

test_clean_cached_tuner_cannot_overwrite_an_http_edit (__main__.EngineTests.test_clean_cached_tuner_cannot_overwrite_an_http_edit) ... ok
test_corrupt_store_preserved_and_invalid_axes_rejected (__main__.EngineTests.test_corrupt_store_preserved_and_invalid_axes_rejected) ... ok
test_default_tune_is_valid_but_cannot_enable_physical_outputs (__main__.EngineTests.test_default_tune_is_valid_but_cannot_enable_physical_outputs) ... ok
test_dropouts_and_sensor_short_stop_virtual_outputs (__main__.EngineTests.test_dropouts_and_sensor_short_stop_virtual_outputs) ... ok
test_dwell_protection_recovers_only_after_acknowledged_fresh_stop (__main__.EngineTests.test_dwell_protection_recovers_only_after_acknowledged_fresh_stop) ... ok
test_hard_rev_limit_in_closed_loop (__main__.EngineTests.test_hard_rev_limit_in_closed_loop) ... ok
test_integral_json_float_revision_stays_canonical_across_restart (__main__.EngineTests.test_integral_json_float_revision_stays_canonical_across_restart) ... ok
test_msq_revision_is_lossless_at_uint32_boundaries (__main__.EngineTests.test_msq_revision_is_lossless_at_uint32_boundaries) ... ok
test_offline_msq_roundtrip_and_identity_rejection (__main__.EngineTests.test_offline_msq_roundtrip_and_identity_rejection) ... ok
test_partition_layout_preserves_existing_records_and_app_offsets (__main__.EngineTests.test_partition_layout_preserves_existing_records_and_app_offsets) ... ok
test_persistence_error_blocks_later_saves_until_restart (__main__.EngineTests.test_persistence_error_blocks_later_saves_until_restart) ... ok
test_plant_is_deterministic_and_parameters_are_seeded (__main__.EngineTests.test_plant_is_deterministic_and_parameters_are_seeded) ... ok
test_protocol_query_read_write_burn_restart_and_bounds (__main__.EngineTests.test_protocol_query_read_write_burn_restart_and_bounds) ... ok
test_saved_edge_trace_reconstructs_shutdown (__main__.EngineTests.test_saved_edge_trace_reconstructs_shutdown) ... ok
test_stale_control_deadline_and_invalid_sample_cut_native_events (__main__.EngineTests.test_stale_control_deadline_and_invalid_sample_cut_native_events) ... ok
test_stored_tune_revision_and_restart (__main__.EngineTests.test_stored_tune_revision_and_restart) ... ok
test_tuner_and_http_writers_conflict_instead_of_overwriting (__main__.EngineTests.test_tuner_and_http_writers_conflict_instead_of_overwriting) ... ok
test_tuning_snapshot_stays_pinned_and_revision_is_read_only (__main__.EngineTests.test_tuning_snapshot_stays_pinned_and_revision_is_read_only) ... ok
test_unconfirmed_or_stale_inputs_inhibit_proposals (__main__.EngineTests.test_unconfirmed_or_stale_inputs_inhibit_proposals) ... ok
test_warm_and_cold_closed_loop_start_on_generated_teeth (__main__.EngineTests.test_warm_and_cold_closed_loop_start_on_generated_teeth) ... ok
test_zero_fuel_tune_cannot_make_the_plant_run (__main__.EngineTests.test_zero_fuel_tune_cannot_make_the_plant_run) ... ok

----------------------------------------------------------------------
Ran 21 tests in 5.054s

OK
