markthebault/esp32-ecu/reports/engine/radio-tests.txt

test_approval_bound_to_candidate_and_window (__main__.RadioTests.test_approval_bound_to_candidate_and_window) ... ok
test_capacity_and_unpair_reuse (__main__.RadioTests.test_capacity_and_unpair_reuse) ... ok
test_codec_pair_and_confirmation (__main__.RadioTests.test_codec_pair_and_confirmation) ... ok
test_codec_rejects_unknown_and_bad_inputs (__main__.RadioTests.test_codec_rejects_unknown_and_bad_inputs) ... ok
test_failed_commit_preserves_runtime_peers (__main__.RadioTests.test_failed_commit_preserves_runtime_peers) ... ok
test_open_cancel_expiry_and_new_key (__main__.RadioTests.test_open_cancel_expiry_and_new_key) ... ok
test_pair_persist_unpair_and_restart (__main__.RadioTests.test_pair_persist_unpair_and_restart) ... ok
test_storage_corruption_not_overwritten (__main__.RadioTests.test_storage_corruption_not_overwritten) ... ok

----------------------------------------------------------------------
Ran 8 tests in 0.006s

OK
