markthebault/esp32-ecu/reports/engine/research-acceptance-tests.txt

test_actual_fuel_and_spark_change_free_shaft (__main__.ResearchPlantAcceptance.test_actual_fuel_and_spark_change_free_shaft) ... LOG_SOLVER        | info    | CVODE linear multistep method CV_BDF
LOG_SOLVER        | info    | CVODE maximum integration order CV_ITER_NEWTON
LOG_SOLVER        | info    | CVODE use equidistant time grid YES
LOG_SOLVER        | info    | CVODE Using relative error tolerance 1.000000e-08
LOG_SOLVER        | info    | CVODE Using dense internal linear solver SUNLinSol_Dense.
LOG_SOLVER        | info    | CVODE Use internal dense numeric jacobian method.
LOG_SOLVER        | info    | CVODE uses internal root finding method NO
LOG_SOLVER        | info    | CVODE maximum absolut step size 0
LOG_SOLVER        | info    | CVODE initial step size is set automatically
LOG_SOLVER        | info    | CVODE maximum integration order 5
LOG_SOLVER        | info    | CVODE maximum number of nonlinear convergence failures permitted during one step 10
LOG_SOLVER        | info    | CVODE BDF stability limit detection algorithm OFF
LOG_SOLVER        | info    | CVODE linear multistep method CV_BDF
LOG_SOLVER        | info    | CVODE maximum integration order CV_ITER_NEWTON
LOG_SOLVER        | info    | CVODE use equidistant time grid YES
LOG_SOLVER        | info    | CVODE Using relative error tolerance 1.000000e-08
LOG_SOLVER        | info    | CVODE Using dense internal linear solver SUNLinSol_Dense.
LOG_SOLVER        | info    | CVODE Use internal dense numeric jacobian method.
LOG_SOLVER        | info    | CVODE uses internal root finding method NO
LOG_SOLVER        | info    | CVODE maximum absolut step size 0
LOG_SOLVER        | info    | CVODE initial step size is set automatically
LOG_SOLVER        | info    | CVODE maximum integration order 5
LOG_SOLVER        | info    | CVODE maximum number of nonlinear convergence failures permitted during one step 10
LOG_SOLVER        | info    | CVODE BDF stability limit detection algorithm OFF
LOG_SOLVER        | info    | CVODE linear multistep method CV_BDF
LOG_SOLVER        | info    | CVODE maximum integration order CV_ITER_NEWTON
LOG_SOLVER        | info    | CVODE use equidistant time grid YES
LOG_SOLVER        | info    | CVODE Using relative error tolerance 1.000000e-08
LOG_SOLVER        | info    | CVODE Using dense internal linear solver SUNLinSol_Dense.
LOG_SOLVER        | info    | CVODE Use internal dense numeric jacobian method.
LOG_SOLVER        | info    | CVODE uses internal root finding method NO
LOG_SOLVER        | info    | CVODE maximum absolut step size 0
LOG_SOLVER        | info    | CVODE initial step size is set automatically
LOG_SOLVER        | info    | CVODE maximum integration order 5
LOG_SOLVER        | info    | CVODE maximum number of nonlinear convergence failures permitted during one step 10
LOG_SOLVER        | info    | CVODE BDF stability limit detection algorithm OFF
ok
test_fuel_at_rest_creates_no_work (__main__.ResearchPlantAcceptance.test_fuel_at_rest_creates_no_work) ... LOG_SOLVER        | info    | CVODE linear multistep method CV_BDF
LOG_SOLVER        | info    | CVODE maximum integration order CV_ITER_NEWTON
LOG_SOLVER        | info    | CVODE use equidistant time grid YES
LOG_SOLVER        | info    | CVODE Using relative error tolerance 1.000000e-08
LOG_SOLVER        | info    | CVODE Using dense internal linear solver SUNLinSol_Dense.
LOG_SOLVER        | info    | CVODE Use internal dense numeric jacobian method.
LOG_SOLVER        | info    | CVODE uses internal root finding method NO
LOG_SOLVER        | info    | CVODE maximum absolut step size 0
LOG_SOLVER        | info    | CVODE initial step size is set automatically
LOG_SOLVER        | info    | CVODE maximum integration order 5
LOG_SOLVER        | info    | CVODE maximum number of nonlinear convergence failures permitted during one step 10
LOG_SOLVER        | info    | CVODE BDF stability limit detection algorithm OFF
ok
test_fuel_without_ignition_exits_unburned (__main__.ResearchPlantAcceptance.test_fuel_without_ignition_exits_unburned) ... LOG_SOLVER        | info    | CVODE linear multistep method CV_BDF
LOG_SOLVER        | info    | CVODE maximum integration order CV_ITER_NEWTON
LOG_SOLVER        | info    | CVODE use equidistant time grid YES
LOG_SOLVER        | info    | CVODE Using relative error tolerance 1.000000e-08
LOG_SOLVER        | info    | CVODE Using dense internal linear solver SUNLinSol_Dense.
LOG_SOLVER        | info    | CVODE Use internal dense numeric jacobian method.
LOG_SOLVER        | info    | CVODE uses internal root finding method NO
LOG_SOLVER        | info    | CVODE maximum absolut step size 0
LOG_SOLVER        | info    | CVODE initial step size is set automatically
LOG_SOLVER        | info    | CVODE maximum integration order 5
LOG_SOLVER        | info    | CVODE maximum number of nonlinear convergence failures permitted during one step 10
LOG_SOLVER        | info    | CVODE BDF stability limit detection algorithm OFF
ok
test_halving_coupling_step_converges (__main__.ResearchPlantAcceptance.test_halving_coupling_step_converges) ... LOG_SOLVER        | info    | CVODE linear multistep method CV_BDF
LOG_SOLVER        | info    | CVODE maximum integration order CV_ITER_NEWTON
LOG_SOLVER        | info    | CVODE use equidistant time grid YES
LOG_SOLVER        | info    | CVODE Using relative error tolerance 1.000000e-08
LOG_SOLVER        | info    | CVODE Using dense internal linear solver SUNLinSol_Dense.
LOG_SOLVER        | info    | CVODE Use internal dense numeric jacobian method.
LOG_SOLVER        | info    | CVODE uses internal root finding method NO
LOG_SOLVER        | info    | CVODE maximum absolut step size 0
LOG_SOLVER        | info    | CVODE initial step size is set automatically
LOG_SOLVER        | info    | CVODE maximum integration order 5
LOG_SOLVER        | info    | CVODE maximum number of nonlinear convergence failures permitted during one step 10
LOG_SOLVER        | info    | CVODE BDF stability limit detection algorithm OFF
LOG_SOLVER        | info    | CVODE linear multistep method CV_BDF
LOG_SOLVER        | info    | CVODE maximum integration order CV_ITER_NEWTON
LOG_SOLVER        | info    | CVODE use equidistant time grid YES
LOG_SOLVER        | info    | CVODE Using relative error tolerance 1.000000e-08
LOG_SOLVER        | info    | CVODE Using dense internal linear solver SUNLinSol_Dense.
LOG_SOLVER        | info    | CVODE Use internal dense numeric jacobian method.
LOG_SOLVER        | info    | CVODE uses internal root finding method NO
LOG_SOLVER        | info    | CVODE maximum absolut step size 0
LOG_SOLVER        | info    | CVODE initial step size is set automatically
LOG_SOLVER        | info    | CVODE maximum integration order 5
LOG_SOLVER        | info    | CVODE maximum number of nonlinear convergence failures permitted during one step 10
LOG_SOLVER        | info    | CVODE BDF stability limit detection algorithm OFF
ok
test_ignition_without_fuel_creates_no_work (__main__.ResearchPlantAcceptance.test_ignition_without_fuel_creates_no_work) ... LOG_SOLVER        | info    | CVODE linear multistep method CV_BDF
LOG_SOLVER        | info    | CVODE maximum integration order CV_ITER_NEWTON
LOG_SOLVER        | info    | CVODE use equidistant time grid YES
LOG_SOLVER        | info    | CVODE Using relative error tolerance 1.000000e-08
LOG_SOLVER        | info    | CVODE Using dense internal linear solver SUNLinSol_Dense.
LOG_SOLVER        | info    | CVODE Use internal dense numeric jacobian method.
LOG_SOLVER        | info    | CVODE uses internal root finding method NO
LOG_SOLVER        | info    | CVODE maximum absolut step size 0
LOG_SOLVER        | info    | CVODE initial step size is set automatically
LOG_SOLVER        | info    | CVODE maximum integration order 5
LOG_SOLVER        | info    | CVODE maximum number of nonlinear convergence failures permitted during one step 10
LOG_SOLVER        | info    | CVODE BDF stability limit detection algorithm OFF
ok
test_rest_starter_coast_restart (__main__.ResearchPlantAcceptance.test_rest_starter_coast_restart) ... LOG_SOLVER        | info    | CVODE linear multistep method CV_BDF
LOG_SOLVER        | info    | CVODE maximum integration order CV_ITER_NEWTON
LOG_SOLVER        | info    | CVODE use equidistant time grid YES
LOG_SOLVER        | info    | CVODE Using relative error tolerance 1.000000e-08
LOG_SOLVER        | info    | CVODE Using dense internal linear solver SUNLinSol_Dense.
LOG_SOLVER        | info    | CVODE Use internal dense numeric jacobian method.
LOG_SOLVER        | info    | CVODE uses internal root finding method NO
LOG_SOLVER        | info    | CVODE maximum absolut step size 0
LOG_SOLVER        | info    | CVODE initial step size is set automatically
LOG_SOLVER        | info    | CVODE maximum integration order 5
LOG_SOLVER        | info    | CVODE maximum number of nonlinear convergence failures permitted during one step 10
LOG_SOLVER        | info    | CVODE BDF stability limit detection algorithm OFF
ok
test_trapped_air_is_frozen_after_intake_closing (__main__.ResearchPlantAcceptance.test_trapped_air_is_frozen_after_intake_closing) ... LOG_SOLVER        | info    | CVODE linear multistep method CV_BDF
LOG_SOLVER        | info    | CVODE maximum integration order CV_ITER_NEWTON
LOG_SOLVER        | info    | CVODE use equidistant time grid YES
LOG_SOLVER        | info    | CVODE Using relative error tolerance 1.000000e-08
LOG_SOLVER        | info    | CVODE Using dense internal linear solver SUNLinSol_Dense.
LOG_SOLVER        | info    | CVODE Use internal dense numeric jacobian method.
LOG_SOLVER        | info    | CVODE uses internal root finding method NO
LOG_SOLVER        | info    | CVODE maximum absolut step size 0
LOG_SOLVER        | info    | CVODE initial step size is set automatically
LOG_SOLVER        | info    | CVODE maximum integration order 5
LOG_SOLVER        | info    | CVODE maximum number of nonlinear convergence failures permitted during one step 10
LOG_SOLVER        | info    | CVODE BDF stability limit detection algorithm OFF
ok

----------------------------------------------------------------------
Ran 7 tests in 14.477s

OK
