markthebault/esp32-ecu/reports/engine/sensor-api-tests.txt

test_channel_identity_cannot_be_remapped (__main__.ConfigTests.test_channel_identity_cannot_be_remapped) ... ok
test_corrupt_storage_blocks_overwrite (__main__.ConfigTests.test_corrupt_storage_blocks_overwrite) ... ok
test_deep_json_rejected_before_recursive_parse (__main__.ConfigTests.test_deep_json_rejected_before_recursive_parse) ... ok
test_instant_fault_does_not_depend_on_confirmation (__main__.ConfigTests.test_instant_fault_does_not_depend_on_confirmation) ... ok
test_invalid_curve_and_geometry_rejected (__main__.ConfigTests.test_invalid_curve_and_geometry_rejected) ... ok
test_linear_and_reverse_transfer (__main__.ConfigTests.test_linear_and_reverse_transfer) ... ok
test_ntc_corrects_input_loading (__main__.ConfigTests.test_ntc_corrects_input_loading) ... ok
test_ntc_requires_physical_pullup_and_correct_channel (__main__.ConfigTests.test_ntc_requires_physical_pullup_and_correct_channel) ... ok
test_real_defaults_parse (__main__.ConfigTests.test_real_defaults_parse) ... ok
test_save_failure_preserves_runtime_profile (__main__.ConfigTests.test_save_failure_preserves_runtime_profile) ... ok
test_save_restart_and_stale_revision (__main__.ConfigTests.test_save_restart_and_stale_revision) ... ok
test_table_interpolation_and_no_extrapolation (__main__.ConfigTests.test_table_interpolation_and_no_extrapolation) ... ok
test_unknown_duplicate_and_nonfinite_fields_rejected (__main__.ConfigTests.test_unknown_duplicate_and_nonfinite_fields_rejected) ... ok
test_voltage_quantization (__main__.ConfigTests.test_voltage_quantization) ... ok
test_http_requires_boot_token_and_same_origin (__main__.HttpTests.test_http_requires_boot_token_and_same_origin) ... ok
test_http_save_and_live_conversion (__main__.HttpTests.test_http_save_and_live_conversion) ... ok
test_http_simulated_short_flags_fault (__main__.HttpTests.test_http_simulated_short_flags_fault) ... ok
test_manual_reader_serves_the_pdf_text (__main__.HttpTests.test_manual_reader_serves_the_pdf_text) ... ok
test_radio_authentication_and_pair_unpair (__main__.HttpTests.test_radio_authentication_and_pair_unpair) ... ok
test_radio_rejects_malformed_commands (__main__.HttpTests.test_radio_rejects_malformed_commands) ... ok

----------------------------------------------------------------------
Ran 20 tests in 3.058s

OK
