markthebault/esp32-ecu/reports/engine/speeduino-runtime-tests.txt

test_constant_speed_sync_edges_and_repeatability (__main__.ProductionSpeeduinoAcceptance.test_constant_speed_sync_edges_and_repeatability) ... ok
test_enabled_fixed_hard_limit_cuts_real_schedulers (__main__.ProductionSpeeduinoAcceptance.test_enabled_fixed_hard_limit_cuts_real_schedulers) ... ok
test_halt_closes_actually_high_injectors_and_coils (__main__.ProductionSpeeduinoAcceptance.test_halt_closes_actually_high_injectors_and_coils) ... ok
test_invalid_native_clock_is_bounded (__main__.ProductionSpeeduinoAcceptance.test_invalid_native_clock_is_bounded) ... ok

----------------------------------------------------------------------
Ran 4 tests in 1.069s

OK
