markthebault/esp32-ecu/reports/engine/transport-tests.txt

test_engine_http_auth_schema_and_revision (__main__.IntegrationTests.test_engine_http_auth_schema_and_revision) ... ok
test_http_run_and_log_are_historical_and_tuning_snapshot_identifies_them (__main__.IntegrationTests.test_http_run_and_log_are_historical_and_tuning_snapshot_identifies_them) ... ok
test_pty_fragments_and_crc_rejection (__main__.IntegrationTests.test_pty_fragments_and_crc_rejection) ... ok
test_real_tcp_burn_updates_http_and_http_edit_requires_reconnect (__main__.IntegrationTests.test_real_tcp_burn_updates_http_and_http_edit_requires_reconnect) ... ok

----------------------------------------------------------------------
Ran 4 tests in 3.358s

OK
