markthebault/esp32-ecu/reports/engine/target-timing/http-tests.txt

test_engine_http_auth_schema_and_revision (tools.test_engine_http.IntegrationTests.test_engine_http_auth_schema_and_revision) ... ok
test_http_run_and_log_are_historical_and_tuning_snapshot_identifies_them (tools.test_engine_http.IntegrationTests.test_http_run_and_log_are_historical_and_tuning_snapshot_identifies_them) ... ok
test_pty_fragments_and_crc_rejection (tools.test_engine_http.IntegrationTests.test_pty_fragments_and_crc_rejection) ... ok
test_real_tcp_burn_updates_http_and_http_edit_requires_reconnect (tools.test_engine_http.IntegrationTests.test_real_tcp_burn_updates_http_and_http_edit_requires_reconnect) ... ok
test_timing_export_is_bounded_and_identifies_completed_synthetic_data (tools.test_engine_http.IntegrationTests.test_timing_export_is_bounded_and_identifies_completed_synthetic_data) ... ok

----------------------------------------------------------------------
Ran 5 tests in 3.788s

OK
