markthebault/esp32-ecu/reports/engine/target-timing/python-tests.txt

test_channel_identity_cannot_be_remapped (tools.test_web_config.ConfigTests.test_channel_identity_cannot_be_remapped) ... ok
test_corrupt_storage_blocks_overwrite (tools.test_web_config.ConfigTests.test_corrupt_storage_blocks_overwrite) ... ok
test_deep_json_rejected_before_recursive_parse (tools.test_web_config.ConfigTests.test_deep_json_rejected_before_recursive_parse) ... ok
test_instant_fault_does_not_depend_on_confirmation (tools.test_web_config.ConfigTests.test_instant_fault_does_not_depend_on_confirmation) ... ok
test_invalid_curve_and_geometry_rejected (tools.test_web_config.ConfigTests.test_invalid_curve_and_geometry_rejected) ... ok
test_linear_and_reverse_transfer (tools.test_web_config.ConfigTests.test_linear_and_reverse_transfer) ... ok
test_ntc_corrects_input_loading (tools.test_web_config.ConfigTests.test_ntc_corrects_input_loading) ... ok
test_ntc_requires_physical_pullup_and_correct_channel (tools.test_web_config.ConfigTests.test_ntc_requires_physical_pullup_and_correct_channel) ... ok
test_real_defaults_parse (tools.test_web_config.ConfigTests.test_real_defaults_parse) ... ok
test_save_failure_preserves_runtime_profile (tools.test_web_config.ConfigTests.test_save_failure_preserves_runtime_profile) ... ok
test_save_restart_and_stale_revision (tools.test_web_config.ConfigTests.test_save_restart_and_stale_revision) ... ok
test_table_interpolation_and_no_extrapolation (tools.test_web_config.ConfigTests.test_table_interpolation_and_no_extrapolation) ... ok
test_unknown_duplicate_and_nonfinite_fields_rejected (tools.test_web_config.ConfigTests.test_unknown_duplicate_and_nonfinite_fields_rejected) ... ok
test_voltage_quantization (tools.test_web_config.ConfigTests.test_voltage_quantization) ... ok
test_http_requires_boot_token_and_same_origin (tools.test_web_config.HttpTests.test_http_requires_boot_token_and_same_origin) ... ok
test_http_save_and_live_conversion (tools.test_web_config.HttpTests.test_http_save_and_live_conversion) ... ok
test_http_simulated_short_flags_fault (tools.test_web_config.HttpTests.test_http_simulated_short_flags_fault) ... ok
test_manual_reader_serves_the_pdf_text (tools.test_web_config.HttpTests.test_manual_reader_serves_the_pdf_text) ... ok
test_radio_authentication_and_pair_unpair (tools.test_web_config.HttpTests.test_radio_authentication_and_pair_unpair) ... ok
test_radio_rejects_malformed_commands (tools.test_web_config.HttpTests.test_radio_rejects_malformed_commands) ... ok
test_approval_bound_to_candidate_and_window (tools.test_radio.RadioTests.test_approval_bound_to_candidate_and_window) ... ok
test_capacity_and_unpair_reuse (tools.test_radio.RadioTests.test_capacity_and_unpair_reuse) ... ok
test_codec_pair_and_confirmation (tools.test_radio.RadioTests.test_codec_pair_and_confirmation) ... ok
test_codec_rejects_unknown_and_bad_inputs (tools.test_radio.RadioTests.test_codec_rejects_unknown_and_bad_inputs) ... ok
test_failed_commit_preserves_runtime_peers (tools.test_radio.RadioTests.test_failed_commit_preserves_runtime_peers) ... ok
test_open_cancel_expiry_and_new_key (tools.test_radio.RadioTests.test_open_cancel_expiry_and_new_key) ... ok
test_pair_persist_unpair_and_restart (tools.test_radio.RadioTests.test_pair_persist_unpair_and_restart) ... ok
test_storage_corruption_not_overwritten (tools.test_radio.RadioTests.test_storage_corruption_not_overwritten) ... ok
test_clean_cached_tuner_cannot_overwrite_an_http_edit (tools.test_engine.EngineTests.test_clean_cached_tuner_cannot_overwrite_an_http_edit) ... ok
test_corrupt_store_preserved_and_invalid_axes_rejected (tools.test_engine.EngineTests.test_corrupt_store_preserved_and_invalid_axes_rejected) ... ok
test_default_tune_is_valid_but_cannot_enable_physical_outputs (tools.test_engine.EngineTests.test_default_tune_is_valid_but_cannot_enable_physical_outputs) ... ok
test_dropouts_and_sensor_short_stop_virtual_outputs (tools.test_engine.EngineTests.test_dropouts_and_sensor_short_stop_virtual_outputs) ... ok
test_dwell_protection_recovers_only_after_acknowledged_fresh_stop (tools.test_engine.EngineTests.test_dwell_protection_recovers_only_after_acknowledged_fresh_stop) ... ok
test_hard_rev_limit_in_closed_loop (tools.test_engine.EngineTests.test_hard_rev_limit_in_closed_loop) ... ok
test_integral_json_float_revision_stays_canonical_across_restart (tools.test_engine.EngineTests.test_integral_json_float_revision_stays_canonical_across_restart) ... ok
test_msq_revision_is_lossless_at_uint32_boundaries (tools.test_engine.EngineTests.test_msq_revision_is_lossless_at_uint32_boundaries) ... ok
test_offline_msq_roundtrip_and_identity_rejection (tools.test_engine.EngineTests.test_offline_msq_roundtrip_and_identity_rejection) ... ok
test_partition_layout_preserves_existing_records_and_app_offsets (tools.test_engine.EngineTests.test_partition_layout_preserves_existing_records_and_app_offsets) ... ok
test_persistence_error_blocks_later_saves_until_restart (tools.test_engine.EngineTests.test_persistence_error_blocks_later_saves_until_restart) ... ok
test_plant_is_deterministic_and_parameters_are_seeded (tools.test_engine.EngineTests.test_plant_is_deterministic_and_parameters_are_seeded) ... ok
test_protocol_query_read_write_burn_restart_and_bounds (tools.test_engine.EngineTests.test_protocol_query_read_write_burn_restart_and_bounds) ... ok
test_saved_edge_trace_reconstructs_shutdown (tools.test_engine.EngineTests.test_saved_edge_trace_reconstructs_shutdown) ... ok
test_stale_control_deadline_and_invalid_sample_cut_native_events (tools.test_engine.EngineTests.test_stale_control_deadline_and_invalid_sample_cut_native_events) ... ok
test_stored_tune_revision_and_restart (tools.test_engine.EngineTests.test_stored_tune_revision_and_restart) ... ok
test_tuner_and_http_writers_conflict_instead_of_overwriting (tools.test_engine.EngineTests.test_tuner_and_http_writers_conflict_instead_of_overwriting) ... ok
test_tuning_snapshot_stays_pinned_and_revision_is_read_only (tools.test_engine.EngineTests.test_tuning_snapshot_stays_pinned_and_revision_is_read_only) ... ok
test_unconfirmed_or_stale_inputs_inhibit_proposals (tools.test_engine.EngineTests.test_unconfirmed_or_stale_inputs_inhibit_proposals) ... ok
test_warm_and_cold_closed_loop_start_on_generated_teeth (tools.test_engine.EngineTests.test_warm_and_cold_closed_loop_start_on_generated_teeth) ... ok
test_zero_fuel_tune_cannot_make_the_plant_run (tools.test_engine.EngineTests.test_zero_fuel_tune_cannot_make_the_plant_run) ... ok
test_engine_http_auth_schema_and_revision (tools.test_engine_http.IntegrationTests.test_engine_http_auth_schema_and_revision) ... ok
test_http_run_and_log_are_historical_and_tuning_snapshot_identifies_them (tools.test_engine_http.IntegrationTests.test_http_run_and_log_are_historical_and_tuning_snapshot_identifies_them) ... ok
test_pty_fragments_and_crc_rejection (tools.test_engine_http.IntegrationTests.test_pty_fragments_and_crc_rejection) ... ok
test_real_tcp_burn_updates_http_and_http_edit_requires_reconnect (tools.test_engine_http.IntegrationTests.test_real_tcp_burn_updates_http_and_http_edit_requires_reconnect) ... ok

----------------------------------------------------------------------
Ran 53 tests in 10.145s

OK
