markthebault/esp32-ecu/reports/engine/trigger-logging/speeduino-runtime-tests.txt

test_bad_input_channel_rejected_before_mutating_live_child (tools.test_speeduino_runtime.ProductionSpeeduinoAcceptance.test_bad_input_channel_rejected_before_mutating_live_child) ... ok
test_constant_speed_sync_edges_and_repeatability (tools.test_speeduino_runtime.ProductionSpeeduinoAcceptance.test_constant_speed_sync_edges_and_repeatability) ... ok
test_enabled_fixed_hard_limit_cuts_real_schedulers (tools.test_speeduino_runtime.ProductionSpeeduinoAcceptance.test_enabled_fixed_hard_limit_cuts_real_schedulers) ... ok
test_halt_closes_actually_high_injectors_and_coils (tools.test_speeduino_runtime.ProductionSpeeduinoAcceptance.test_halt_closes_actually_high_injectors_and_coils) ... ok
test_invalid_native_clock_is_bounded (tools.test_speeduino_runtime.ProductionSpeeduinoAcceptance.test_invalid_native_clock_is_bounded) ... ok

----------------------------------------------------------------------
Ran 5 tests in 0.948s

OK
