markthebault/esp32-ecu/reports/engine/trigger-logging/trigger-api-tests.txt

test_invalid_and_prearm_inputs_do_not_contaminate_frozen_frame (tools.test_trigger_capture.RecorderTests.test_invalid_and_prearm_inputs_do_not_contaminate_frozen_frame) ... ok
test_parser_bounds_duplicates_and_foreign_commands (tools.test_trigger_capture.RecorderTests.test_parser_bounds_duplicates_and_foreign_commands) ... ok
test_rearm_discards_stale_pages_and_does_not_stop_current_frame (tools.test_trigger_capture.RecorderTests.test_rearm_discards_stale_pages_and_does_not_stop_current_frame) ... ok
test_auth_envelopes_no_result_and_script_route (tools.test_trigger_capture.TriggerHTTPTests.test_auth_envelopes_no_result_and_script_route) ... ok
test_completed_frame_retains_its_source_revision_after_tune_change (tools.test_trigger_capture.TriggerHTTPTests.test_completed_frame_retains_its_source_revision_after_tune_change) ... ok
test_paged_synthetic_capture_and_stale_writer (tools.test_trigger_capture.TriggerHTTPTests.test_paged_synthetic_capture_and_stale_writer) ... ok

----------------------------------------------------------------------
Ran 6 tests in 1.803s

OK
