markthebault/esp32-ecu/reports/engine/flex-integration/browser/tuning/tuning-desktop.png

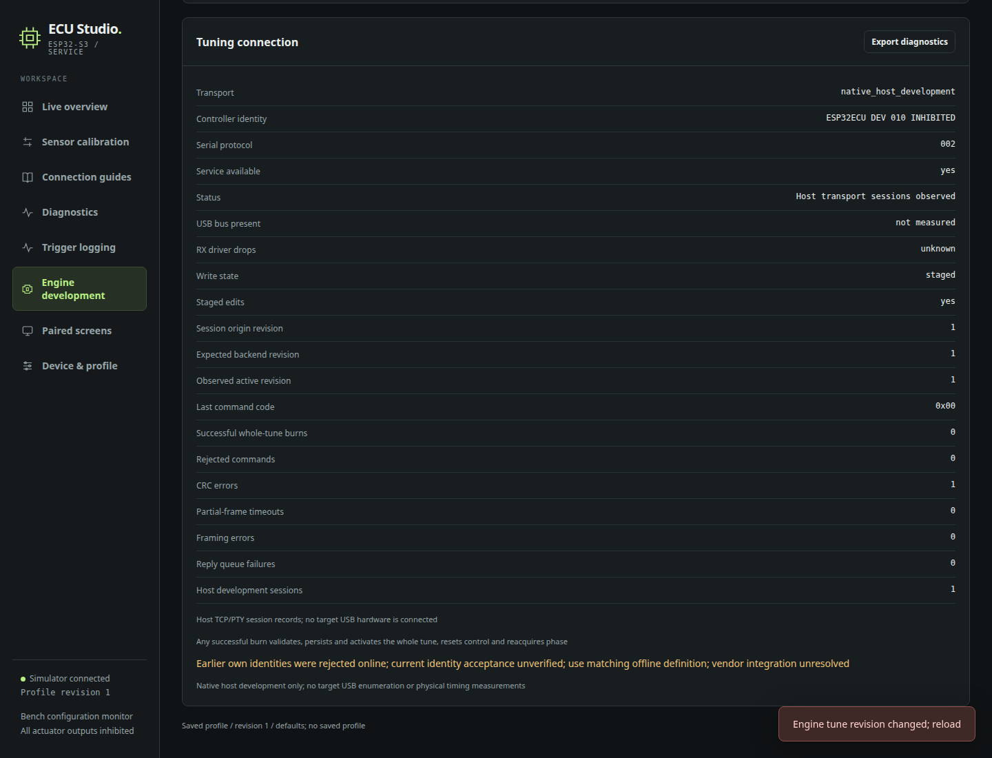
reports/engine/flex-integration/browser/tuning/tuning-desktop.png
