markthebault/esp32-ecu/reports/engine/sensor-ratiometric/calibration-desktop.png

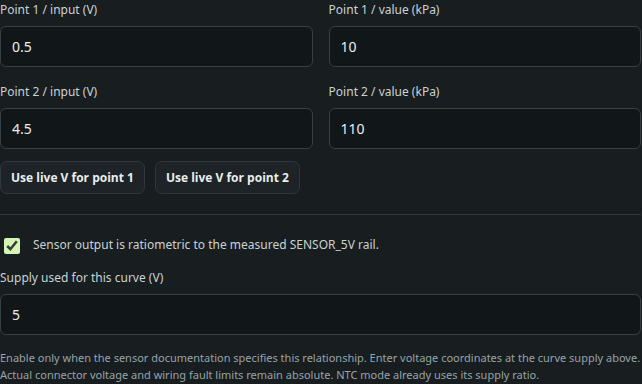
reports/engine/sensor-ratiometric/calibration-desktop.png
