markthebault/esp32-ecu/reports/engine/sensor-ratiometric/calibration-mobile.png

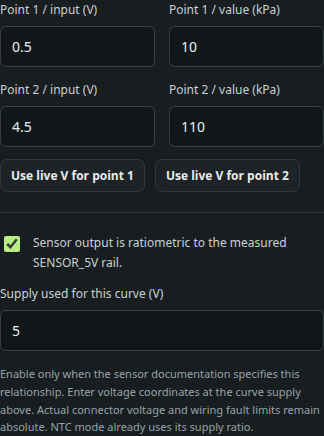
reports/engine/sensor-ratiometric/calibration-mobile.png
