markthebault/esp32-ecu/reports/engine/tuning-online-009/reference/screen.png

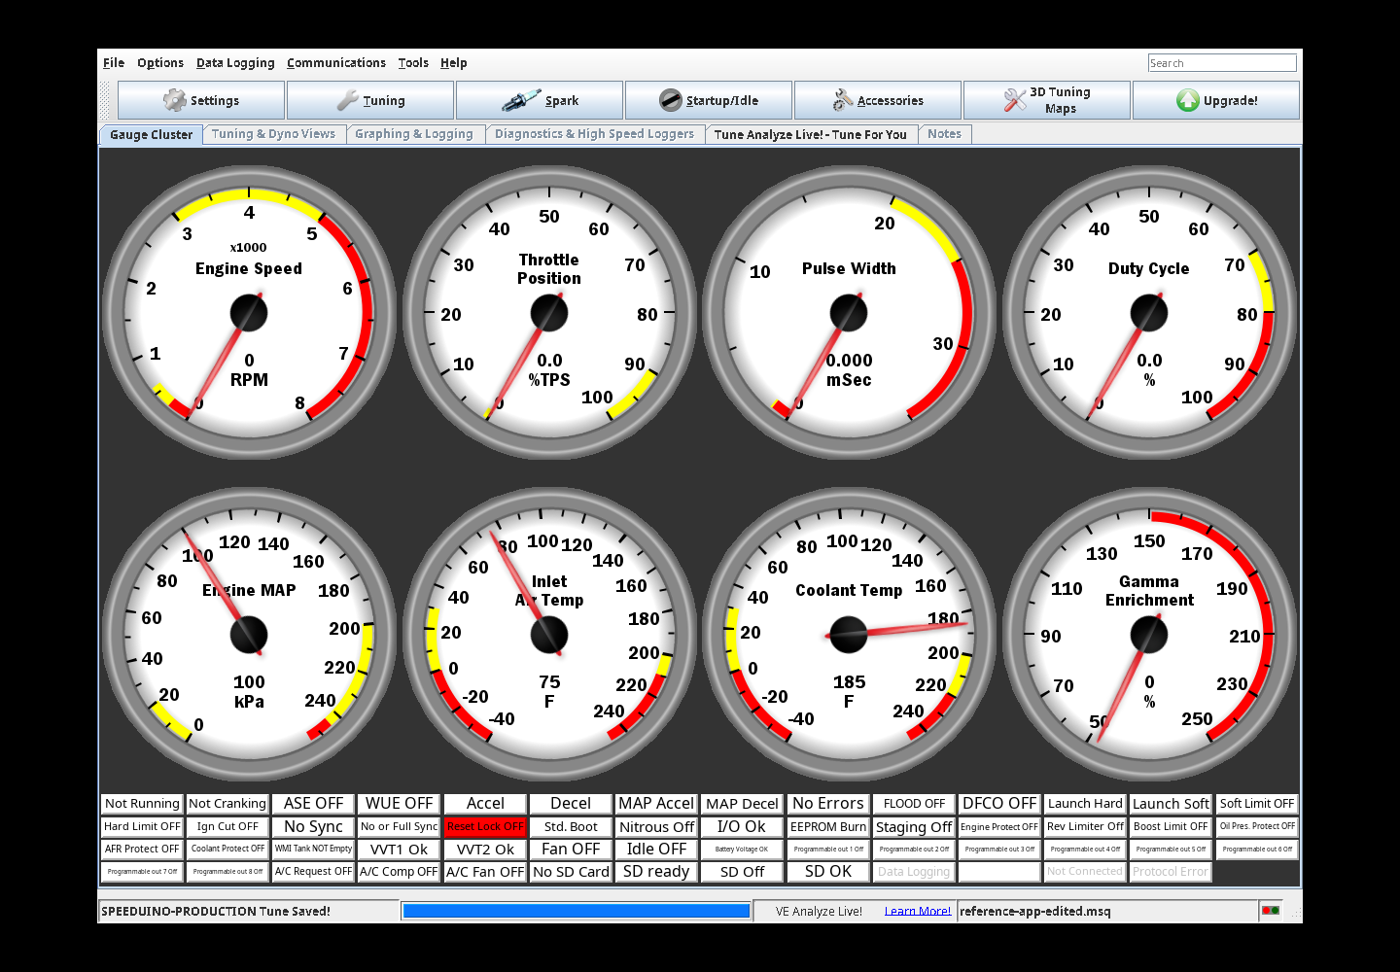
reports/engine/tuning-online-009/reference/screen.png
