markthebault/esp32-ecu/reports/engine/tuning-online-009/reference/ve-edited-burned.png

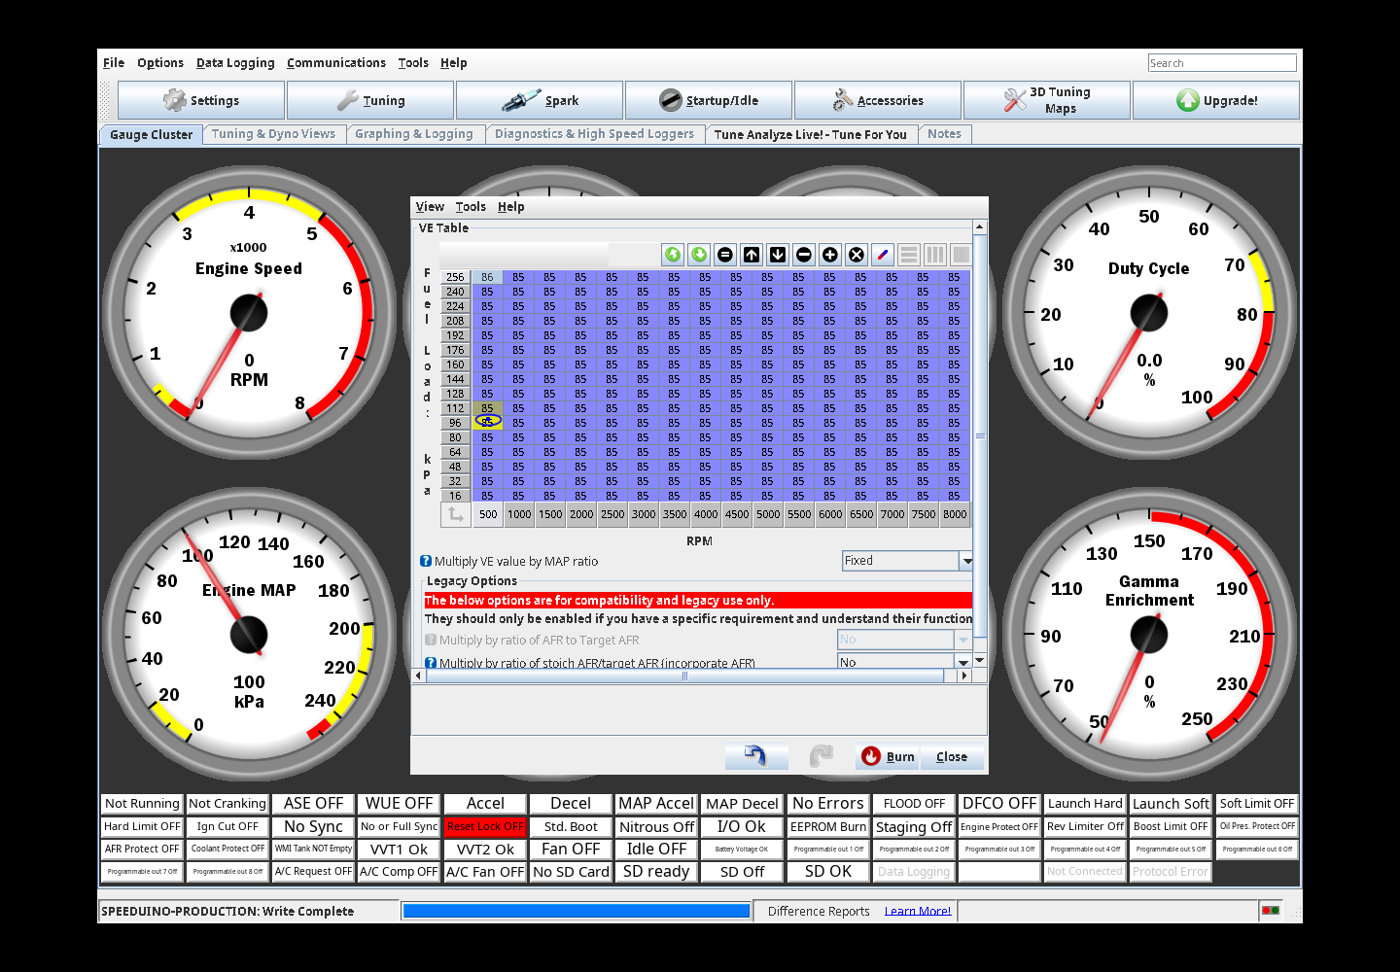
reports/engine/tuning-online-009/reference/ve-edited-burned.png
