markthebault/esp32-ecu/reports/engine/flex-integration/applications/tunerstudio-debug.txt

Starting on mark-minipc-linux
TunerStudio 3.3.01 started on Wed Nov 04 19:43:09 CET 2026
JRE 21.0.12.1, Linux 7.0.0-42-generic, amd64
java.library.path=lib/alternateLinuxDrivers/x86_64-linux:lib
TunerStudioMS.jar
java.lang.reflect.InaccessibleObjectException: Unable to make field private static java.nio.charset.Charset java.nio.charset.Charset.defaultCharset accessible: module java.base does not "opens java.nio.charset" to unnamed module @68837a77
	at java.base/java.lang.reflect.AccessibleObject.throwInaccessibleObjectException(AccessibleObject.java:391)
	at java.base/java.lang.reflect.AccessibleObject.checkCanSetAccessible(AccessibleObject.java:367)
	at java.base/java.lang.reflect.AccessibleObject.checkCanSetAccessible(AccessibleObject.java:315)
	at java.base/java.lang.reflect.Field.checkCanSetAccessible(Field.java:183)
	at java.base/java.lang.reflect.Field.setAccessible(Field.java:177)
	at TunerStudio.main(Unknown Source)
Look:Metal, ClassName:'javax.swing.plaf.metal.MetalLookAndFeel'
Look:Nimbus, ClassName:'javax.swing.plaf.nimbus.NimbusLookAndFeel'
Look:CDE/Motif, ClassName:'com.sun.java.swing.plaf.motif.MotifLookAndFeel'
Look:GTK+, ClassName:'com.sun.java.swing.plaf.gtk.GTKLookAndFeel'
Look:Night Shade, ClassName:'de.muntjak.tinylookandfeel.TinyLookAndFeel'
Setting Look & Feel to:javax.swing.plaf.metal.MetalLookAndFeel
ScrollBar.width
11/4/26, 7:43:09 PM :Debug: no update:defaultFont
11/4/26, 7:43:09 PM :Info: write to reg file
11/4/26, 7:43:09 PM :Info: wrote to reg file
11/4/26, 7:43:09 PM :Info: Initializing File Dialogs.
11/4/26, 7:43:09 PM :Info: One time setup, Copying Default Projects and components..
11/4/26, 7:43:09 PM :Info: Expanding Zip File: /home/mark/persospace/esp32-ecu/.cache/engine/flex-integration/applications/ts/app/Projects/MS3-Example_Project.zip, to dir: /home/mark/persospace/esp32-ecu/.cache/engine/flex-integration/applications/ts/user/TunerStudioProjects
11/4/26, 7:43:10 PM :Info: Expanding Zip File: /home/mark/persospace/esp32-ecu/.cache/engine/flex-integration/applications/ts/app/Projects/MS2-Extra-Example.zip, to dir: /home/mark/persospace/esp32-ecu/.cache/engine/flex-integration/applications/ts/user/TunerStudioProjects
11/4/26, 7:43:10 PM :Info: Expanding Zip File: /home/mark/persospace/esp32-ecu/.cache/engine/flex-integration/applications/ts/app/Projects/MS1_Extra_Example.zip, to dir: /home/mark/persospace/esp32-ecu/.cache/engine/flex-integration/applications/ts/user/TunerStudioProjects
11/4/26, 7:43:11 PM :Info: Expanding Zip File: /home/mark/persospace/esp32-ecu/.cache/engine/flex-integration/applications/ts/app/Projects/MSII_BG_2.905_Example.zip, to dir: /home/mark/persospace/esp32-ecu/.cache/engine/flex-integration/applications/ts/user/TunerStudioProjects
11/4/26, 7:43:11 PM :Info: Expanding Zip File: /home/mark/persospace/esp32-ecu/.cache/engine/flex-integration/applications/ts/app/Projects/MS1_BG_3.0.zip, to dir: /home/mark/persospace/esp32-ecu/.cache/engine/flex-integration/applications/ts/user/TunerStudioProjects
Registration file not found. 
11/4/26, 7:43:12 PM :Info: Loading Language Content.
11/4/26, 7:43:12 PM :Info: Finishing Upgrade....
11/4/26, 7:43:12 PM :Debug: Delete Results startScreenRoot true
Saved user properties successfully
11/4/26, 7:43:12 PM :Debug: Command Non-VolatileBytes for F resolved to: x46                                                                   F
11/4/26, 7:43:12 PM :Debug: Command Non-VolatileBytes for I resolved to: x49                                                                   I
11/4/26, 7:43:12 PM :Debug: Command Non-VolatileBytes for f resolved to: x66                                                                   f
11/4/26, 7:43:12 PM :Info: Initializing Help.
11/4/26, 7:43:12 PM :Info: Initializing Edition Features.
11/4/26, 7:43:12 PM :Info: Initializing App Events.
11/4/26, 7:43:12 PM :Debug: App Name:TunerStudio, appEdition:MS Lite!
11/4/26, 7:43:12 PM :Debug: Dummy Function Factory Created.
11/4/26, 7:43:12 PM :Info: Initializing User Interface
arg found 0:/home/mark/persospace/esp32-ecu/.cache/engine/flex-integration/applications/ts/ESP32ECU-FLEX-010
11/4/26, 7:43:12 PM :Info: Checking for updates
11/4/26, 7:43:14 PM :Info: Loading Font list.
11/4/26, 7:43:14 PM :Debug: Time to retreive font name list: 1 ms.
11/4/26, 7:43:14 PM :Info: 
11/4/26, 7:43:14 PM :Info: Initializing UI Components.
11/4/26, 7:43:14 PM :Info: Ready
11/4/26, 7:43:15 PM :Debug: Running speed test
11/4/26, 7:43:16 PM :Debug: Processor Score:6529892
11/4/26, 7:43:16 PM :Info: Internet detected, doing update check: IncUpdate
11/4/26, 7:43:17 PM :Info: Download of: ms2ReferenceTables.ini, succeeded! File size: 6598 bytes
11/4/26, 7:43:17 PM :Info: IncUpdate: Update to 0.02
Saved user properties successfully
11/4/26, 7:43:17 PM :Info: Update Check Completed
Saved user properties successfully
11/4/26, 7:43:17 PM :Debug: Saved user log settings.
11/4/26, 7:43:18 PM :Info: IniUpdate: No updates available.
Saved user properties successfully
11/4/26, 7:43:23 PM :Debug: Delete Results prepped_index.html true
11/4/26, 7:43:23 PM :Debug: Delete Results doubleSweep-400pi.png true
11/4/26, 7:43:23 PM :Debug: Delete Results Histogram-250px.png true
11/4/26, 7:43:23 PM :Debug: Delete Results whatsNew.jpg true
11/4/26, 7:43:23 PM :Debug: Delete Results images true
11/4/26, 7:43:23 PM :Debug: Delete Results addInfo.properties true
11/4/26, 7:43:23 PM :Debug: Delete Results index.html true
11/4/26, 7:43:23 PM :Debug: Delete Results index1.html true
11/4/26, 7:43:23 PM :Debug: Delete Results ad true
11/4/26, 7:43:35 PM :Info: Download of: ad.zip, succeeded! File size: 152588 bytes
11/4/26, 7:43:35 PM :Info: Updating Start Screen.
11/4/26, 7:43:35 PM :Info: Expanding Zip File: /home/mark/persospace/esp32-ecu/.cache/engine/flex-integration/applications/ts/user/.efiAnalytics/TunerStudio/startScreenRoot/ad/ad.zip, to dir: /home/mark/persospace/esp32-ecu/.cache/engine/flex-integration/applications/ts/user/.efiAnalytics/TunerStudio/startScreenRoot/ad
11/4/26, 7:43:35 PM :Info: Updated Start Screen: MSad
Saved user properties successfully
MSad: No check, last update check=Wed Nov 04 19:43:35 CET 2026
11/4/26, 7:44:40 PM :Debug: Directory Changed:
	Old:/home/mark/persospace/esp32-ecu/.cache/engine/flex-integration/applications/ts/user
	New:/home/mark/persospace/esp32-ecu/.cache/engine/flex-integration/applications/ts/user/TunerStudioProjects
11/4/26, 7:45:04 PM :Debug: Directory Changed:
	Old:/home/mark/persospace/esp32-ecu/.cache/engine/flex-integration/applications/ts/user/TunerStudioProjects
	New:/home/mark/persospace/esp32-ecu/.cache/engine/flex-integration/applications/ts
11/4/26, 7:45:04 PM :Debug: File Changed:
	Old:null
	New:/home/mark/persospace/esp32-ecu/.cache/engine/flex-integration/applications/ts/ESP32ECU-FLEX-010
11/4/26, 7:45:04 PM :Info: Opening Project ...
11/4/26, 7:45:04 PM :Debug: Opening project: /home/mark/persospace/esp32-ecu/.cache/engine/flex-integration/applications/ts/ESP32ECU-FLEX-010
11/4/26, 7:45:04 PM :Debug: Reading translation file as plain text
11/4/26, 7:45:04 PM :Info: Supported iniSpecVersion=3.79
11/4/26, 7:45:04 PM :Debug: Filtered ConfigurationOptionGroup in 2ms.
11/4/26, 7:45:04 PM :Info: Supported iniSpecVersion=3.79
11/4/26, 7:45:04 PM :Info: Read file canPcVariables.ini: 0.118517ms
11/4/26, 7:45:04 PM :Info: Filtered ini: 0.015708ms
11/4/26, 7:45:04 PM :Info: No iniVersion defined
11/4/26, 7:45:04 PM :Info: Loading Trigger Wheels
11/4/26, 7:45:04 PM :Info: Loaded All known ini sections
11/4/26, 7:45:04 PM :Info: Parsed and validated ini "canPcVariables.ini" in : 6ms.
11/4/26, 7:45:04 PM :Info: Read file mainController.ini: 0.611679ms
11/4/26, 7:45:04 PM :Info: Filtered ini: 0.243676ms
11/4/26, 7:45:04 PM :Info: No iniVersion defined
11/4/26, 7:45:04 PM :Debug: ini signature: ESP32ECU DEV 010 INHIBITED
11/4/26, 7:45:04 PM :Info: Loading Trigger Wheels
11/4/26, 7:45:04 PM :Info: Loaded All known ini sections
11/4/26, 7:45:04 PM :Info: Parsed and validated ini "mainController.ini" in : 17ms.
11/4/26, 7:45:04 PM :Info: Not Loading default Tools because non are defined for signature: ESP32ECU DEV 010 INHIBITED
11/4/26, 7:45:04 PM :Info: Time to load primary config: 40.683533ms. used cached config: false
SLF4J: Failed to load class "org.slf4j.impl.StaticLoggerBinder".
SLF4J: Defaulting to no-operation (NOP) logger implementation
SLF4J: See http://www.slf4j.org/codes.html#StaticLoggerBinder for further details.
11/4/26, 7:45:04 PM :Debug: set baud to 115200
11/4/26, 7:45:04 PM :Info: Setting connection to: RS232: Port:/tmp/ecu-flex-offline-no-device, Baud:115200
11/4/26, 7:45:04 PM :Debug: Adding Configuration: ESP32ECU-FLEX-010
11/4/26, 7:45:04 PM :Debug: Fill Constants: 4
11/4/26, 7:45:04 PM :Info: Tune opened, 0 bytes updated. File:/home/mark/persospace/esp32-ecu/.cache/engine/flex-integration/applications/ts/ESP32ECU-FLEX-010/CurrentTune.msq
[Duplicate entry] received 2 times: Info: Tune opened, 0 bytes updated. File:/home/mark/persospace/esp32-ecu/.cache/engine/flex-integration/applications/ts/ESP32ECU-FLEX-010/CurrentTune.msq
11/4/26, 7:45:04 PM :Info: dirtyData.size(): 0
[Duplicate entry] received 2 times: Info: dirtyData.size(): 0
11/4/26, 7:45:04 PM :Debug: Flush lasted: 70ms.
11/4/26, 7:45:04 PM :Info: dirtyData.size(): 0
[Duplicate entry] received 2 times: Info: dirtyData.size(): 0
11/4/26, 7:45:04 PM :Debug: Flush lasted: 70ms.
11/4/26, 7:45:04 PM :Debug: Skip Burn, last write page: -2
11/4/26, 7:45:04 PM :Info: !!! Loaded config in 236
11/4/26, 7:45:04 PM :Info: !!! Activated Project 304
11/4/26, 7:45:04 PM :Info: Opening Gauge Cluster..
11/4/26, 7:45:04 PM :Debug: High Speed Paint: true
11/4/26, 7:45:04 PM :Info: 
11/4/26, 7:45:04 PM :Info: Com Thread created: COMM Thread61563.92552424211
11/4/26, 7:45:04 PM :Info: endModalBlock called, but Root Pane is not a ProgressPane.
11/4/26, 7:45:04 PM :Info: Comm Manager for ESP32ECU-FLEX-010 Started, thread ID: COMM Thread61563.92552424211
11/4/26, 7:45:04 PM :Debug: !!! Opened Dash 356
11/4/26, 7:45:04 PM :Info: Connecting to controller on: RS232: Port:/tmp/ecu-flex-offline-no-device, Baud:115200
11/4/26, 7:45:04 PM :Info: ESP32ECU-FLEX-010 Ready
11/4/26, 7:45:04 PM :Debug: Port not valid: Unable to open port: /tmp/ecu-flex-offline-no-device
Please check your Communications Settings. 
11/4/26, 7:45:04 PM :Debug: Tuning View Files loaded in 19.93188ms.
11/4/26, 7:45:05 PM :Info: No Persistor set, not activating persisted triggers.
11/4/26, 7:46:55 PM :Info: Initiating read page 1 : 7808:40
11/4/26, 7:47:45 PM :Info: dirtyData.size(): 0
[Duplicate entry] received 2 times: Info: dirtyData.size(): 0
11/4/26, 7:47:45 PM :Debug: Flush lasted: 70ms.
11/4/26, 7:47:45 PM :Debug: Skip Burn, last write page: -2
11/4/26, 7:50:39 PM :Debug: File Not Found for signature: /home/mark/persospace/esp32-ecu/.cache/engine/flex-integration/applications/ts/ESP32ECU-FLEX-010/application-edited010.msq
11/4/26, 7:50:39 PM :Debug: EcuConfigName for Save:ESP32ECU-FLEX-010
11/4/26, 7:50:39 PM :Info: file:application-edited010.msq is not Monitored, cannot pause Monitoring of it.
11/4/26, 7:50:39 PM :Debug: File does not exist, creating new:
/home/mark/persospace/esp32-ecu/.cache/engine/flex-integration/applications/ts/ESP32ECU-FLEX-010/application-edited010.msq
11/4/26, 7:50:39 PM :Info: Time to save msq: 53.773335
11/4/26, 7:50:39 PM :Info: ESP32ECU-FLEX-010 Tune Saved!
11/4/26, 7:50:39 PM :Info: file:application-edited010.msq is not Monitored, cannot unpause Monitoring of it.
11/4/26, 7:53:45 PM :Info: Initiating read page 1 : 7808:40
11/4/26, 7:57:06 PM :Info: dirtyData.size(): 0
[Duplicate entry] received 2 times: Info: dirtyData.size(): 0
11/4/26, 7:57:06 PM :Debug: Flush lasted: 71ms.
11/4/26, 7:57:06 PM :Debug: Skip Burn, last write page: -2
11/4/26, 7:58:02 PM :Debug: File Not Found for signature: /home/mark/persospace/esp32-ecu/.cache/engine/flex-integration/applications/ts/ESP32ECU-FLEX-010/application-edited010-002.msq
11/4/26, 7:58:02 PM :Debug: EcuConfigName for Save:ESP32ECU-FLEX-010
11/4/26, 7:58:02 PM :Info: file:application-edited010-002.msq is not Monitored, cannot pause Monitoring of it.
11/4/26, 7:58:02 PM :Debug: File does not exist, creating new:
/home/mark/persospace/esp32-ecu/.cache/engine/flex-integration/applications/ts/ESP32ECU-FLEX-010/application-edited010-002.msq
11/4/26, 7:58:02 PM :Info: Time to save msq: 15.075908
11/4/26, 7:58:02 PM :Info: ESP32ECU-FLEX-010 Tune Saved!
11/4/26, 7:58:02 PM :Info: file:application-edited010-002.msq is not Monitored, cannot unpause Monitoring of it.
11/4/26, 7:58:51 PM :Info: Initiating read page 1 : 7808:40
11/4/26, 8:00:07 PM :Info: dirtyData.size(): 0
[Duplicate entry] received 2 times: Info: dirtyData.size(): 0
11/4/26, 8:00:07 PM :Debug: Flush lasted: 71ms.
11/4/26, 8:00:07 PM :Debug: Skip Burn, last write page: -2
11/4/26, 8:00:52 PM :Info: dirtyData.size(): 0
[Duplicate entry] received 2 times: Info: dirtyData.size(): 0
11/4/26, 8:00:52 PM :Debug: Flush lasted: 71ms.
11/4/26, 8:00:52 PM :Debug: Skip Burn, last write page: -2
11/4/26, 8:01:53 PM :Debug: File Not Found for signature: /home/mark/persospace/esp32-ecu/.cache/engine/flex-integration/applications/ts/ESP32ECU-FLEX-010/application-edited010-003.msq
11/4/26, 8:01:53 PM :Debug: EcuConfigName for Save:ESP32ECU-FLEX-010
11/4/26, 8:01:53 PM :Info: file:application-edited010-003.msq is not Monitored, cannot pause Monitoring of it.
11/4/26, 8:01:53 PM :Debug: File does not exist, creating new:
/home/mark/persospace/esp32-ecu/.cache/engine/flex-integration/applications/ts/ESP32ECU-FLEX-010/application-edited010-003.msq
11/4/26, 8:01:53 PM :Info: Time to save msq: 9.559658
11/4/26, 8:01:53 PM :Info: ESP32ECU-FLEX-010 Tune Saved!
11/4/26, 8:01:53 PM :Info: file:application-edited010-003.msq is not Monitored, cannot unpause Monitoring of it.
11/4/26, 8:02:35 PM :Debug: ############################################# Save Project Backup ##########################################
11/4/26, 8:02:35 PM :Debug: TuneLog Editor set text
11/4/26, 8:02:35 PM :Info: file:CurrentTune.msq is not Monitored, cannot pause Monitoring of it.
11/4/26, 8:02:35 PM :Info: Time to save msq: 6.218406
11/4/26, 8:02:35 PM :Info: file:CurrentTune.msq is not Monitored, cannot unpause Monitoring of it.
11/4/26, 8:02:35 PM :Debug: goOffline Starting, Time:0
11/4/26, 8:02:35 PM :Info: Deactivated Turbo Baud, goOffline
11/4/26, 8:02:35 PM :Debug: goOffline about to stopProcessing, Time:0
11/4/26, 8:02:35 PM :Debug: goOffline closed port, Time:0
11/4/26, 8:02:35 PM :Info: ESP32ECU-FLEX-010 ComThread stopped COMM Thread61563.92552424211
11/4/26, 8:02:35 PM :Debug: goOffline comm thread stopped, Time:151
11/4/26, 8:02:35 PM :Debug: No Remaining Queue Write instructions
11/4/26, 8:02:35 PM :Debug: removing Configuration: ESP32ECU-FLEX-010
11/4/26, 8:02:35 PM :Info: No Persistor set, not saving active triggers.
11/4/26, 8:02:35 PM :Debug: ############################################# Save Project Backup ##########################################
Saved user properties successfully
11/4/26, 8:02:35 PM :Debug: Saved user log settings.
