markthebault/esp32-ecu/reports/engine/secondary-integration/applications/ts/TunerStudioAppDebug.txt

Starting on mark-minipc-linux
TunerStudio 3.3.01 started on Wed Nov 04 11:29:40 CET 2026
JRE 21.0.12.1, Linux 7.0.0-42-generic, amd64
java.library.path=lib/alternateLinuxDrivers/x86_64-linux:lib
TunerStudioMS.jar
java.lang.reflect.InaccessibleObjectException: Unable to make field private static java.nio.charset.Charset java.nio.charset.Charset.defaultCharset accessible: module java.base does not "opens java.nio.charset" to unnamed module @68837a77
	at java.base/java.lang.reflect.AccessibleObject.throwInaccessibleObjectException(AccessibleObject.java:391)
	at java.base/java.lang.reflect.AccessibleObject.checkCanSetAccessible(AccessibleObject.java:367)
	at java.base/java.lang.reflect.AccessibleObject.checkCanSetAccessible(AccessibleObject.java:315)
	at java.base/java.lang.reflect.Field.checkCanSetAccessible(Field.java:183)
	at java.base/java.lang.reflect.Field.setAccessible(Field.java:177)
	at TunerStudio.main(Unknown Source)
Look:Metal, ClassName:'javax.swing.plaf.metal.MetalLookAndFeel'
Look:Nimbus, ClassName:'javax.swing.plaf.nimbus.NimbusLookAndFeel'
Look:CDE/Motif, ClassName:'com.sun.java.swing.plaf.motif.MotifLookAndFeel'
Look:GTK+, ClassName:'com.sun.java.swing.plaf.gtk.GTKLookAndFeel'
Look:Night Shade, ClassName:'de.muntjak.tinylookandfeel.TinyLookAndFeel'
Setting Look & Feel to:javax.swing.plaf.metal.MetalLookAndFeel
ScrollBar.width
11/4/26, 11:29:40 AM :Debug: no update:defaultFont
11/4/26, 11:29:40 AM :Info: write to reg file
11/4/26, 11:29:40 AM :Info: wrote to reg file
11/4/26, 11:29:40 AM :Info: Initializing File Dialogs.
11/4/26, 11:29:40 AM :Info: One time setup, Copying Default Projects and components..
11/4/26, 11:29:40 AM :Info: Expanding Zip File: /home/mark/persospace/esp32-ecu/.cache/engine/secondary-integration/ts-accepted/app/Projects/MS3-Example_Project.zip, to dir: /home/mark/persospace/esp32-ecu/.cache/engine/secondary-integration/ts-accepted/user/TunerStudioProjects
11/4/26, 11:29:41 AM :Info: Expanding Zip File: /home/mark/persospace/esp32-ecu/.cache/engine/secondary-integration/ts-accepted/app/Projects/MS2-Extra-Example.zip, to dir: /home/mark/persospace/esp32-ecu/.cache/engine/secondary-integration/ts-accepted/user/TunerStudioProjects
11/4/26, 11:29:41 AM :Info: Expanding Zip File: /home/mark/persospace/esp32-ecu/.cache/engine/secondary-integration/ts-accepted/app/Projects/MS1_Extra_Example.zip, to dir: /home/mark/persospace/esp32-ecu/.cache/engine/secondary-integration/ts-accepted/user/TunerStudioProjects
11/4/26, 11:29:42 AM :Info: Expanding Zip File: /home/mark/persospace/esp32-ecu/.cache/engine/secondary-integration/ts-accepted/app/Projects/MSII_BG_2.905_Example.zip, to dir: /home/mark/persospace/esp32-ecu/.cache/engine/secondary-integration/ts-accepted/user/TunerStudioProjects
11/4/26, 11:29:42 AM :Info: Expanding Zip File: /home/mark/persospace/esp32-ecu/.cache/engine/secondary-integration/ts-accepted/app/Projects/MS1_BG_3.0.zip, to dir: /home/mark/persospace/esp32-ecu/.cache/engine/secondary-integration/ts-accepted/user/TunerStudioProjects
Registration file not found. 
11/4/26, 11:29:43 AM :Info: Loading Language Content.
11/4/26, 11:29:43 AM :Info: Finishing Upgrade....
11/4/26, 11:29:43 AM :Debug: Delete Results startScreenRoot true
Saved user properties successfully
11/4/26, 11:29:43 AM :Debug: Command Non-VolatileBytes for F resolved to: x46                                                                   F
11/4/26, 11:29:43 AM :Debug: Command Non-VolatileBytes for I resolved to: x49                                                                   I
11/4/26, 11:29:43 AM :Debug: Command Non-VolatileBytes for f resolved to: x66                                                                   f
11/4/26, 11:29:43 AM :Info: Initializing Help.
11/4/26, 11:29:43 AM :Info: Initializing Edition Features.
11/4/26, 11:29:43 AM :Info: Initializing App Events.
11/4/26, 11:29:43 AM :Debug: App Name:TunerStudio, appEdition:MS Lite!
11/4/26, 11:29:43 AM :Debug: Dummy Function Factory Created.
11/4/26, 11:29:43 AM :Info: Initializing User Interface
arg found 0:/home/mark/persospace/esp32-ecu/.cache/engine/secondary-integration/ts-accepted/ESP32ECU-SECONDARY-009
11/4/26, 11:29:43 AM :Info: Checking for updates
11/4/26, 11:29:45 AM :Info: Loading Font list.
11/4/26, 11:29:45 AM :Debug: Time to retreive font name list: 1 ms.
11/4/26, 11:29:45 AM :Info: 
11/4/26, 11:29:45 AM :Info: Initializing UI Components.
11/4/26, 11:29:45 AM :Info: Ready
11/4/26, 11:29:46 AM :Debug: Running speed test
11/4/26, 11:29:46 AM :Info: Internet detected, doing update check: IncUpdate
11/4/26, 11:29:46 AM :Info: IniUpdate: No updates available.
11/4/26, 11:29:47 AM :Debug: Processor Score:6571285
Saved user properties successfully
Saved user properties successfully
11/4/26, 11:29:47 AM :Info: Update Check Completed
Saved user properties successfully
11/4/26, 11:29:47 AM :Debug: Saved user log settings.
11/4/26, 11:29:47 AM :Info: Download of: ms2ReferenceTables.ini, succeeded! File size: 6598 bytes
11/4/26, 11:29:47 AM :Info: IncUpdate: Update to 0.02
11/4/26, 11:29:50 AM :Debug: Delete Results prepped_index.html true
11/4/26, 11:29:50 AM :Debug: Delete Results doubleSweep-400pi.png true
11/4/26, 11:29:50 AM :Debug: Delete Results Histogram-250px.png true
11/4/26, 11:29:50 AM :Debug: Delete Results whatsNew.jpg true
11/4/26, 11:29:50 AM :Debug: Delete Results images true
11/4/26, 11:29:50 AM :Debug: Delete Results addInfo.properties true
11/4/26, 11:29:50 AM :Debug: Delete Results index.html true
11/4/26, 11:29:50 AM :Debug: Delete Results index1.html true
11/4/26, 11:29:50 AM :Debug: Delete Results ad true
11/4/26, 11:29:52 AM :Info: Download of: ad.zip, succeeded! File size: 152588 bytes
11/4/26, 11:29:52 AM :Info: Updating Start Screen.
11/4/26, 11:29:52 AM :Info: Expanding Zip File: /home/mark/persospace/esp32-ecu/.cache/engine/secondary-integration/ts-accepted/user/.efiAnalytics/TunerStudio/startScreenRoot/ad/ad.zip, to dir: /home/mark/persospace/esp32-ecu/.cache/engine/secondary-integration/ts-accepted/user/.efiAnalytics/TunerStudio/startScreenRoot/ad
11/4/26, 11:29:52 AM :Info: Updated Start Screen: MSad
Saved user properties successfully
MSad: No check, last update check=Wed Nov 04 11:29:52 CET 2026
11/4/26, 11:30:12 AM :Debug: Directory Changed:
	Old:/home/mark/persospace/esp32-ecu/.cache/engine/secondary-integration/ts-accepted/user
	New:/home/mark/persospace/esp32-ecu/.cache/engine/secondary-integration/ts-accepted/user/TunerStudioProjects
11/4/26, 11:30:15 AM :Debug: Directory Changed:
	Old:/home/mark/persospace/esp32-ecu/.cache/engine/secondary-integration/ts-accepted/user/TunerStudioProjects
	New:/home/mark/persospace/esp32-ecu/.cache/engine/secondary-integration/ts-accepted
11/4/26, 11:30:15 AM :Debug: File Changed:
	Old:null
	New:/home/mark/persospace/esp32-ecu/.cache/engine/secondary-integration/ts-accepted/ESP32ECU-SECONDARY-009
11/4/26, 11:30:15 AM :Info: Opening Project ...
11/4/26, 11:30:15 AM :Debug: Opening project: /home/mark/persospace/esp32-ecu/.cache/engine/secondary-integration/ts-accepted/ESP32ECU-SECONDARY-009
11/4/26, 11:30:15 AM :Debug: Reading translation file as plain text
11/4/26, 11:30:15 AM :Info: Supported iniSpecVersion=3.79
11/4/26, 11:30:15 AM :Debug: Filtered ConfigurationOptionGroup in 4ms.
11/4/26, 11:30:15 AM :Info: Supported iniSpecVersion=3.79
11/4/26, 11:30:15 AM :Info: Read file canPcVariables.ini: 0.301612ms
11/4/26, 11:30:15 AM :Info: Filtered ini: 0.062284ms
11/4/26, 11:30:15 AM :Info: No iniVersion defined
11/4/26, 11:30:15 AM :Info: Loading Trigger Wheels
11/4/26, 11:30:15 AM :Info: Loaded All known ini sections
11/4/26, 11:30:15 AM :Info: Parsed and validated ini "canPcVariables.ini" in : 15ms.
11/4/26, 11:30:15 AM :Info: Read file mainController.ini: 1.702424ms
11/4/26, 11:30:15 AM :Info: Filtered ini: 0.597723ms
11/4/26, 11:30:15 AM :Info: No iniVersion defined
11/4/26, 11:30:15 AM :Debug: ini signature: ESP32ECU DEV 009 INHIBITED
11/4/26, 11:30:15 AM :Info: Loading Trigger Wheels
11/4/26, 11:30:15 AM :Info: Loaded All known ini sections
11/4/26, 11:30:15 AM :Info: Parsed and validated ini "mainController.ini" in : 32ms.
11/4/26, 11:30:15 AM :Info: Not Loading default Tools because non are defined for signature: ESP32ECU DEV 009 INHIBITED
11/4/26, 11:30:15 AM :Info: Time to load primary config: 84.295685ms. used cached config: false
SLF4J: Failed to load class "org.slf4j.impl.StaticLoggerBinder".
SLF4J: Defaulting to no-operation (NOP) logger implementation
SLF4J: See http://www.slf4j.org/codes.html#StaticLoggerBinder for further details.
11/4/26, 11:30:15 AM :Debug: set baud to 115200
11/4/26, 11:30:15 AM :Info: Setting connection to: RS232: Port:/tmp/ecu-secondary-offline-no-device, Baud:115200
11/4/26, 11:30:15 AM :Debug: Adding Configuration: ESP32ECU-SECONDARY-009
11/4/26, 11:30:15 AM :Debug: Fill Constants: 6
11/4/26, 11:30:15 AM :Info: Tune opened, 0 bytes updated. File:/home/mark/persospace/esp32-ecu/.cache/engine/secondary-integration/ts-accepted/ESP32ECU-SECONDARY-009/CurrentTune.msq
[Duplicate entry] received 2 times: Info: Tune opened, 0 bytes updated. File:/home/mark/persospace/esp32-ecu/.cache/engine/secondary-integration/ts-accepted/ESP32ECU-SECONDARY-009/CurrentTune.msq
11/4/26, 11:30:15 AM :Info: dirtyData.size(): 0
[Duplicate entry] received 2 times: Info: dirtyData.size(): 0
11/4/26, 11:30:15 AM :Debug: Flush lasted: 70ms.
11/4/26, 11:30:15 AM :Info: dirtyData.size(): 0
[Duplicate entry] received 2 times: Info: dirtyData.size(): 0
11/4/26, 11:30:15 AM :Debug: Flush lasted: 70ms.
11/4/26, 11:30:15 AM :Debug: Skip Burn, last write page: -2
11/4/26, 11:30:15 AM :Info: !!! Loaded config in 314
11/4/26, 11:30:15 AM :Info: !!! Activated Project 412
11/4/26, 11:30:15 AM :Info: Opening Gauge Cluster..
11/4/26, 11:30:15 AM :Debug: High Speed Paint: true
11/4/26, 11:30:15 AM :Info: 
11/4/26, 11:30:15 AM :Info: Com Thread created: COMM Thread33066.53036391242
11/4/26, 11:30:15 AM :Info: endModalBlock called, but Root Pane is not a ProgressPane.
11/4/26, 11:30:15 AM :Info: Comm Manager for ESP32ECU-SECONDARY-009 Started, thread ID: COMM Thread33066.53036391242
11/4/26, 11:30:15 AM :Debug: !!! Opened Dash 481
11/4/26, 11:30:15 AM :Info: Connecting to controller on: RS232: Port:/tmp/ecu-secondary-offline-no-device, Baud:115200
11/4/26, 11:30:15 AM :Info: ESP32ECU-SECONDARY-009 Ready
11/4/26, 11:30:15 AM :Debug: Port not valid: Unable to open port: /tmp/ecu-secondary-offline-no-device
Please check your Communications Settings. 
11/4/26, 11:30:15 AM :Debug: Tuning View Files loaded in 34.60386ms.
11/4/26, 11:30:16 AM :Info: No Persistor set, not activating persisted triggers.
11/4/26, 11:31:08 AM :Info: Initiating read page 1 : 5376:36
11/4/26, 11:31:28 AM :Info: Initiating read page 1 : 5412:36
11/4/26, 11:31:28 AM :Info: dirtyData.size(): 0
[Duplicate entry] received 2 times: Info: dirtyData.size(): 0
11/4/26, 11:31:28 AM :Debug: Flush lasted: 70ms.
11/4/26, 11:31:28 AM :Debug: Skip Burn, last write page: -2
11/4/26, 11:31:43 AM :Info: Initiating read page 1 : 5504:1152
11/4/26, 11:31:43 AM :Info: dirtyData.size(): 0
[Duplicate entry] received 2 times: Info: dirtyData.size(): 0
11/4/26, 11:31:43 AM :Debug: Flush lasted: 70ms.
11/4/26, 11:31:43 AM :Debug: Skip Burn, last write page: -2
11/4/26, 11:32:30 AM :Info: Initiating read page 1 : 6656:1152
11/4/26, 11:32:30 AM :Info: dirtyData.size(): 0
[Duplicate entry] received 2 times: Info: dirtyData.size(): 0
11/4/26, 11:32:30 AM :Debug: Flush lasted: 70ms.
11/4/26, 11:32:30 AM :Debug: Skip Burn, last write page: -2
11/4/26, 11:32:59 AM :Info: dirtyData.size(): 0
[Duplicate entry] received 2 times: Info: dirtyData.size(): 0
11/4/26, 11:32:59 AM :Debug: Flush lasted: 71ms.
11/4/26, 11:32:59 AM :Debug: Skip Burn, last write page: -2
11/4/26, 11:34:11 AM :Debug: File Not Found for signature: /home/mark/persospace/esp32-ecu/.cache/engine/secondary-integration/ts-accepted/secondary-app009.msq
11/4/26, 11:34:11 AM :Debug: EcuConfigName for Save:ESP32ECU-SECONDARY-009
11/4/26, 11:34:11 AM :Info: file:secondary-app009.msq is not Monitored, cannot pause Monitoring of it.
11/4/26, 11:34:11 AM :Debug: File does not exist, creating new:
/home/mark/persospace/esp32-ecu/.cache/engine/secondary-integration/ts-accepted/secondary-app009.msq
11/4/26, 11:34:11 AM :Info: Time to save msq: 23.817669
11/4/26, 11:34:11 AM :Info: ESP32ECU-SECONDARY-009 Tune Saved!
11/4/26, 11:34:11 AM :Info: file:secondary-app009.msq is not Monitored, cannot unpause Monitoring of it.
11/4/26, 11:35:20 AM :Debug: ############################################# Save Project Backup ##########################################
11/4/26, 11:35:20 AM :Debug: TuneLog Editor set text
11/4/26, 11:35:20 AM :Info: file:CurrentTune.msq is not Monitored, cannot pause Monitoring of it.
11/4/26, 11:35:20 AM :Info: Time to save msq: 6.867021
11/4/26, 11:35:20 AM :Info: file:CurrentTune.msq is not Monitored, cannot unpause Monitoring of it.
11/4/26, 11:35:20 AM :Debug: goOffline Starting, Time:0
11/4/26, 11:35:20 AM :Info: Deactivated Turbo Baud, goOffline
11/4/26, 11:35:20 AM :Debug: goOffline about to stopProcessing, Time:0
11/4/26, 11:35:20 AM :Debug: goOffline closed port, Time:0
11/4/26, 11:35:20 AM :Info: ESP32ECU-SECONDARY-009 ComThread stopped COMM Thread33066.53036391242
11/4/26, 11:35:20 AM :Debug: goOffline comm thread stopped, Time:50
11/4/26, 11:35:20 AM :Debug: No Remaining Queue Write instructions
11/4/26, 11:35:20 AM :Debug: removing Configuration: ESP32ECU-SECONDARY-009
11/4/26, 11:35:20 AM :Info: No Persistor set, not saving active triggers.
11/4/26, 11:35:20 AM :Debug: ############################################# Save Project Backup ##########################################
Saved user properties successfully
11/4/26, 11:35:20 AM :Debug: Saved user log settings.
