markthebault/esp32-ecu/reports/engine/secondary-plant/reviews/crank/coordinate-fix-working-browser-dom.html

# Independent secondary spark transition diagnostic probe

{"passed":true,"accepted":791,"rejected":1,"recordedRows":7,"mslColumns":188,"nativeBrowserMslParity":true,"exactU64":"18446744073709541615","failures":[]}

No target hardware measurement.

Hardware sourceunknown; acquisition diagnostics unavailable

Control sourceunknown; inspect the control observation below

Control observation, separate from editor values. SYNTHETIC control observation. Check source and sample age.

### Secondary fuel

Selectiondisabled

Source and stored cellsmap / absolute (%)

Primary / secondary / combined85.0000 / unknown / 85.0000

Coordinate (kPa)unknown

Conditionrpm unknown > 3000.0000

Input sourceunavailable

Raw / qualified levelunknown / unknown

Input age / observed timeunknown ms / unknown

Evaluationcomputed

### Secondary spark

Selectioncranking_spark_bypass

Source and stored cellsmap / absolute (deg)

Primary / secondary / combined5.0000 / unknown / 5.0000

Coordinate (kPa)unknown

Conditionrpm unknown > 3000.0000

Input sourcesynthetic_input

Raw / qualified leveltrue / true

Input age / observed time0.0000 ms / 1020000

Evaluationcomputed

## Exact U64 observation display

Control observation, separate from editor values. SYNTHETIC control observation. Check source and sample age.

### Secondary fuel

Selectiondisabled

Source and stored cellsmap / absolute (%)

Primary / secondary / combined85.0000 / unknown / 85.0000

Coordinate (kPa)unknown

Conditionrpm unknown > 3000.0000

Input sourceunavailable

Raw / qualified levelunknown / unknown

Input age / observed timeunknown ms / unknown

Evaluationcomputed

### Secondary spark

Selectioncranking_spark_bypass

Source and stored cellsmap / absolute (deg)

Primary / secondary / combinedunknown / unknown / unknown

Coordinate (kPa)unknown

Conditionrpm unknown > 3000.0000

Input sourcesynthetic_input

Raw / qualified leveltrue / true

Input age / observed time0.0000 ms / 18446744073709541615

Evaluationnot computed
