markthebault/esp32-ecu/(list of files, drawings)

Other design files:
reports/engine/idle-isolation/cad/router-accessory/isolated.dsn
reports/engine/idle-isolation/cad/router-carrier/carrier.dsn
reports/engine/switch-inputs/validation/routing/switches.dsn
