markthebault/esp32-ecu/hardware/a5-idle-interface/esp32-ecu.kicad_pcb

## KiCad design hardware/a5-idle-interface/esp32-ecu.kicad_pcb (2026-11-06)

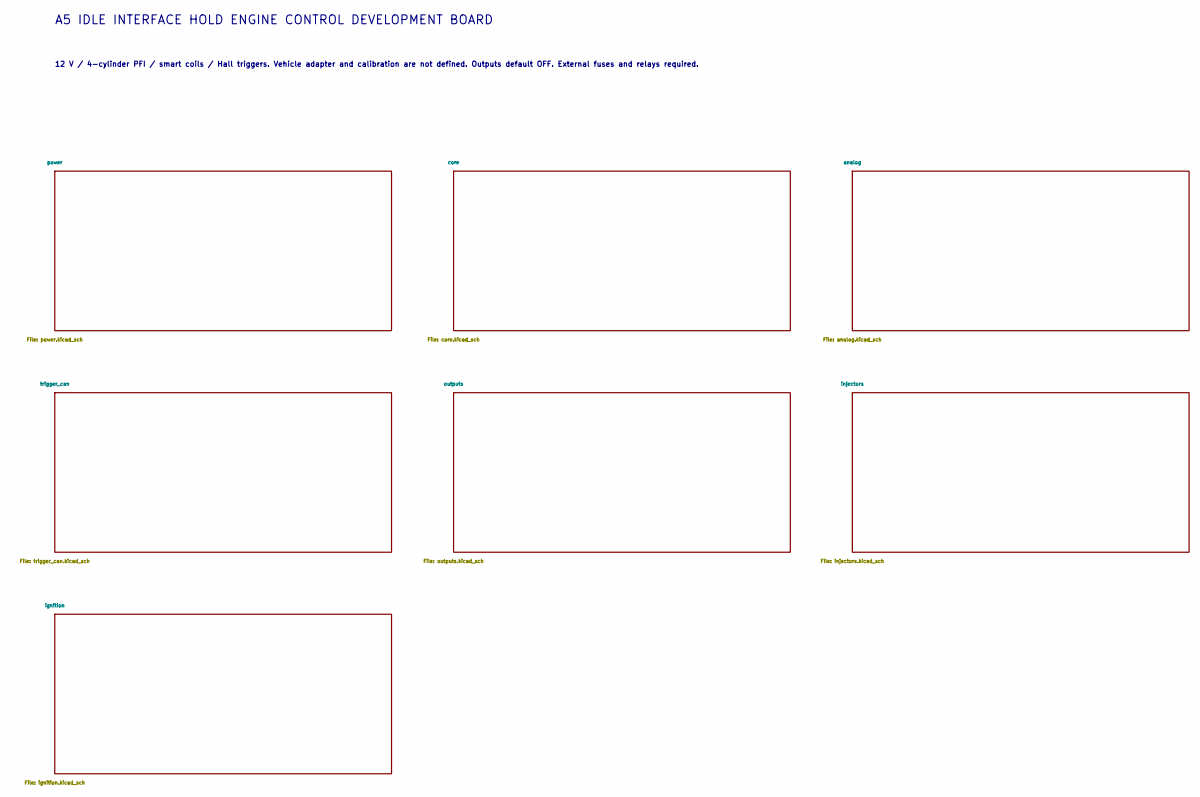
[picture p160: schematic esp32-ecu.kicad_sch, ESP32 ECU A5 IDLE INTERFACE HOLD - bench development]

Notes on the sheet:
A5 IDLE INTERFACE HOLD ENGINE CONTROL DEVELOPMENT BOARD
12 V / 4-cylinder PFI / smart coils / Hall triggers. Vehicle adapter and calibration are not defined. Outputs default OFF. External fuses and relays required.

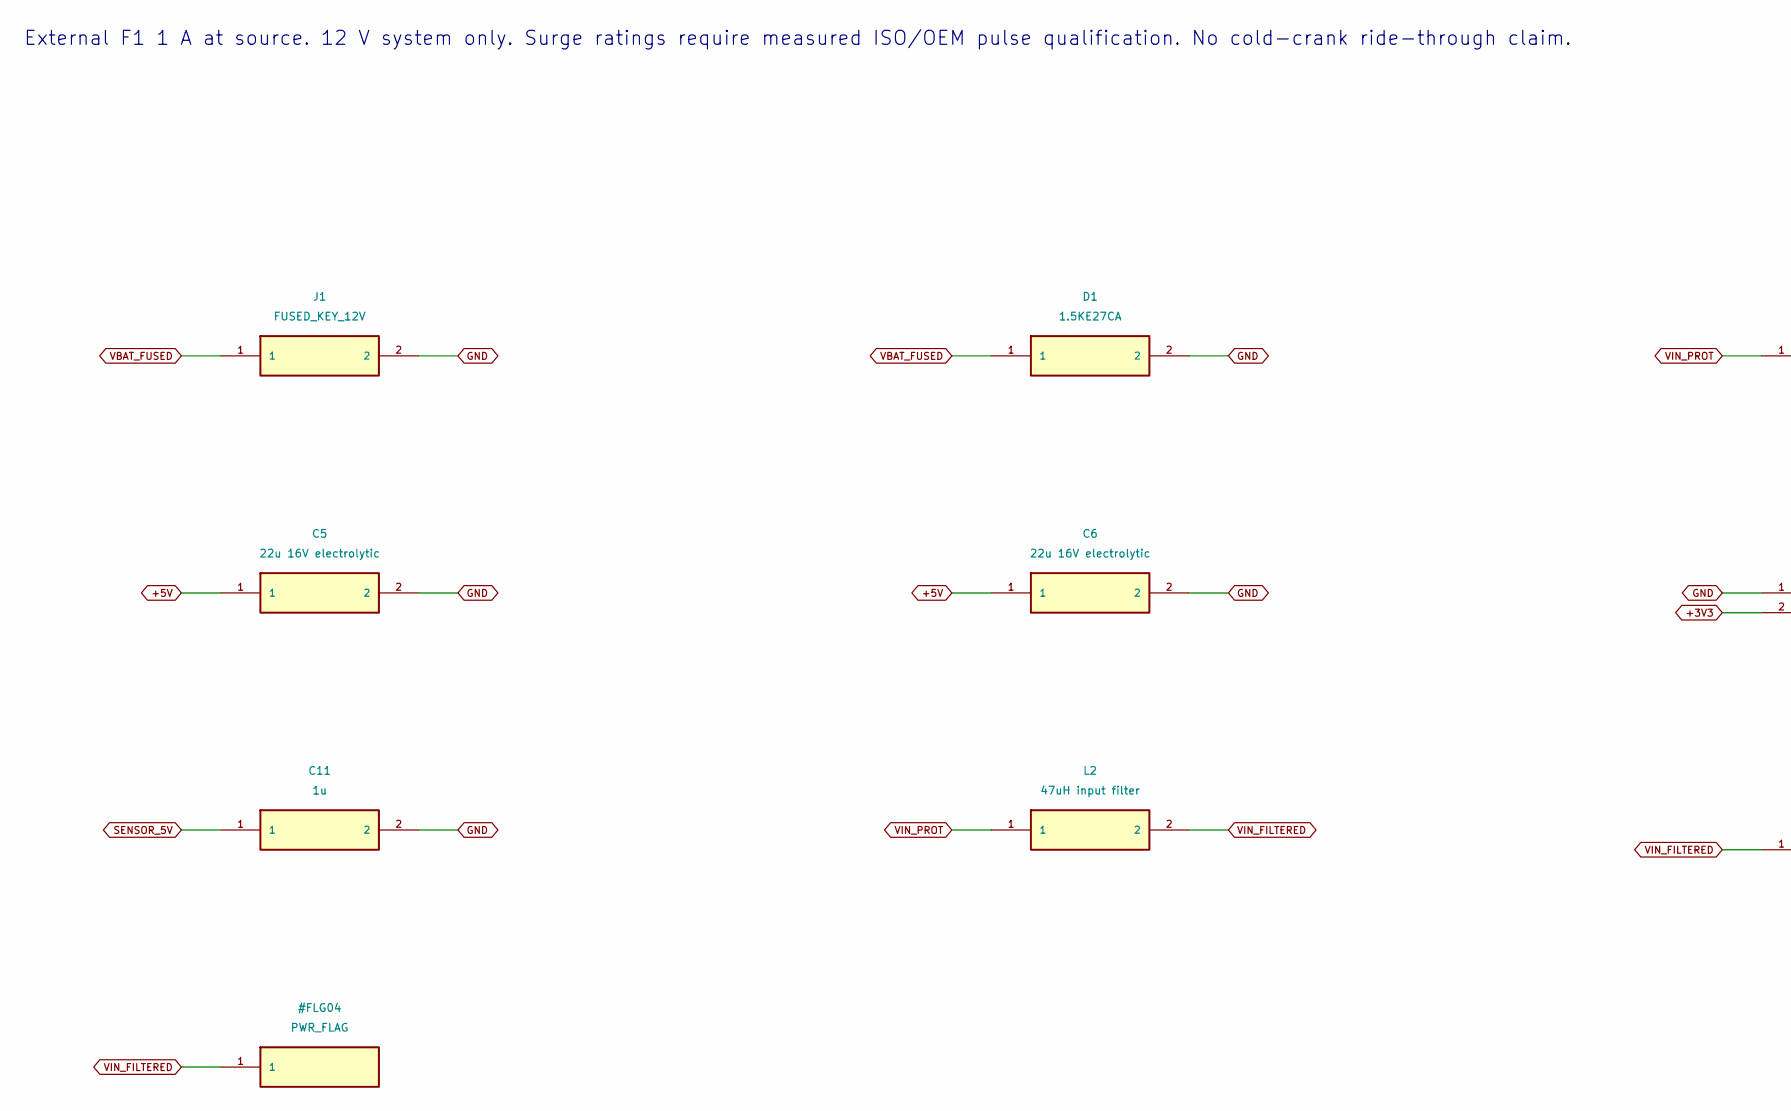
[picture p161: schematic power.kicad_sch, ESP32 ECU A5 IDLE INTERFACE HOLD / power, part in row 1, column 1]

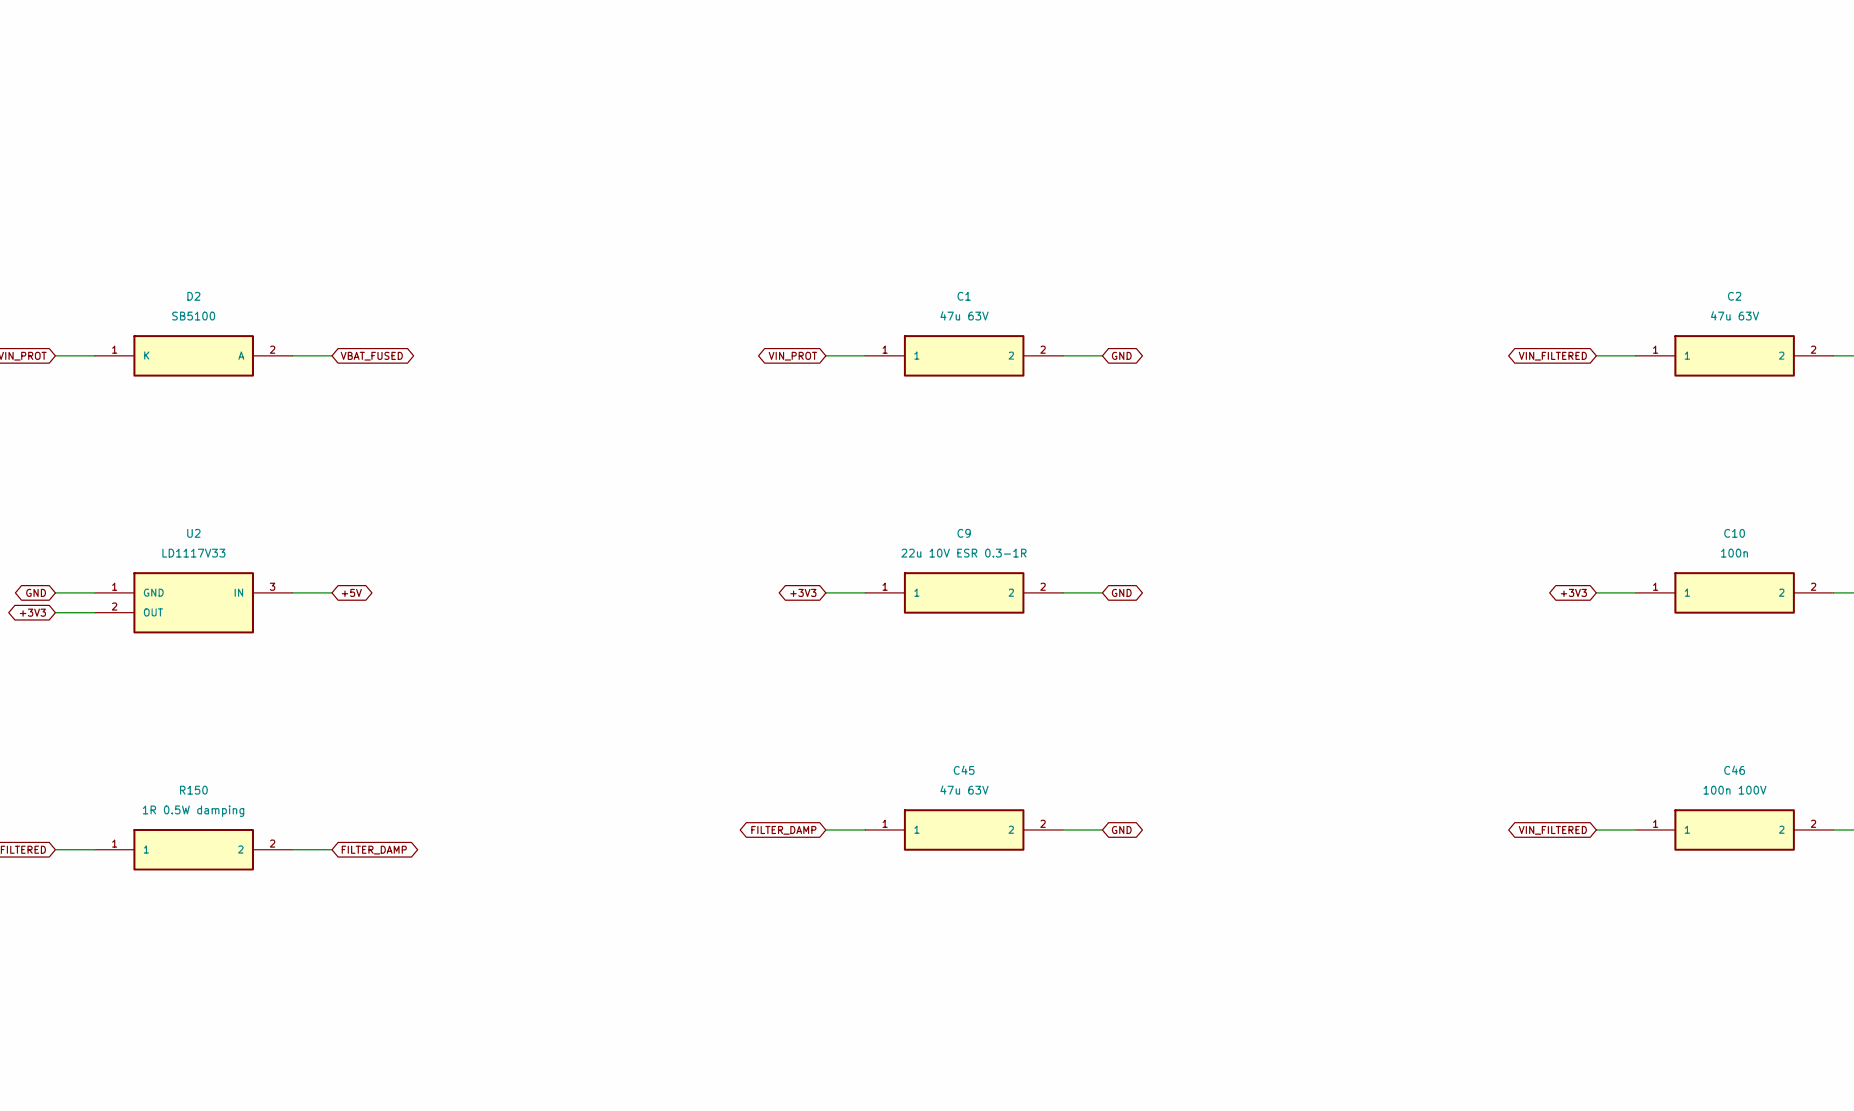
[picture p162: schematic power.kicad_sch, ESP32 ECU A5 IDLE INTERFACE HOLD / power, part in row 1, column 2]

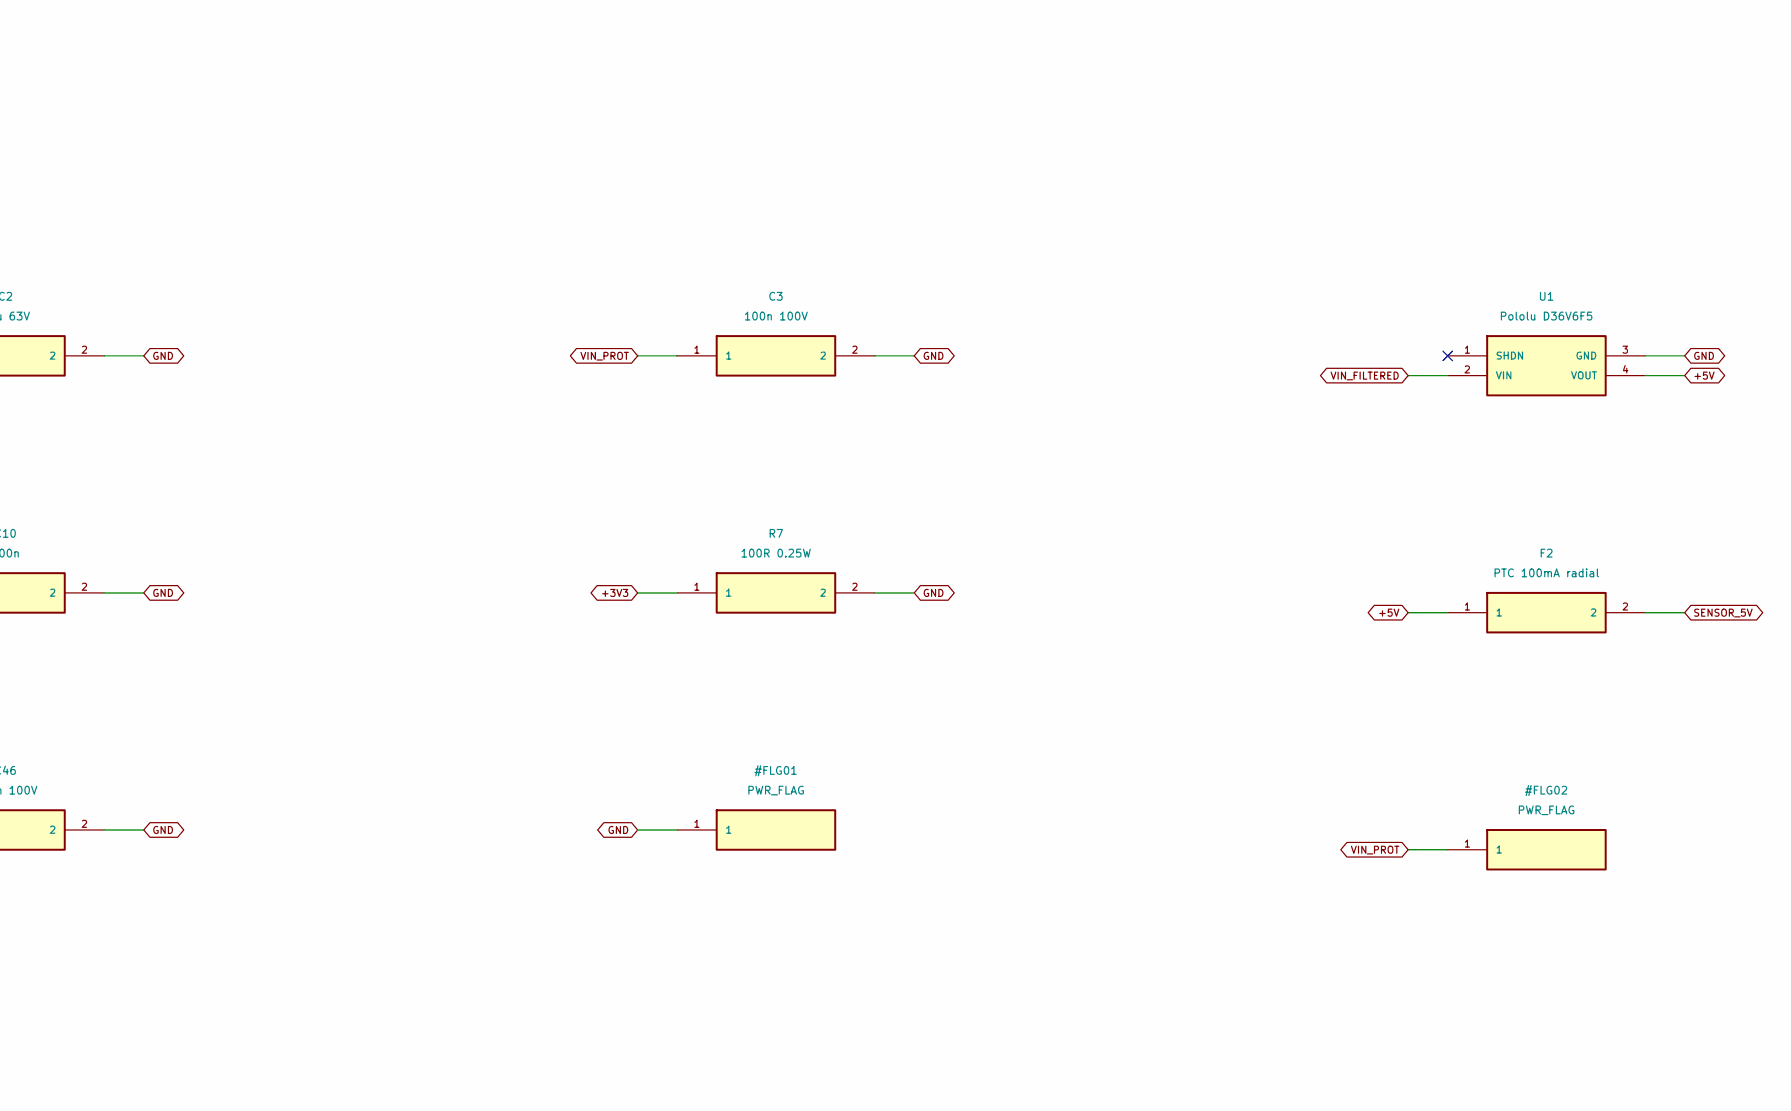
[picture p163: schematic power.kicad_sch, ESP32 ECU A5 IDLE INTERFACE HOLD / power, part in row 1, column 3]

Parts:
C1, C2, C45: 47u 63V; CP_Radial_D8.0mm_P3.50mm
C3, C46: 100n 100V; C_Disc_D5.0mm_W2.5mm_P5.00mm
C5, C6: 22u 16V electrolytic; CP_Radial_D8.0mm_P3.50mm
C9: 22u 10V ESR 0.3-1R; CP_Radial_D8.0mm_P3.50mm
C10: 100n; C_Disc_D5.0mm_W2.5mm_P5.00mm
C11: 1u; C_Rect_L7.2mm_W5.0mm_P5.00mm
D1: 1.5KE27CA; D_DO-201AD_P5.08mm_Vertical_AnodeUp; MPN 1.5KE27CA
D2: SB5100; D_DO-201AD_P15.24mm_Horizontal; MPN SB5100-B
F2: PTC 100mA radial; PTC_MF_R010; MPN MF-R010
J1: FUSED_KEY_12V; JST_VH_B2P-VH_1x02_P3.96mm_Vertical; MPN B2P-VH(LF)(SN)
L2: 47uH input filter; L_Radial_D10.0mm_P5.00mm_Fastron_07P; MPN RLB0914-470KL
R7: 100R 0.25W; R_Axial_DIN0207_L6.3mm_D2.5mm_P2.54mm_Vertical
R150: 1R 0.5W damping; R_Axial_DIN0207_L6.3mm_D2.5mm_P10.16mm_Horizontal
U1: Pololu D36V6F5; Pololu_D36V6F5_vertical; MPN Pololu 3792
U2: LD1117V33; TO-220-3_Vertical; MPN LD1117V33

Connections:
+3V3: C9.1, C10.1, R7.1, U2.2 (OUT); also elsewhere on the board
+5V: C5.1, C6.1, F2.1, U1.4 (VOUT), U2.3 (IN); also elsewhere on the board
FILTER_DAMP: C45.1, R150.2
GND: C1.2, C2.2, C3.2, C5.2, C6.2, C9.2, C10.2, C11.2, C45.2, C46.2, D1.2, J1.2, R7.2, U1.3 (GND), U2.1 (GND); also elsewhere on the board
SENSOR_5V: C11.1, F2.2; also elsewhere on the board
VBAT_FUSED: D1.1, D2.2 (A), J1.1
VIN_FILTERED: C2.1, C46.1, L2.2, R150.1, U1.2 (VIN)
VIN_PROT: C1.1, C3.1, D2.1 (K), L2.1; also elsewhere on the board

Notes on the sheet:
External F1 1 A at source. 12 V system only. Surge ratings require measured ISO/OEM pulse qualification. No cold-crank ride-through claim.

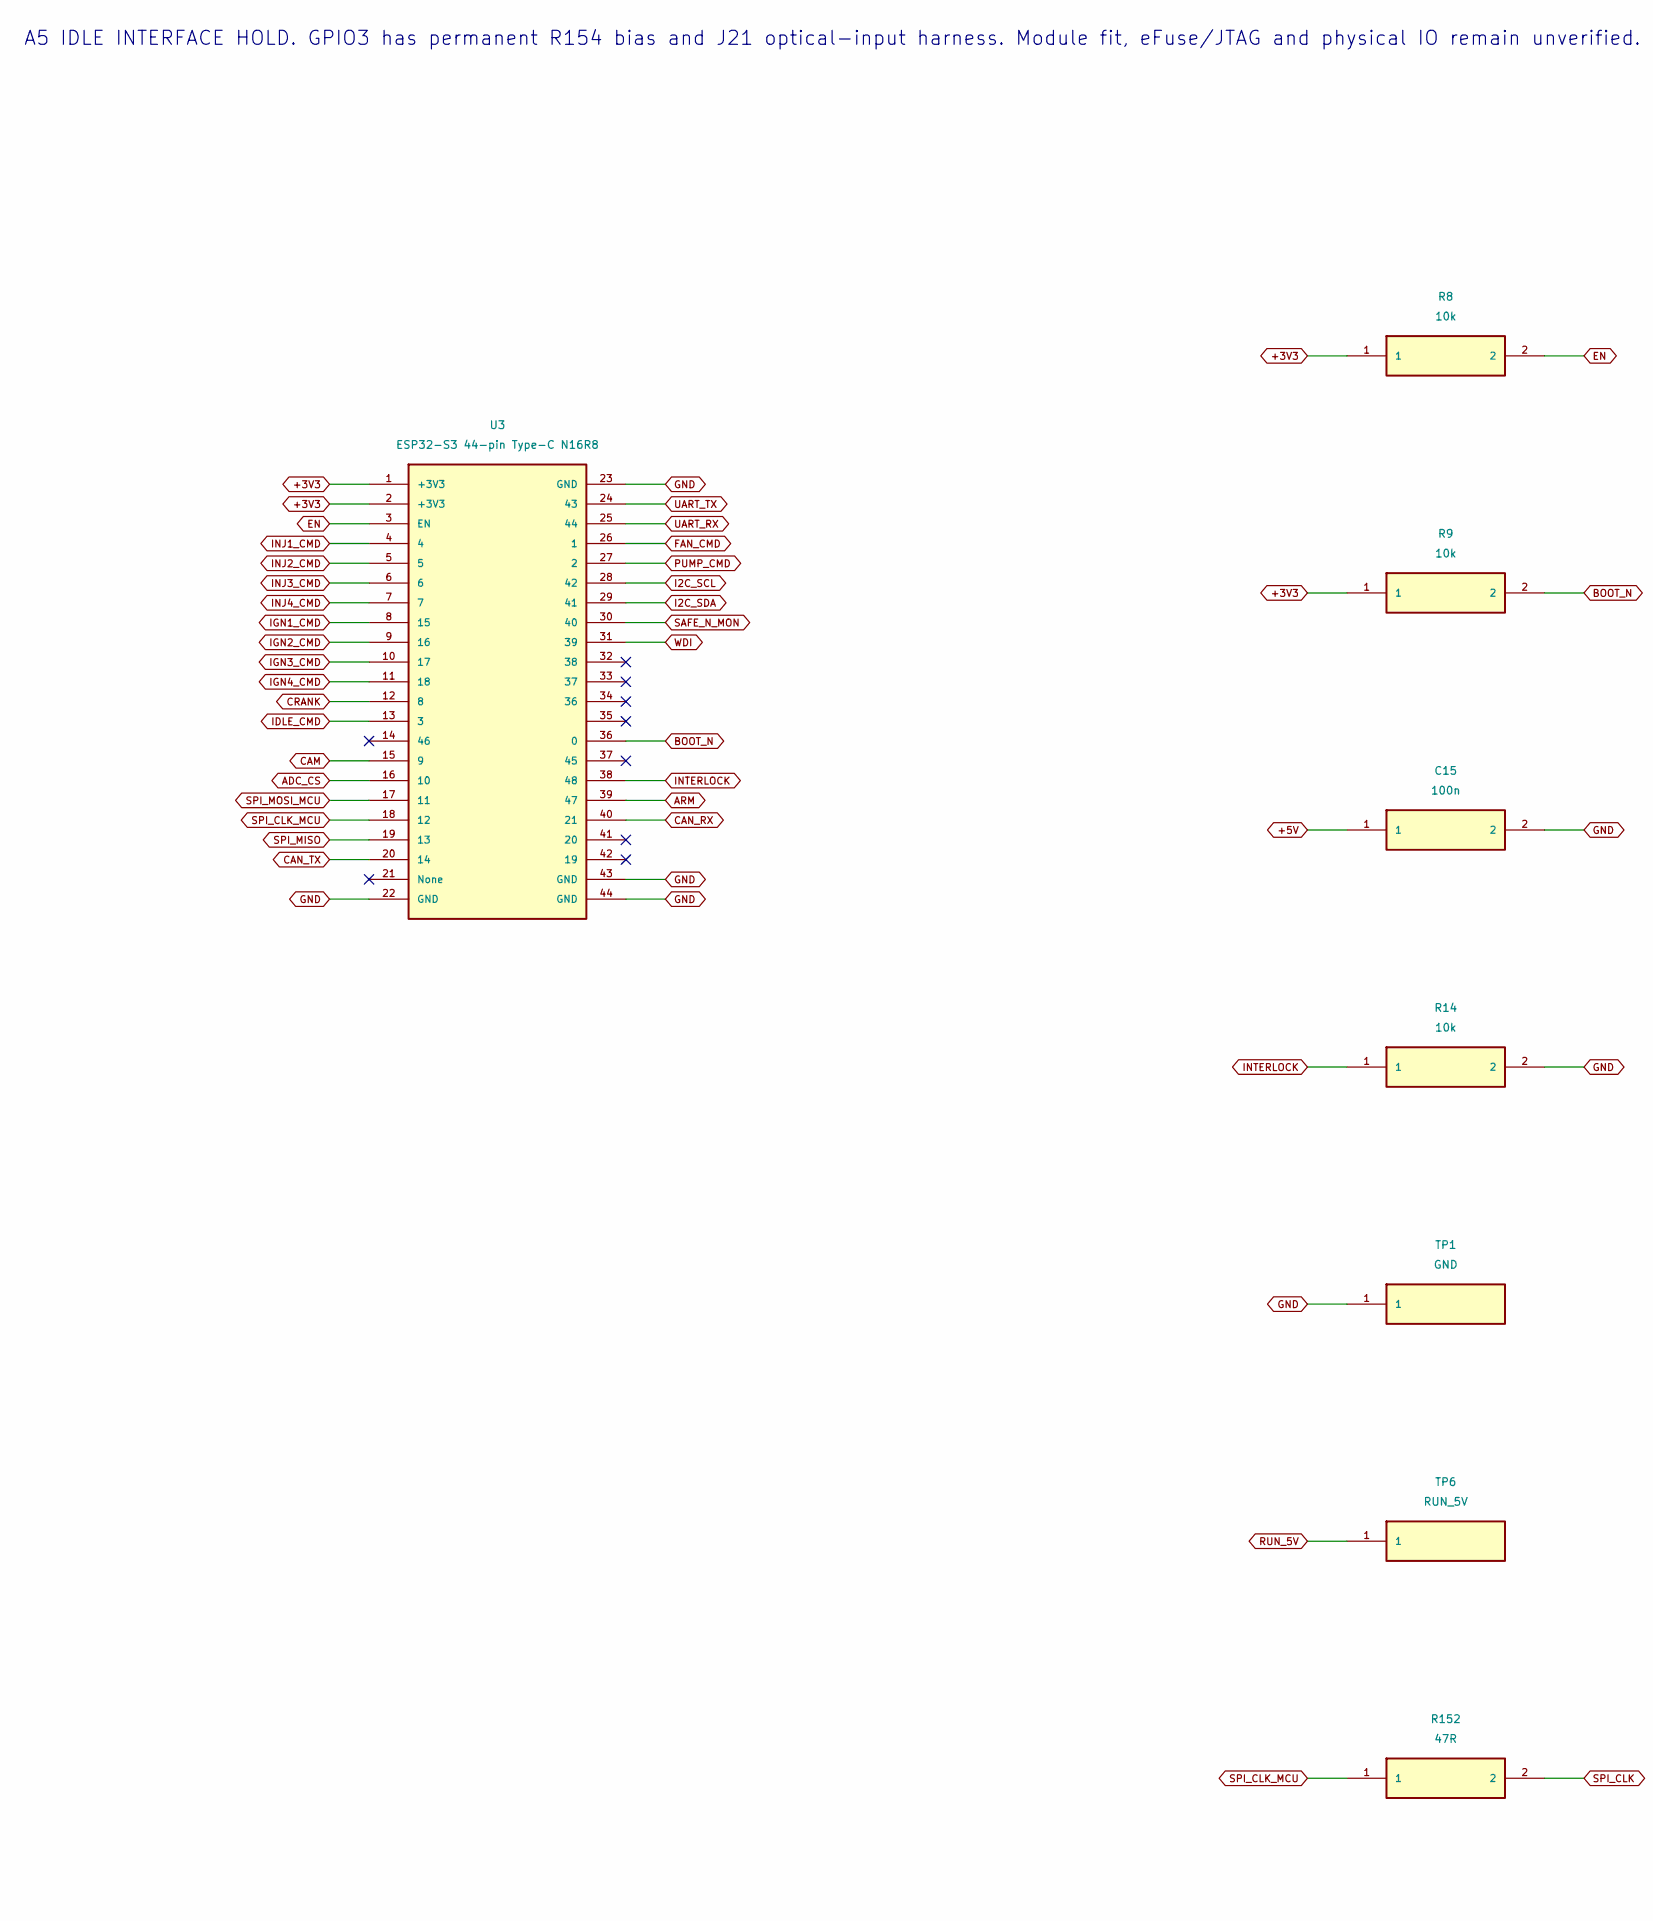
[picture p164: schematic core.kicad_sch, ESP32 ECU A5 / core, part in row 1, column 1]

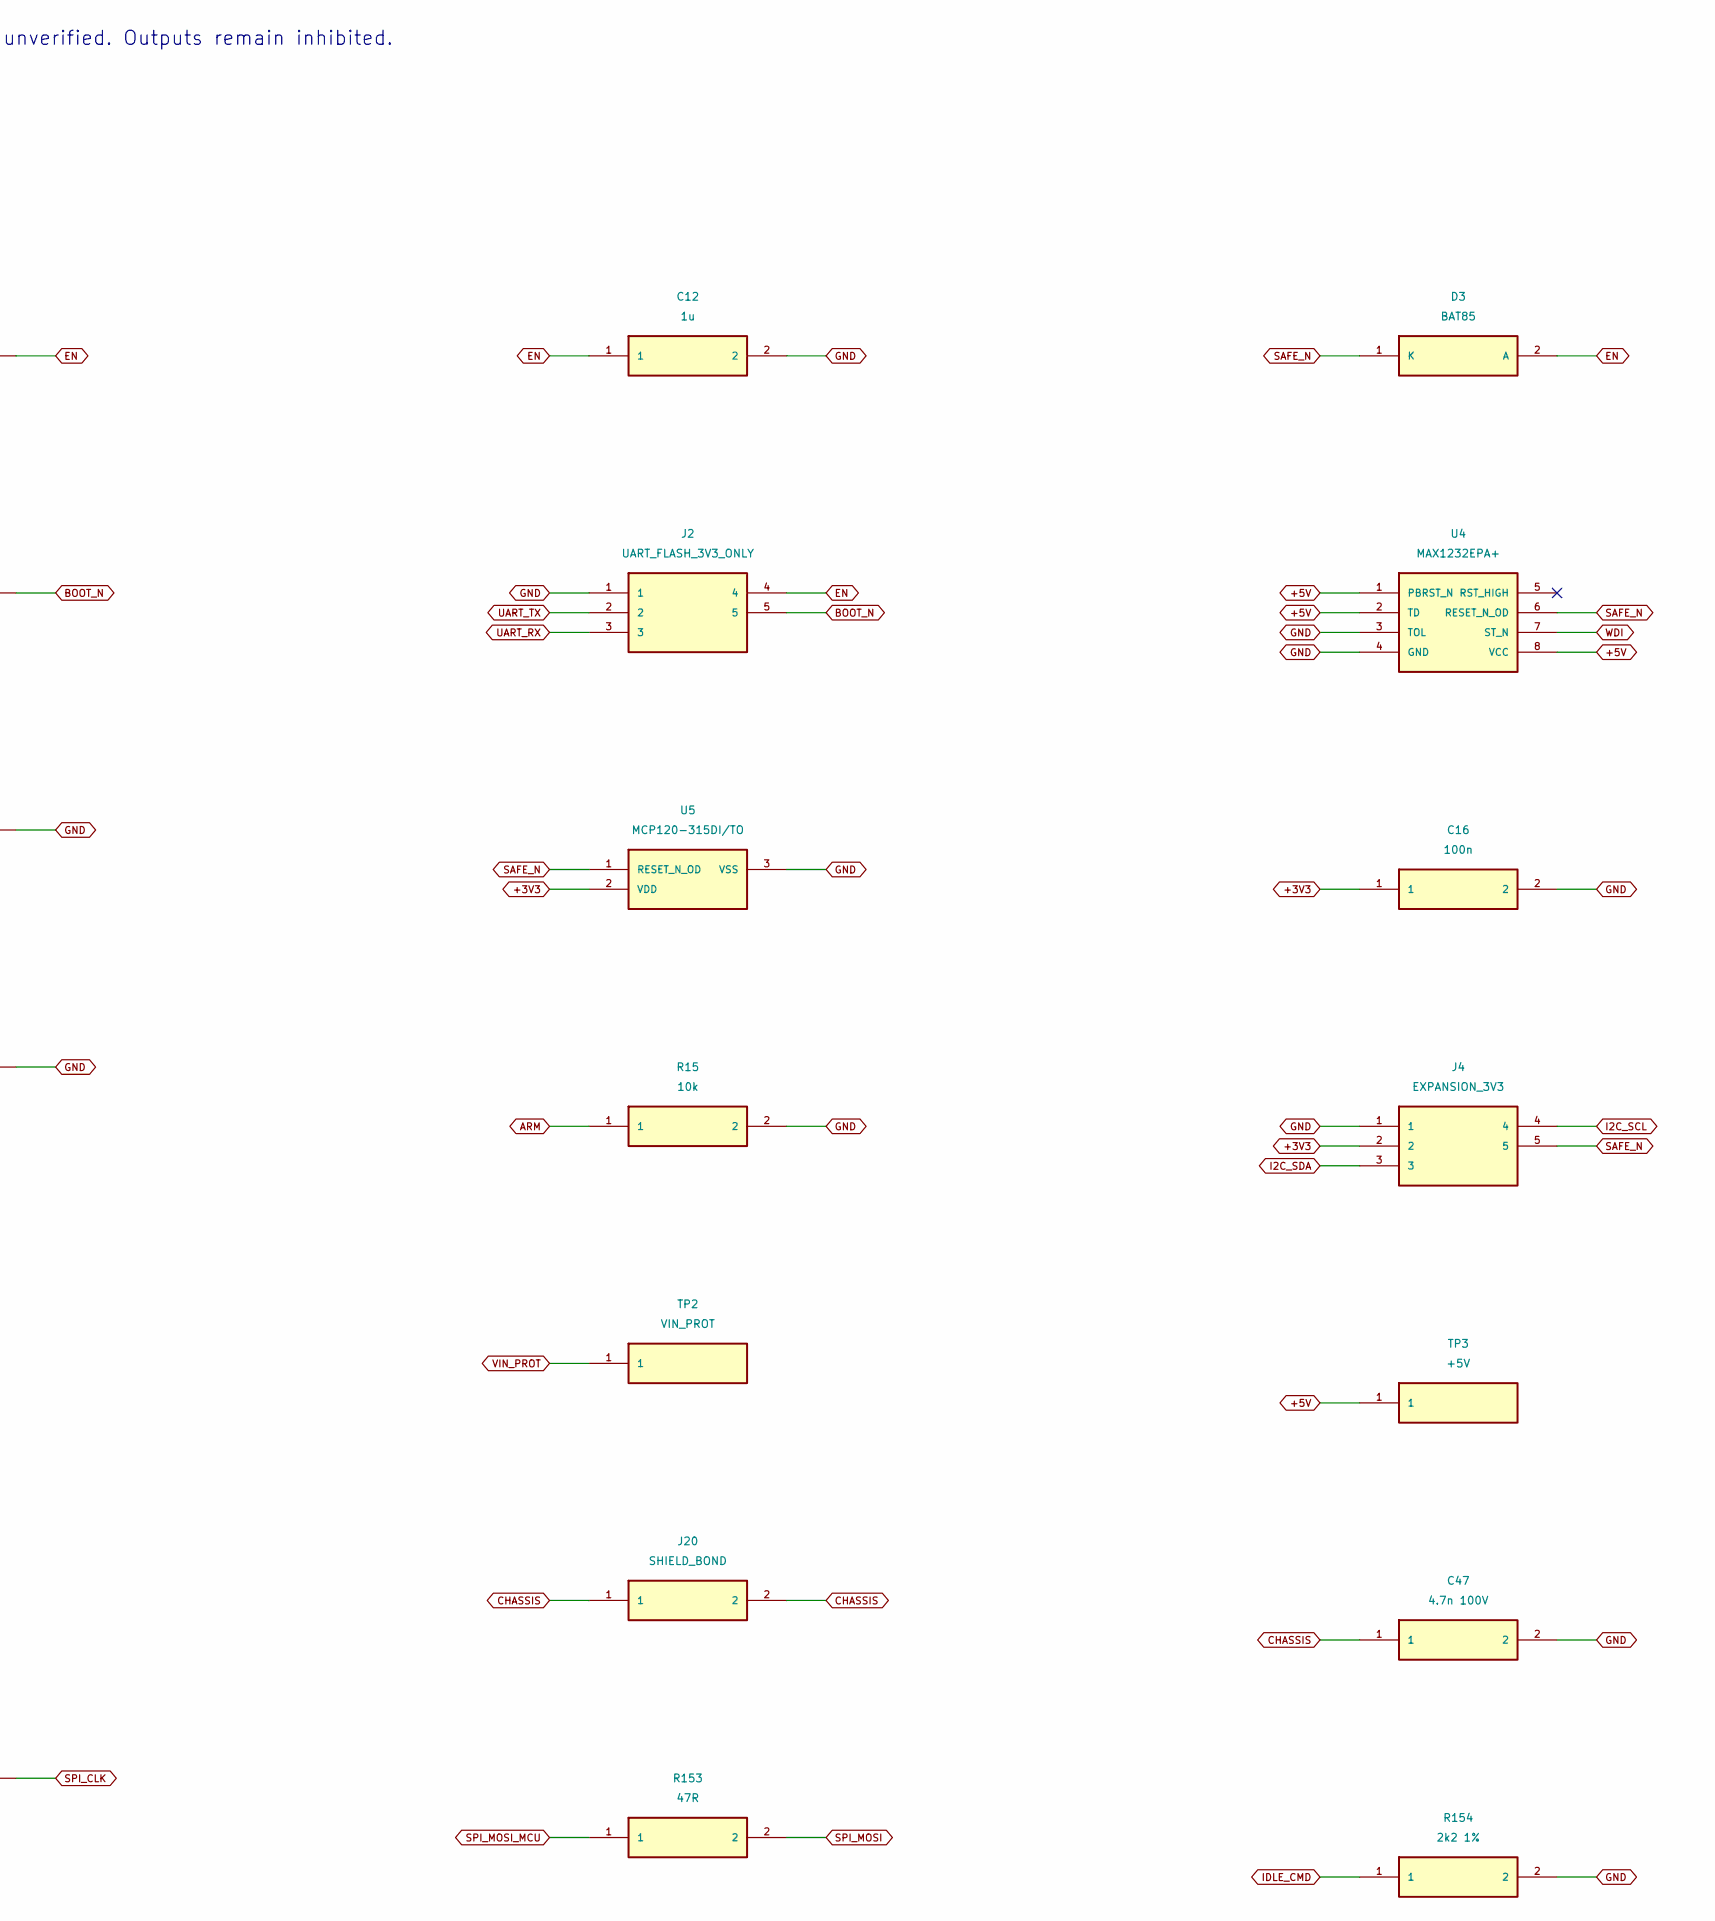
[picture p165: schematic core.kicad_sch, ESP32 ECU A5 / core, part in row 1, column 2]

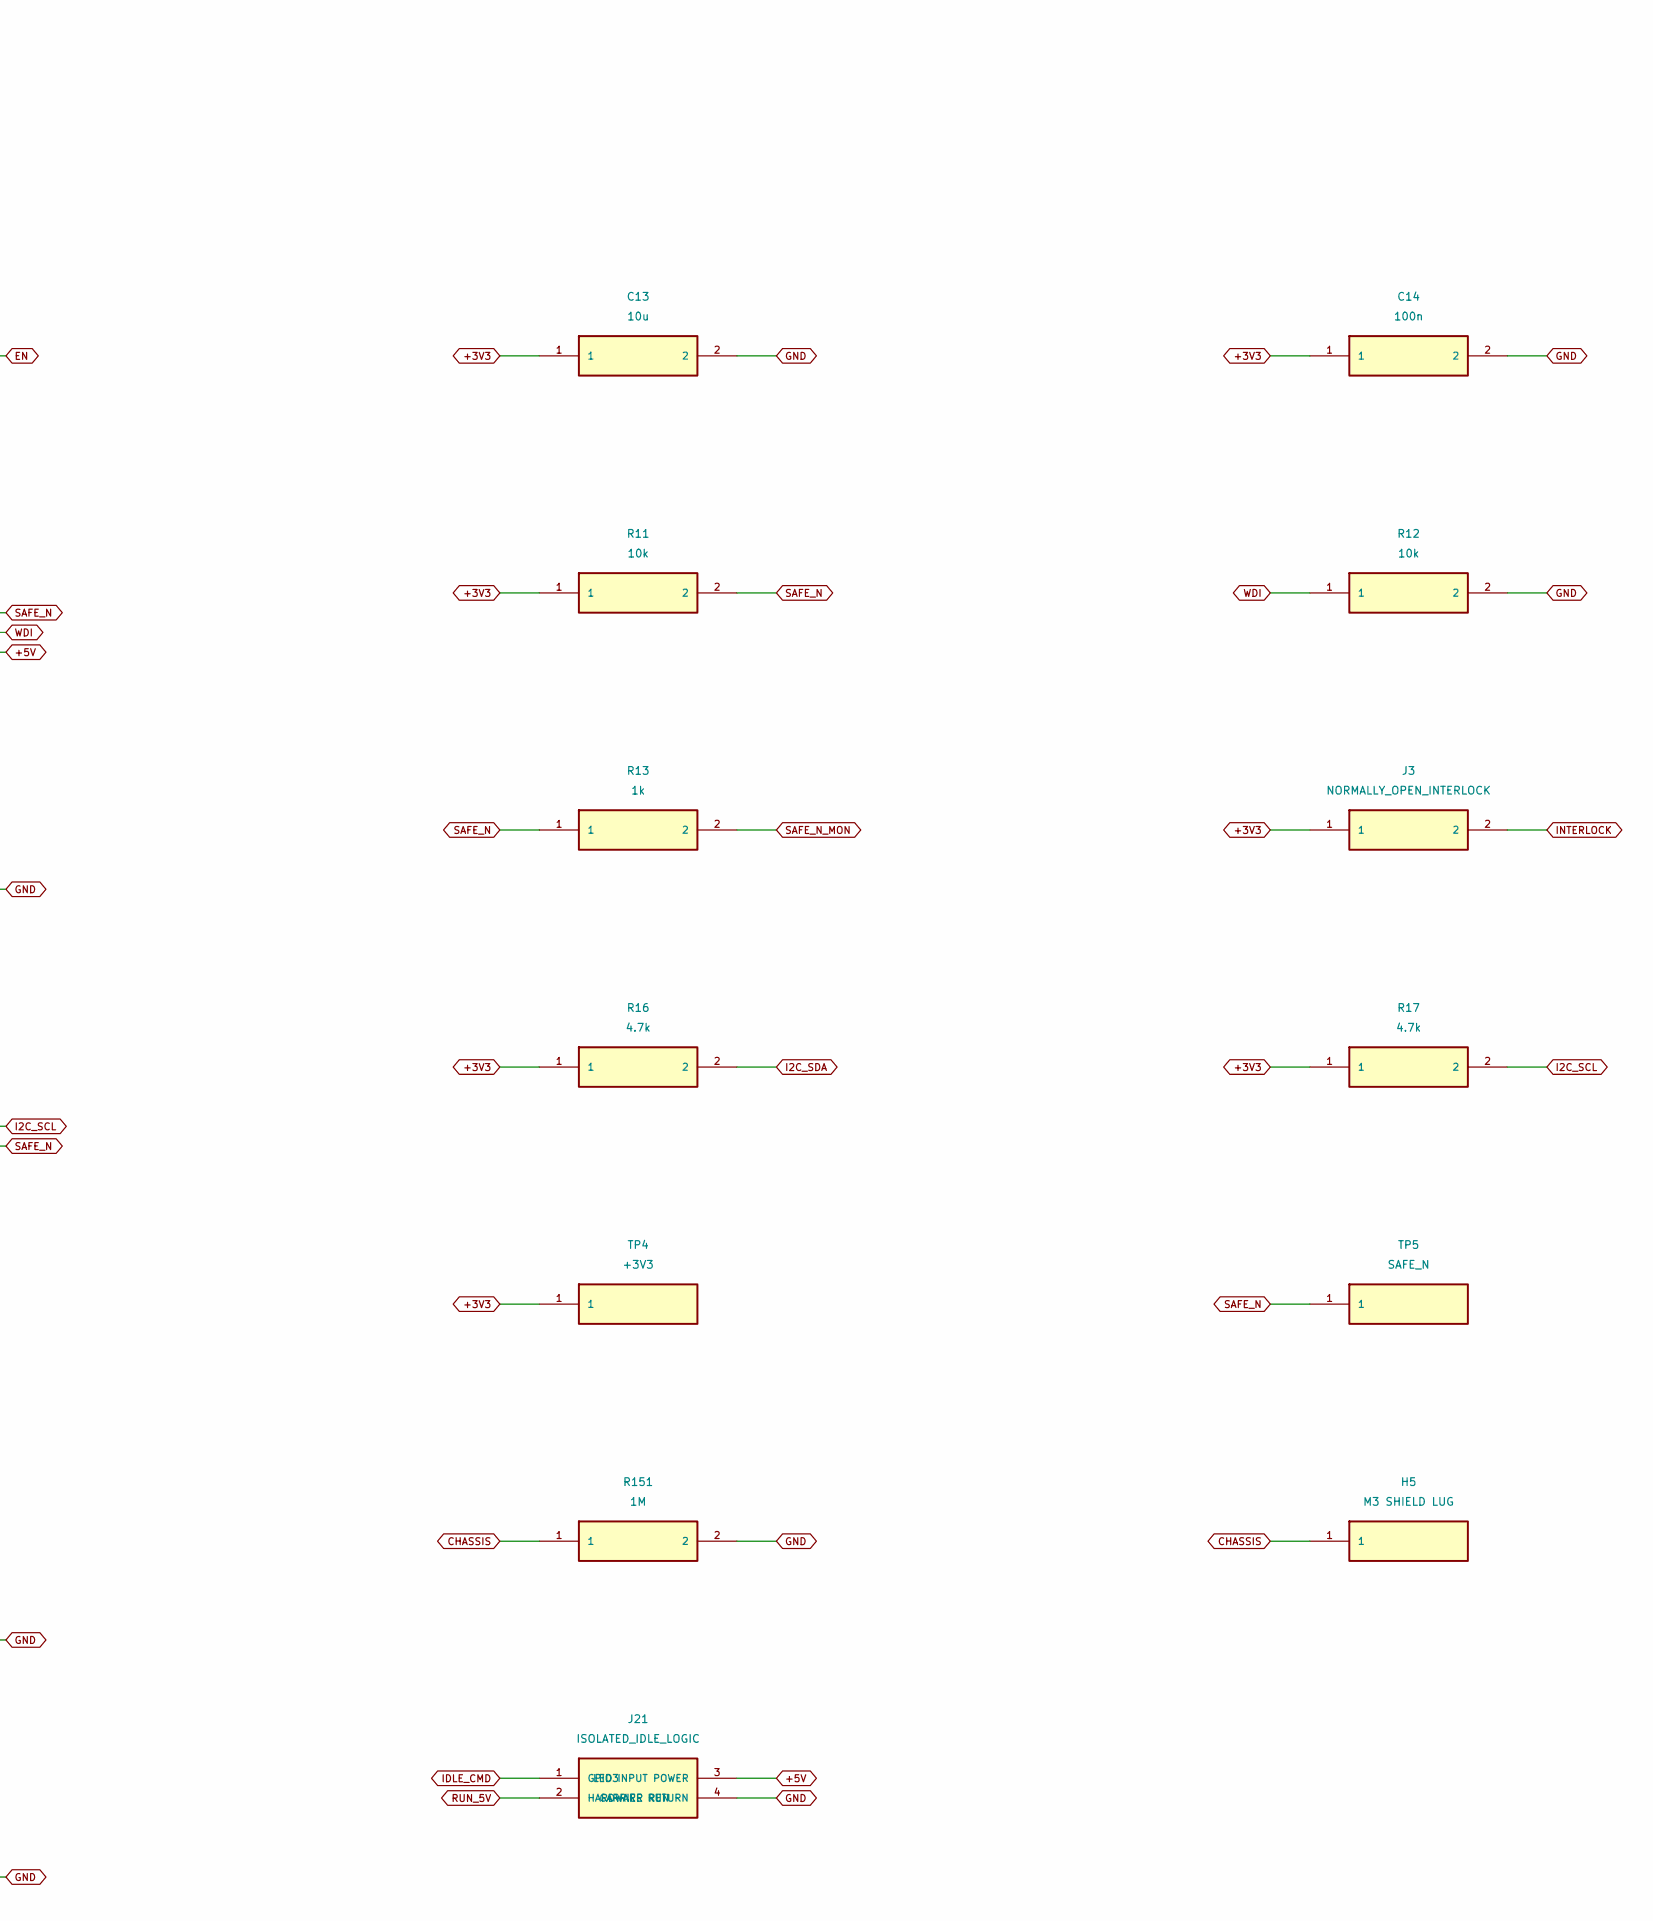
[picture p166: schematic core.kicad_sch, ESP32 ECU A5 / core, part in row 1, column 3]

Parts:
C12: 1u; C_Rect_L7.2mm_W5.0mm_P5.00mm
C13: 10u; CP_Radial_D8.0mm_P3.50mm
C14, C15, C16: 100n; C_Disc_D5.0mm_W2.5mm_P5.00mm
C47: 4.7n 100V; C_Disc_D5.0mm_W2.5mm_P5.00mm
D3: BAT85; D_DO-35_SOD27_P3.81mm_Vertical_AnodeUp; MPN BAT85,113
H5: M3 SHIELD LUG; MountingHole_3.2mm_M3_Pad
J2: UART_FLASH_3V3_ONLY; PinHeader_1x05_P2.54mm_Vertical
J3: NORMALLY_OPEN_INTERLOCK; PinHeader_1x02_P2.54mm_Vertical
J4: EXPANSION_3V3; PinHeader_1x05_P2.54mm_Vertical
J20: SHIELD_BOND; JST_VH_B2P_SHIELD_Compact; MPN B2P-VH(LF)(SN)
J21: ISOLATED_IDLE_LOGIC; JST_PH_B4B-PH-K_1x04_P2.00mm_Vertical; MPN B4B-PH-K-S(LF)(SN)
R8, R9, R11, R12, R14, R15: 10k; R_Axial_DIN0207_L6.3mm_D2.5mm_P2.54mm_Vertical
R13: 1k; R_Axial_DIN0207_L6.3mm_D2.5mm_P2.54mm_Vertical
R16, R17: 4.7k; R_Axial_DIN0207_L6.3mm_D2.5mm_P2.54mm_Vertical
R151: 1M; R_Axial_DIN0207_L6.3mm_D2.5mm_P2.54mm_Vertical
R152, R153: 47R; R_Axial_DIN0207_L6.3mm_D2.5mm_P2.54mm_Vertical
R154: 2k2 1%; R_Axial_DIN0207_L6.3mm_D2.5mm_P2.54mm_Vertical
TP1: GND; TestPoint_THTPad_D2.5mm_Drill1.2mm
TP2: VIN_PROT; TestPoint_THTPad_D2.5mm_Drill1.2mm
TP3: +5V; TestPoint_THTPad_D2.5mm_Drill1.2mm
TP4: +3V3; TestPoint_THTPad_D2.5mm_Drill1.2mm
TP5: SAFE_N; TestPoint_THTPad_D2.5mm_Drill1.2mm
TP6: RUN_5V; TestPoint_THTPad_D2.5mm_Drill1.2mm
U3: ESP32-S3 44-pin Type-C N16R8; ESP32_S3_DevKitC_1_socket; MPN AliExpress 1005006418608267 / S3-N16R8
U4: MAX1232EPA+; DIP-8_W7.62mm_LongPads; MPN MAX1232EPA+
U5: MCP120-315DI/TO; TO-92_Inline_Wide; MPN MCP120-315DI/TO

Connections:
+3V3: C13.1, C14.1, C16.1, J3.1, J4.2, R8.1, R9.1, R11.1, R16.1, R17.1, TP4.1, U3.1 (+3V3), U3.2 (+3V3), U5.2 (VDD); also elsewhere on the board
+5V: C15.1, J21.3 (LED INPUT POWER), TP3.1, U4.1 (PBRST_N), U4.2 (TD), U4.8 (VCC); also elsewhere on the board
ADC_CS: U3.16 (10); also elsewhere on the board
ARM: R15.1, U3.39 (47); also elsewhere on the board
BOOT_N: J2.5, R9.2, U3.36 (0)
CAM: U3.15 (9); also elsewhere on the board
CAN_RX: U3.40 (21); also elsewhere on the board
CAN_TX: U3.20 (14); also elsewhere on the board
CHASSIS: C47.1, H5.1, J20.1, J20.2, R151.1; also elsewhere on the board
CRANK: U3.12 (8); also elsewhere on the board
EN: C12.1, D3.2 (A), J2.4, R8.2, U3.3 (EN)
FAN_CMD: U3.26 (1); also elsewhere on the board
GND: C12.2, C13.2, C14.2, C15.2, C16.2, C47.2, J2.1, J4.1, J21.4 (CARRIER RETURN), R12.2, R14.2, R15.2, R151.2, R154.2, TP1.1, U3.22 (GND), U3.23 (GND), U3.43 (GND), U3.44 (GND), U4.3 (TOL), U4.4 (GND), U5.3 (VSS); also elsewhere on the board
I2C_SCL: J4.4, R17.2, U3.28 (42)
I2C_SDA: J4.3, R16.2, U3.29 (41)
IDLE_CMD: J21.1 (GPIO3), R154.1, U3.13 (3)
IGN1_CMD: U3.8 (15); also elsewhere on the board
IGN2_CMD: U3.9 (16); also elsewhere on the board
IGN3_CMD: U3.10 (17); also elsewhere on the board
IGN4_CMD: U3.11 (18); also elsewhere on the board
INJ1_CMD: U3.4; also elsewhere on the board
INJ2_CMD: U3.5; also elsewhere on the board
INJ3_CMD: U3.6; also elsewhere on the board
INJ4_CMD: U3.7; also elsewhere on the board
INTERLOCK: J3.2, R14.1, U3.38 (48); also elsewhere on the board
PUMP_CMD: U3.27 (2); also elsewhere on the board
RUN_5V: J21.2 (HARDWARE RUN), TP6.1; also elsewhere on the board
SAFE_N: D3.1 (K), J4.5, R11.2, R13.1, TP5.1, U4.6 (RESET_N_OD), U5.1 (RESET_N_OD); also elsewhere on the board
SAFE_N_MON: R13.2, U3.30 (40)
SPI_CLK: R152.2; also elsewhere on the board
SPI_CLK_MCU: R152.1, U3.18 (12)
SPI_MISO: U3.19 (13); also elsewhere on the board
SPI_MOSI: R153.2; also elsewhere on the board
SPI_MOSI_MCU: R153.1, U3.17 (11)
UART_RX: J2.3, U3.25 (44)
UART_TX: J2.2, U3.24 (43)
VIN_PROT: TP2.1; also elsewhere on the board
WDI: R12.1, U3.31 (39), U4.7 (ST_N)

Notes on the sheet:
A5 IDLE INTERFACE HOLD. GPIO3 has permanent R154 bias and J21 optical-input harness. Module fit, eFuse/JTAG and physical IO remain unverified. Outputs remain inhibited.
