markthebault/esp32-ecu/hardware/a5-idle-interface/esp32-ecu.kicad_pcb

## KiCad design hardware/a5-idle-interface/esp32-ecu.kicad_pcb (continued)

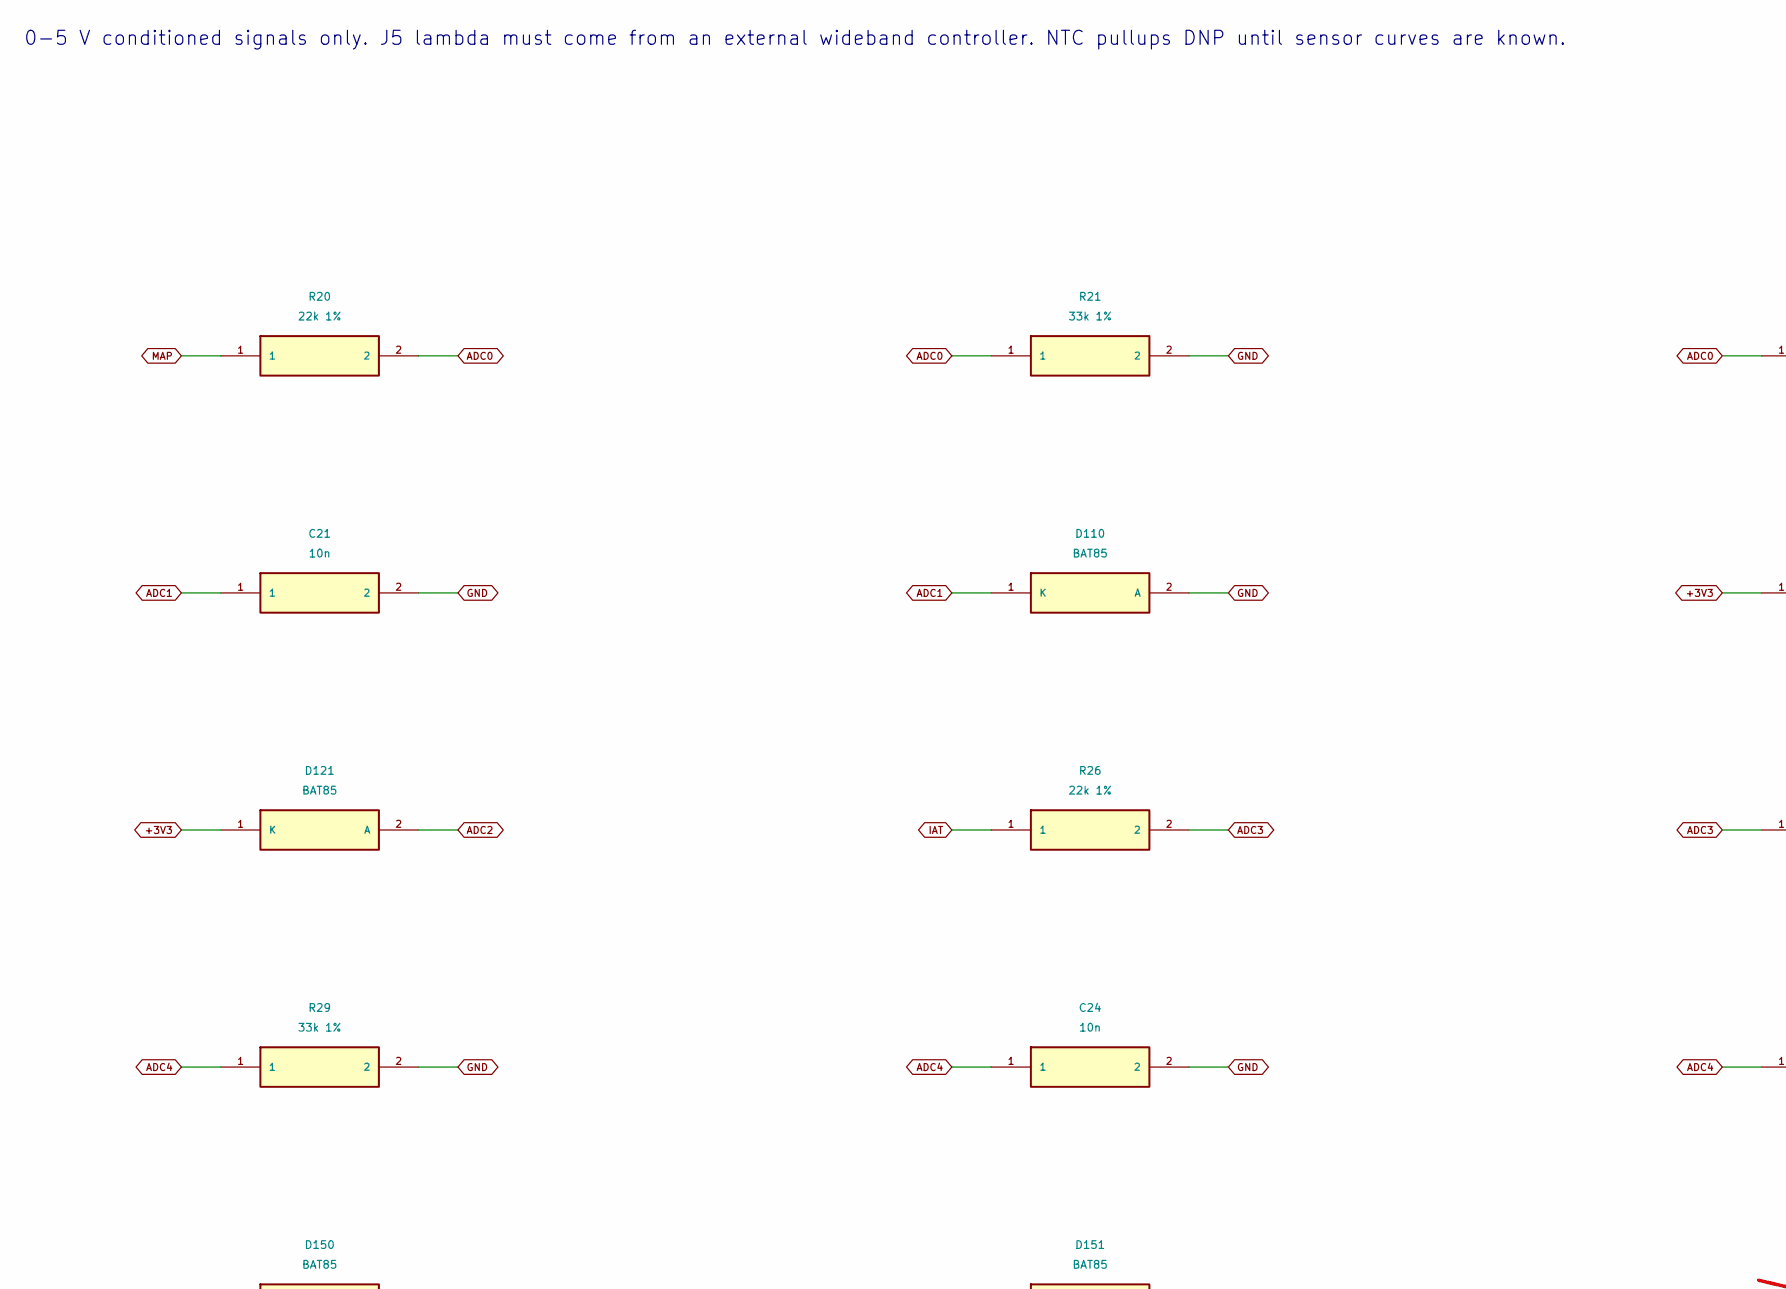
[picture p167: schematic analog.kicad_sch, ESP32 ECU A5 IDLE INTERFACE HOLD / analog, part in row 1, column 1]

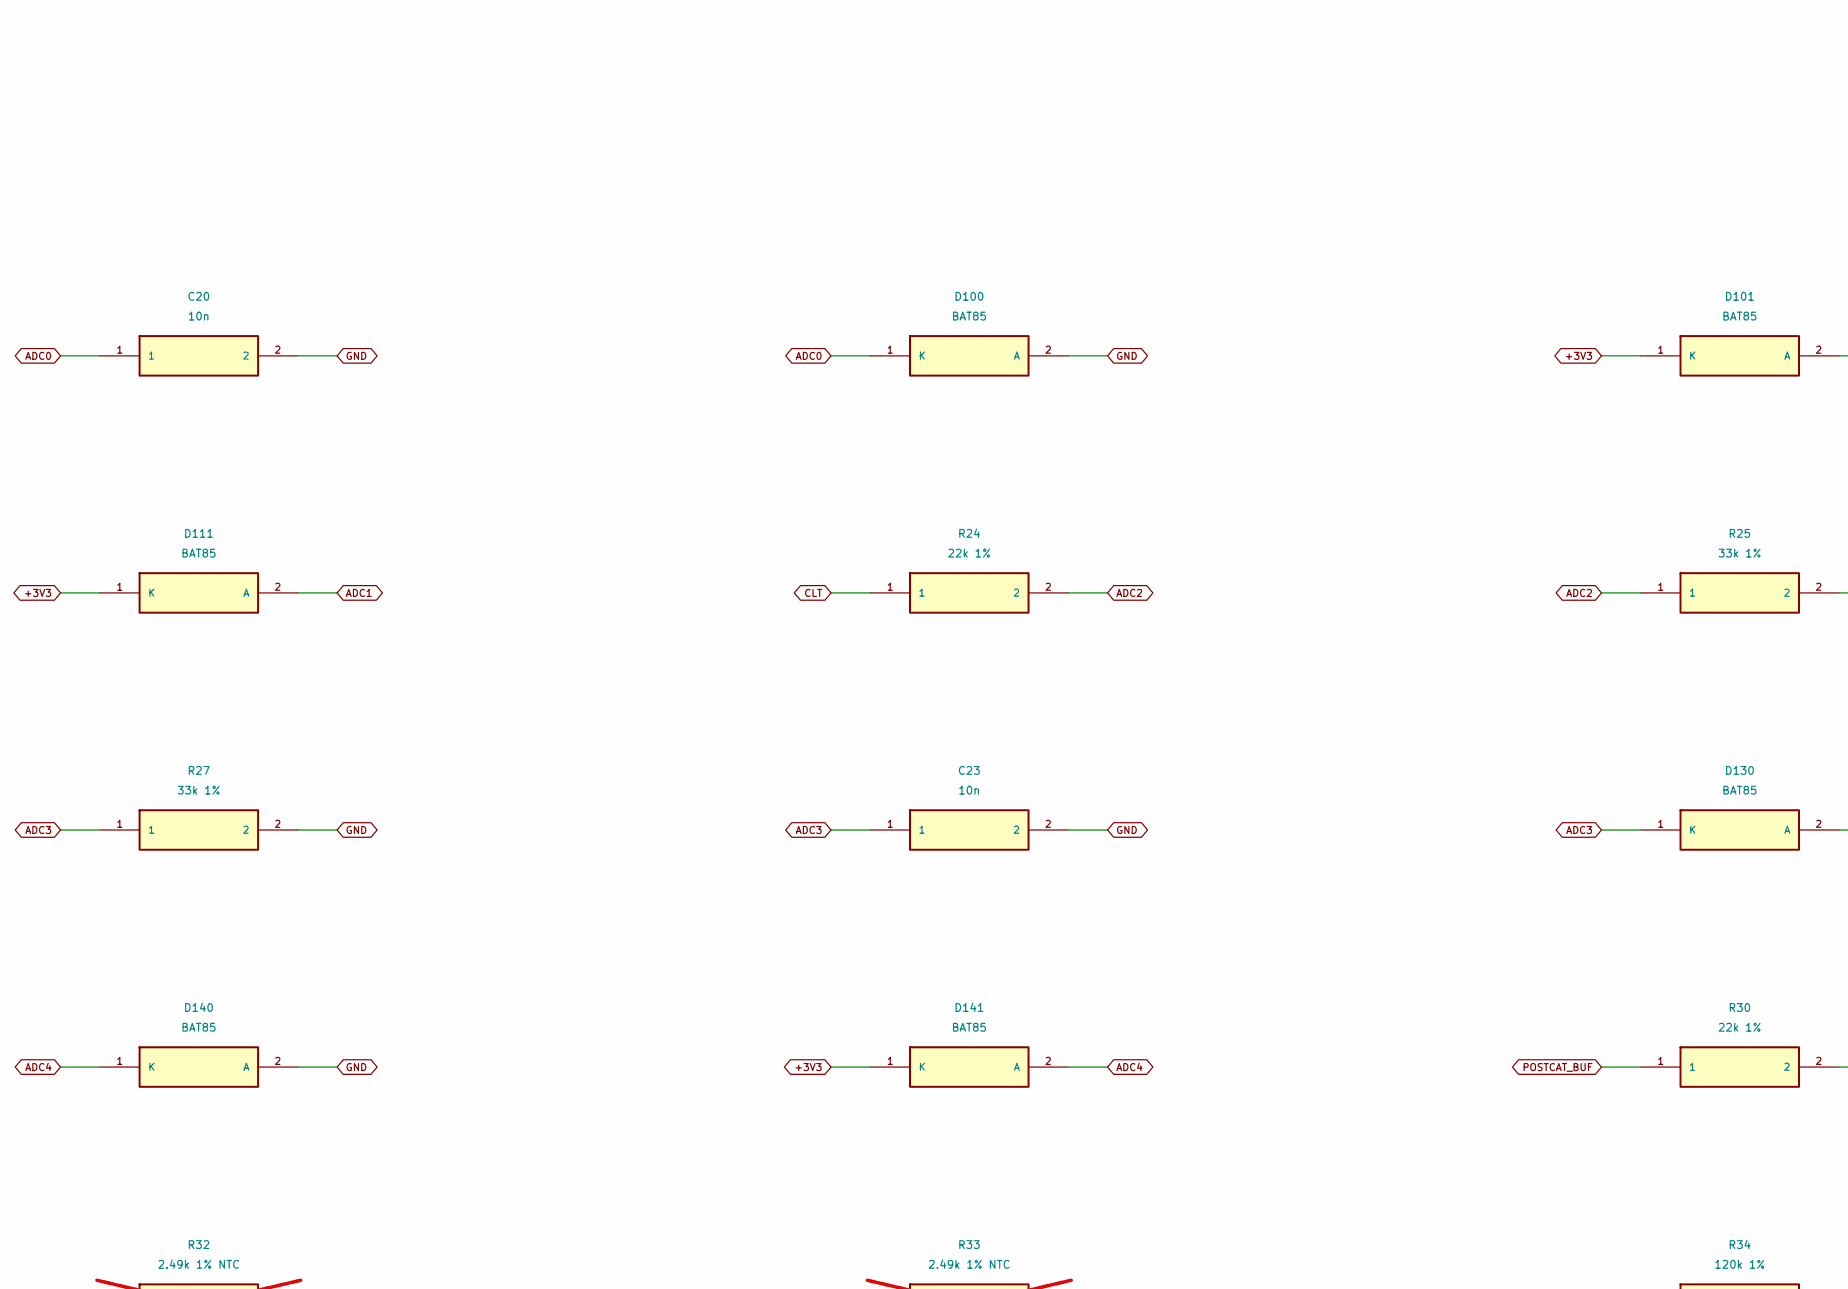
[picture p168: schematic analog.kicad_sch, ESP32 ECU A5 IDLE INTERFACE HOLD / analog, part in row 1, column 2]

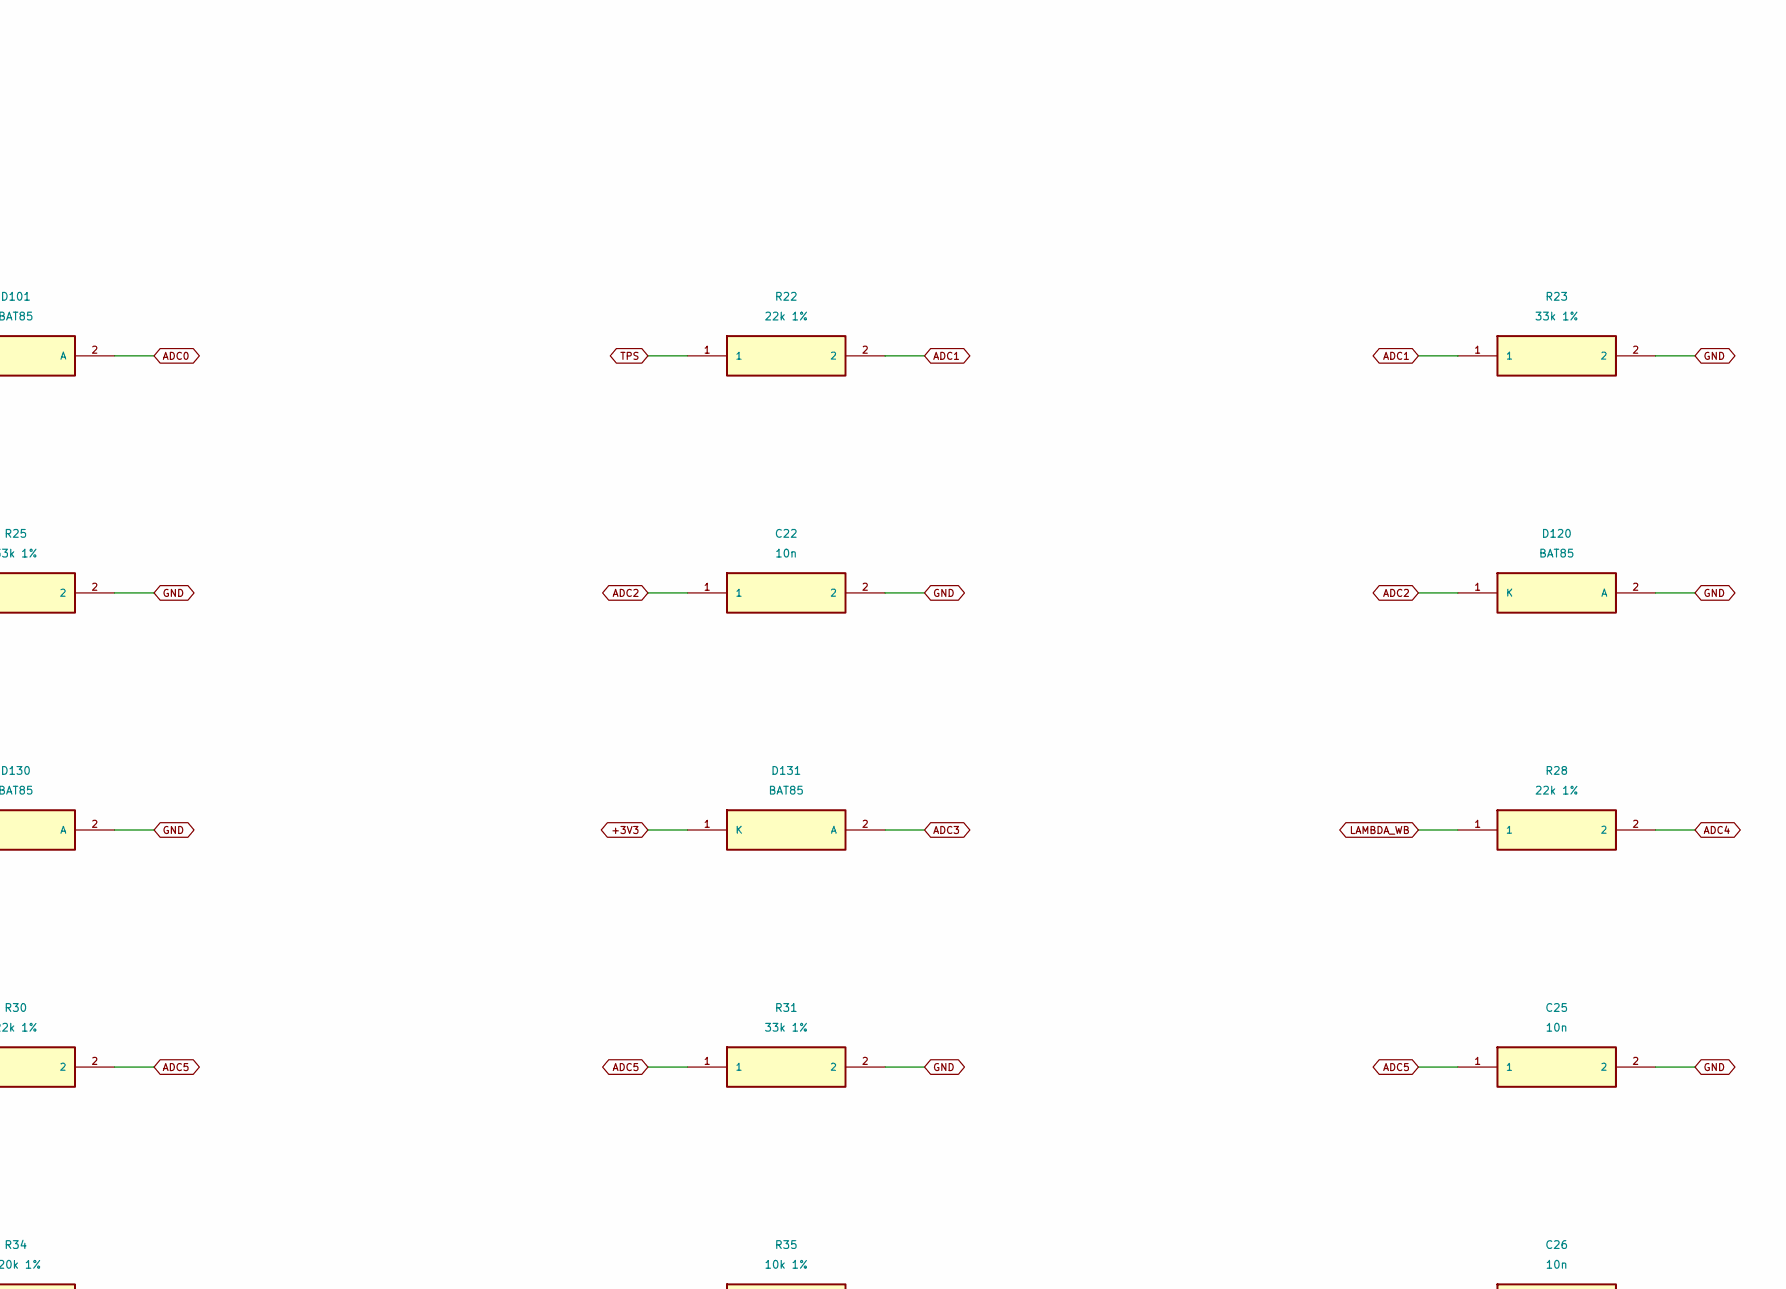
[picture p169: schematic analog.kicad_sch, ESP32 ECU A5 IDLE INTERFACE HOLD / analog, part in row 1, column 3]

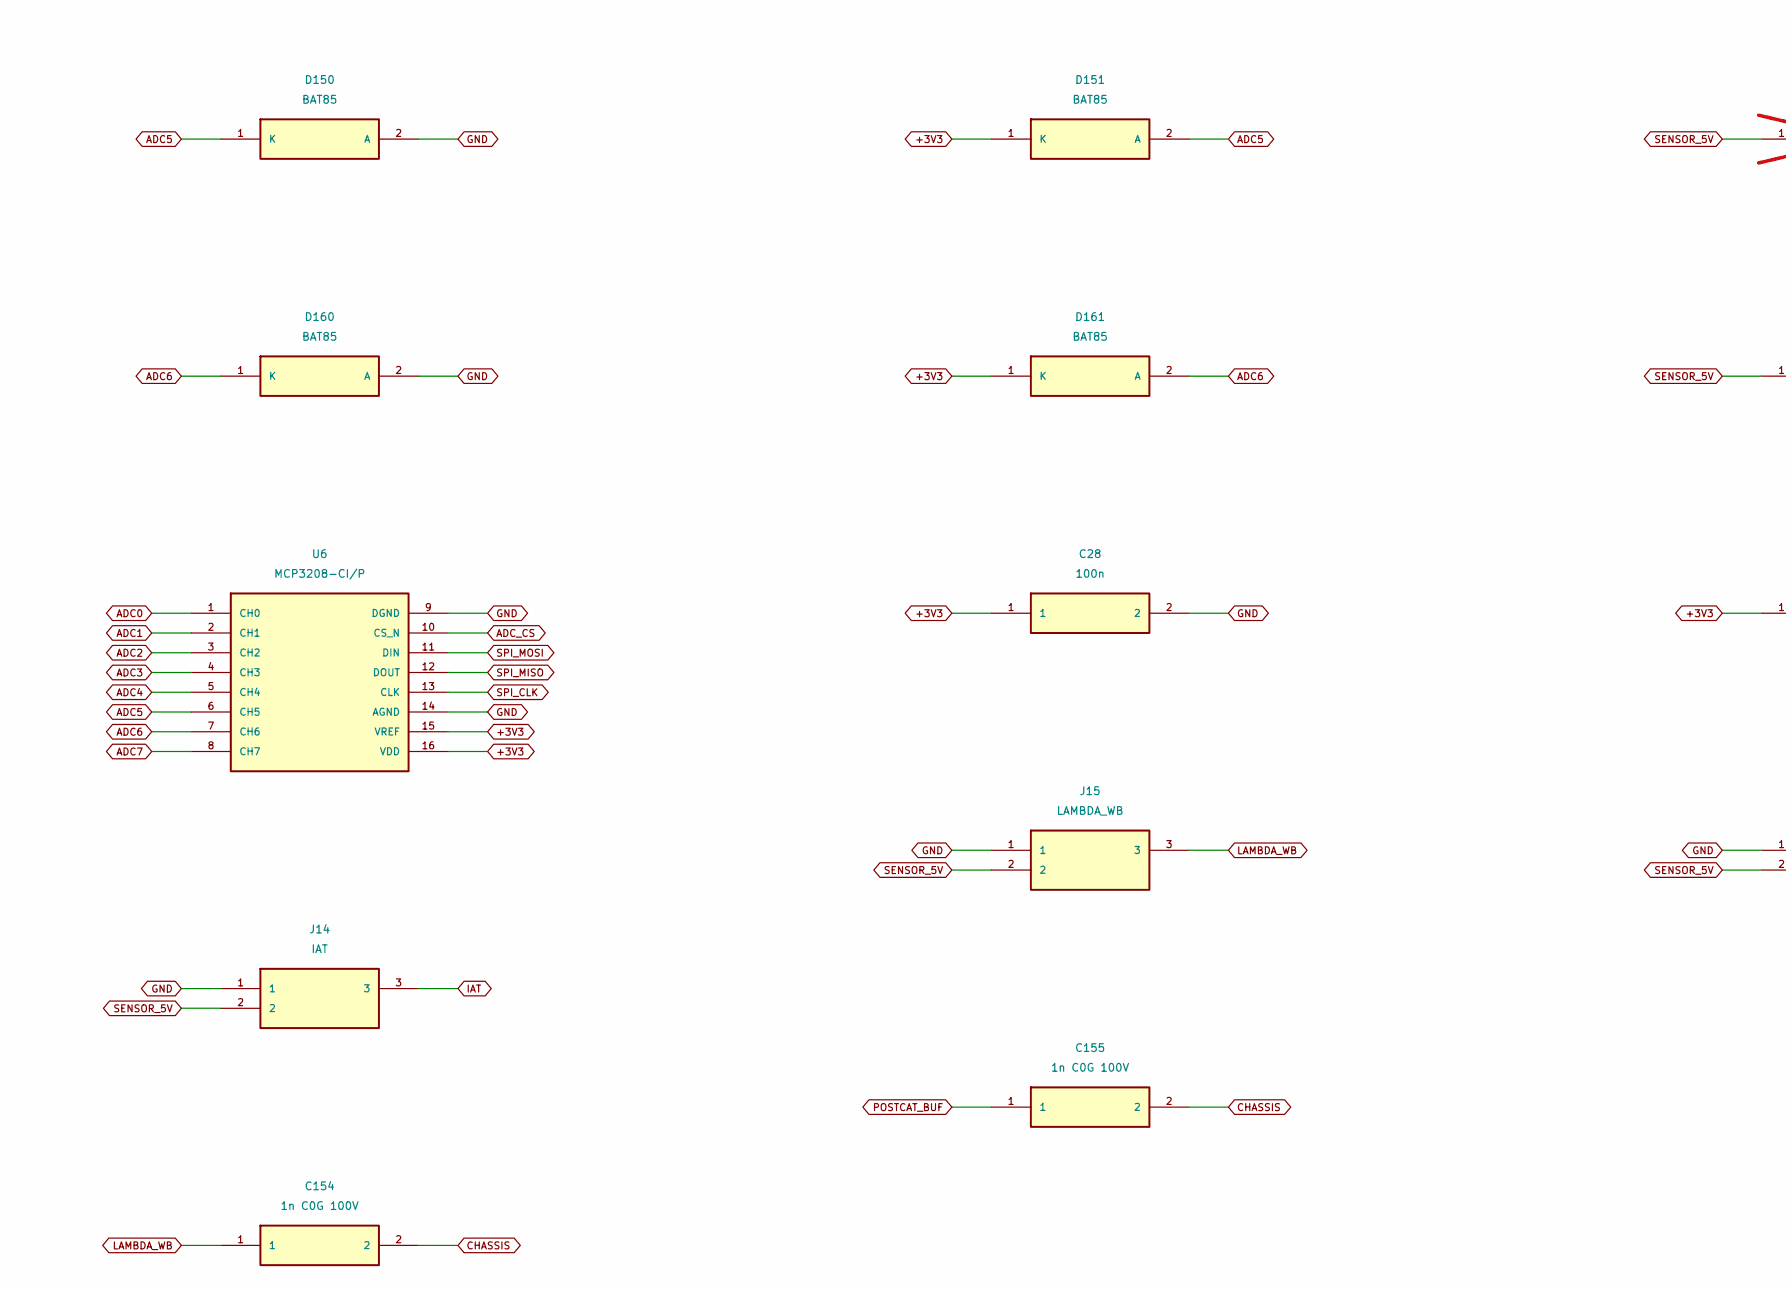
[picture p170: schematic analog.kicad_sch, ESP32 ECU A5 IDLE INTERFACE HOLD / analog, part in row 2, column 1]

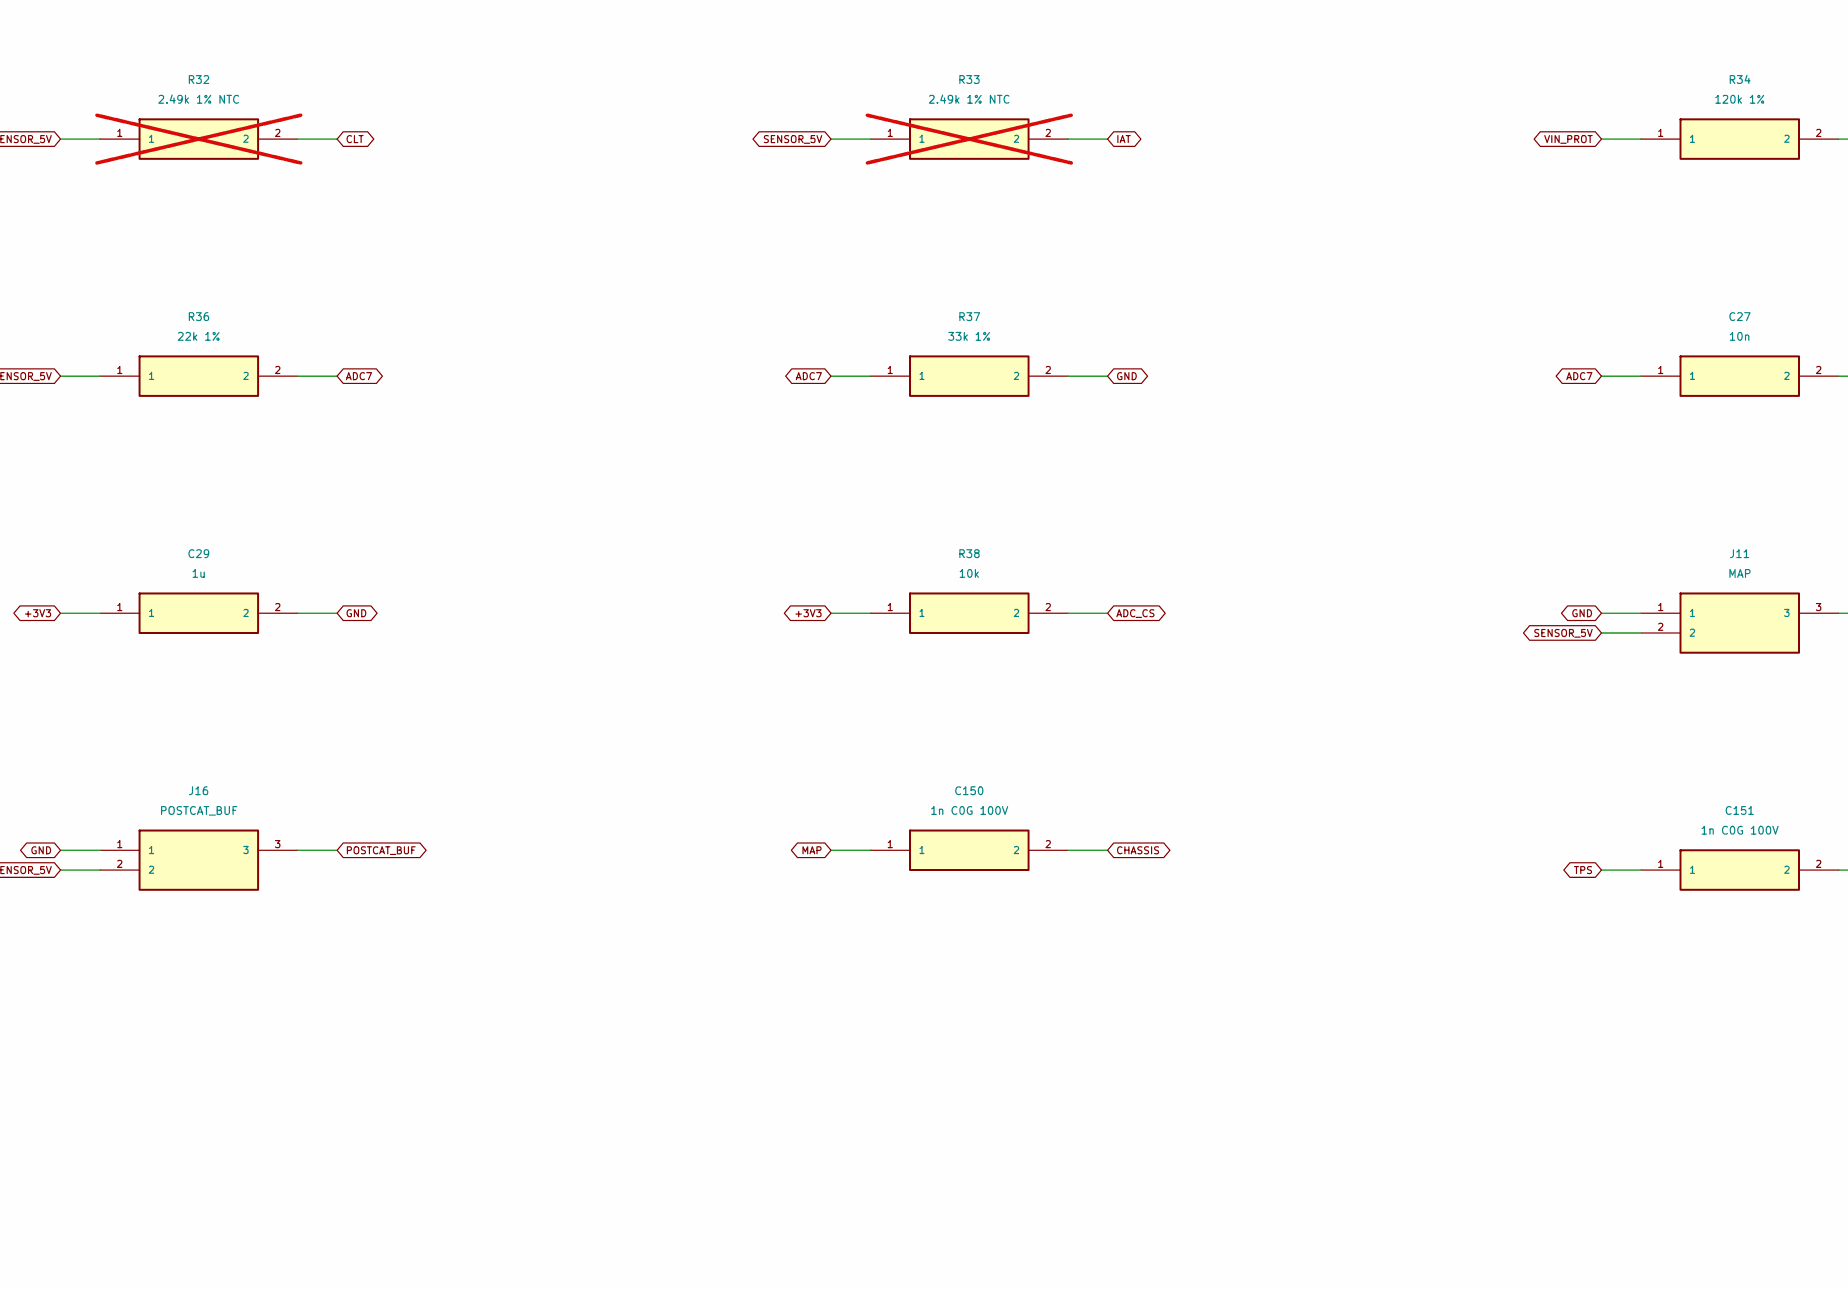
[picture p171: schematic analog.kicad_sch, ESP32 ECU A5 IDLE INTERFACE HOLD / analog, part in row 2, column 2]

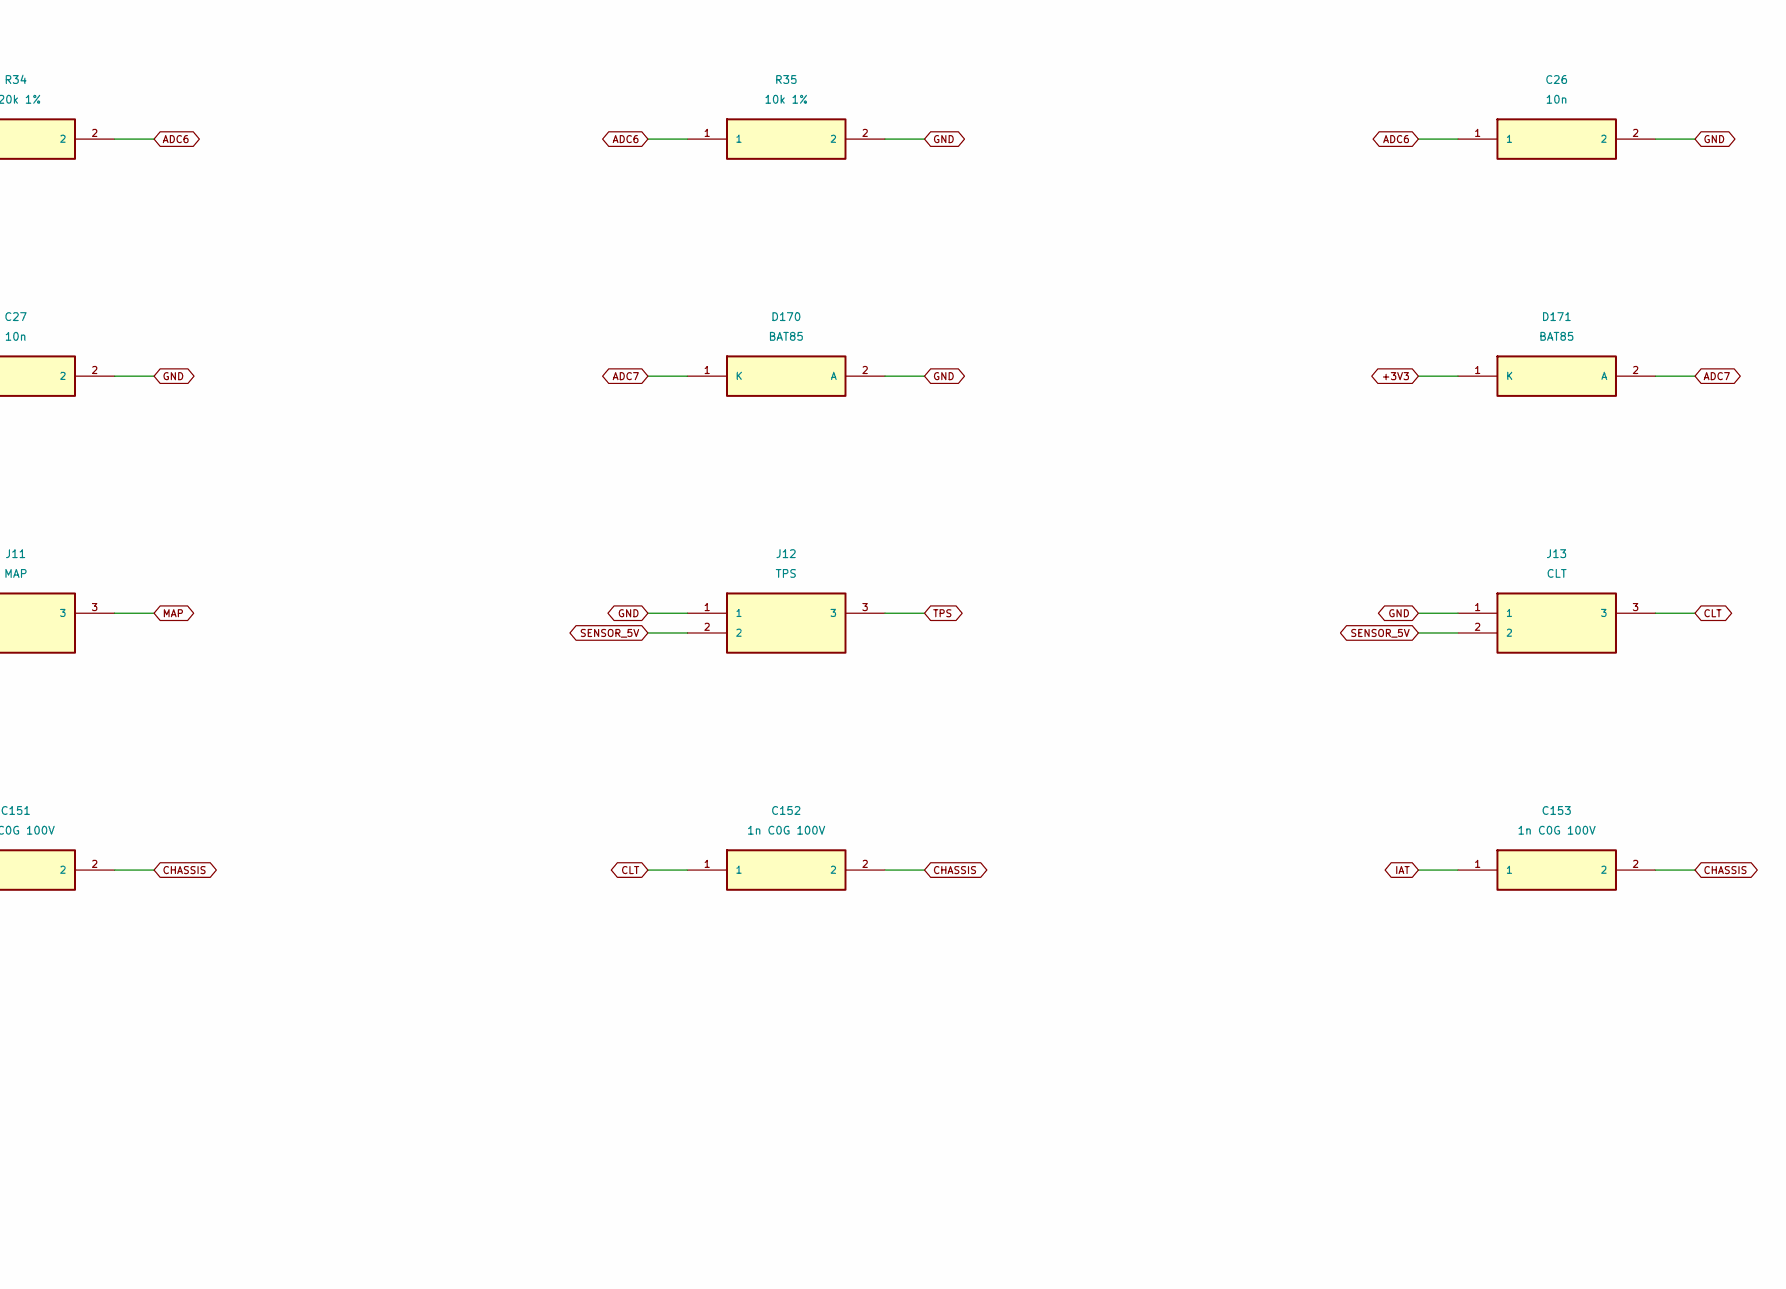
[picture p172: schematic analog.kicad_sch, ESP32 ECU A5 IDLE INTERFACE HOLD / analog, part in row 2, column 3]

Parts:
C20, C21, C22, C23, C24, C25, C26, C27: 10n; C_Disc_D5.0mm_W2.5mm_P5.00mm
C28: 100n; C_Disc_D5.0mm_W2.5mm_P5.00mm
C29: 1u; C_Rect_L7.2mm_W5.0mm_P5.00mm
C150, C151, C152, C153, C154, C155: 1n C0G 100V; C_Disc_D5.0mm_W2.5mm_P5.00mm
D100, D101, D110, D111, D120, D121, D130, D131, D140, D141, D150, D151, D160, D161, D170, D171: BAT85; D_DO-35_SOD27_P3.81mm_Vertical_AnodeUp; MPN BAT85,113
J11: MAP; JST_XH_B3B-XH-A_1x03_P2.50mm_Vertical; MPN B3B-XH-A(LF)(SN)
J12: TPS; JST_XH_B3B-XH-A_1x03_P2.50mm_Vertical; MPN B3B-XH-A(LF)(SN)
J13: CLT; JST_XH_B3B-XH-A_1x03_P2.50mm_Vertical; MPN B3B-XH-A(LF)(SN)
J14: IAT; JST_XH_B3B-XH-A_1x03_P2.50mm_Vertical; MPN B3B-XH-A(LF)(SN)
J15: LAMBDA_WB; JST_XH_B3B-XH-A_1x03_P2.50mm_Vertical; MPN B3B-XH-A(LF)(SN)
J16: POSTCAT_BUF; JST_XH_B3B-XH-A_1x03_P2.50mm_Vertical; MPN B3B-XH-A(LF)(SN)
R20, R22, R24, R26, R28, R30, R36: 22k 1%; R_Axial_DIN0207_L6.3mm_D2.5mm_P2.54mm_Vertical
R21, R23, R25, R27, R29, R31, R37: 33k 1%; R_Axial_DIN0207_L6.3mm_D2.5mm_P2.54mm_Vertical
R32, R33: 2.49k 1% NTC; R_Axial_DIN0207_L6.3mm_D2.5mm_P2.54mm_Vertical; not fitted
R34: 120k 1%; R_Axial_DIN0207_L6.3mm_D2.5mm_P2.54mm_Vertical
R35: 10k 1%; R_Axial_DIN0207_L6.3mm_D2.5mm_P2.54mm_Vertical
R38: 10k; R_Axial_DIN0207_L6.3mm_D2.5mm_P2.54mm_Vertical
U6: MCP3208-CI/P; DIP-16_W7.62mm_LongPads; MPN MCP3208-CI/P

Connections:
+3V3: C28.1, C29.1, D101.1 (K), D111.1 (K), D121.1 (K), D131.1 (K), D141.1 (K), D151.1 (K), D161.1 (K), D171.1 (K), R38.1, U6.15 (VREF), U6.16 (VDD); also elsewhere on the board
ADC0: C20.1, D100.1 (K), D101.2 (A), R20.2, R21.1, U6.1 (CH0)
ADC1: C21.1, D110.1 (K), D111.2 (A), R22.2, R23.1, U6.2 (CH1)
ADC2: C22.1, D120.1 (K), D121.2 (A), R24.2, R25.1, U6.3 (CH2)
ADC3: C23.1, D130.1 (K), D131.2 (A), R26.2, R27.1, U6.4 (CH3)
ADC4: C24.1, D140.1 (K), D141.2 (A), R28.2, R29.1, U6.5 (CH4)
ADC5: C25.1, D150.1 (K), D151.2 (A), R30.2, R31.1, U6.6 (CH5)
ADC6: C26.1, D160.1 (K), D161.2 (A), R34.2, R35.1, U6.7 (CH6)
ADC7: C27.1, D170.1 (K), D171.2 (A), R36.2, R37.1, U6.8 (CH7)
ADC_CS: R38.2, U6.10 (CS_N); also elsewhere on the board
CHASSIS: C150.2, C151.2, C152.2, C153.2, C154.2, C155.2; also elsewhere on the board
CLT: C152.1, J13.3, R24.1, R32.2
GND: C20.2, C21.2, C22.2, C23.2, C24.2, C25.2, C26.2, C27.2, C28.2, C29.2, D100.2 (A), D110.2 (A), D120.2 (A), D130.2 (A), D140.2 (A), D150.2 (A), D160.2 (A), D170.2 (A), J11.1, J12.1, J13.1, J14.1, J15.1, J16.1, R21.2, R23.2, R25.2, R27.2, R29.2, R31.2, R35.2, R37.2, U6.9 (DGND), U6.14 (AGND); also elsewhere on the board
IAT: C153.1, J14.3, R26.1, R33.2
LAMBDA_WB: C154.1, J15.3, R28.1
MAP: C150.1, J11.3, R20.1
POSTCAT_BUF: C155.1, J16.3, R30.1
SENSOR_5V: J11.2, J12.2, J13.2, J14.2, J15.2, J16.2, R32.1, R33.1, R36.1; also elsewhere on the board
SPI_CLK: U6.13 (CLK); also elsewhere on the board
SPI_MISO: U6.12 (DOUT); also elsewhere on the board
SPI_MOSI: U6.11 (DIN); also elsewhere on the board
TPS: C151.1, J12.3, R22.1
VIN_PROT: R34.1; also elsewhere on the board

Notes on the sheet:
0-5 V conditioned signals only. J5 lambda must come from an external wideband controller. NTC pullups DNP until sensor curves are known.
