markthebault/esp32-ecu/hardware/a5-idle-interface/esp32-ecu.kicad_pcb

## KiCad design hardware/a5-idle-interface/esp32-ecu.kicad_pcb (continued)

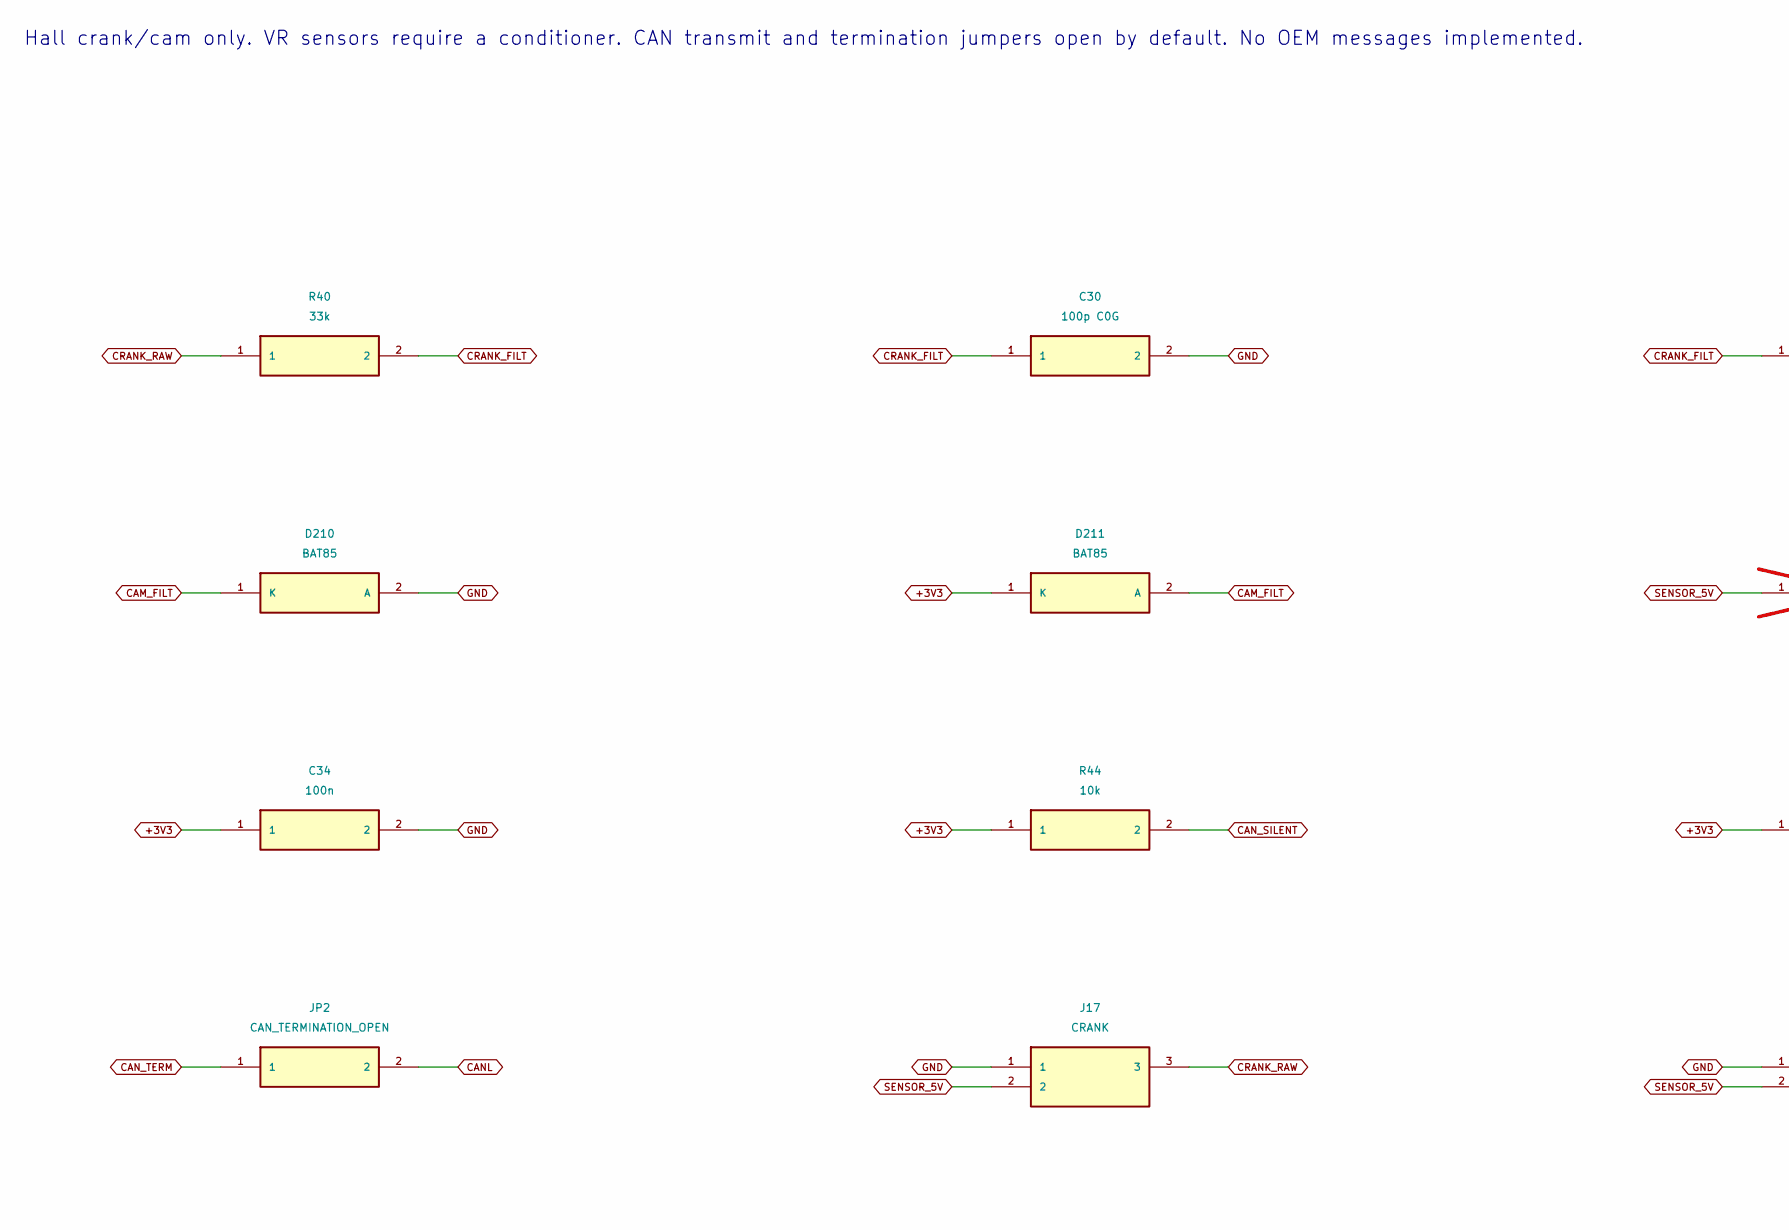
[picture p173: schematic trigger_can.kicad_sch, ESP32 ECU A5 IDLE INTERFACE HOLD / trigger_can, part in row 1, column 1]

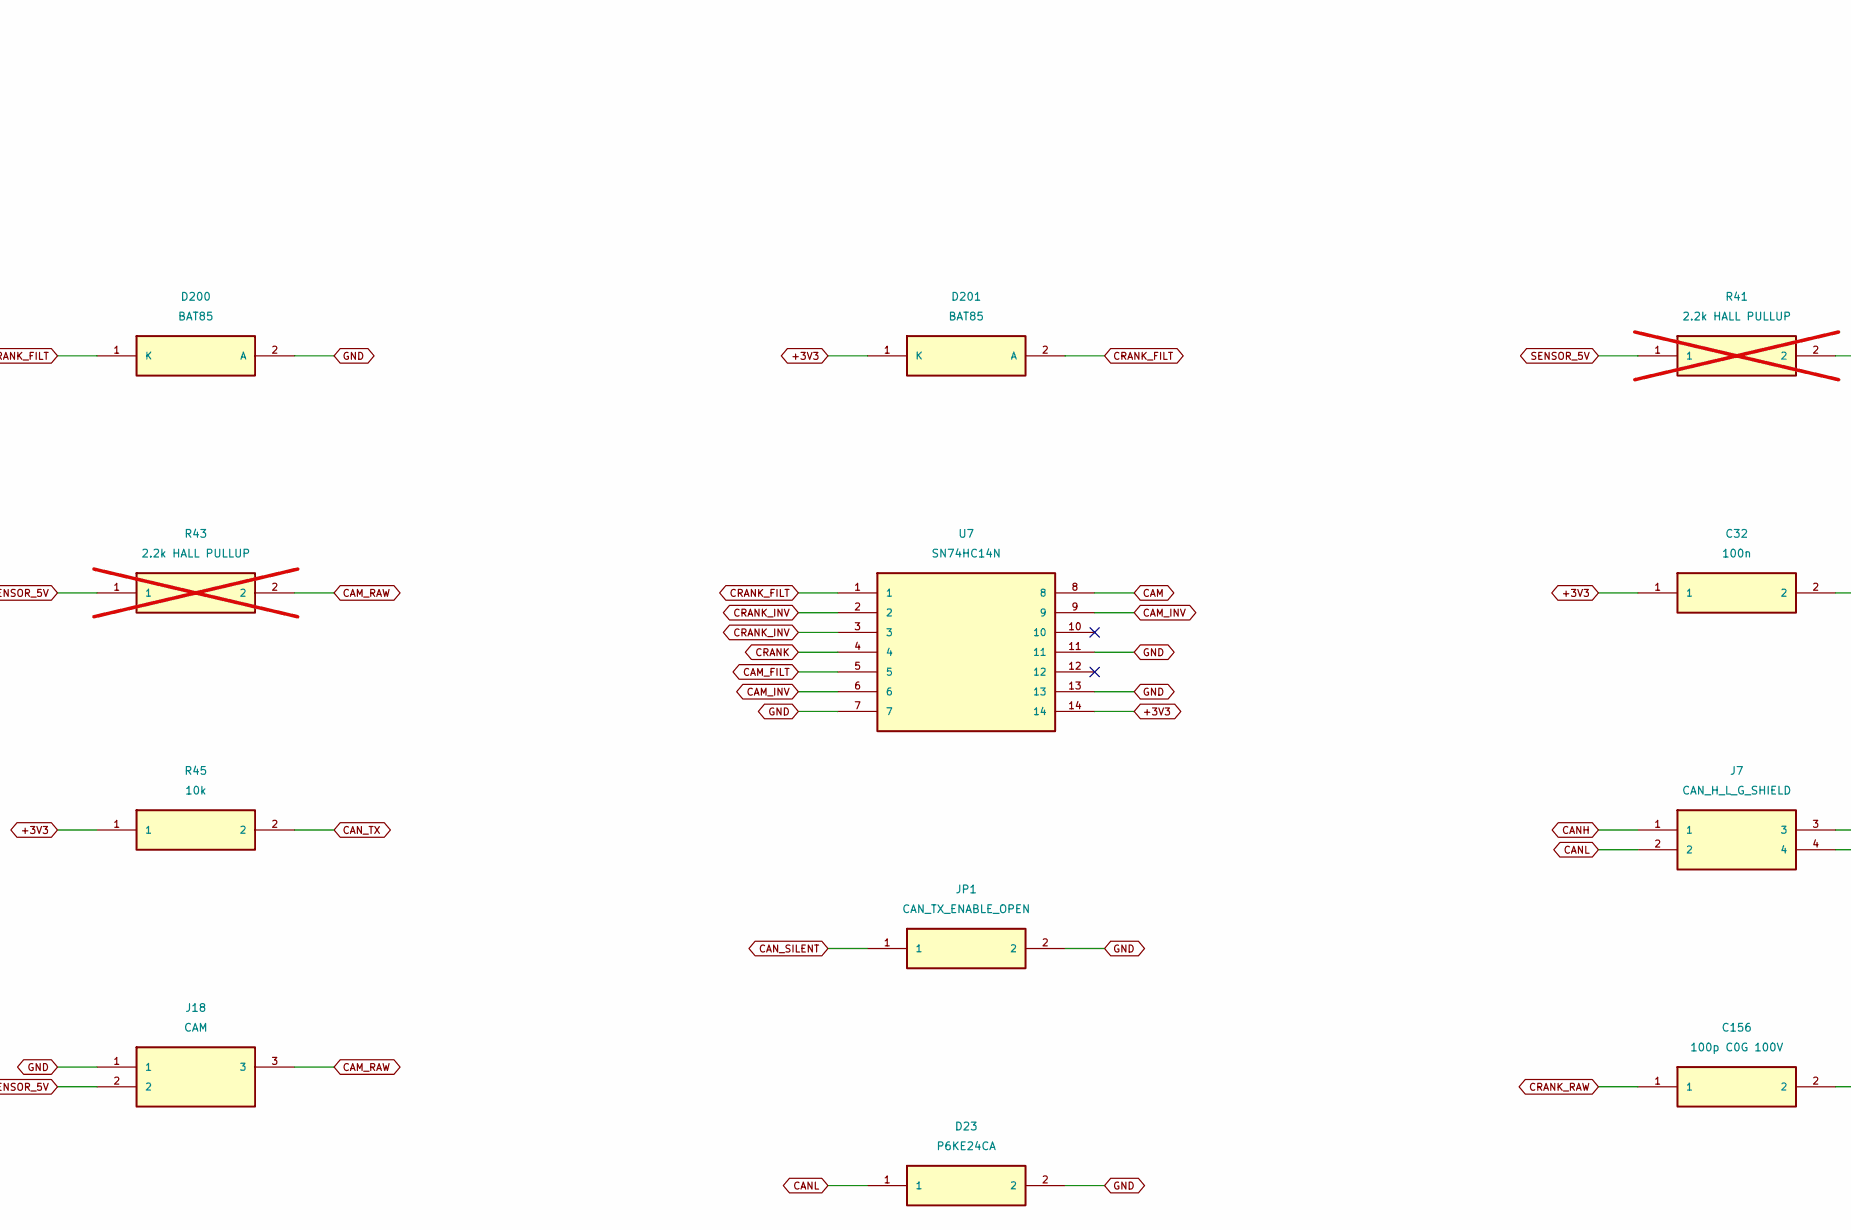
[picture p174: schematic trigger_can.kicad_sch, ESP32 ECU A5 IDLE INTERFACE HOLD / trigger_can, part in row 1, column 2]

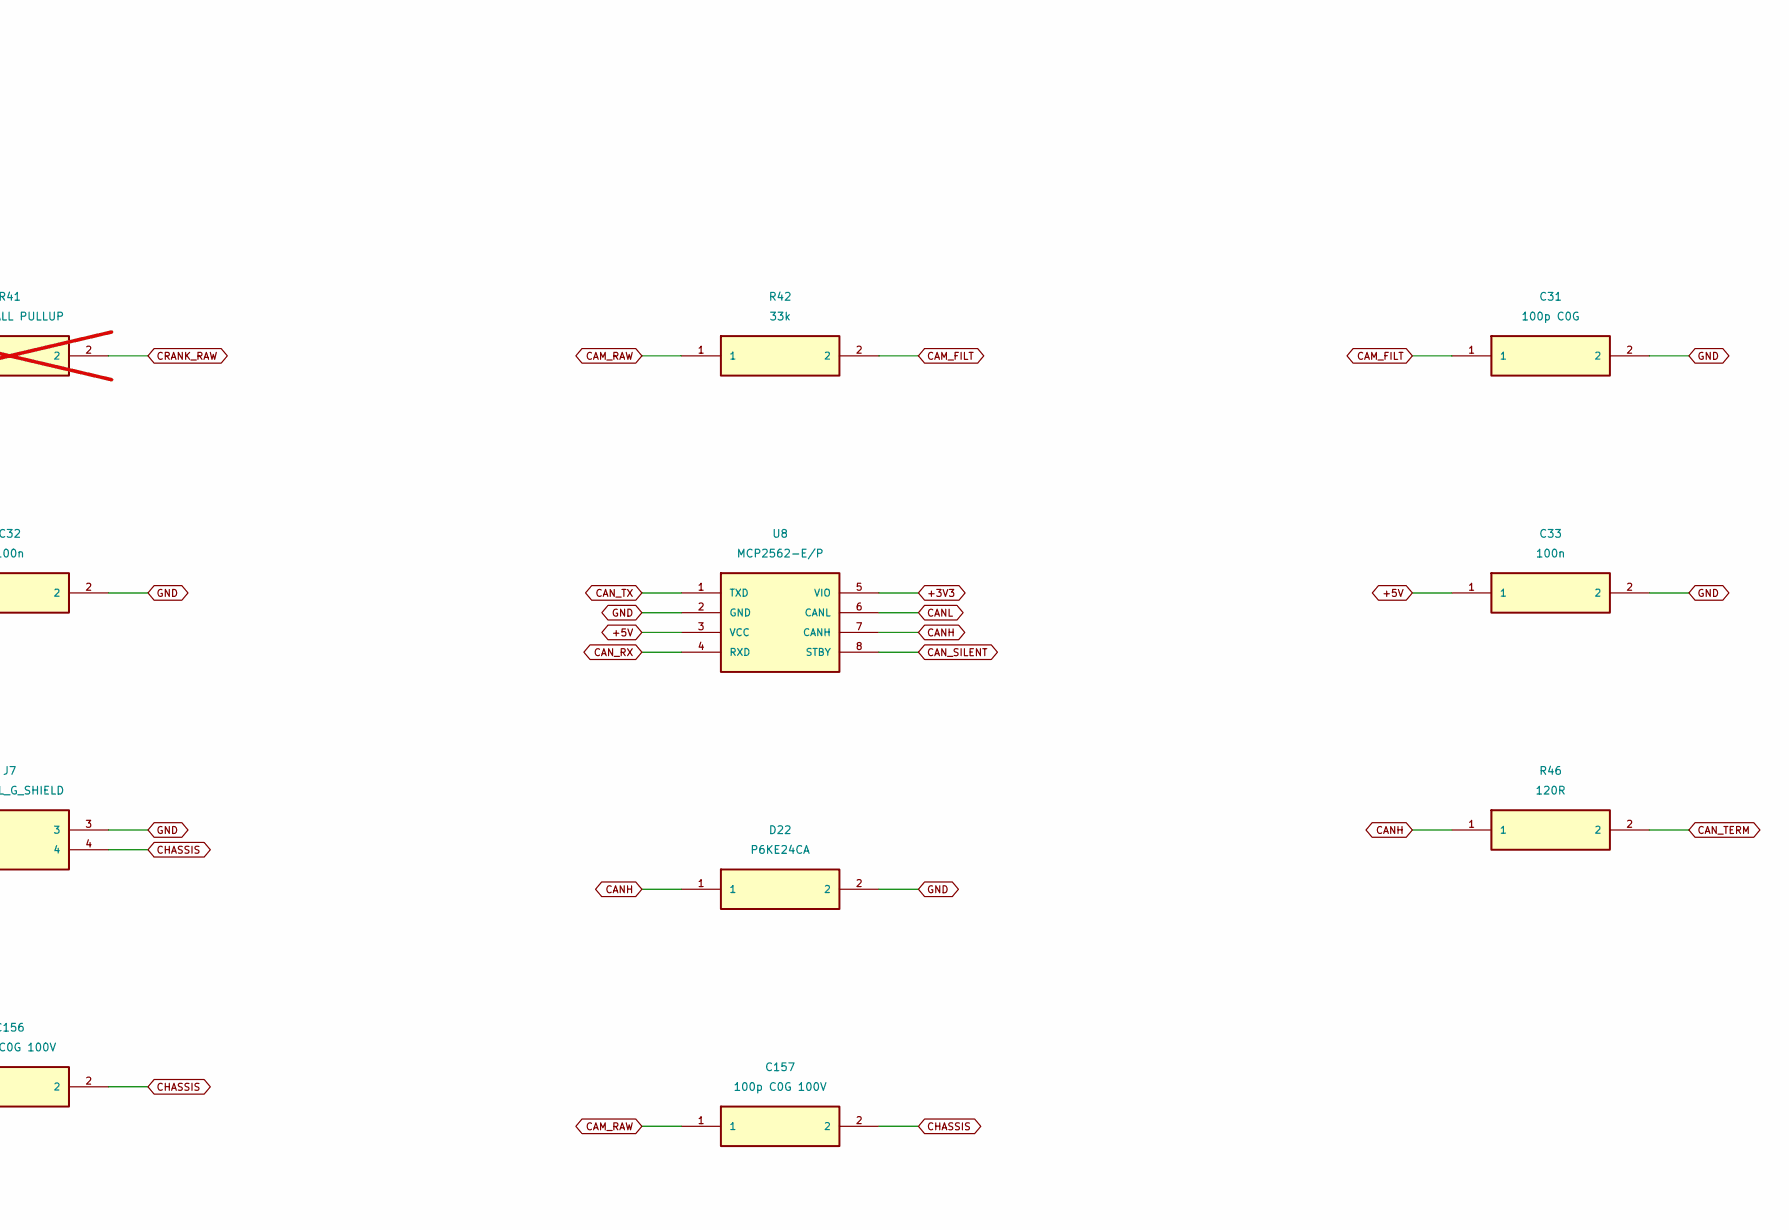
[picture p175: schematic trigger_can.kicad_sch, ESP32 ECU A5 IDLE INTERFACE HOLD / trigger_can, part in row 1, column 3]

Parts:
C30, C31: 100p C0G; C_Disc_D5.0mm_W2.5mm_P5.00mm
C32, C33, C34: 100n; C_Disc_D5.0mm_W2.5mm_P5.00mm
C156, C157: 100p C0G 100V; C_Disc_D5.0mm_W2.5mm_P5.00mm
D22, D23: P6KE24CA; D_DO-15_P12.70mm_Horizontal; MPN P6KE24CA
D200, D201, D210, D211: BAT85; D_DO-35_SOD27_P3.81mm_Vertical_AnodeUp; MPN BAT85,113
J7: CAN_H_L_G_SHIELD; JST_XH_B4B-XH-A_1x04_P2.50mm_Vertical; MPN B4B-XH-A(LF)(SN)
J17: CRANK; JST_XH_B3B-XH-A_1x03_P2.50mm_Vertical; MPN B3B-XH-A(LF)(SN)
J18: CAM; JST_XH_B3B-XH-A_1x03_P2.50mm_Vertical; MPN B3B-XH-A(LF)(SN)
JP1: CAN_TX_ENABLE_OPEN; PinHeader_1x02_P2.54mm_Vertical
JP2: CAN_TERMINATION_OPEN; PinHeader_1x02_P2.54mm_Vertical
R40, R42: 33k; R_Axial_DIN0207_L6.3mm_D2.5mm_P2.54mm_Vertical
R41, R43: 2.2k HALL PULLUP; R_Axial_DIN0207_L6.3mm_D2.5mm_P2.54mm_Vertical; not fitted
R44, R45: 10k; R_Axial_DIN0207_L6.3mm_D2.5mm_P2.54mm_Vertical
R46: 120R; R_Axial_DIN0207_L6.3mm_D2.5mm_P2.54mm_Vertical
U7: SN74HC14N; DIP-14_W7.62mm_LongPads; MPN SN74HC14N
U8: MCP2562-E/P; DIP-8_W7.62mm_LongPads; MPN MCP2562-E/P

Connections:
+3V3: C32.1, C34.1, D201.1 (K), D211.1 (K), R44.1, R45.1, U7.14, U8.5 (VIO); also elsewhere on the board
+5V: C33.1, U8.3 (VCC); also elsewhere on the board
CAM: U7.8; also elsewhere on the board
CAM_FILT: C31.1, D210.1 (K), D211.2 (A), R42.2, U7.5
CAM_INV: U7.6, U7.9
CAM_RAW: C157.1, J18.3, R42.1, R43.2
CANH: D22.1, J7.1, R46.1, U8.7 (CANH)
CANL: D23.1, J7.2, JP2.2, U8.6 (CANL)
CAN_RX: U8.4 (RXD); also elsewhere on the board
CAN_SILENT: JP1.1, R44.2, U8.8 (STBY)
CAN_TERM: JP2.1, R46.2
CAN_TX: R45.2, U8.1 (TXD); also elsewhere on the board
CHASSIS: C156.2, C157.2, J7.4; also elsewhere on the board
CRANK: U7.4; also elsewhere on the board
CRANK_FILT: C30.1, D200.1 (K), D201.2 (A), R40.2, U7.1
CRANK_INV: U7.2, U7.3
CRANK_RAW: C156.1, J17.3, R40.1, R41.2
GND: C30.2, C31.2, C32.2, C33.2, C34.2, D22.2, D23.2, D200.2 (A), D210.2 (A), J7.3, J17.1, J18.1, JP1.2, U7.7, U7.11, U7.13, U8.2 (GND); also elsewhere on the board
SENSOR_5V: J17.2, J18.2, R41.1, R43.1; also elsewhere on the board

Notes on the sheet:
Hall crank/cam only. VR sensors require a conditioner. CAN transmit and termination jumpers open by default. No OEM messages implemented.

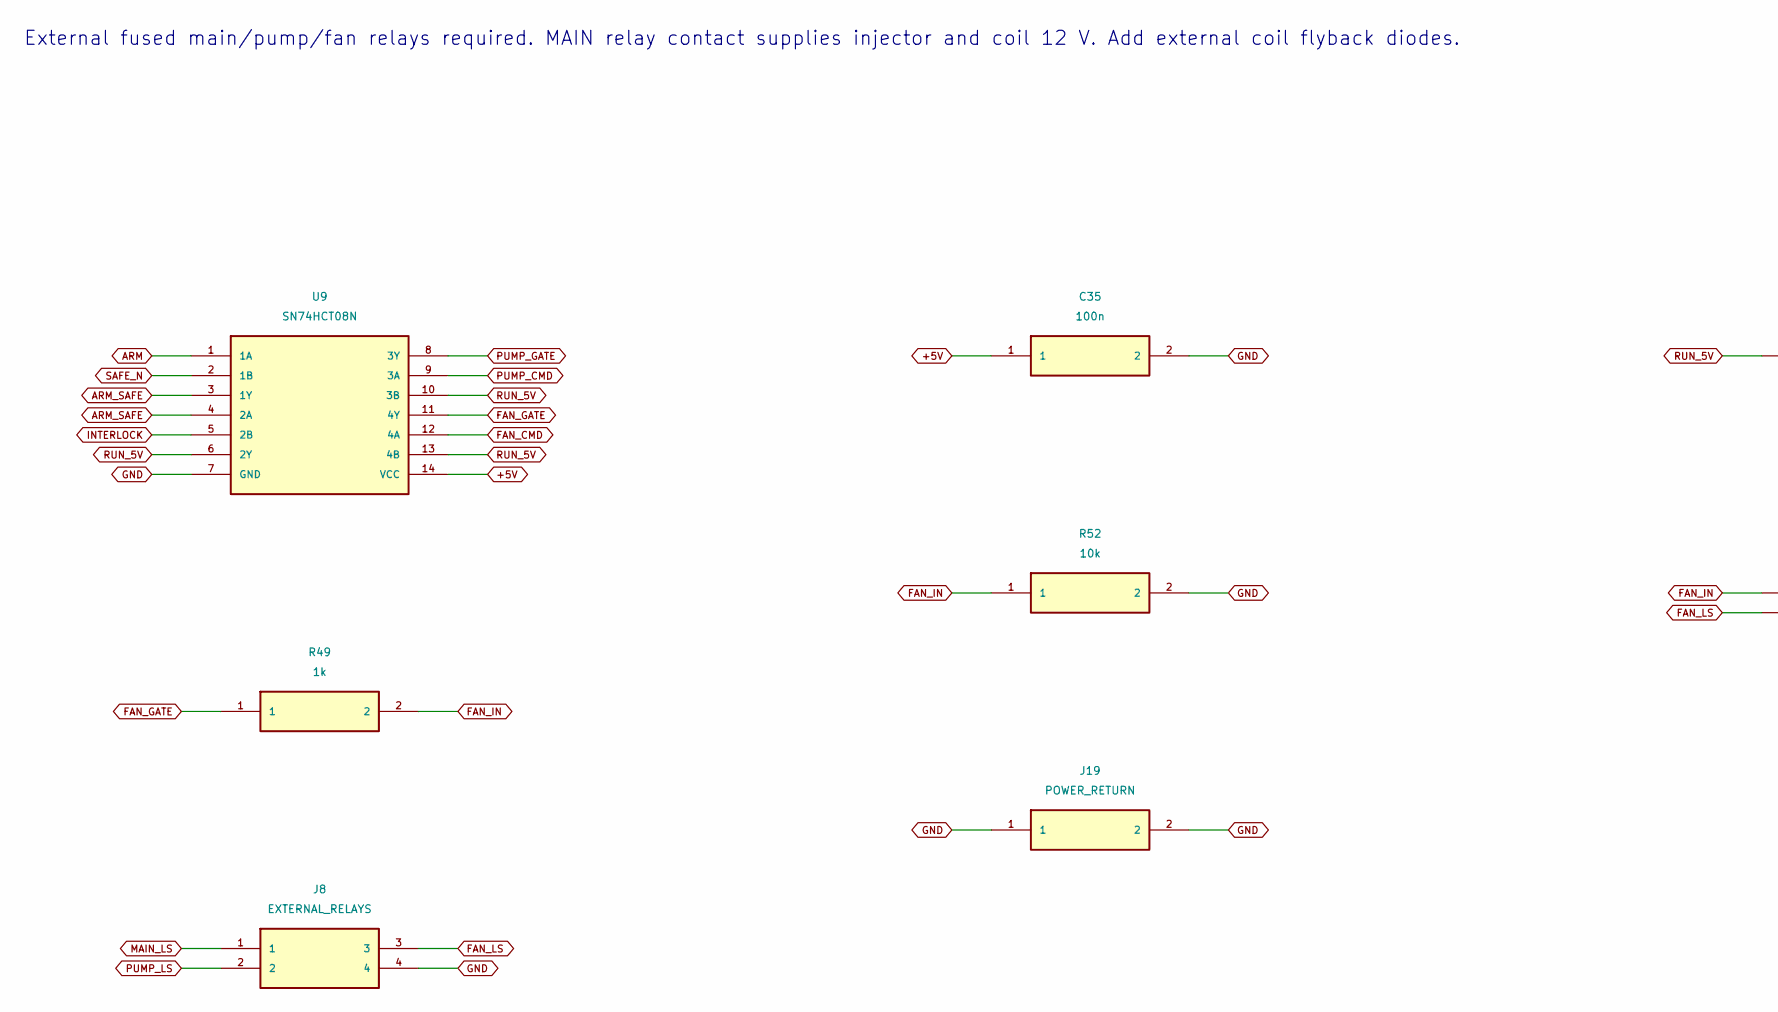
[picture p176: schematic outputs.kicad_sch, ESP32 ECU A5 IDLE INTERFACE HOLD / outputs, part in row 1, column 1]

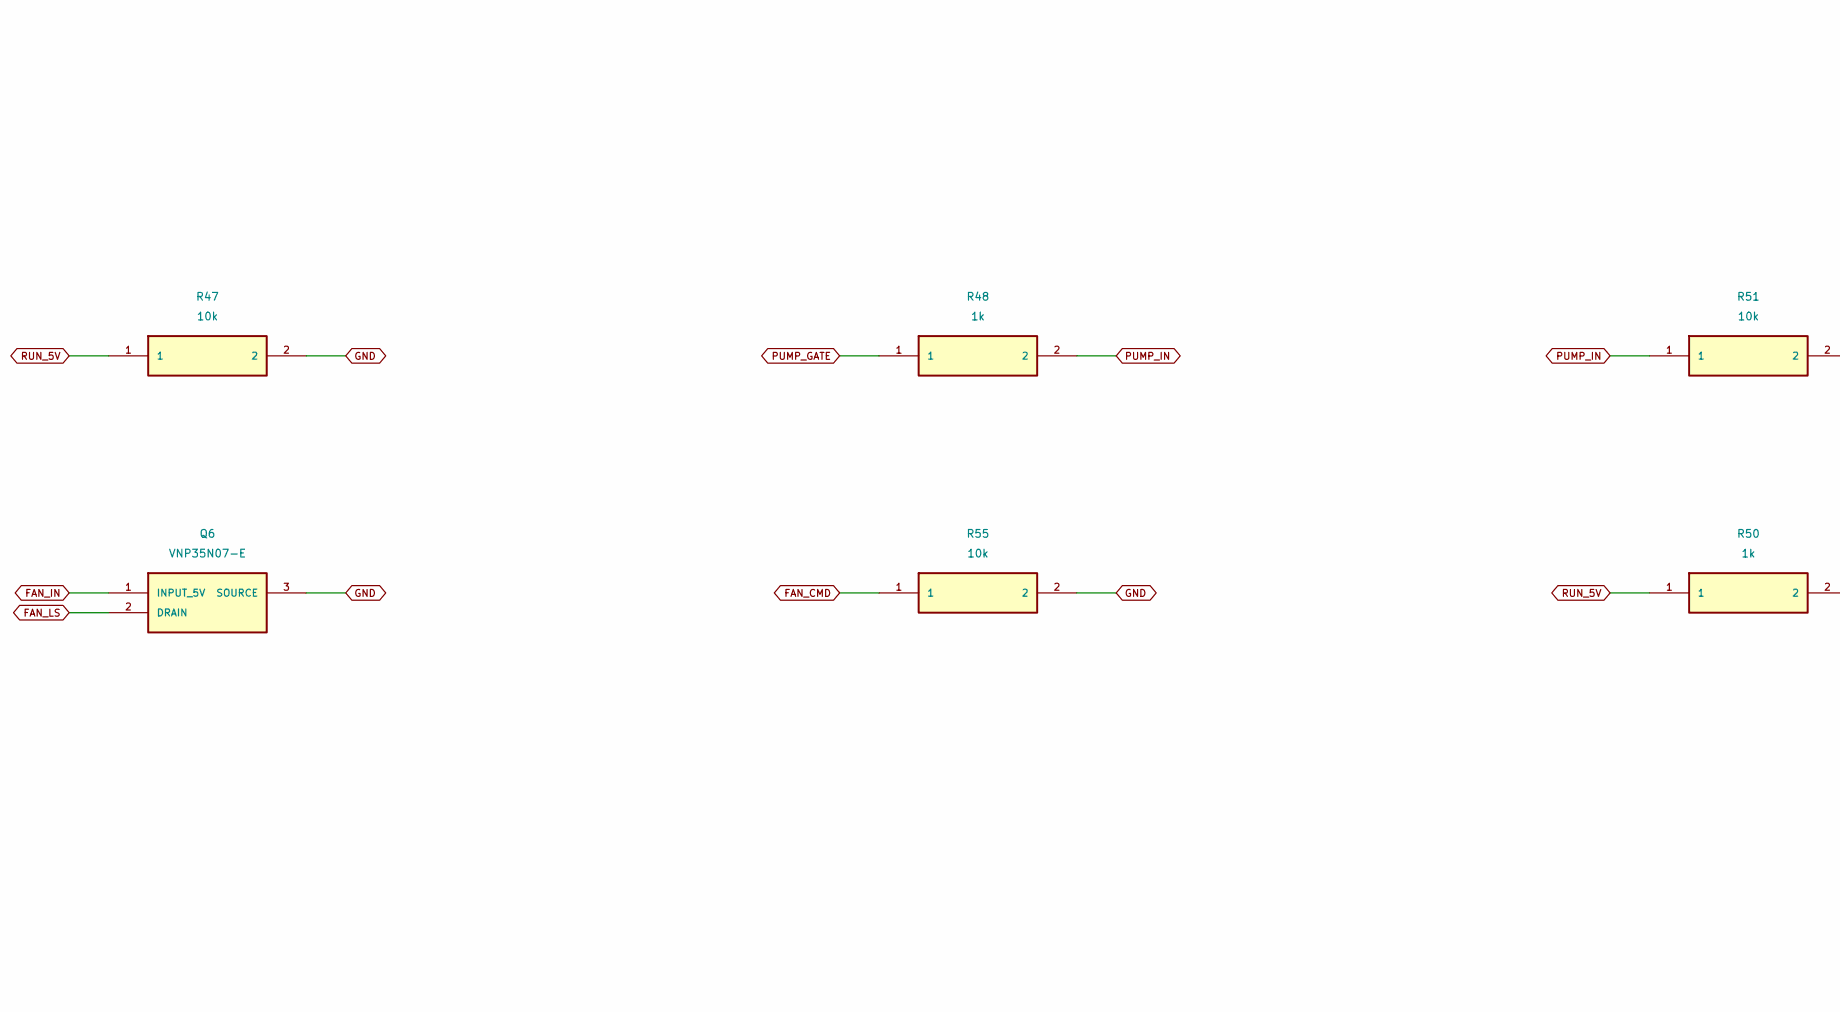
[picture p177: schematic outputs.kicad_sch, ESP32 ECU A5 IDLE INTERFACE HOLD / outputs, part in row 1, column 2]

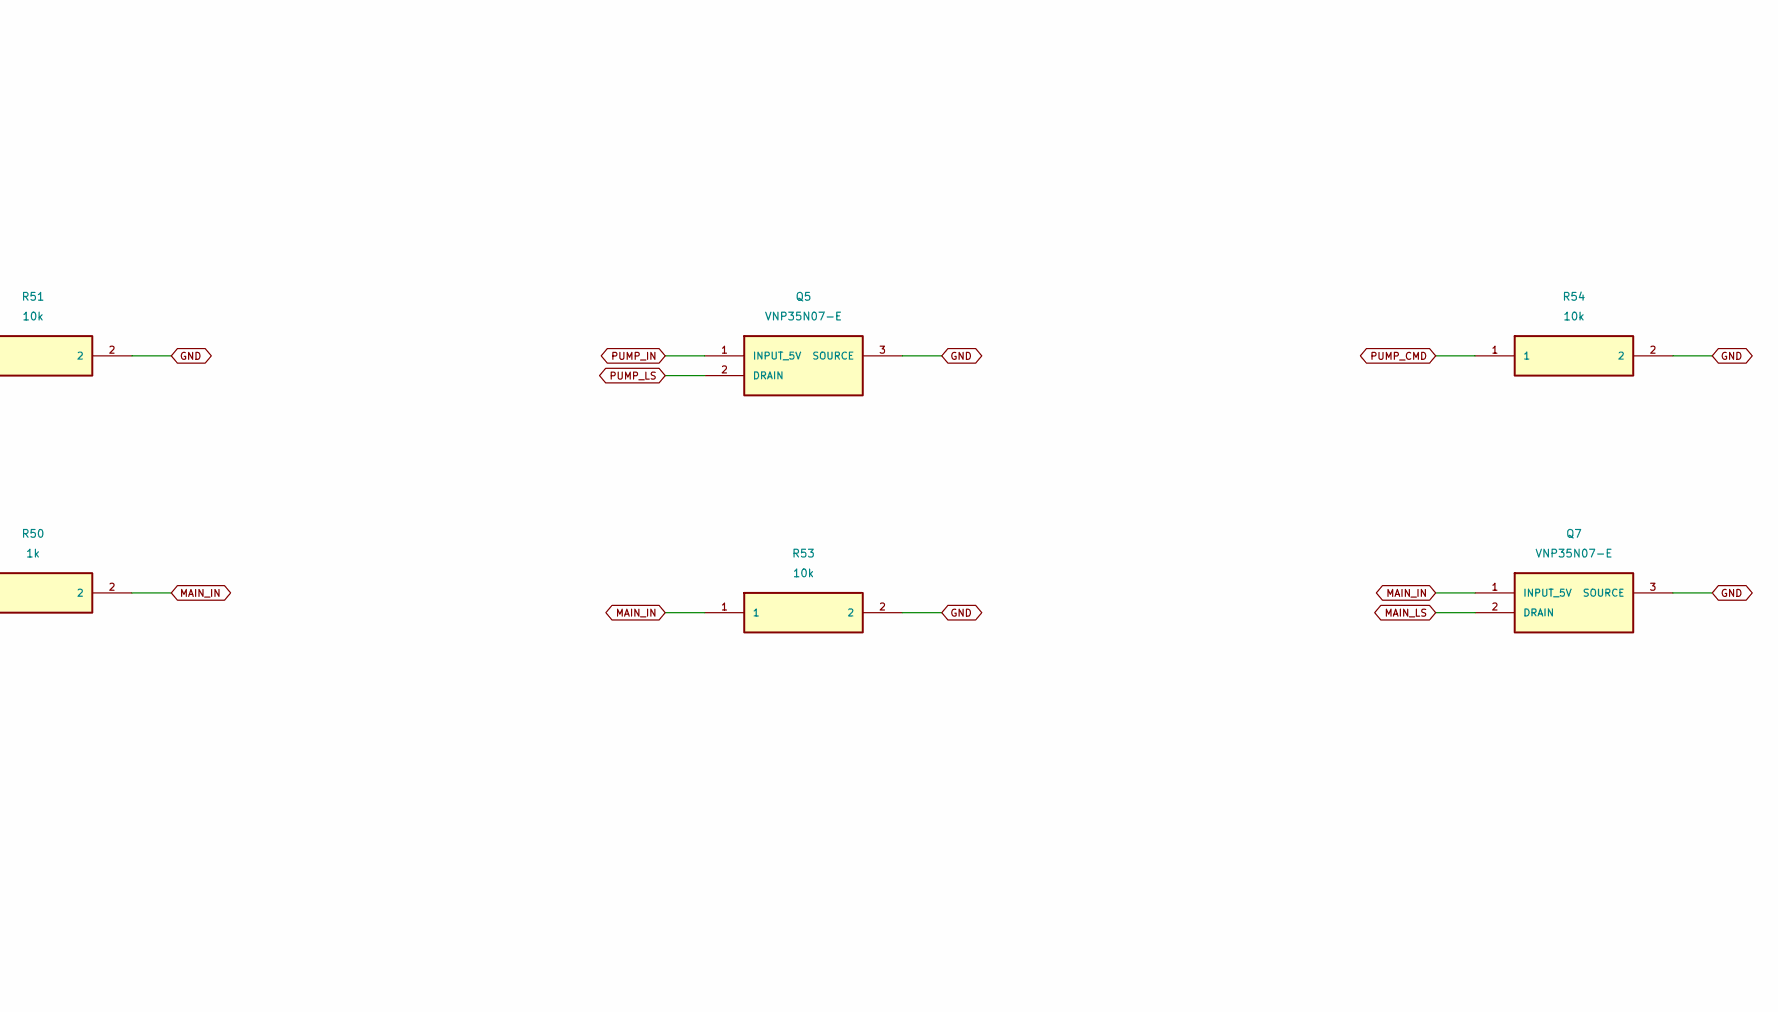
[picture p178: schematic outputs.kicad_sch, ESP32 ECU A5 IDLE INTERFACE HOLD / outputs, part in row 1, column 3]

Parts:
C35: 100n; C_Disc_D5.0mm_W2.5mm_P5.00mm
J8: EXTERNAL_RELAYS; JST_VH_B4P-VH_1x04_P3.96mm_Vertical; MPN B4P-VH(LF)(SN)
J19: POWER_RETURN; JST_VH_B2P-VH_1x02_P3.96mm_Vertical; MPN B2P-VH(LF)(SN)
Q5, Q6, Q7: VNP35N07-E; TO-220-3_Vertical; MPN VNP35N07-E
R47, R51, R52, R53, R54, R55: 10k; R_Axial_DIN0207_L6.3mm_D2.5mm_P2.54mm_Vertical
R48, R49, R50: 1k; R_Axial_DIN0207_L6.3mm_D2.5mm_P2.54mm_Vertical
U9: SN74HCT08N; DIP-14_W7.62mm_LongPads; MPN SN74HCT08N

Connections:
+5V: C35.1, U9.14 (VCC); also elsewhere on the board
ARM: U9.1 (1A); also elsewhere on the board
ARM_SAFE: U9.3 (1Y), U9.4 (2A)
FAN_CMD: R55.1, U9.12 (4A); also elsewhere on the board
FAN_GATE: R49.1, U9.11 (4Y)
FAN_IN: Q6.1 (INPUT_5V), R49.2, R52.1
FAN_LS: J8.3, Q6.2 (DRAIN)
GND: C35.2, J8.4, J19.1, J19.2, Q5.3 (SOURCE), Q6.3 (SOURCE), Q7.3 (SOURCE), R47.2, R51.2, R52.2, R53.2, R54.2, R55.2, U9.7 (GND); also elsewhere on the board
INTERLOCK: U9.5 (2B); also elsewhere on the board
MAIN_IN: Q7.1 (INPUT_5V), R50.2, R53.1
MAIN_LS: J8.1, Q7.2 (DRAIN)
PUMP_CMD: R54.1, U9.9 (3A); also elsewhere on the board
PUMP_GATE: R48.1, U9.8 (3Y)
PUMP_IN: Q5.1 (INPUT_5V), R48.2, R51.1
PUMP_LS: J8.2, Q5.2 (DRAIN)
RUN_5V: R47.1, R50.1, U9.6 (2Y), U9.10 (3B), U9.13 (4B); also elsewhere on the board
SAFE_N: U9.2 (1B); also elsewhere on the board

Notes on the sheet:
External fused main/pump/fan relays required. MAIN relay contact supplies injector and coil 12 V. Add external coil flyback diodes.
