markthebault/esp32-ecu/hardware/a5-idle-interface/esp32-ecu.kicad_pcb

## KiCad design hardware/a5-idle-interface/esp32-ecu.kicad_pcb (continued)

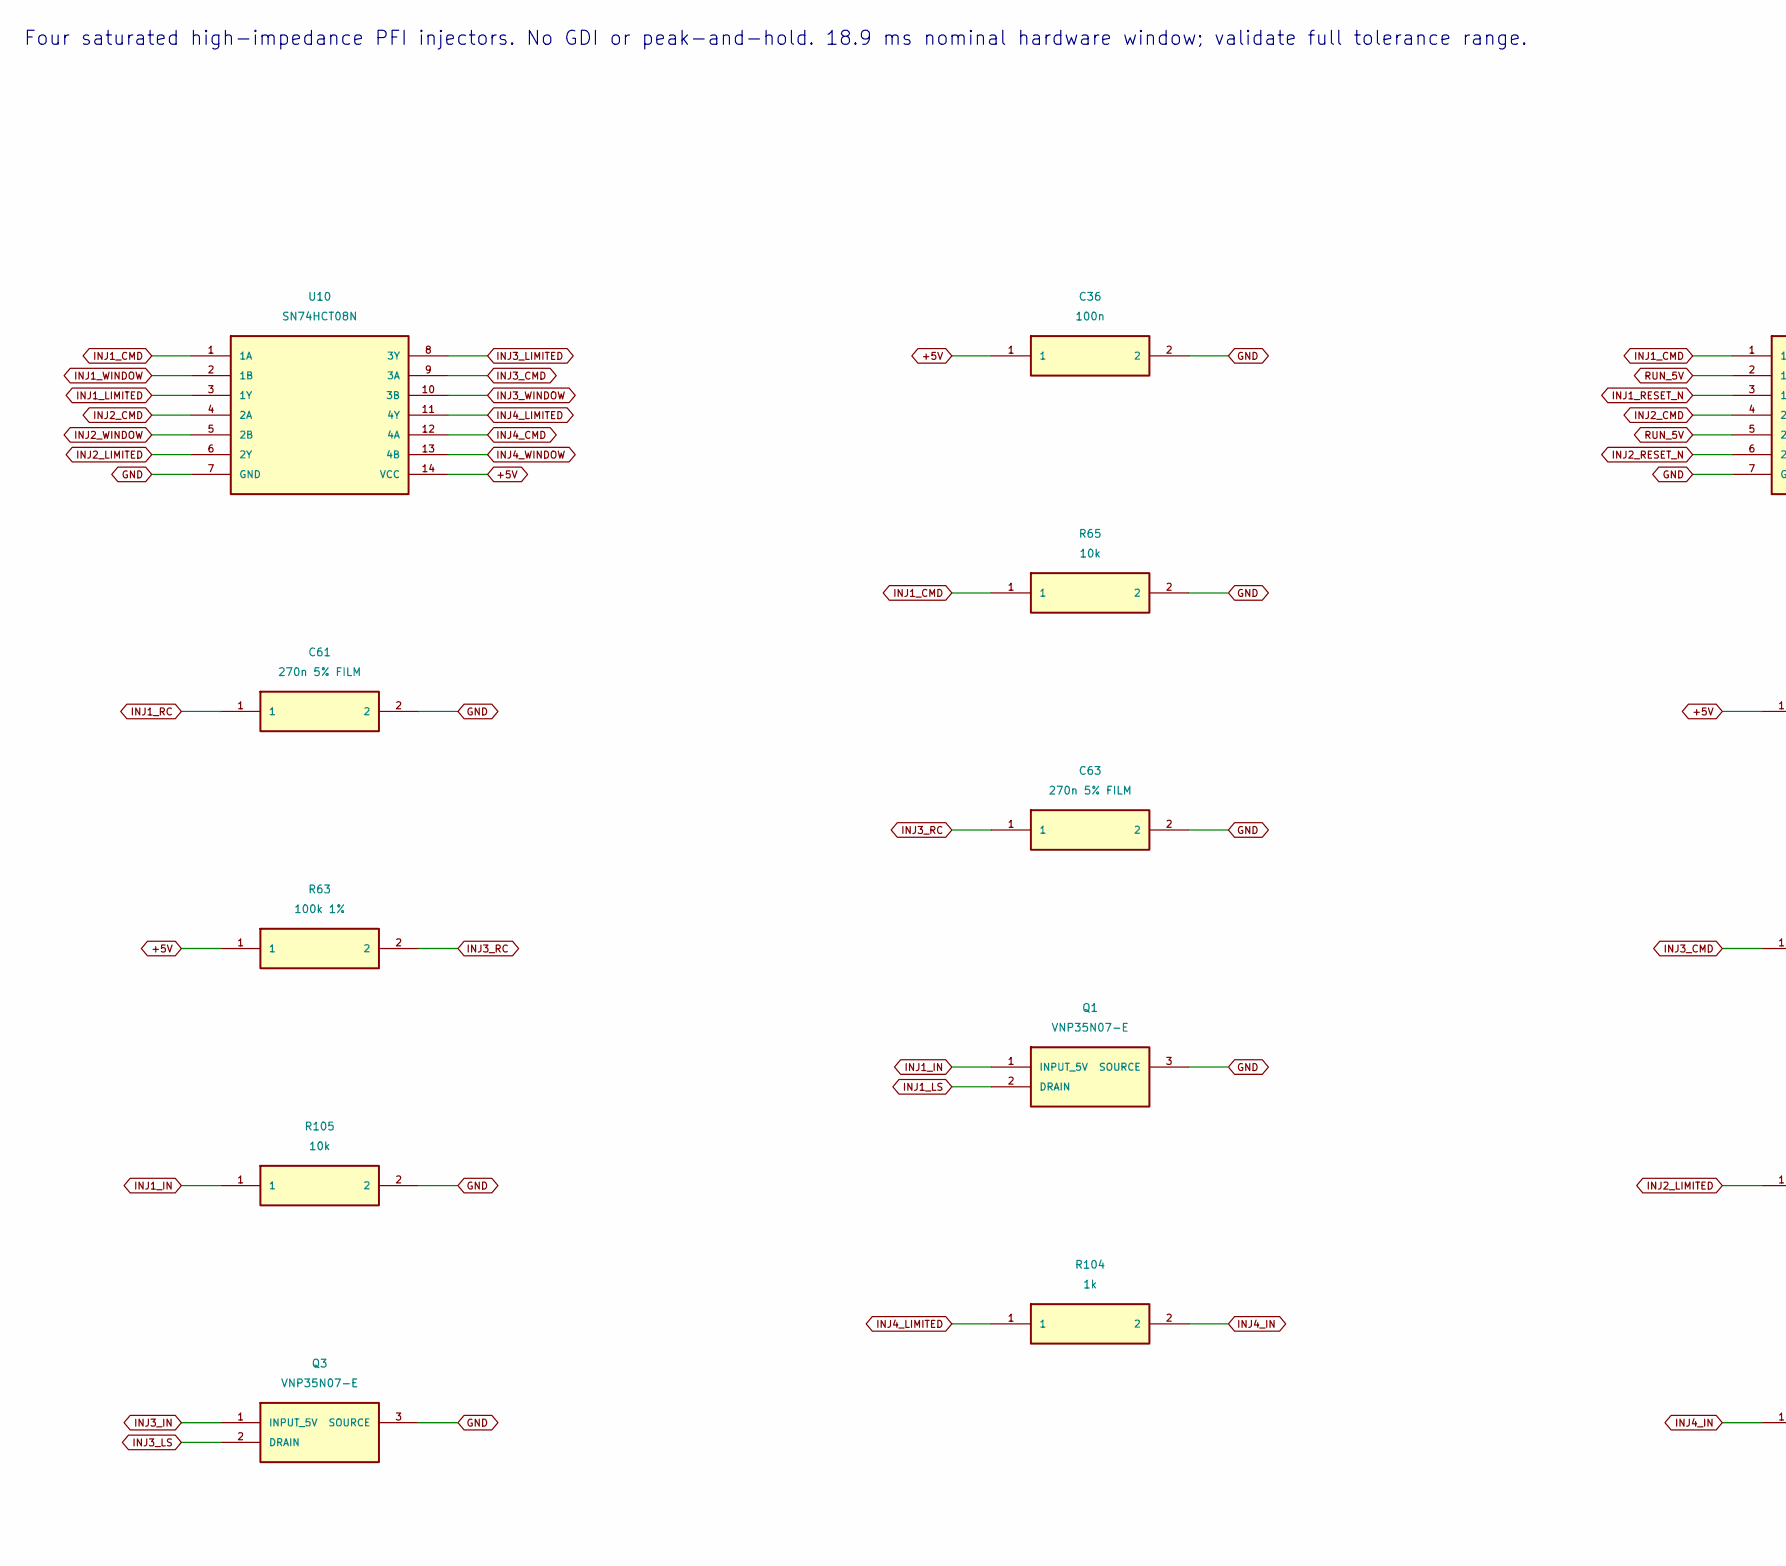
[picture p179: schematic injectors.kicad_sch, ESP32 ECU A5 IDLE INTERFACE HOLD / injectors, part in row 1, column 1]

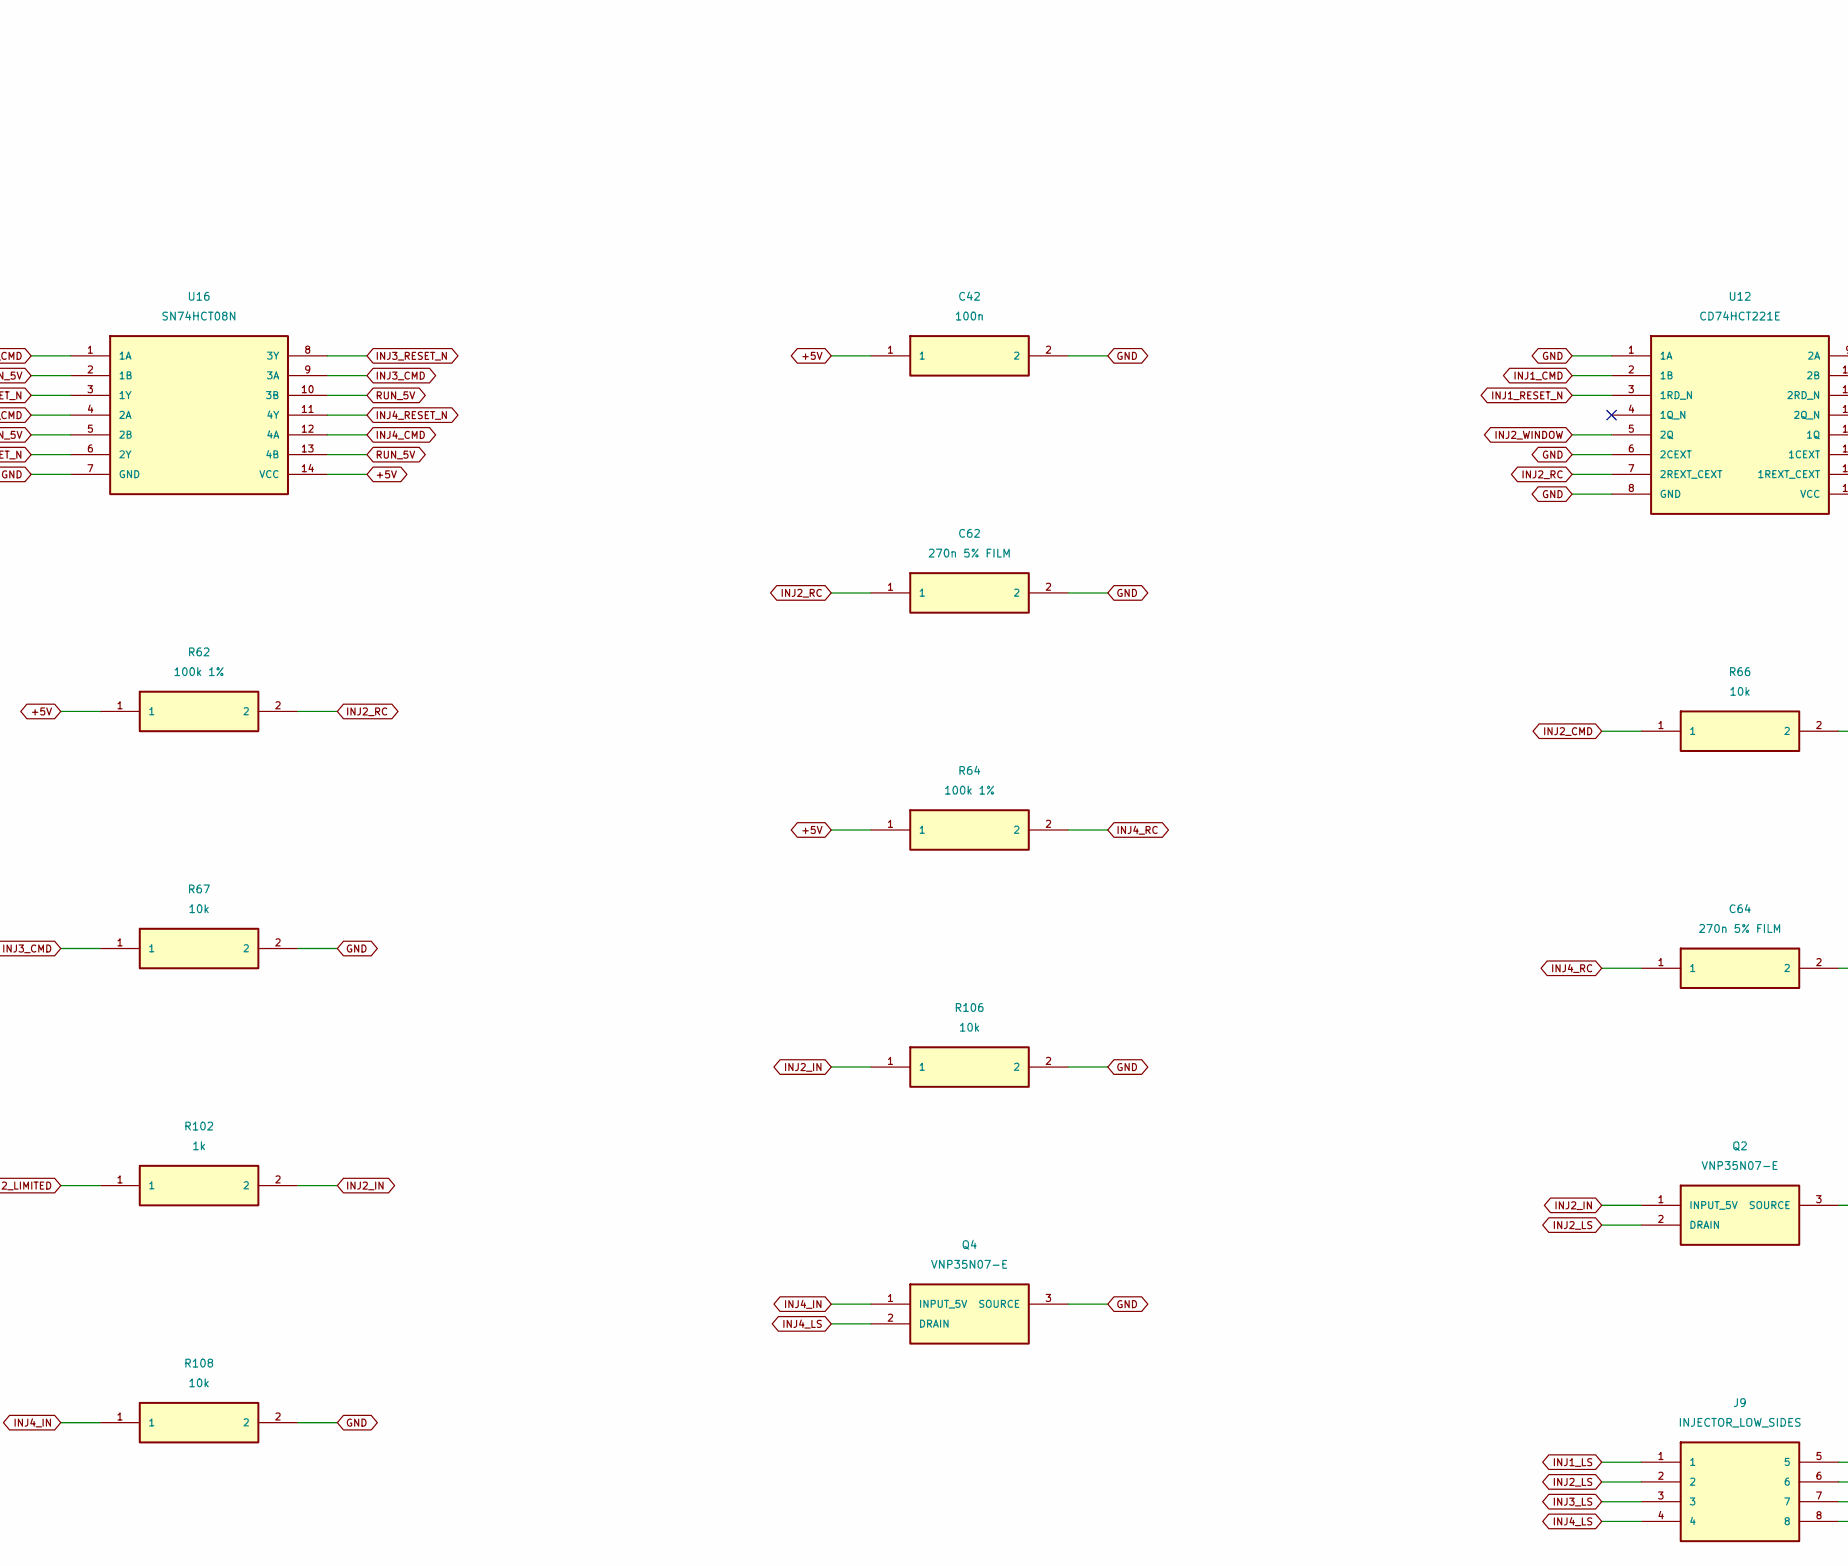
[picture p180: schematic injectors.kicad_sch, ESP32 ECU A5 IDLE INTERFACE HOLD / injectors, part in row 1, column 2]

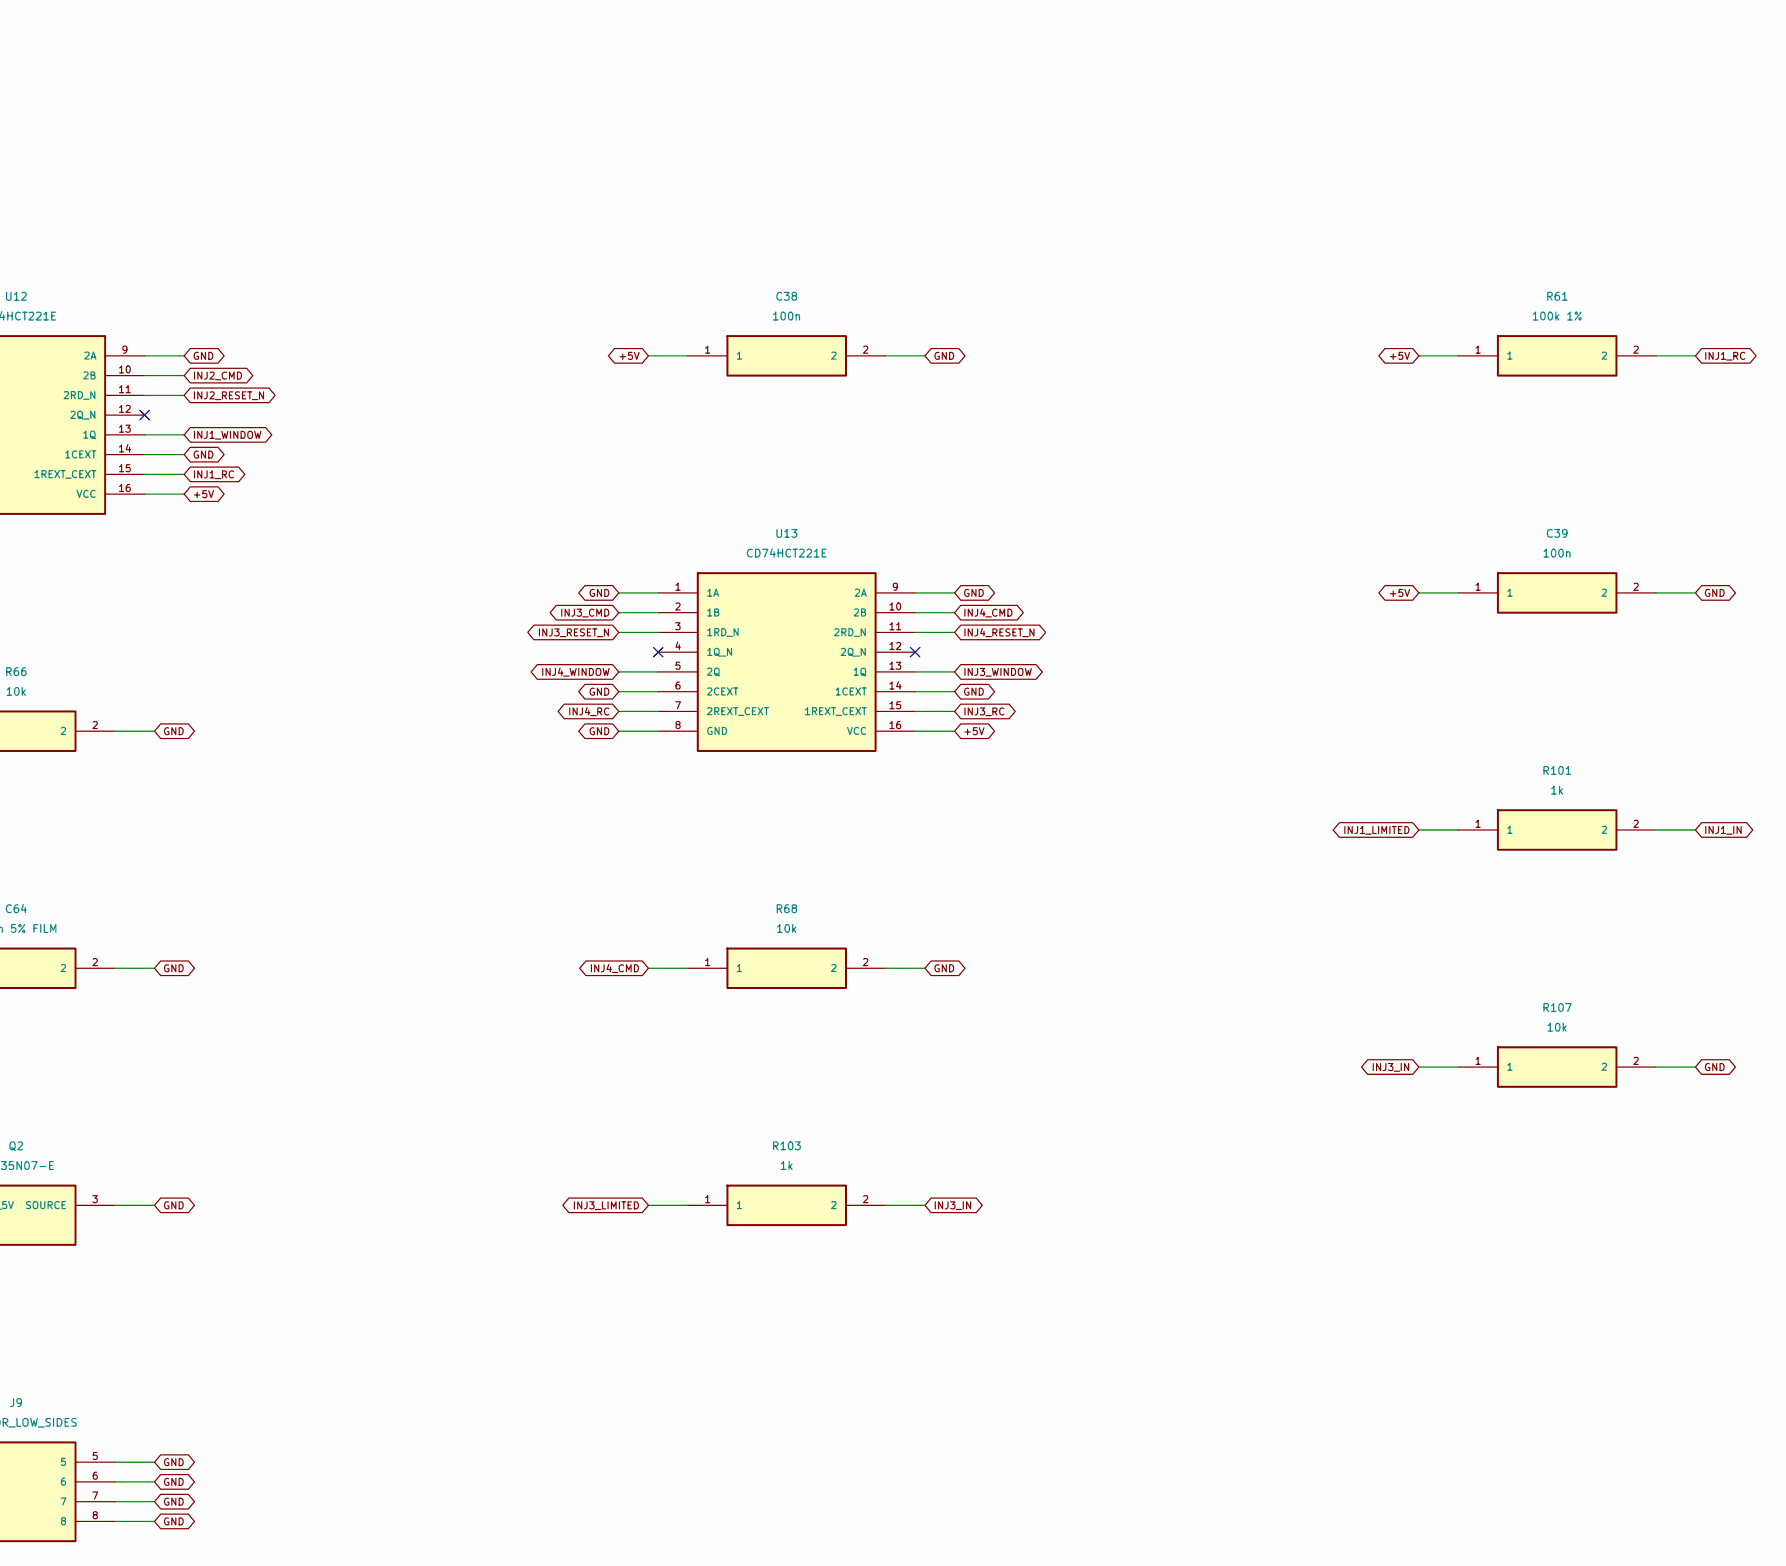
[picture p181: schematic injectors.kicad_sch, ESP32 ECU A5 IDLE INTERFACE HOLD / injectors, part in row 1, column 3]

Parts:
C36, C38, C39, C42: 100n; C_Disc_D5.0mm_W2.5mm_P5.00mm
C61, C62, C63, C64: 270n 5% FILM; C_Rect_L7.2mm_W5.0mm_P5.00mm
J9: INJECTOR_LOW_SIDES; JST_VH_B8P-VH_1x08_P3.96mm_Vertical; MPN B8P-VH(LF)(SN)
Q1, Q2, Q3, Q4: VNP35N07-E; TO-220-3_Vertical; MPN VNP35N07-E
R61, R62, R63, R64: 100k 1%; R_Axial_DIN0207_L6.3mm_D2.5mm_P2.54mm_Vertical
R65, R66, R67, R68, R105, R106, R107, R108: 10k; R_Axial_DIN0207_L6.3mm_D2.5mm_P2.54mm_Vertical
R101, R102, R103, R104: 1k; R_Axial_DIN0207_L6.3mm_D2.5mm_P2.54mm_Vertical
U10, U16: SN74HCT08N; DIP-14_W7.62mm_LongPads; MPN SN74HCT08N
U12, U13: CD74HCT221E; DIP-16_W7.62mm_LongPads; MPN CD74HCT221E

Connections:
+5V: C36.1, C38.1, C39.1, C42.1, R61.1, R62.1, R63.1, R64.1, U10.14 (VCC), U12.16 (VCC), U13.16 (VCC), U16.14 (VCC); also elsewhere on the board
GND: C36.2, C38.2, C39.2, C42.2, C61.2, C62.2, C63.2, C64.2, J9.5, J9.6, J9.7, J9.8, Q1.3 (SOURCE), Q2.3 (SOURCE), Q3.3 (SOURCE), Q4.3 (SOURCE), R65.2, R66.2, R67.2, R68.2, R105.2, R106.2, R107.2, R108.2, U10.7 (GND), U12.1 (1A), U12.6 (2CEXT), U12.8 (GND), U12.9 (2A), U12.14 (1CEXT), U13.1 (1A), U13.6 (2CEXT), U13.8 (GND), U13.9 (2A), U13.14 (1CEXT), U16.7 (GND); also elsewhere on the board
INJ1_CMD: R65.1, U10.1 (1A), U12.2 (1B), U16.1 (1A); also elsewhere on the board
INJ1_IN: Q1.1 (INPUT_5V), R101.2, R105.1
INJ1_LIMITED: R101.1, U10.3 (1Y)
INJ1_LS: J9.1, Q1.2 (DRAIN)
INJ1_RC: C61.1, R61.2, U12.15 (1REXT_CEXT)
INJ1_RESET_N: U12.3 (1RD_N), U16.3 (1Y)
INJ1_WINDOW: U10.2 (1B), U12.13 (1Q)
INJ2_CMD: R66.1, U10.4 (2A), U12.10 (2B), U16.4 (2A); also elsewhere on the board
INJ2_IN: Q2.1 (INPUT_5V), R102.2, R106.1
INJ2_LIMITED: R102.1, U10.6 (2Y)
INJ2_LS: J9.2, Q2.2 (DRAIN)
INJ2_RC: C62.1, R62.2, U12.7 (2REXT_CEXT)
INJ2_RESET_N: U12.11 (2RD_N), U16.6 (2Y)
INJ2_WINDOW: U10.5 (2B), U12.5 (2Q)
INJ3_CMD: R67.1, U10.9 (3A), U13.2 (1B), U16.9 (3A); also elsewhere on the board
INJ3_IN: Q3.1 (INPUT_5V), R103.2, R107.1
INJ3_LIMITED: R103.1, U10.8 (3Y)
INJ3_LS: J9.3, Q3.2 (DRAIN)
INJ3_RC: C63.1, R63.2, U13.15 (1REXT_CEXT)
INJ3_RESET_N: U13.3 (1RD_N), U16.8 (3Y)
INJ3_WINDOW: U10.10 (3B), U13.13 (1Q)
INJ4_CMD: R68.1, U10.12 (4A), U13.10 (2B), U16.12 (4A); also elsewhere on the board
INJ4_IN: Q4.1 (INPUT_5V), R104.2, R108.1
INJ4_LIMITED: R104.1, U10.11 (4Y)
INJ4_LS: J9.4, Q4.2 (DRAIN)
INJ4_RC: C64.1, R64.2, U13.7 (2REXT_CEXT)
INJ4_RESET_N: U13.11 (2RD_N), U16.11 (4Y)
INJ4_WINDOW: U10.13 (4B), U13.5 (2Q)
RUN_5V: U16.2 (1B), U16.5 (2B), U16.10 (3B), U16.13 (4B); also elsewhere on the board

Notes on the sheet:
Four saturated high-impedance PFI injectors. No GDI or peak-and-hold. 18.9 ms nominal hardware window; validate full tolerance range.

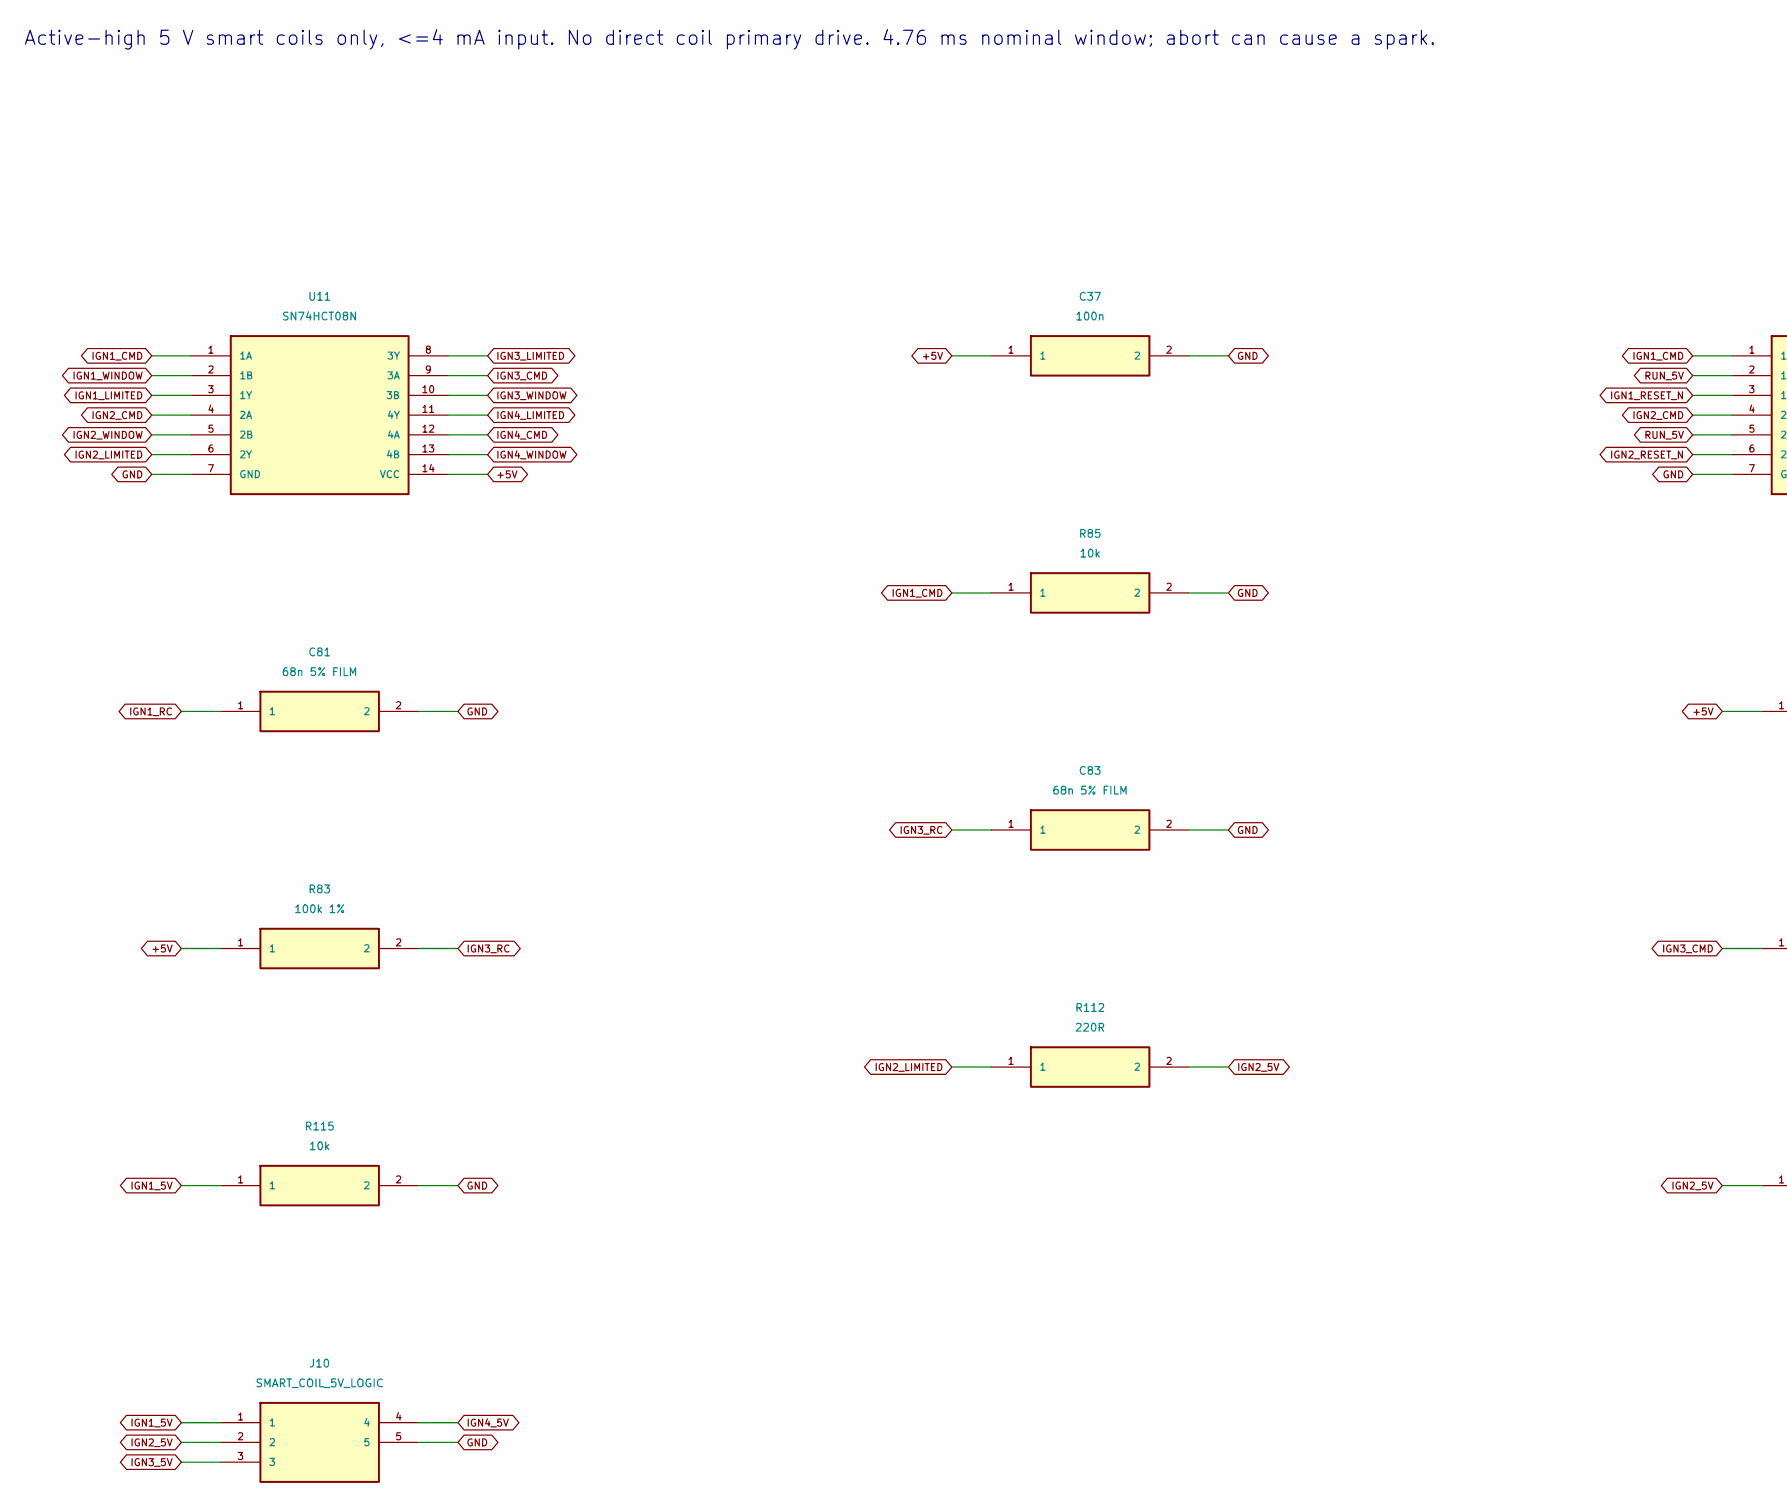
[picture p182: schematic ignition.kicad_sch, ESP32 ECU A5 IDLE INTERFACE HOLD / ignition, part in row 1, column 1]

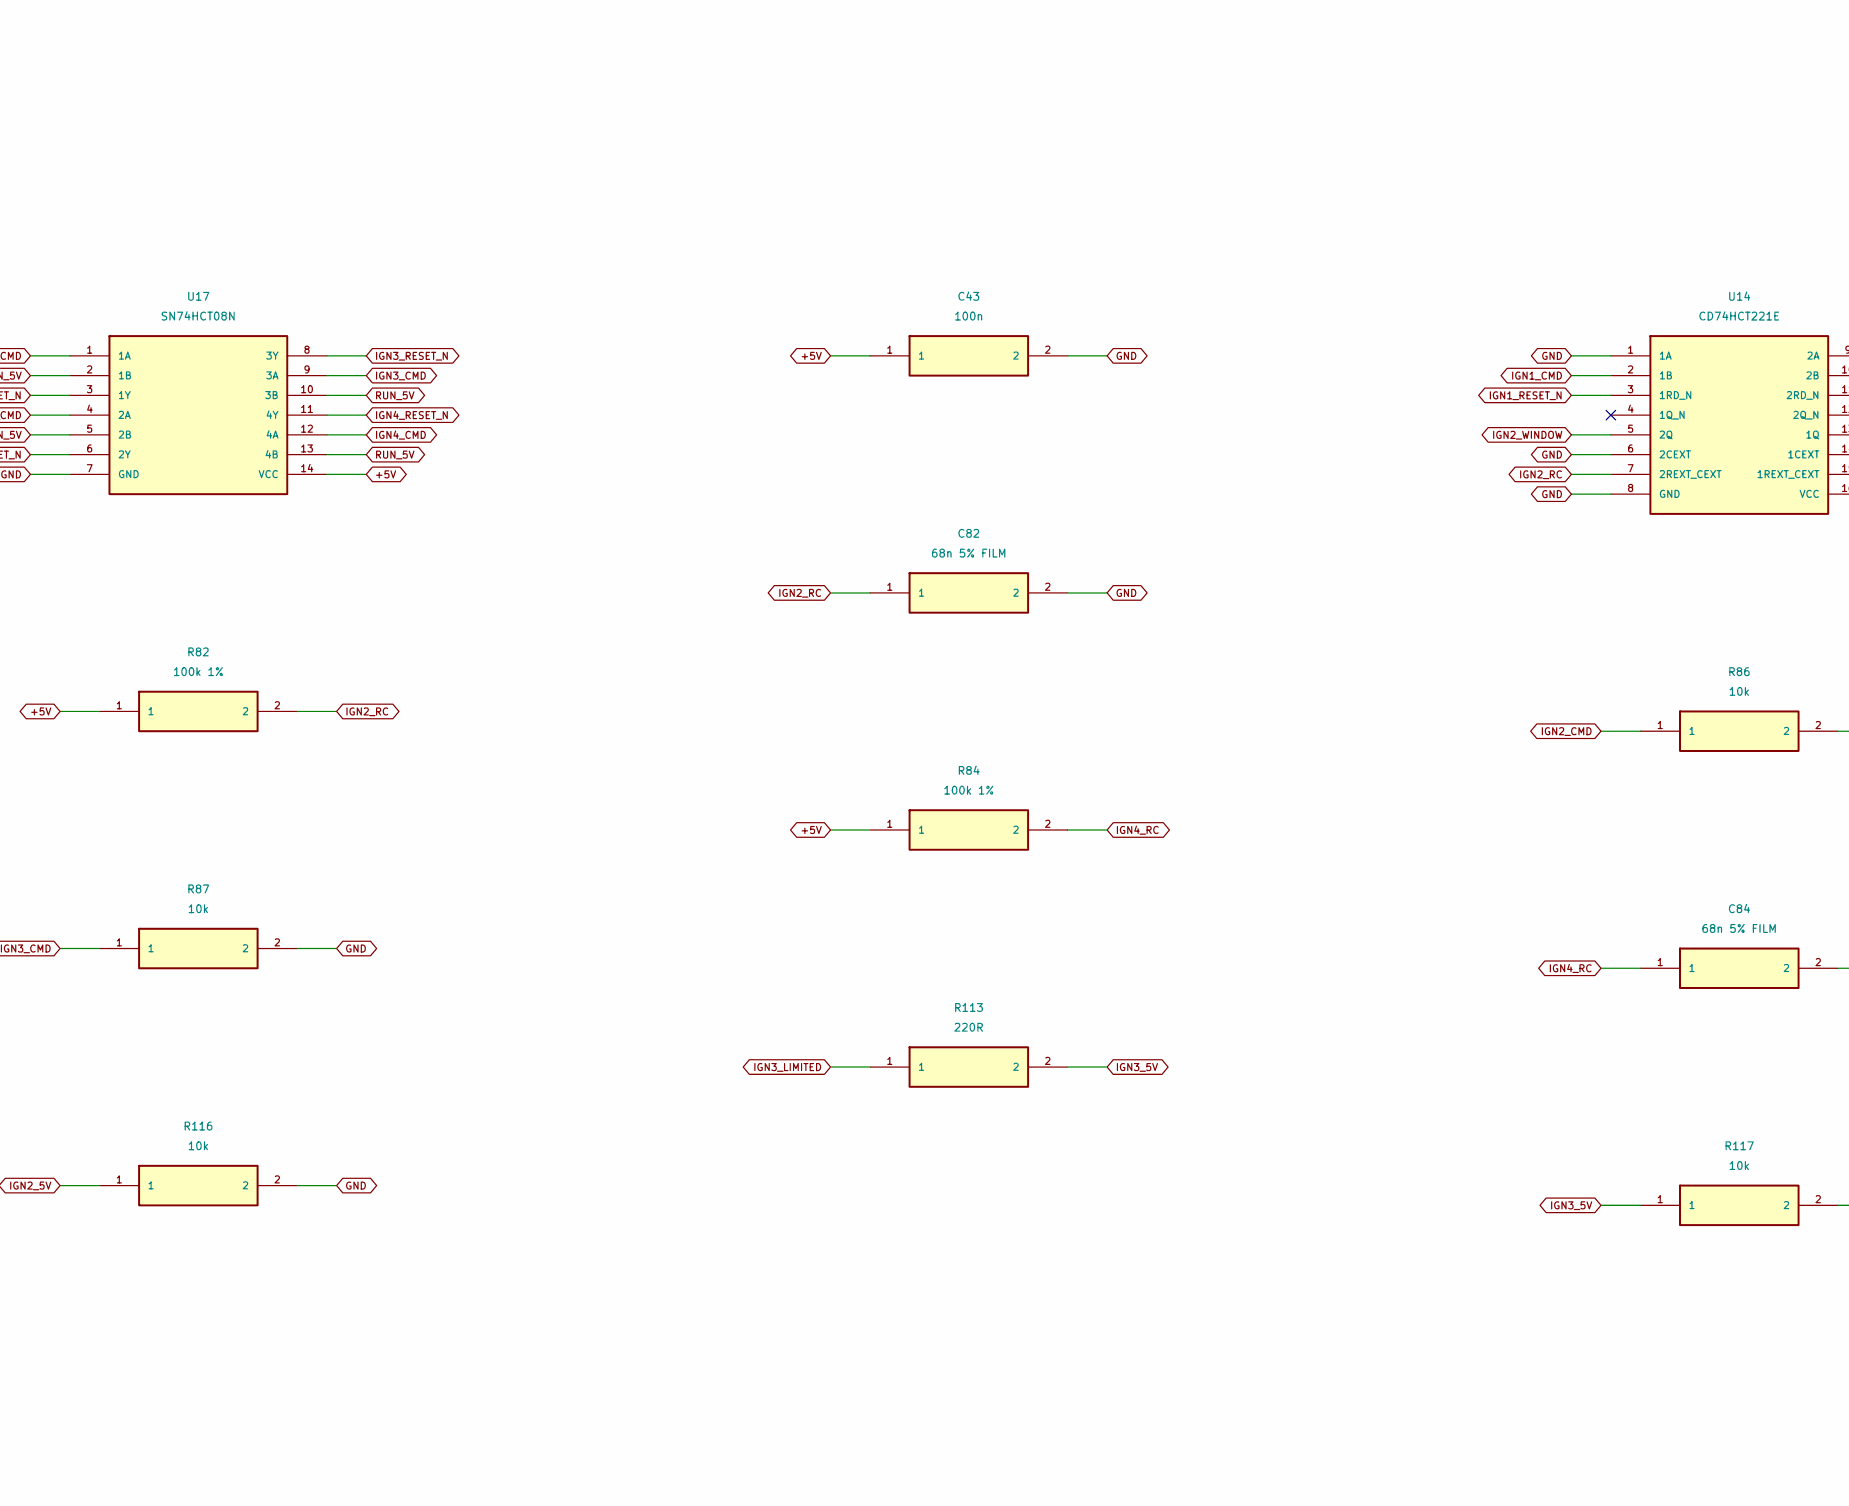
[picture p183: schematic ignition.kicad_sch, ESP32 ECU A5 IDLE INTERFACE HOLD / ignition, part in row 1, column 2]

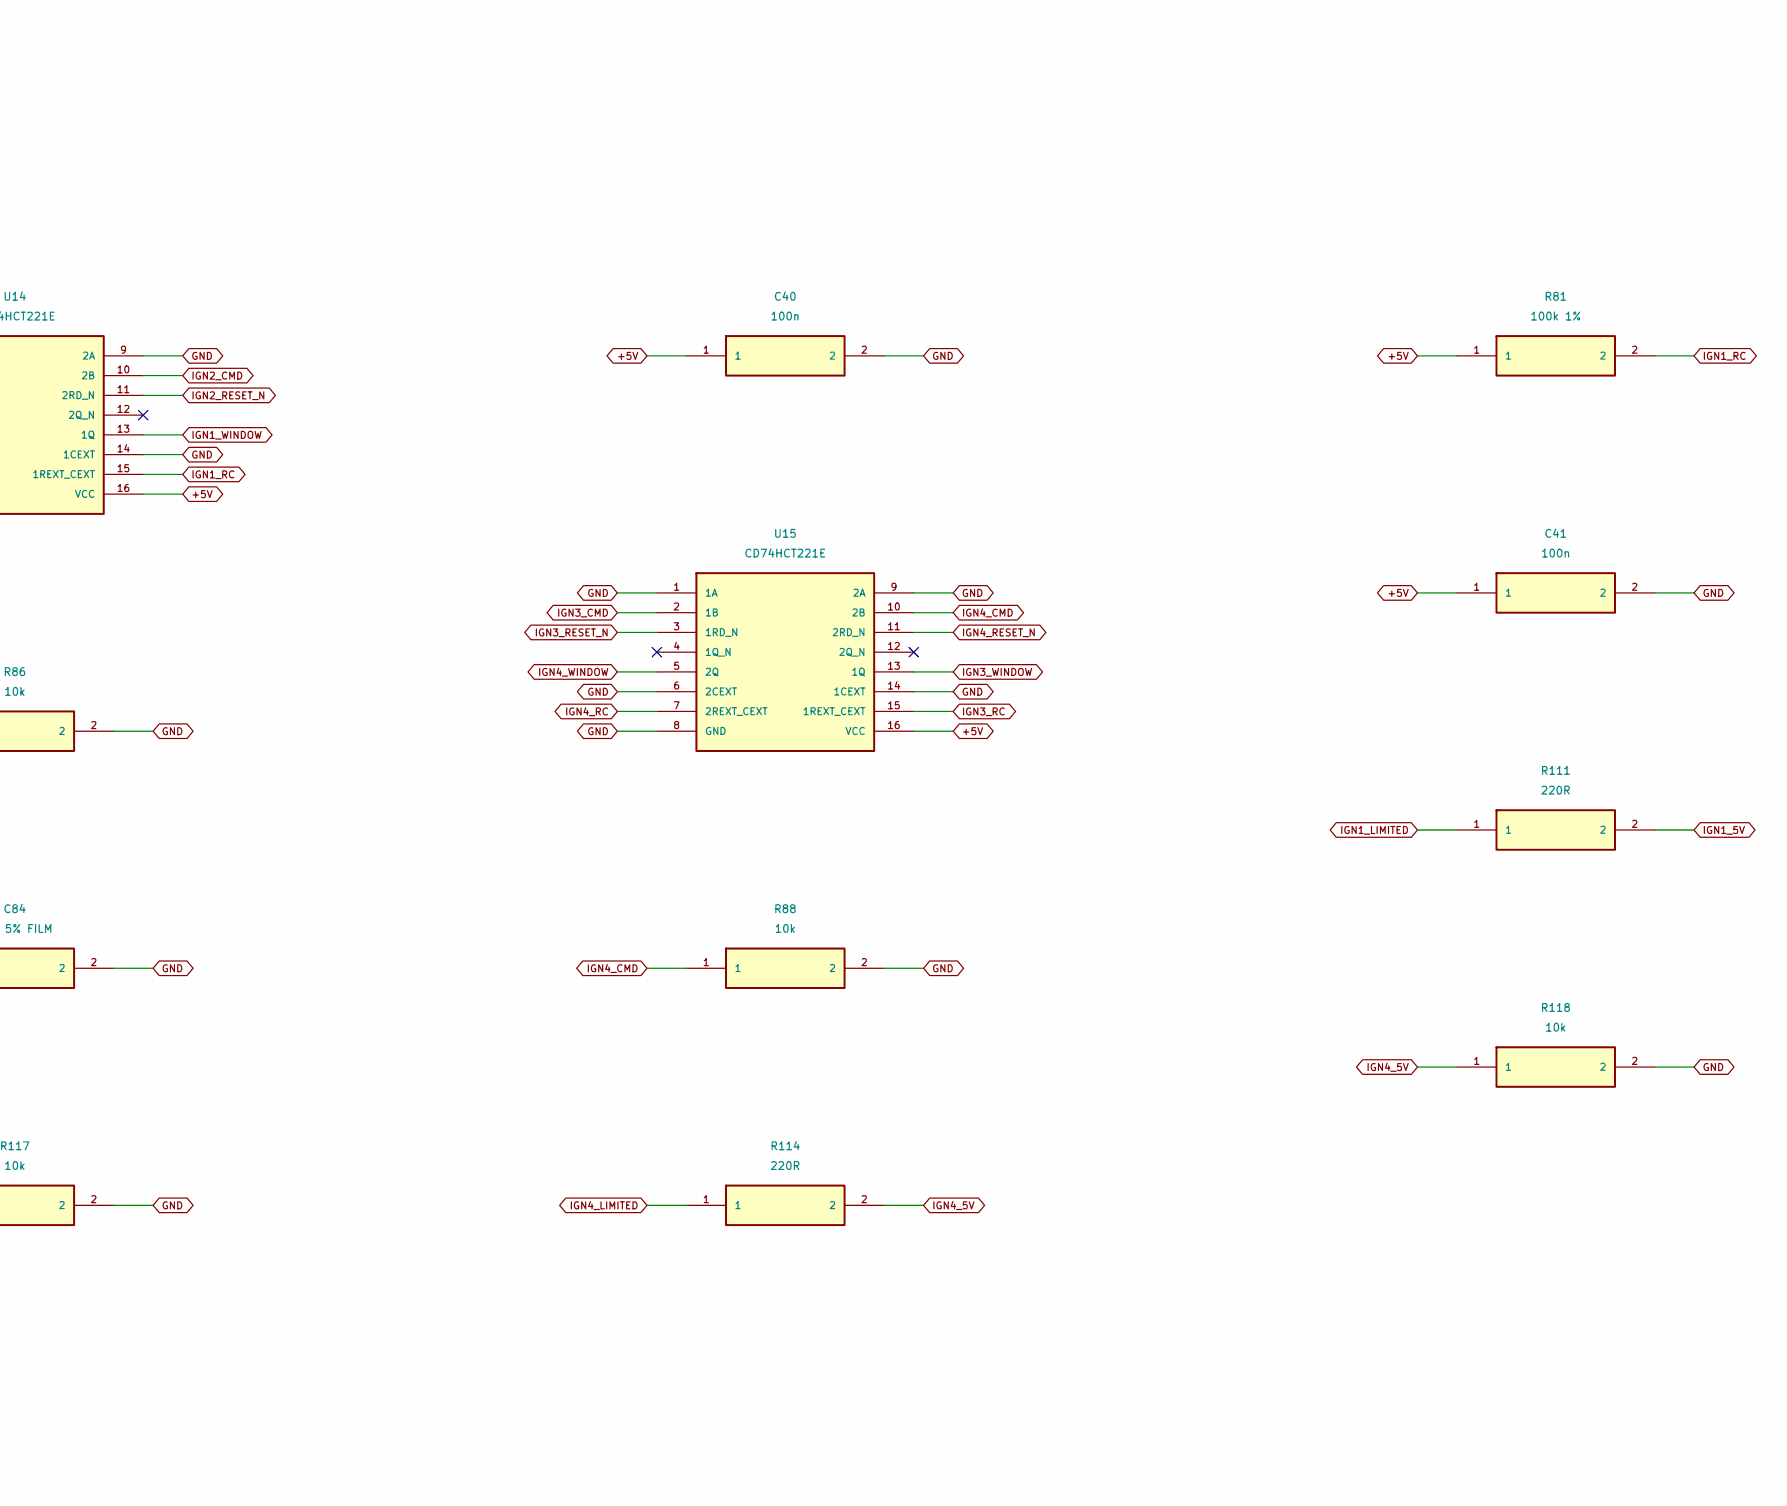
[picture p184: schematic ignition.kicad_sch, ESP32 ECU A5 IDLE INTERFACE HOLD / ignition, part in row 1, column 3]

Parts:
C37, C40, C41, C43: 100n; C_Disc_D5.0mm_W2.5mm_P5.00mm
C81, C82, C83, C84: 68n 5% FILM; C_Rect_L7.2mm_W5.0mm_P5.00mm
J10: SMART_COIL_5V_LOGIC; JST_VH_B5P-VH_1x05_P3.96mm_Vertical; MPN B5P-VH(LF)(SN)
R81, R82, R83, R84: 100k 1%; R_Axial_DIN0207_L6.3mm_D2.5mm_P2.54mm_Vertical
R85, R86, R87, R88, R115, R116, R117, R118: 10k; R_Axial_DIN0207_L6.3mm_D2.5mm_P2.54mm_Vertical
R111, R112, R113, R114: 220R; R_Axial_DIN0207_L6.3mm_D2.5mm_P2.54mm_Vertical
U11, U17: SN74HCT08N; DIP-14_W7.62mm_LongPads; MPN SN74HCT08N
U14, U15: CD74HCT221E; DIP-16_W7.62mm_LongPads; MPN CD74HCT221E

Connections:
+5V: C37.1, C40.1, C41.1, C43.1, R81.1, R82.1, R83.1, R84.1, U11.14 (VCC), U14.16 (VCC), U15.16 (VCC), U17.14 (VCC); also elsewhere on the board
GND: C37.2, C40.2, C41.2, C43.2, C81.2, C82.2, C83.2, C84.2, J10.5, R85.2, R86.2, R87.2, R88.2, R115.2, R116.2, R117.2, R118.2, U11.7 (GND), U14.1 (1A), U14.6 (2CEXT), U14.8 (GND), U14.9 (2A), U14.14 (1CEXT), U15.1 (1A), U15.6 (2CEXT), U15.8 (GND), U15.9 (2A), U15.14 (1CEXT), U17.7 (GND); also elsewhere on the board
IGN1_5V: J10.1, R111.2, R115.1
IGN1_CMD: R85.1, U11.1 (1A), U14.2 (1B), U17.1 (1A); also elsewhere on the board
IGN1_LIMITED: R111.1, U11.3 (1Y)
IGN1_RC: C81.1, R81.2, U14.15 (1REXT_CEXT)
IGN1_RESET_N: U14.3 (1RD_N), U17.3 (1Y)
IGN1_WINDOW: U11.2 (1B), U14.13 (1Q)
IGN2_5V: J10.2, R112.2, R116.1
IGN2_CMD: R86.1, U11.4 (2A), U14.10 (2B), U17.4 (2A); also elsewhere on the board
IGN2_LIMITED: R112.1, U11.6 (2Y)
IGN2_RC: C82.1, R82.2, U14.7 (2REXT_CEXT)
IGN2_RESET_N: U14.11 (2RD_N), U17.6 (2Y)
IGN2_WINDOW: U11.5 (2B), U14.5 (2Q)
IGN3_5V: J10.3, R113.2, R117.1
IGN3_CMD: R87.1, U11.9 (3A), U15.2 (1B), U17.9 (3A); also elsewhere on the board
IGN3_LIMITED: R113.1, U11.8 (3Y)
IGN3_RC: C83.1, R83.2, U15.15 (1REXT_CEXT)
IGN3_RESET_N: U15.3 (1RD_N), U17.8 (3Y)
IGN3_WINDOW: U11.10 (3B), U15.13 (1Q)
IGN4_5V: J10.4, R114.2, R118.1
IGN4_CMD: R88.1, U11.12 (4A), U15.10 (2B), U17.12 (4A); also elsewhere on the board
IGN4_LIMITED: R114.1, U11.11 (4Y)
IGN4_RC: C84.1, R84.2, U15.7 (2REXT_CEXT)
IGN4_RESET_N: U15.11 (2RD_N), U17.11 (4Y)
IGN4_WINDOW: U11.13 (4B), U15.5 (2Q)
RUN_5V: U17.2 (1B), U17.5 (2B), U17.10 (3B), U17.13 (4B); also elsewhere on the board

Notes on the sheet:
Active-high 5 V smart coils only, <=4 mA input. No direct coil primary drive. 4.76 ms nominal window; abort can cause a spark.

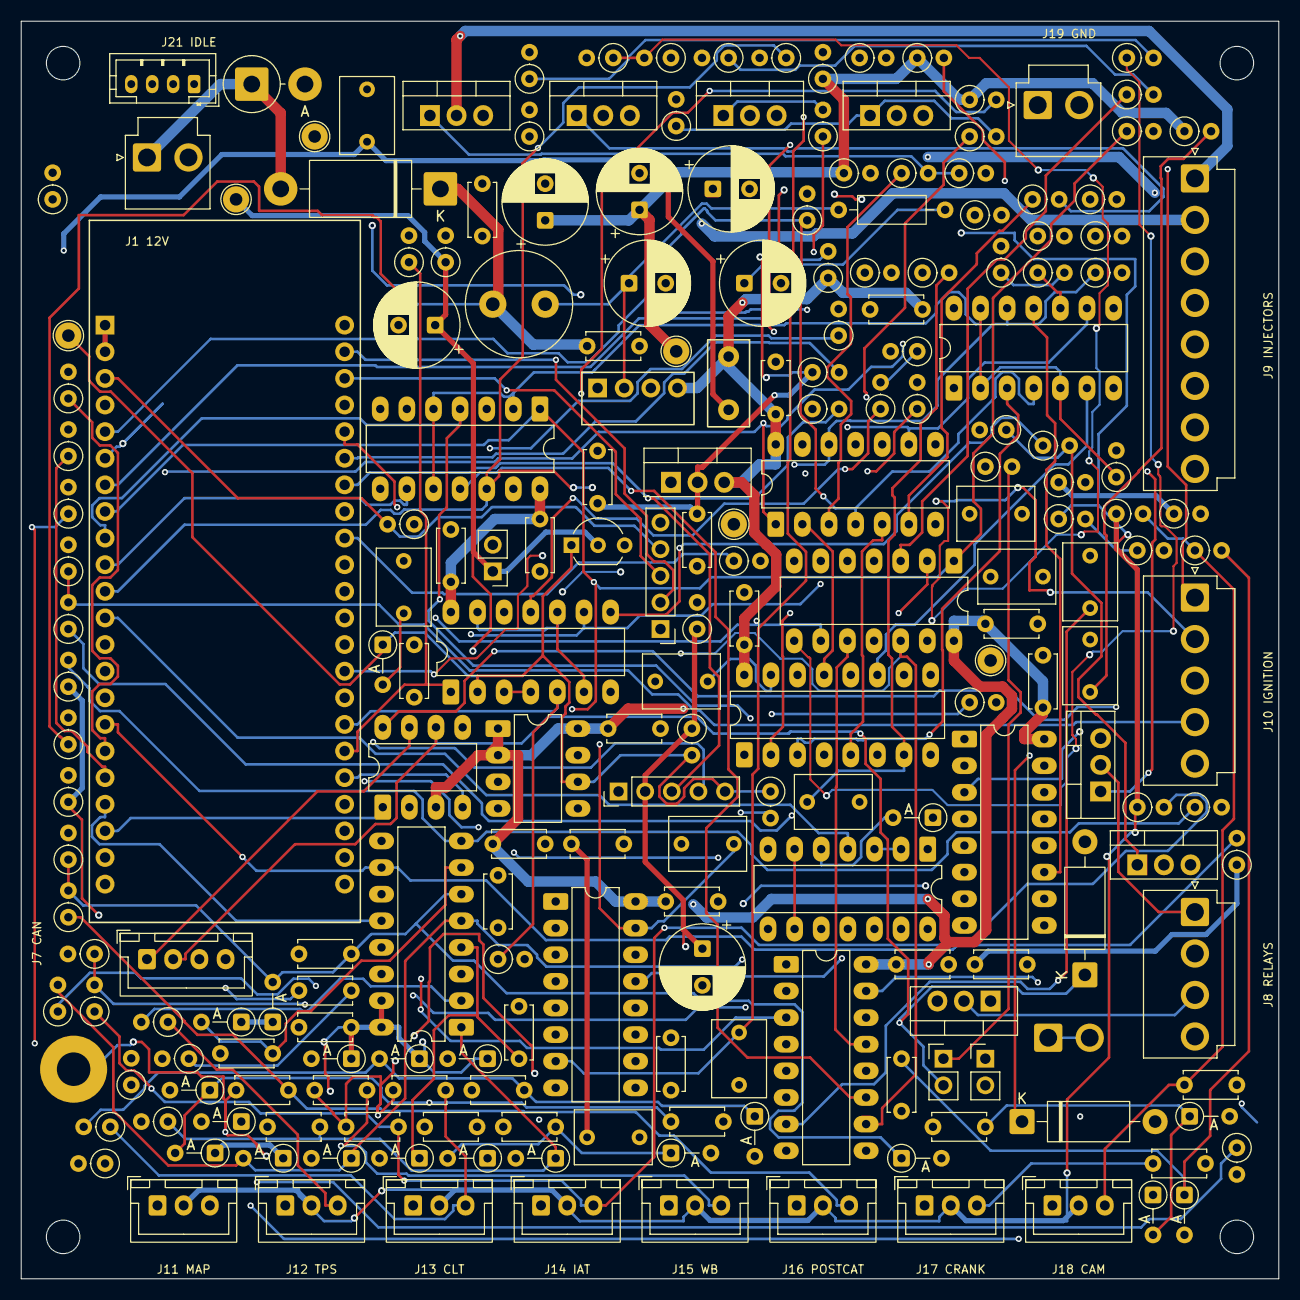
[picture p185: board esp32-ecu.kicad_pcb from above]

Board: 6 copper layers, 120.0 x 120.0 mm, 221 parts (0 on the bottom side), 119 nets.

Other parts of the board:
H1, H2, H3, H4: M3 NPTH; MountingHole_3.2mm_M3
