markthebault/esp32-ecu/reports/engine/idle-isolation/reviews/layout/snapshots/7d761c8b82474863609ab3d7924ae29177f6d0fdafe617d2cf13bfe3d63853aa/hardware/idle-isolated/isolated.kicad_pcb

## KiCad design reports/engine/idle-isolation/reviews/layout/snapshots/7d761c8b82474863609ab3d7924ae29177f6d0fdafe617d2cf13bfe3d63853aa/hardware/idle-isolated/isolated.kicad_pcb (2026-11-06)

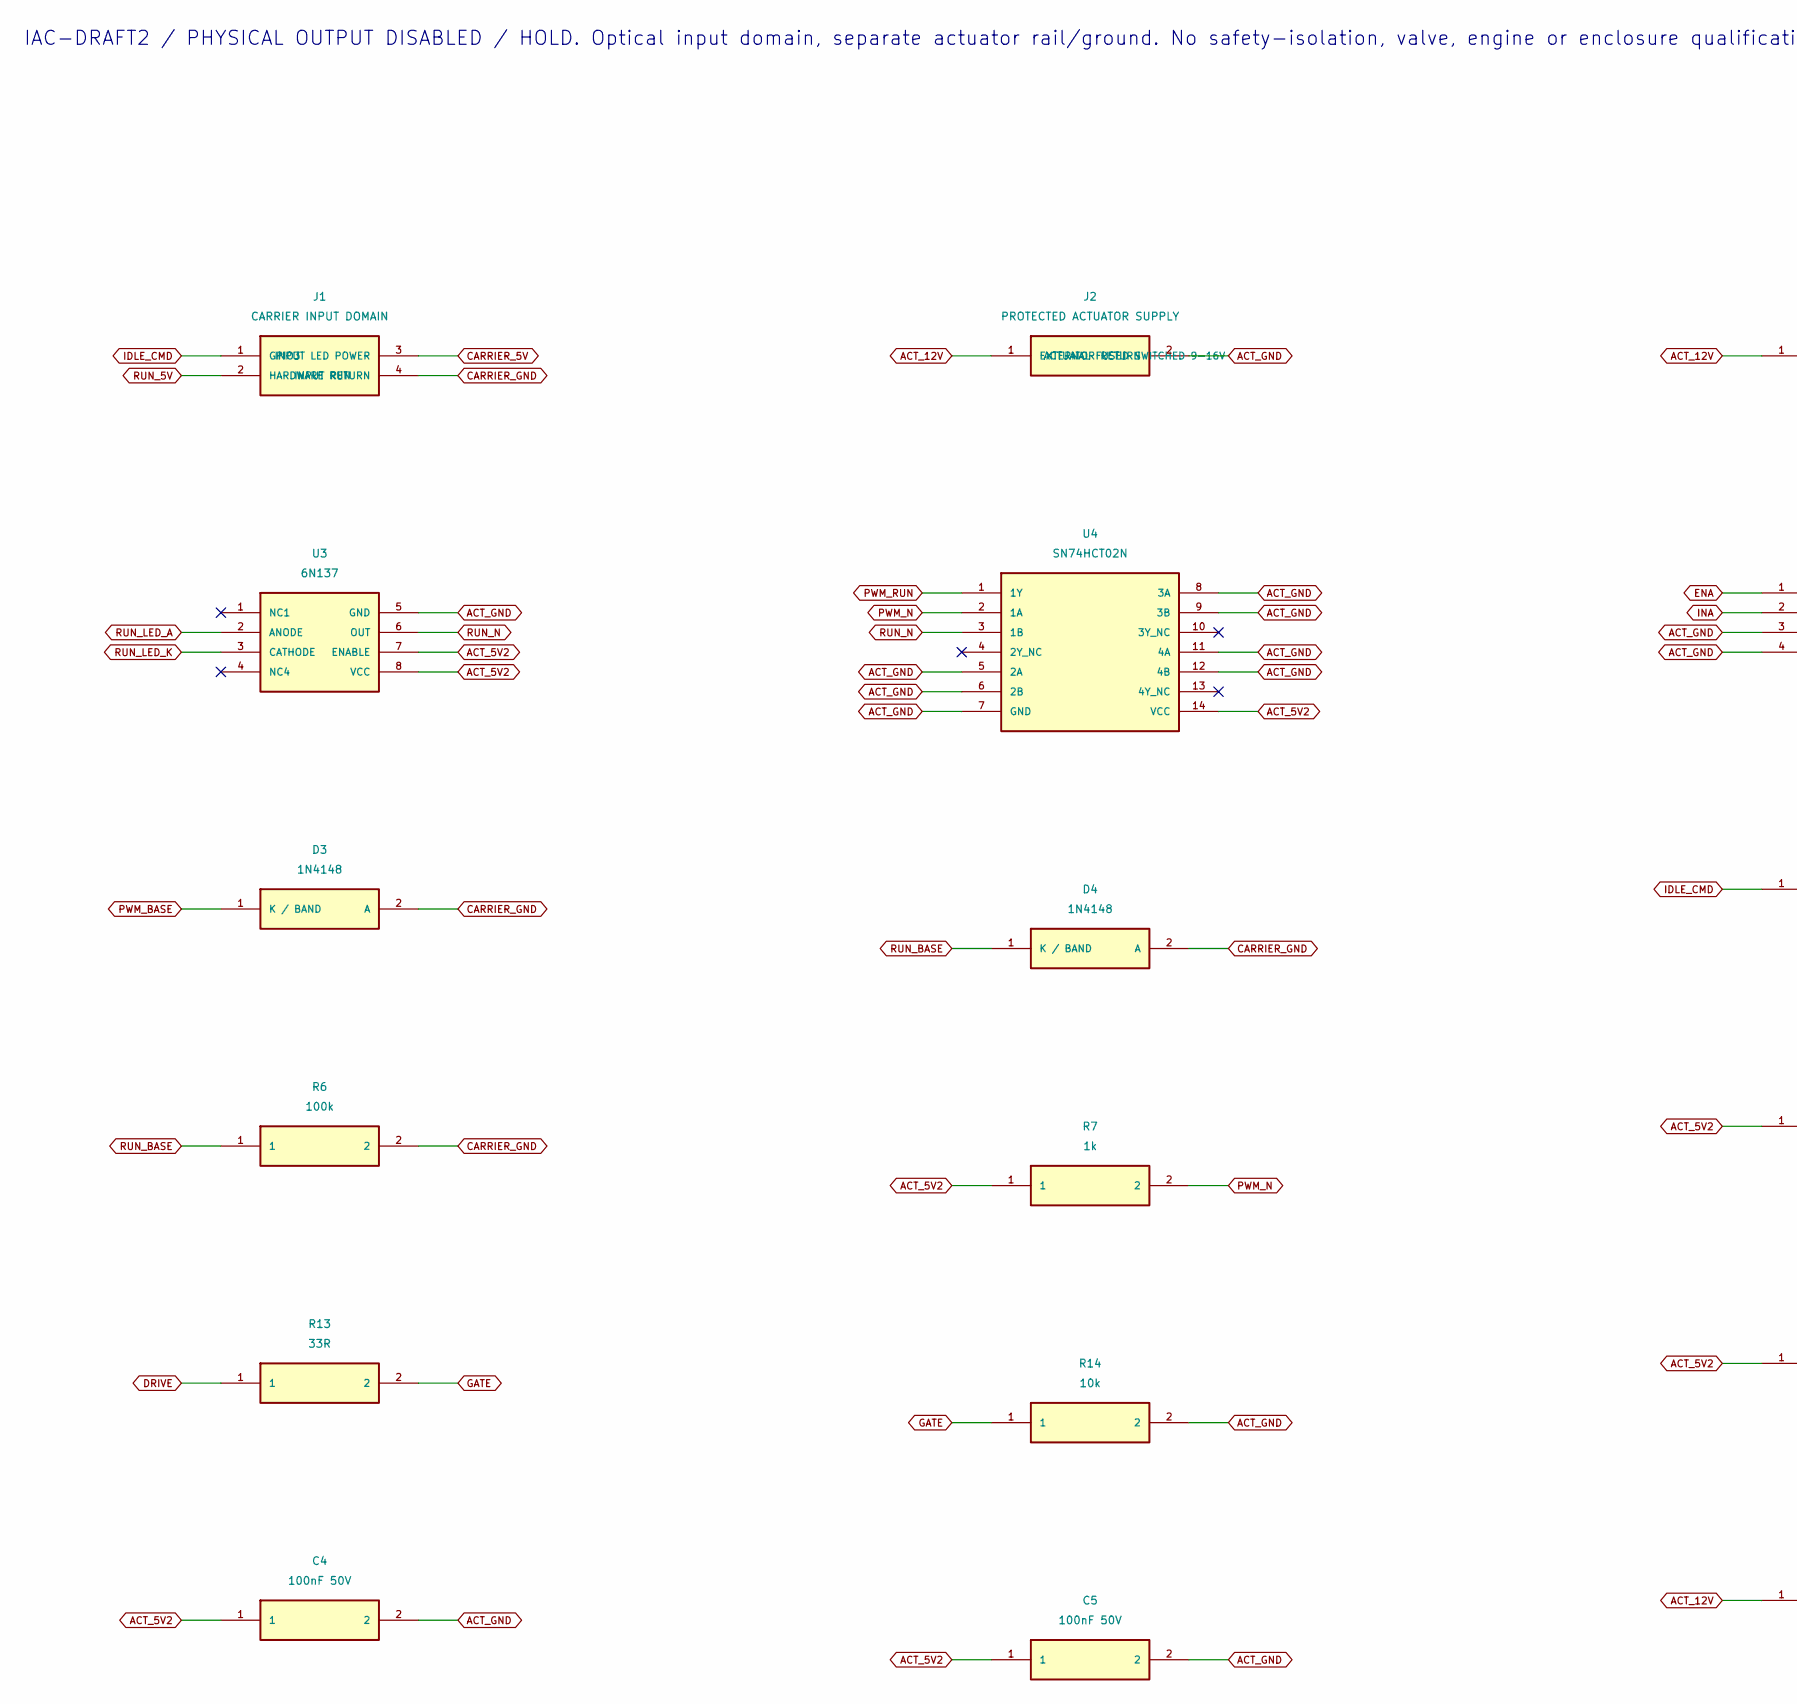
[picture p186: schematic isolated.kicad_sch, Isolated idle driver IAC-DRAFT2, part in row 1, column 1]

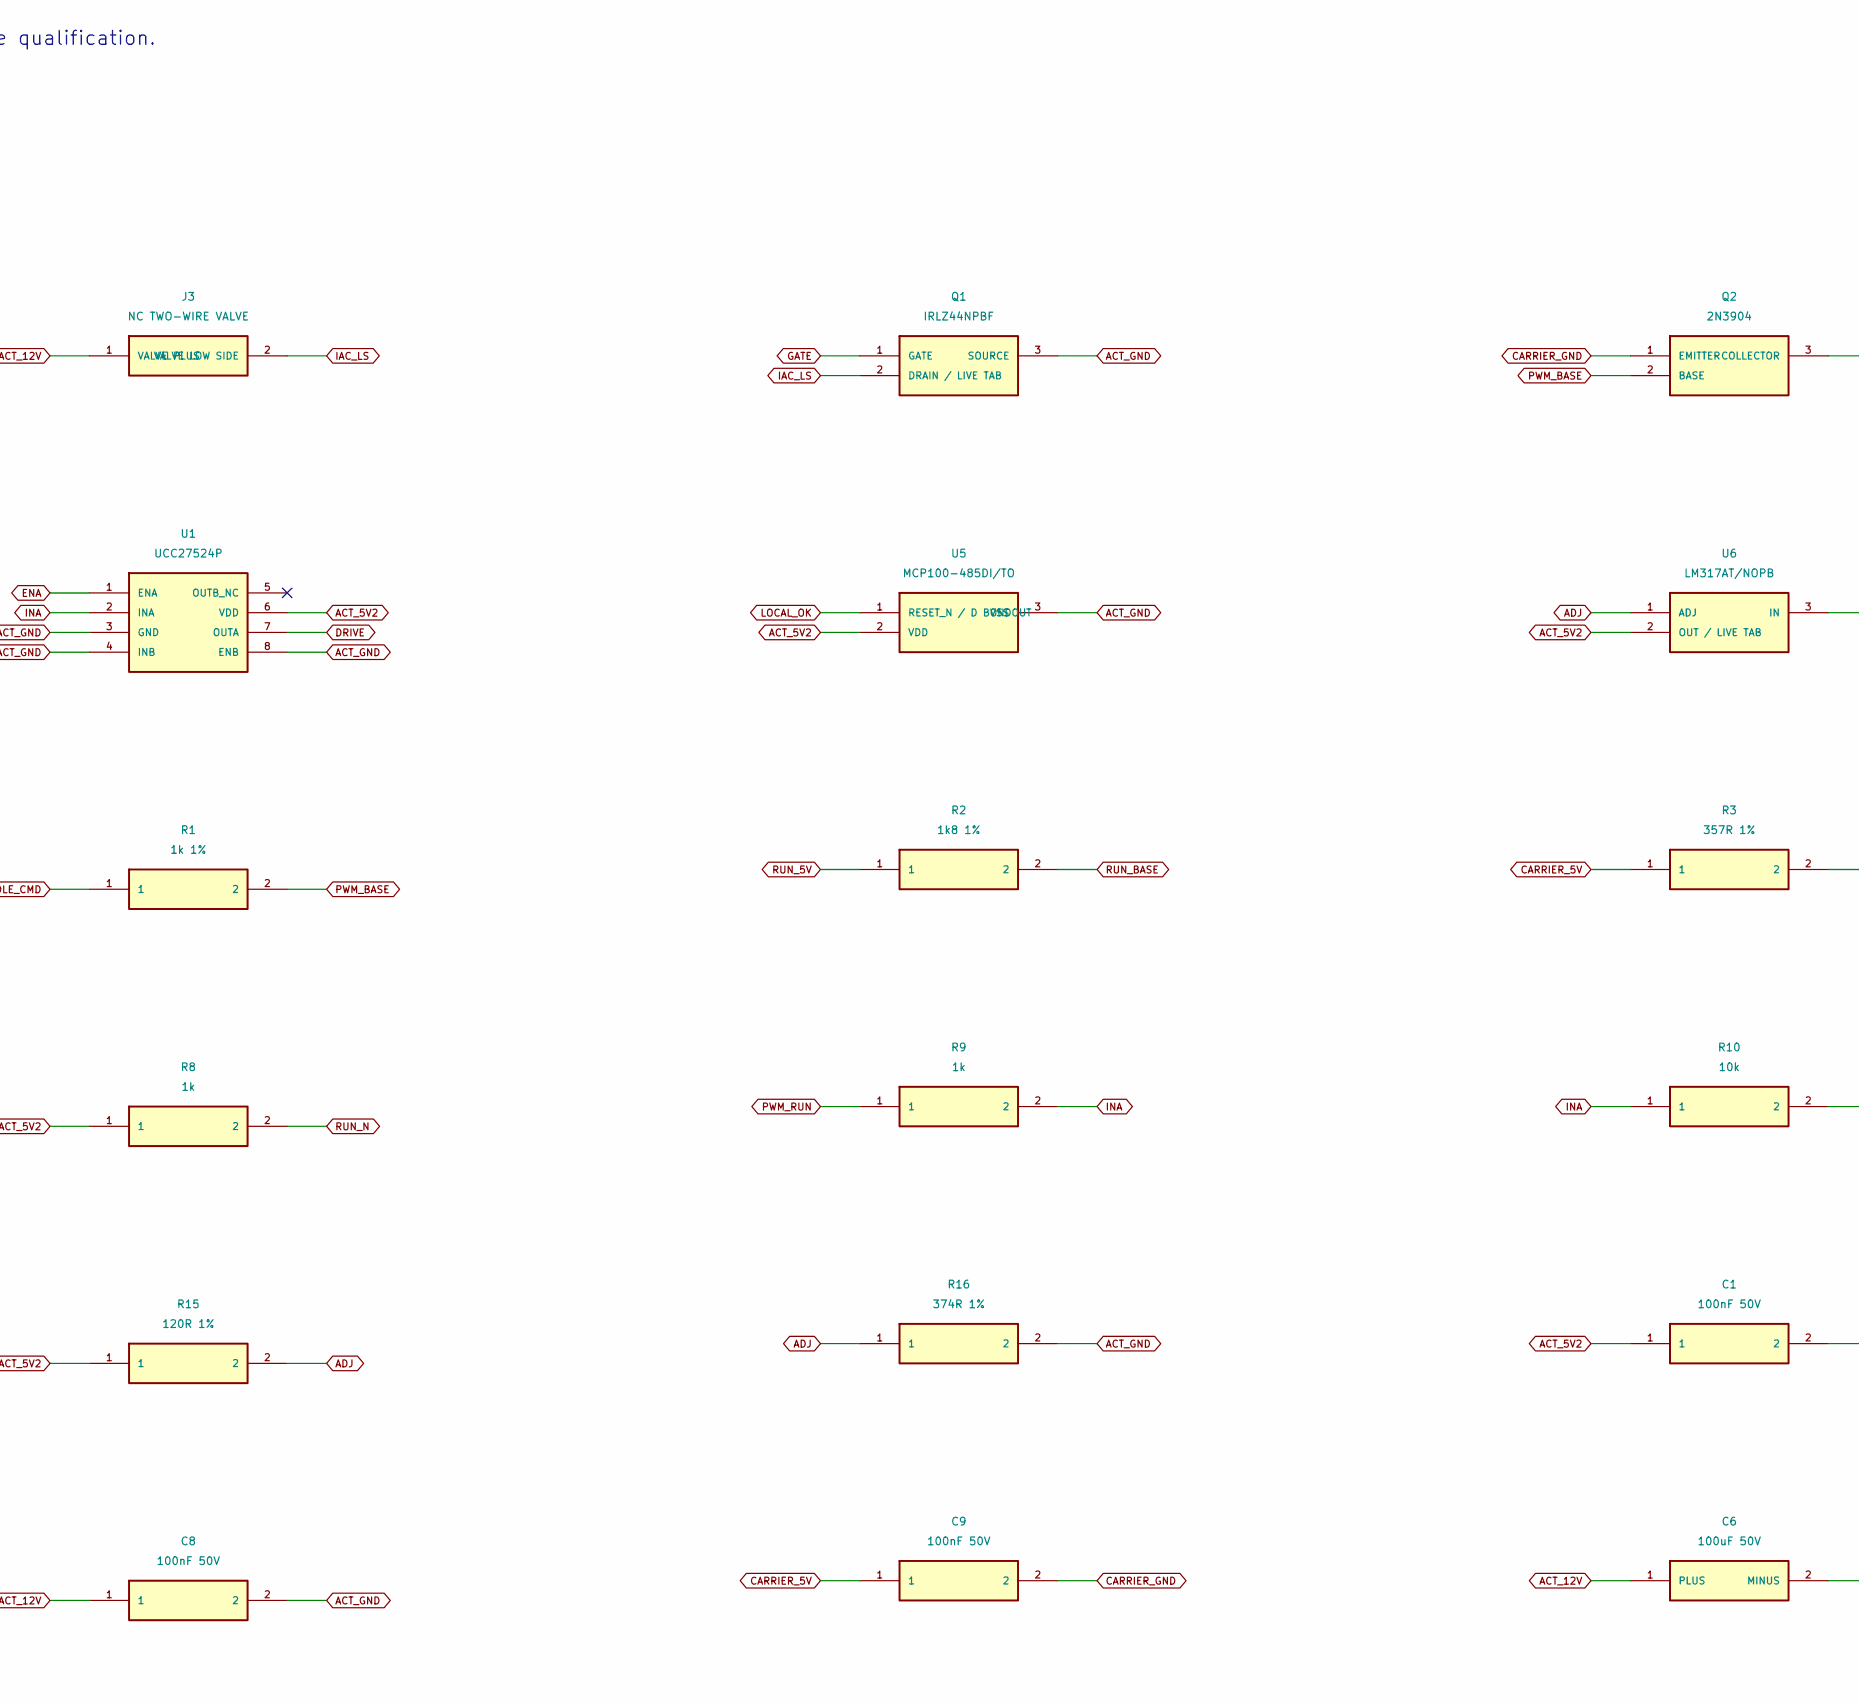
[picture p187: schematic isolated.kicad_sch, Isolated idle driver IAC-DRAFT2, part in row 1, column 2]

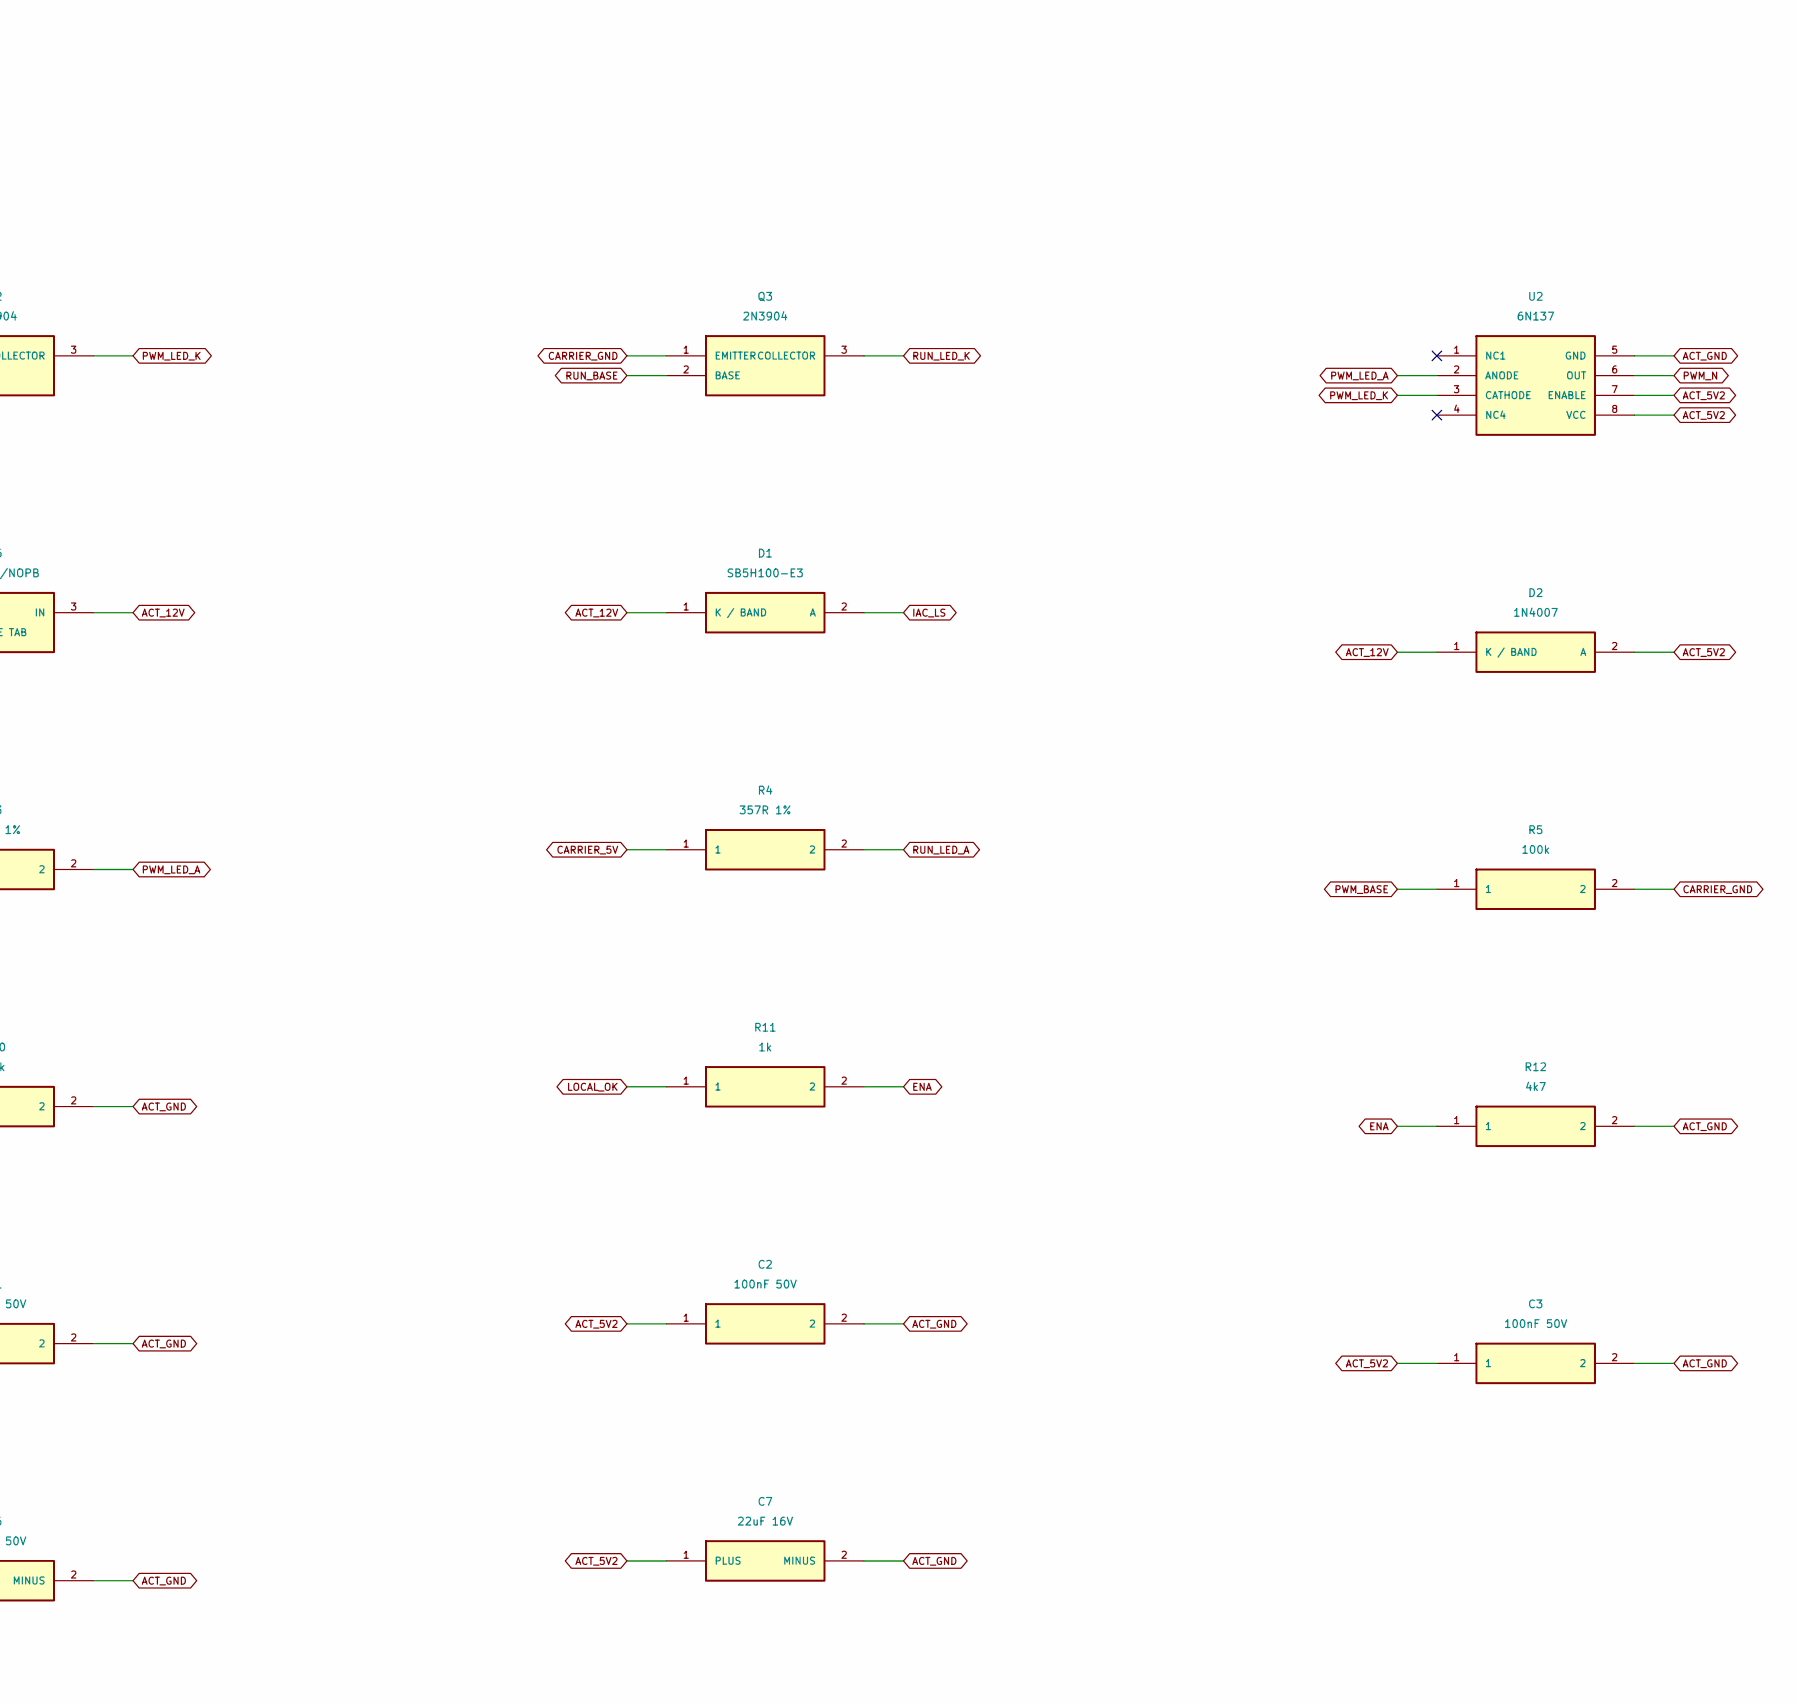
[picture p188: schematic isolated.kicad_sch, Isolated idle driver IAC-DRAFT2, part in row 1, column 3]

Parts:
C1, C2, C3, C4, C5, C8, C9: 100nF 50V; C_Disc_D5.0mm_W2.5mm_P5.00mm
C6: 100uF 50V; CP_Radial_D8.0mm_P3.50mm
C7: 22uF 16V; CP_Radial_D8.0mm_P3.50mm
D1: SB5H100-E3; D_DO-201AD_P15.24mm_Horizontal; MPN SB5H100-E3/54
D2: 1N4007; D_DO-41_SOD81_P10.16mm_Horizontal; MPN 1N4007-E3/54
D3, D4: 1N4148; D_DO-35_SOD27_P3.81mm_Vertical_AnodeUp; MPN 1N4148-TAP
J1: CARRIER INPUT DOMAIN; JST_XH_B4B-XH-A_1x04_P2.50mm_Vertical; MPN B4B-XH-A(LF)(SN)
J2: PROTECTED ACTUATOR SUPPLY; TerminalBlock_Phoenix_MKDS-1,5-2-5.08_1x02_P5.08mm_Horizont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; MPN 1715721
J3: NC TWO-WIRE VALVE; JST_VH_B2P-VH_1x02_P3.96mm_Vertical; MPN B2P-VH(LF)(SN)
Q1: IRLZ44NPBF; TO-220-3_Vertical; MPN IRLZ44NPBF
Q2, Q3: 2N3904; TO-92_Inline_Wide; MPN 2N3904BU
R1: 1k 1%; R_Axial_DIN0207_L6.3mm_D2.5mm_P2.54mm_Vertical
R2: 1k8 1%; R_Axial_DIN0207_L6.3mm_D2.5mm_P2.54mm_Vertical
R3, R4: 357R 1%; R_Axial_DIN0207_L6.3mm_D2.5mm_P2.54mm_Vertical
R5, R6: 100k; R_Axial_DIN0207_L6.3mm_D2.5mm_P2.54mm_Vertical
R7, R8, R9, R11: 1k; R_Axial_DIN0207_L6.3mm_D2.5mm_P2.54mm_Vertical
R10, R14: 10k; R_Axial_DIN0207_L6.3mm_D2.5mm_P2.54mm_Vertical
R12: 4k7; R_Axial_DIN0207_L6.3mm_D2.5mm_P2.54mm_Vertical
R13: 33R; R_Axial_DIN0207_L6.3mm_D2.5mm_P2.54mm_Vertical
R15: 120R 1%; R_Axial_DIN0207_L6.3mm_D2.5mm_P2.54mm_Vertical
R16: 374R 1%; R_Axial_DIN0207_L6.3mm_D2.5mm_P2.54mm_Vertical
U1: UCC27524P; DIP-8_W7.62mm_LongPads; MPN UCC27524P.B
U2, U3: 6N137; DIP-8_W7.62mm_LongPads; MPN 6N137
U4: SN74HCT02N; DIP-14_W7.62mm_LongPads; MPN SN74HCT02N
U5: MCP100-485DI/TO; TO-92_Inline_Wide; MPN MCP100-485DI/TO
U6: LM317AT/NOPB; TO-220-3_Vertical; MPN LM317AT/NOPB

Connections:
ACT_5V2: C1.1, C2.1, C3.1, C4.1, C5.1, C7.1 (PLUS), D2.2 (A), R7.1, R8.1, R15.1, U1.6 (VDD), U2.7 (ENABLE), U2.8 (VCC), U3.7 (ENABLE), U3.8 (VCC), U4.14 (VCC), U5.2 (VDD), U6.2 (OUT / LIVE TAB)
ACT_12V: C6.1 (PLUS), C8.1, D1.1 (K / BAND), D2.1 (K / BAND), J2.1 (EXTERNAL FUSED SWITCHED 9-16V), J3.1 (VALVE PLUS), U6.3 (IN)
ACT_GND: C1.2, C2.2, C3.2, C4.2, C5.2, C6.2 (MINUS), C7.2 (MINUS), C8.2, J2.2 (ACTUATOR RETURN), Q1.3 (SOURCE), R10.2, R12.2, R14.2, R16.2, U1.3 (GND), U1.4 (INB), U1.8 (ENB), U2.5 (GND), U3.5 (GND), U4.5 (2A), U4.6 (2B), U4.7 (GND), U4.8 (3A), U4.9 (3B), U4.11 (4A), U4.12 (4B), U5.3 (VSS)
ADJ: R15.2, R16.1, U6.1 (ADJ)
CARRIER_5V: C9.1, J1.3 (INPUT LED POWER), R3.1, R4.1
CARRIER_GND: C9.2, D3.2 (A), D4.2 (A), J1.4 (INPUT RETURN), Q2.1 (EMITTER), Q3.1 (EMITTER), R5.2, R6.2
DRIVE: R13.1, U1.7 (OUTA)
ENA: R11.2, R12.1, U1.1 (ENA)
GATE: Q1.1 (GATE), R13.2, R14.1
IAC_LS: D1.2 (A), J3.2 (VALVE LOW SIDE), Q1.2 (DRAIN / LIVE TAB)
IDLE_CMD: J1.1 (GPIO3), R1.1
INA: R9.2, R10.1, U1.2 (INA)
LOCAL_OK: R11.1, U5.1 (RESET_N / D BONDOUT)
PWM_BASE: D3.1 (K / BAND), Q2.2 (BASE), R1.2, R5.1
PWM_LED_A: R3.2, U2.2 (ANODE)
PWM_LED_K: Q2.3 (COLLECTOR), U2.3 (CATHODE)
PWM_N: R7.2, U2.6 (OUT), U4.2 (1A)
PWM_RUN: R9.1, U4.1 (1Y)
RUN_5V: J1.2 (HARDWARE RUN), R2.1
RUN_BASE: D4.1 (K / BAND), Q3.2 (BASE), R2.2, R6.1
RUN_LED_A: R4.2, U3.2 (ANODE)
RUN_LED_K: Q3.3 (COLLECTOR), U3.3 (CATHODE)
RUN_N: R8.2, U3.6 (OUT), U4.3 (1B)

Notes on the sheet:
IAC-DRAFT2 / PHYSICAL OUTPUT DISABLED / HOLD. Optical input domain, separate actuator rail/ground. No safety-isolation, valve, engine or enclosure qualification.

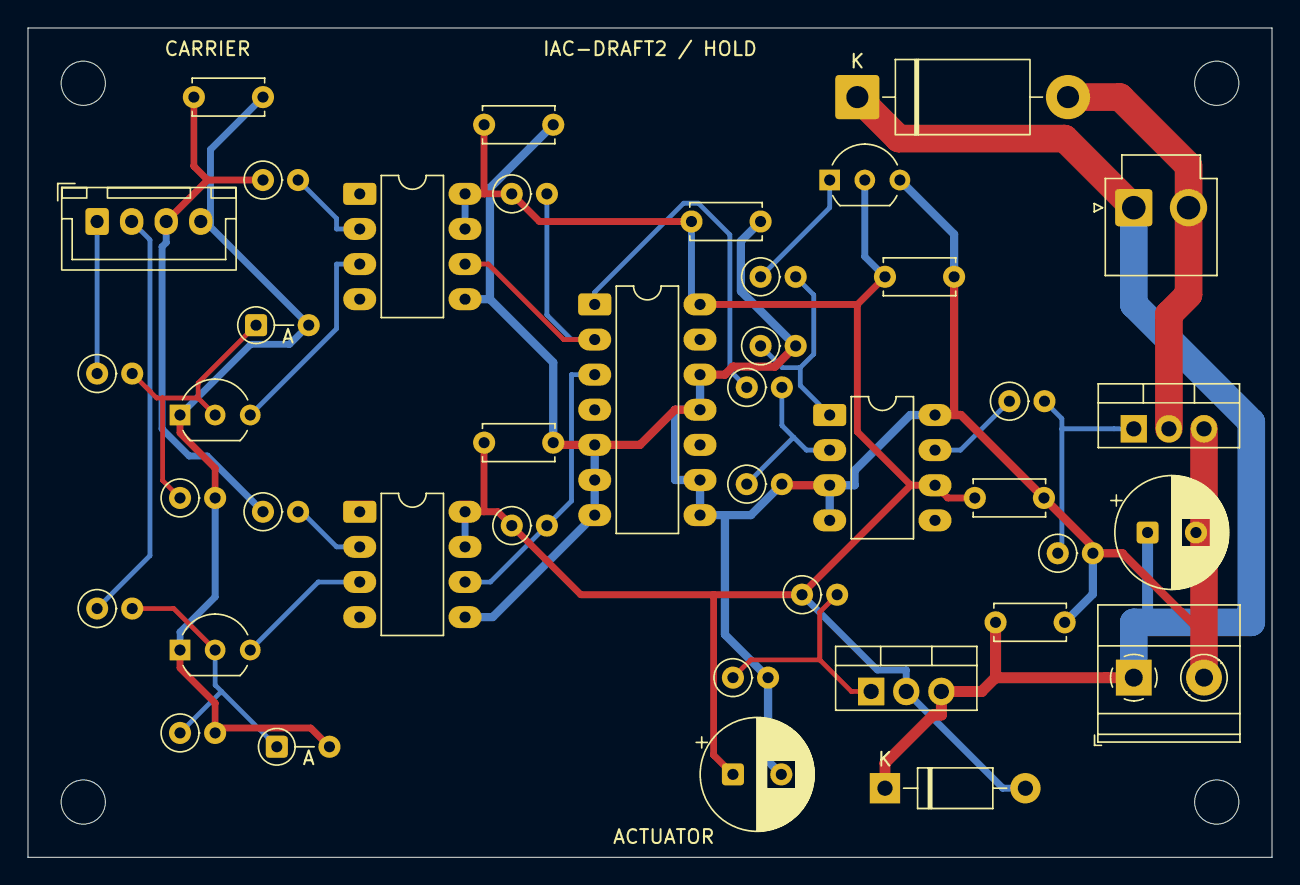
[picture p189: board isolated.kicad_pcb from above]

Board: 2 copper layers, 90.0 x 60.0 mm, 45 parts (0 on the bottom side), 23 nets.

Other parts of the board:
H1, H2, H3, H4: M3 ISOLATED MOUNT; MountingHole_3.2mm_M3
