markthebault/esp32-ecu/hardware/switch-inputs/switches.kicad_pcb

## KiCad design hardware/switch-inputs/switches.kicad_pcb (2026-11-06)

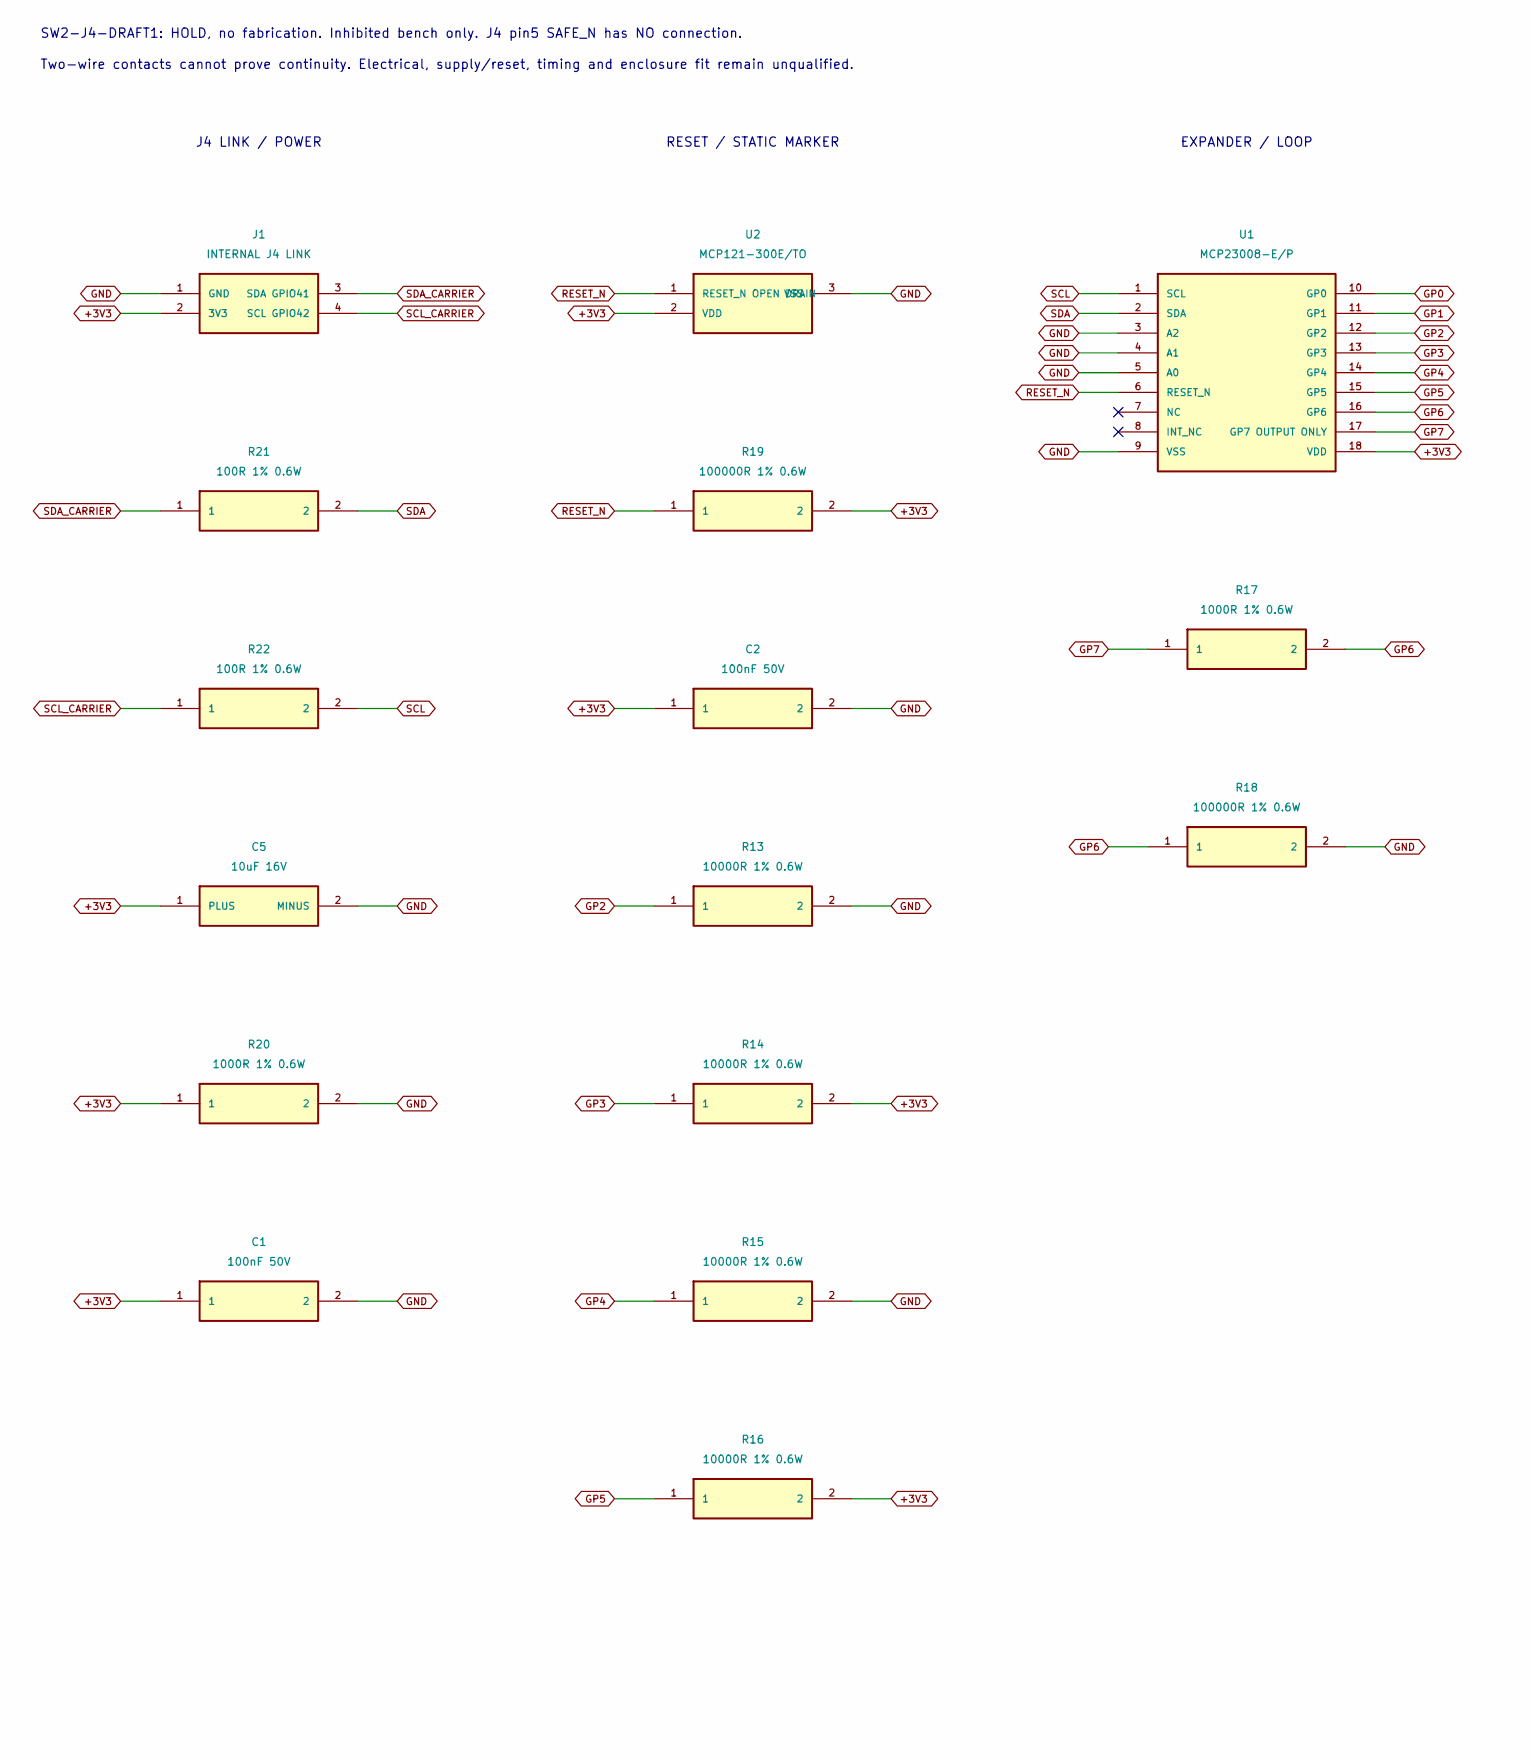
[picture p190: schematic switches.kicad_sch, Protected switch accessory SW2-J4-DRAFT1, part in row 1, column 1]

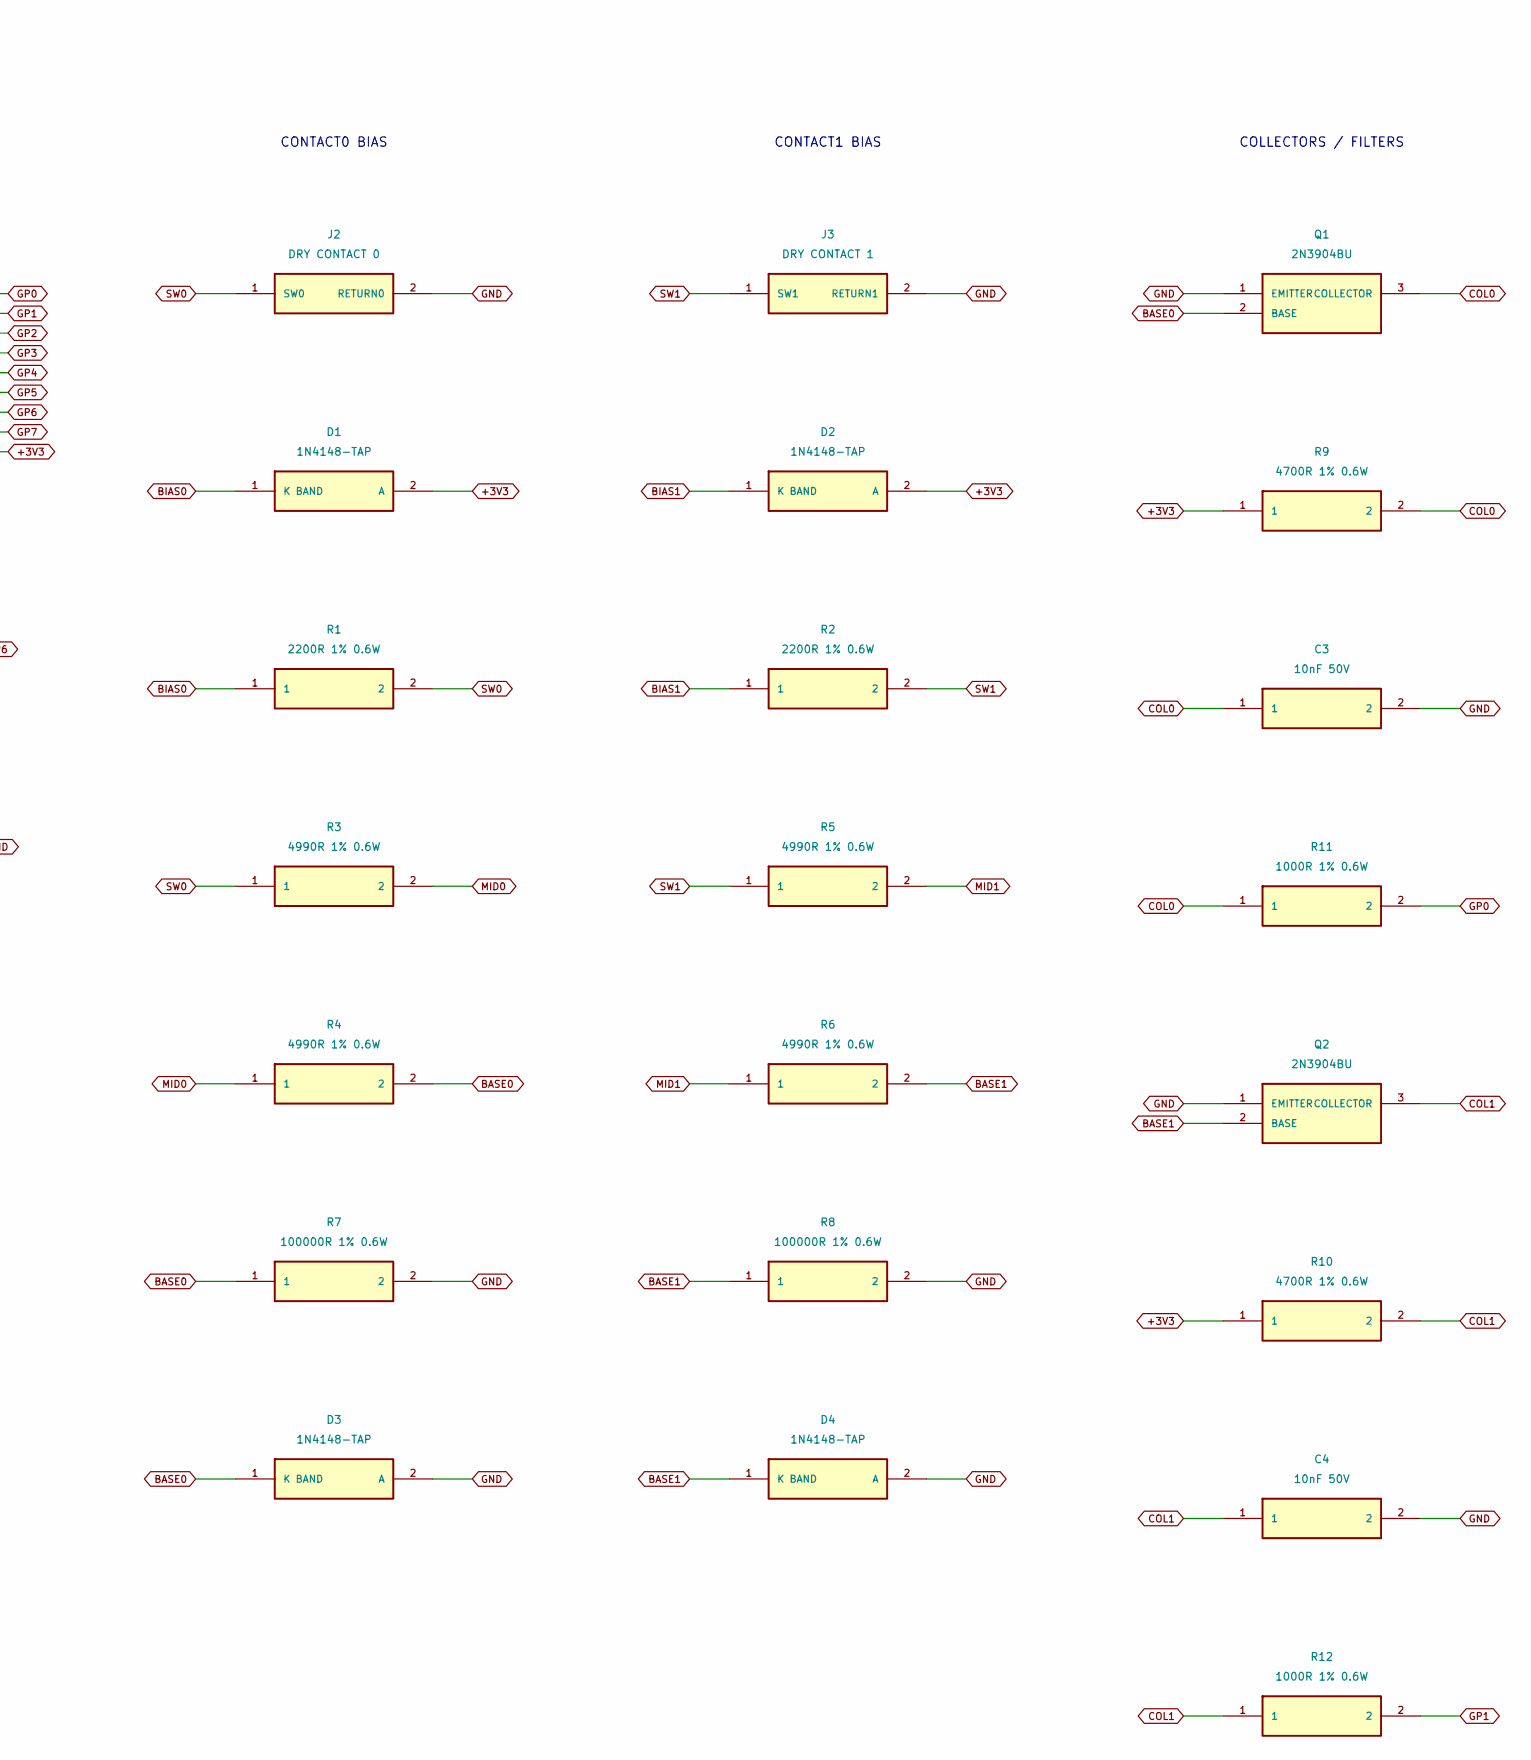
[picture p191: schematic switches.kicad_sch, Protected switch accessory SW2-J4-DRAFT1, part in row 1, column 2]

Parts:
C1, C2: 100nF 50V; C_Disc_D5.0mm_W2.5mm_P5.00mm
C3, C4: 10nF 50V; C_Disc_D5.0mm_W2.5mm_P5.00mm
C5: 10uF 16V; CP_Radial_D8.0mm_P3.50mm
D1, D2, D3, D4: 1N4148-TAP; D_DO-35_SOD27_P3.81mm_Vertical_AnodeUp; MPN 1N4148-TAP
J1: INTERNAL J4 LINK; JST_XH_B4B-XH-A_1x04_P2.50mm_Vertical; MPN B4B-XH-A(LF)(SN)
J2: DRY CONTACT 0; JST_VH_B2P-VH_1x02_P3.96mm_Vertical; MPN B2P-VH(LF)(SN)
J3: DRY CONTACT 1; JST_VH_B2P-VH_1x02_P3.96mm_Vertical; MPN B2P-VH(LF)(SN)
Q1, Q2: 2N3904BU; TO-92_Inline_Wide; MPN 2N3904BU
R1, R2: 2200R 1% 0.6W; R_Axial_DIN0207_L6.3mm_D2.5mm_P2.54mm_Vertical; MPN MRS25000C2201FCT00
R3, R4, R5, R6: 4990R 1% 0.6W; R_Axial_DIN0207_L6.3mm_D2.5mm_P2.54mm_Vertical; MPN MRS25000C4991FCT00
R7, R8, R18, R19: 100000R 1% 0.6W; R_Axial_DIN0207_L6.3mm_D2.5mm_P2.54mm_Vertical; MPN MRS25000C1003FCT00
R9, R10: 4700R 1% 0.6W; R_Axial_DIN0207_L6.3mm_D2.5mm_P2.54mm_Vertical; MPN MRS25000C4701FCT00
R11, R12, R17, R20: 1000R 1% 0.6W; R_Axial_DIN0207_L6.3mm_D2.5mm_P2.54mm_Vertical; MPN MRS25000C1001FCT00
R13, R14, R15, R16: 10000R 1% 0.6W; R_Axial_DIN0207_L6.3mm_D2.5mm_P2.54mm_Vertical; MPN MRS25000C1002FCT00
R21, R22: 100R 1% 0.6W; R_Axial_DIN0207_L6.3mm_D2.5mm_P2.54mm_Vertical; MPN MRS25000C1000FCT00
U1: MCP23008-E/P; DIP-18_W7.62mm_LongPads; MPN MCP23008-E/P
U2: MCP121-300E/TO; TO-92_Inline_Wide; MPN MCP121-300E/TO

Connections:
+3V3: C1.1, C2.1, C5.1 (PLUS), D1.2 (A), D2.2 (A), J1.2 (3V3), R9.1, R10.1, R14.2, R16.2, R19.2, R20.1, U1.18 (VDD), U2.2 (VDD)
BASE0: D3.1 (K BAND), Q1.2 (BASE), R4.2, R7.1
BASE1: D4.1 (K BAND), Q2.2 (BASE), R6.2, R8.1
BIAS0: D1.1 (K BAND), R1.1
BIAS1: D2.1 (K BAND), R2.1
COL0: C3.1, Q1.3 (COLLECTOR), R9.2, R11.1
COL1: C4.1, Q2.3 (COLLECTOR), R10.2, R12.1
GND: C1.2, C2.2, C3.2, C4.2, C5.2 (MINUS), D3.2 (A), D4.2 (A), J1.1 (GND), J2.2 (RETURN0), J3.2 (RETURN1), Q1.1 (EMITTER), Q2.1 (EMITTER), R7.2, R8.2, R13.2, R15.2, R18.2, R20.2, U1.3 (A2), U1.4 (A1), U1.5 (A0), U1.9 (VSS), U2.3 (VSS)
GP0: R11.2, U1.10 (GP0)
GP1: R12.2, U1.11 (GP1)
GP2: R13.1, U1.12 (GP2)
GP3: R14.1, U1.13 (GP3)
GP4: R15.1, U1.14 (GP4)
GP5: R16.1, U1.15 (GP5)
GP6: R17.2, R18.1, U1.16 (GP6)
GP7: R17.1, U1.17 (GP7 OUTPUT ONLY)
MID0: R3.2, R4.1
MID1: R5.2, R6.1
RESET_N: R19.1, U1.6 (RESET_N), U2.1 (RESET_N OPEN DRAIN)
SCL: R22.2, U1.1 (SCL)
SCL_CARRIER: J1.4 (SCL GPIO42), R22.1
SDA: R21.2, U1.2 (SDA)
SDA_CARRIER: J1.3 (SDA GPIO41), R21.1
SW0: J2.1 (SW0), R1.2, R3.1
SW1: J3.1 (SW1), R2.2, R5.1

Notes on the sheet:
SW2-J4-DRAFT1: HOLD, no fabrication. Inhibited bench only. J4 pin5 SAFE_N has NO connection.
Two-wire contacts cannot prove continuity. Electrical, supply/reset, timing and enclosure fit remain unqualified.
J4 LINK / POWER
RESET / STATIC MARKER
EXPANDER / LOOP
CONTACT0 BIAS
CONTACT1 BIAS
COLLECTORS / FILTERS

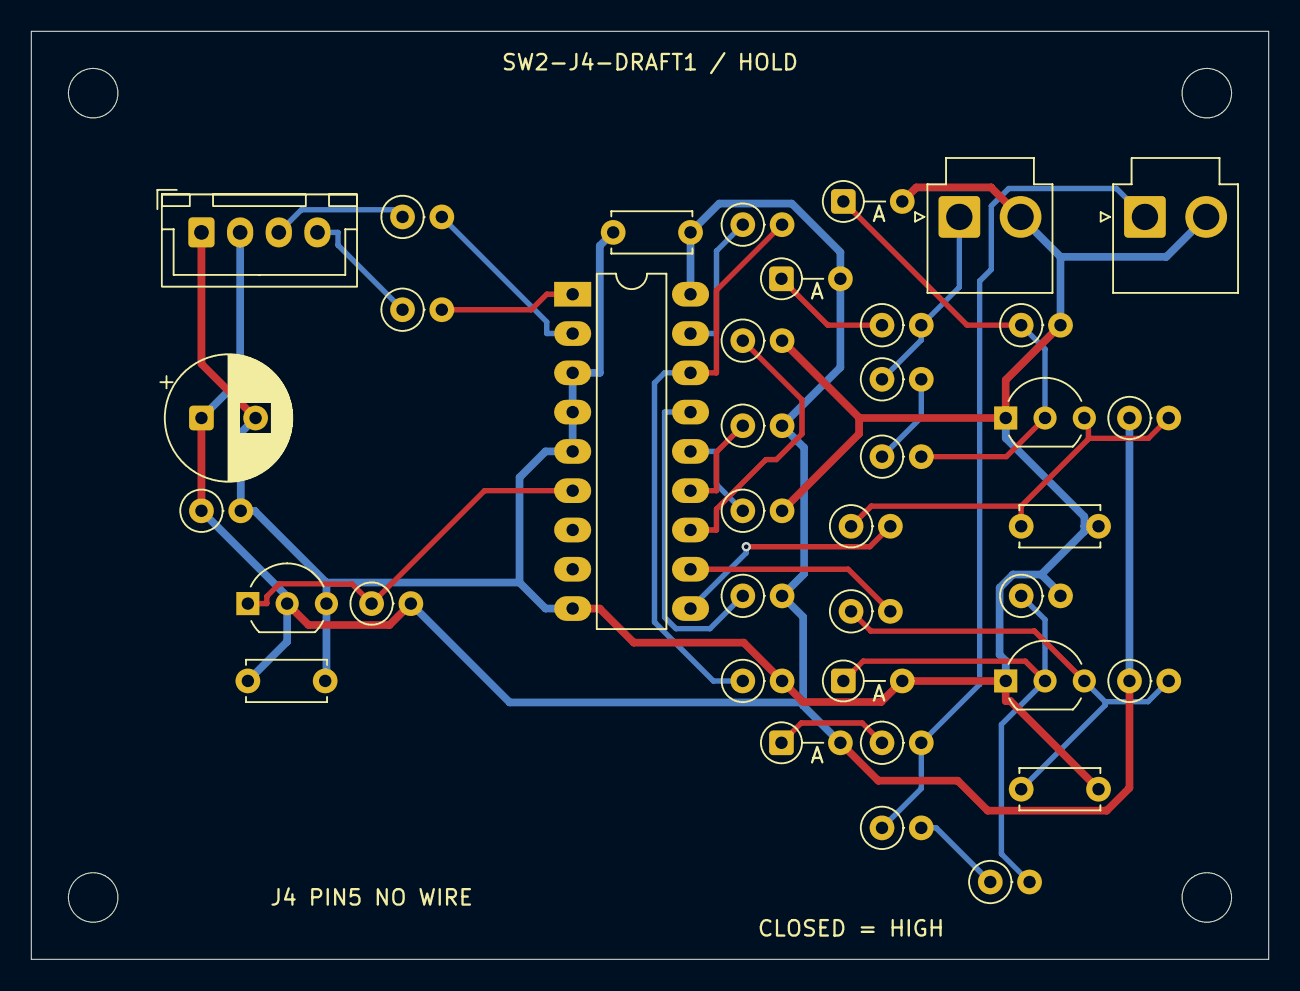
[picture p192: board switches.kicad_pcb from above]

Board: 2 copper layers, 80.0 x 60.0 mm, 42 parts (0 on the bottom side), 25 nets.

Other parts of the board:
H1, H2, H3, H4: M3 INSULATED MOUNT; MountingHole_3.2mm_M3
