markthebault/esp32-ecu/hardware/idle-accessory/idle.kicad_pcb

## KiCad design hardware/idle-accessory/idle.kicad_pcb (2026-11-06)

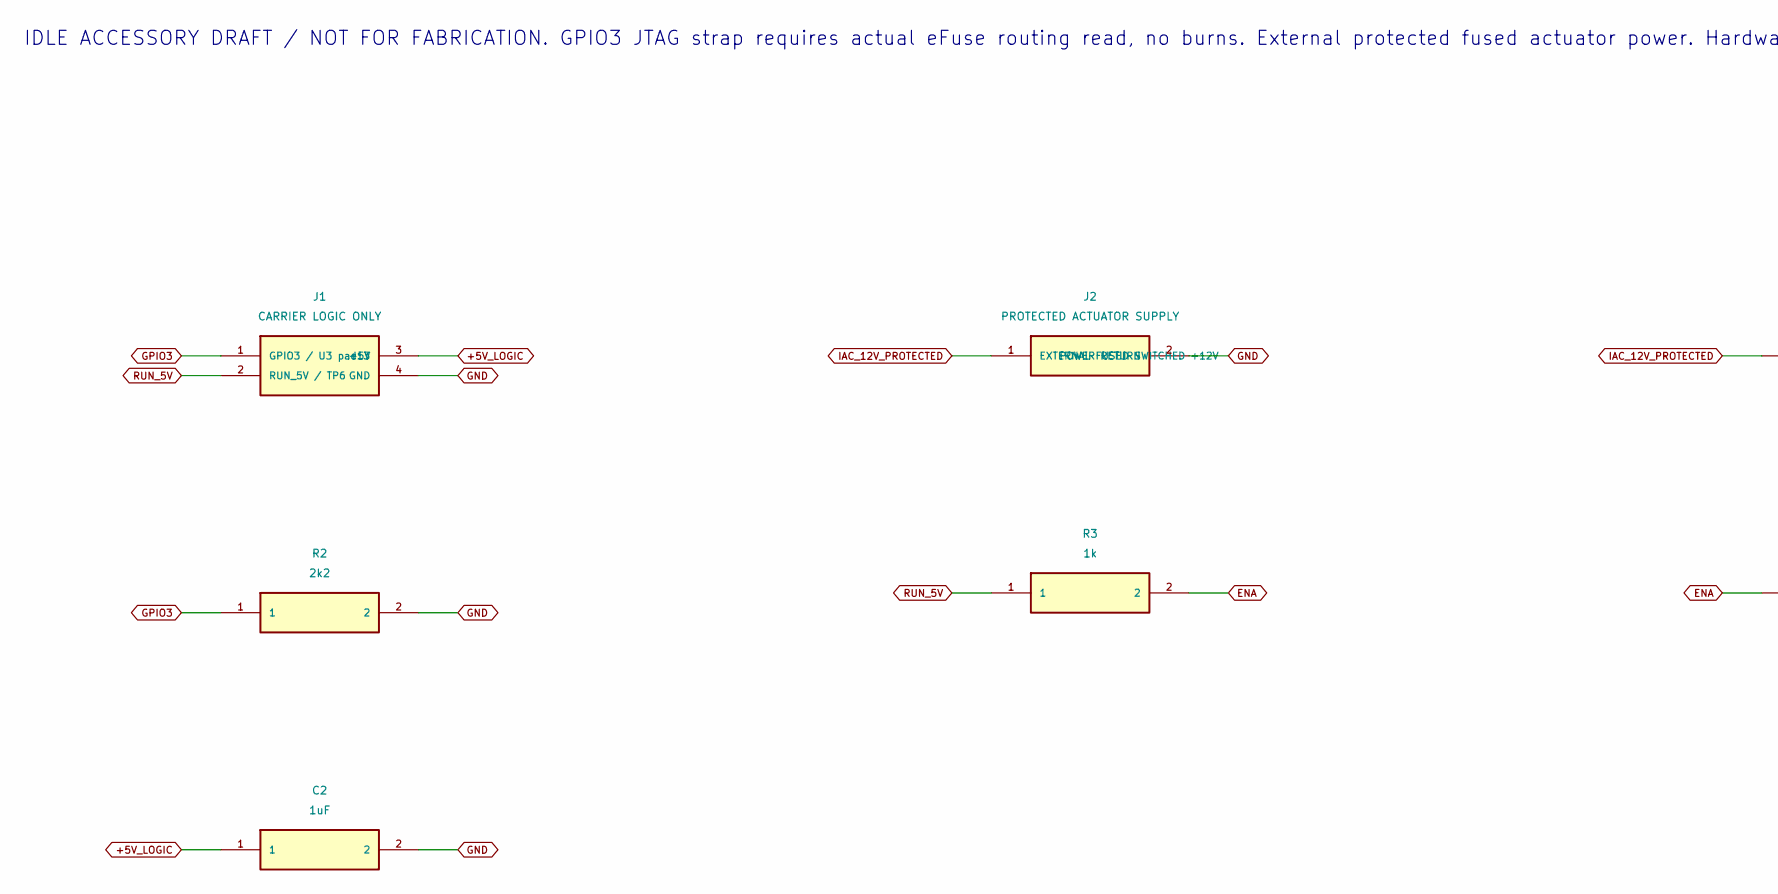
[picture p193: schematic idle.kicad_sch, ESP32 ECU idle accessory / placement draft, part in row 1, column 1]

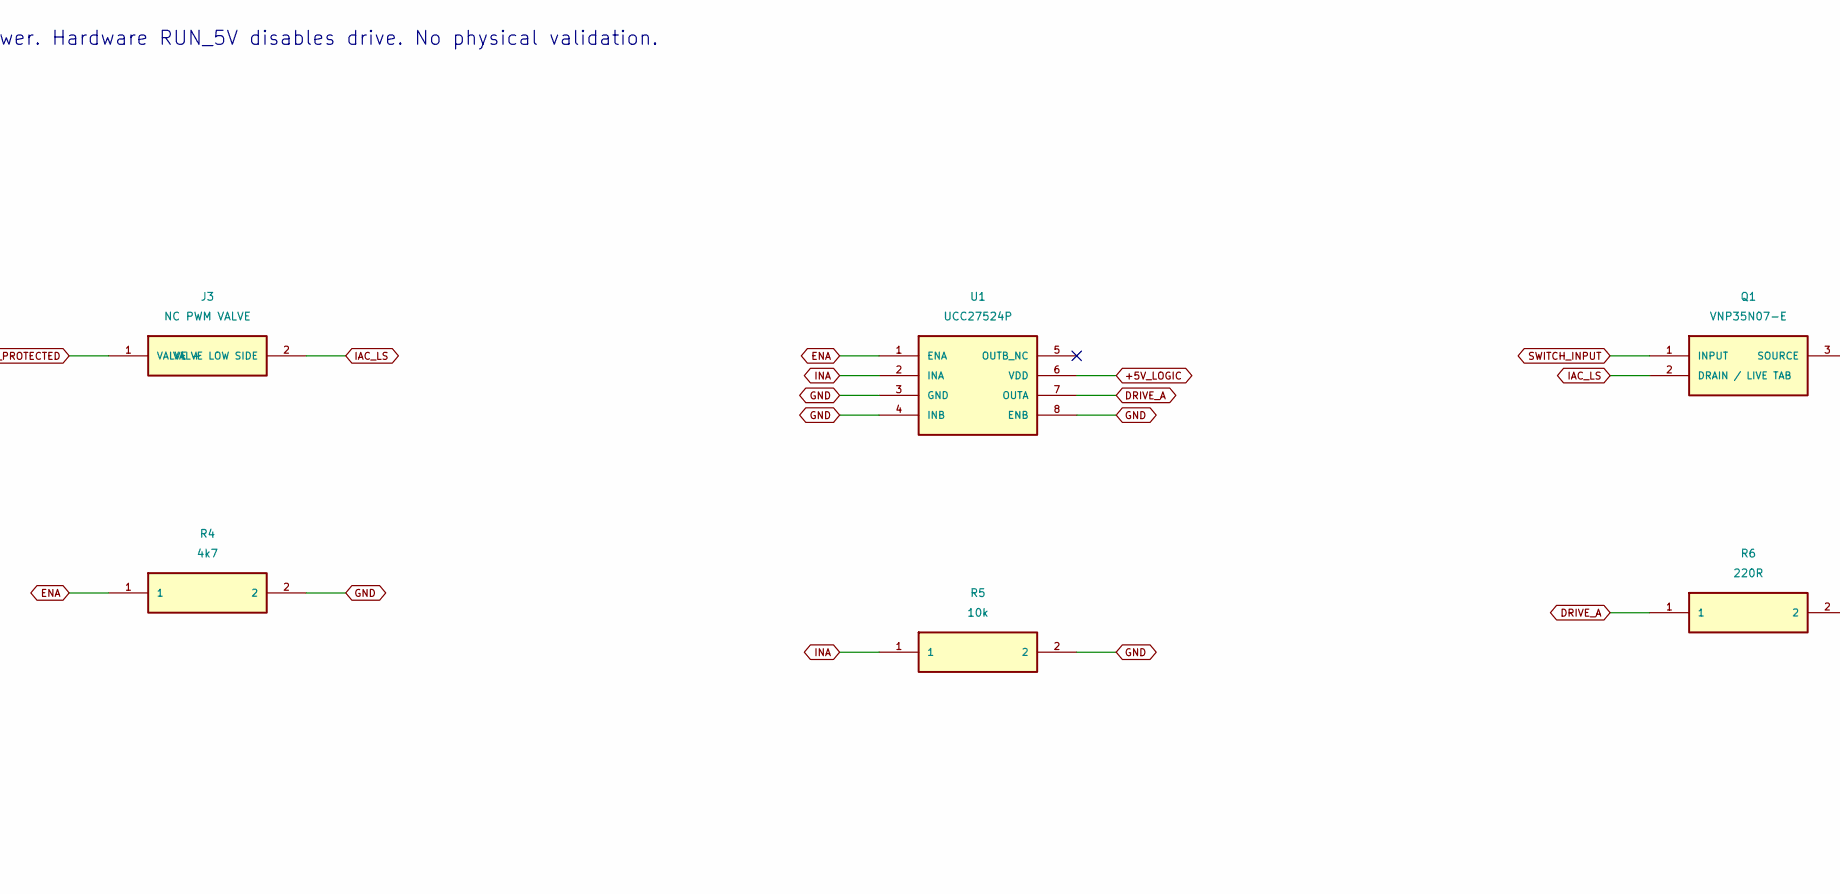
[picture p194: schematic idle.kicad_sch, ESP32 ECU idle accessory / placement draft, part in row 1, column 2]

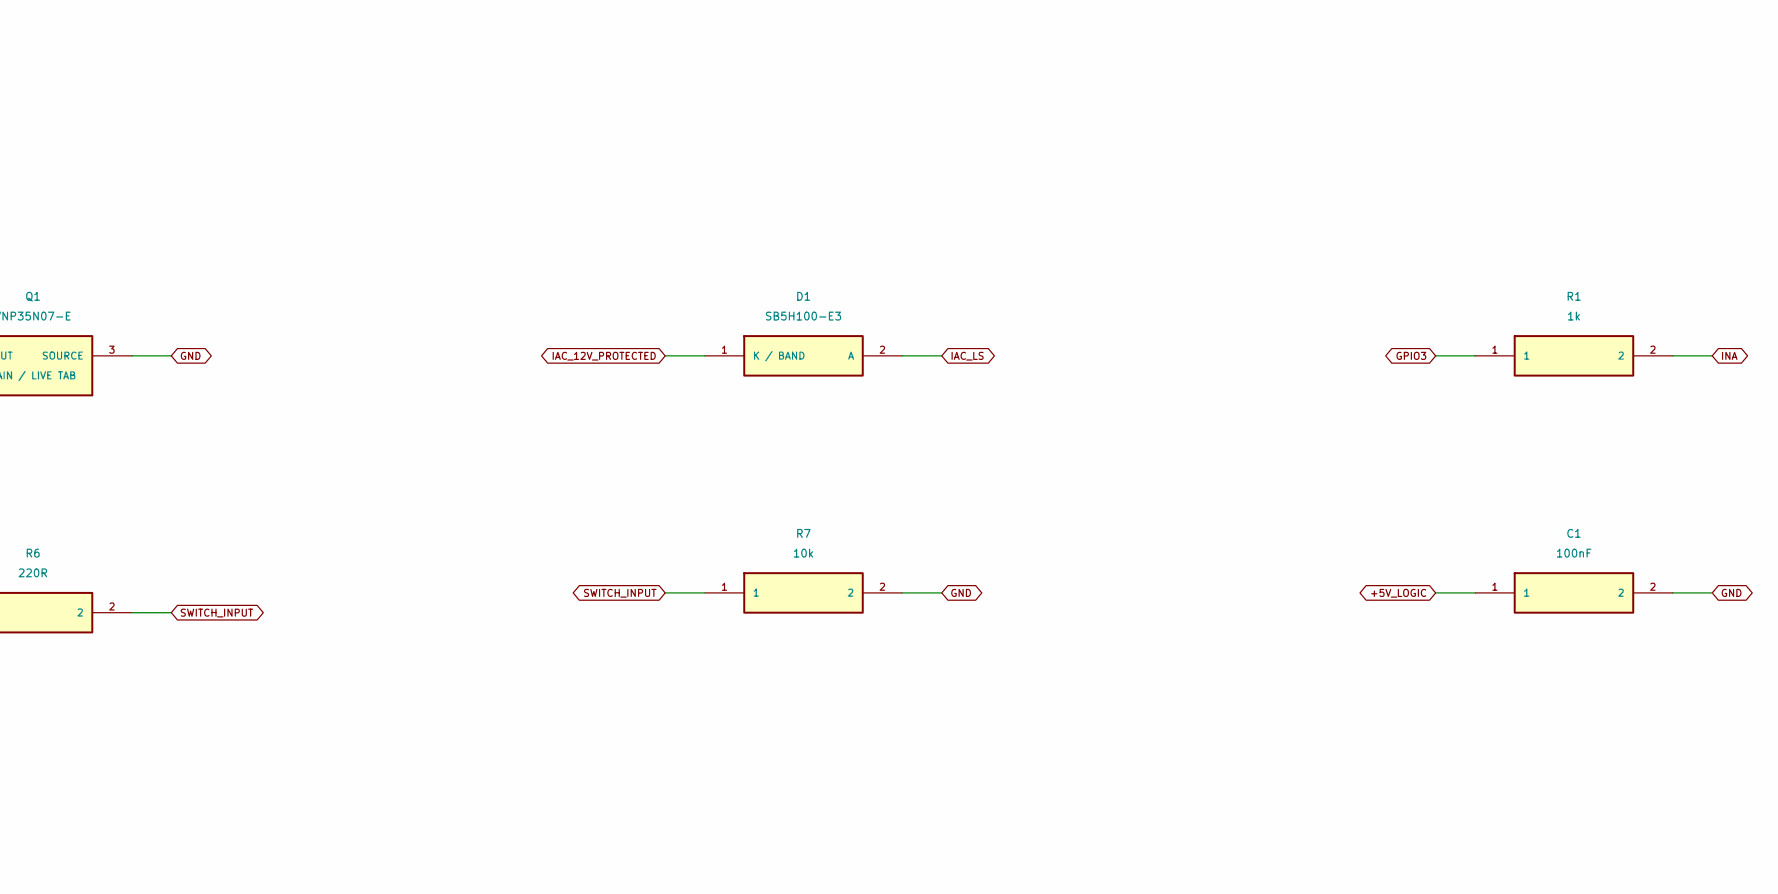
[picture p195: schematic idle.kicad_sch, ESP32 ECU idle accessory / placement draft, part in row 1, column 3]

Parts:
C1: 100nF; C_Disc_D5.0mm_W2.5mm_P5.00mm
C2: 1uF; C_Rect_L7.2mm_W5.0mm_P5.00mm
D1: SB5H100-E3; D_DO-201AD_P15.24mm_Horizontal; MPN SB5H100-E3/54
J1: CARRIER LOGIC ONLY; JST_XH_B4B-XH-A_1x04_P2.50mm_Vertical; MPN B4B-XH-A(LF)(SN)
J2: PROTECTED ACTUATOR SUPPLY; TerminalBlock_Phoenix_MKDS-1,5-2-5.08_1x02_P5.08mm_Horizont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; MPN 1715721
J3: NC PWM VALVE; JST_VH_B2P-VH_1x02_P3.96mm_Vertical; MPN B2P-VH(LF)(SN)
Q1: VNP35N07-E; TO-220-3_Vertical; MPN VNP35N07-E
R1, R3: 1k; R_Axial_DIN0207_L6.3mm_D2.5mm_P2.54mm_Vertical
R2: 2k2; R_Axial_DIN0207_L6.3mm_D2.5mm_P2.54mm_Vertical
R4: 4k7; R_Axial_DIN0207_L6.3mm_D2.5mm_P2.54mm_Vertical
R5, R7: 10k; R_Axial_DIN0207_L6.3mm_D2.5mm_P2.54mm_Vertical
R6: 220R; R_Axial_DIN0207_L6.3mm_D2.5mm_P2.54mm_Vertical
U1: UCC27524P; DIP-8_W7.62mm_LongPads; MPN UCC27524P.B

Connections:
+5V_LOGIC: C1.1, C2.1, J1.3 (+5V), U1.6 (VDD)
DRIVE_A: R6.1, U1.7 (OUTA)
ENA: R3.2, R4.1, U1.1 (ENA)
GND: C1.2, C2.2, J1.4 (GND), J2.2 (POWER RETURN), Q1.3 (SOURCE), R2.2, R4.2, R5.2, R7.2, U1.3 (GND), U1.4 (INB), U1.8 (ENB)
GPIO3: J1.1 (GPIO3 / U3 pad13), R1.1, R2.1
IAC_12V_PROTECTED: D1.1 (K / BAND), J2.1 (EXTERNAL FUSED SWITCHED +12V), J3.1 (VALVE +)
IAC_LS: D1.2 (A), J3.2 (VALVE LOW SIDE), Q1.2 (DRAIN / LIVE TAB)
INA: R1.2, R5.1, U1.2 (INA)
RUN_5V: J1.2 (RUN_5V / TP6), R3.1
SWITCH_INPUT: Q1.1 (INPUT), R6.2, R7.1

Notes on the sheet:
IDLE ACCESSORY DRAFT / NOT FOR FABRICATION. GPIO3 JTAG strap requires actual eFuse routing read, no burns. External protected fused actuator power. Hardware RUN_5V disables drive. No physical validation.

Board: 2 copper layers, 19 parts (0 on the bottom side), 10 nets, no tracks yet.

Other parts of the board:
H1, H2, H3, H4: M3 MOUNT; MountingHole_3.2mm_M3
