markthebault/esp32-ecu/firmware/include/ecu/config.hpp

#pragma once
#include <array>
#include <cmath>
#include <cstdint>
#include <cstring>
namespace ecu::config {
constexpr unsigned kSensors=6, kPoints=16;
enum class Mode { Voltage, Linear, Table, Ntc };
struct Point { double v{}, value{}; };
struct Sensor {
 char id[16]{},label[64]{},unit[16]{};Mode mode{Mode::Voltage};bool confirmed{},pullup_fitted{};
 bool ratiometric{};double reference_supply_v{5};
 double fault_low_v{.02},fault_high_v{5.15},filter_ms{100},v0{.5},y0{},v1{4.5},y1{100};
 double ntc_r0_ohm{10000},ntc_t0_c{25},ntc_beta_k{3950},pullup_ohm{2490};
 unsigned point_count{2};std::array<Point,kPoints> points{};
};
struct Config {std::uint32_t revision{1};char name[64]{"ECU bench profile"};double adc_reference_v{3.3};unsigned ui_poll_ms{500},slots{60},missing{2},max_rpm{8000};std::array<Sensor,kSensors> sensors{};};
inline bool finite(double x){return std::isfinite(x);}
inline bool valid(const Config& c){
 if (!finite(c.adc_reference_v)||c.adc_reference_v<2.9||c.adc_reference_v>3.6||c.ui_poll_ms<100||c.ui_poll_ms>2000||c.slots<12||c.slots>120||c.missing<1||c.missing>3||c.missing>=c.slots/4||c.max_rpm<500||c.max_rpm>12000)return false;
 const char* ids[]={"map","tps","clt","iat","wideband","postcat"};
 for(unsigned i=0;i<kSensors;++i){const auto&s=c.sensors[i];
  if(std::strcmp(s.id,ids[i])||!s.label[0]||!s.unit[0]||!finite(s.fault_low_v)||!finite(s.fault_high_v)||s.fault_low_v<0||s.fault_high_v>5.3||s.fault_low_v>=s.fault_high_v||!finite(s.filter_ms)||s.filter_ms<0||s.filter_ms>2000)return false;
  if(!finite(s.v0)||!finite(s.v1)||s.v0<0||s.v1>5.3||s.v1-s.v0<.01||!finite(s.y0)||!finite(s.y1)||std::abs(s.y0)>100000||std::abs(s.y1)>100000)return false;
  if(s.point_count<2||s.point_count>kPoints)return false;
  for(unsigned p=0;p<s.point_count;++p)if(!finite(s.points[p].v)||!finite(s.points[p].value)||s.points[p].v<0||s.points[p].v>5.3||std::abs(s.points[p].value)>100000||(p&&s.points[p].v-s.points[p-1].v<.001))return false;
  if(!finite(s.ntc_r0_ohm)||s.ntc_r0_ohm<100||s.ntc_r0_ohm>1000000||!finite(s.ntc_t0_c)||s.ntc_t0_c< -50||s.ntc_t0_c>150||!finite(s.ntc_beta_k)||s.ntc_beta_k<1000||s.ntc_beta_k>10000||!finite(s.pullup_ohm)||s.pullup_ohm<100||s.pullup_ohm>100000)return false;
  if(s.mode==Mode::Ntc&&(!(i==2||i==3)||!s.pullup_fitted))return false;
  if(!finite(s.reference_supply_v)||s.reference_supply_v<4||s.reference_supply_v>5.3||
     (s.ratiometric&&s.mode!=Mode::Linear&&s.mode!=Mode::Table))return false;
 }
 return true;
}
// Readout filters use this voltage basis. Ratiometric samples are normalized
// before filtering, while the engine continues using instantaneous readings.
inline double transfer_voltage(const Sensor&s,double sensor_v,double supply){
 if(!s.ratiometric)return sensor_v;
 if((s.mode!=Mode::Linear&&s.mode!=Mode::Table)||!finite(s.reference_supply_v)||
    s.reference_supply_v<4||s.reference_supply_v>5.3||!finite(supply)||supply<4||supply>5.3)return NAN;
 return sensor_v*s.reference_supply_v/supply;
}
inline double readout_filter(const Sensor&s,double sensor_v,double supply,double previous,
                             double dt_ms,bool reset,bool adc_ok=true){
 if(s.ratiometric&&!adc_ok)return NAN;
 const double v=transfer_voltage(s,sensor_v,supply);
 if(!finite(v))return NAN;
 if(reset||s.filter_ms<=0||!finite(previous))return v;
 return previous+dt_ms/(s.filter_ms+dt_ms)*(v-previous);
}
struct Reading {double value{},sensor_v{},adc_v{},transfer_v{NAN};bool valid{};const char* fault{"waiting"};};
inline Reading convert(const Sensor&s,double sensor_v,double adc_v,double supply,const double*filtered_transfer=nullptr){
 Reading r{};r.sensor_v=sensor_v;r.adc_v=adc_v;r.transfer_v=transfer_voltage(s,sensor_v,supply);
 if(!finite(sensor_v)||!finite(adc_v)){r.fault="invalid sample";return r;}
 if(sensor_v<s.fault_low_v){r.fault="below input range";return r;}if(sensor_v>s.fault_high_v){r.fault="above input range";return r;}
 if(s.ratiometric&&!finite(r.transfer_v)){r.fault="ratiometric supply or configuration invalid";return r;}
 if(s.ratiometric&&filtered_transfer)r.transfer_v=*filtered_transfer;
 if(!finite(r.transfer_v)){r.fault="conversion voltage unavailable";return r;}
 const double input_v=r.transfer_v;
 if(s.mode==Mode::Voltage)r.value=sensor_v;
 else if(s.mode==Mode::Linear){if(input_v<s.v0||input_v>s.v1){r.fault="outside calibration";return r;}r.value=s.y0+(input_v-s.v0)*(s.y1-s.y0)/(s.v1-s.v0);}
 else if(s.mode==Mode::Table){
  if(input_v<s.points[0].v||input_v>s.points[s.point_count-1].v){r.fault="outside calibration";return r;}
  unsigned p=1;while(p<s.point_count-1&&input_v>s.points[p].v)++p;
  const auto&a=s.points[p-1];const auto&b=s.points[p];r.value=a.value+(input_v-a.v)*(b.value-a.value)/(b.v-a.v);
 }else{
  if(!s.pullup_fitted){r.fault="pull-up not confirmed";return r;}
  if(!finite(supply)||supply<4||supply>5.3||sensor_v<=.001||sensor_v>=supply){r.fault="supply / NTC wiring";return r;}
  const double req=s.pullup_ohm*sensor_v/(supply-sensor_v);
  const double inv=1/req-1/55000.0; // The board's 22k + 33k divider loads the sensor.
  if(inv<=0){r.fault="NTC open / wrong pull-up";return r;}
  const double resistance=1/inv, kelvin=1/(1/(s.ntc_t0_c+273.15)+std::log(resistance/s.ntc_r0_ohm)/s.ntc_beta_k);
  r.value=kelvin-273.15;
  if(!finite(r.value)||r.value< -80||r.value>250){r.fault="NTC curve / open circuit";return r;}
 }
 r.valid=finite(r.value);r.fault=r.valid?"ok":"invalid conversion";return r;
}
}
