markthebault/esp32-ecu/firmware/include/ecu/engine_json.hpp

#pragma once
#include "ecu/transient_json.hpp"
#include "ecu/load_json.hpp"
#include "ecu/engine.hpp"
#include "ecu/secondary_json.hpp"
#include "ecu/flex_json.hpp"
#include "ecu/boost_json.hpp"
#include "ecu/json.hpp"
#include <string>
#include <cstdio>
namespace ecu::engine {
// Strict engine schema shared by target and host. Sensor calibration has its
// own unrelated schema. Legacy engine v1 is accepted only as batch/wasted.
template<std::size_t N>bool float_array(const cJSON*j,std::array<float,N>&a){
 if(!cJSON_IsArray(j)||cJSON_GetArraySize(j)!=int(N))return false;
 for(unsigned i=0;i<N;++i){auto*v=cJSON_GetArrayItem(j,i);if(!cJSON_IsNumber(v)||!finite(v->valuedouble)||std::abs(v->valuedouble)>1e6)return false;a[i]=static_cast<float>(v->valuedouble);}return true;
}
template<class Grid>inline bool map_parse(const cJSON*j,Grid&m){return web::keys(j,"|rpm||load||cells|")&&float_array(cJSON_GetObjectItemCaseSensitive(j,"rpm"),m.rpm)&&float_array(cJSON_GetObjectItemCaseSensitive(j,"load"),m.load)&&float_array(cJSON_GetObjectItemCaseSensitive(j,"cells"),m.cells);}
inline bool parse_tune(const cJSON*j,Tune&t){
 using namespace web;unsigned schema;char strategy[32]{},physical[32]{};
 if(!integer(j,"schema_version",schema)||(schema<1||schema>11))return false;
 // Historical identities migrate to Off; schema8 then reads its full model.
 reset_secondary_tables(t);
 t.flex_fuel=flex::Config{};
 t.boost_control=boost::Config{};
 if(!keys(j,schema==1?"|schema_version||revision||strategy||physical_outputs||engine||settings||curves||maps|":schema==2?"|schema_version||revision||strategy||physical_outputs||engine||settings||curves||maps||timing|":schema==3?"|schema_version||revision||strategy||physical_outputs||engine||settings||curves||maps||timing||cylinder_trims|":schema<6?"|schema_version||revision||strategy||physical_outputs||engine||settings||curves||maps||timing||cylinder_trims||idle_control|":schema==6?"|schema_version||revision||strategy||physical_outputs||engine||settings||curves||maps||timing||cylinder_trims||idle_control||transient_enrichment|":schema==7?"|schema_version||revision||strategy||physical_outputs||engine||settings||curves||maps||timing||cylinder_trims||idle_control||transient_enrichment||load_model|":schema==8?"|schema_version||revision||strategy||physical_outputs||engine||settings||curves||maps||timing||cylinder_trims||idle_control||transient_enrichment||load_model||secondary_tables|":schema==9?"|schema_version||revision||strategy||physical_outputs||engine||settings||curves||maps||timing||cylinder_trims||idle_control||transient_enrichment||load_model||secondary_tables||flex_fuel|":"|schema_version||revision||strategy||physical_outputs||engine||settings||curves||maps||timing||cylinder_trims||idle_control||transient_enrichment||load_model||secondary_tables||flex_fuel||boost_control|")||!integer(j,"revision",t.revision)||!string(j,"strategy",strategy)||!string(j,"physical_outputs",physical)||std::strcmp(physical,"inhibited"))return false;
 if(schema>=10&&!boost::parse_config(cJSON_GetObjectItemCaseSensitive(j,"boost_control"),t.boost_control))return false;
 t.transient_enrichment=transient::Config{};
 t.load_model=load::Config{};
 if(schema>=6&&!transient::parse_config(cJSON_GetObjectItemCaseSensitive(j,"transient_enrichment"),t.transient_enrichment))return false;
 if(!std::strcmp(strategy,schema==11?"batch_wasted":"batch_wasted_4cyl"))t.strategy=Strategy::BatchWasted;
 else if(schema>=2&&!std::strcmp(strategy,schema==11?"sequential":"sequential_4cyl"))t.strategy=Strategy::Sequential;
 else if(schema>=5&&!std::strcmp(strategy,schema==11?"semi_sequential":"semi_sequential_4cyl"))t.strategy=Strategy::SemiSequential;
 else return false;
 auto*e=cJSON_GetObjectItemCaseSensitive(j,"engine");
 if(!keys(e,"|cylinders||displacement_cc||injector_cc_min||fuel_density_g_cc||stoich_afr|")||!integer(e,"cylinders",t.cylinders)||!t.cylinders||t.cylinders>8||(schema<11&&t.cylinders!=4))return false;
 const unsigned stored_cylinders=schema==11?8:4;
 auto number_float=[](const cJSON*o,const char*k,float&v){double n;if(!web::number(o,k,n)||std::abs(n)>1e6)return false;v=static_cast<float>(n);return true;};
 t.firing_order={1,3,4,2};t.injection_end_deg=540;t.cam_sync_deg=450;t.cam_window_deg=20;
 if(schema>=2){
  auto*timing=cJSON_GetObjectItemCaseSensitive(j,"timing");
  if(!keys(timing,"|firing_order||injection_end_deg||cam_sync_deg||cam_window_deg|")||!number_float(timing,"injection_end_deg",t.injection_end_deg)||!number_float(timing,"cam_sync_deg",t.cam_sync_deg)||!number_float(timing,"cam_window_deg",t.cam_window_deg))return false;
  auto*order=cJSON_GetObjectItemCaseSensitive(timing,"firing_order");if(!cJSON_IsArray(order)||cJSON_GetArraySize(order)!=int(stored_cylinders))return false;
  t.firing_order.fill(0);
  for(unsigned i=0;i<stored_cylinders;++i){auto*v=cJSON_GetArrayItem(order,i);if(!cJSON_IsNumber(v)||!range(v->valuedouble,schema==11?0:1,stored_cylinders)||v->valuedouble!=std::floor(v->valuedouble))return false;t.firing_order[i]=unsigned(v->valuedouble);}
 }
 t.cylinder_trims_enabled=false;t.cylinder_spark_deg.fill(0);t.cylinder_fuel={};
 if(schema>=3){
  auto*trims=cJSON_GetObjectItemCaseSensitive(j,"cylinder_trims");
  auto*spark=cJSON_GetObjectItemCaseSensitive(trims,"spark_deg");
  if(!keys(trims,"|enabled||spark_deg||fuel_maps|")||!boolean(trims,"enabled",t.cylinder_trims_enabled)||!cJSON_IsArray(spark)||cJSON_GetArraySize(spark)!=int(stored_cylinders))return false;
  auto*maps=cJSON_GetObjectItemCaseSensitive(trims,"fuel_maps");if(!cJSON_IsArray(maps)||cJSON_GetArraySize(maps)!=int(stored_cylinders))return false;
  for(unsigned i=0;i<stored_cylinders;++i){
   auto*v=cJSON_GetArrayItem(spark,i);if(!cJSON_IsNumber(v)||!range(v->valuedouble,-10,10))return false;t.cylinder_spark_deg[i]=static_cast<float>(v->valuedouble);
   if(!map_parse(cJSON_GetArrayItem(maps,i),t.cylinder_fuel[i]))return false;
  }
 }
 if(schema<11)for(unsigned i=4;i<8;++i){t.cylinder_fuel[i].rpm=t.cylinder_fuel[0].rpm;t.cylinder_fuel[i].load=t.cylinder_fuel[0].load;}
 if(schema>=7&&!load::parse_config(cJSON_GetObjectItemCaseSensitive(j,"load_model"),t.load_model,t.cylinder_trims_enabled))return false;
 if(schema>=8&&!secondary::parse_config(cJSON_GetObjectItemCaseSensitive(j,"secondary_tables"),t.secondary_tables,t.secondary_ve,t.secondary_spark,maximum_map_kpa(t)))return false;
 if(schema>=9&&!flex::parse_config(cJSON_GetObjectItemCaseSensitive(j,"flex_fuel"),t.flex_fuel))return false;
 if(!number_float(e,"displacement_cc",t.displacement_cc)||!number_float(e,"injector_cc_min",t.injector_cc_min)||!number_float(e,"fuel_density_g_cc",t.fuel_density_g_cc)||!number_float(e,"stoich_afr",t.stoich_afr))return false;
 if(schema<11&&(!range(t.displacement_cc,500,4000)||!range(t.injector_cc_min,100,1500)))return false;
 auto*s=cJSON_GetObjectItemCaseSensitive(j,"settings");
 if(!keys(s,"|cranking_rpm||crank_advance_deg||rpm_limit||rpm_hysteresis||soft_limit_band||max_duty||max_injection_ms||max_dwell_ms||tooth1_btdc_deg||afterstart_pct||afterstart_s||accel_threshold_pct_s||accel_gain||accel_decay_s||ego_enabled||ego_kp||ego_ki||ego_limit||ego_min_clt||dfco_enabled||dfco_rpm||dfco_hysteresis||dfco_tps||dfco_delay_s||idle_enabled||idle_target_rpm||idle_kp||idle_ki||fan_on_c||fan_off_c||pump_prime_s|"))return false;
#define FIELD(name) if(!number_float(s,#name,t.name))return false
 FIELD(cranking_rpm);FIELD(crank_advance_deg);FIELD(rpm_limit);FIELD(rpm_hysteresis);FIELD(soft_limit_band);FIELD(max_duty);FIELD(max_injection_ms);FIELD(max_dwell_ms);FIELD(tooth1_btdc_deg);FIELD(afterstart_pct);FIELD(afterstart_s);FIELD(accel_threshold_pct_s);FIELD(accel_gain);FIELD(accel_decay_s);FIELD(ego_kp);FIELD(ego_ki);FIELD(ego_limit);FIELD(ego_min_clt);FIELD(dfco_rpm);FIELD(dfco_hysteresis);FIELD(dfco_tps);FIELD(dfco_delay_s);FIELD(idle_target_rpm);FIELD(idle_kp);FIELD(idle_ki);FIELD(fan_on_c);FIELD(fan_off_c);FIELD(pump_prime_s);
#undef FIELD
 if(!boolean(s,"ego_enabled",t.ego_enabled)||!boolean(s,"dfco_enabled",t.dfco_enabled)||!boolean(s,"idle_enabled",t.idle_enabled))return false;
 t.idle_control=idle::Config{};
 if(schema>=4){
  auto*idle=cJSON_GetObjectItemCaseSensitive(j,"idle_control");char algorithm[20]{};
  if(!keys(idle,"|algorithm||frequency_hz||control_period_ms||min_pct||max_pct||tps_closed_pct||tps_hysteresis_pct||entry_rpm_above||exit_rpm_above||entry_delay_s||afterstart_taper_s||dashpot_pct||dashpot_decay_pct_s||slew_pct_s||integral_limit_pct||kd||derivative_filter_s||fast_idle_temp_c||fast_idle_hysteresis_c||coolant_c||run_pct||crank_pct||target_add_rpm|")||!string(idle,"algorithm",algorithm))return false;
  if(!std::strcmp(algorithm,"on_off"))t.idle_control.algorithm=idle::Algorithm::OnOff;
  else if(!std::strcmp(algorithm,"open_loop"))t.idle_control.algorithm=idle::Algorithm::OpenLoop;
  else if(!std::strcmp(algorithm,"closed_loop"))t.idle_control.algorithm=idle::Algorithm::ClosedLoop;
  else return false;
  if(!number_float(idle,"frequency_hz",t.idle_control.frequency_hz))return false;
  if(!number_float(idle,"control_period_ms",t.idle_control.control_period_ms))return false;
  if(!number_float(idle,"min_pct",t.idle_control.min_pct))return false;
  if(!number_float(idle,"max_pct",t.idle_control.max_pct))return false;
  if(!number_float(idle,"tps_closed_pct",t.idle_control.tps_closed_pct))return false;
  if(!number_float(idle,"tps_hysteresis_pct",t.idle_control.tps_hysteresis_pct))return false;
  if(!number_float(idle,"entry_rpm_above",t.idle_control.entry_rpm_above))return false;
  if(!number_float(idle,"exit_rpm_above",t.idle_control.exit_rpm_above))return false;
  if(!number_float(idle,"entry_delay_s",t.idle_control.entry_delay_s))return false;
  if(!number_float(idle,"afterstart_taper_s",t.idle_control.afterstart_taper_s))return false;
  if(!number_float(idle,"dashpot_pct",t.idle_control.dashpot_pct))return false;
  if(!number_float(idle,"dashpot_decay_pct_s",t.idle_control.dashpot_decay_pct_s))return false;
  if(!number_float(idle,"slew_pct_s",t.idle_control.slew_pct_s))return false;
  if(!number_float(idle,"integral_limit_pct",t.idle_control.integral_limit_pct))return false;
  if(!number_float(idle,"kd",t.idle_control.kd))return false;
  if(!number_float(idle,"derivative_filter_s",t.idle_control.derivative_filter_s))return false;
  if(!number_float(idle,"fast_idle_temp_c",t.idle_control.fast_idle_temp_c))return false;
  if(!number_float(idle,"fast_idle_hysteresis_c",t.idle_control.fast_idle_hysteresis_c))return false;
  if(!float_array(cJSON_GetObjectItemCaseSensitive(idle,"coolant_c"),t.idle_control.coolant_c))return false;
  if(!float_array(cJSON_GetObjectItemCaseSensitive(idle,"run_pct"),t.idle_control.run_pct))return false;
  if(!float_array(cJSON_GetObjectItemCaseSensitive(idle,"crank_pct"),t.idle_control.crank_pct))return false;
  if(!float_array(cJSON_GetObjectItemCaseSensitive(idle,"target_add_rpm"),t.idle_control.target_add_rpm))return false;
 }else t.idle_enabled=false; // Former virtual-idle tunes never activate the new output path.
 auto*c=cJSON_GetObjectItemCaseSensitive(j,"curves");
 if(!keys(c,"|coolant_c||warmup_pct||crank_pct||battery_v||deadtime_ms||dwell_ms|")||!float_array(cJSON_GetObjectItemCaseSensitive(c,"coolant_c"),t.coolant_c)||!float_array(cJSON_GetObjectItemCaseSensitive(c,"warmup_pct"),t.warmup_pct)||!float_array(cJSON_GetObjectItemCaseSensitive(c,"crank_pct"),t.crank_pct)||!float_array(cJSON_GetObjectItemCaseSensitive(c,"battery_v"),t.battery_v)||!float_array(cJSON_GetObjectItemCaseSensitive(c,"deadtime_ms"),t.deadtime_ms)||!float_array(cJSON_GetObjectItemCaseSensitive(c,"dwell_ms"),t.dwell_ms))return false;
 auto*m=cJSON_GetObjectItemCaseSensitive(j,"maps");if(!(keys(m,"|ve||spark||lambda|")&&map_parse(cJSON_GetObjectItemCaseSensitive(m,"ve"),t.ve)&&map_parse(cJSON_GetObjectItemCaseSensitive(m,"spark"),t.spark)&&map_parse(cJSON_GetObjectItemCaseSensitive(m,"lambda"),t.lambda)))return false;
 // Older identities retain their former validation, not just their defaults.
 if(schema<7)for(auto v:t.ve.cells)if(!range(v,20,120))return false;
 return !validate(t);
}
inline cJSON* idle_document(const idle::Config&c){
 auto*j=cJSON_CreateObject();if(!j)return nullptr;
 bool ok=cJSON_AddStringToObject(j,"algorithm",idle::algorithm_name(c.algorithm));
 ok=ok&&cJSON_AddNumberToObject(j,"frequency_hz",c.frequency_hz);
 ok=ok&&cJSON_AddNumberToObject(j,"control_period_ms",c.control_period_ms);
 ok=ok&&cJSON_AddNumberToObject(j,"min_pct",c.min_pct);
 ok=ok&&cJSON_AddNumberToObject(j,"max_pct",c.max_pct);
 ok=ok&&cJSON_AddNumberToObject(j,"tps_closed_pct",c.tps_closed_pct);
 ok=ok&&cJSON_AddNumberToObject(j,"tps_hysteresis_pct",c.tps_hysteresis_pct);
 ok=ok&&cJSON_AddNumberToObject(j,"entry_rpm_above",c.entry_rpm_above);
 ok=ok&&cJSON_AddNumberToObject(j,"exit_rpm_above",c.exit_rpm_above);
 ok=ok&&cJSON_AddNumberToObject(j,"entry_delay_s",c.entry_delay_s);
 ok=ok&&cJSON_AddNumberToObject(j,"afterstart_taper_s",c.afterstart_taper_s);
 ok=ok&&cJSON_AddNumberToObject(j,"dashpot_pct",c.dashpot_pct);
 ok=ok&&cJSON_AddNumberToObject(j,"dashpot_decay_pct_s",c.dashpot_decay_pct_s);
 ok=ok&&cJSON_AddNumberToObject(j,"slew_pct_s",c.slew_pct_s);
 ok=ok&&cJSON_AddNumberToObject(j,"integral_limit_pct",c.integral_limit_pct);
 ok=ok&&cJSON_AddNumberToObject(j,"kd",c.kd);
 ok=ok&&cJSON_AddNumberToObject(j,"derivative_filter_s",c.derivative_filter_s);
 ok=ok&&cJSON_AddNumberToObject(j,"fast_idle_temp_c",c.fast_idle_temp_c);
 ok=ok&&cJSON_AddNumberToObject(j,"fast_idle_hysteresis_c",c.fast_idle_hysteresis_c);
 auto add=[&](const char*name,const auto&values){auto*a=cJSON_CreateFloatArray(values.data(),values.size());if(!a||!cJSON_AddItemToObject(j,name,a)){cJSON_Delete(a);return false;}return true;};
 ok=ok&&add("coolant_c",c.coolant_c);
 ok=ok&&add("run_pct",c.run_pct);
 ok=ok&&add("crank_pct",c.crank_pct);
 ok=ok&&add("target_add_rpm",c.target_add_rpm);
 if(!ok){cJSON_Delete(j);return nullptr;}return j;
}
// Call only after parse_tune succeeds. Upgrade a private parsed tree, never a
// stored record. Failure discards that tree; no partial document is published.
inline bool upgrade_tune_document(cJSON*j){
 auto*schema=cJSON_GetObjectItemCaseSensitive(j,"schema_version");if(!cJSON_IsNumber(schema))return false;
 if(schema->valuedouble==11)return true;
 if(schema->valuedouble<1||schema->valuedouble>10||schema->valuedouble!=std::floor(schema->valuedouble))return false;
 if(schema->valuedouble==1){
  auto*timing=cJSON_CreateObject();if(!timing)return false;
  const double order[]={1,3,4,2};auto*a=cJSON_CreateDoubleArray(order,4);
  if(!a||!cJSON_AddItemToObject(timing,"firing_order",a)){cJSON_Delete(a);cJSON_Delete(timing);return false;}
  if(!cJSON_AddNumberToObject(timing,"injection_end_deg",540)||!cJSON_AddNumberToObject(timing,"cam_sync_deg",450)||!cJSON_AddNumberToObject(timing,"cam_window_deg",20)||!cJSON_AddItemToObject(j,"timing",timing)){cJSON_Delete(timing);return false;}
 }
 if(schema->valuedouble<3){
 auto*trims=cJSON_CreateObject();if(!trims)return false;
 const double zero[]={0,0,0,0};auto*spark=cJSON_CreateDoubleArray(zero,4);
 if(!spark||!cJSON_AddItemToObject(trims,"spark_deg",spark)){cJSON_Delete(spark);cJSON_Delete(trims);return false;}
 auto*maps=cJSON_AddArrayToObject(trims,"fuel_maps");bool ok=maps&&cJSON_AddBoolToObject(trims,"enabled",false);
 for(unsigned i=0;ok&&i<4;++i){
  const TrimMap neutral;auto*m=cJSON_CreateObject();if(!m){ok=false;break;}
  auto add=[&](const char*name,const auto&values){auto*a=cJSON_CreateFloatArray(values.data(),values.size());if(!a||!cJSON_AddItemToObject(m,name,a)){cJSON_Delete(a);return false;}return true;};
  ok=add("rpm",neutral.rpm)&&add("load",neutral.load)&&add("cells",neutral.cells)&&cJSON_AddItemToArray(maps,m);
  if(!ok)cJSON_Delete(m);
 }
 if(!ok||!cJSON_AddItemToObject(j,"cylinder_trims",trims)){cJSON_Delete(trims);return false;}
 }
 if(schema->valuedouble<4){
  auto*control=idle_document(idle::Config{});if(!control||!cJSON_AddItemToObject(j,"idle_control",control)){cJSON_Delete(control);return false;}
  auto*enabled=cJSON_GetObjectItemCaseSensitive(cJSON_GetObjectItemCaseSensitive(j,"settings"),"idle_enabled");if(!cJSON_IsBool(enabled))return false;
  enabled->type=(enabled->type&~0xff)|cJSON_False;
 }
 if(schema->valuedouble<6){auto*ae=transient::config_document(transient::Config{});if(!ae||!cJSON_AddItemToObject(j,"transient_enrichment",ae)){cJSON_Delete(ae);return false;}}
 if(schema->valuedouble<7){auto*model=load::config_document(load::Config{});if(!model||!cJSON_AddItemToObject(j,"load_model",model)){cJSON_Delete(model);return false;}}
 if(schema->valuedouble<8){auto*second=secondary::default_document();if(!second||!cJSON_AddItemToObject(j,"secondary_tables",second)){cJSON_Delete(second);return false;}}
 if(schema->valuedouble<9){auto*flex=flex::config_document(flex::Config{});if(!flex||!cJSON_AddItemToObject(j,"flex_fuel",flex)){cJSON_Delete(flex);return false;}}
 if(schema->valuedouble<10){auto*boost=boost::config_document(boost::Config{});if(!boost||!cJSON_AddItemToObject(j,"boost_control",boost)){cJSON_Delete(boost);return false;}}
 auto*timing=cJSON_GetObjectItemCaseSensitive(j,"timing");auto*order=cJSON_GetObjectItemCaseSensitive(timing,"firing_order");
 auto*trims=cJSON_GetObjectItemCaseSensitive(j,"cylinder_trims");auto*spark=cJSON_GetObjectItemCaseSensitive(trims,"spark_deg");auto*maps=cJSON_GetObjectItemCaseSensitive(trims,"fuel_maps");
 if(!cJSON_IsArray(order)||!cJSON_IsArray(spark)||!cJSON_IsArray(maps)||cJSON_GetArraySize(order)!=4||cJSON_GetArraySize(spark)!=4||cJSON_GetArraySize(maps)!=4)return false;
 auto*first=cJSON_GetArrayItem(maps,0);const TrimMap neutral;
 for(unsigned i=4;i<8;++i){
  auto append_number=[](cJSON*a){auto*v=cJSON_CreateNumber(0);if(!v||!cJSON_AddItemToArray(a,v)){cJSON_Delete(v);return false;}return true;};
  if(!append_number(order)||!append_number(spark))return false;
  auto*m=cJSON_CreateObject();if(!m)return false;
  auto add=[&](const char*name,cJSON*value){if(!value||!cJSON_AddItemToObject(m,name,value)){cJSON_Delete(value);return false;}return true;};
  const bool ok=add("rpm",cJSON_Duplicate(cJSON_GetObjectItemCaseSensitive(first,"rpm"),true))&&
   add("load",cJSON_Duplicate(cJSON_GetObjectItemCaseSensitive(first,"load"),true))&&
   add("cells",cJSON_CreateFloatArray(neutral.cells.data(),neutral.cells.size()))&&cJSON_AddItemToArray(maps,m);
  if(!ok){cJSON_Delete(m);return false;}
 }
 auto*strategy=cJSON_GetObjectItemCaseSensitive(j,"strategy");if(!cJSON_IsString(strategy))return false;
 const char*name=!std::strcmp(strategy->valuestring,"batch_wasted_4cyl")?"batch_wasted":!std::strcmp(strategy->valuestring,"sequential_4cyl")?"sequential":"semi_sequential";
 if(!cJSON_SetValuestring(strategy,name))return false;
 cJSON_SetNumberValue(schema,11);return true;
}
inline bool canonical_tune(const char*text,Tune&t,std::string& document){
 if(!text||std::strlen(text)>tune_maximum||!web::safe_json(text,std::strlen(text),tune_maximum))return false;
 auto*j=cJSON_ParseWithOpts(text,nullptr,true);
 const bool ok=j&&parse_tune(j,t)&&upgrade_tune_document(j);
 char*encoded=ok?cJSON_PrintUnformatted(j):nullptr;cJSON_Delete(j);
 if(!encoded)return false;
 const bool fits=std::strlen(encoded)<=tune_maximum;if(fits)document=encoded;cJSON_free(encoded);return fits;
}
inline cJSON* output_json(const Output&o){
 auto*j=cJSON_CreateObject();if(!j)return nullptr;
 auto number=[](cJSON*object,const char*name,double value){return finite(value)?cJSON_AddNumberToObject(object,name,value)!=nullptr:cJSON_AddNullToObject(object,name)!=nullptr;};
 bool ok=cJSON_AddStringToObject(j,"state",state_name(o.state))&&cJSON_AddNumberToObject(j,"faults",o.faults)&&
  cJSON_AddStringToObject(j,"execution","shadow / physical outputs inhibited")&&cJSON_AddBoolToObject(j,"physical_outputs_enabled",false);
#define OUT(name) ok=ok&&number(j,#name,o.name)
 OUT(rpm);OUT(ve_pct);OUT(target_lambda);OUT(advance_deg);OUT(pulse_ms);OUT(dwell_ms);OUT(deadtime_ms);OUT(air_mg);OUT(warmup);OUT(afterstart);OUT(accel);OUT(ego);OUT(duty_pct);OUT(idle_pct);
#undef OUT
 if(ok){auto*ae=transient::observation_json(o.transient_enrichment);if(!ae||!cJSON_AddItemToObject(j,"transient_enrichment",ae)){cJSON_Delete(ae);ok=false;}}
 if(ok){auto*model=load::observation_json(o.load_model);if(!model||!cJSON_AddItemToObject(j,"load_model",model)){cJSON_Delete(model);ok=false;}}
 if(ok){auto*second=secondary::observations_json(o.secondary_fuel,o.secondary_spark);if(!second||!cJSON_AddItemToObject(j,"secondary_tables",second)){cJSON_Delete(second);ok=false;}}
 if(ok){auto*flex=flex::evaluation_json(o.flex_fuel);if(!flex||!cJSON_AddItemToObject(j,"flex_fuel",flex)){cJSON_Delete(flex);ok=false;}}
 if(ok){auto*boost=boost::observation_json(o.boost_control);if(!boost||!cJSON_AddItemToObject(j,"boost_control",boost)){cJSON_Delete(boost);ok=false;}}
 if(ok)ok=cJSON_AddBoolToObject(j,"fuel_cut",o.fuel_cut)&&cJSON_AddBoolToObject(j,"spark_cut",o.spark_cut)&&cJSON_AddBoolToObject(j,"proposed_pump",o.pump)&&cJSON_AddBoolToObject(j,"proposed_fan",o.fan)&&cJSON_AddStringToObject(j,"scalar_proposal_basis","untrimmed_base_demand");
 auto*idle=ok?cJSON_AddObjectToObject(j,"idle"):nullptr;if(!idle)ok=false;
 if(ok)ok=cJSON_AddStringToObject(idle,"state",idle::state_name(o.idle.state))&&cJSON_AddStringToObject(idle,"reason",idle::reason_name(o.idle.reason))&&cJSON_AddStringToObject(idle,"basis","controller_proposal")&&cJSON_AddNumberToObject(idle,"flags",o.idle.flags);
 ok=ok&&number(idle,"duty_pct",o.idle.duty_pct);
 ok=ok&&number(idle,"target_rpm",o.idle.target_rpm);
 ok=ok&&number(idle,"feedforward_pct",o.idle.feedforward_pct);
 ok=ok&&number(idle,"p_term",o.idle.p_term);
 ok=ok&&number(idle,"i_term",o.idle.i_term);
 ok=ok&&number(idle,"d_term",o.idle.d_term);
 char updates[24];std::snprintf(updates,sizeof(updates),"%llu",static_cast<unsigned long long>(o.idle.pid_updates));ok=ok&&cJSON_AddStringToObject(idle,"pid_updates",updates);
 auto*cyl=ok?cJSON_AddObjectToObject(j,"cylinders"):nullptr;if(!cyl)ok=false;
 if(ok)ok=cJSON_AddNumberToObject(cyl,"count",o.cylinder_count<=8?o.cylinder_count:0)&&cJSON_AddBoolToObject(cyl,"available",o.cylinder_data)&&cJSON_AddBoolToObject(cyl,"enabled",o.cylinder_trims_enabled)&&
  cJSON_AddNumberToObject(cyl,"capacity_mask",o.cylinder_capacity_mask)&&cJSON_AddNumberToObject(cyl,"spark_clamp_mask",o.cylinder_spark_clamp_mask)&&cJSON_AddNumberToObject(cyl,"retard_floor_mask",o.cylinder_retard_floor_mask);
 auto*a=ok?cJSON_AddArrayToObject(cyl,"proposals"):nullptr;if(!a)ok=false;
 for(unsigned i=0;ok&&i<8;++i){
  auto*row=cJSON_CreateObject();if(!row){ok=false;break;}
  const bool active=i<o.cylinder_count&&o.cylinder_count<=8,known=active&&o.cylinder_data;
  ok=cJSON_AddNumberToObject(row,"cylinder",i+1)&&cJSON_AddBoolToObject(row,"active",active)&&number(row,"pulse_ms",known?o.cylinder_pulse_ms[i]:NAN)&&number(row,"advance_deg",known?o.cylinder_advance_deg[i]:NAN)&&number(row,"fuel_pct",known?o.cylinder_fuel_pct[i]:NAN)&&number(row,"duty_pct",known?o.cylinder_duty_pct[i]:NAN)&&cJSON_AddItemToArray(a,row);
  if(!ok)cJSON_Delete(row);
 }
 if(!ok){cJSON_Delete(j);return nullptr;}return j;
}
}
