markthebault/esp32-ecu/firmware/include/ecu/web_config.hpp

#pragma once
#include "ecu/config.hpp"
#include "ecu/engine_data.hpp"
#include <array>
#include <cstdint>
namespace ecu::web {
struct Sample {
 std::array<unsigned,8> raw{};bool adc_ok{},safe{},interlock{},overflow{},synced{},timing_fault{},phase_synced{};double rpm{};
 std::uint64_t can_frames{},cam_edges{},crank_edges{};int crank_level{},cam_level{};
 std::uint32_t phase_tune_revision{},phase_sensor_revision{},phase_epoch{},phase_losses{},cam_rejected{};
 std::uint8_t phase_reason{},timing_cause{},last_timing_cause{},worker_cylinder_count{};std::uint32_t virtual_high_mask{},physical_command_mask{};float cam_error_deg{};
 std::uint64_t worker_sequence{},worker_observed_us{};std::uint32_t worker_epoch{},worker_tune_revision{},worker_sensor_revision{};
 std::array<secondary::SwitchSample,2> table_switches{};
 engine::RuntimeSample engine;
};
void init(); // Load NVS before the monitor loop; never enables outputs.
void start_service(); // AP only in the dedicated web build, with J3 open at startup.
bool try_config(config::Config& out);
void publish(const Sample& sample);
}
