markthebault/esp32-ecu/(commit log)

2026-10-30 Add compact ESP32 ECU prototype, purchasing BOM and illustrated README
    [analog.kicad_sch, base.step, base.stl, bom-shopping.csv, bom.csv, cable_blank.step, cable_blank.stl, config-tests.txt]
2026-10-30 Add encrypted ESP-NOW pairing and N16R8 carrier draft
    [analog.kicad_sch, bom-shopping.csv, bom.csv, connector-pinout.csv, core.kicad_sch, esp32-ecu.kicad_pcb, esp32-ecu.kicad_sch, ignition.kicad_sch]
2026-11-03 Add reviewed shadow engine core, SIL validation and tuning file workflow
    [partitions.csv]
2026-11-03 Add reviewed ESP32 capture and bounded timing executor
2026-11-03 Add individual cylinder fuel maps, spark trims and channel diagnostics
    Carry four physical-cylinder trim maps through sequential control, storage migration, browser tuning, own 003 MSQ and engine logs. Preserve existing radio schema and physical output inhibition.
    Fix command acceptance, JSON allocation ownership and bounded charged-coil prediction at tooth coincidence. Validate with native sanitizers,108 Python tests,45 Chrome checks,18 external-plant runs, actual desktop tools and independent reviews.
    [engine.hpp, engine_data.hpp, engine_data_json.hpp, engine_json.hpp, engine_log.hpp, engine_log_msl.hpp, engine_radio.hpp]
2026-11-04 Add inhibited idle control with executed PWM and independent comparisons
    [accessories.csv, bom.csv, idle.kicad_pcb, idle.kicad_sch, metrics.csv]
2026-11-04 Add isolated idle hardware drafts and circuit fault evidence
    [all-pins.csv, analog.kicad_sch, bom-shopping.csv, bom.csv, carrier.dsn, connector-pinout.csv, core.kicad_sch, esp32-ecu.kicad_pcb]
2026-11-04 Add timed semi-sequential injection, tuning and screen compatibility
    [metrics.csv, partitions.csv]
2026-11-04 Add acquisition-clock transient fueling and tuning diagnostics
    [partitions.csv, transient-legacy-v5.csv]
2026-11-04 Add independent load sources, pressure and AFR tuning
    [partitions.csv, transient-legacy-v5.csv]
2026-11-04 Add reviewed secondary-table core foundation
    [reference-probe.csv]
2026-11-04 Integrate secondary-table configuration and diagnostics
    [compact_a3_timing_bench-partitions.csv, compact_a3_web-partitions.csv, compact_n16r8_web-partitions.csv, partitions.csv, transient-legacy-v5.csv]
2026-11-04 Integrate guarded J4 switch inputs and accessory prototype
    [analog.kicad_sch, annotation-copy.kicad_pcb, bom.csv, core.kicad_sch, esp32-ecu.kicad_pcb, esp32-ecu.kicad_sch, ignition.kicad_sch, injectors.kicad_sch]
2026-11-04 Add production serial bridge and current TunerStudio diagnosis
    Build a separate stopped-engine reference from attested production objects,
    with raw PTY transport, bounded host queues and stream-aware capture audits.
    Keep the numerical reference, own firmware and controller identity unchanged.
    Record current own009 discovery rejection and a genuine-reference application
    read/edit/burn/MSQ positive control. Preserve source hashes, independent reviews,
    replay tooling and a local unsent vendor request. Validate 221 Python tests,
    including 16 serial/capture tests, plus independent sanitizer/provenance checks.
    Own online support, physical qualification and full feature parity remain open.
    [capture_clock.hpp, config.hpp, control.hpp, engine.hpp, engine_binding.hpp, engine_data.hpp, engine_data_json.hpp, engine_json.hpp]
2026-11-04 Add flex acquisition core and production raw-edge comparisons
    Implement a portable coherent-cycle capture/filter/fault-ACK core and separate
    six-bin fuel, spark and fuel-temperature correction helpers. Keep this
    groundwork disconnected from the current engine/target/UI/config/PCB path.
    Drive genuine pinned production setup, callbacks, timer service and loop from
    raw flex and60-2 crank inputs. Preserve25 source-bound cases, causal/refinement
    controls,11 corrupted-record checks, independent owned-ELF replay and sanitizer
    evidence. Record native startup/cache, calibration-span and8-bit-count findings
    with explicit physical/CPU-model limits and the generated-coverage side effect.
    The full nati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
2026-11-04 Integrate flex control, calibration and diagnostics in development core
    [partitions.csv, transient-legacy-v5.csv]
2026-11-04 Add bounded flex ingress and GPIO38 carrier architecture draft
    [app.cpp, capture_clock.hpp, config.hpp, control.hpp, engine.hpp, engine_binding.hpp, engine_data.hpp, engine_data_json.hpp]
2026-11-04 Add shared I2C status LED and preserved firmware builds
    [partitions.csv, transient-legacy-v5.csv]
2026-11-04 Connect GPIO38 flex capture to guarded target control
    [partitions.csv, transient-legacy-v5.csv]
2026-11-05 Add coherent flex radio telemetry and complete-engine ACK health
    [partitions.csv, transient-legacy-v5.csv]
2026-11-05 Add reviewed routed A6 compact flex/RGB development checkpoint
    Add the compact leaded frontend, local bypass and feedback routing, PH2 shield connector and matching draft BOM/guides. Retain full nominal circuit captures, independent review, native controls and three exact inhibited firmware builds. Fabrication, sensor hookup, physical qualification and broader Speeduino parity remain open.
    [analog.kicad_sch, bom-shopping.csv, bom.csv, connector-pinout.csv, core.kicad_sch, esp32-ecu.kicad_pcb, esp32-ecu.kicad_sch, flex.kicad_sch]
2026-11-05 Add ratiometric sensor calibration and bounded profile storage
2026-11-05 Add reviewed supply and ADC disturbance simulations
2026-11-05 Add reviewed boost control and PWM groundwork
2026-11-05 Integrate inhibited boost control and fix NVS chunk recovery
    Connect pressure protection, schema10/own011 configuration, browser controls,
    coherent diagnostics and a separate virtual target PWM channel. Preserve NA
    defaults and historical formats. Boost screens, coupled turbo comparison and
    protected physical driver work remain pending.
    Correct the pinned NVS chunk-identity recovery defect reproduced by independent
    flash-error tests. Preserve upstream runtime bytes and modification notice.
    Validation: 173 Python regressions, full ASan/UBSan native suite, actual Chrome
    flows, native diagnostic corruption tests, independent ECU/storage reviews and
    three fresh inhibited firmware builds with s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
    [boost_command.hpp, boost_json.hpp, boost_pwm_json.hpp, boost_runtime.hpp, boost_runtime_json.hpp, engine.hpp, engine_data.hpp, engine_data_json.hpp]
2026-11-05 Add reviewed coupled turbo engine benchmark
    Compare actual native fuel, ignition and boost transitions from our controller and pinned production Speeduino in separate free-crank research plants. Preserve 28 runs, independent numerical/adapter review, exact source/build provenance and rejected evidence. Physical outputs remain inhibited; calibration, hardware and full feature parity remain open.
2026-11-06 Add reviewed isolated boost hardware and A7 shared harness
    [analog.kicad_sch, bom-grouped.csv, bom.csv, core.kicad_sch, esp32-ecu.kicad_pcb, esp32-ecu.kicad_sch, flex.kicad_sch, harness-bom.csv]
2026-11-06 Fix current tuning application exchange and editor limits
2026-11-06 Generalize internal engine core for 1 to 8 cylinders
    Keep public tune, telemetry, target and PCB interfaces at four cylinders pending their full migration. Add reviewed timing and legacy comparisons, strict configuration fences, reference geometry observations and fresh inhibited build evidence.
2026-11-06 Integrate one-to-eight cylinder development profiles
    Add schema11 and own012 calibration, active-count browser editors, data3/MSL009 observations, full worker masks and authenticated four-part screen schema7. Preserve historical four-cylinder contracts and the fitted4+4 physical policy.
    Generalize both project research plants with independent geometry and per-cylinder actuation/ledgers. Include source-bound native, Chrome, actual TunerStudio/MegaLogViewer, fresh inhibited firmware and independent review evidence. Expanded genuine Speeduino/turbo comparisons, matching hardware and wider feature work remain open.
2026-11-06 Compare expanded cylinder profiles against production Speeduino
2026-11-06 Generalize turbo geometry and audit sparse charged cuts
2026-11-06 Resolve shaft and intake integration with physical event audits
2026-11-06 Refresh README with current capabilities and tested screenshots
